TomKeddie/prj-pcb-experiments/mr-fixit/images/IMG_20191210_090137.jpg

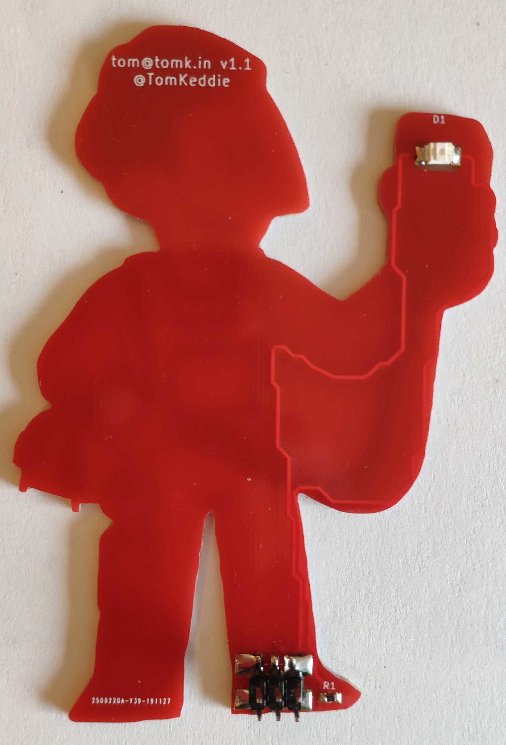
mr-fixit/images/IMG_20191210_090137.jpg
