TomKeddie/prj-pcb-experiments/mr-fixit/images/IMG_20191210_090121.jpg

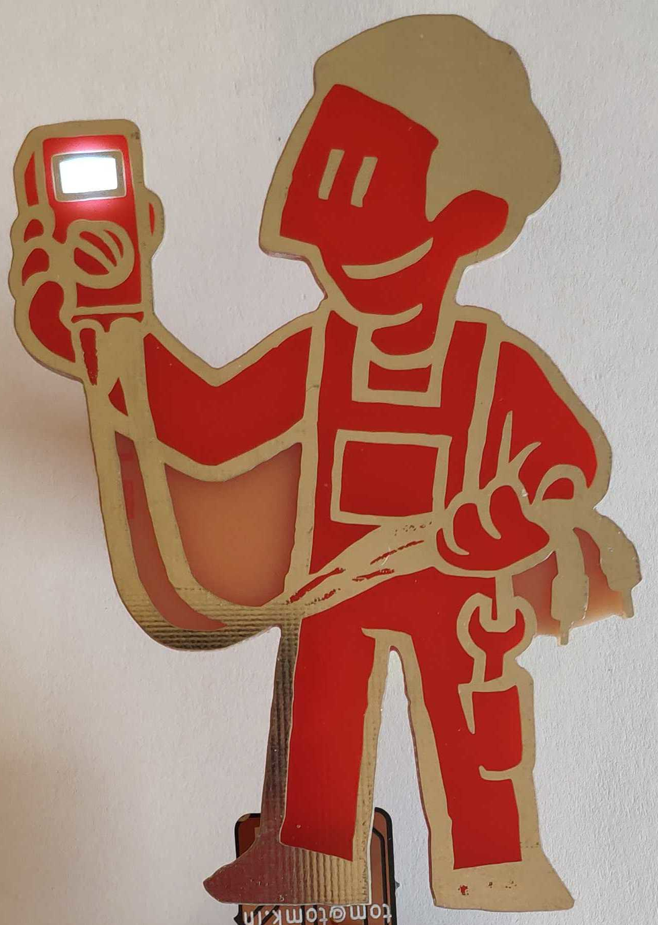
mr-fixit/images/IMG_20191210_090121.jpg
