TomKeddie/prj-pcb-experiments/2024-rfid-sao/README.md

## Plan
* Lollypop shaped SAO with RFID antenna in the head
* Red solder mask and white silk screen
* I2C to SAO (with optional pullups)

[Teardown BadgeTeqerdown 2019 Badge](https://upverter.com/design/gsteiert/teardown2019/)

[STM Data Sheet](https://wmsc.lcsc.com/wmsc/upload/file/pdf/v2/lcsc/2304140030_STMicroelectronics-M24LR64E-RMN6T-2_C2649483.pdf)

[JLCPCB RFID Parts](https://jlcpcb.com/parts/2nd/RF_And_Wireless/RFID_ICs_82545)

[Kicad Antenna Generator](https://neurotech-hub.github.io/KiCad-Antenna-Generator/)
