TomKeddie/prj-pcb-experiments/big-clive/README.md

Big Clive PCBs

* Original images are from http://www.bigclive.com/merch.htm
* Image was thresholded to clean up edges
* Solder mask layers were created using the kicad convert image tool
* Copper layer was created by duplicating the solder mask and hand editing to rename Mask to Cu
