TomKeddie/prj-pcb-experiments/2025-pmod-sma/2025-pmod-sma.kicad_sch.jlc.md

|Designator|LCSC|Footprint|Comment|
|--|--|--|--|
|J1|[](https://jlcpcb.com/partdetail/)|lib:PinHeader_2x06_P2.54mm_Horizontal_Top_Bottom|Conn_02x06_Top_Bottom|
|J2|[](https://jlcpcb.com/partdetail/)|lib:PinHeader_2x08_P2.54mm_Vertical_Top_Bottom|Conn_02x08_Top_Bottom|
|J3|[](https://jlcpcb.com/partdetail/)|lib:SMA_Amphenol_901-143_Horizontal|Conn_01x02|
