TomKeddie/prj-pcb-experiments/2025-mini-keychain/2025-mini-keychain.kicad_sch.jlc.md

|Designator|LCSC|Footprint|Comment|
|--|--|--|--|
