TomKeddie/prj-pcb-experiments/2024-rfid-sao/2024-rfid-sao.kicad_sch.jlc.md

|Designator|LCSC|Footprint|Comment|
|--|--|--|--|
|C1|[C19702](https://jlcpcb.com/partdetail/C19702)|library:C_0603_1608Metric|10uF/10V|
|C2|[C1525](https://jlcpcb.com/partdetail/C1525)|library:C_0402_1005Metric|0.1uF/16V|
|R1|[C25744](https://jlcpcb.com/partdetail/C25744)|library:R_0402_1005Metric|10k|
|R2|[C25744](https://jlcpcb.com/partdetail/C25744)|library:R_0402_1005Metric|10k|
|U1|[C157372](https://jlcpcb.com/partdetail/C157372)|library:SOIC-8_3.9x4.9mm_P1.27mm|M24LR64E|
