TomKeddie/prj-pcb-experiments/2024-clock-retrofit/kicad/2024-clock-retrofit.kicad_sch.jlc.md

|Designator|LCSC|Footprint|Comment|
|--|--|--|--|
|C1|[C19702](https://jlcpcb.com/partdetail/C19702)|library:C_0603_1608Metric|10uF/10V/X5R|
|C2|[C14663](https://jlcpcb.com/partdetail/C14663)|library:C_0603_1608Metric|100nF/50V/X7R|
|C3|[C12891](https://jlcpcb.com/partdetail/C12891)|library:C_1206_3216Metric|22uF/25V/X5R|
|C4|[C12891](https://jlcpcb.com/partdetail/C12891)|library:C_1206_3216Metric|22uF/25V/X5R|
|C5|[C14663](https://jlcpcb.com/partdetail/C14663)|library:C_0603_1608Metric|100nF/50V/X7R|
|C6|[C14663](https://jlcpcb.com/partdetail/C14663)|library:C_0603_1608Metric|100nF/50V/X7R|
|D2|[C2290](https://jlcpcb.com/partdetail/C2290)|library:LED_0603_1608Metric|PM|
|D3|[C2290](https://jlcpcb.com/partdetail/C2290)|library:LED_0603_1608Metric|AL|
|D4|[C2290](https://jlcpcb.com/partdetail/C2290)|library:LED_0603_1608Metric|TEMP|
|D5|[C2290](https://jlcpcb.com/partdetail/C2290)|library:LED_0603_1608Metric|TOP|
|D6|[C2290](https://jlcpcb.com/partdetail/C2290)|library:LED_0603_1608Metric|BOTT|
|D7|[C2290](https://jlcpcb.com/partdetail/C2290)|library:LED_0603_1608Metric|LED|
|D8|[C2290](https://jlcpcb.com/partdetail/C2290)|library:LED_0603_1608Metric|LED|
|D9|[C2290](https://jlcpcb.com/partdetail/C2290)|library:LED_0603_1608Metric|LED|
|D10|[C2290](https://jlcpcb.com/partdetail/C2290)|library:LED_0603_1608Metric|LED|
|D11|[C2290](https://jlcpcb.com/partdetail/C2290)|library:LED_0603_1608Metric|LED|
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
|R2|[C25741](https://jlcpcb.com/partdetail/C25741)|library:R_0402_1005Metric|100k|
|R3|[C25741](https://jlcpcb.com/partdetail/C25741)|library:R_0402_1005Metric|100k|
|R4|[C17673](https://jlcpcb.com/partdetail/C17673)|library:R_0805_2012Metric|4.7k|
|R5|[C25741](https://jlcpcb.com/partdetail/C25741)|library:R_0402_1005Metric|R_100k|
|R6|[C25076](https://jlcpcb.com/partdetail/C25076)|library:R_0402_1005Metric|100R|
|R7|[C25076](https://jlcpcb.com/partdetail/C25076)|library:R_0402_1005Metric|100R|
|R8|[C25076](https://jlcpcb.com/partdetail/C25076)|library:R_0402_1005Metric|100R|
|R9|[C25076](https://jlcpcb.com/partdetail/C25076)|library:R_0402_1005Metric|100R|
|R10|[C25076](https://jlcpcb.com/partdetail/C25076)|library:R_0402_1005Metric|100R|
|R11|[C17673](https://jlcpcb.com/partdetail/C17673)|library:R_0805_2012Metric|4.7k|
|R12|[C25076](https://jlcpcb.com/partdetail/C25076)|library:R_0402_1005Metric|100R|
|R13|[C25076](https://jlcpcb.com/partdetail/C25076)|library:R_0402_1005Metric|100R|
|R14|[C25076](https://jlcpcb.com/partdetail/C25076)|library:R_0402_1005Metric|100R|
|R15|[C25741](https://jlcpcb.com/partdetail/C25741)|library:R_0402_1005Metric|100k|
|U1|[](https://jlcpcb.com/partdetail/)|library:SSOP-24_3.9x8.7mm_P0.635mm|TLC59025|
|U3|[](https://jlcpcb.com/partdetail/)|library:SSOP-24_3.9x8.7mm_P0.635mm|TLC59025|
|U4|[C6186](https://jlcpcb.com/partdetail/C6186)|library:SOT-223-3_TabPin2|AZ1117-3.3|
