TomKeddie/prj-pcb-experiments/2025-flex-spiral/two/2025-flex-spiral-two.kicad_sch.jlc.md

|Designator|LCSC|Footprint|Comment|
|--|--|--|--|
|D1|[](https://jlcpcb.com/partdetail/)|lib:LED_0603_1608Metric|led_small|
|D2|[](https://jlcpcb.com/partdetail/)|lib:LED_0603_1608Metric|led_small|
|D3|[](https://jlcpcb.com/partdetail/)|lib:LED_0603_1608Metric|led_small|
|D4|[](https://jlcpcb.com/partdetail/)|lib:LED_0603_1608Metric|led_small|
|D5|[](https://jlcpcb.com/partdetail/)|lib:LED_0603_1608Metric|led_small|
|D6|[](https://jlcpcb.com/partdetail/)|lib:LED_0603_1608Metric|led_small|
|D7|[](https://jlcpcb.com/partdetail/)|lib:LED_0603_1608Metric|led_small|
|D8|[](https://jlcpcb.com/partdetail/)|lib:LED_0603_1608Metric|led_small|
|D9|[](https://jlcpcb.com/partdetail/)|lib:LED_0603_1608Metric|led_small|
|D10|[](https://jlcpcb.com/partdetail/)|lib:LED_0603_1608Metric|led_small|
|D11|[](https://jlcpcb.com/partdetail/)|lib:LED_0603_1608Metric|led_small|
|D12|[](https://jlcpcb.com/partdetail/)|lib:LED_0603_1608Metric|led_small|
|D13|[](https://jlcpcb.com/partdetail/)|lib:LED_0603_1608Metric|led_small|
|D14|[](https://jlcpcb.com/partdetail/)|lib:LED_0603_1608Metric|led_small|
|D15|[](https://jlcpcb.com/partdetail/)|lib:LED_0603_1608Metric|led_small|
|D16|[](https://jlcpcb.com/partdetail/)|lib:LED_0603_1608Metric|led_small|
|D17|[](https://jlcpcb.com/partdetail/)|lib:LED_0603_1608Metric|led_small|
|D18|[](https://jlcpcb.com/partdetail/)|lib:LED_0603_1608Metric|led_small|
|D19|[](https://jlcpcb.com/partdetail/)|lib:LED_0603_1608Metric|led_small|
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
|D74|[](https://jlcpcb.com/partdetail/)|lib:LED_0603_1608Metric|led_small|
|D75|[](https://jlcpcb.com/partdetail/)|lib:LED_0603_1608Metric|led_small|
|TP1|[](https://jlcpcb.com/partdetail/)|lib:TestPoint_Pad_D3.0mm|A|
|TP2|[](https://jlcpcb.com/partdetail/)|lib:TestPoint_Pad_D3.0mm|C|
