TomKeddie/prj-pcb-experiments/2024-led-ctrl-24v/kicad/led-ctrl-24v.kicad_sch.jlc.md

|Designator|LCSC|Footprint|Comment|
|--|--|--|--|
|C2|[C14663](https://jlcpcb.com/partdetail/C14663)|library:C_0603_1608Metric|100nF/50V/X7R|
|C3|[C15195](https://jlcpcb.com/partdetail/C15195)|library:C_0402_1005Metric|10nF/50V/X7R|
|C4|[C13585](https://jlcpcb.com/partdetail/C13585)|library:C_1206_3216Metric|10uF/50V/X5R|
|C5|[C696794](https://jlcpcb.com/partdetail/C696794)|library:CP_EIA-3528-12_Kemet-T|220uF/6.3V/TANT|
|C6|[C19702](https://jlcpcb.com/partdetail/C19702)|library:C_0603_1608Metric|10uF/10V/X5R|
|C7|[C19702](https://jlcpcb.com/partdetail/C19702)|library:C_0603_1608Metric|10uF/10V/X5R|
|D1|[C64982](https://jlcpcb.com/partdetail/C64982)|library:D_SMA|B340|
|L1|[C5189961](https://jlcpcb.com/partdetail/C5189961)|library:CYA630|33uH/1A|
|Q1|[C20917](https://jlcpcb.com/partdetail/C20917)|library:SOT-23|AO3400A|
|R1|[C25804](https://jlcpcb.com/partdetail/C25804)|library:R_0603_1608Metric|10k|
|R2|[C25804](https://jlcpcb.com/partdetail/C25804)|library:R_0603_1608Metric|10k|
|R3|[C25804](https://jlcpcb.com/partdetail/C25804)|library:R_0603_1608Metric|10k|
|R4|[C25804](https://jlcpcb.com/partdetail/C25804)|library:R_0603_1608Metric|10k|
|R5|[C25804](https://jlcpcb.com/partdetail/C25804)|library:R_0603_1608Metric|10k|
|R6|[C25804](https://jlcpcb.com/partdetail/C25804)|library:R_0603_1608Metric|10k|
|R7|[C21190](https://jlcpcb.com/partdetail/C21190)|library:R_0603_1608Metric|100k|
|R8|[C21189](https://jlcpcb.com/partdetail/C21189)|library:R_0603_1608Metric|0|
|R9|[C21189](https://jlcpcb.com/partdetail/C21189)|library:R_0603_1608Metric|0|
|R10|[C21189](https://jlcpcb.com/partdetail/C21189)|library:R_0603_1608Metric|0|
|R11|[C25744](https://jlcpcb.com/partdetail/C25744)|library:R_0402_1005Metric|10k|
|R12|[C25804](https://jlcpcb.com/partdetail/C25804)|library:R_0603_1608Metric|10k|
|R13|[C25900](https://jlcpcb.com/partdetail/C25900)|library:R_0402_1005Metric|4.7k|
|R14|[C25804](https://jlcpcb.com/partdetail/C25804)|library:R_0603_1608Metric|10k|
|R15|[C25744](https://jlcpcb.com/partdetail/C25744)|library:R_0402_1005Metric|10k|
|U1|[](https://jlcpcb.com/partdetail/)|library:TI_SO-PowerPAD-8_ThermalVias|TPS5430DDA|
|U2|[C82891](https://jlcpcb.com/partdetail/C82891)|library:ESP-12E_SMD|ESP-12|
|U3|[C5446](https://jlcpcb.com/partdetail/C5446)|library:SOT-23|XC6206P332MR-G|
|U4|[C23654](https://jlcpcb.com/partdetail/C23654)|library:SOT-23-5|74LVC1G125|
