TomKeddie/prj-pcb-experiments/2025-usb-pd-plank/kicad/usb-pd-plank.kicad_sch.jlc.md

|Comment|LCSC|Footprint|Designator|
|--|--|--|--|
|4.7uF/50V|[C29823](https://jlcpcb.com/partdetail/C29823)|lib:C_1206_3216Metric|C1|
|4.7uF/50V|[C29823](https://jlcpcb.com/partdetail/C29823)|lib:C_1206_3216Metric|C2|
|4.7uF/50V|[C29823](https://jlcpcb.com/partdetail/C29823)|lib:C_1206_3216Metric|C3|
|4.7uF/50V|[C29823](https://jlcpcb.com/partdetail/C29823)|lib:C_1206_3216Metric|C4|
|4.7uF/50V|[C29823](https://jlcpcb.com/partdetail/C29823)|lib:C_1206_3216Metric|C5|
|0.1uF/50V|[C24497](https://jlcpcb.com/partdetail/C24497)|lib:C_1206_3216Metric|C6|
|0.1uF/50V|[C24497](https://jlcpcb.com/partdetail/C24497)|lib:C_1206_3216Metric|C7|
|PESD5V0S1BA|[C19224](https://jlcpcb.com/partdetail/C19224)|lib:D_SOD-323|D1|
|PESD5V0S1BA|[C19224](https://jlcpcb.com/partdetail/C19224)|lib:D_SOD-323|D2|
|GREEN|[C2297](https://jlcpcb.com/partdetail/C2297)|lib:LED_0805_2012Metric|D3|
|GREEN|[C2297](https://jlcpcb.com/partdetail/C2297)|lib:LED_0805_2012Metric|D4|
|GREEN|[C2297](https://jlcpcb.com/partdetail/C2297)|lib:LED_0805_2012Metric|D5|
|USB_C_Receptacle_USB2.0_16P|[C165948](https://jlcpcb.com/partdetail/C165948)|lib:USB_C_Receptacle_LCSC_C165948|J1|
|USB_C_Receptacle_USB2.0_16P|[C165948](https://jlcpcb.com/partdetail/C165948)|lib:USB_C_Receptacle_LCSC_C165948|J2|
|AO3400A|[C20917](https://jlcpcb.com/partdetail/C20917)|lib:SOT-23-GSD|Q1|
|AO3400A|[C20917](https://jlcpcb.com/partdetail/C20917)|lib:SOT-23-GSD|Q2|
|AO3400A|[C20917](https://jlcpcb.com/partdetail/C20917)|lib:SOT-23-GSD|Q3|
|AO3400A|[C20917](https://jlcpcb.com/partdetail/C20917)|lib:SOT-23-GSD|Q4|
|AO4407A|[](https://jlcpcb.com/partdetail/)|lib:SO-8_3.9x4.9mm_P1.27mm|Q5|
|AO4407A|[](https://jlcpcb.com/partdetail/)|lib:SO-8_3.9x4.9mm_P1.27mm|Q6|
|AO4407A|[](https://jlcpcb.com/partdetail/)|lib:SO-8_3.9x4.9mm_P1.27mm|Q7|
|AO4407A|[](https://jlcpcb.com/partdetail/)|lib:SO-8_3.9x4.9mm_P1.27mm|Q8|
|10k|[C25744](https://jlcpcb.com/partdetail/C25744)|lib:R_0402_1005Metric|R1|
|10k|[C25744](https://jlcpcb.com/partdetail/C25744)|lib:R_0402_1005Metric|R2|
|10k|[C25744](https://jlcpcb.com/partdetail/C25744)|lib:R_0402_1005Metric|R3|
|10k|[C25744](https://jlcpcb.com/partdetail/C25744)|lib:R_0402_1005Metric|R4|
|1k|[C11702](https://jlcpcb.com/partdetail/C11702)|lib:R_0402_1005Metric|R6|
|100k|[C25741](https://jlcpcb.com/partdetail/C25741)|lib:R_0402_1005Metric|R8|
|100k|[C25741](https://jlcpcb.com/partdetail/C25741)|lib:R_0402_1005Metric|R9|
|1k|[C11702](https://jlcpcb.com/partdetail/C11702)|lib:R_0402_1005Metric|R10|
|1k|[C11702](https://jlcpcb.com/partdetail/C11702)|lib:R_0402_1005Metric|R11|
|100k|[C25741](https://jlcpcb.com/partdetail/C25741)|lib:R_0402_1005Metric|R12|
|10k|[C25744](https://jlcpcb.com/partdetail/C25744)|lib:R_0402_1005Metric|R13|
|10k|[C25744](https://jlcpcb.com/partdetail/C25744)|lib:R_0402_1005Metric|R14|
|100k|[C25741](https://jlcpcb.com/partdetail/C25741)|lib:R_0402_1005Metric|R15|
|PTN5110|[C2674062](https://jlcpcb.com/partdetail/C2674062)|lib:QFN-16_EP_2.6x2.6_Pitch0.4mm|U1|
