TomKeddie/prj-pcb-experiments/3rdparty-gerbers/Krusty_the_It/Screenshot_2020-10-03_10-51-42.png

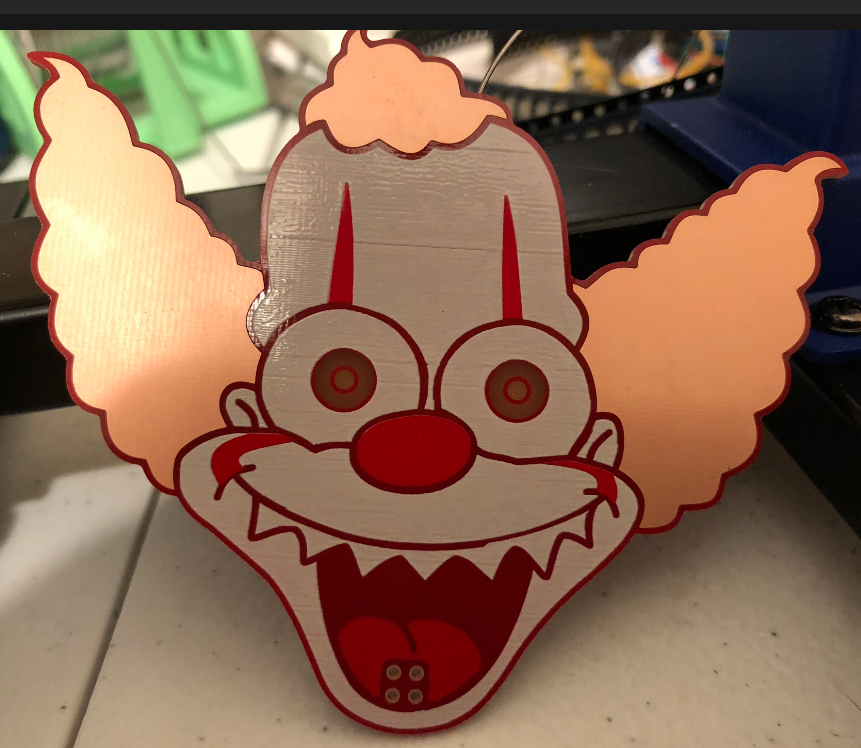
3rdparty-gerbers/Krusty_the_It/Screenshot_2020-10-03_10-51-42.png
