TomKeddie/prj-pcb-experiments/3rdparty-gerbers/Nibbler/Screenshot_2020-10-03_10-50-50.png

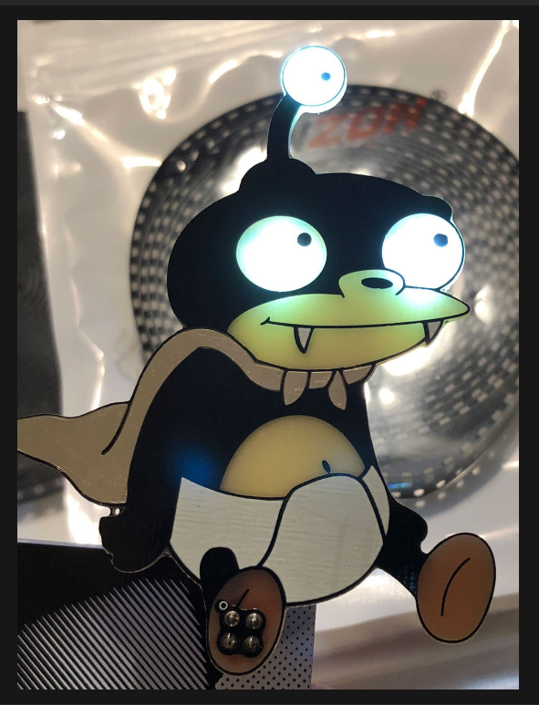
3rdparty-gerbers/Nibbler/Screenshot_2020-10-03_10-50-50.png
