TomKeddie/prj-pcb-experiments/3rdparty-gerbers/UFO/Screenshot_2020-10-03_10-46-58.png

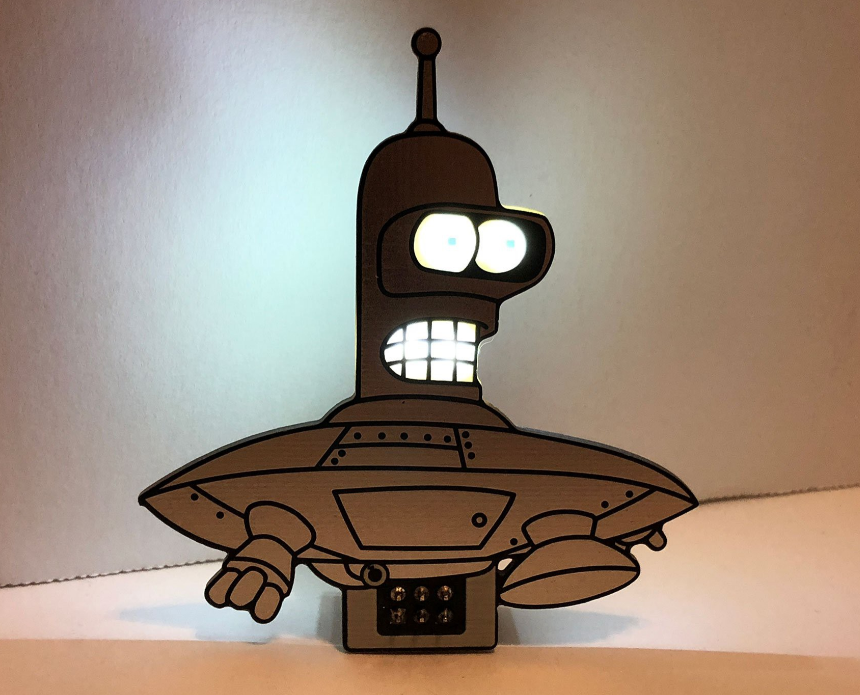
3rdparty-gerbers/UFO/Screenshot_2020-10-03_10-46-58.png
