TomKeddie/prj-pcb-experiments/2021-xmas-tree/image/pine-tree-with-snow-transparent-clip-art-gallery-yopriceville-snow-tree-clipart-5756_8000.png

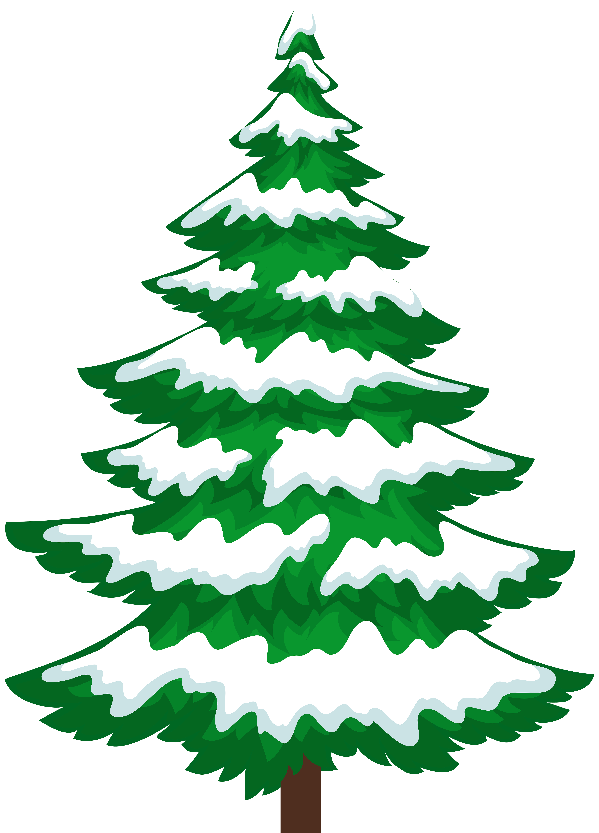
2021-xmas-tree/image/pine-tree-with-snow-transparent-clip-art-gallery-yopriceville-snow-tree-clipart-5756_8000.png
