TomKeddie/prj-pcb-experiments/2021-xmas-tree/outline.png

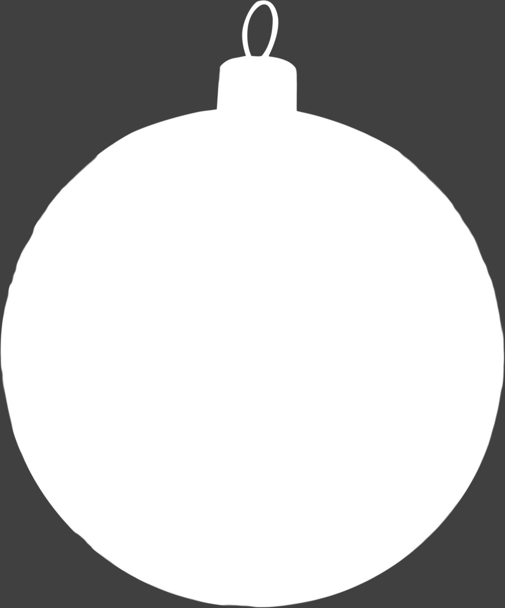
2021-xmas-tree/outline.png
