TomKeddie/prj-pcb-experiments/2022-xmas-ball/original.png

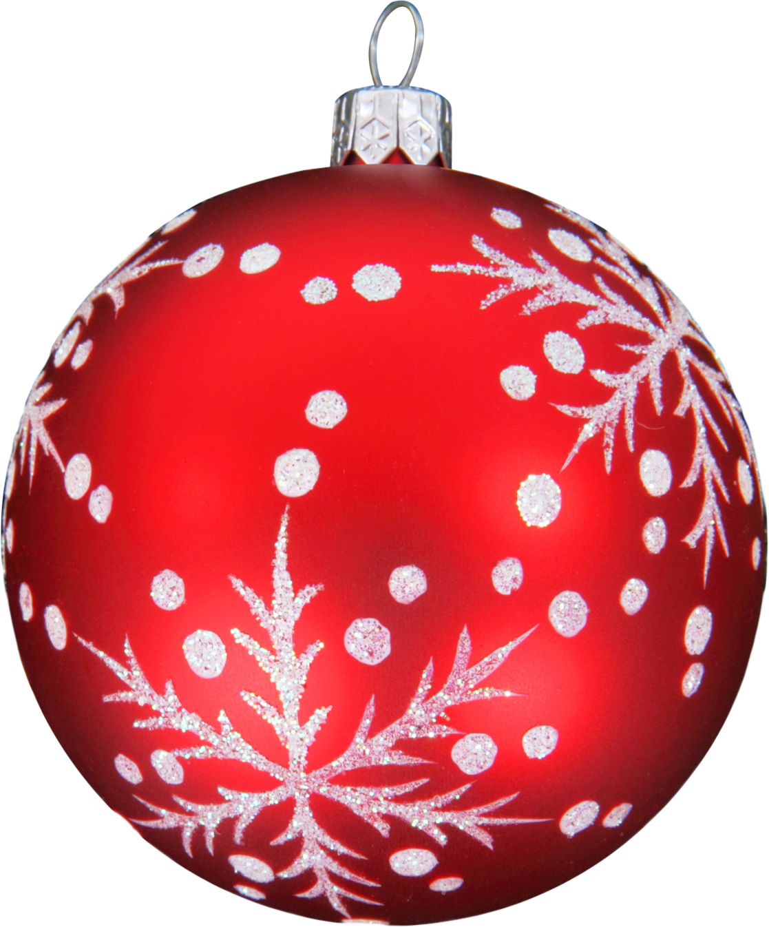
2022-xmas-ball/original.png
