TomKeddie/prj-pcb-experiments/2023-xmas-snowflake/image/silk.png

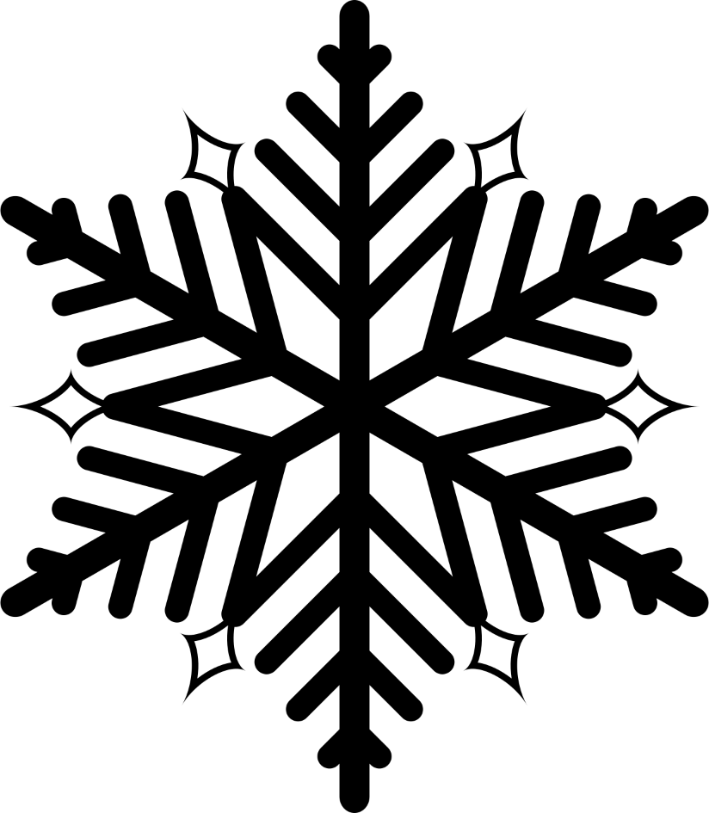
2023-xmas-snowflake/image/silk.png
