TomKeddie/prj-pcb-experiments/2024-clock-retrofit/kicad/2024-clock-retrofit.kicad_pcb.3d-isometric.png

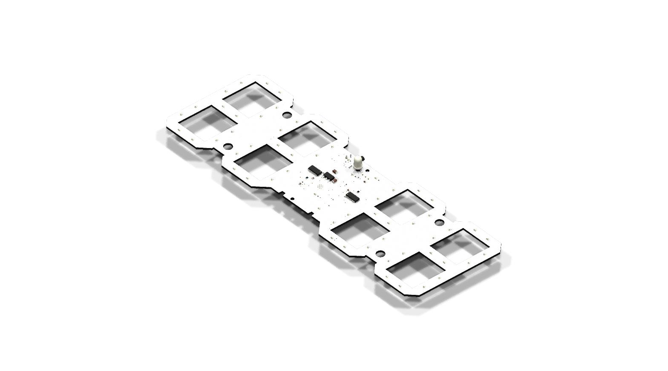
2024-clock-retrofit/kicad/2024-clock-retrofit.kicad_pcb.3d-isometric.png
