TomKeddie/prj-pcb-experiments/2024-clock-retrofit/kicad/2024-clock-retrofit.kicad_pcb.3d-top.png

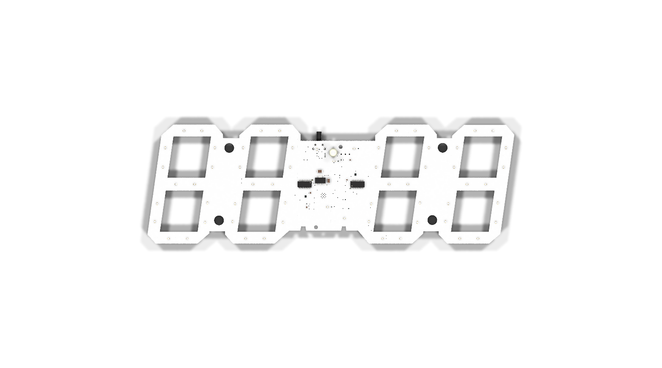
2024-clock-retrofit/kicad/2024-clock-retrofit.kicad_pcb.3d-top.png
