TomKeddie/prj-pcb-experiments/2024-clock-retrofit/tom_clock.jpg

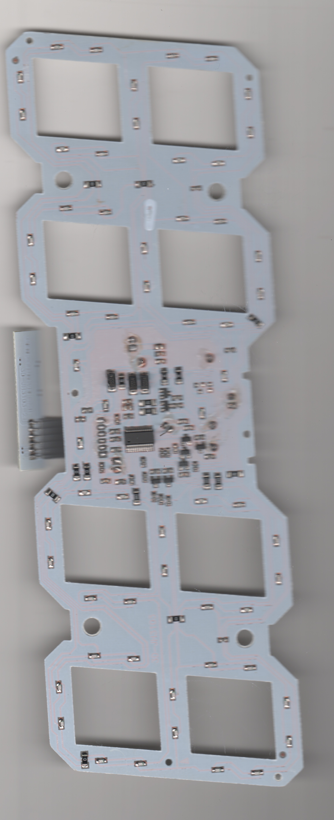
2024-clock-retrofit/tom_clock.jpg
