TomKeddie/prj-pcb-experiments/2024-clock-retrofit/tom_clock_rotated.jpg

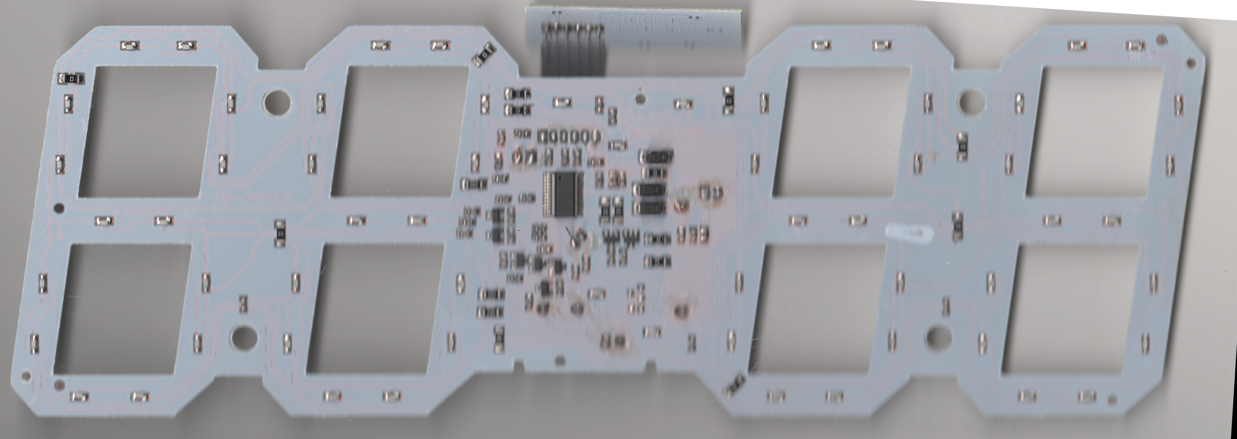
2024-clock-retrofit/tom_clock_rotated.jpg
