TomKeddie/prj-pcb-experiments/2024-led-ctrl-24v/BUTTONS.jpg

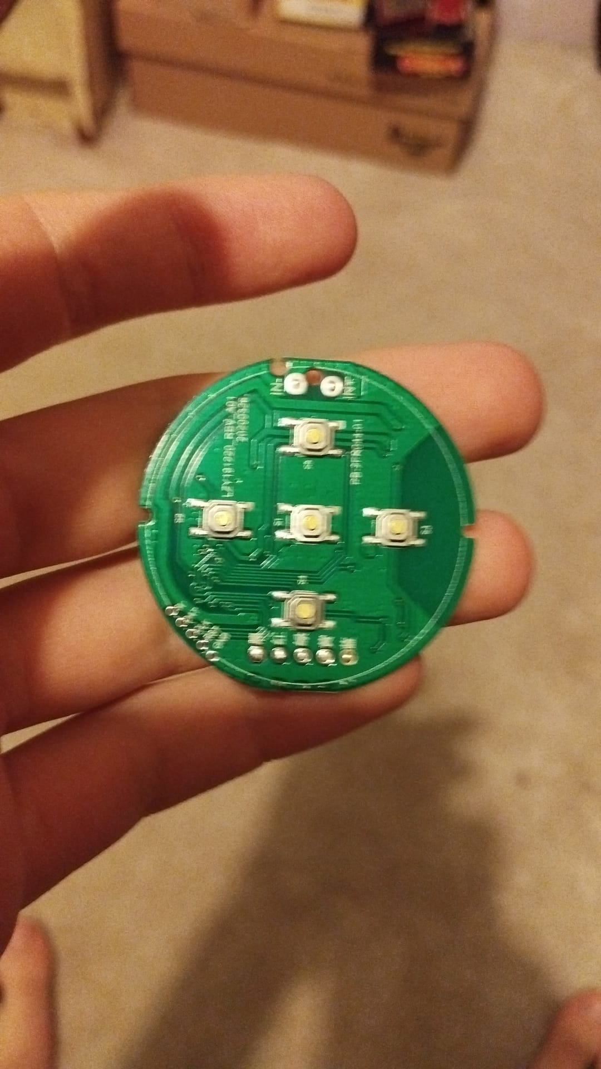
2024-led-ctrl-24v/BUTTONS.jpg
