TomKeddie/prj-pcb-experiments/2024-led-ctrl-24v/PXL_20241207_011051852.jpg

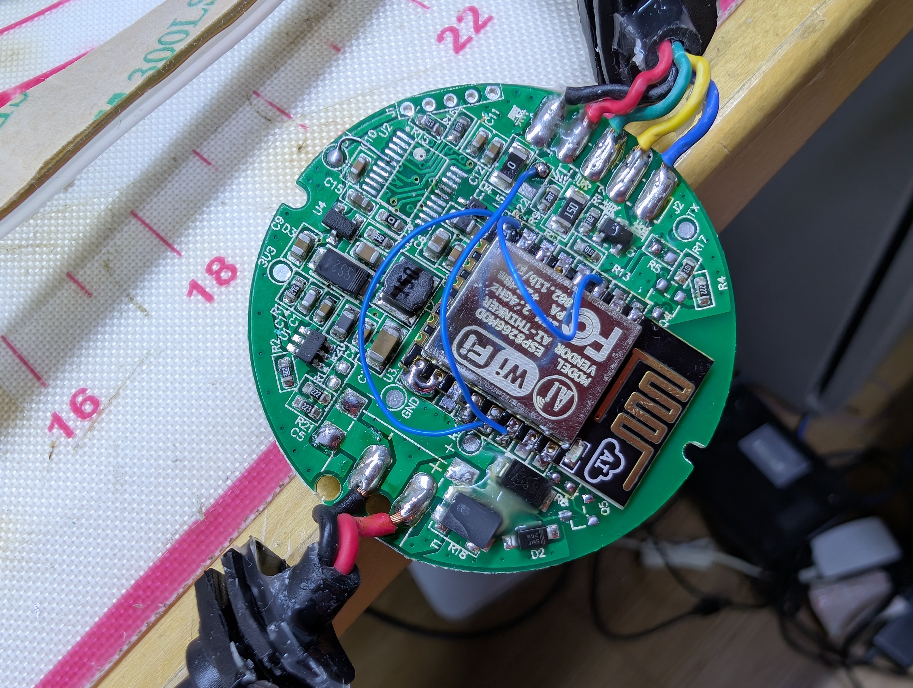
2024-led-ctrl-24v/PXL_20241207_011051852.jpg
