TomKeddie/prj-pcb-experiments/2024-rfid-sao/images/set-with-different-colorful-lollipops-vector-1965779.jpg

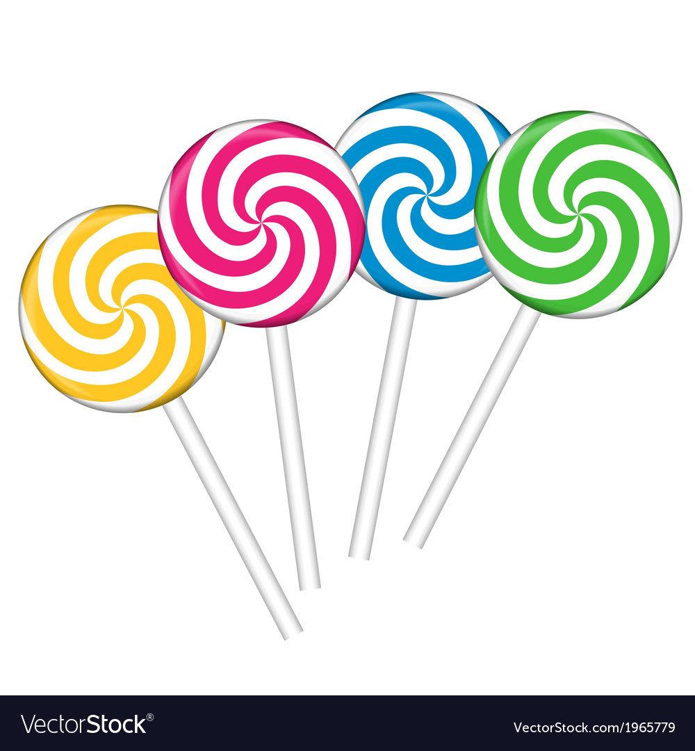
2024-rfid-sao/images/set-with-different-colorful-lollipops-vector-1965779.jpg
