TomKeddie/prj-pcb-experiments/2024-rfid-sao/images/set-with-different-colorful-lollipops-vector-1965779.png

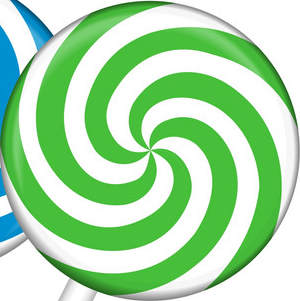
2024-rfid-sao/images/set-with-different-colorful-lollipops-vector-1965779.png
