TomKeddie/prj-pcb-experiments/2024-rfid-sao/images/silk.png

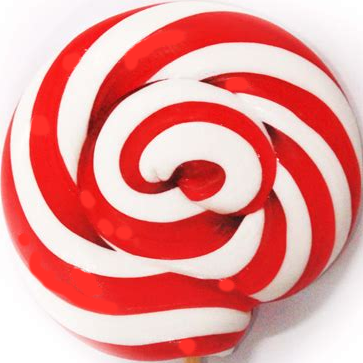
2024-rfid-sao/images/silk.png
