TomKeddie/prj-pcb-experiments/2024-rfid-sao/images/th-3510862958.jpg

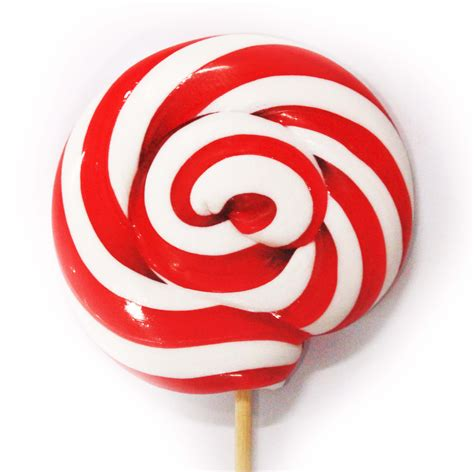
2024-rfid-sao/images/th-3510862958.jpg
