TomKeddie/prj-pcb-experiments/2025-flex-spiral/one/2025-flex-spiral.kicad_pcb.3d-isometric.png

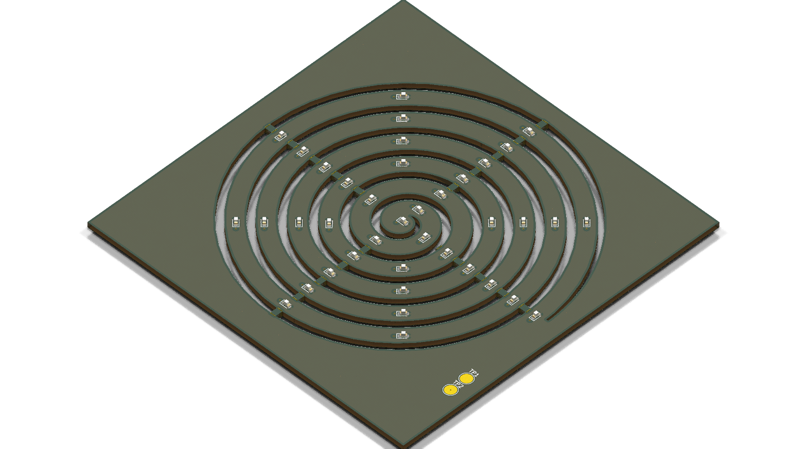
2025-flex-spiral/one/2025-flex-spiral.kicad_pcb.3d-isometric.png
