TomKeddie/prj-pcb-experiments/2025-flex-spiral/two/2025-flex-spiral-two.kicad_pcb.3d-isometric.png

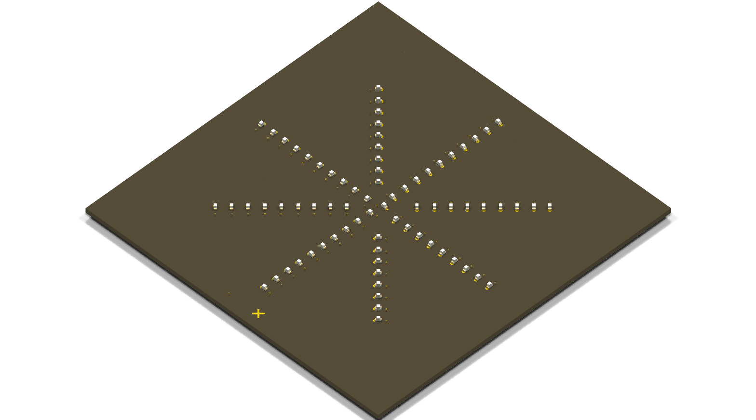
2025-flex-spiral/two/2025-flex-spiral-two.kicad_pcb.3d-isometric.png
