TomKeddie/prj-pcb-experiments/2025-mini-keychain/2025-mini-keychain.kicad_pcb.3d-isometric.png

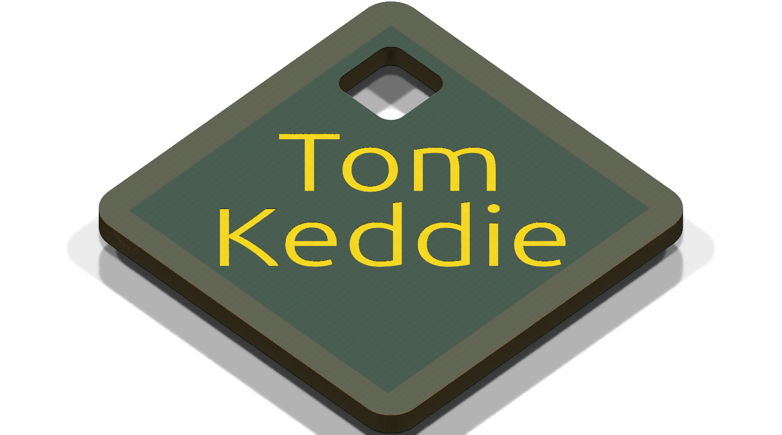
2025-mini-keychain/2025-mini-keychain.kicad_pcb.3d-isometric.png
