TomKeddie/prj-pcb-experiments/2025-mipi-rpi-conv-dsi/2025-mipi-rpi-conv-dsi.kicad_pcb.3d-top.png

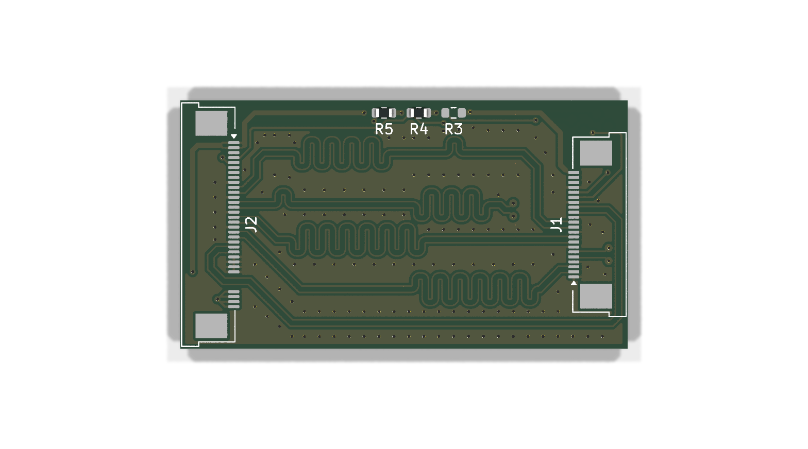
2025-mipi-rpi-conv-dsi/2025-mipi-rpi-conv-dsi.kicad_pcb.3d-top.png
