TomKeddie/prj-pcb-experiments/2025-pmod-sma/2025-pmod-sma.kicad_pcb.3d-top.png

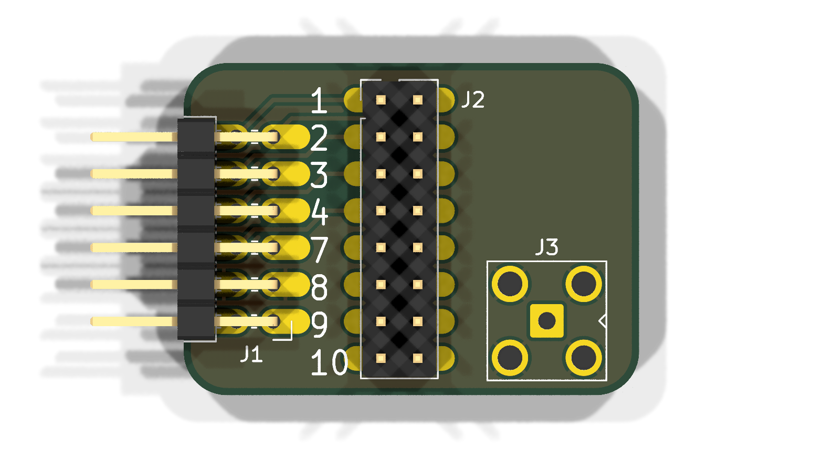
2025-pmod-sma/2025-pmod-sma.kicad_pcb.3d-top.png
