TomKeddie/prj-pcb-experiments/2025-usb-pd-plank/kicad/usb-pd-plank.kicad_pcb.3d-isometric.png

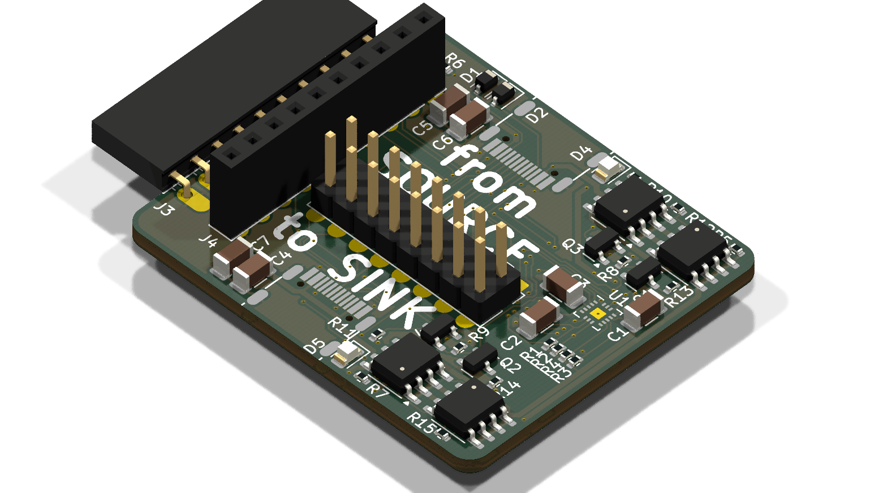
2025-usb-pd-plank/kicad/usb-pd-plank.kicad_pcb.3d-isometric.png
