TomKeddie/prj-pcb-experiments/2025-usb-pd-plank/kicad/usb-pd-plank.kicad_pcb.3d-top.png

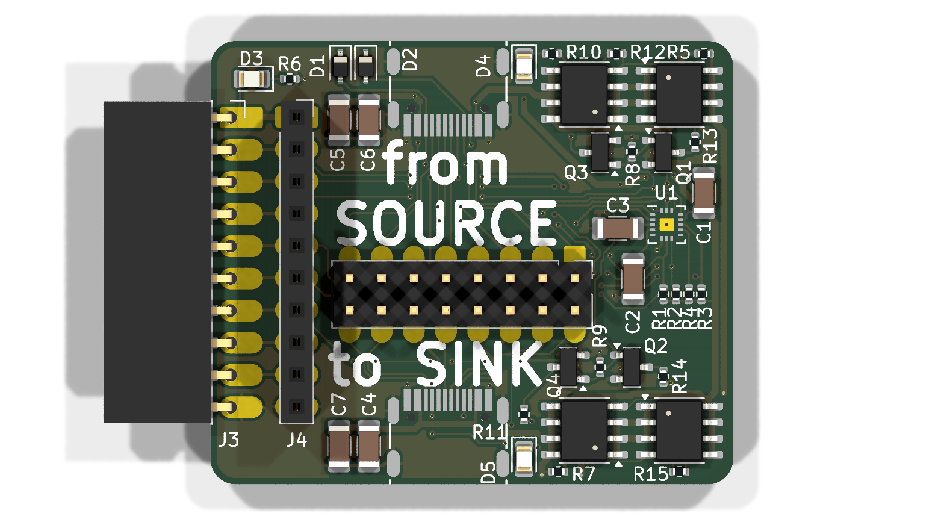
2025-usb-pd-plank/kicad/usb-pd-plank.kicad_pcb.3d-top.png
