TomKeddie/prj-pcb-experiments/atmelice-swd-breakout/Screenshot_2020-11-29_05-35-28.png

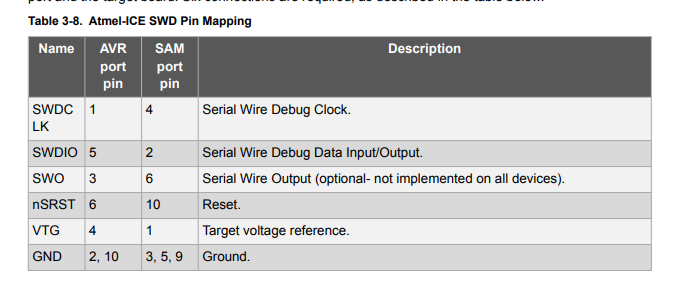
atmelice-swd-breakout/Screenshot_2020-11-29_05-35-28.png
