TomKeddie/prj-pcb-experiments/big-clive/bcdc-black.png

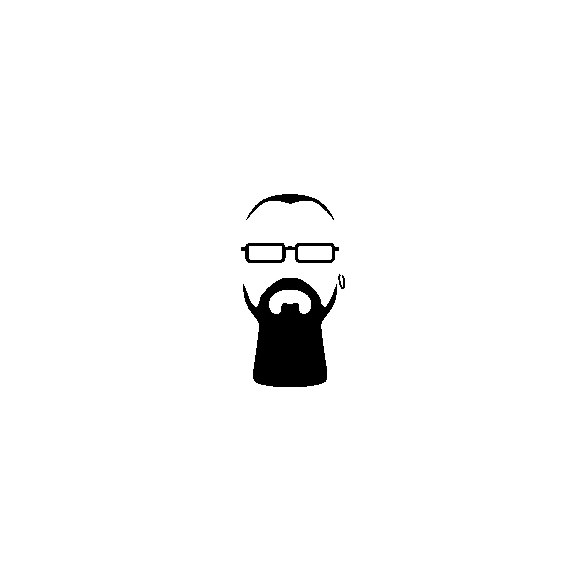
big-clive/bcdc-black.png
