TomKeddie/prj-pcb-experiments/big-clive/bcdc.png

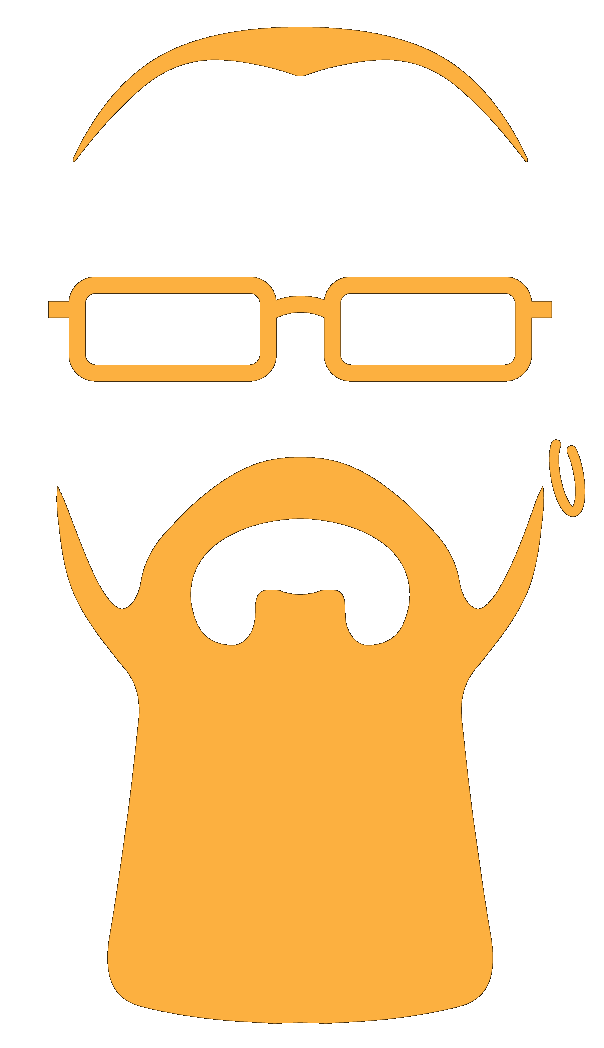
big-clive/bcdc.png
