TomKeddie/prj-pcb-experiments/covid-mask/86547808-10cm.jpeg

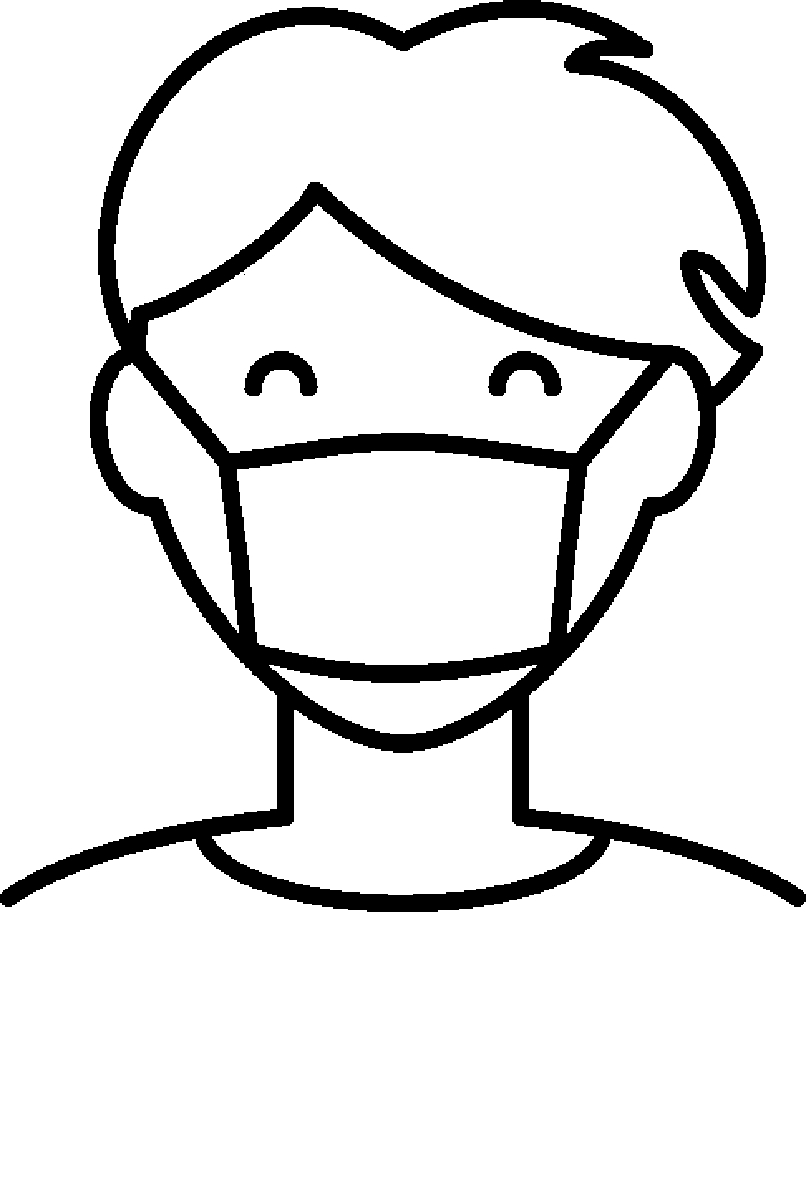
covid-mask/86547808-10cm.jpeg
