TomKeddie/prj-pcb-experiments/covid-mask/86547808.jpeg

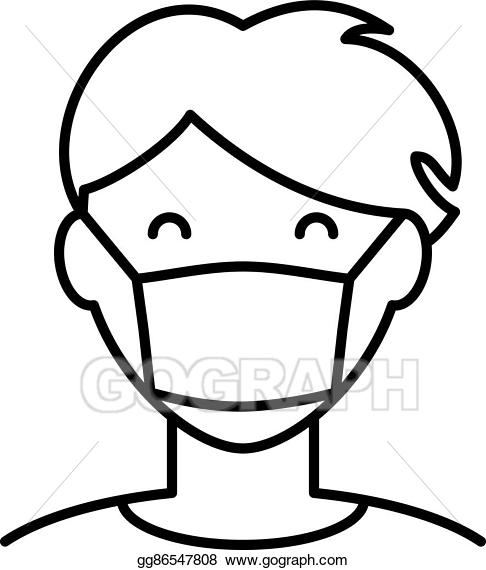
covid-mask/86547808.jpeg
