TomKeddie/prj-pcb-experiments/deutsche-bahn/IMG_20191210_094328.jpg

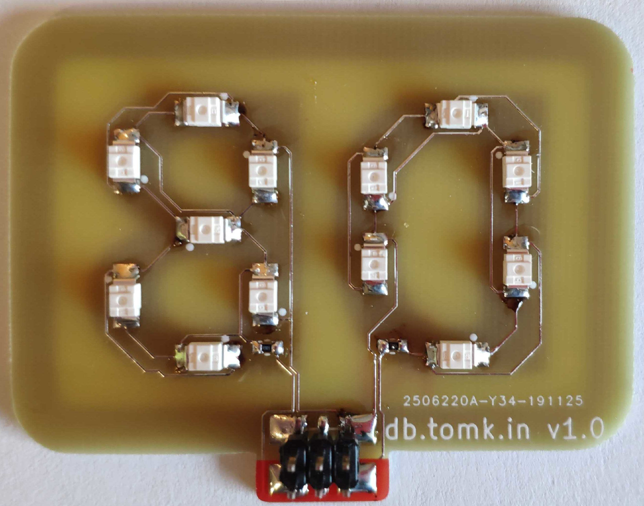
deutsche-bahn/IMG_20191210_094328.jpg
