TomKeddie/prj-pcb-experiments/east-van/arrow/image-arrow2-right.png

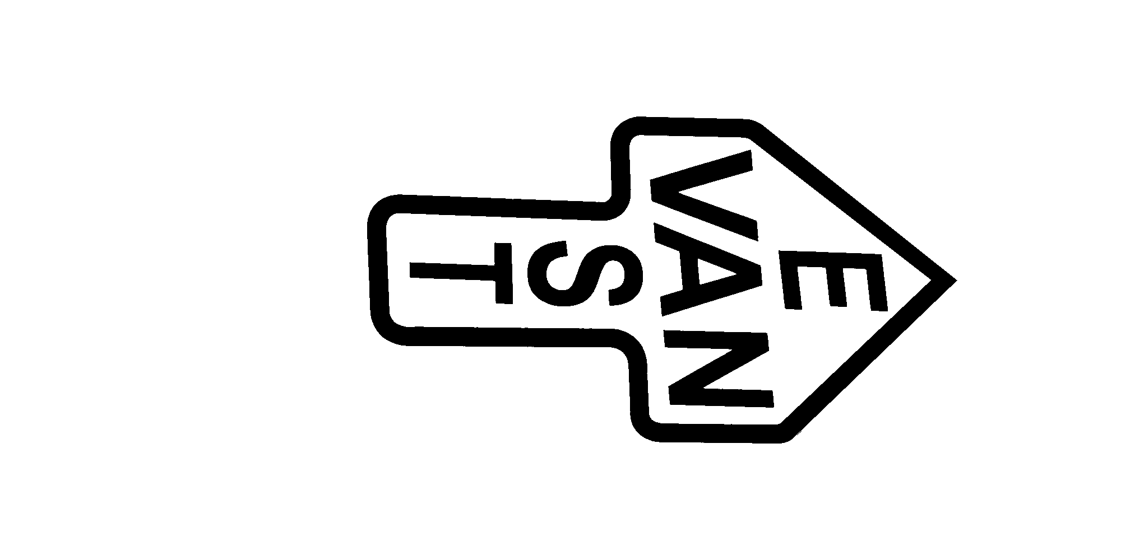
east-van/arrow/image-arrow2-right.png
