TomKeddie/prj-pcb-experiments/east-van/arrow/image-arrow2.png

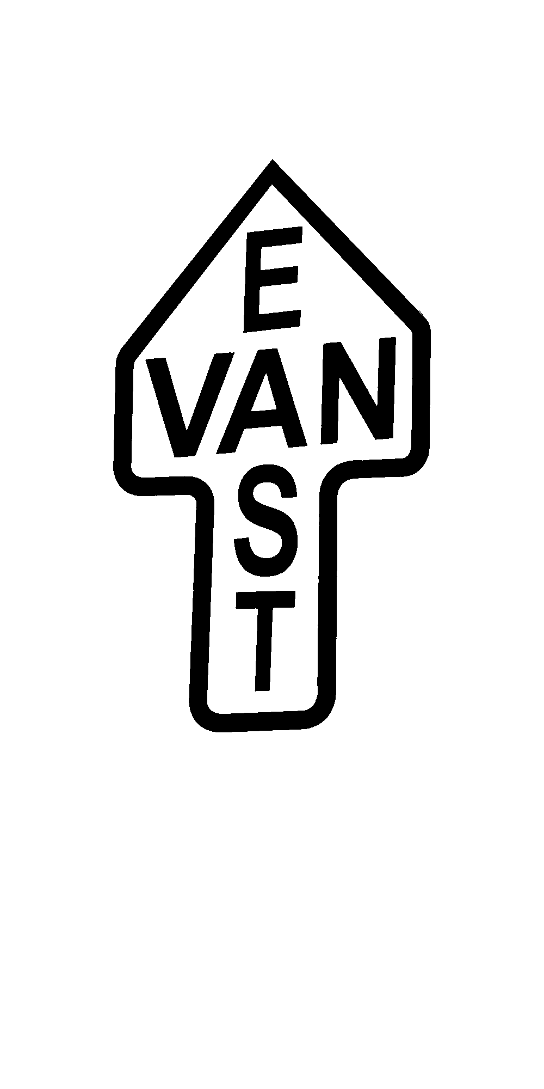
east-van/arrow/image-arrow2.png
