TomKeddie/prj-pcb-experiments/east-van/arrow/image-arrow-up-filled.png

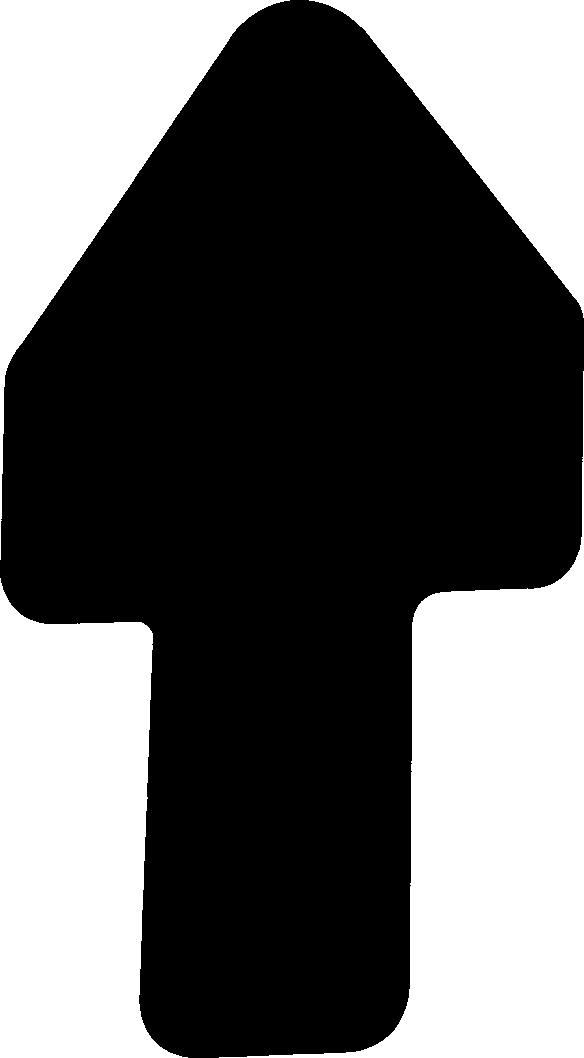
east-van/arrow/image-arrow-up-filled.png
