TomKeddie/prj-pcb-experiments/east-van/arrow/image-arrow-up.png

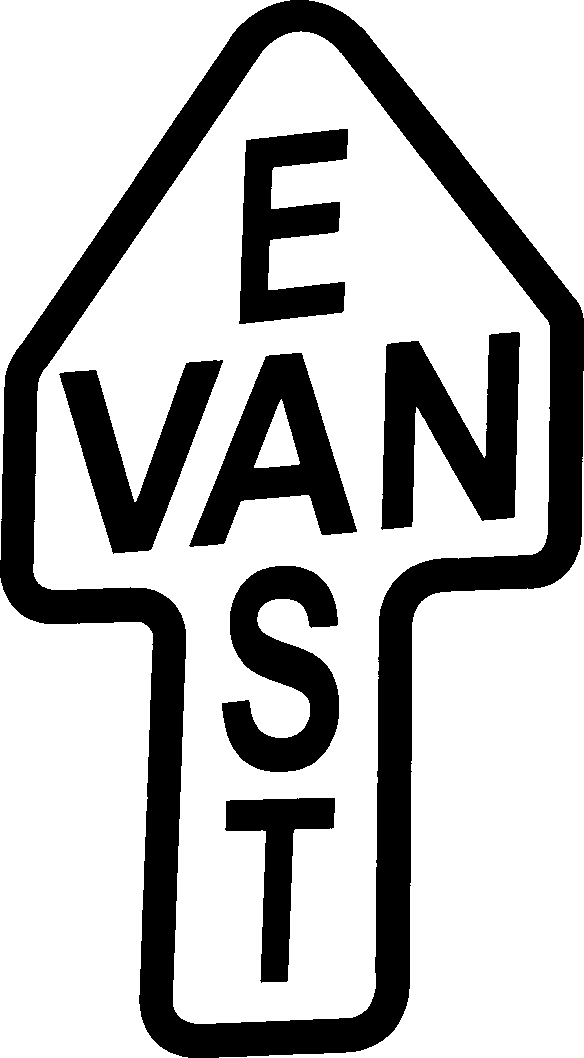
east-van/arrow/image-arrow-up.png
