TomKeddie/prj-pcb-experiments/east-van/arrow/IMG_20191210_091838.jpg

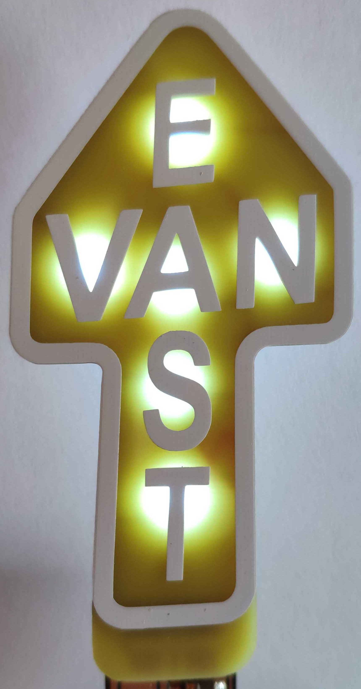
east-van/arrow/IMG_20191210_091838.jpg
