TomKeddie/prj-pcb-experiments/east-van/arrow/IMG_20191210_091856.jpg

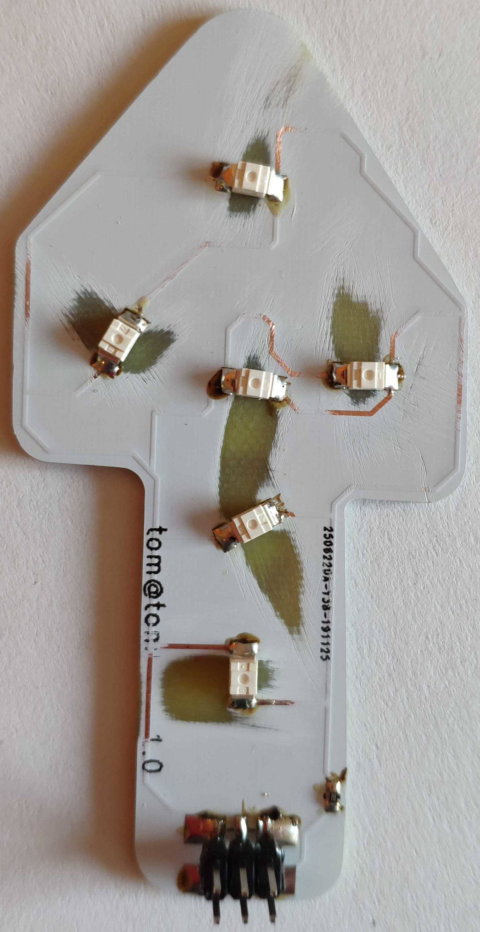
east-van/arrow/IMG_20191210_091856.jpg
