TomKeddie/prj-pcb-experiments/east-van/image-edge-extended-filled.png

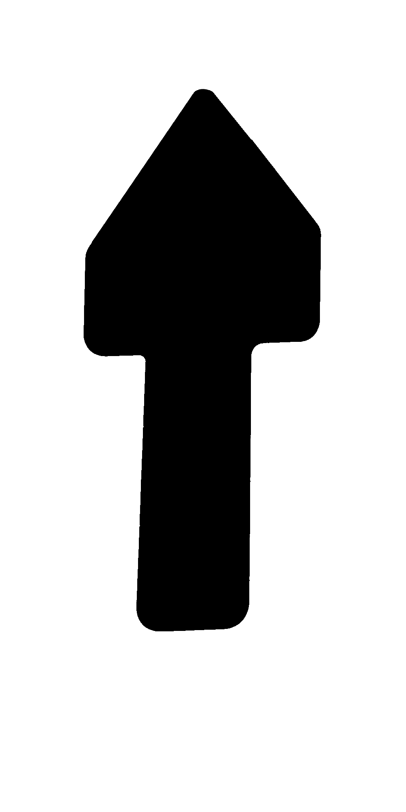
east-van/image-edge-extended-filled.png
