TomKeddie/prj-pcb-experiments/east-van/image-edge-filled.png

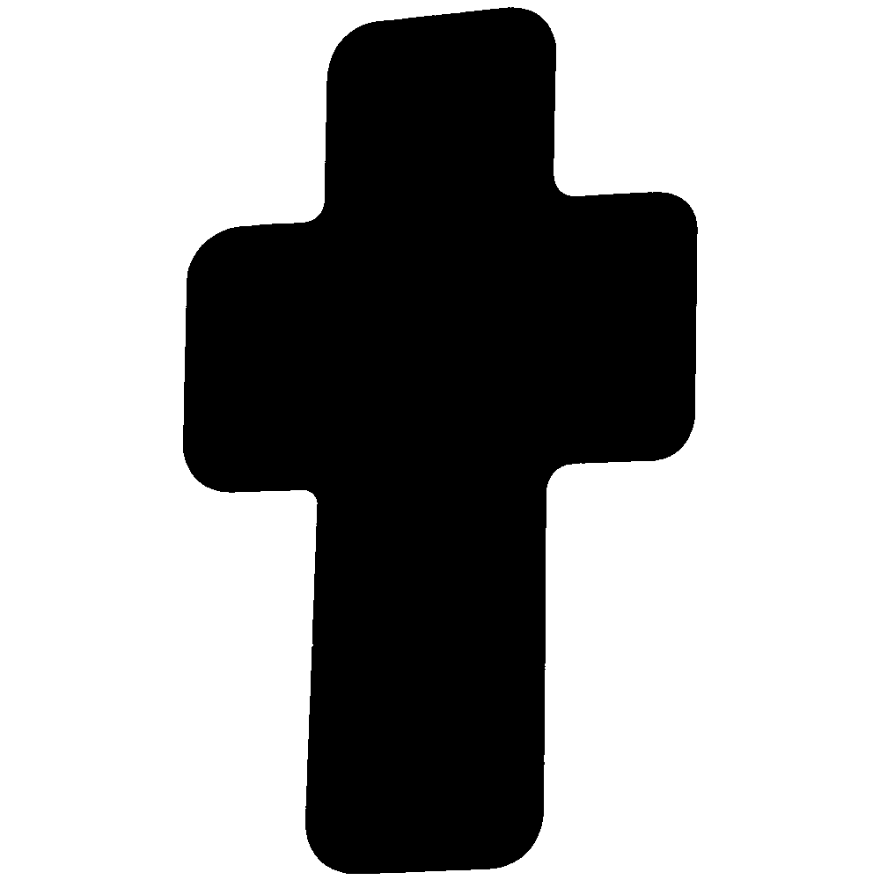
east-van/image-edge-filled.png
