TomKeddie/prj-pcb-experiments/east-van/image-edge.png

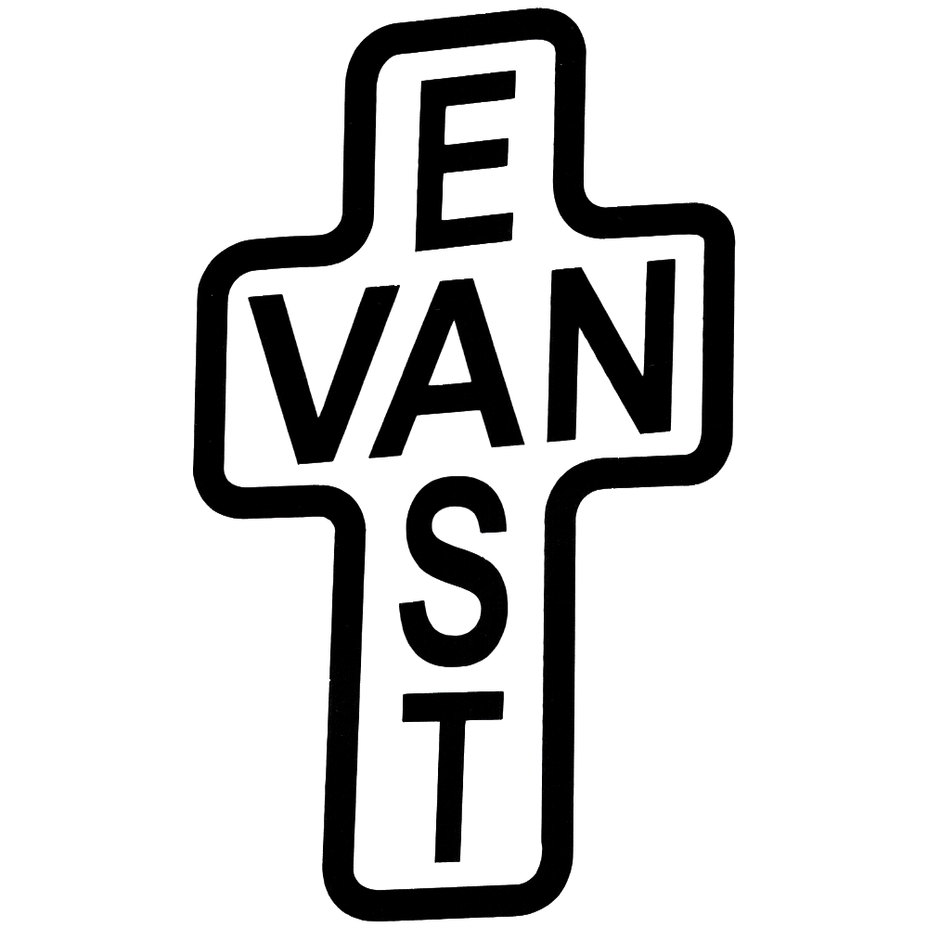
east-van/image-edge.png
