TomKeddie/prj-pcb-experiments/mr-fixit/images/mrfixit-corrected-filled3.png

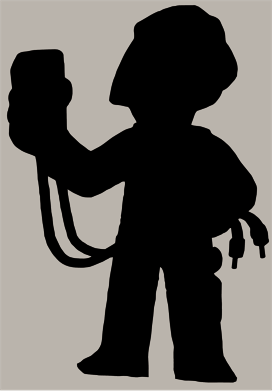
mr-fixit/images/mrfixit-corrected-filled3.png
