TomKeddie/prj-pcb-experiments/mr-fixit/images/mrfixit-corrected.png

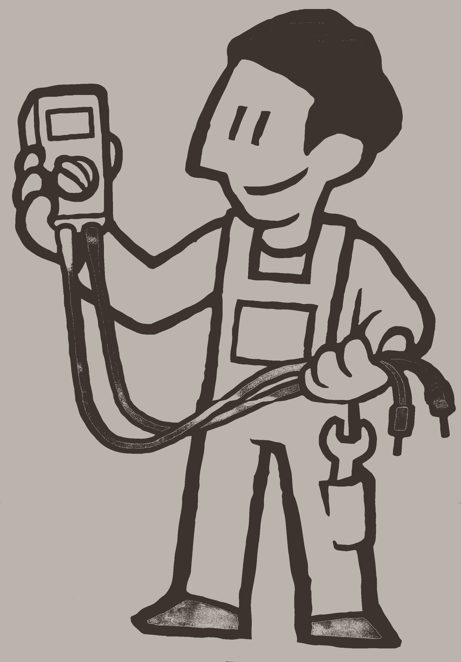
mr-fixit/images/mrfixit-corrected.png
