TomKeddie/prj-pcb-experiments/peace-sign-sao/image.png

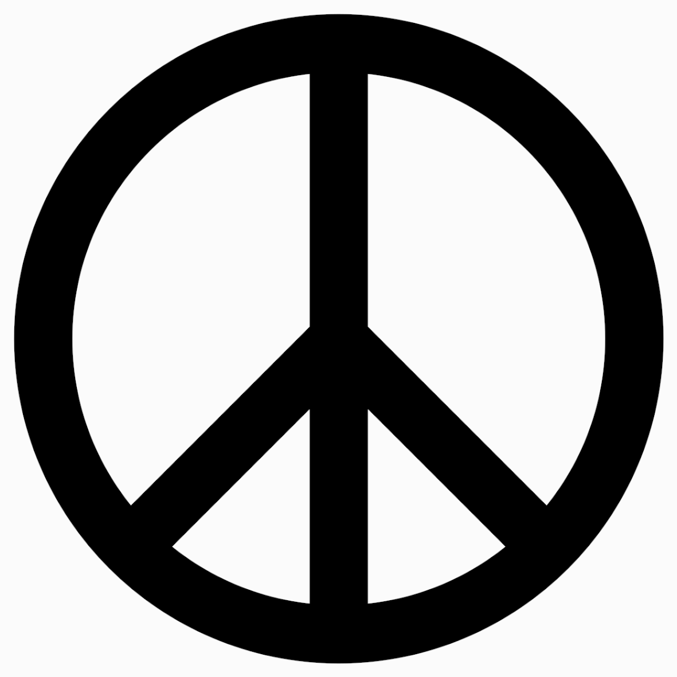
peace-sign-sao/image.png
