TomKeddie/prj-pcb-experiments/peace-sign-sao/image/original-image.png

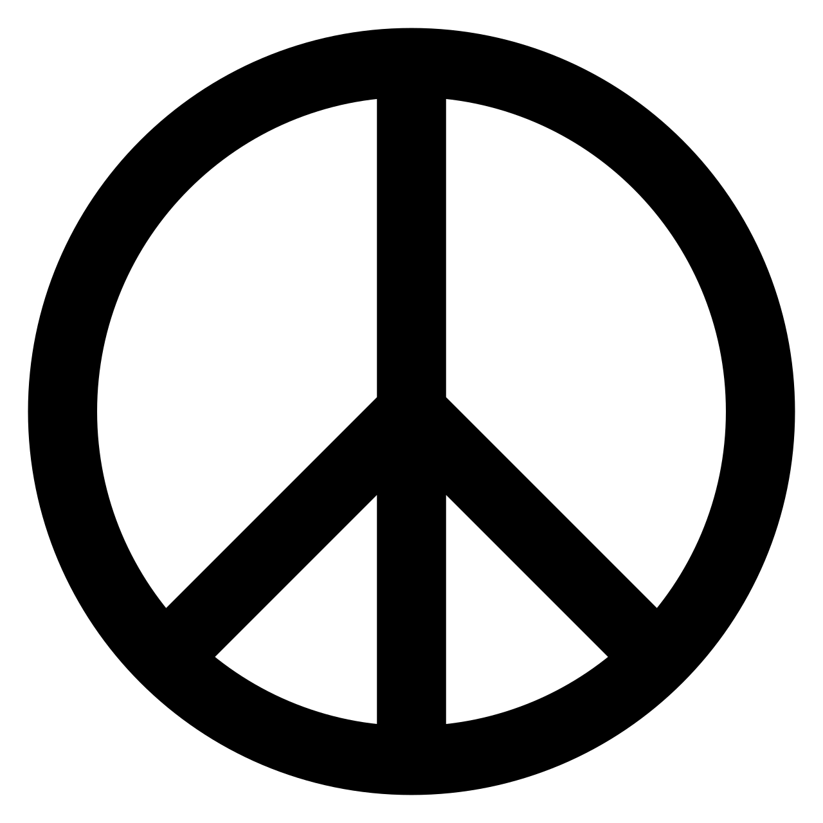
peace-sign-sao/image/original-image.png
