TomKeddie/prj-pcb-experiments/sao-traffic-light/images/red-24177_960_720_outline.png

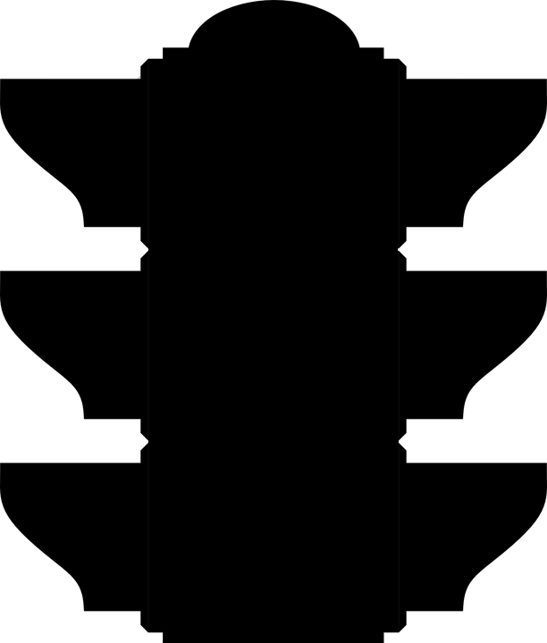
sao-traffic-light/images/red-24177_960_720_outline.png
