TomKeddie/prj-pcb-experiments/skull-roses/_03d44909-954a-43f8-8c18-2034c4294b49.jpeg

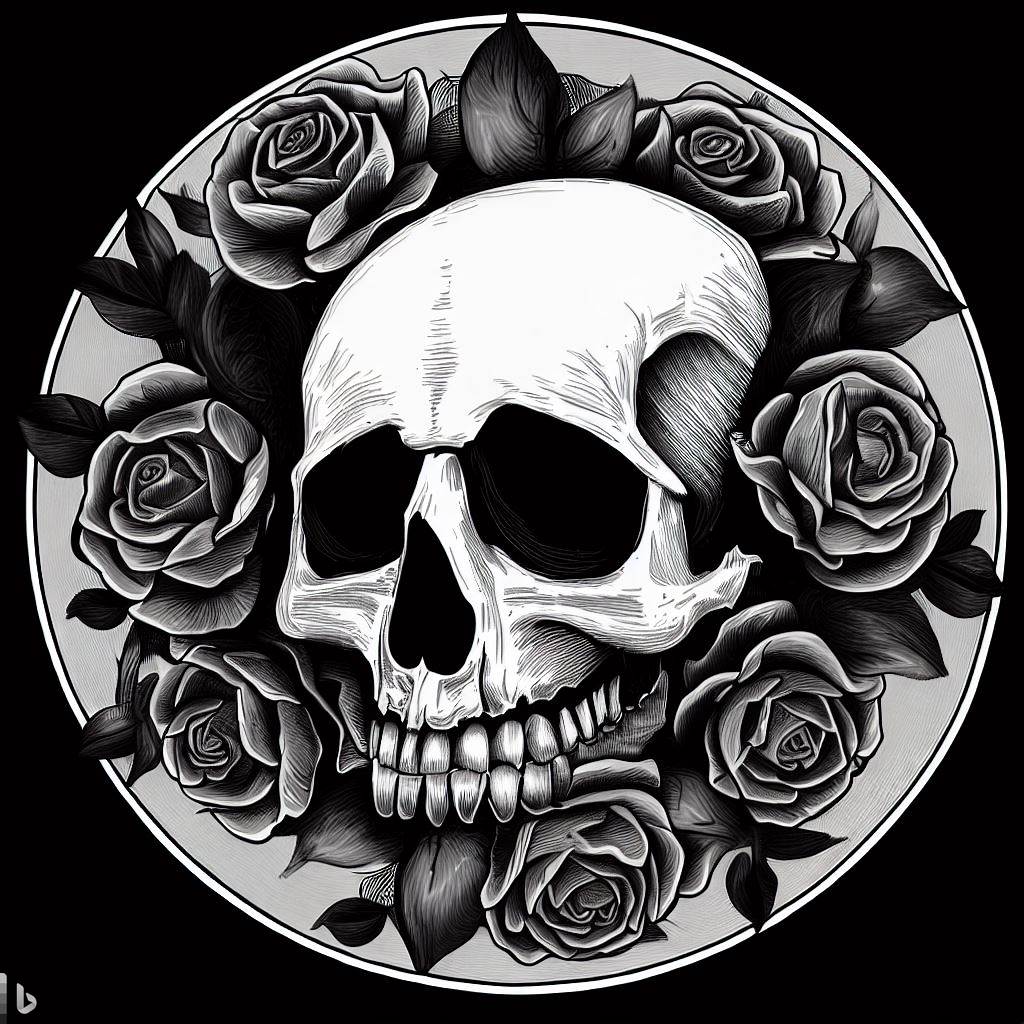
skull-roses/_03d44909-954a-43f8-8c18-2034c4294b49.jpeg
