TomKeddie/prj-pcb-experiments/skull-roses/_679a609d-0440-4eb6-a7e9-5fab45a64eaa.jpeg

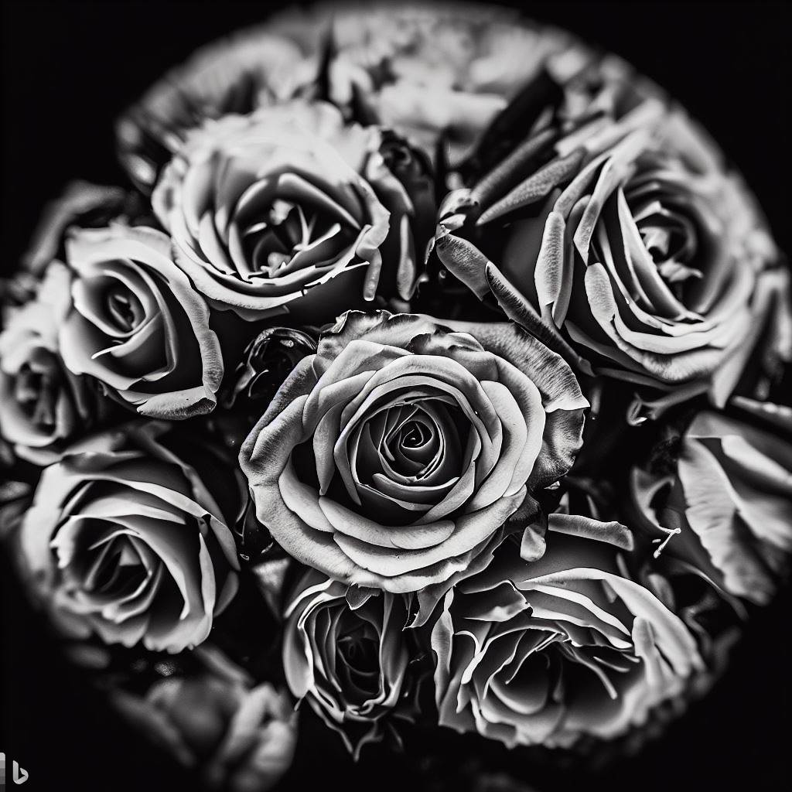
skull-roses/_679a609d-0440-4eb6-a7e9-5fab45a64eaa.jpeg
