TomKeddie/prj-pcb-experiments/skull-roses/skull-teeth.png

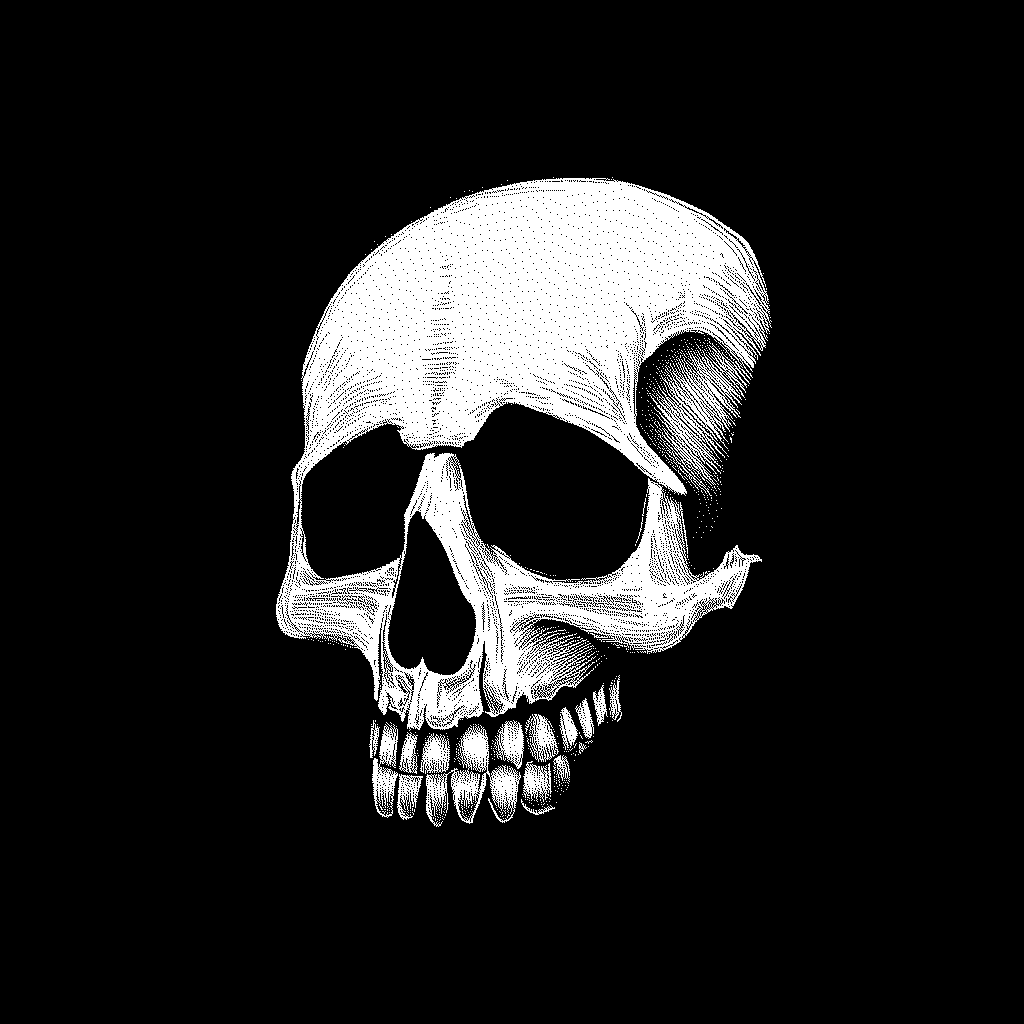
skull-roses/skull-teeth.png
