TomKeddie/prj-pcb-experiments/skull-roses/teeth.png

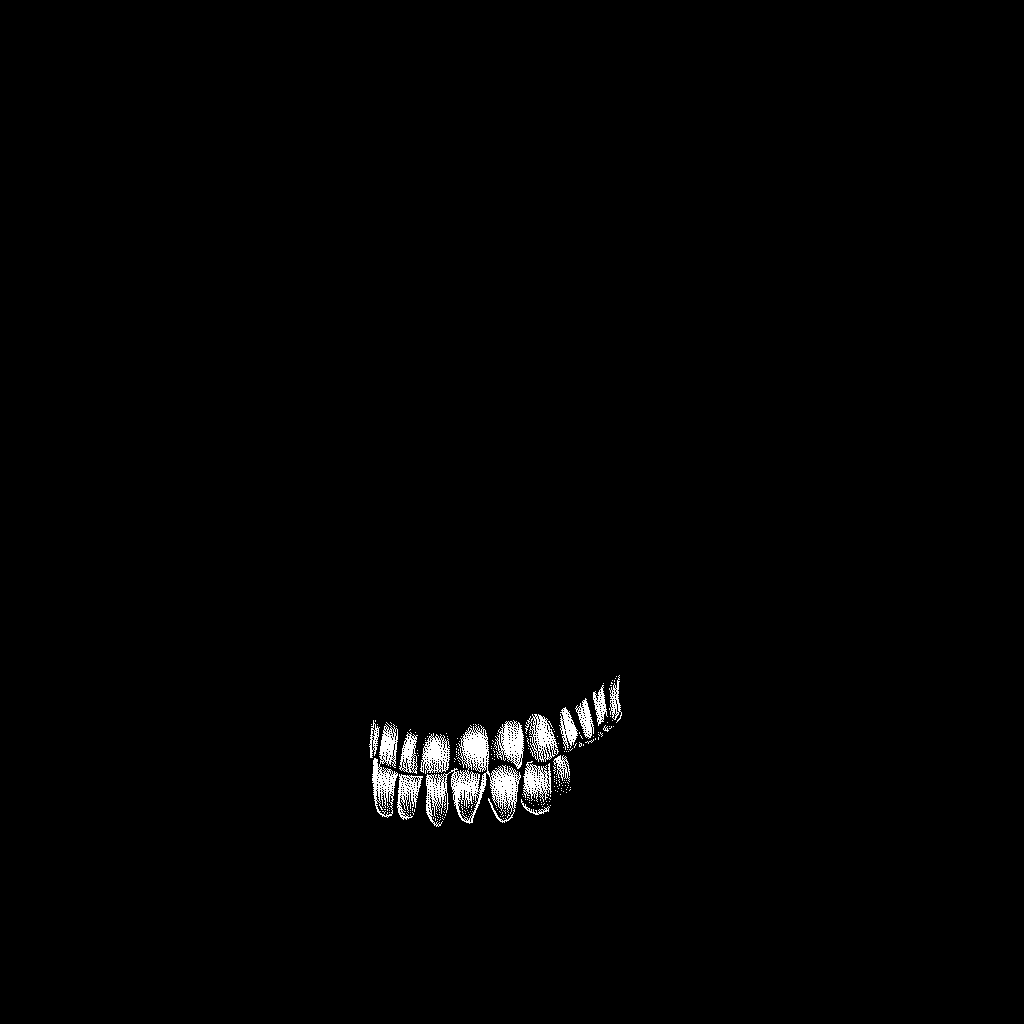
skull-roses/teeth.png
