TomKeddie/prj-pcb-experiments/snoopy-sao/snoopy-sao/snoopy-copper.png

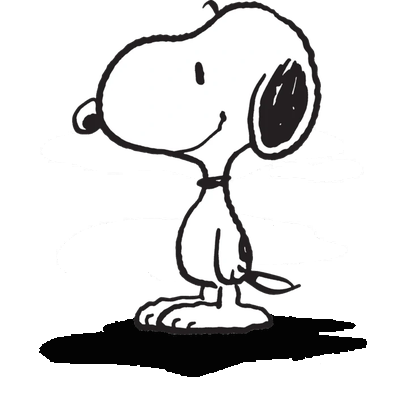
snoopy-sao/snoopy-sao/snoopy-copper.png
