TomKeddie/prj-pcb-experiments/snoopy-sao/snoopy-sao/snoopy-filled.png

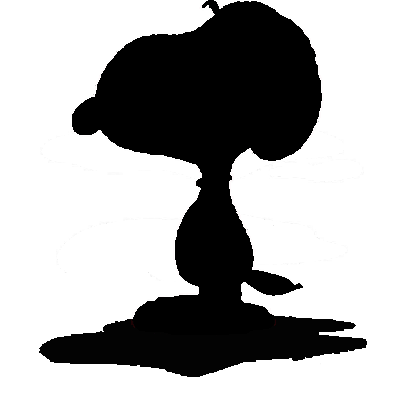
snoopy-sao/snoopy-sao/snoopy-filled.png
