TomKeddie/prj-pcb-experiments/snoopy-sao/snoopy-sao/snoopy-mask.png

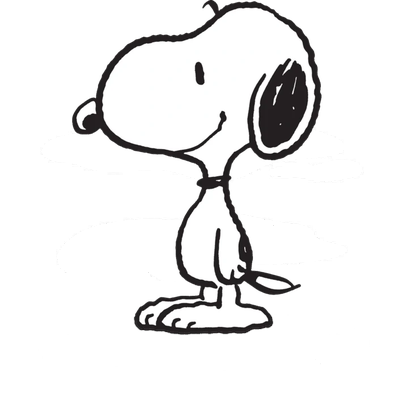
snoopy-sao/snoopy-sao/snoopy-mask.png
