TomKeddie/prj-pcb-experiments/snoopy-sao/snoopy-sao/Snoopy_Peanuts.png

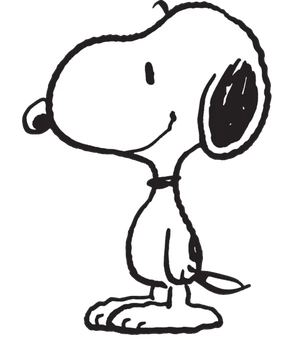
snoopy-sao/snoopy-sao/Snoopy_Peanuts.png
