TomKeddie/prj-pcb-experiments/snoopy-sao/woodstock/WoodstockTransparent.png

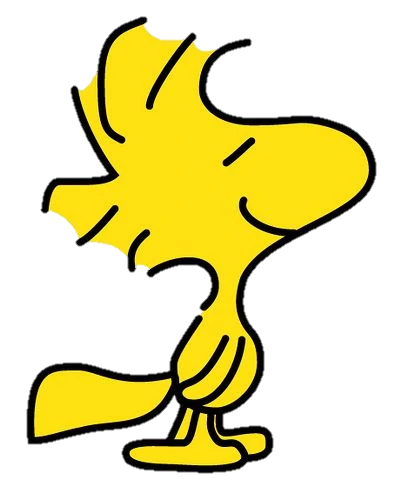
snoopy-sao/woodstock/WoodstockTransparent.png
