TomKeddie/prj-pcb-experiments/syzygy-serdes-breakout/Screenshot_2020-11-26_18-54-43.png

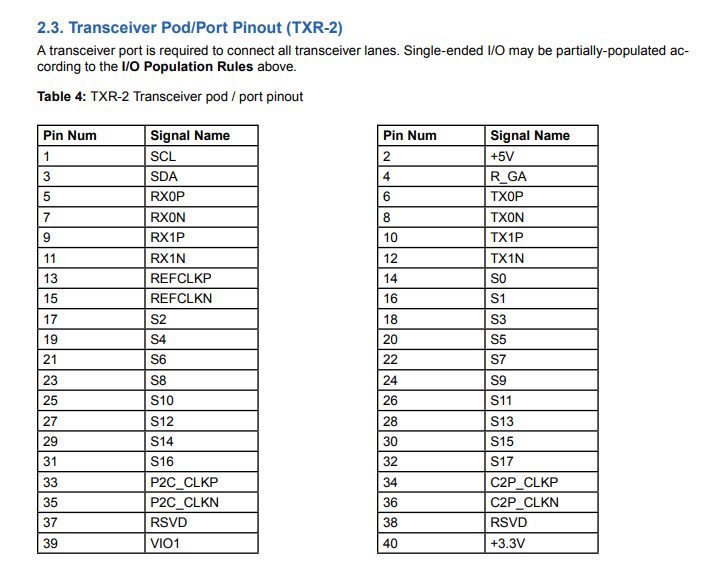
syzygy-serdes-breakout/Screenshot_2020-11-26_18-54-43.png
