TomKeddie/prj-pcb-experiments/tag-connect-breakout/data/GD_AVR_SPI.png

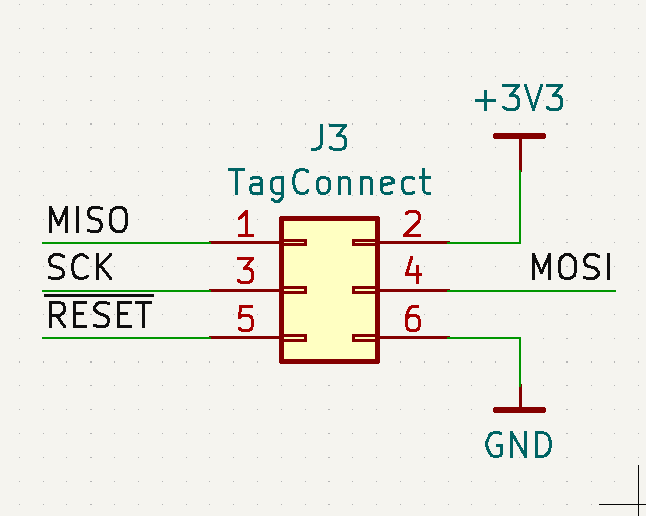
tag-connect-breakout/data/GD_AVR_SPI.png
