TomKeddie/prj-pcb-experiments/tag-connect-breakout/data/TC2030-Altera.png

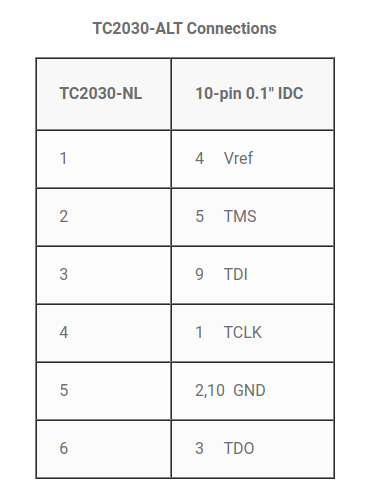
tag-connect-breakout/data/TC2030-Altera.png
