TomKeddie/prj-pcb-experiments/tag-connect-breakout/data/TC2030-ICE-SPI.png

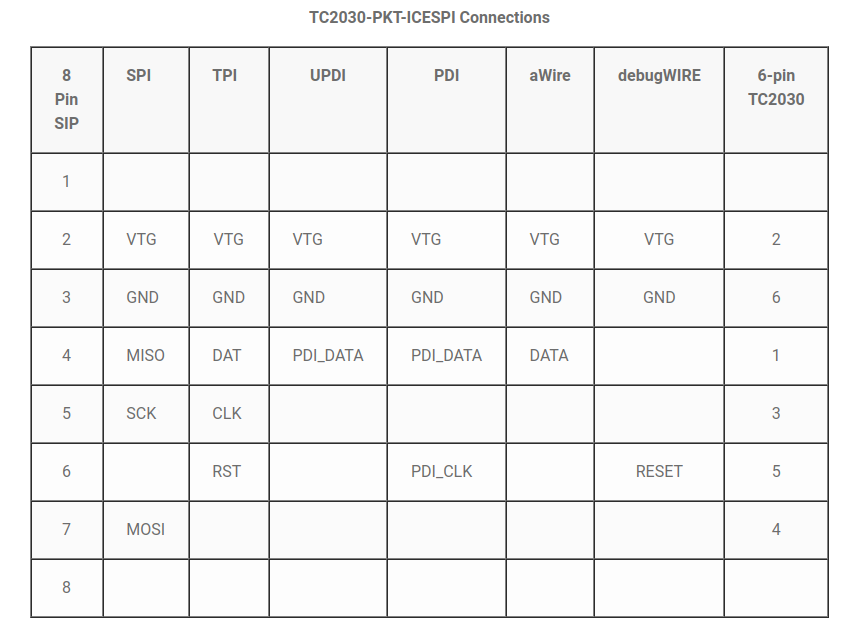
tag-connect-breakout/data/TC2030-ICE-SPI.png
