TomKeddie/prj-pcb-experiments/tag-connect-breakout/data/TC2030-IDC-NL.png

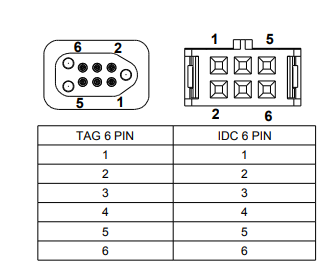
tag-connect-breakout/data/TC2030-IDC-NL.png
