TomKeddie/prj-pcb-experiments/tag-connect-breakout/data/TC2030-MCP-NL.png

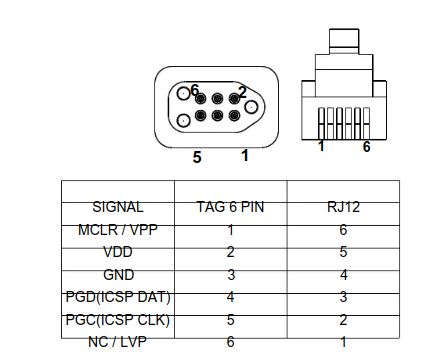
tag-connect-breakout/data/TC2030-MCP-NL.png
