TomKeddie/prj-pcb-experiments/tag-connect-breakout/data/TC2030-SERIAL-CTS.png

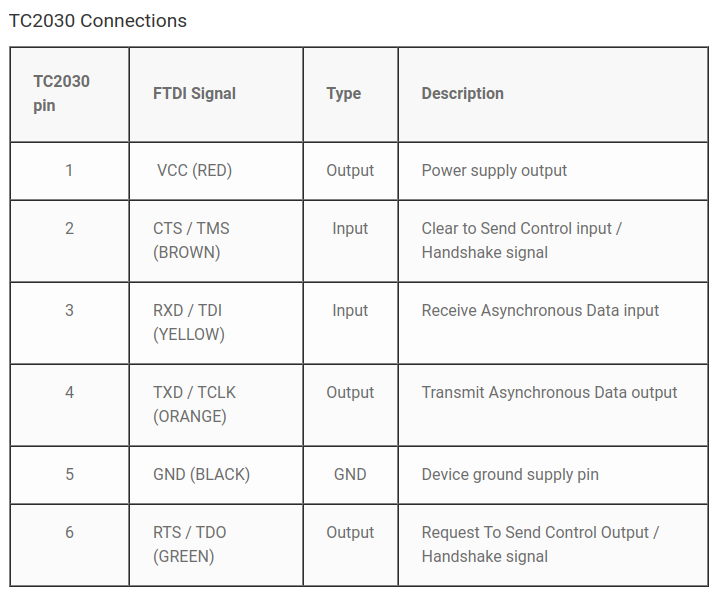
tag-connect-breakout/data/TC2030-SERIAL-CTS.png
