TomKeddie/prj-pcb-experiments/tag-connect-breakout/data/TC2030-SERIAL-DTR.png

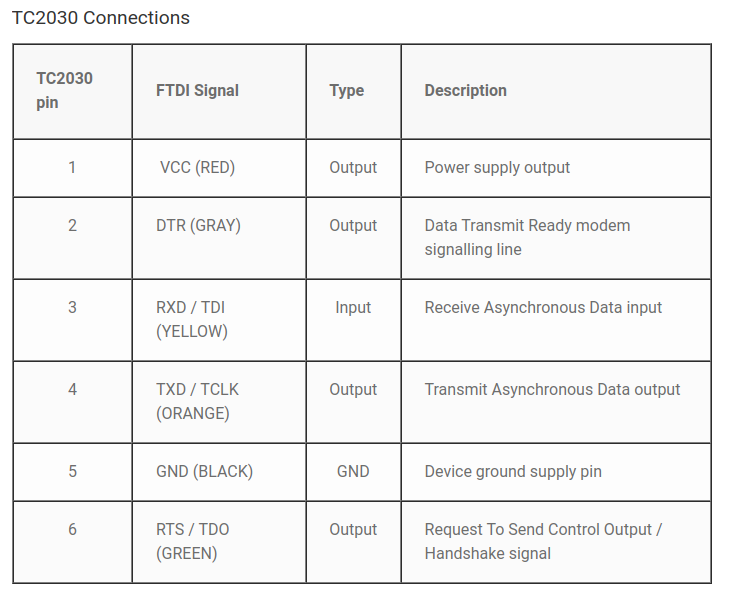
tag-connect-breakout/data/TC2030-SERIAL-DTR.png
