TomKeddie/prj-pcb-experiments/tag-connect-breakout/data/TC2030-SWD-20PIN.png

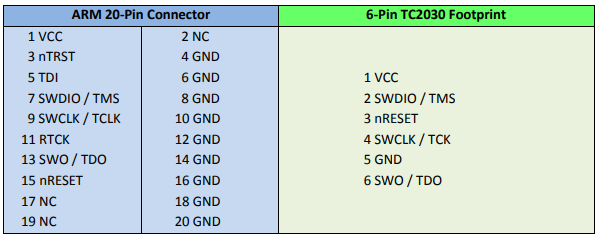
tag-connect-breakout/data/TC2030-SWD-20PIN.png
