TomKeddie/prj-pcb-experiments/tag-connect-breakout/data/TC2030-SWD.png

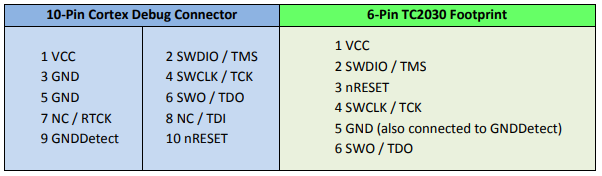
tag-connect-breakout/data/TC2030-SWD.png
