TomKeddie/prj-pcb-experiments/tag-connect-breakout/data/TC2030-USB.png

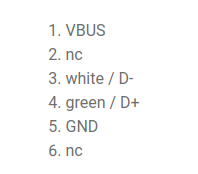
tag-connect-breakout/data/TC2030-USB.png
