TomKeddie/prj-pcb-experiments/tag-connect-breakout/data/TC2050-ARM2010.png

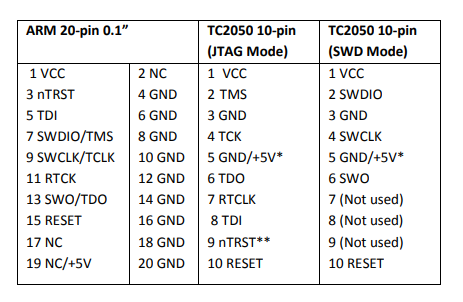
tag-connect-breakout/data/TC2050-ARM2010.png
