TomKeddie/prj-pcb-experiments/tag-connect-breakout/data/TC2050-ETM-TRACE.png

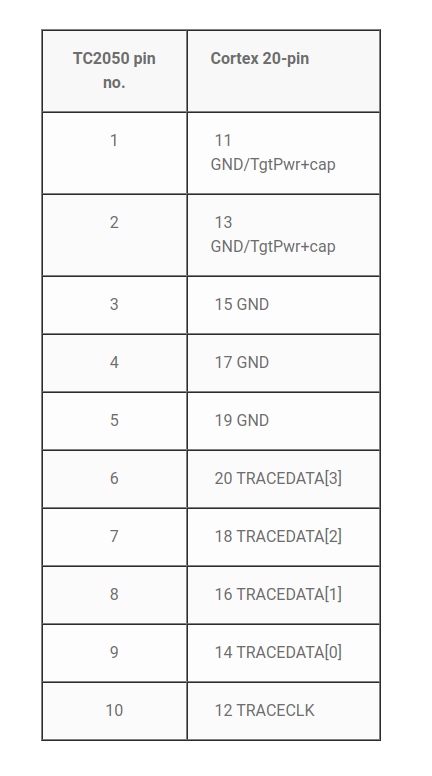
tag-connect-breakout/data/TC2050-ETM-TRACE.png
