TomKeddie/prj-pcb-experiments/tag-connect-breakout/data/TC2050-IDC-NL.png

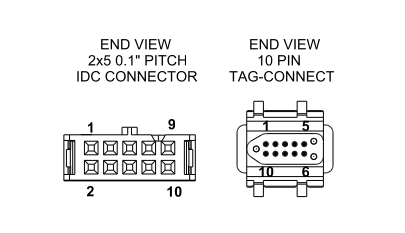
tag-connect-breakout/data/TC2050-IDC-NL.png
