TomKeddie/prj-pcb-experiments/tag-connect-breakout/data/TC2050-JTAG.png

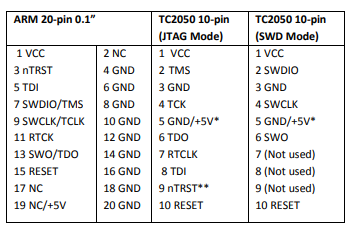
tag-connect-breakout/data/TC2050-JTAG.png
