TomKeddie/prj-pcb-experiments/tag-connect-breakout/data/TC2050-PG-MSP.png

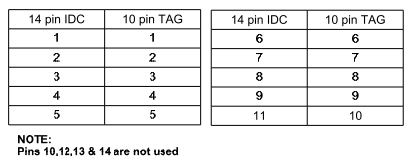
tag-connect-breakout/data/TC2050-PG-MSP.png
