TomKeddie/prj-pcb-experiments/tag-connect-breakout/data/TC2050-PG-USB.png

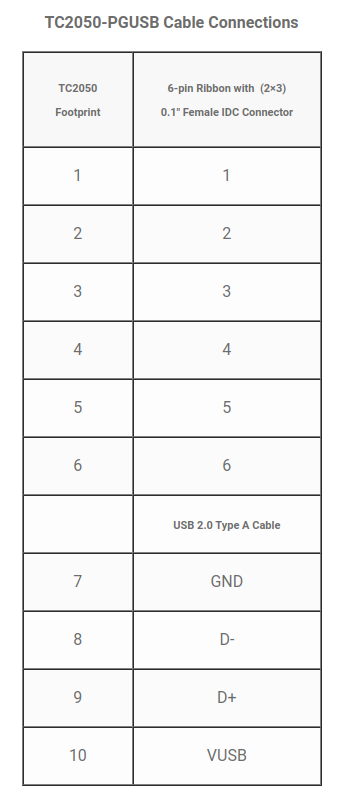
tag-connect-breakout/data/TC2050-PG-USB.png
