TomKeddie/prj-pcb-experiments/2025-pmod-sma/2025-pmod-sma.kicad_sch.bom.csv

Value | Designator | Footprint | LCSC
Conn_01x02,Conn_02x06_Top_Bottom,Conn_02x08_Top_Bottom | J1-J3 | lib:PinHeader_2x06_P2.54mm_Horizontal_Top_Bottom,lib:PinHeader_2x08_P2.54mm_Vertical_Top_Bottom,lib:SMA_Amphenol_901-143_Horizontal
