TomKeddie/prj-pcb-experiments/blue-pill-bmp/hardware/bom/blue-pill-bmp-jlc-.csv

Comment | Designator
0.1uF/10V | C4,C5,C6,C7
100uF/6.3V | C3
10uF/10V | C2
12.5pF/10V | C10,C11
1uF/10V | C1
20pF/10V | C8,C9
BLUE | D1
GREEN | D3
RED | D2
Conn_01x04 | J3
Conn_01x06 | J1
Conn_02x05_SWD | J4
USB_C_16PIN | J2
20R | R7,R8
1k | R1,R3,R4
1.5k | R9
5.1k | R10,R11
10k | R2
100k | R5,R6
SW_DPDT_x2 | SW2
SW_SPST | SW1
STM32F103C8T6 | U1
LM1117MPX-3.3 | VR1
32.768kHz | X2
8MHz | X1
