TomKeddie/prj-pcb-experiments/minim-wemos-2023/minim-wemos-2023.kicad_sch.jlc.csv

Comment | Designator | Footprint | LCSC
WS2812B | D1,D2,D3,D4,D5,D6,D7,D8,D9,D10,D11,D12,D13,D14,D15,D16 | LED_SMD:LED_WS2812B_PLCC4_5.0x5.0mm_P3.2mm | C2843785
