TomKeddie/prj-pcb-experiments/ft4232h-breakout/v3.x/ft4232h-breakout.csv

Source: | /home/tom/git/TomKeddie/prj-pcb-experiments/ft4232h-breakout/v3.x/ft4232h-breakout.kicad_sch
Date: | Thu 19 May 2022 01:47:25 PM
Tool: | Eeschema 6.0.5-a6ca702e91~116~ubuntu20.04.1
Generator: | /usr/share/kicad/plugins/bom_csv_grouped_by_value.py
Component Count: | 73
Individual Components:
Item | Qty | Reference(s) | Value | LibPart | Footprint | Datasheet | Colour | DIGIKEY | LCSC | MANUFACTURER | MAXIMUM_PACKAGE_HEIGHT | MFG | MFGPN | MPN | PARTREV | STANDARD
 |  | C1 | 10uF_10V_X5R | jlcpcb-basic-capacitor-0603:10uF_10V_X5R | tom-passives:C_0603_1608Metric | https://datasheet.lcsc.com/lcsc/1810191219_Samsung-Electro-Mechanics-CL10A106KP8NNNC_C19702.pdf |  |  | C19702 |  |  | Samsung Electro-Mechanics | CL10A106KP8NNNC
 |  | C2 | 10uF_10V_X5R | jlcpcb-basic-capacitor-0603:10uF_10V_X5R | tom-passives:C_0603_1608Metric | https://datasheet.lcsc.com/lcsc/1810191219_Samsung-Electro-Mechanics-CL10A106KP8NNNC_C19702.pdf |  |  | C19702 |  |  | Samsung Electro-Mechanics | CL10A106KP8NNNC
 |  | C3 | 100nF_50V_X7R | jlcpcb-basic-capacitor-0402:100nF_50V_X7R | tom-passives:C_0402_1005Metric | https://datasheet.lcsc.com/lcsc/1810191222_Samsung-Electro-Mechanics-CL05B104KB54PNC_C307331.pdf |  |  | C307331 |  |  | Samsung Electro-Mechanics | CL05B104KB54PNC
 |  | C4 | 20pF_50V_C0G | jlcpcb-basic-capacitor-0402:20pF_50V_C0G | tom-passives:C_0402_1005Metric | https://datasheet.lcsc.com/lcsc/1811141710_FH-Guangdong-Fenghua-Advanced-Tech-0402CG200J500NT_C1554.pdf |  |  | C1554 |  |  | FH(Guangdong Fenghua Advanced Tech) | 0402CG200J500NT
 |  | C5 | 4.7uF_10V_X5R | jlcpcb-basic-capacitor-0402:4.7uF_10V_X5R | tom-passives:C_0402_1005Metric | https://datasheet.lcsc.com/lcsc/1810191211_Samsung-Electro-Mechanics-CL05A475MP5NRNC_C23733.pdf |  |  | C23733 |  |  | Samsung Electro-Mechanics | CL05A475MP5NRNC
 |  | C6 | 20pF_50V_C0G | jlcpcb-basic-capacitor-0402:20pF_50V_C0G | tom-passives:C_0402_1005Metric | https://datasheet.lcsc.com/lcsc/1811141710_FH-Guangdong-Fenghua-Advanced-Tech-0402CG200J500NT_C1554.pdf |  |  | C1554 |  |  | FH(Guangdong Fenghua Advanced Tech) | 0402CG200J500NT
 |  | C7 | 100nF_50V_X7R | jlcpcb-basic-capacitor-0402:100nF_50V_X7R | tom-passives:C_0402_1005Metric | https://datasheet.lcsc.com/lcsc/1810191222_Samsung-Electro-Mechanics-CL05B104KB54PNC_C307331.pdf |  |  | C307331 |  |  | Samsung Electro-Mechanics | CL05B104KB54PNC
 |  | C8 | 100nF_50V_X7R | jlcpcb-basic-capacitor-0402:100nF_50V_X7R | tom-passives:C_0402_1005Metric | https://datasheet.lcsc.com/lcsc/1810191222_Samsung-Electro-Mechanics-CL05B104KB54PNC_C307331.pdf |  |  | C307331 |  |  | Samsung Electro-Mechanics | CL05B104KB54PNC
 |  | C9 | 100nF_50V_X7R | jlcpcb-basic-capacitor-0402:100nF_50V_X7R | tom-passives:C_0402_1005Metric | https://datasheet.lcsc.com/lcsc/1810191222_Samsung-Electro-Mechanics-CL05B104KB54PNC_C307331.pdf |  |  | C307331 |  |  | Samsung Electro-Mechanics | CL05B104KB54PNC
 |  | C10 | 100nF_50V_X7R | jlcpcb-basic-capacitor-0402:100nF_50V_X7R | tom-passives:C_0402_1005Metric | https://datasheet.lcsc.com/lcsc/1810191222_Samsung-Electro-Mechanics-CL05B104KB54PNC_C307331.pdf |  |  | C307331 |  |  | Samsung Electro-Mechanics | CL05B104KB54PNC
 |  | C11 | 100nF_50V_X7R | jlcpcb-basic-capacitor-0402:100nF_50V_X7R | tom-passives:C_0402_1005Metric | https://datasheet.lcsc.com/lcsc/1810191222_Samsung-Electro-Mechanics-CL05B104KB54PNC_C307331.pdf |  |  | C307331 |  |  | Samsung Electro-Mechanics | CL05B104KB54PNC
 |  | C12 | 10nF_50V_X7R | jlcpcb-basic-capacitor-0402:10nF_50V_X7R | tom-passives:C_0402_1005Metric | https://datasheet.lcsc.com/lcsc/1810191223_Samsung-Electro-Mechanics-CL05B103KB5NNNC_C15195.pdf |  |  | C15195 |  |  | Samsung Electro-Mechanics | CL05B103KB5NNNC
 |  | C13 | 100nF_50V_X7R | jlcpcb-basic-capacitor-0402:100nF_50V_X7R | tom-passives:C_0402_1005Metric | https://datasheet.lcsc.com/lcsc/1810191222_Samsung-Electro-Mechanics-CL05B104KB54PNC_C307331.pdf |  |  | C307331 |  |  | Samsung Electro-Mechanics | CL05B104KB54PNC
 |  | C14 | 100nF_50V_X7R | jlcpcb-basic-capacitor-0402:100nF_50V_X7R | tom-passives:C_0402_1005Metric | https://datasheet.lcsc.com/lcsc/1810191222_Samsung-Electro-Mechanics-CL05B104KB54PNC_C307331.pdf |  |  | C307331 |  |  | Samsung Electro-Mechanics | CL05B104KB54PNC
 |  | C15 | 4.7uF_10V_X5R | jlcpcb-basic-capacitor-0402:4.7uF_10V_X5R | tom-passives:C_0402_1005Metric | https://datasheet.lcsc.com/lcsc/1810191211_Samsung-Electro-Mechanics-CL05A475MP5NRNC_C23733.pdf |  |  | C23733 |  |  | Samsung Electro-Mechanics | CL05A475MP5NRNC
 |  | C16 | 100nF_50V_X7R | jlcpcb-basic-capacitor-0402:100nF_50V_X7R | tom-passives:C_0402_1005Metric | https://datasheet.lcsc.com/lcsc/1810191222_Samsung-Electro-Mechanics-CL05B104KB54PNC_C307331.pdf |  |  | C307331 |  |  | Samsung Electro-Mechanics | CL05B104KB54PNC
 |  | C17 | 4.7uF_10V_X5R | jlcpcb-basic-capacitor-0402:4.7uF_10V_X5R | tom-passives:C_0402_1005Metric | https://datasheet.lcsc.com/lcsc/1810191211_Samsung-Electro-Mechanics-CL05A475MP5NRNC_C23733.pdf |  |  | C23733 |  |  | Samsung Electro-Mechanics | CL05A475MP5NRNC
 |  | C18 | 100nF_50V_X7R | jlcpcb-basic-capacitor-0402:100nF_50V_X7R | tom-passives:C_0402_1005Metric | https://datasheet.lcsc.com/lcsc/1810191222_Samsung-Electro-Mechanics-CL05B104KB54PNC_C307331.pdf |  |  | C307331 |  |  | Samsung Electro-Mechanics | CL05B104KB54PNC
 |  | C19 | 100nF_50V_X7R | jlcpcb-basic-capacitor-0402:100nF_50V_X7R | tom-passives:C_0402_1005Metric | https://datasheet.lcsc.com/lcsc/1810191222_Samsung-Electro-Mechanics-CL05B104KB54PNC_C307331.pdf |  |  | C307331 |  |  | Samsung Electro-Mechanics | CL05B104KB54PNC
 |  | C20 | 100nF_50V_X7R | jlcpcb-basic-capacitor-0402:100nF_50V_X7R | tom-passives:C_0402_1005Metric | https://datasheet.lcsc.com/lcsc/1810191222_Samsung-Electro-Mechanics-CL05B104KB54PNC_C307331.pdf |  |  | C307331 |  |  | Samsung Electro-Mechanics | CL05B104KB54PNC
 |  | C21 | 100nF_50V_X7R | jlcpcb-basic-capacitor-0402:100nF_50V_X7R | tom-passives:C_0402_1005Metric | https://datasheet.lcsc.com/lcsc/1810191222_Samsung-Electro-Mechanics-CL05B104KB54PNC_C307331.pdf |  |  | C307331 |  |  | Samsung Electro-Mechanics | CL05B104KB54PNC
 |  | C22 | 100nF_50V_X7R | jlcpcb-basic-capacitor-0402:100nF_50V_X7R | tom-passives:C_0402_1005Metric | https://datasheet.lcsc.com/lcsc/1810191222_Samsung-Electro-Mechanics-CL05B104KB54PNC_C307331.pdf |  |  | C307331 |  |  | Samsung Electro-Mechanics | CL05B104KB54PNC
 |  | D1 | LED | tom-opto:LED | tom-opto:LED_0603_1608Metric | ~ |  |  | C2290
 |  | D2 | TXA | tom-opto:LED | tom-opto:LED_0603_1608Metric | ~ | WHT |  | C2290
 |  | D3 | RXA | tom-opto:LED | tom-opto:LED_0603_1608Metric | ~ | RED |  | C2290
 |  | D4 | TXB | tom-opto:LED | tom-opto:LED_0603_1608Metric | ~ | WHT |  | C2290
 |  | D5 | RXB | tom-opto:LED | tom-opto:LED_0603_1608Metric | ~ | RED |  | C2290
 |  | D6 | TXC | tom-opto:LED | tom-opto:LED_0603_1608Metric | ~ | WHT |  | C2290
 |  | D7 | RXC | tom-opto:LED | tom-opto:LED_0603_1608Metric | ~ | RED |  | C2290
 |  | D8 | TXD | tom-opto:LED | tom-opto:LED_0603_1608Metric | ~ | WHT |  | C2290
 |  | D9 | RXD | tom-opto:LED | tom-opto:LED_0603_1608Metric | ~ | RED |  | C2290
 |  | FB1 | 500mA/600R | tom-passives:FILTER | tom-passives:C_0805_2012Metric |  |  |  | C1017
 |  | FB2 | 500mA/600R | tom-passives:FILTER | tom-passives:C_0805_2012Metric |  |  |  | C1017
 |  | FB3 | 500mA/600R | tom-passives:FILTER | tom-passives:C_0805_2012Metric |  |  |  | C1017
 |  | J1 | Conn_01x03 | tom-connectors:Conn_01x03 | tom-connectors:PinHeader_1x03_P2.54mm_Horizontal | ~ |  |  | C492411
 |  | J2 | Conn_01x03 | tom-connectors:Conn_01x03 | tom-connectors:PinHeader_1x03_P2.54mm_Horizontal | ~ |  |  | C492411
 |  | J3 | Conn_01x03 | tom-connectors:Conn_01x03 | tom-connectors:PinHeader_1x03_P2.54mm_Horizontal | ~ |  |  | C492411
 |  | J4 | Conn_01x03 | tom-connectors:Conn_01x03 | tom-connectors:PinHeader_1x03_P2.54mm_Horizontal | ~ |  |  | C492411
 |  | J5 | JLCPCB_3.5MM_SOCKET_C18166 | tom-connectors:JLCPCB_3.5MM_SOCKET_C18166 | tom-connectors:JLCPCB_3.5MM_SOCKET_C18166 | https://atta.szlcsc.com/upload/public/pdf/source/20211011/0B1C3F8D3B14DEB4B55195420484A083.pdf |  |  | C18166 |  |  |  |  | PJ-3200
 |  | J6 | JLCPCB_3.5MM_SOCKET_C18166 | tom-connectors:JLCPCB_3.5MM_SOCKET_C18166 | tom-connectors:JLCPCB_3.5MM_SOCKET_C18166 | https://atta.szlcsc.com/upload/public/pdf/source/20211011/0B1C3F8D3B14DEB4B55195420484A083.pdf |  |  | C18166 |  |  |  |  | PJ-3200
 |  | J7 | JLCPCB_3.5MM_SOCKET_C18166 | tom-connectors:JLCPCB_3.5MM_SOCKET_C18166 | tom-connectors:JLCPCB_3.5MM_SOCKET_C18166 | https://atta.szlcsc.com/upload/public/pdf/source/20211011/0B1C3F8D3B14DEB4B55195420484A083.pdf |  |  | C18166 |  |  |  |  | PJ-3200
 |  | J8 | JLCPCB_3.5MM_SOCKET_C18166 | tom-connectors:JLCPCB_3.5MM_SOCKET_C18166 | tom-connectors:JLCPCB_3.5MM_SOCKET_C18166 | https://atta.szlcsc.com/upload/public/pdf/source/20211011/0B1C3F8D3B14DEB4B55195420484A083.pdf |  |  | C18166 |  |  |  |  | PJ-3200
 |  | J9 | USB_B_Micro | tom-connectors:USB_B_Micro | tom-connectors:USB_B_Micro_LCSC_C10418 | ~ |  |  | C10418
 |  | J10 | USB_C_Receptacle_USB2.0 | tom-connectors:USB_C_Receptacle_USB2.0 | tom-connectors:USB_C_Receptacle_LCSC_C165948 | https://www.usb.org/sites/default/files/documents/usb_type-c.zip |  |  | C165948
 |  | R1 | 10 | jlcpcb-basic-resistor-0402:10 | tom-passives:R_0402_1005Metric | https://datasheet.lcsc.com/lcsc/2110252230_UNI-ROYAL-Uniroyal-Elec-0402WGF100JTCE_C25077.pdf |  |  | C25077 |  |  | UNI-ROYAL(Uniroyal Elec) | 0402WGF100JTCE
 |  | R2 | 330 | jlcpcb-basic-resistor-0402:330 | tom-passives:R_0402_1005Metric | https://datasheet.lcsc.com/lcsc/2110252230_UNI-ROYAL-Uniroyal-Elec-0402WGF3300TCE_C25104.pdf |  |  | C25104 |  |  | UNI-ROYAL(Uniroyal Elec) | 0402WGF3300TCE
 |  | R3 | 330 | jlcpcb-basic-resistor-0402:330 | tom-passives:R_0402_1005Metric | https://datasheet.lcsc.com/lcsc/2110252230_UNI-ROYAL-Uniroyal-Elec-0402WGF3300TCE_C25104.pdf |  |  | C25104 |  |  | UNI-ROYAL(Uniroyal Elec) | 0402WGF3300TCE
 |  | R4 | 330 | jlcpcb-basic-resistor-0402:330 | tom-passives:R_0402_1005Metric | https://datasheet.lcsc.com/lcsc/2110252230_UNI-ROYAL-Uniroyal-Elec-0402WGF3300TCE_C25104.pdf |  |  | C25104 |  |  | UNI-ROYAL(Uniroyal Elec) | 0402WGF3300TCE
 |  | R5 | 330 | jlcpcb-basic-resistor-0402:330 | tom-passives:R_0402_1005Metric | https://datasheet.lcsc.com/lcsc/2110252230_UNI-ROYAL-Uniroyal-Elec-0402WGF3300TCE_C25104.pdf |  |  | C25104 |  |  | UNI-ROYAL(Uniroyal Elec) | 0402WGF3300TCE
 |  | R6 | 330 | jlcpcb-basic-resistor-0402:330 | tom-passives:R_0402_1005Metric | https://datasheet.lcsc.com/lcsc/2110252230_UNI-ROYAL-Uniroyal-Elec-0402WGF3300TCE_C25104.pdf |  |  | C25104 |  |  | UNI-ROYAL(Uniroyal Elec) | 0402WGF3300TCE
 |  | R7 | 330 | jlcpcb-basic-resistor-0402:330 | tom-passives:R_0402_1005Metric | https://datasheet.lcsc.com/lcsc/2110252230_UNI-ROYAL-Uniroyal-Elec-0402WGF3300TCE_C25104.pdf |  |  | C25104 |  |  | UNI-ROYAL(Uniroyal Elec) | 0402WGF3300TCE
 |  | R8 | 330 | jlcpcb-basic-resistor-0402:330 | tom-passives:R_0402_1005Metric | https://datasheet.lcsc.com/lcsc/2110252230_UNI-ROYAL-Uniroyal-Elec-0402WGF3300TCE_C25104.pdf |  |  | C25104 |  |  | UNI-ROYAL(Uniroyal Elec) | 0402WGF3300TCE
 |  | R9 | 330 | jlcpcb-basic-resistor-0402:330 | tom-passives:R_0402_1005Metric | https://datasheet.lcsc.com/lcsc/2110252230_UNI-ROYAL-Uniroyal-Elec-0402WGF3300TCE_C25104.pdf |  |  | C25104 |  |  | UNI-ROYAL(Uniroyal Elec) | 0402WGF3300TCE
 |  | R10 | 10k | jlcpcb-basic-resistor-0402:10k | tom-passives:R_0402_1005Metric | https://datasheet.lcsc.com/lcsc/2110260030_UNI-ROYAL-Uniroyal-Elec-0402WGF1002TCE_C25744.pdf |  |  | C25744 |  |  | UNI-ROYAL(Uniroyal Elec) | 0402WGF1002TCE
 |  | R11 | 10 | jlcpcb-basic-resistor-0402:10 | tom-passives:R_0402_1005Metric | https://datasheet.lcsc.com/lcsc/2110252230_UNI-ROYAL-Uniroyal-Elec-0402WGF100JTCE_C25077.pdf |  |  | C25077 |  |  | UNI-ROYAL(Uniroyal Elec) | 0402WGF100JTCE
 |  | R12 | 15k | jlcpcb-basic-resistor-0402:15k | tom-passives:R_0402_1005Metric | https://datasheet.lcsc.com/lcsc/2110260030_UNI-ROYAL-Uniroyal-Elec-0402WGF1502TCE_C25756.pdf |  |  | C25756 |  |  | UNI-ROYAL(Uniroyal Elec) | 0402WGF1502TCE
 |  | R13 | 10k | jlcpcb-basic-resistor-0402:10k | tom-passives:R_0402_1005Metric | https://datasheet.lcsc.com/lcsc/2110260030_UNI-ROYAL-Uniroyal-Elec-0402WGF1002TCE_C25744.pdf |  |  | C25744 |  |  | UNI-ROYAL(Uniroyal Elec) | 0402WGF1002TCE
 |  | R14 | 12k | jlcpcb-basic-resistor-0402:12k | tom-passives:R_0402_1005Metric | https://datasheet.lcsc.com/lcsc/2110260030_UNI-ROYAL-Uniroyal-Elec-0402WGF1202TCE_C25752.pdf |  |  | C25752 |  |  | UNI-ROYAL(Uniroyal Elec) | 0402WGF1202TCE
 |  | R15 | 10k | jlcpcb-basic-resistor-0402:10k | tom-passives:R_0402_1005Metric | https://datasheet.lcsc.com/lcsc/2110260030_UNI-ROYAL-Uniroyal-Elec-0402WGF1002TCE_C25744.pdf |  |  | C25744 |  |  | UNI-ROYAL(Uniroyal Elec) | 0402WGF1002TCE
 |  | R16 | 2.2k | jlcpcb-basic-resistor-0402:2.2k | tom-passives:R_0402_1005Metric | https://datasheet.lcsc.com/lcsc/2110260030_UNI-ROYAL-Uniroyal-Elec-0402WGF2201TCE_C25879.pdf |  |  | C25879 |  |  | UNI-ROYAL(Uniroyal Elec) | 0402WGF2201TCE
 |  | R17 | 10k | jlcpcb-basic-resistor-0402:10k | tom-passives:R_0402_1005Metric | https://datasheet.lcsc.com/lcsc/2110260030_UNI-ROYAL-Uniroyal-Elec-0402WGF1002TCE_C25744.pdf |  |  | C25744 |  |  | UNI-ROYAL(Uniroyal Elec) | 0402WGF1002TCE
 |  | R18 | 10k | jlcpcb-basic-resistor-0402:10k | tom-passives:R_0402_1005Metric | https://datasheet.lcsc.com/lcsc/2110260030_UNI-ROYAL-Uniroyal-Elec-0402WGF1002TCE_C25744.pdf |  |  | C25744 |  |  | UNI-ROYAL(Uniroyal Elec) | 0402WGF1002TCE
 |  | R19 | 0 | jlcpcb-basic-resistor-0402:0 | tom-passives:R_0402_1005Metric | https://datasheet.lcsc.com/lcsc/2110251730_UNI-ROYAL-Uniroyal-Elec-0402WGF0000TCE_C17168.pdf |  |  | C17168 |  |  | UNI-ROYAL(Uniroyal Elec) | 0402WGF0000TCE
 |  | R20 | 0 | jlcpcb-basic-resistor-0402:0 | tom-passives:R_0402_1005Metric | https://datasheet.lcsc.com/lcsc/2110251730_UNI-ROYAL-Uniroyal-Elec-0402WGF0000TCE_C17168.pdf |  |  | C17168 |  |  | UNI-ROYAL(Uniroyal Elec) | 0402WGF0000TCE
 |  | R21 | 0 | jlcpcb-basic-resistor-0402:0 | tom-passives:R_0402_1005Metric | https://datasheet.lcsc.com/lcsc/2110251730_UNI-ROYAL-Uniroyal-Elec-0402WGF0000TCE_C17168.pdf |  |  | C17168 |  |  | UNI-ROYAL(Uniroyal Elec) | 0402WGF0000TCE
 |  | R22 | 330 | jlcpcb-basic-resistor-0402:330 | tom-passives:R_0402_1005Metric | https://datasheet.lcsc.com/lcsc/2110252230_UNI-ROYAL-Uniroyal-Elec-0402WGF3300TCE_C25104.pdf |  |  | C25104 |  |  | UNI-ROYAL(Uniroyal Elec) | 0402WGF3300TCE
 |  | R23 | 5.1k | jlcpcb-basic-resistor-0402:5.1k | R_0402_1005Metric | https://datasheet.lcsc.com/lcsc/2110260030_UNI-ROYAL-Uniroyal-Elec-0402WGF5101TCE_C25905.pdf |  |  | C25905 |  |  | UNI-ROYAL(Uniroyal Elec) | 0402WGF5101TCE
 |  | R24 | 5.1k | jlcpcb-basic-resistor-0402:5.1k | R_0402_1005Metric | https://datasheet.lcsc.com/lcsc/2110260030_UNI-ROYAL-Uniroyal-Elec-0402WGF5101TCE_C25905.pdf |  |  | C25905 |  |  | UNI-ROYAL(Uniroyal Elec) | 0402WGF5101TCE
 |  | U1 | 74HC595 | tom-semiconductors:74HC595 | tom-semiconductors:SOIC-16_4.55x10.3mm_P1.27mm | http://www.ti.com/lit/ds/symlink/sn74hc595.pdf |  |  | C5947
 |  | U2 | FT4232H | tom-semiconductors:FT4232H | tom-semiconductors:TQFP-64_10x10mm_P0.5mm | https://www.ftdichip.com/Support/Documents/DataSheets/ICs/DS_FT4232H.pdf |  |  | DNP
 |  | U3 | AT93C46DN-SH-T | Memory_EEPROM:93CxxA | tom-semiconductors:SO-8_3.9x4.9mm_P1.27mm | http://ww1.microchip.com/downloads/en/DeviceDoc/20001749K.pdf |  |  | C6499
 |  | VR1 | LM1117MPX-3.3 | tom-semiconductors:LM1117MPX-3.3 | tom-semiconductors:VREG_LM1117MPX-3.3 |  |  | 296-41282-1-ND | C6186 | Texas Instruments | 1.80 mm |  |  |  | O | IPC-7351B
 |  | X1 | 12MHz | tom-passives:CRYSTAL_4PIN | tom-passives:Crystal_SMD_3225-4Pin_3.2x2.5mm |  |  |  | C9002
Collated Components:
Item | Qty | Reference(s) | Value | LibPart | Footprint | Datasheet | Colour | DIGIKEY | LCSC | MANUFACTURER | MAXIMUM_PACKAGE_HEIGHT | MFG | MFGPN | MPN | PARTREV | STANDARD
1 | 2 | C1, C2 | 10uF_10V_X5R | jlcpcb-basic-capacitor-0603:10uF_10V_X5R | tom-passives:C_0603_1608Metric | https://datasheet.lcsc.com/lcsc/1810191219_Samsung-Electro-Mechanics-CL10A106KP8NNNC_C19702.pdf |  |  | C19702 |  |  | Samsung Electro-Mechanics | CL10A106KP8NNNC
2 | 14 | C3, C7, C8, C9, C10, C11, C13, C14, C16, C18, C19, C20, C21, C22 | 100nF_50V_X7R | jlcpcb-basic-capacitor-0402:100nF_50V_X7R | tom-passives:C_0402_1005Metric | https://datasheet.lcsc.com/lcsc/1810191222_Samsung-Electro-Mechanics-CL05B104KB54PNC_C307331.pdf |  |  | C307331 |  |  | Samsung Electro-Mechanics | CL05B104KB54PNC
3 | 2 | C4, C6 | 20pF_50V_C0G | jlcpcb-basic-capacitor-0402:20pF_50V_C0G | tom-passives:C_0402_1005Metric | https://datasheet.lcsc.com/lcsc/1811141710_FH-Guangdong-Fenghua-Advanced-Tech-0402CG200J500NT_C1554.pdf |  |  | C1554 |  |  | FH(Guangdong Fenghua Advanced Tech) | 0402CG200J500NT
4 | 3 | C5, C15, C17 | 4.7uF_10V_X5R | jlcpcb-basic-capacitor-0402:4.7uF_10V_X5R | tom-passives:C_0402_1005Metric | https://datasheet.lcsc.com/lcsc/1810191211_Samsung-Electro-Mechanics-CL05A475MP5NRNC_C23733.pdf |  |  | C23733 |  |  | Samsung Electro-Mechanics | CL05A475MP5NRNC
5 | 1 | C12 | 10nF_50V_X7R | jlcpcb-basic-capacitor-0402:10nF_50V_X7R | tom-passives:C_0402_1005Metric | https://datasheet.lcsc.com/lcsc/1810191223_Samsung-Electro-Mechanics-CL05B103KB5NNNC_C15195.pdf |  |  | C15195 |  |  | Samsung Electro-Mechanics | CL05B103KB5NNNC
6 | 1 | D1 | LED | tom-opto:LED | tom-opto:LED_0603_1608Metric | ~ |  |  | C2290
7 | 1 | D2 | TXA | tom-opto:LED | tom-opto:LED_0603_1608Metric | ~ | WHT |  | C2290
8 | 1 | D3 | RXA | tom-opto:LED | tom-opto:LED_0603_1608Metric | ~ | RED |  | C2290
9 | 1 | D4 | TXB | tom-opto:LED | tom-opto:LED_0603_1608Metric | ~ | WHT |  | C2290
10 | 1 | D5 | RXB | tom-opto:LED | tom-opto:LED_0603_1608Metric | ~ | RED |  | C2290
11 | 1 | D6 | TXC | tom-opto:LED | tom-opto:LED_0603_1608Metric | ~ | WHT |  | C2290
12 | 1 | D7 | RXC | tom-opto:LED | tom-opto:LED_0603_1608Metric | ~ | RED |  | C2290
13 | 1 | D8 | TXD | tom-opto:LED | tom-opto:LED_0603_1608Metric | ~ | WHT |  | C2290
14 | 1 | D9 | RXD | tom-opto:LED | tom-opto:LED_0603_1608Metric | ~ | RED |  | C2290
15 | 3 | FB1, FB2, FB3 | 500mA/600R | tom-passives:FILTER | tom-passives:C_0805_2012Metric |  |  |  | C1017
16 | 4 | J1, J2, J3, J4 | Conn_01x03 | tom-connectors:Conn_01x03 | tom-connectors:PinHeader_1x03_P2.54mm_Horizontal | ~ |  |  | C492411
17 | 4 | J5, J6, J7, J8 | JLCPCB_3.5MM_SOCKET_C18166 | tom-connectors:JLCPCB_3.5MM_SOCKET_C18166 | tom-connectors:JLCPCB_3.5MM_SOCKET_C18166 | https://atta.szlcsc.com/upload/public/pdf/source/20211011/0B1C3F8D3B14DEB4B55195420484A083.pdf |  |  | C18166 |  |  |  |  | PJ-3200
18 | 1 | J9 | USB_B_Micro | tom-connectors:USB_B_Micro | tom-connectors:USB_B_Micro_LCSC_C10418 | ~ |  |  | C10418
19 | 1 | J10 | USB_C_Receptacle_USB2.0 | tom-connectors:USB_C_Receptacle_USB2.0 | tom-connectors:USB_C_Receptacle_LCSC_C165948 | https://www.usb.org/sites/default/files/documents/usb_type-c.zip |  |  | C165948
20 | 2 | R1, R11 | 10 | jlcpcb-basic-resistor-0402:10 | tom-passives:R_0402_1005Metric | https://datasheet.lcsc.com/lcsc/2110252230_UNI-ROYAL-Uniroyal-Elec-0402WGF100JTCE_C25077.pdf |  |  | C25077 |  |  | UNI-ROYAL(Uniroyal Elec) | 0402WGF100JTCE
21 | 9 | R2, R3, R4, R5, R6, R7, R8, R9, R22 | 330 | jlcpcb-basic-resistor-0402:330 | tom-passives:R_0402_1005Metric | https://datasheet.lcsc.com/lcsc/2110252230_UNI-ROYAL-Uniroyal-Elec-0402WGF3300TCE_C25104.pdf |  |  | C25104 |  |  | UNI-ROYAL(Uniroyal Elec) | 0402WGF3300TCE
22 | 5 | R10, R13, R15, R17, R18 | 10k | jlcpcb-basic-resistor-0402:10k | tom-passives:R_0402_1005Metric | https://datasheet.lcsc.com/lcsc/2110260030_UNI-ROYAL-Uniroyal-Elec-0402WGF1002TCE_C25744.pdf |  |  | C25744 |  |  | UNI-ROYAL(Uniroyal Elec) | 0402WGF1002TCE
23 | 1 | R12 | 15k | jlcpcb-basic-resistor-0402:15k | tom-passives:R_0402_1005Metric | https://datasheet.lcsc.com/lcsc/2110260030_UNI-ROYAL-Uniroyal-Elec-0402WGF1502TCE_C25756.pdf |  |  | C25756 |  |  | UNI-ROYAL(Uniroyal Elec) | 0402WGF1502TCE
24 | 1 | R14 | 12k | jlcpcb-basic-resistor-0402:12k | tom-passives:R_0402_1005Metric | https://datasheet.lcsc.com/lcsc/2110260030_UNI-ROYAL-Uniroyal-Elec-0402WGF1202TCE_C25752.pdf |  |  | C25752 |  |  | UNI-ROYAL(Uniroyal Elec) | 0402WGF1202TCE
25 | 1 | R16 | 2.2k | jlcpcb-basic-resistor-0402:2.2k | tom-passives:R_0402_1005Metric | https://datasheet.lcsc.com/lcsc/2110260030_UNI-ROYAL-Uniroyal-Elec-0402WGF2201TCE_C25879.pdf |  |  | C25879 |  |  | UNI-ROYAL(Uniroyal Elec) | 0402WGF2201TCE
26 | 3 | R19, R20, R21 | 0 | jlcpcb-basic-resistor-0402:0 | tom-passives:R_0402_1005Metric | https://datasheet.lcsc.com/lcsc/2110251730_UNI-ROYAL-Uniroyal-Elec-0402WGF0000TCE_C17168.pdf |  |  | C17168 |  |  | UNI-ROYAL(Uniroyal Elec) | 0402WGF0000TCE
27 | 2 | R23, R24 | 5.1k | jlcpcb-basic-resistor-0402:5.1k | R_0402_1005Metric | https://datasheet.lcsc.com/lcsc/2110260030_UNI-ROYAL-Uniroyal-Elec-0402WGF5101TCE_C25905.pdf |  |  | C25905 |  |  | UNI-ROYAL(Uniroyal Elec) | 0402WGF5101TCE
28 | 1 | U1 | 74HC595 | tom-semiconductors:74HC595 | tom-semiconductors:SOIC-16_4.55x10.3mm_P1.27mm | http://www.ti.com/lit/ds/symlink/sn74hc595.pdf |  |  | C5947
29 | 1 | U2 | FT4232H | tom-semiconductors:FT4232H | tom-semiconductors:TQFP-64_10x10mm_P0.5mm | https://www.ftdichip.com/Support/Documents/DataSheets/ICs/DS_FT4232H.pdf |  |  | DNP
30 | 1 | U3 | AT93C46DN-SH-T | Memory_EEPROM:93CxxA | tom-semiconductors:SO-8_3.9x4.9mm_P1.27mm | http://ww1.microchip.com/downloads/en/DeviceDoc/20001749K.pdf |  |  | C6499
31 | 1 | VR1 | LM1117MPX-3.3 | tom-semiconductors:LM1117MPX-3.3 | tom-semiconductors:VREG_LM1117MPX-3.3 |  |  | 296-41282-1-ND | C6186 | Texas Instruments | 1.80 mm |  |  |  | O | IPC-7351B
32 | 1 | X1 | 12MHz | tom-passives:CRYSTAL_4PIN | tom-passives:Crystal_SMD_3225-4Pin_3.2x2.5mm |  |  |  | C9002
