TomKeddie/prj-pcb-experiments/galep4-plcc-28/bom/galep4-plcc-28-jlc-.csv

Comment | Designator
27C040 | U2
DIP_32 | U3
GAL22V10PLCC | U1
