TomKeddie/prj-pcb-experiments/2021-xmas-tree/image/pine-tree-with-snow-transparent-clip-art-gallery-yopriceville-snow-tree-clipart-5756_8000-edge.dxf

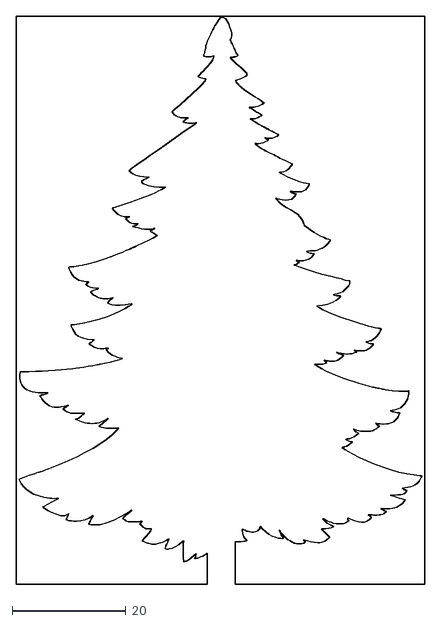
[picture p81: CAD file, 2020-12-11]
2021-xmas-tree/image/pine-tree-with-snow-transparent-clip-art-gallery-yopriceville-snow-tree-clipart-5756_8000-edge.dxf
72.0 x 100.0
