TomKeddie/prj-pcb-experiments/2023-xmas-snowflake/2023-xmas-snowflake.kicad_pcb.dxf

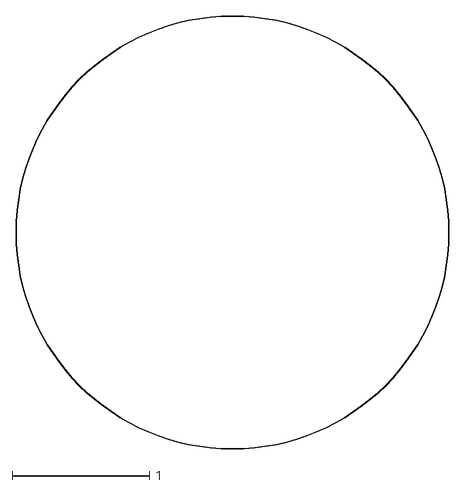
[picture p82: CAD file, 2023-12-21]
2023-xmas-snowflake/2023-xmas-snowflake.kicad_pcb.dxf
3.16 x 3.16
