TomKeddie/prj-pcb-experiments/2024-clock-retrofit/kicad/2024-clock-retrofit.kicad_pcb.dxf

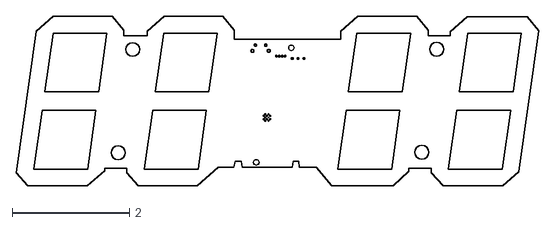
[picture p83: CAD file, 2026-09-26]
2024-clock-retrofit/kicad/2024-clock-retrofit.kicad_pcb.dxf
8.91 x 2.89
