TomKeddie/prj-pcb-experiments/2024-led-ctrl-24v/kicad/led-ctrl-24v.kicad_pcb.dxf

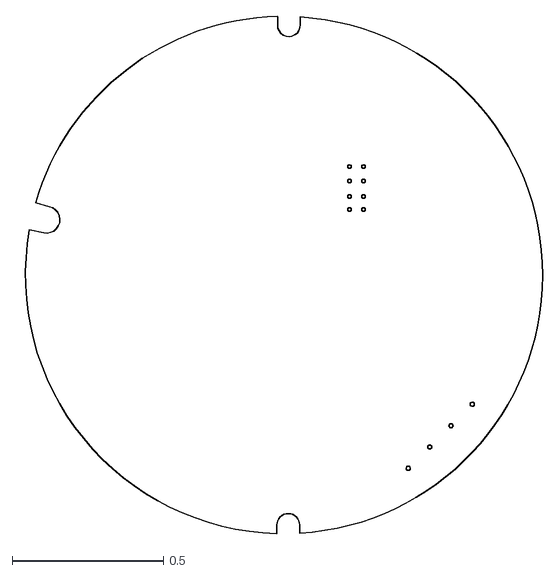
[picture p84: CAD file, 2025-05-09]
2024-led-ctrl-24v/kicad/led-ctrl-24v.kicad_pcb.dxf
1.74 x 1.71
