TomKeddie/prj-pcb-experiments/2024-rfid-sao/2024-rfid-sao.kicad_pcb.dxf

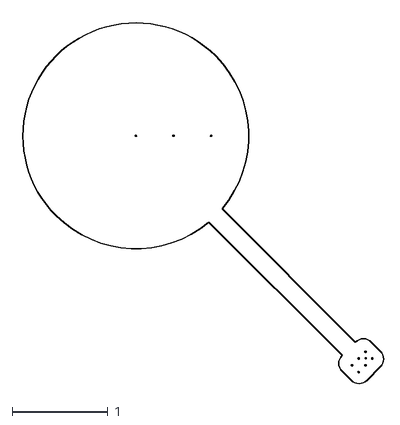
[picture p85: CAD file, 2024-10-03]
2024-rfid-sao/2024-rfid-sao.kicad_pcb.dxf
3.84 x 3.85
