TomKeddie/prj-pcb-experiments/2024-supercon-sign-sao/kicad/2024-supercon-sign-sao.kicad_pcb.dxf

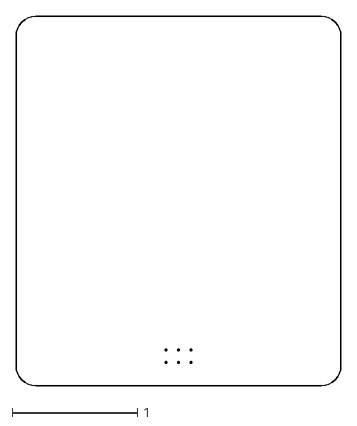
[picture p86: CAD file, 2024-11-12]
2024-supercon-sign-sao/kicad/2024-supercon-sign-sao.kicad_pcb.dxf
2.60 x 2.95
