TomKeddie/prj-pcb-experiments/2024-syzygy-dsi/hardware/3d/FH34SRJ-34S-0.5SH.stp

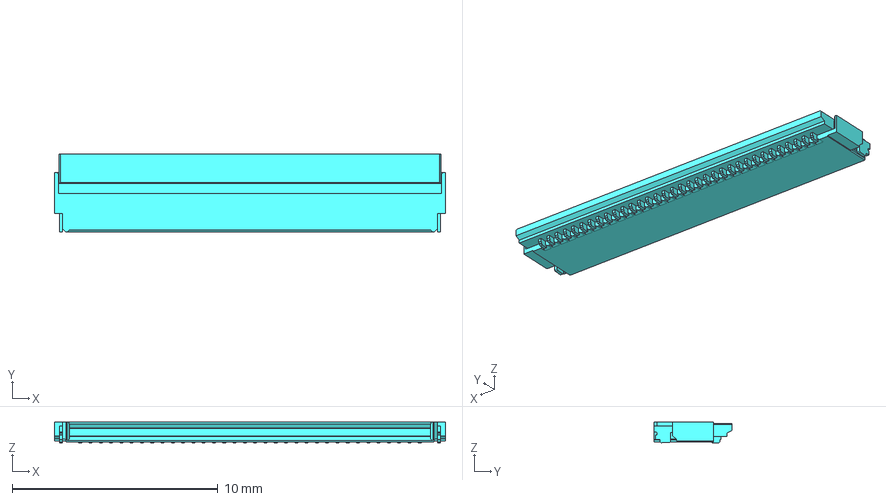
[picture p87: CAD file, 2024-09-25]
2024-syzygy-dsi/hardware/3d/FH34SRJ-34S-0.5SH.stp
19.0 x 3.80 x 1.00 mm
