TomKeddie/prj-pcb-experiments/2024-syzygy-dsi/hardware/syzygy-dsi.kicad_pcb.dxf

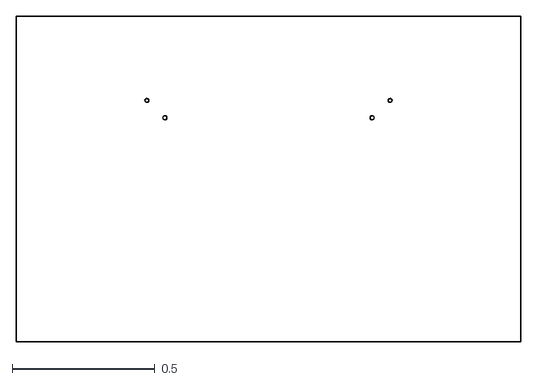
[picture p88: CAD file, 2024-09-25]
2024-syzygy-dsi/hardware/syzygy-dsi.kicad_pcb.dxf
1.77 x 1.14
