TomKeddie/prj-pcb-experiments/2025-flex-spiral/one/2025-flex-spiral.kicad_pcb.dxf/2025-flex-spiral-Edge_Cuts.dxf

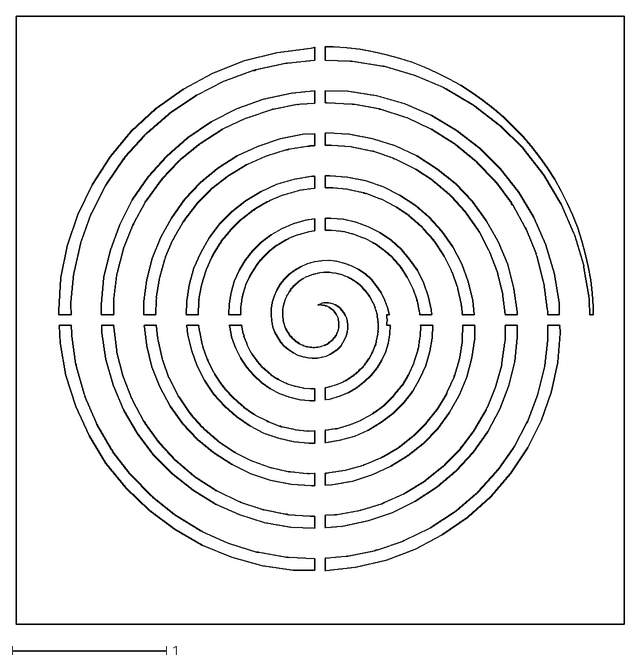
[picture p89: CAD file, 2025-06-22]
2025-flex-spiral/one/2025-flex-spiral.kicad_pcb.dxf/2025-flex-spiral-Edge_Cuts.dxf
3.94 x 3.94
