TomKeddie/prj-pcb-experiments/2025-flex-spiral/two/2025-flex-spiral-two.kicad_pcb.dxf

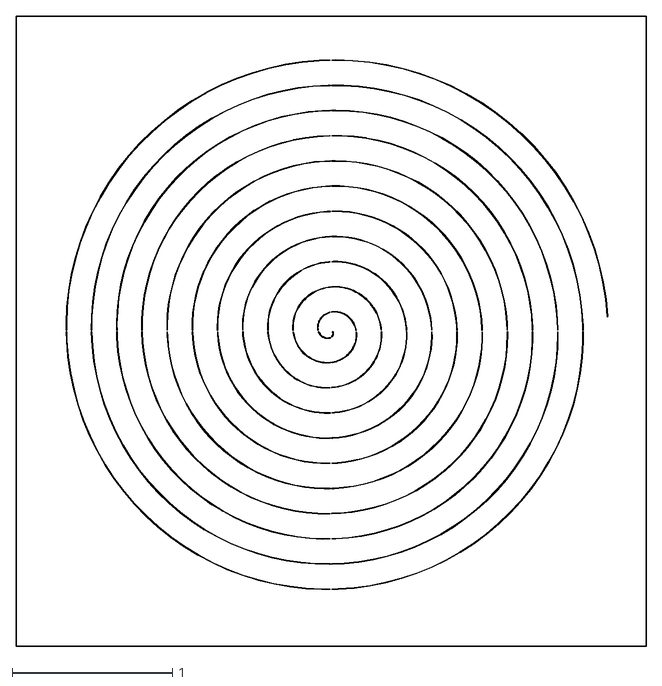
[picture p90: CAD file, 2025-06-27]
2025-flex-spiral/two/2025-flex-spiral-two.kicad_pcb.dxf
3.94 x 3.94
