TomKeddie/prj-pcb-experiments/2025-mini-keychain/2025-mini-keychain.kicad_pcb.dxf/2025-mini-keychain-Edge_Cuts.dxf

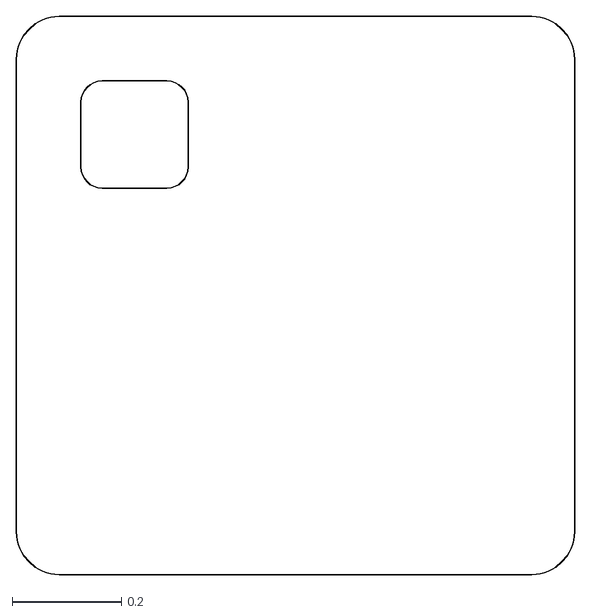
[picture p91: CAD file, 2025-07-25]
2025-mini-keychain/2025-mini-keychain.kicad_pcb.dxf/2025-mini-keychain-Edge_Cuts.dxf
1.02 x 1.02
