TomKeddie/prj-pcb-experiments/2025-mipi-rpi-conv-dsi/2025-mipi-rpi-conv-dsi.kicad_pcb.dxf

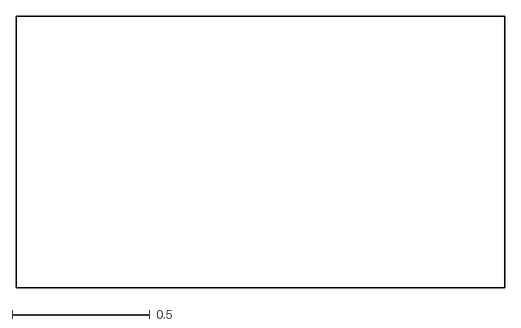
[picture p92: CAD file, 2025-08-31]
2025-mipi-rpi-conv-dsi/2025-mipi-rpi-conv-dsi.kicad_pcb.dxf
1.77 x 0.984
