TomKeddie/prj-pcb-experiments/2025-pmod-sma/2025-pmod-sma.kicad_pcb.dxf

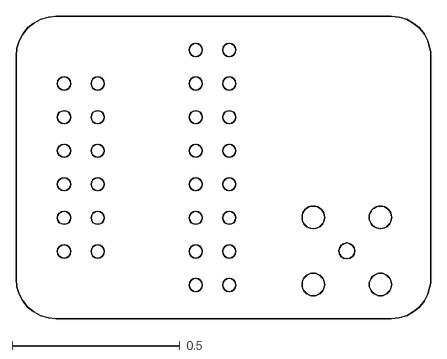
[picture p93: CAD file, 2025-08-31]
2025-pmod-sma/2025-pmod-sma.kicad_pcb.dxf
1.23 x 0.9
