TomKeddie/prj-pcb-experiments/2025-usb-pd-plank/kicad/usb-pd-plank.kicad_pcb.dxf/usb-pd-plank-Edge_Cuts.dxf

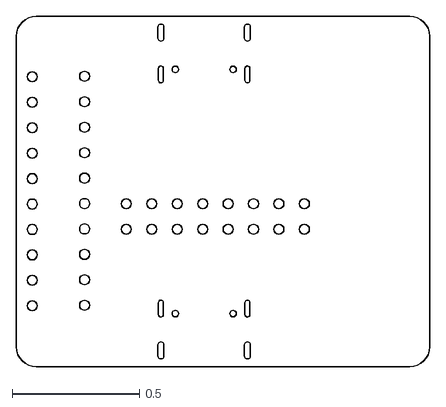
[picture p94: CAD file, 2025-04-19]
2025-usb-pd-plank/kicad/usb-pd-plank.kicad_pcb.dxf/usb-pd-plank-Edge_Cuts.dxf
1.62 x 1.38
