TomKeddie/prj-pcb-experiments/atmelice-swd-breakout-switch/3d/atmelice-swd-breakout-switch.kicad_pcb.step

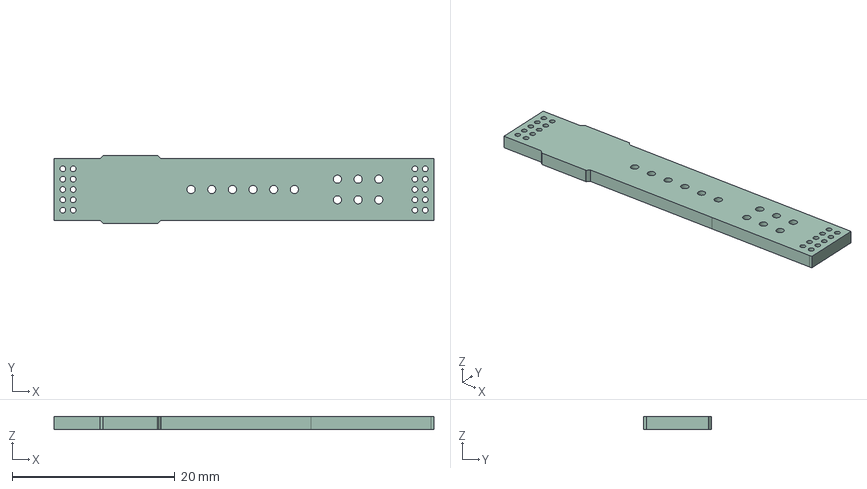
[picture p95: CAD file, 2023-05-04]
atmelice-swd-breakout-switch/3d/atmelice-swd-breakout-switch.kicad_pcb.step
46.7 x 8.38 x 1.58 mm
