TomKeddie/prj-pcb-experiments/baggage-label/baggage-label-felix/baggage-label-felix.kicad_pcb.dxf

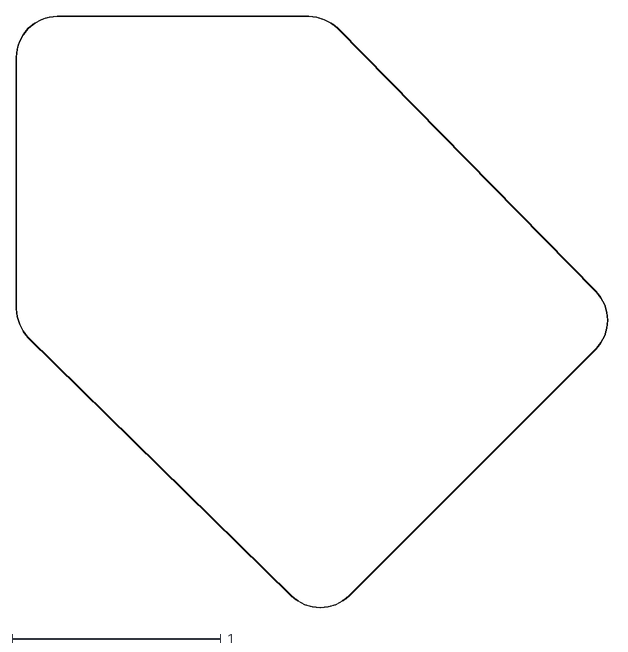
[picture p96: CAD file, 2025-04-05]
baggage-label/baggage-label-felix/baggage-label-felix.kicad_pcb.dxf
2.85 x 2.85
