TomKeddie/prj-pcb-experiments/blue-pill-bmp/hardware/3d/blue-pill-bmp-.step

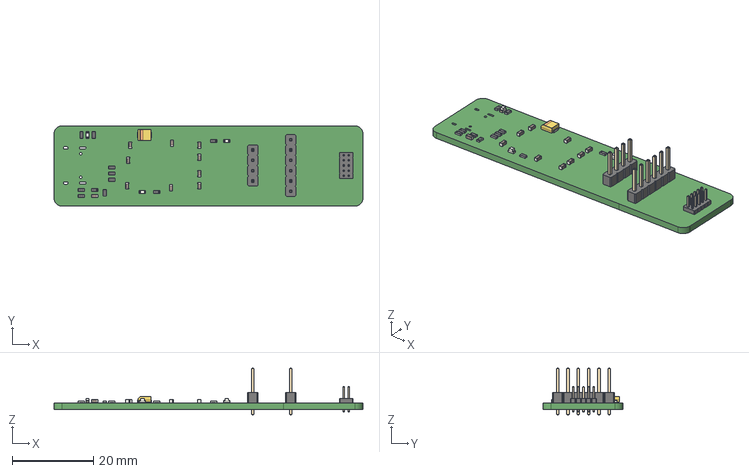
[picture p97: CAD file, 2026-09-26]
blue-pill-bmp/hardware/3d/blue-pill-bmp-.step
76.0 x 19.8 x 11.5 mm
