TomKeddie/prj-pcb-experiments/deutsche-bahn/1280px-Deutsche_Bahn_AG-Logo-scaled-edge.dxf

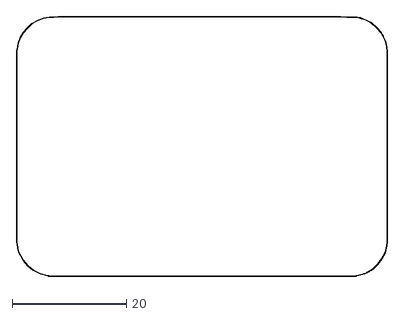
[picture p98: CAD file, 2021-02-26]
deutsche-bahn/1280px-Deutsche_Bahn_AG-Logo-scaled-edge.dxf
65.1 x 45.6
