TomKeddie/prj-pcb-experiments/east-van/arrow/image-arrow-up-filled.dxf

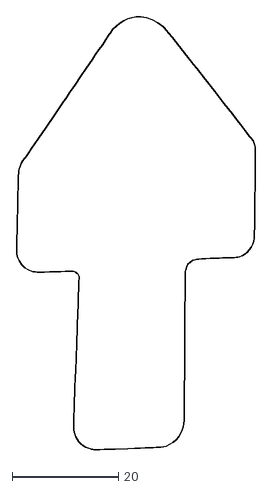
[picture p99: CAD file, 2021-02-26]
east-van/arrow/image-arrow-up-filled.dxf
45.0 x 81.5
