TomKeddie/prj-pcb-experiments/east-van/image-edge-extended-filled.dxf

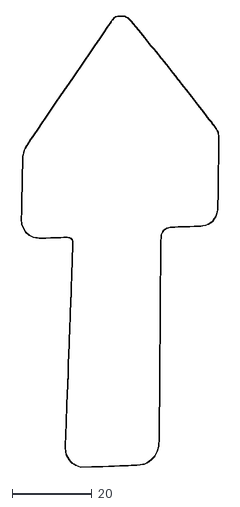
[picture p100: CAD file, 2021-02-26]
east-van/image-edge-extended-filled.dxf
49.5 x 113.1
