TomKeddie/prj-pcb-experiments/esp8266-plugpack/3d/esp8266-plugpack.kicad_pcb.step

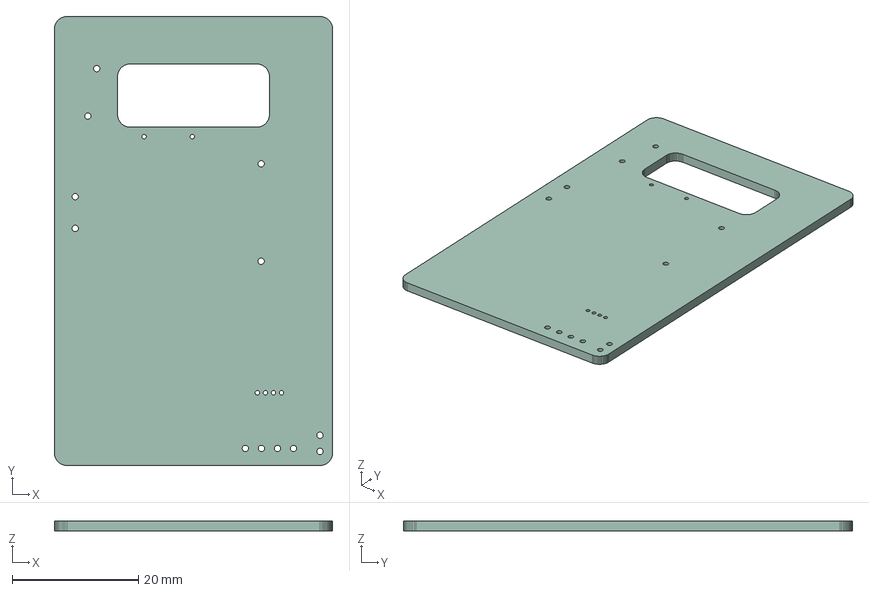
[picture p101: CAD file, 2023-04-24]
esp8266-plugpack/3d/esp8266-plugpack.kicad_pcb.step
44.0 x 71.0 x 1.58 mm
