TomKeddie/prj-pcb-experiments/esp8266-wiz550io/3d/esp8266-wiz550io-Feb2021.step

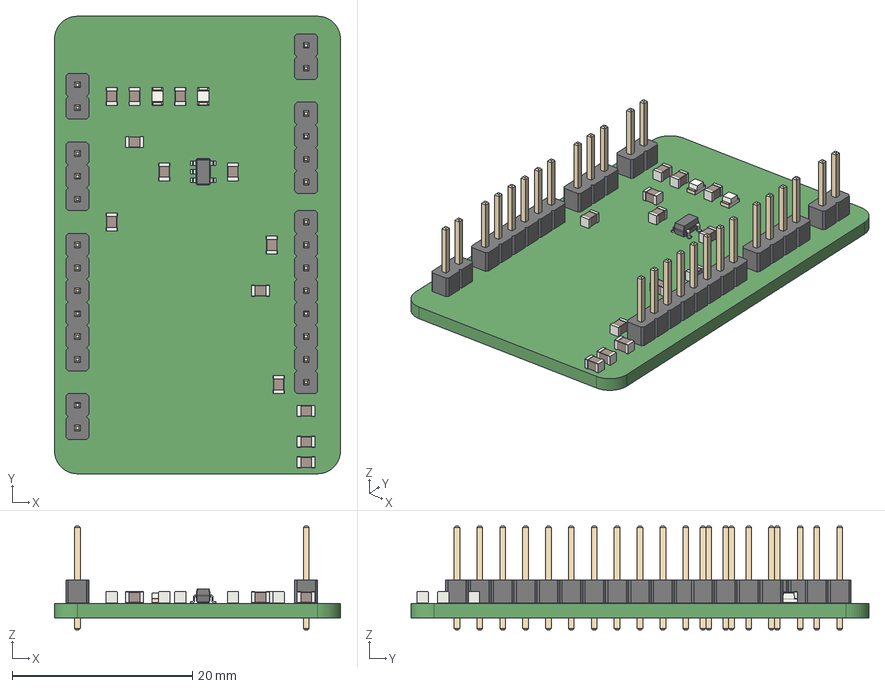
[picture p102: CAD file, 2021-04-26]
esp8266-wiz550io/3d/esp8266-wiz550io-Feb2021.step
31.8 x 50.8 x 11.5 mm
