TomKeddie/prj-pcb-experiments/galep4-plcc-28/3d/galep4-plcc-28-Mar2021.step

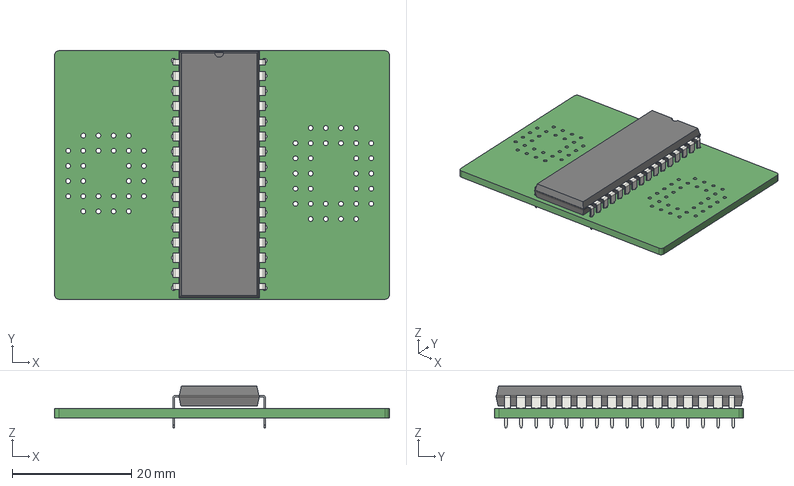
[picture p103: CAD file, 2021-03-27]
galep4-plcc-28/3d/galep4-plcc-28-Mar2021.step
56.1 x 41.7 x 6.98 mm
