TomKeddie/prj-pcb-experiments/kindcalmsafe/dxf/kindcalmsafe-Eco1_User.dxf

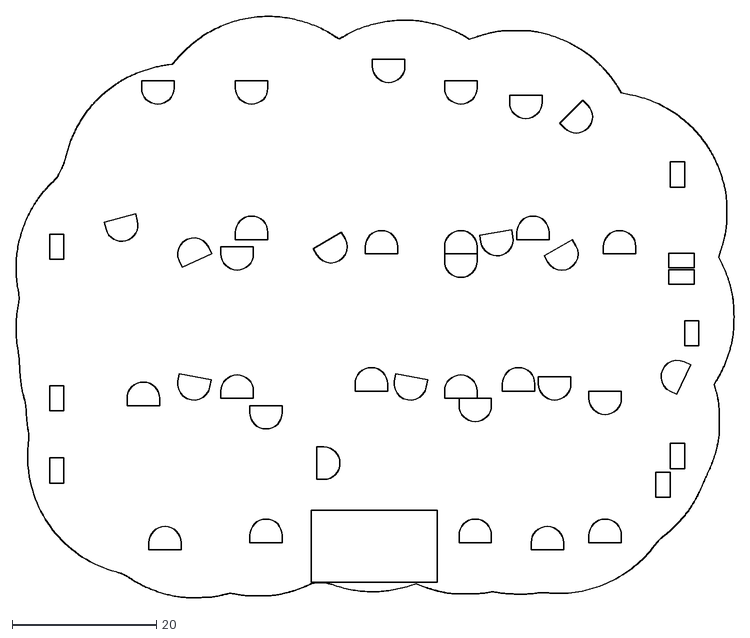
[picture p104: CAD file, 2021-02-26]
kindcalmsafe/dxf/kindcalmsafe-Eco1_User.dxf
99.5 x 80.6
