TomKeddie/prj-pcb-experiments/kindcalmsafe/kindcalmsafe-filled.dxf

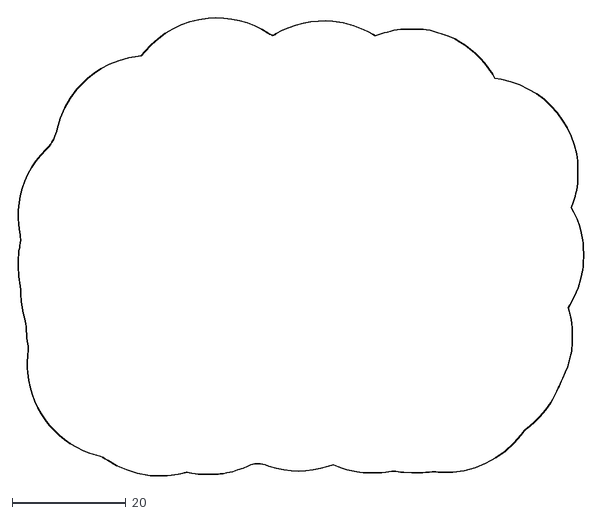
[picture p105: CAD file, 2021-01-13]
kindcalmsafe/kindcalmsafe-filled.dxf
99.9 x 80.9
