TomKeddie/prj-pcb-experiments/mikrobus-pmod-adapt/mikrobus-pmod-adapt.kicad_pcb.dxf

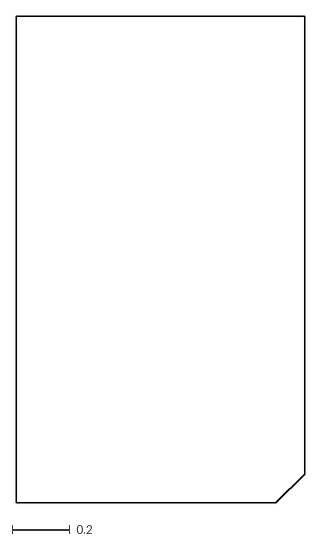
[picture p106: CAD file, 2024-03-02]
mikrobus-pmod-adapt/mikrobus-pmod-adapt.kicad_pcb.dxf
1.00 x 1.69
