TomKeddie/prj-pcb-experiments/mr-fixit/images/mrfixit-corrected-filled3.dxf

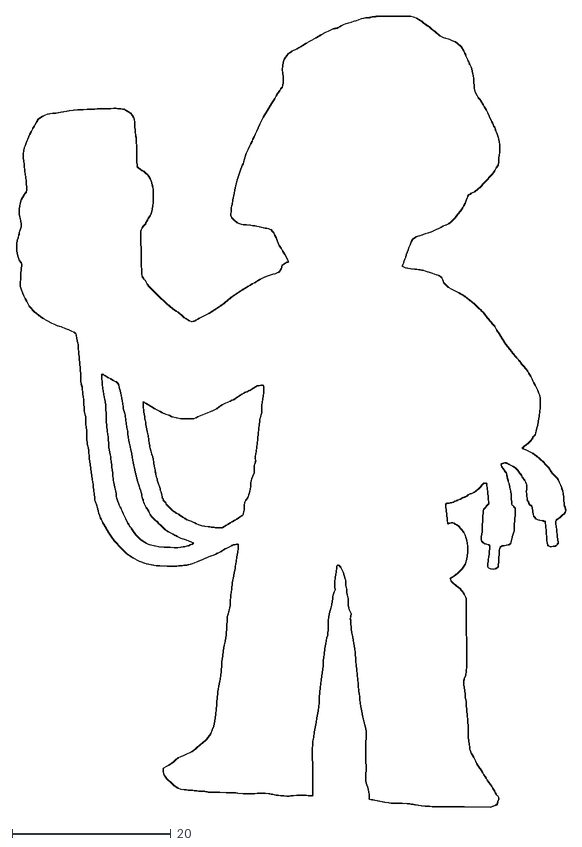
[picture p107: CAD file, 2021-02-26]
mr-fixit/images/mrfixit-corrected-filled3.dxf
69.3 x 99.8
