TomKeddie/prj-pcb-experiments/mr-fixit/mrfixit.kicad_pcb.dxf

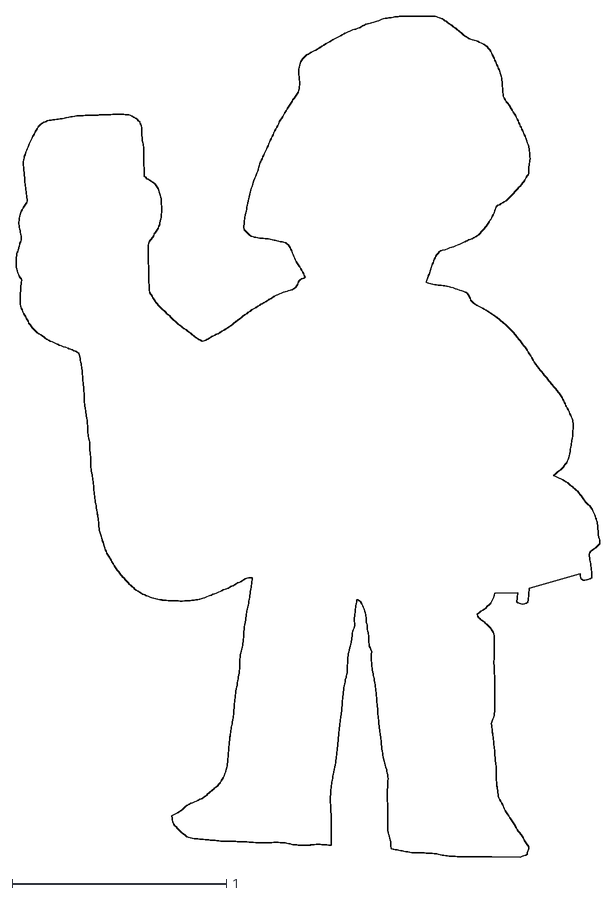
[picture p108: CAD file, 2024-09-16]
mr-fixit/mrfixit.kicad_pcb.dxf
2.73 x 3.93
