TomKeddie/prj-pcb-experiments/peace-sign-sao/dxf/peace-sign-Eco1_User.dxf

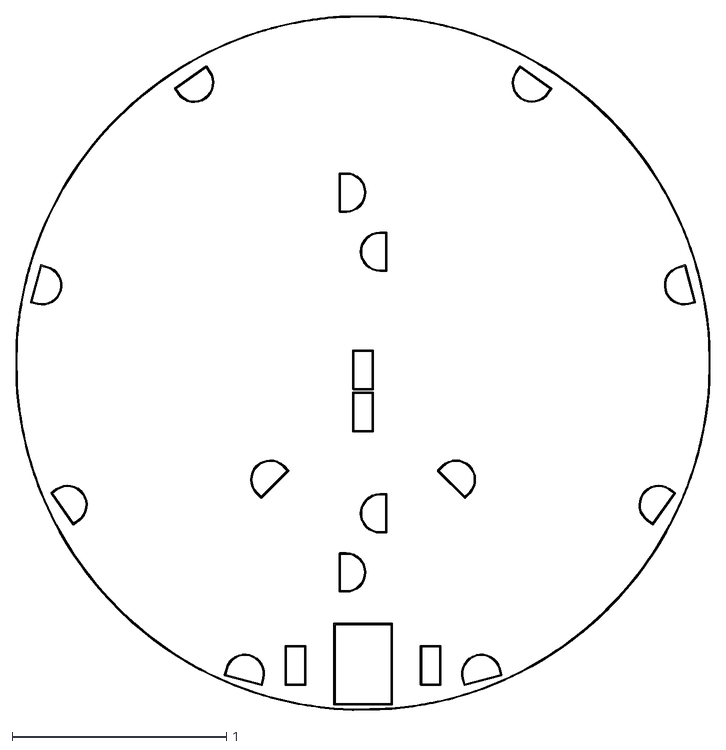
[picture p109: CAD file, 2020-12-16]
peace-sign-sao/dxf/peace-sign-Eco1_User.dxf
3.24 x 3.24
