TomKeddie/prj-pcb-experiments/peace-sign-sao/image/image.dxf

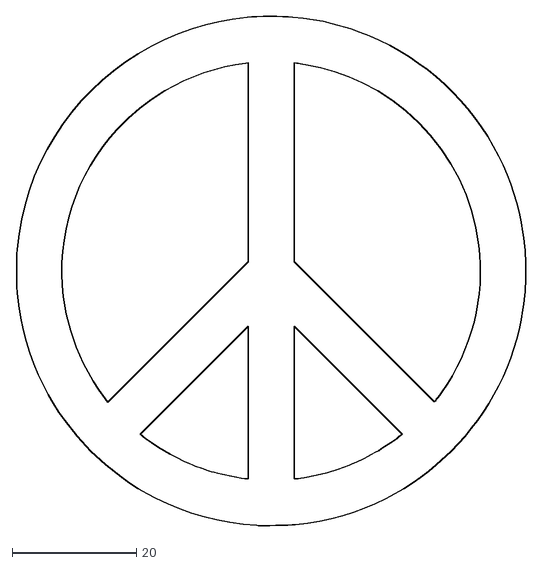
[picture p110: CAD file, 2020-12-13]
peace-sign-sao/image/image.dxf
82.1 x 82.2
