TomKeddie/prj-pcb-experiments/skull-roses/roses/3d/roses.kicad_pcb.step

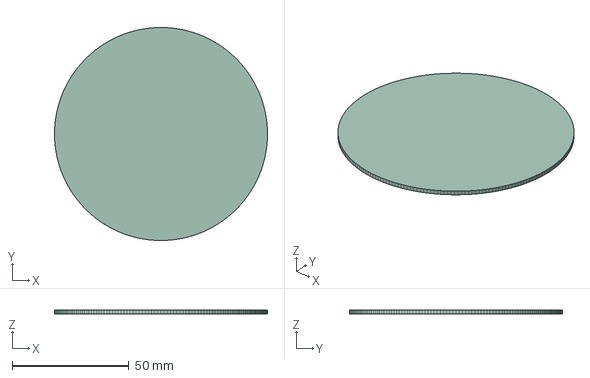
[picture p111: CAD file, 2023-03-31]
skull-roses/roses/3d/roses.kicad_pcb.step
91.1 x 91.1 x 1.60 mm
