TomKeddie/prj-pcb-experiments/snoopy-sao/snoopy-sao/snoopy-filled.dxf

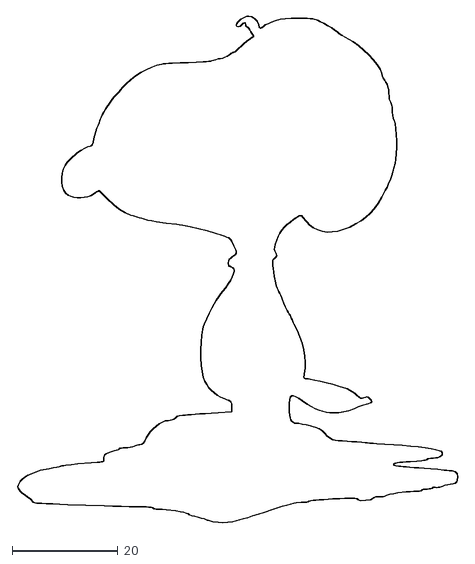
[picture p112: CAD file, 2021-01-15]
snoopy-sao/snoopy-sao/snoopy-filled.dxf
83.6 x 96.0
