TomKeddie/prj-pcb-experiments/strange-parts/strange-parts-sao/strange-parts-sao.kicad_pcb.dxf

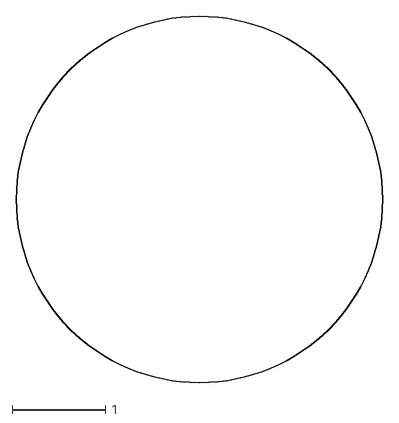
[picture p113: CAD file, 2023-11-18]
strange-parts/strange-parts-sao/strange-parts-sao.kicad_pcb.dxf
3.92 x 3.92
