TomKeddie/prj-pcb-experiments/syzygy-serdes-breakout/3d/14S1_ATM.step

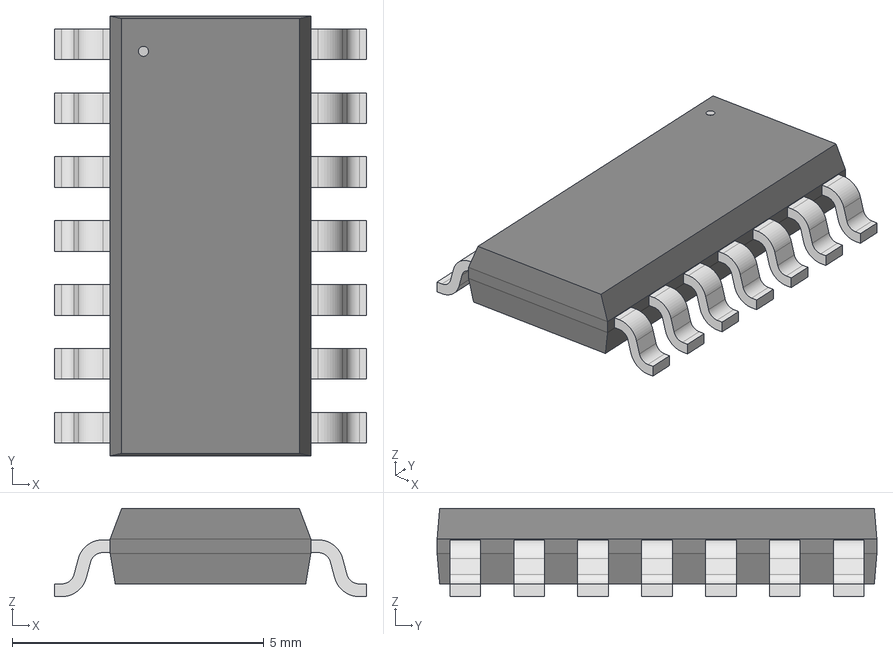
[picture p114: CAD file, 2020-12-12]
syzygy-serdes-breakout/3d/14S1_ATM.step
6.20 x 8.74 x 1.75 mm
