TomKeddie/prj-pcb-experiments/2024-syzygy-dsi/hardware/3d/TCA9517ADGKR.step

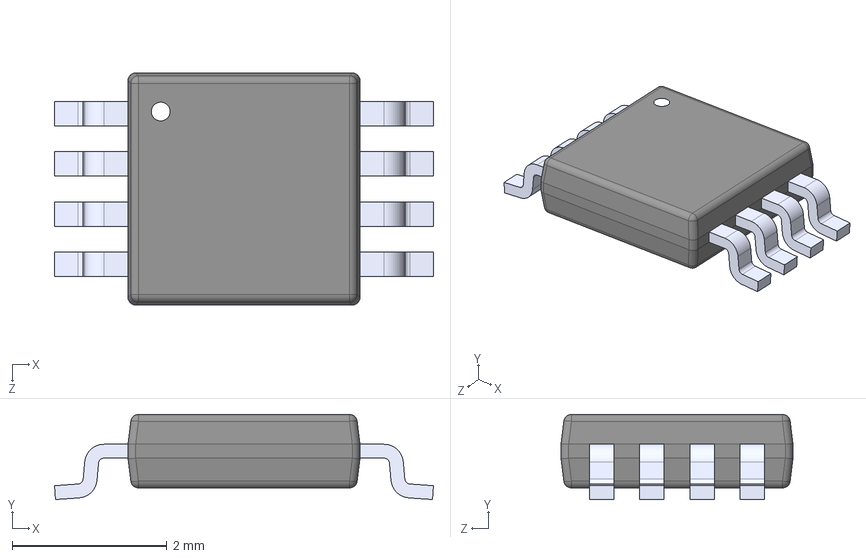
[picture p115: CAD file, 2024-09-25]
2024-syzygy-dsi/hardware/3d/TCA9517ADGKR.step
4.90 x 1.10 x 3.00 mm
