TomKeddie/prj-pcb-experiments/covid-mask/man-in-hygiene-face-mask-icon-vector-9492108-10cm-filled.dxf

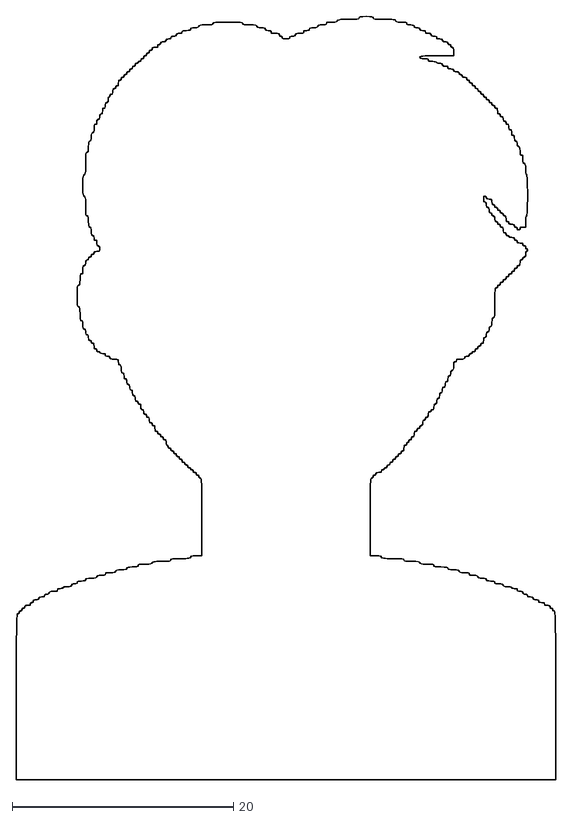
[picture p116: CAD file, 2021-02-26]
covid-mask/man-in-hygiene-face-mask-icon-vector-9492108-10cm-filled.dxf
48.8 x 69.0
