TomKeddie/prj-pcb-experiments/east-van/image-edge-filled.dxf

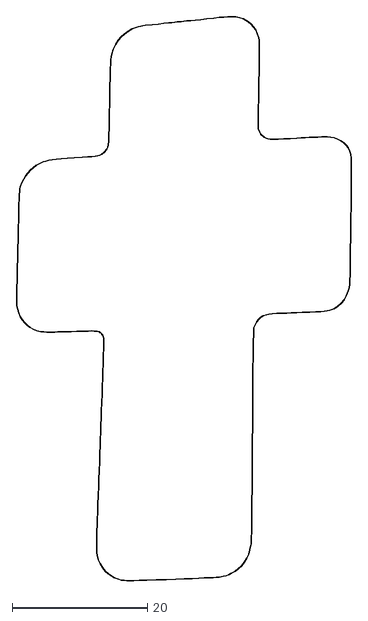
[picture p117: CAD file, 2021-02-26]
east-van/image-edge-filled.dxf
49.5 x 83.4
