TomKeddie/prj-pcb-experiments/mr-fixit/images/mrfixit-corrected-filled2.dxf

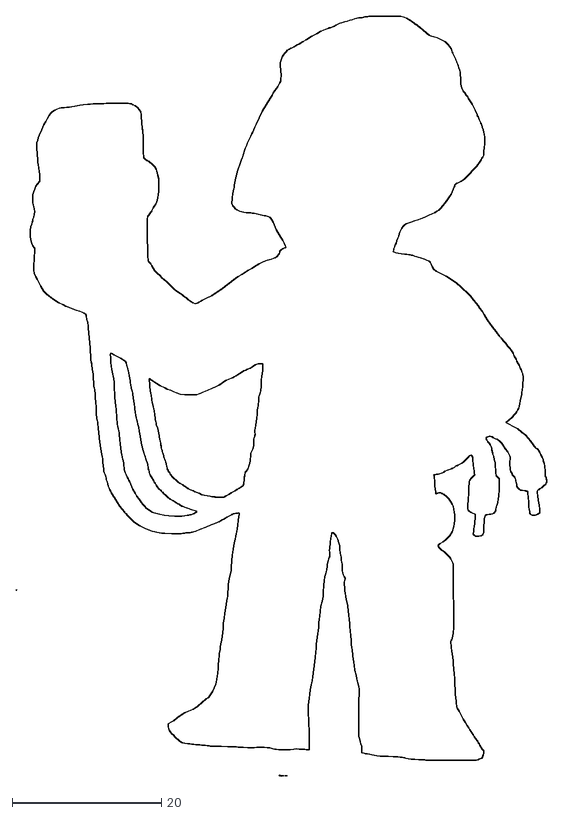
[picture p118: CAD file, 2021-02-26]
mr-fixit/images/mrfixit-corrected-filled2.dxf
71.2 x 101.9
