TomKeddie/prj-pcb-experiments/syzygy-serdes-breakout/3d/QTH-020-01-F-D-DP-A.stp

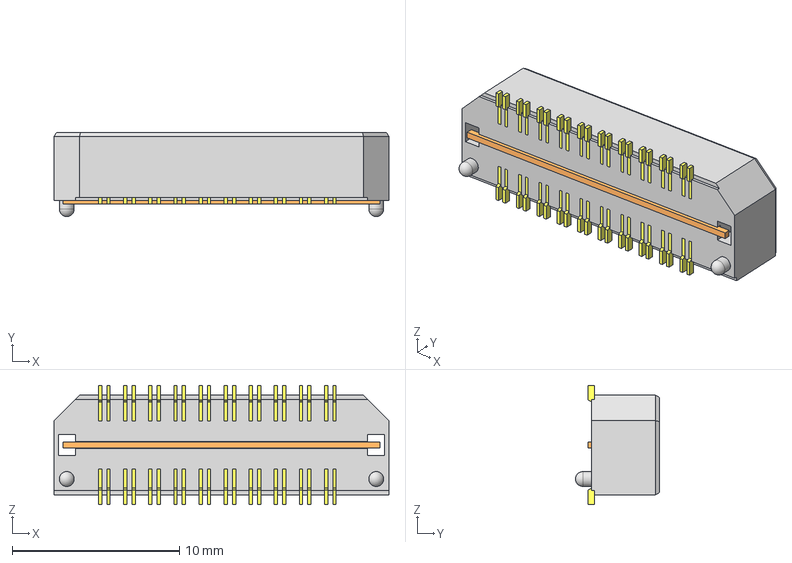
[picture p119: CAD file, 2020-11-27]
syzygy-serdes-breakout/3d/QTH-020-01-F-D-DP-A.stp
20.0 x 5.03 x 7.11 mm
_TQTH-020-01-F-D-DP-A_terminal
_T-1S39-01(-020-01-D-DP)_pin
_T-1G1-01_imp
