TomKeddie/prj-pcb-experiments/mr-fixit/images/mrfixit-corrected-filled.dxf

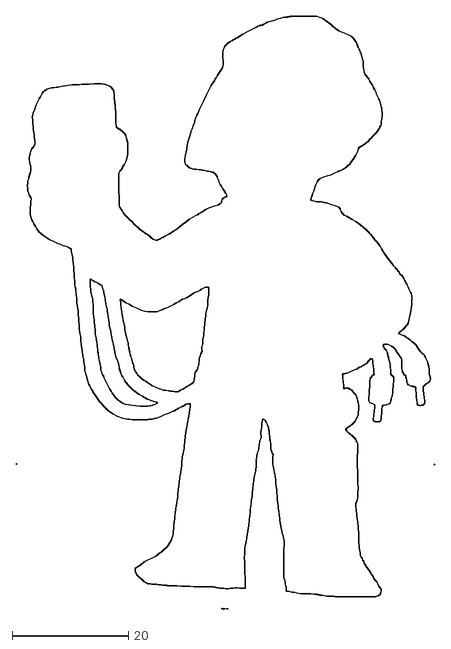
[picture p120: CAD file, 2021-02-26]
mr-fixit/images/mrfixit-corrected-filled.dxf
71.9 x 101.9
