TomKeddie/prj-pcb-experiments/(list of files, cad)

Other CAD files:
blue-pill-bmp/hardware/dxf/blue-pill-bmp-.dxf
covid-mask/86547808-10cm-filled.dxf
esp8266-wiz550io/dxf/esp8266-wiz550io-Feb2021.dxf
ft4232h-breakout/v1.x/3d/ft4232h-breakout-Apr2021.step
ft4232h-breakout/v1.x/3d/ft4232h-breakout-Jun2021.step
ft4232h-breakout/v1.x/3d/ft4232h-breakout-Jun2021a.step
ft4232h-breakout/v1.x/3d/ft4232h-breakout-Jun2021b.step
ft4232h-breakout/v1.x/3d/ft4232h-breakout-May2021.step
ft4232h-breakout/v1.x/dxf/ft4232h-breakout-Apr2021.dxf
ft4232h-breakout/v1.x/dxf/ft4232h-breakout-Jun2021.dxf
ft4232h-breakout/v1.x/dxf/ft4232h-breakout-Jun2021a.dxf
ft4232h-breakout/v1.x/dxf/ft4232h-breakout-Jun2021b.dxf
ft4232h-breakout/v1.x/dxf/ft4232h-breakout-May2021.dxf
ft4232h-breakout/v2.x/3d/ft4232h-breakout-Jun2021b.step
ft4232h-breakout/v2.x/dxf/ft4232h-breakout-Jun2021b.dxf
