TomKeddie/prj-pcb-experiments/2025-mini-keychain/2025-mini-keychain.kicad_pcb.mechanical.pdf

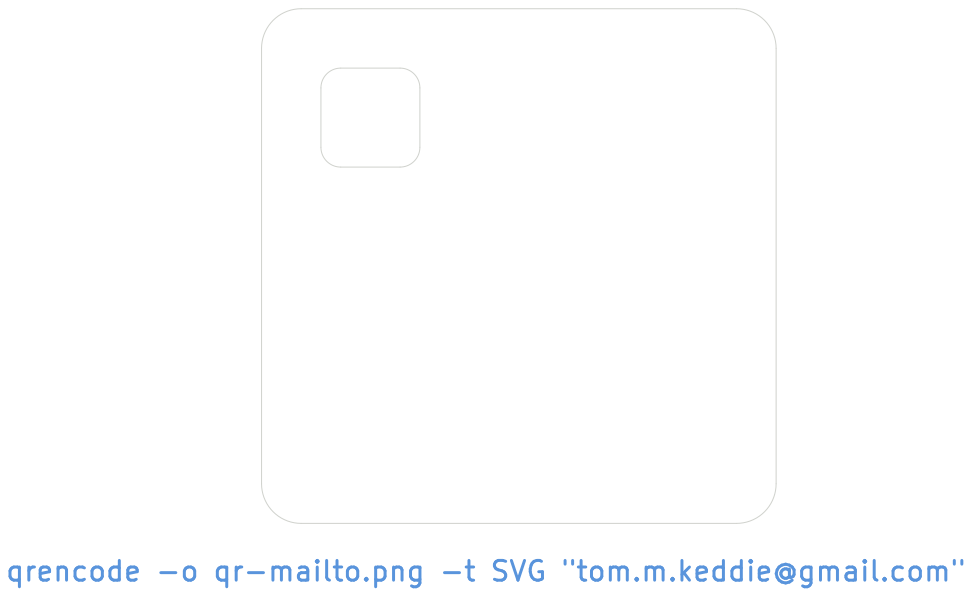
[picture p121: page 1]

Id: 1/1 Title: File: 2025-mini-keychain.kicad_pcb Sheet:
