TomKeddie/prj-pcb-experiments/2024-rfid-sao/2024-rfid-sao.kicad_pcb.mechanical.pdf

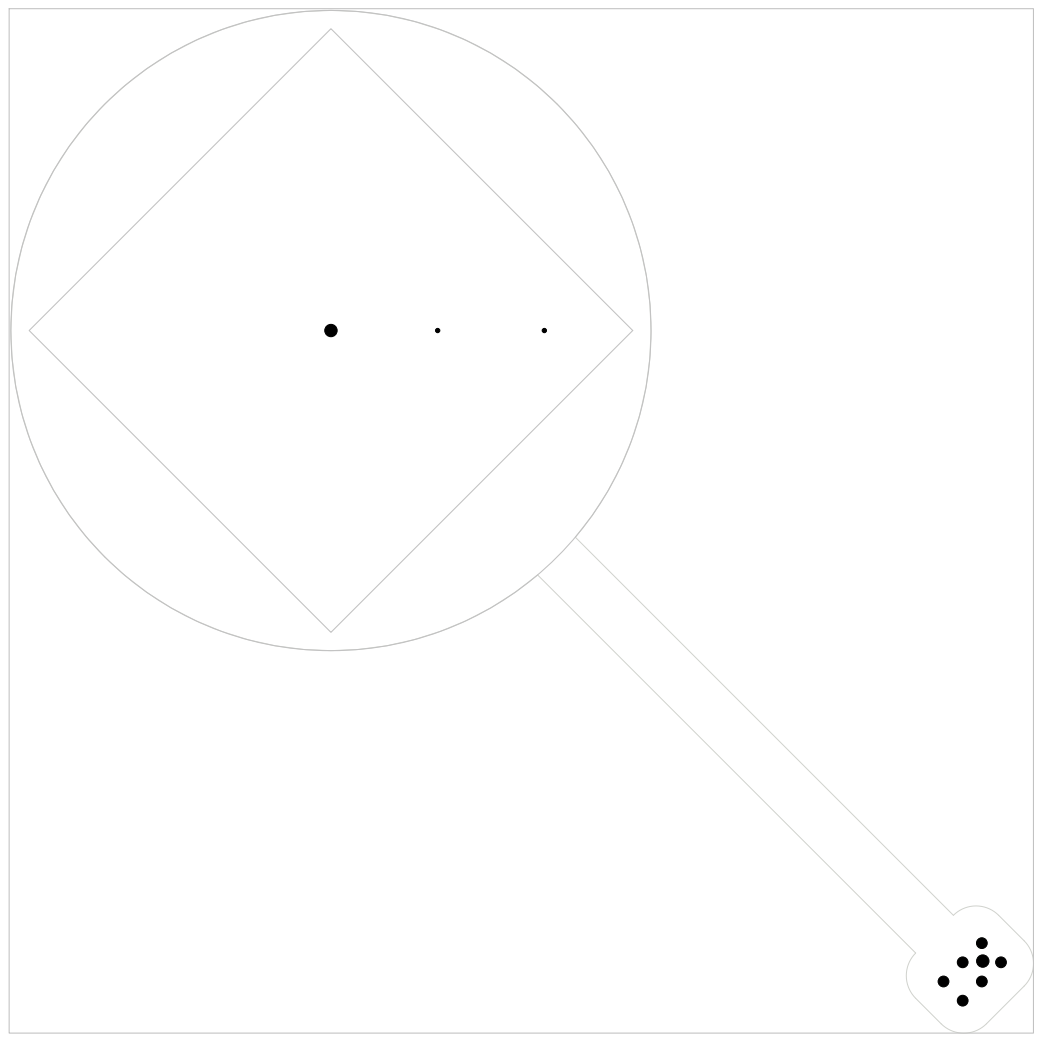
[picture p122: page 1]

Id: 1/1 Title: File: 2024-rfid-sao.kicad_pcb Sheet:
