TomKeddie/prj-pcb-experiments/mr-fixit/mrfixit.kicad_pcb.mechanical.pdf

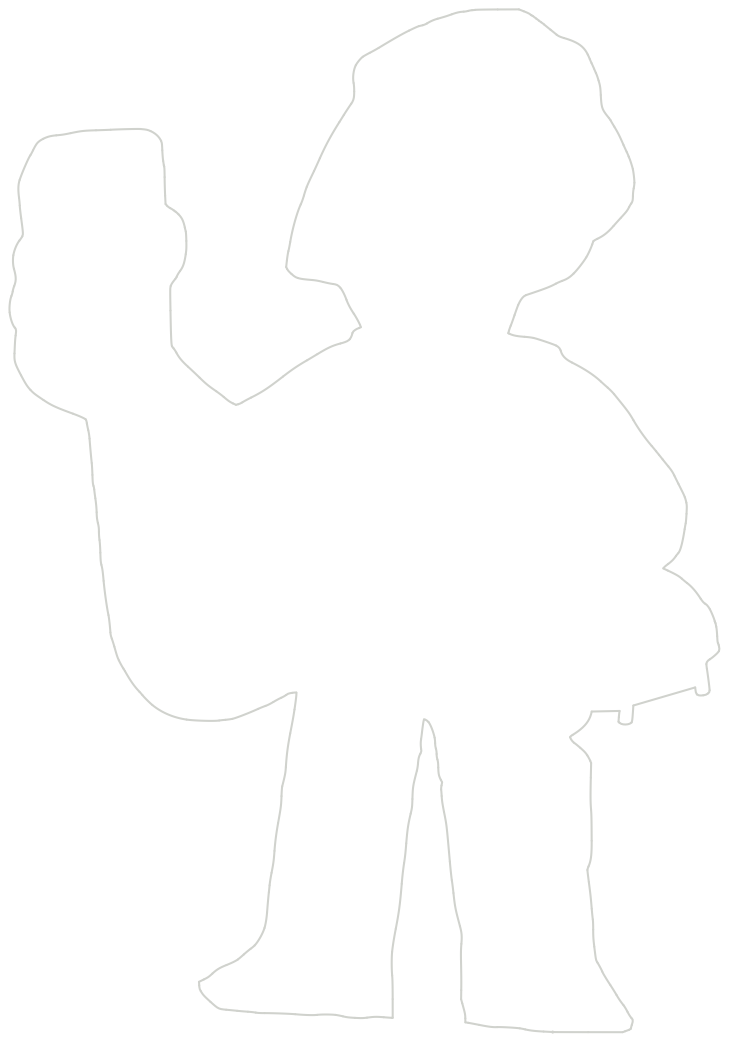
[picture p123: page 1]

Id: 1/1 Title: File: mrfixit.kicad_pcb Sheet:
