TomKeddie/prj-pcb-experiments/mikrobus-pmod-adapt/mikrobus-pmod-adapt.kicad_pcb.mechanical.pdf

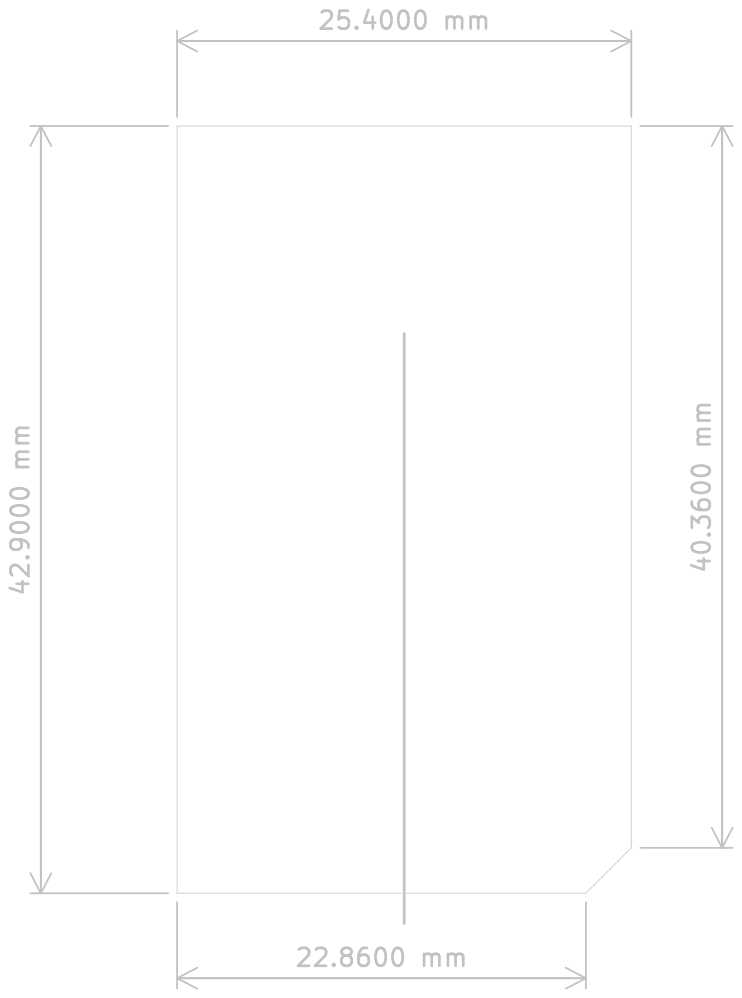
[picture p124: page 1]

Id: 1/1 Title: File: mikrobus-pmod-adapt.kicad_pcb Sheet:
