TomKeddie/prj-pcb-experiments/2023-xmas-snowflake/2023-xmas-snowflake.kicad_pcb.mechanical.pdf

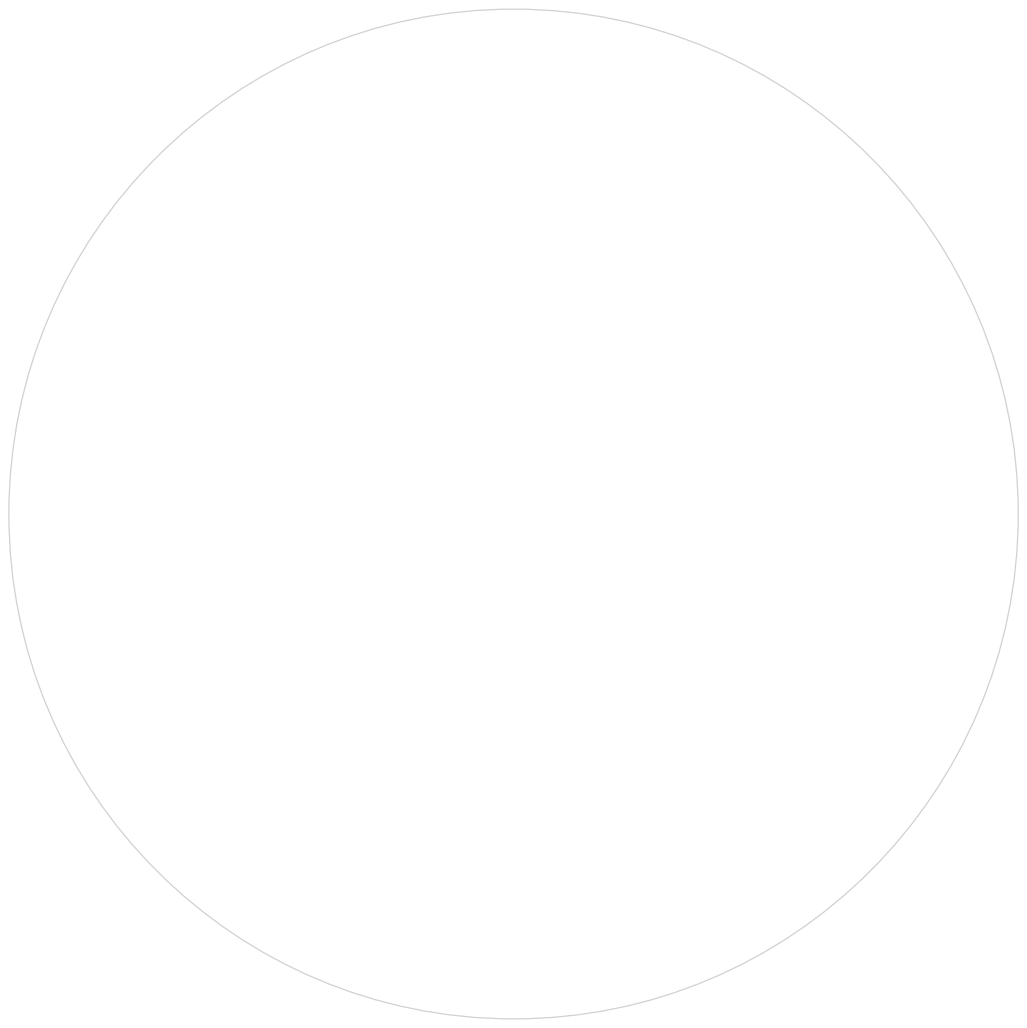
[picture p125: page 1]

Id: 1/1 Title: File: 2023-xmas-snowflake.kicad_pcb Sheet:
