TomKeddie/prj-pcb-experiments/2025-usb-pd-plank/kicad/usb-pd-plank.kicad_pcb.mechanical.pdf

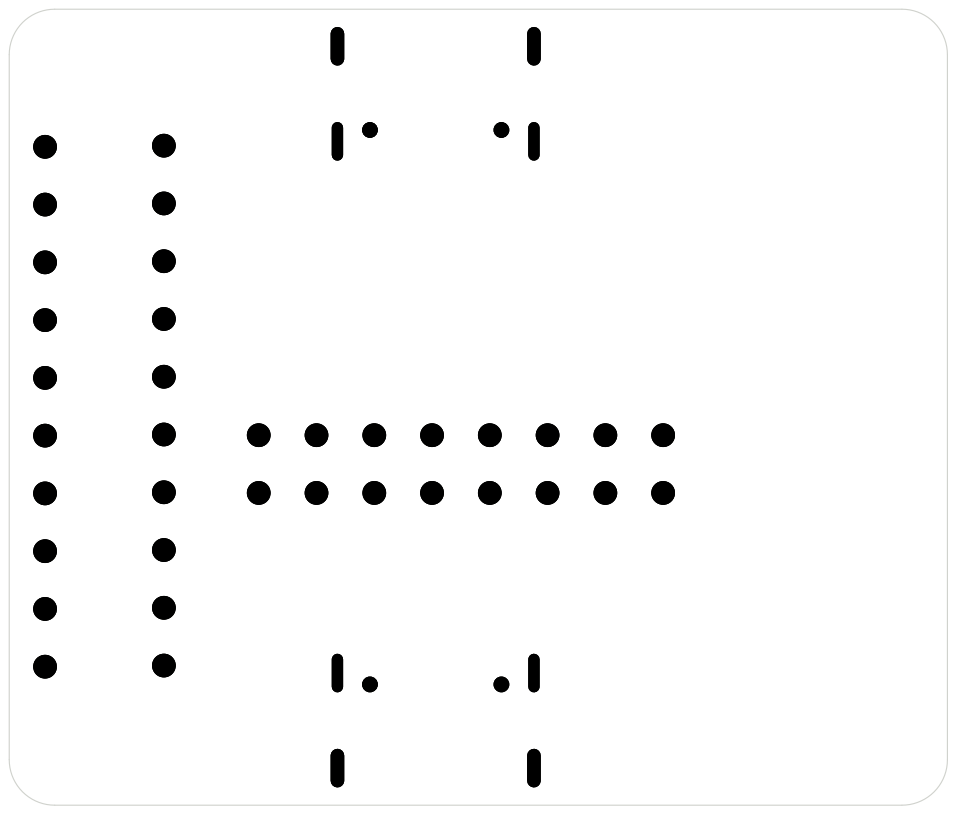
[picture p126: page 1]

Id: 1/1 Title: File: usb-pd-plank.kicad_pcb Sheet:
