TomKeddie/prj-pcb-experiments/2025-flex-spiral/two/2025-flex-spiral-two.kicad_pcb.mechanical.pdf

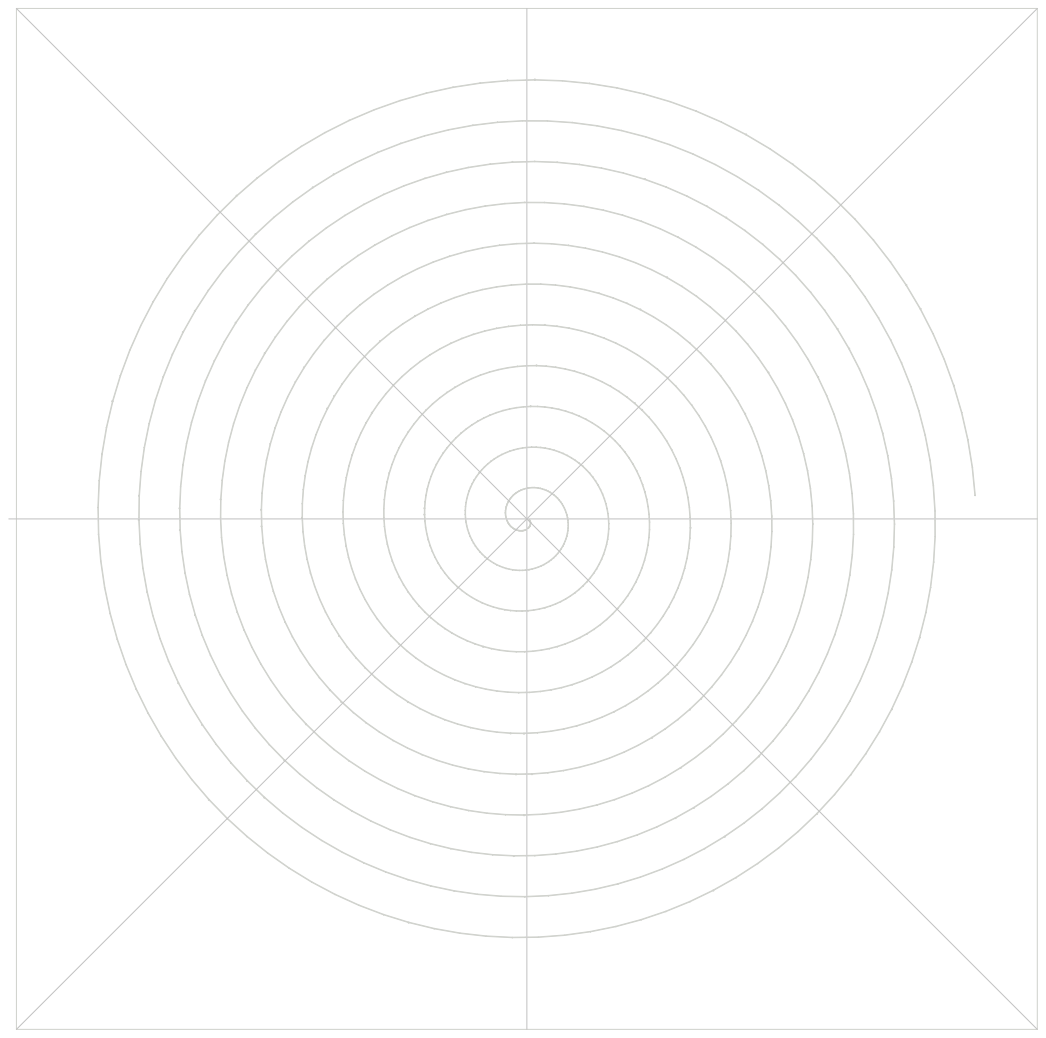
[picture p127: page 1]

File: 2025-flex-spiral-two.kicad_pcb Sheet:
Id: 1/1 Title: 2025-flex-spiral-two
