TomKeddie/prj-pcb-experiments/2025-flex-spiral/one/2025-flex-spiral.kicad_pcb.mechanical.pdf

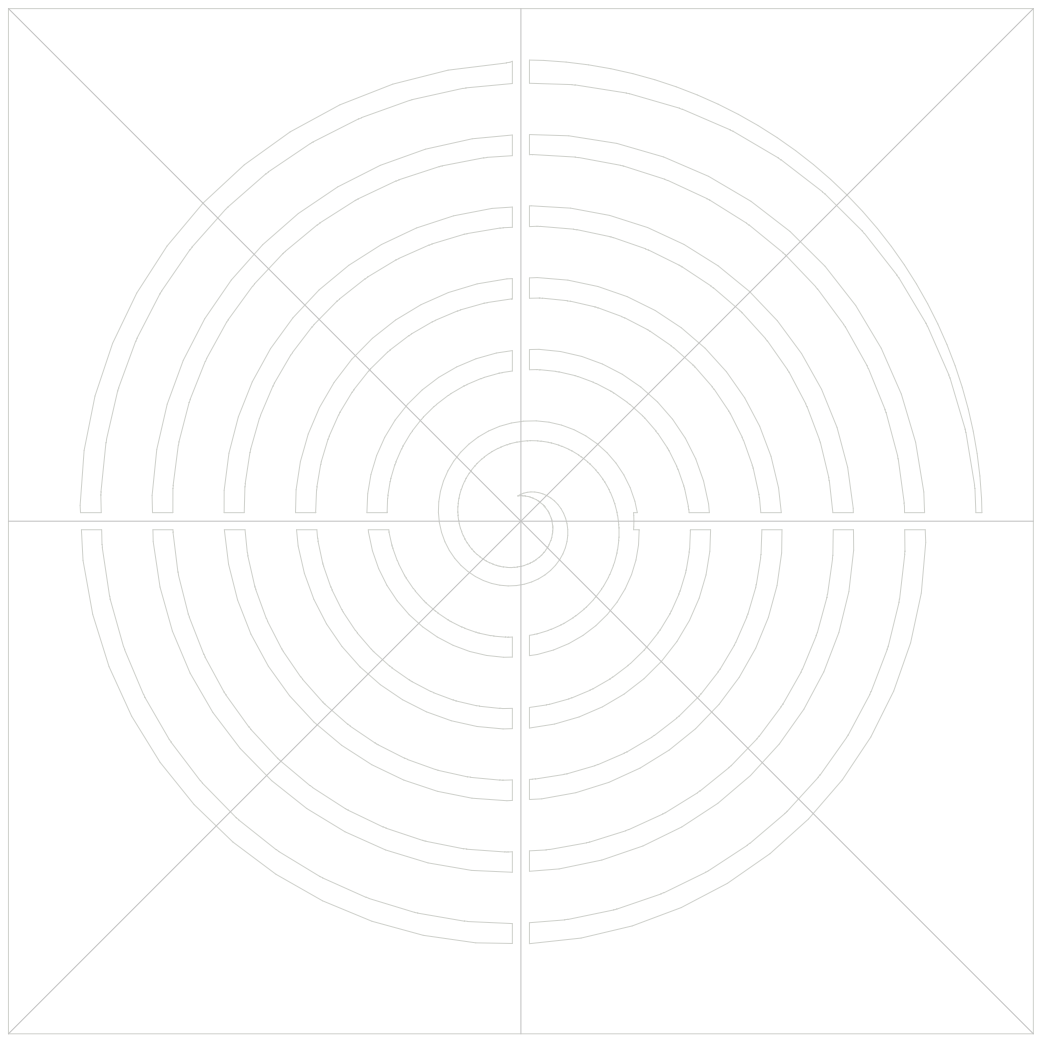
[picture p128: page 1]

Id: 1/1 Title: File: 2025-flex-spiral.kicad_pcb Sheet:
