TomKeddie/prj-pcb-experiments/2024-led-ctrl-24v/kicad/led-ctrl-24v.kicad_pcb.mechanical.pdf

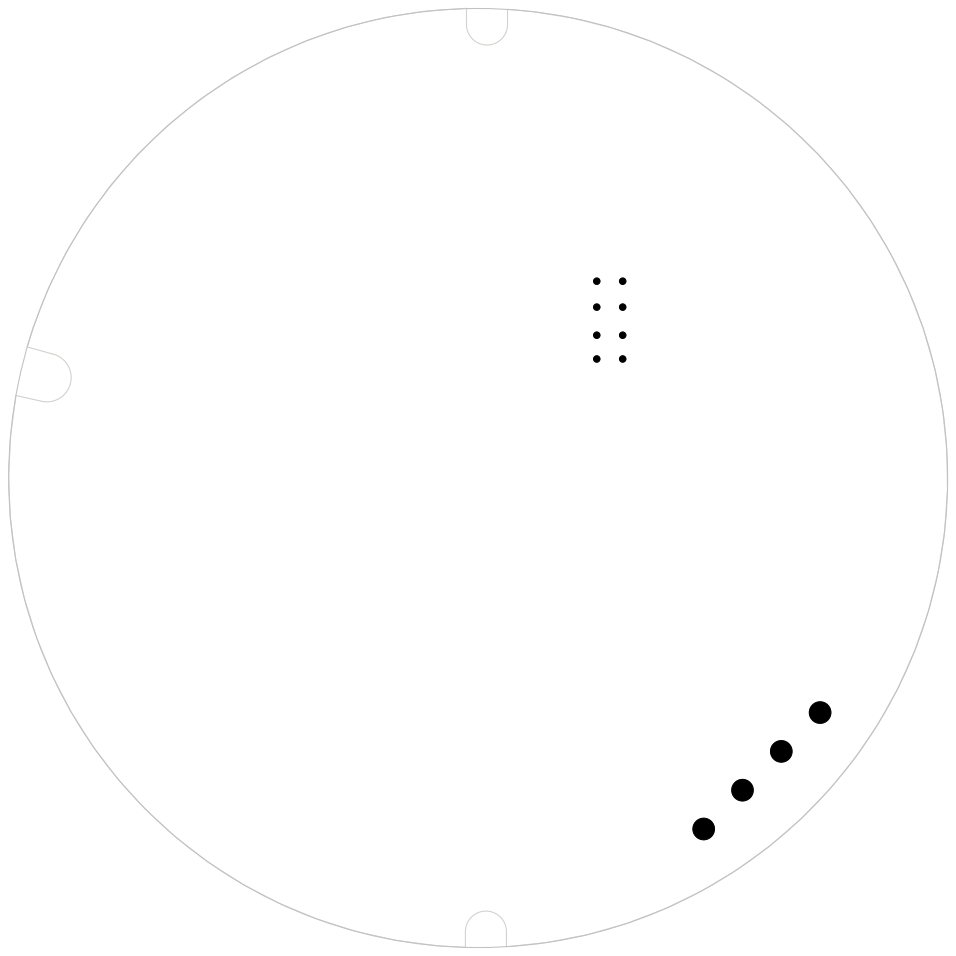
[picture p129: page 1]

Id: 1/1 Title: File: led-ctrl-24v.kicad_pcb Sheet:
