TomKeddie/prj-pcb-experiments/2024-clock-retrofit/kicad/2024-clock-retrofit.kicad_pcb.mechanical.pdf

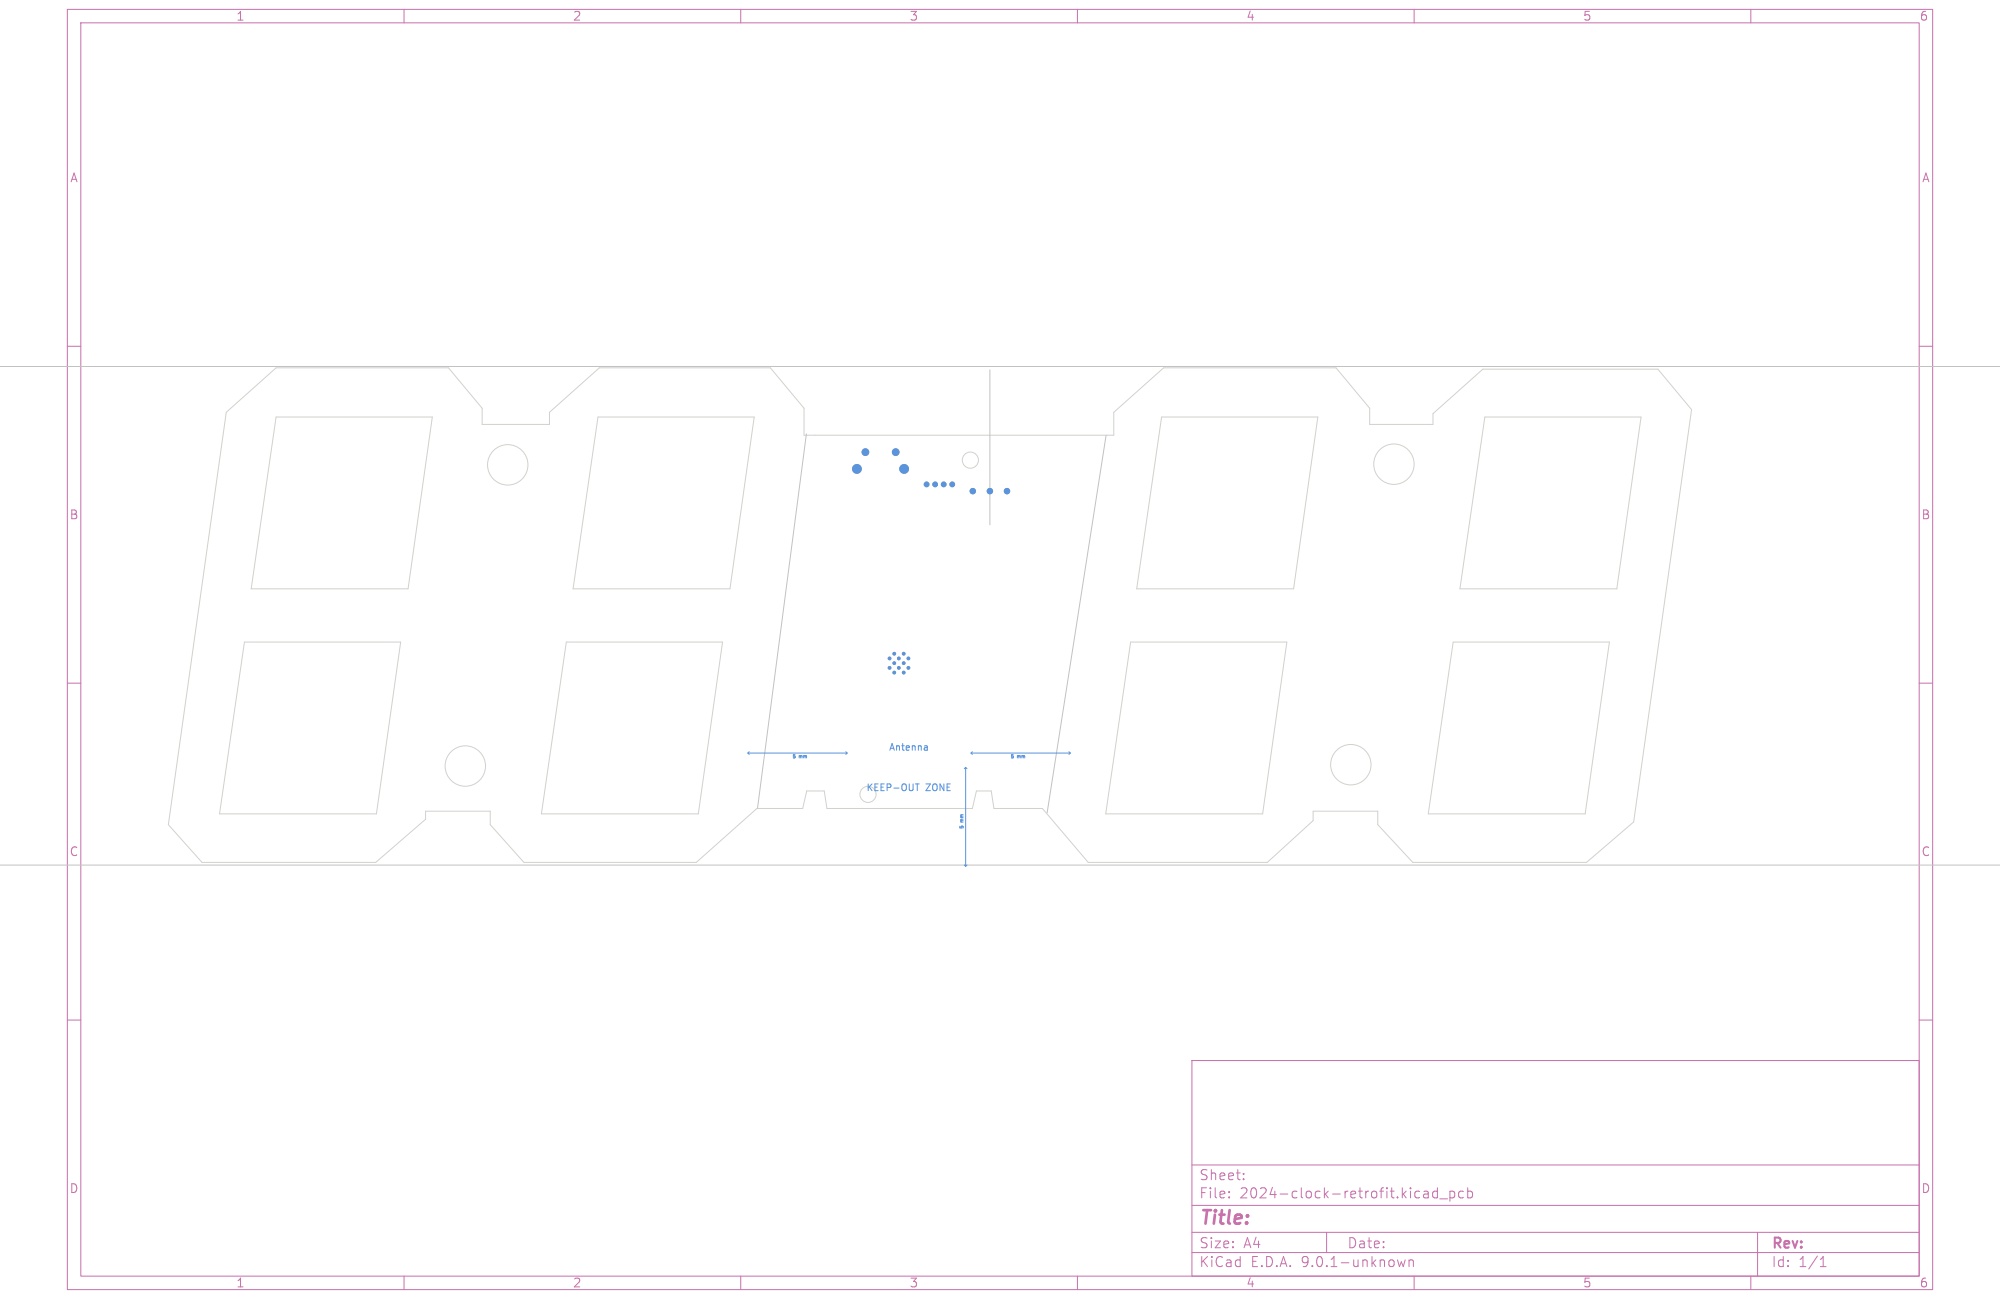
[picture p130: page 1]

Antenna
5 mm KEEP-OUT ZONE

Id: 1/1 Title: File: 2024-clock-retrofit.kicad_pcb Sheet:
