TomKeddie/prj-pcb-experiments/baggage-label/baggage-label-felix/baggage-label-felix.kicad_pcb.mechanical.pdf

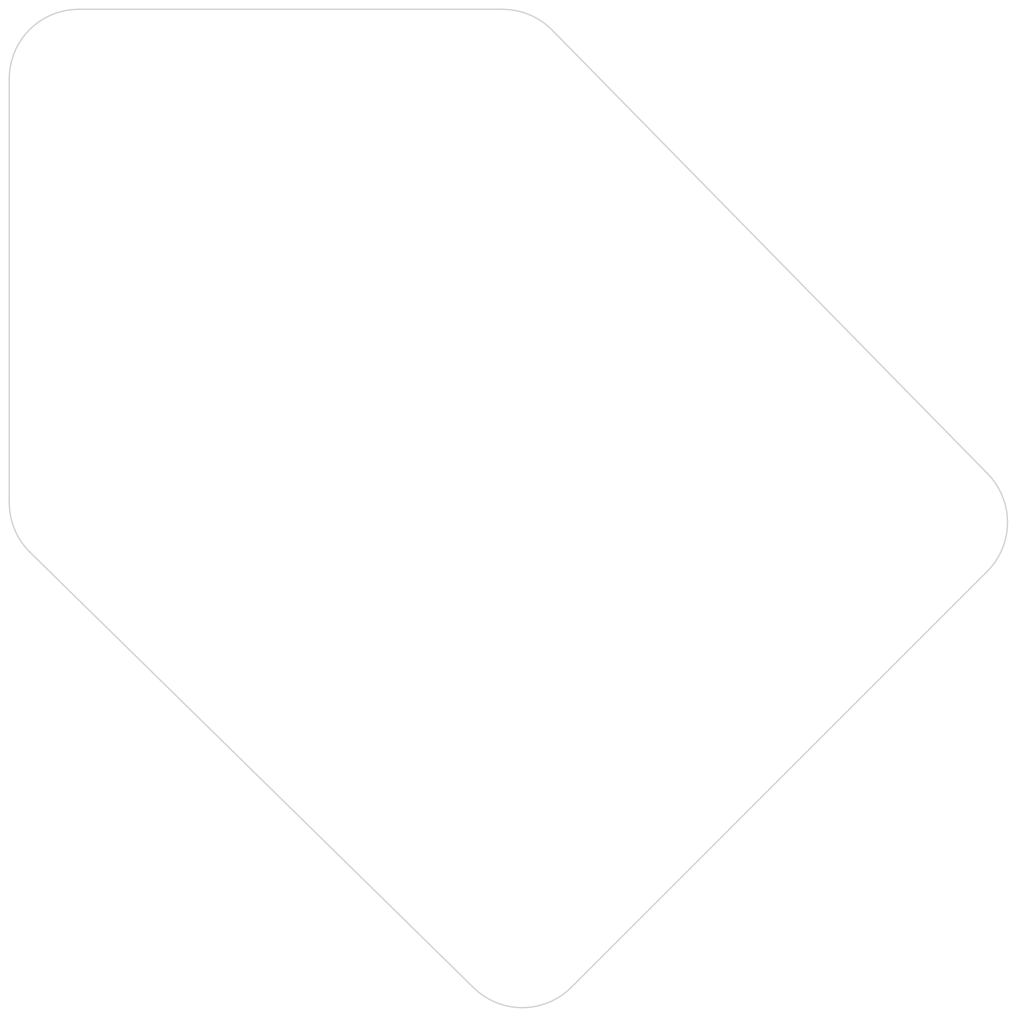
[picture p131: page 1]

Id: 1/1 Title: File: baggage-label-felix.kicad_pcb Sheet:
