TomKeddie/prj-pcb-experiments/baggage-label/baggage-label-blank/baggage-label-blank.kicad_pcb.mechanical.pdf

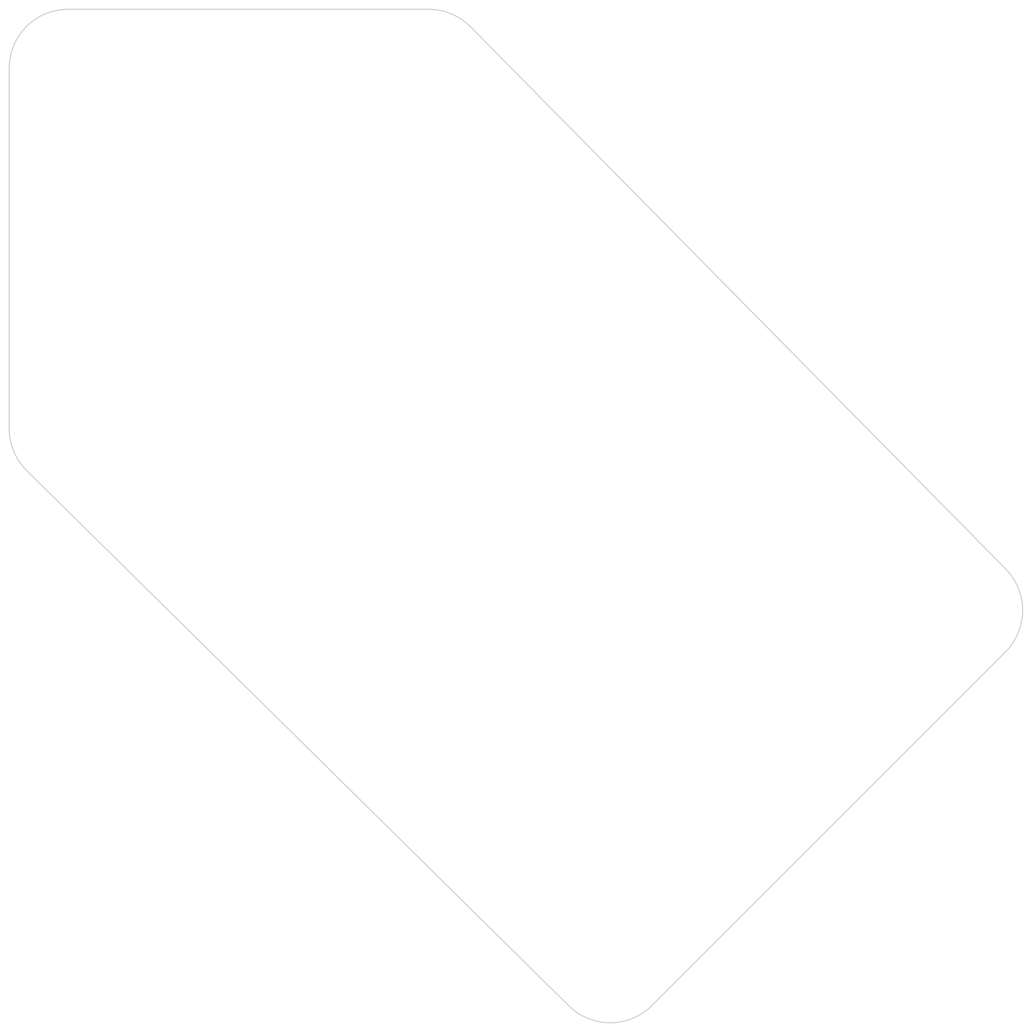
[picture p132: page 1]

Id: 1/1 Title: File: baggage-label-blank.kicad_pcb Sheet:
