TomKeddie/prj-pcb-experiments/2024-supercon-sign-sao/kicad/2024-supercon-sign-sao.kicad_pcb.mechanical.pdf

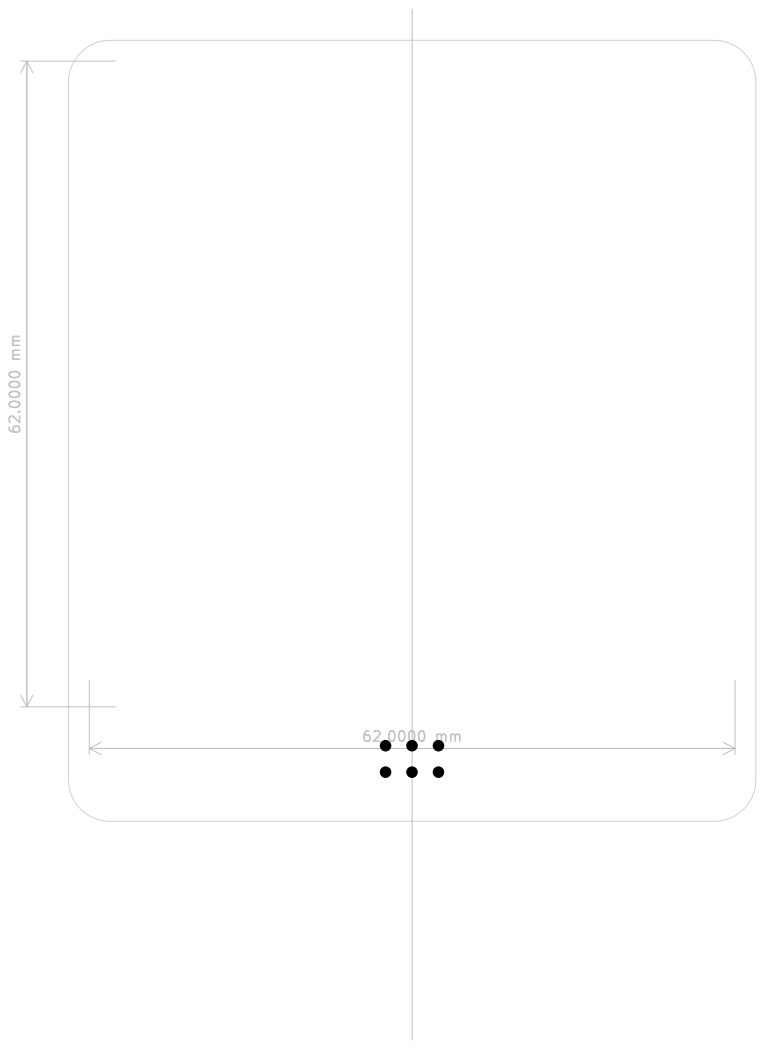
[picture p133: page 1]

Id: 1/1 Title: File: 2024-supercon-sign-sao.kicad_pcb Sheet: 62.0000 mm
