TomKeddie/prj-pcb-experiments/baggage-label/baggage-label-mid/baggage-label-mid.kicad_pcb.mechanical.pdf

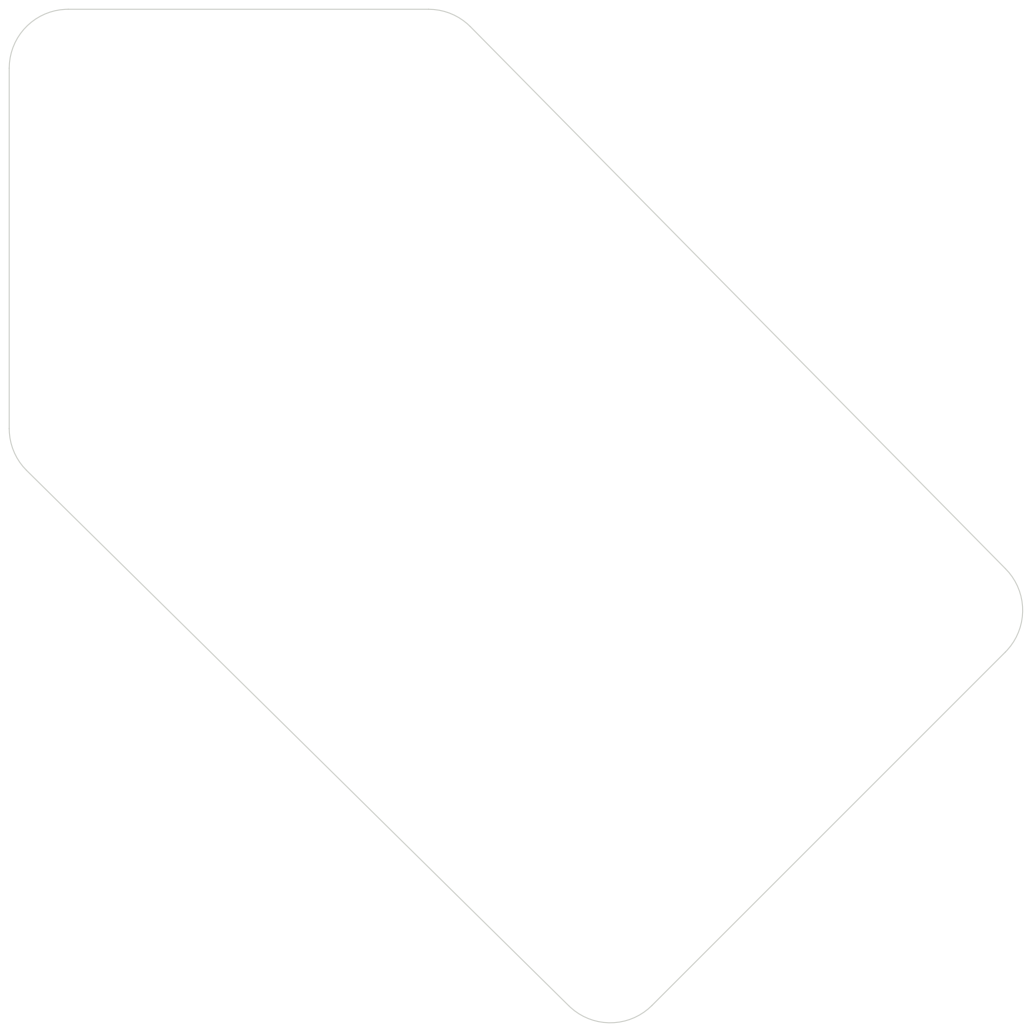
[picture p134: page 1]

Id: 1/1 Title: File: baggage-label-mid.kicad_pcb Sheet:
