TomKeddie/prj-pcb-experiments/baggage-label/baggage-label-small/baggage-label-small.kicad_pcb.mechanical.pdf

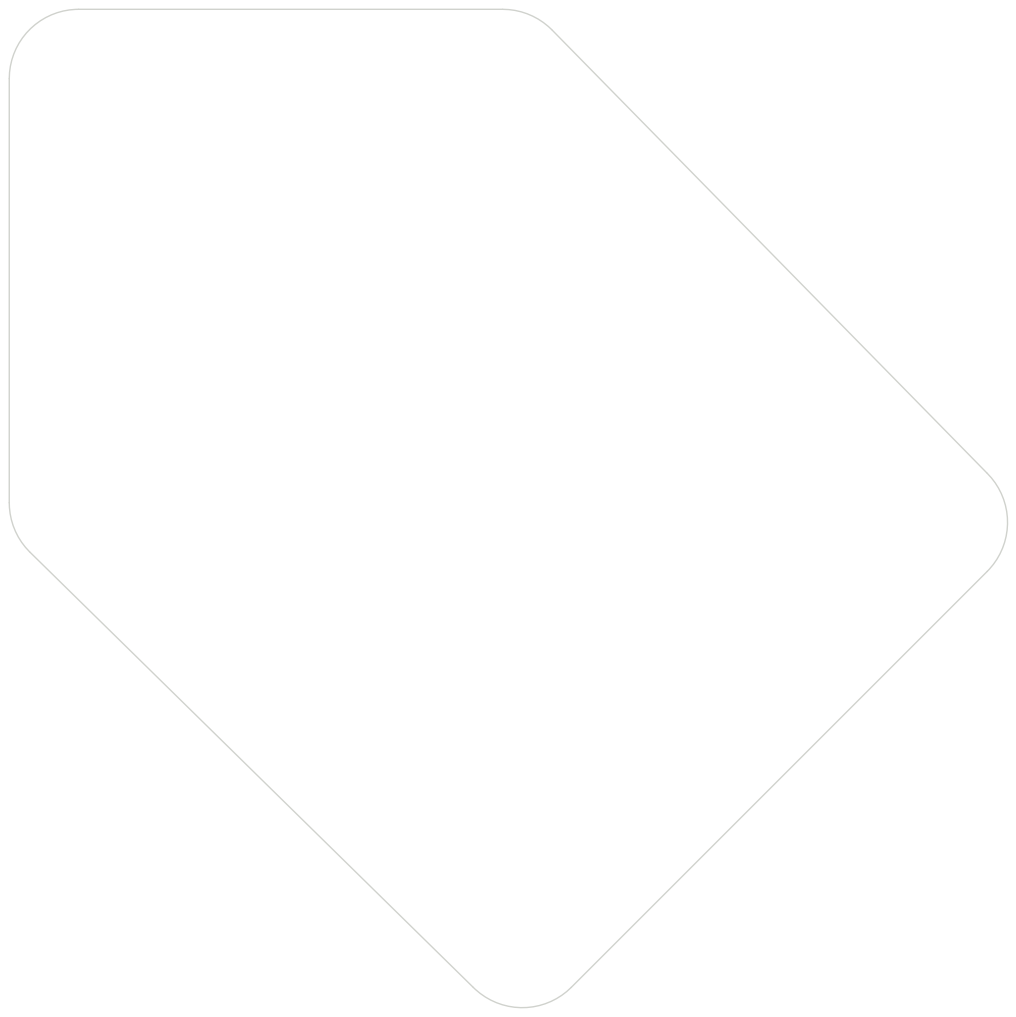
[picture p135: page 1]

Id: 1/1 Title: File: baggage-label-small.kicad_pcb Sheet:
