TomKeddie/prj-pcb-experiments/baggage-label/baggage-label/baggage-label.kicad_pcb.mechanical.pdf

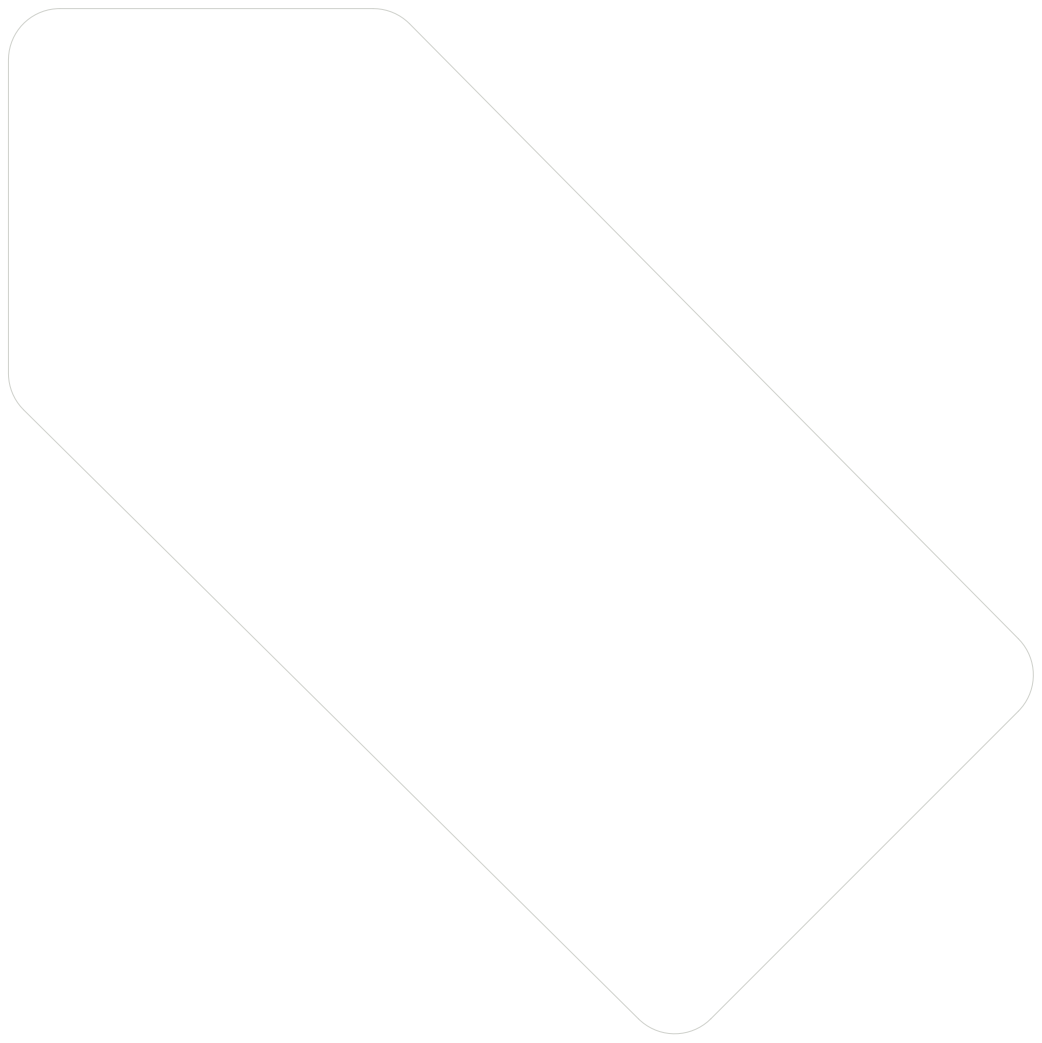
[picture p136: page 1]

Id: 1/1 Title: File: baggage-label.kicad_pcb Sheet:
