TomKeddie/prj-pcb-experiments/strange-parts/strange-parts-sao/strange-parts-sao.kicad_pcb.mechanical.pdf

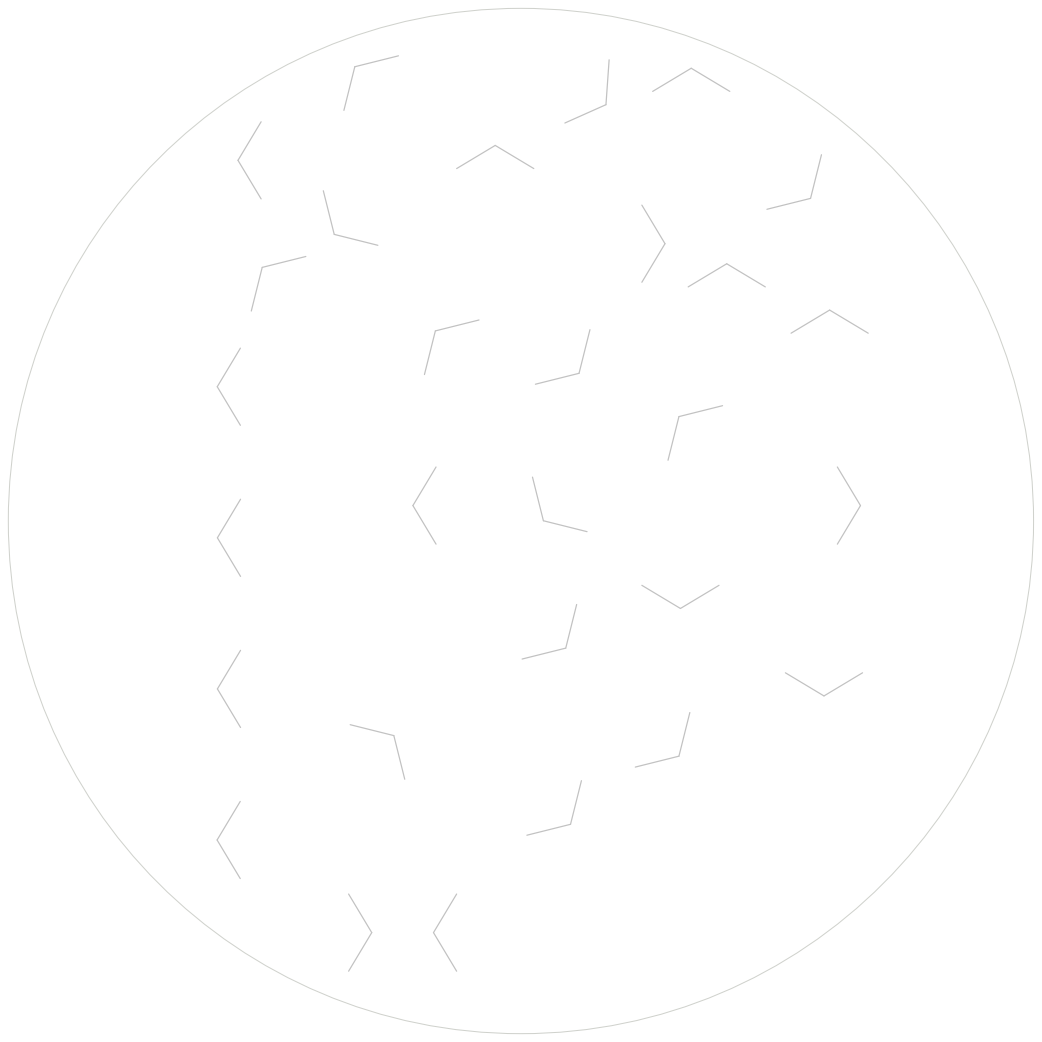
[picture p137: page 1]

Id: 1/1 Title: File: strange-parts-sao.kicad_pcb Sheet:
