TomKeddie/prj-pcb-experiments/strange-parts/strange-parts-sao/strange-parts-sao.kicad_sch.pdf

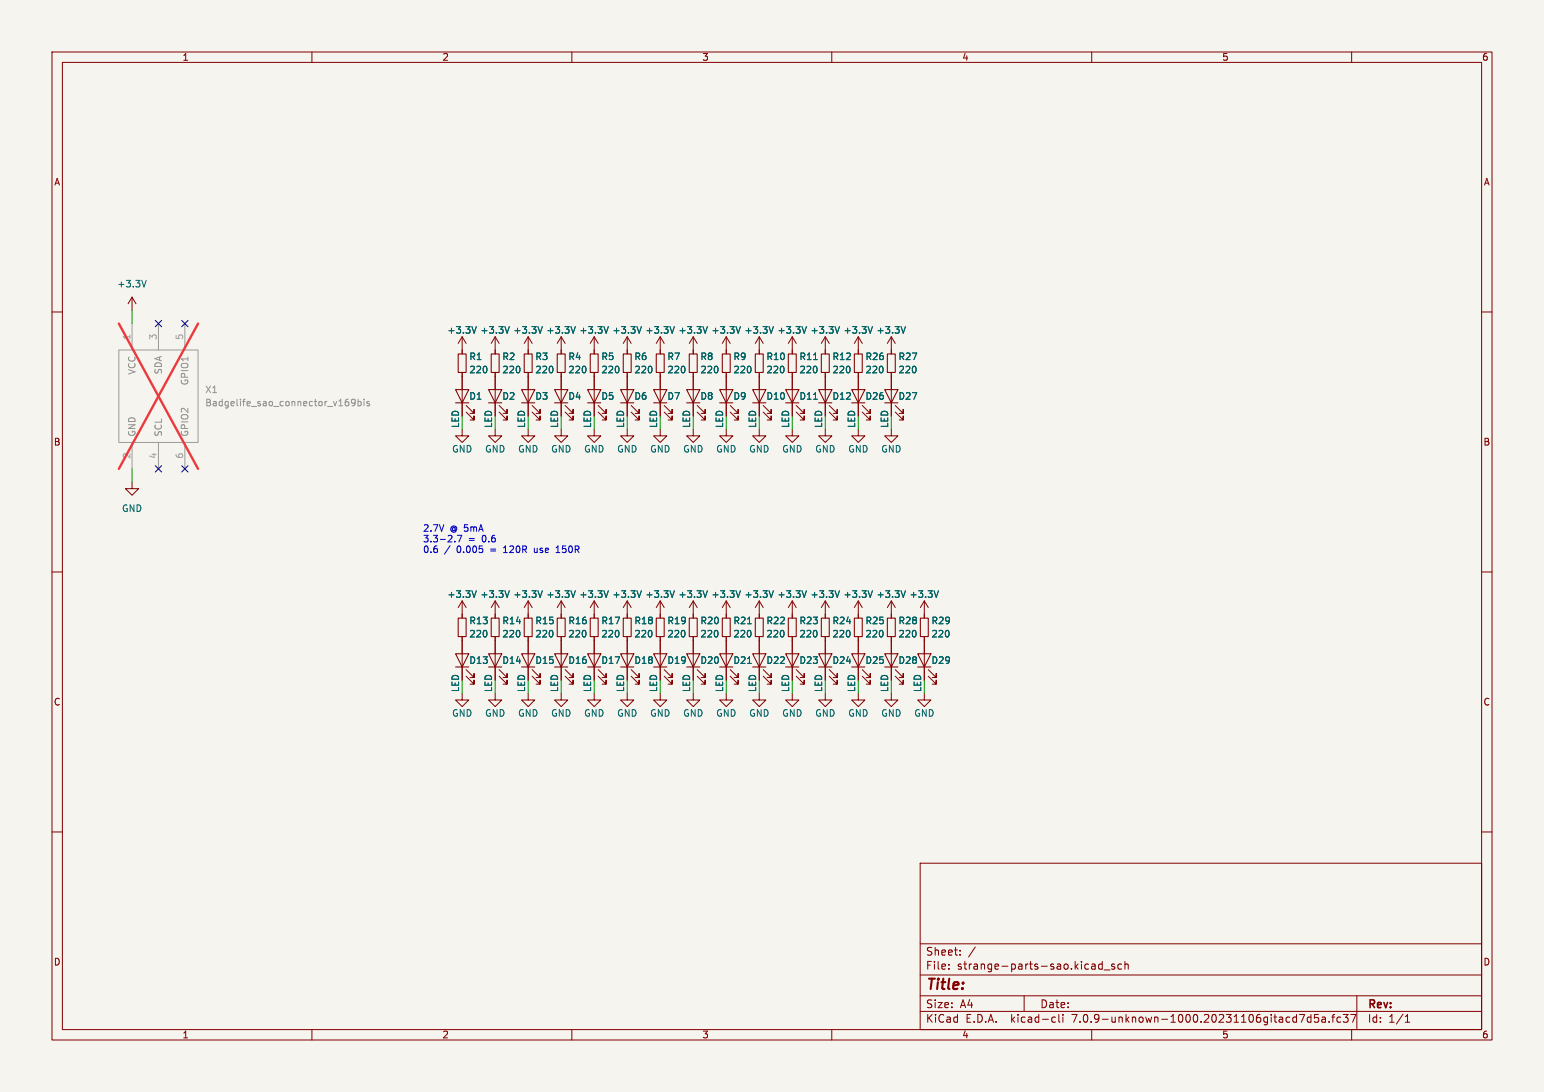
[picture p138: page 1]

1 GND
220 GND GND GND VCC

D17 LED GND GND GND

Id: 1/1 Title: File: strange-parts-sao.kicad_sch Sheet: / GND
