TomKeddie/prj-pcb-experiments/strange-parts/strange-parts-coaster/strange-parts-coaster.kicad_pcb.mechanical.pdf

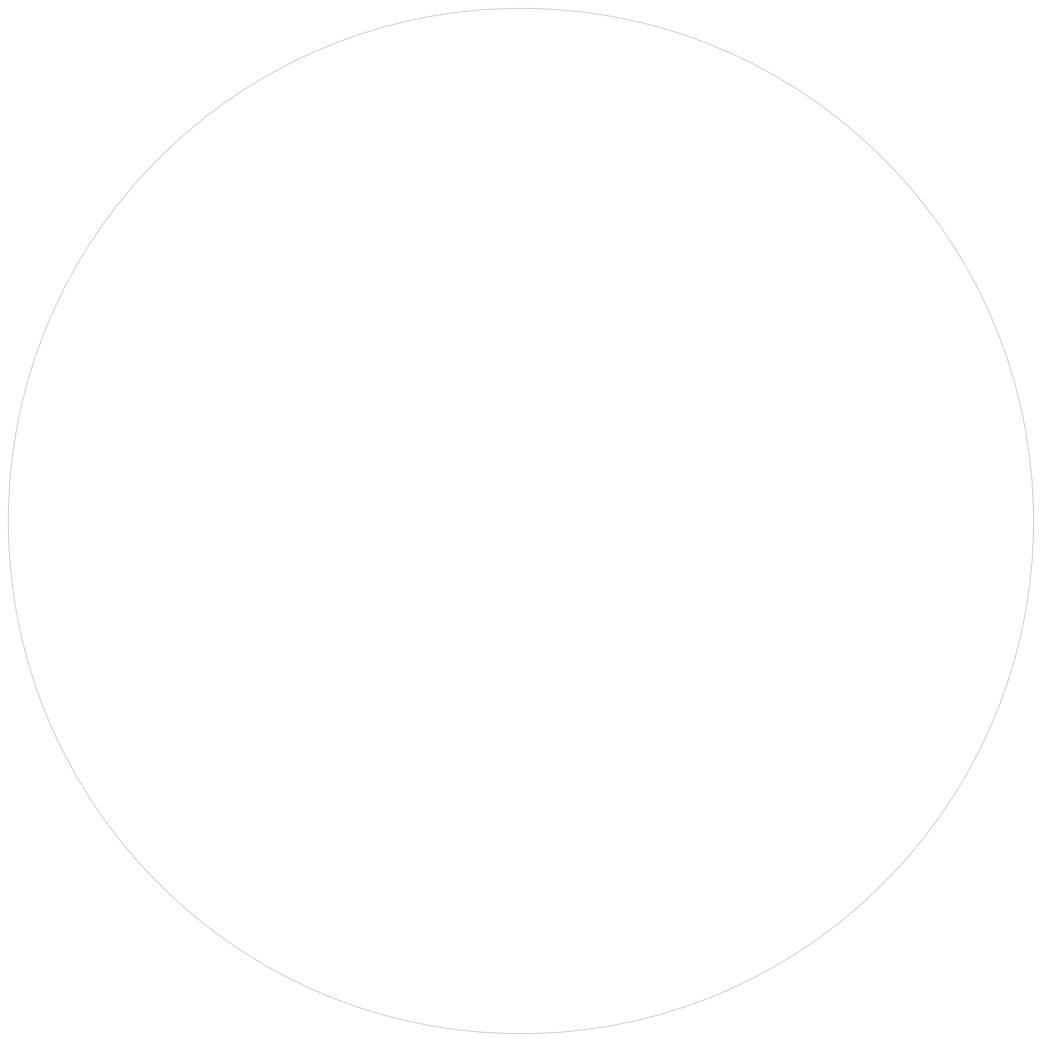
[picture p139: page 1]

Id: 1/1 Title: File: strange-parts-coaster.kicad_pcb Sheet:
