TomKeddie/prj-pcb-experiments/blue-pill-bmp/hardware/doc/blue-pill-bmp-sch-.pdf

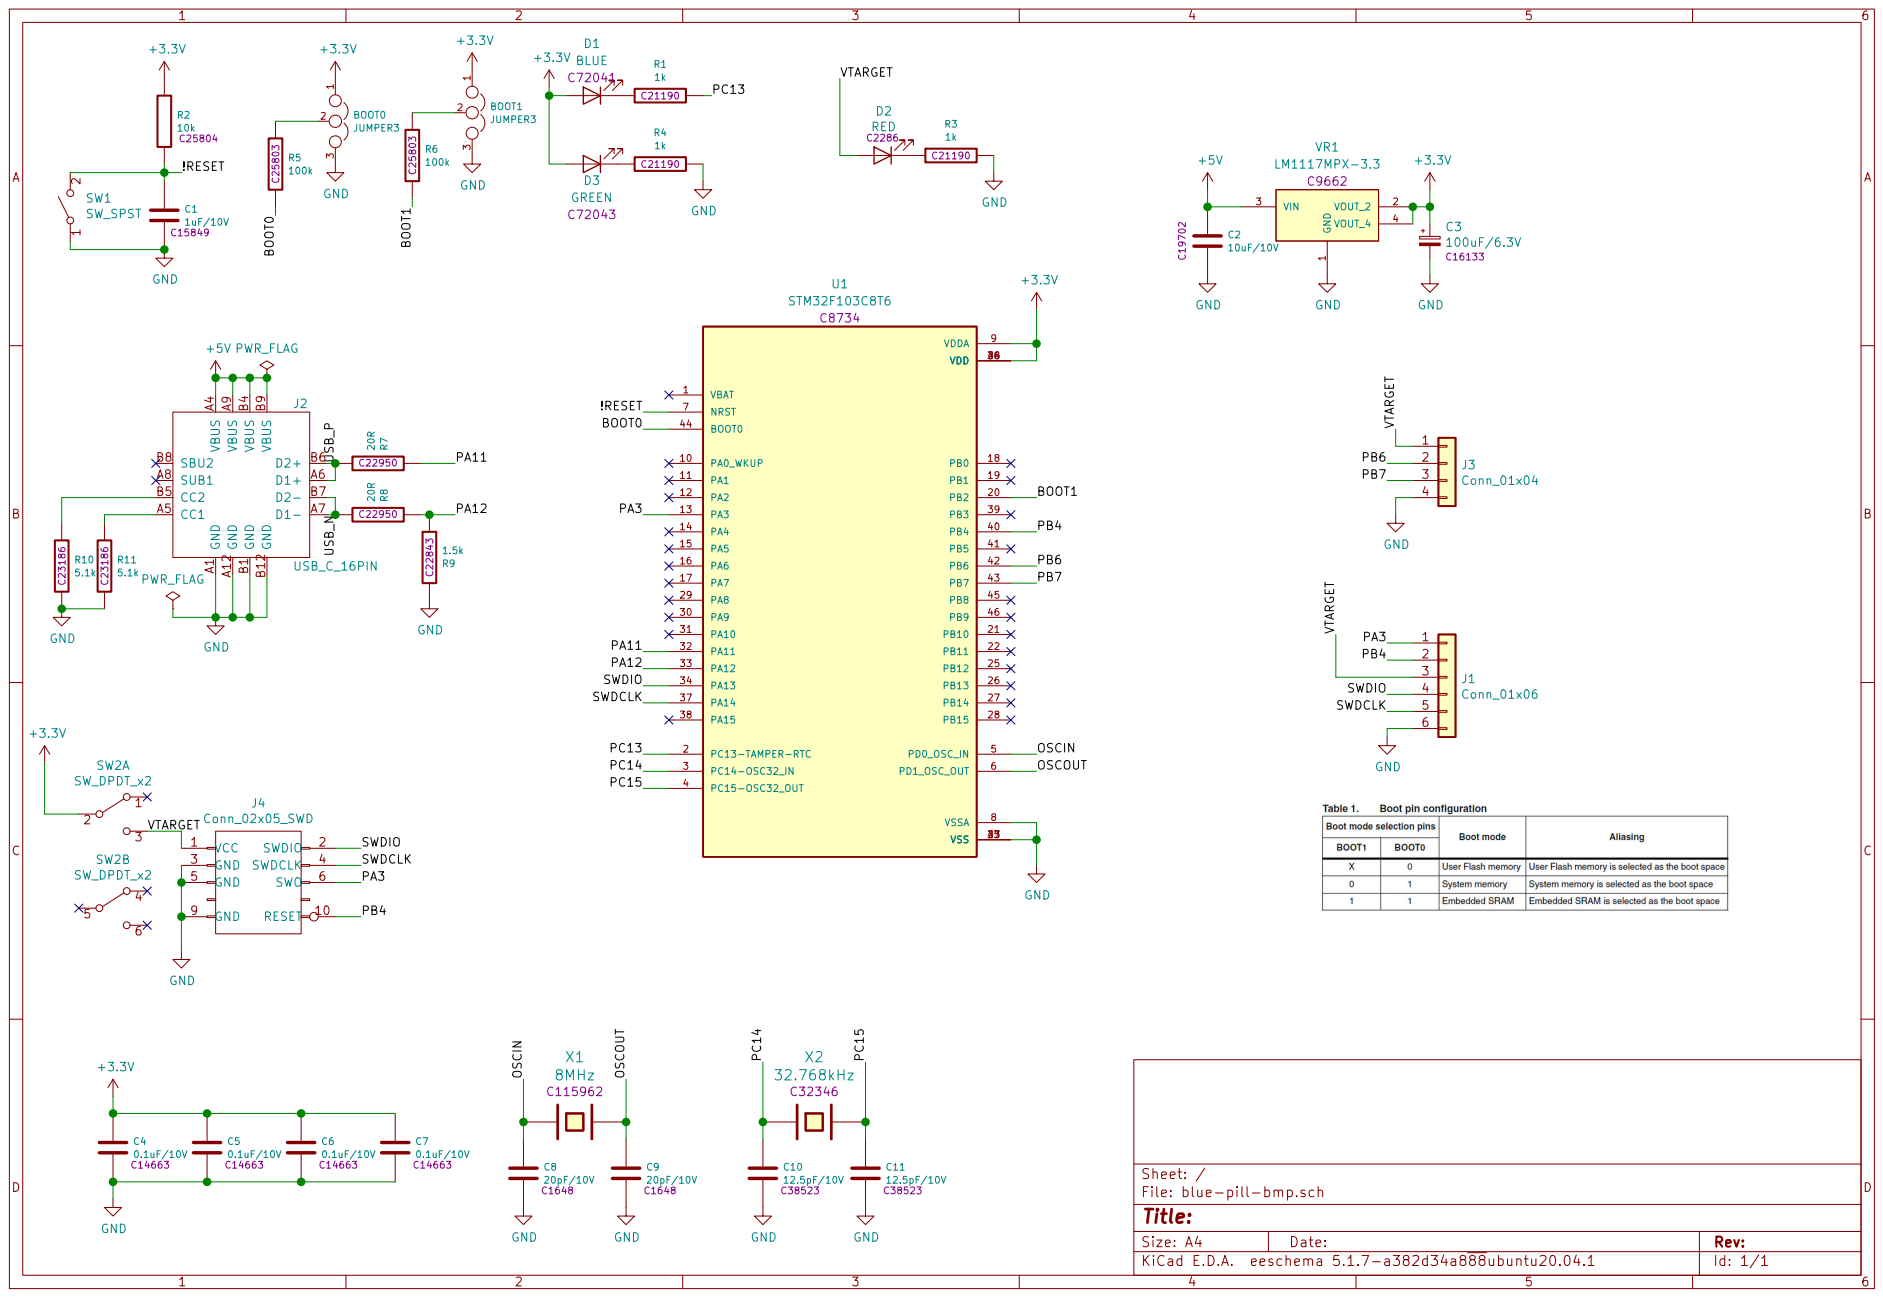
[picture p140: page 1]

File: blue-pill-bmp.sch Sheet: / GND
