TomKeddie/prj-pcb-experiments/minim-wemos-2023/minim-wemos-2023.kicad_sch.pdf

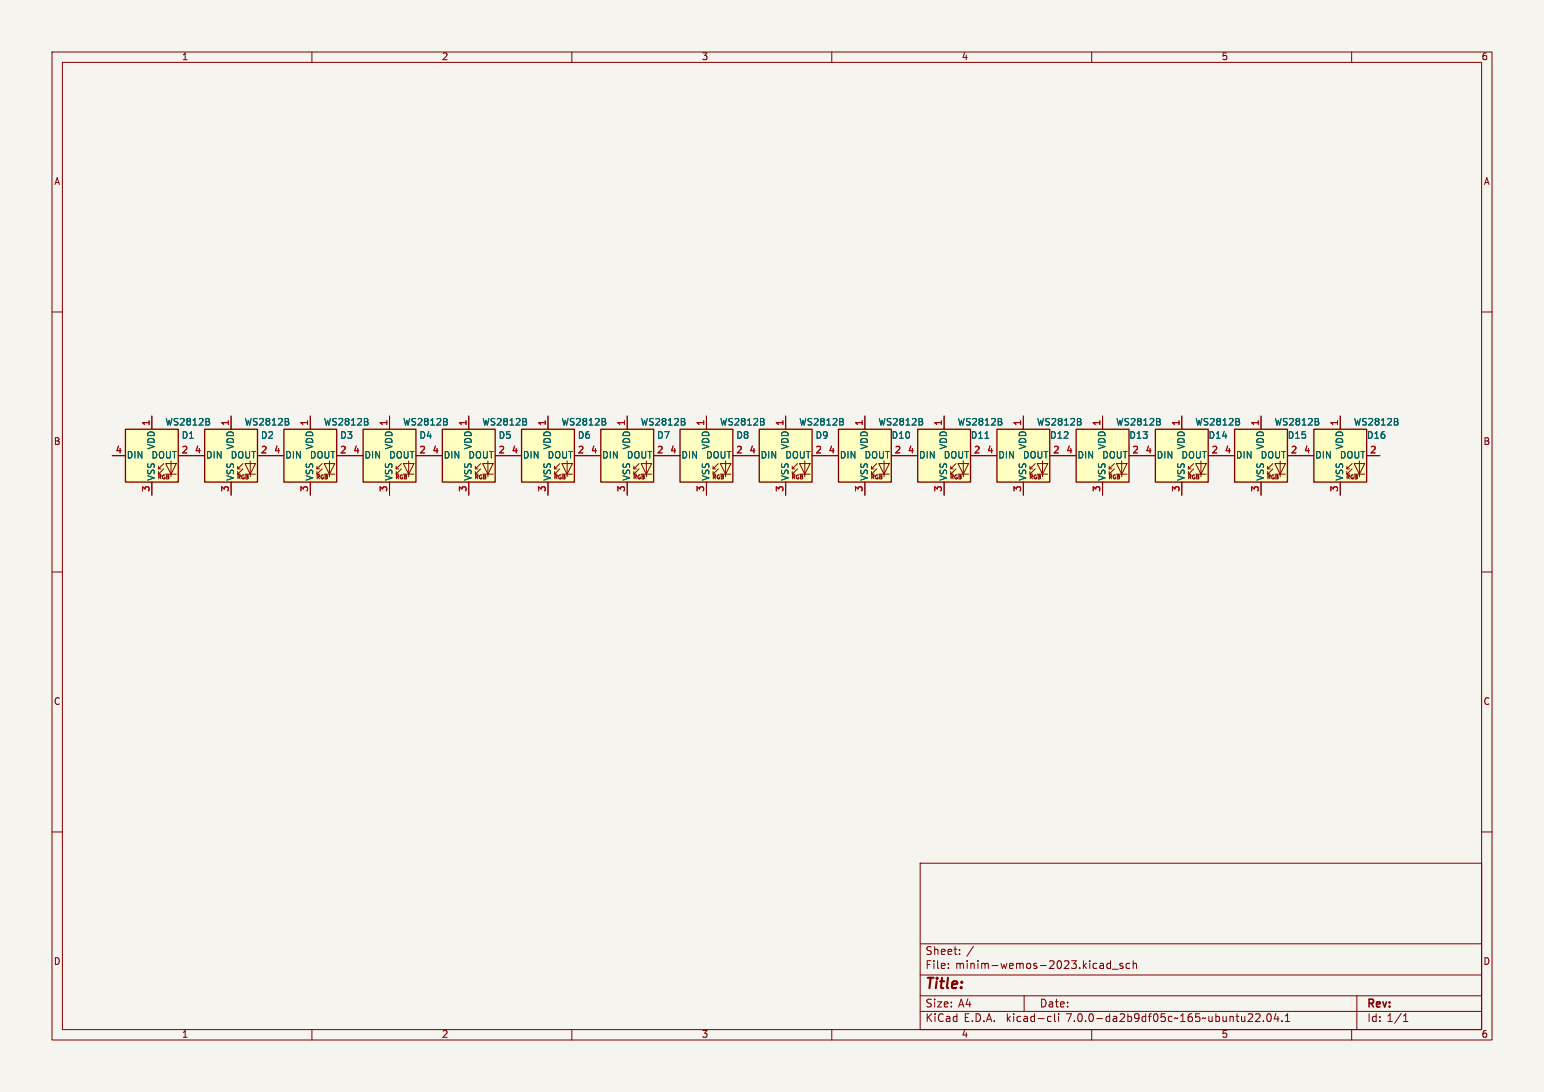
[picture p141: page 1]

Id: 1/1 Title: File: minim-wemos-2023.kicad_sch Sheet: /
