TomKeddie/prj-pcb-experiments/2024-rfid-sao/2024-rfid-sao.kicad_sch.pdf

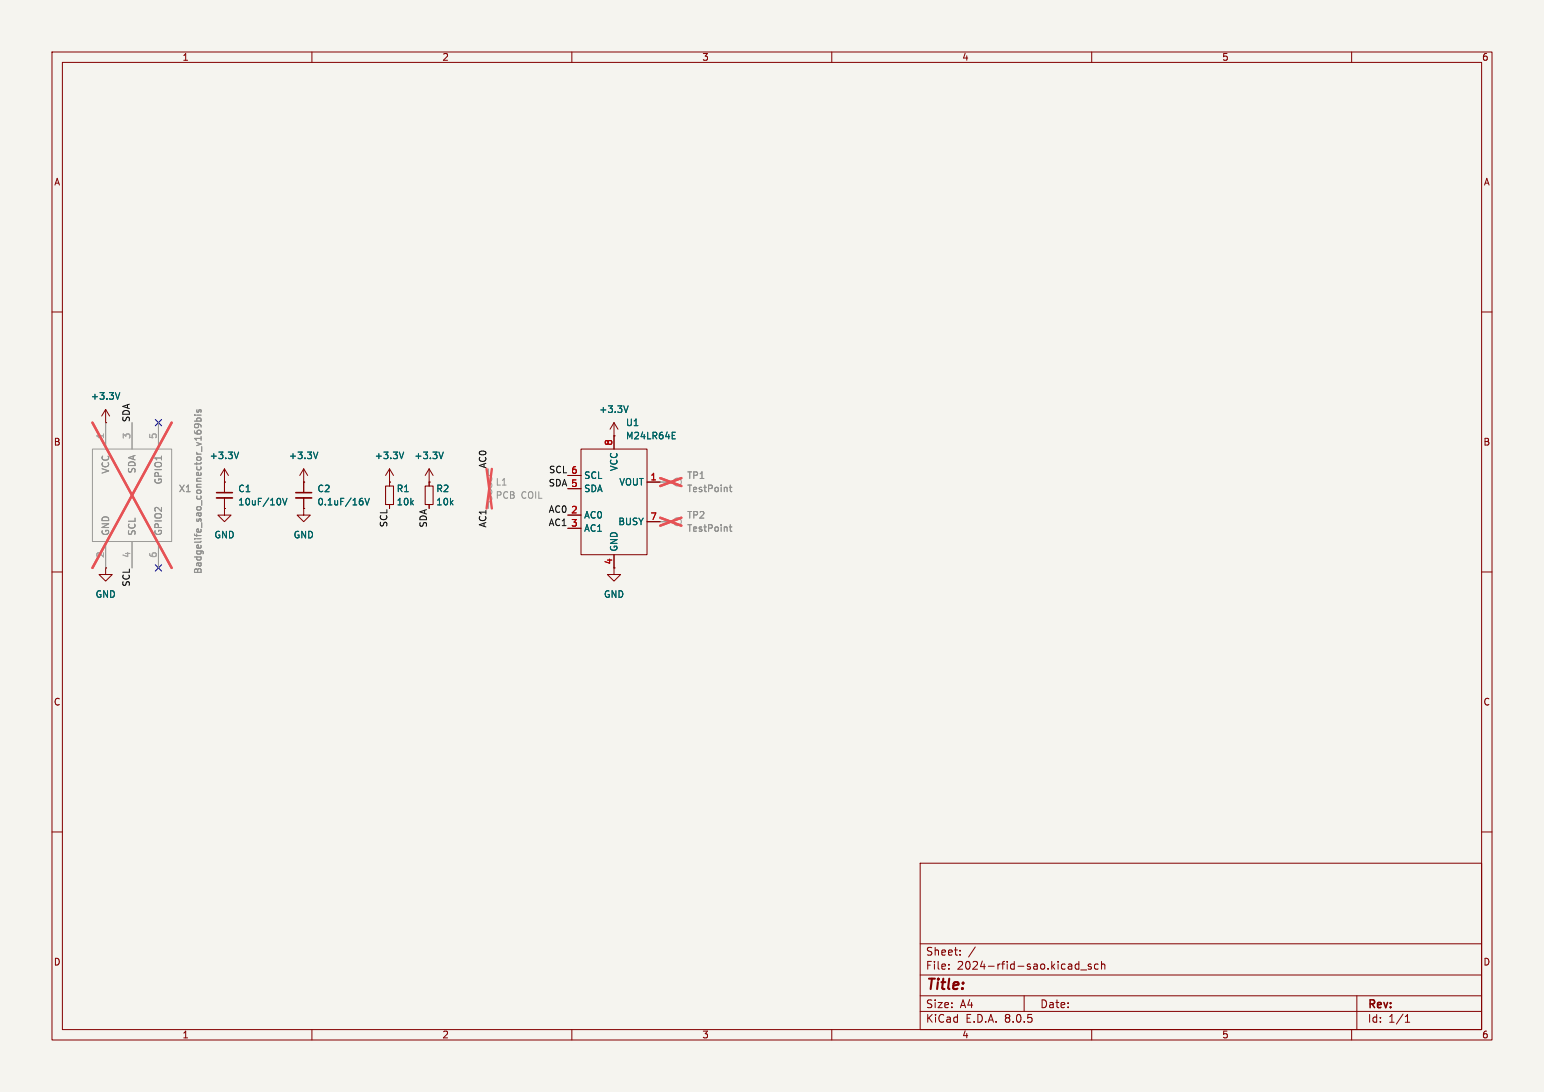
[picture p143: page 1]

4 SDA 5 SCL 6 BUSY 7 VCC

Id: 1/1 Title: File: 2024-rfid-sao.kicad_sch Sheet: / GND
