TomKeddie/prj-pcb-experiments/atmelice-swd-breakout-switch/atmelice-swd-breakout-switch.kicad_sch.pdf

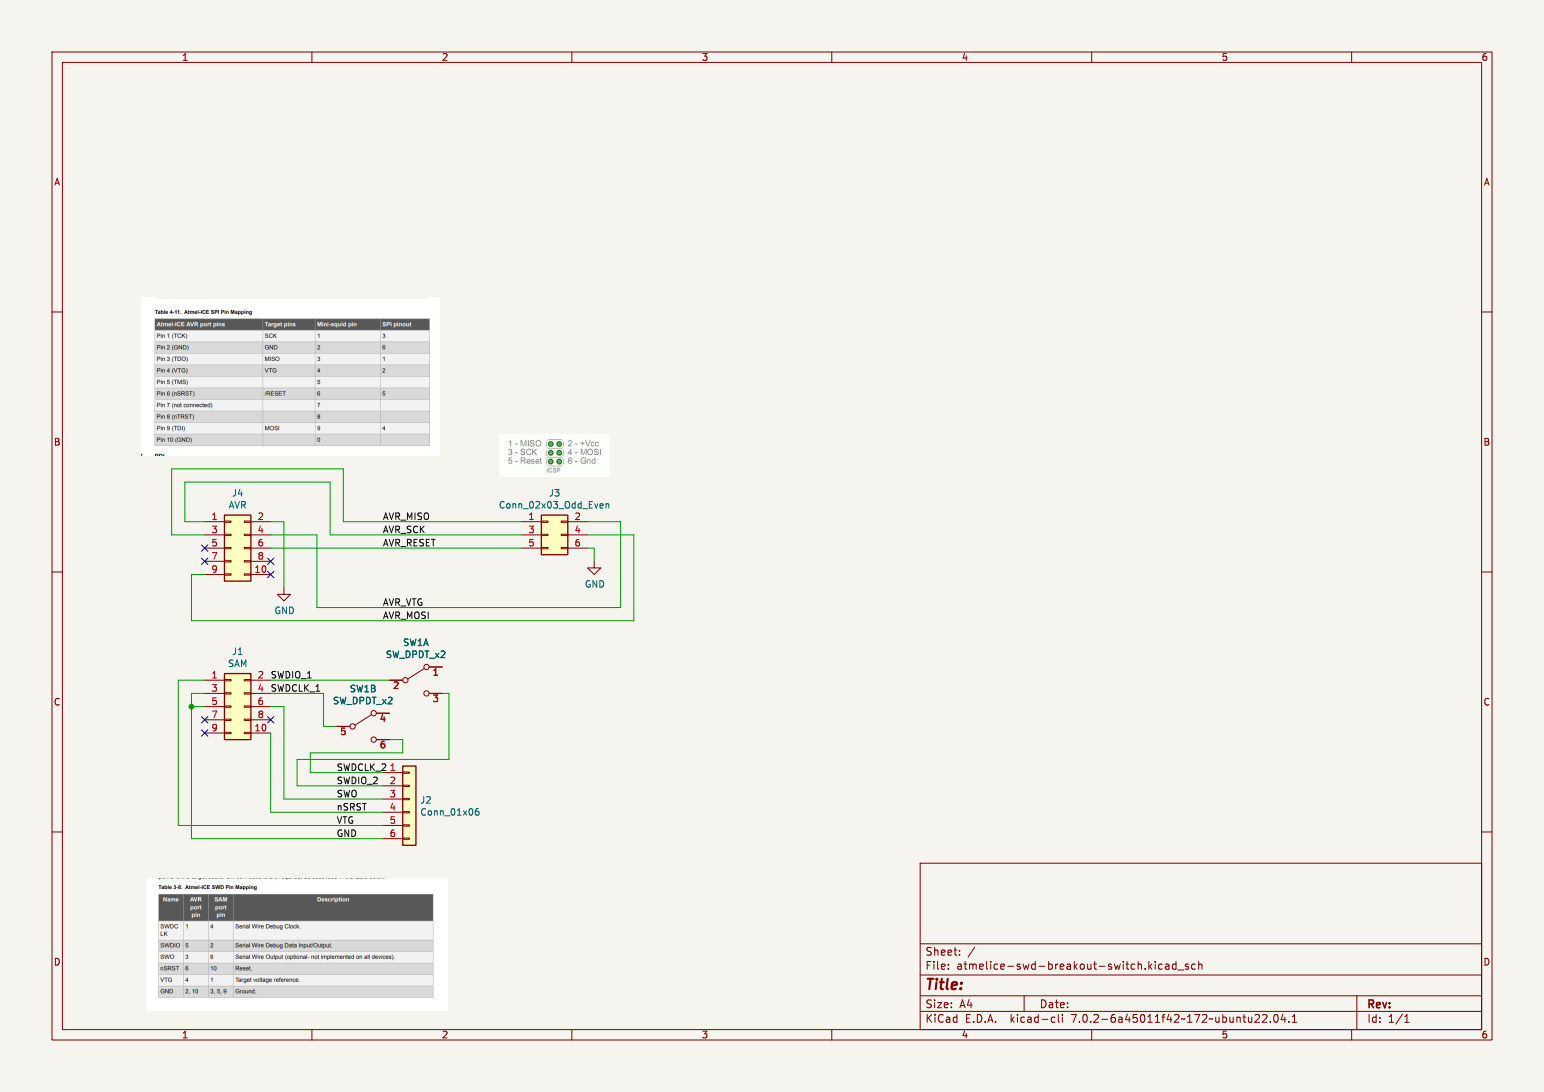
[picture p144: page 1]

Id: 1/1 Title: File: atmelice-swd-breakout-switch.kicad_sch Sheet: /
