TomKeddie/prj-pcb-experiments/esp8266-plugpack/esp8266-plugpack.kicad_sch.pdf

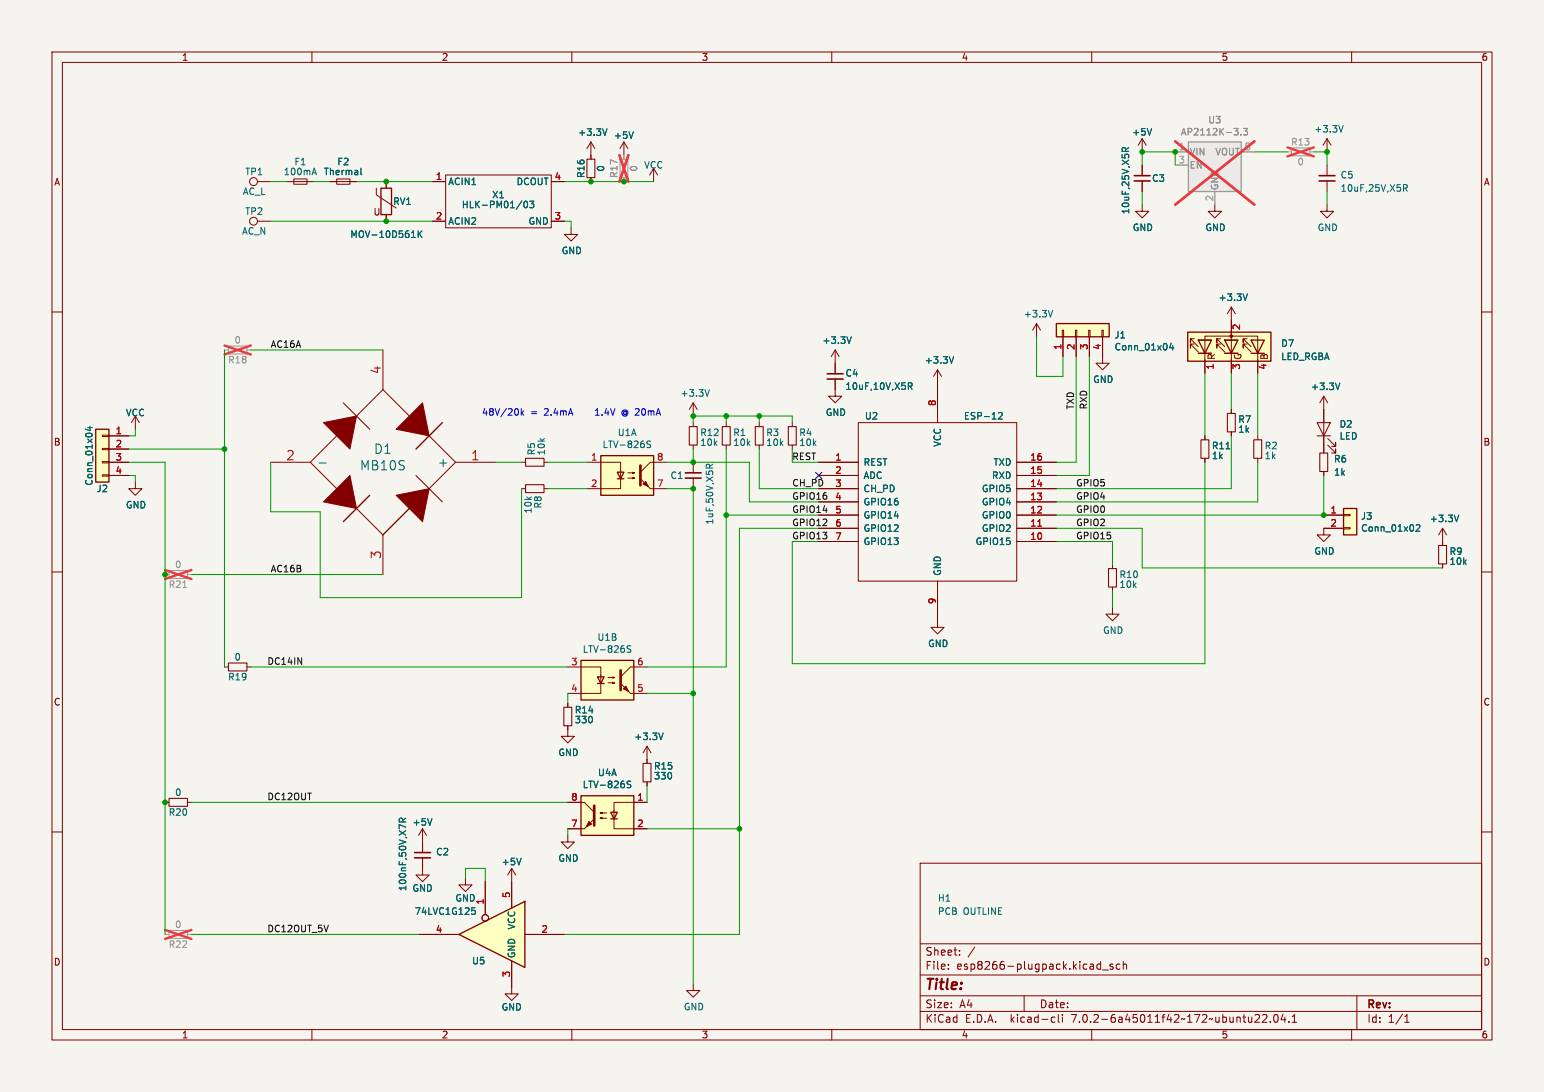
[picture p145: page 1]

Id: 1/1 Title: File: esp8266-plugpack.kicad_sch Sheet: /
