TomKeddie/prj-pcb-experiments/2024-clock-retrofit/kicad/2024-clock-retrofit.kicad_sch.pdf

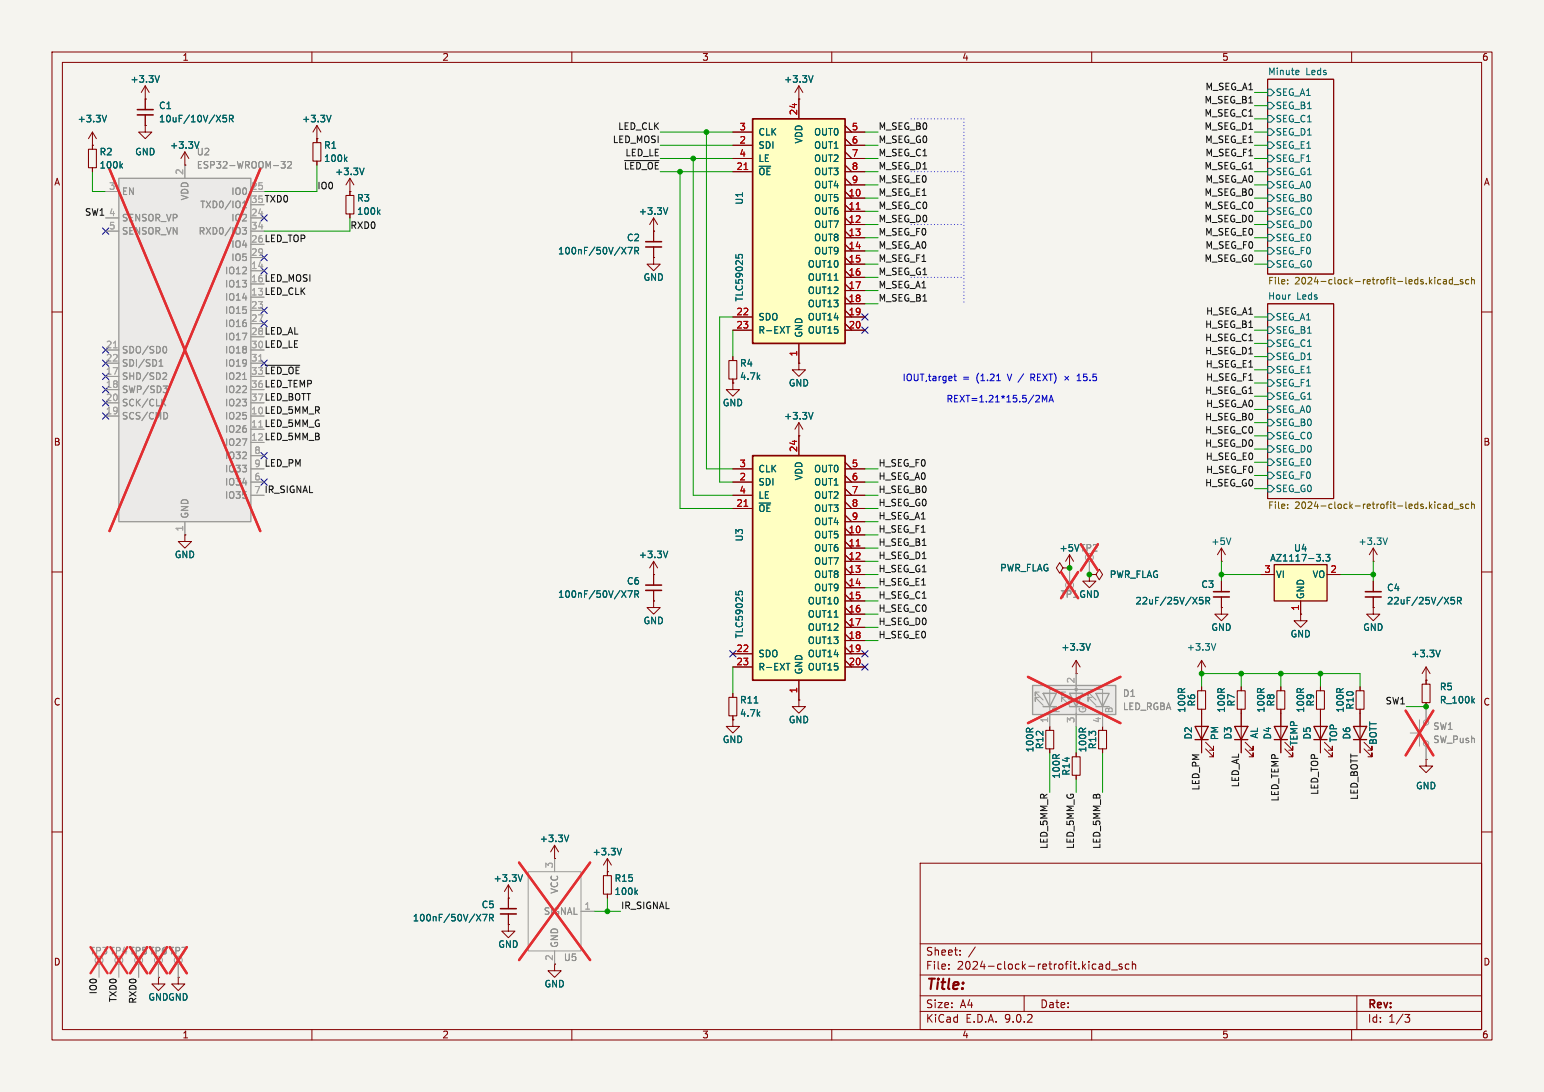
[picture p146: page 1]

SEG_B1 SEG_G1 SEG_A1 SEG_F1 SEG_G0 SEG_F0 SEG_A0 SEG_D1 SEG_E1 SEG_C1 SEG_B0 SEG_E0 SEG_D0 SEG_C0 Minute Leds File: 2024-clock-retrofit-leds.kicad_sch SEG_B1 SEG_G1 SEG_A1 SEG_F1 SEG_G0 SEG_F0 SEG_A0 SEG_D1 SEG_E1 SEG_C1 SEG_B0 SEG_E0 SEG_D0 SEG_C0 Hour Leds File: 2024-clock-retrofit-leds.kicad_sch R13 100R

Id: 1/3 Title: File: 2024-clock-retrofit.kicad_sch Sheet: /

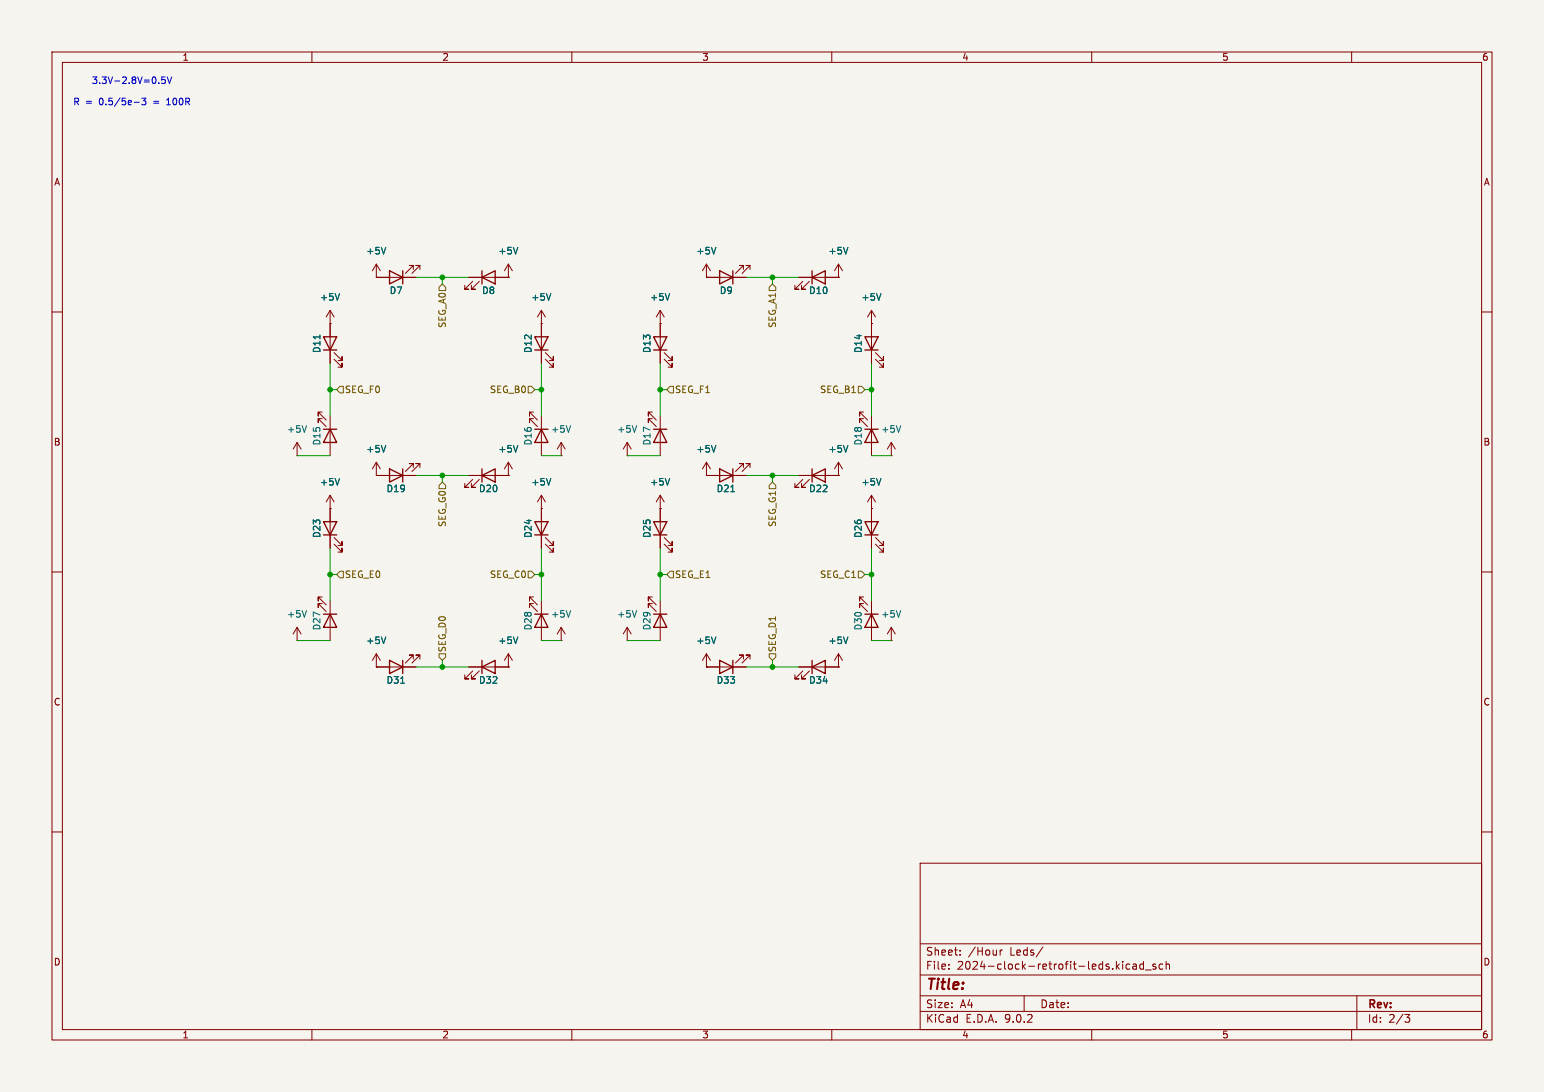
[picture p147: page 2]

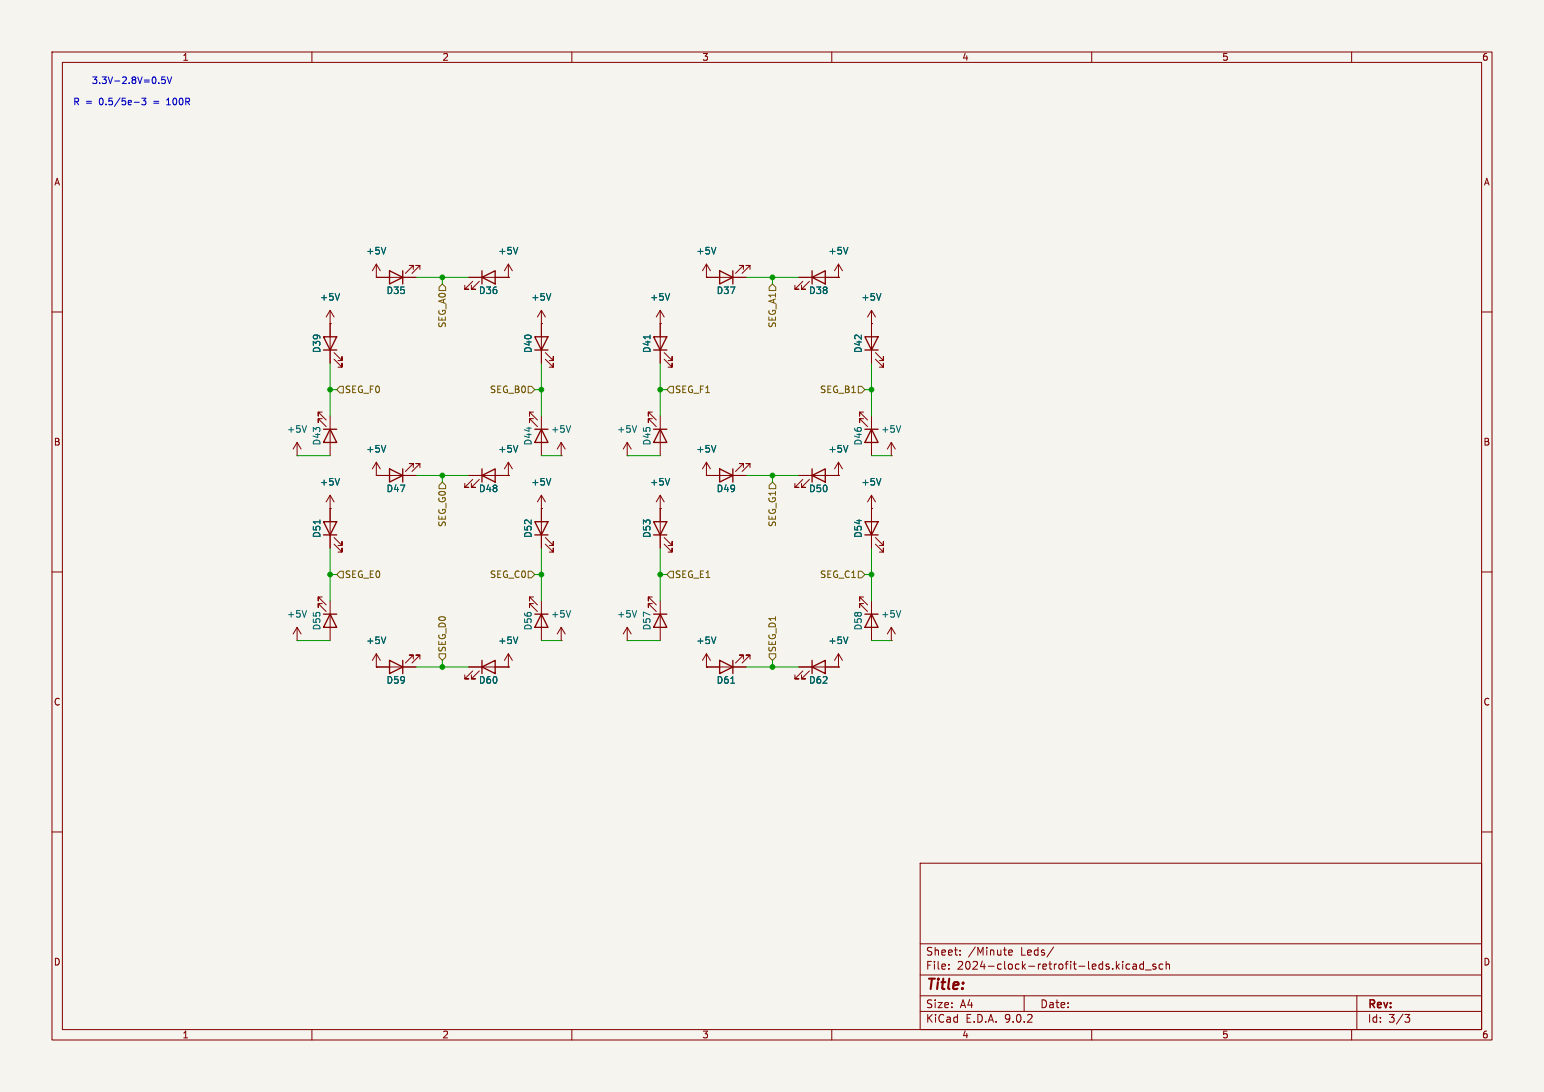
[picture p148: page 3]
