TomKeddie/prj-pcb-experiments/2025-flex-spiral/two/2025-flex-spiral-two.kicad_sch.pdf

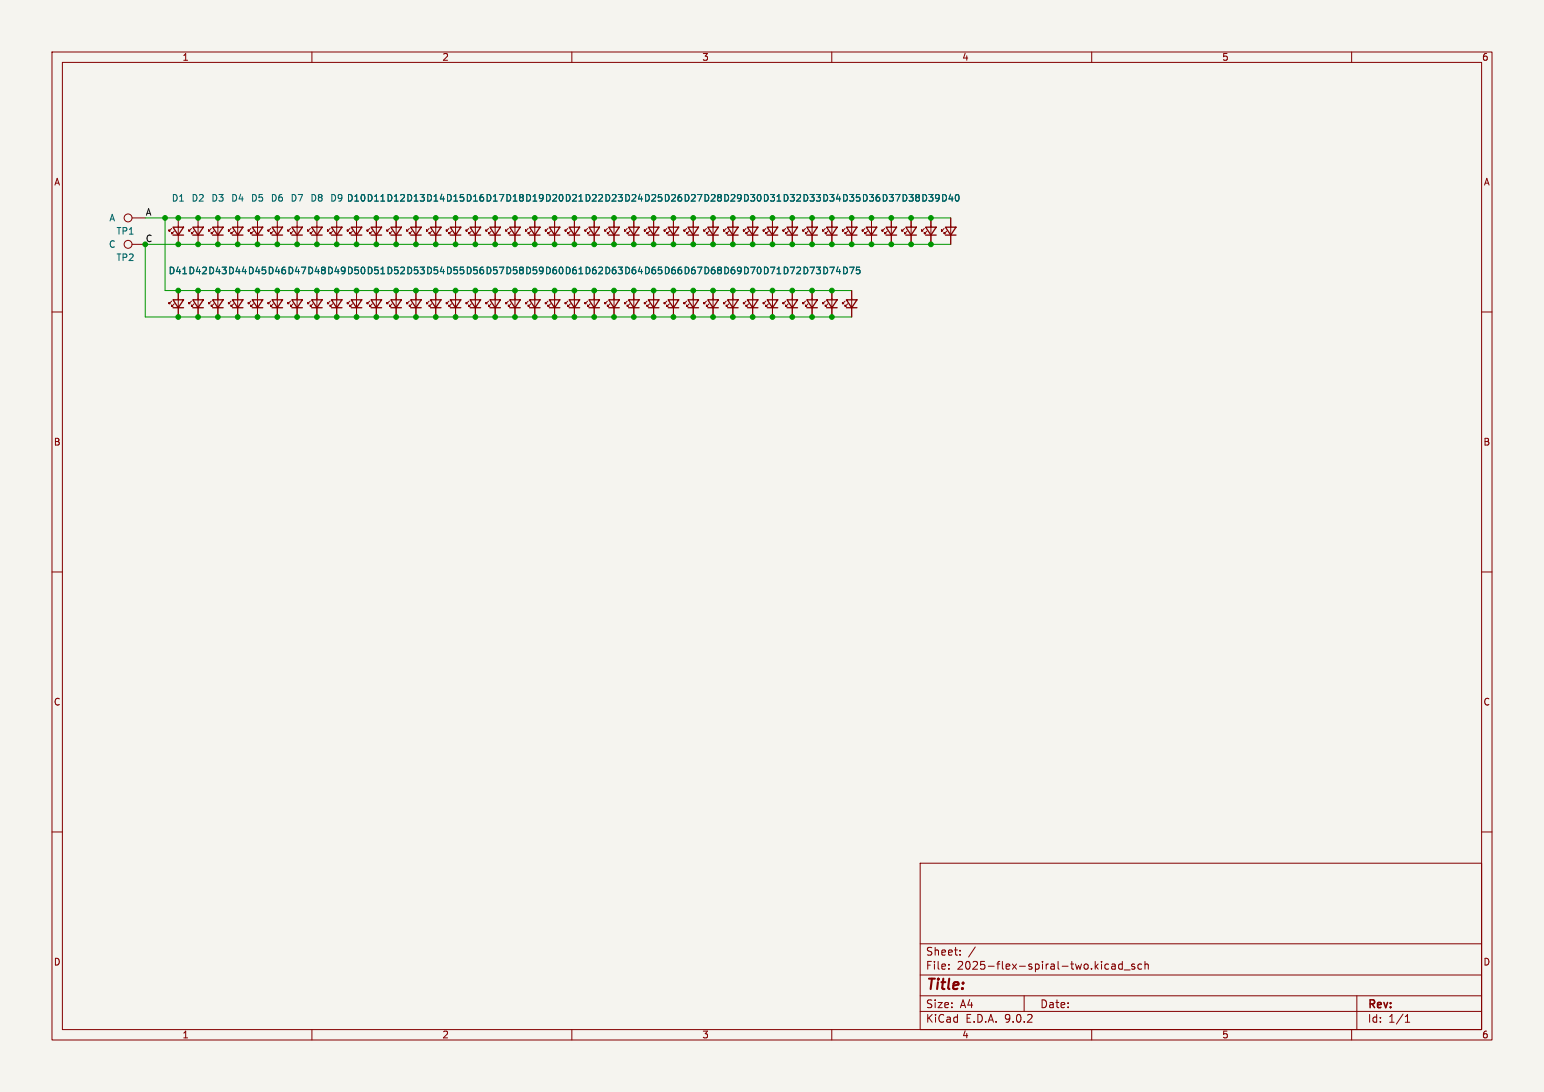
[picture p149: page 1]

Id: 1/1 Title: File: 2025-flex-spiral-two.kicad_sch Sheet: /
