TomKeddie/prj-pcb-experiments/2025-flex-spiral/one/2025-flex-spiral.kicad_sch.pdf

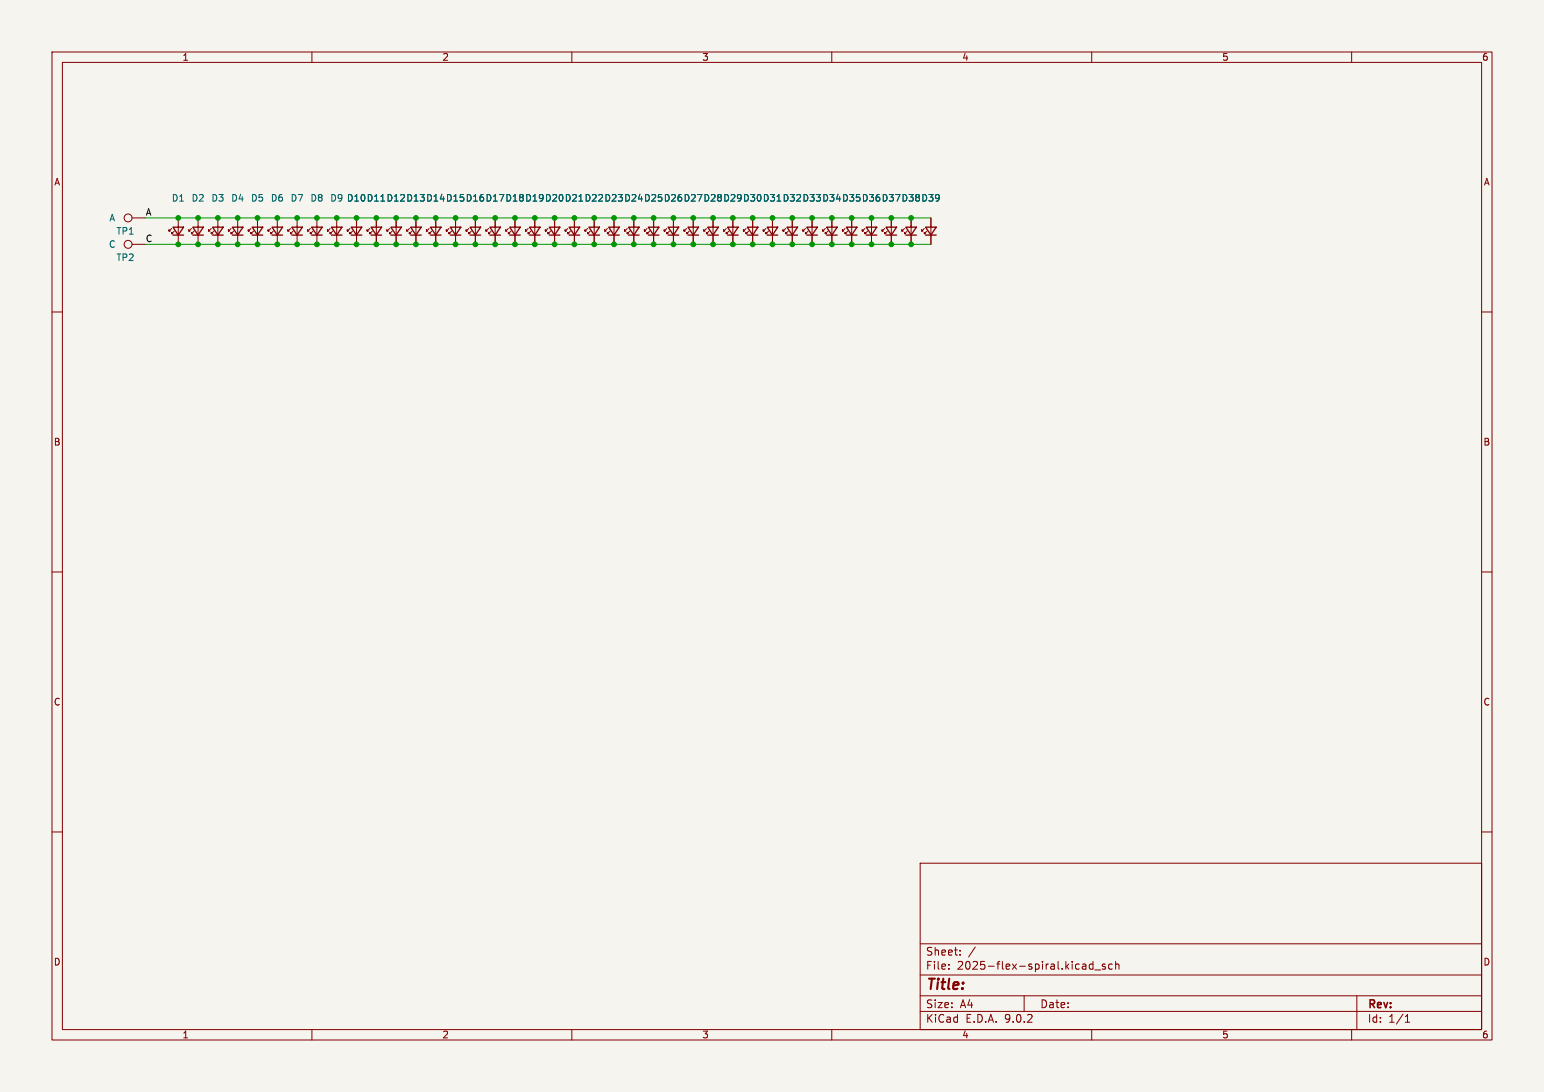
[picture p150: page 1]

Id: 1/1 Title: File: 2025-flex-spiral.kicad_sch Sheet: /
