TomKeddie/prj-pcb-experiments/2024-led-ctrl-24v/kicad/led-ctrl-24v.kicad_sch.pdf

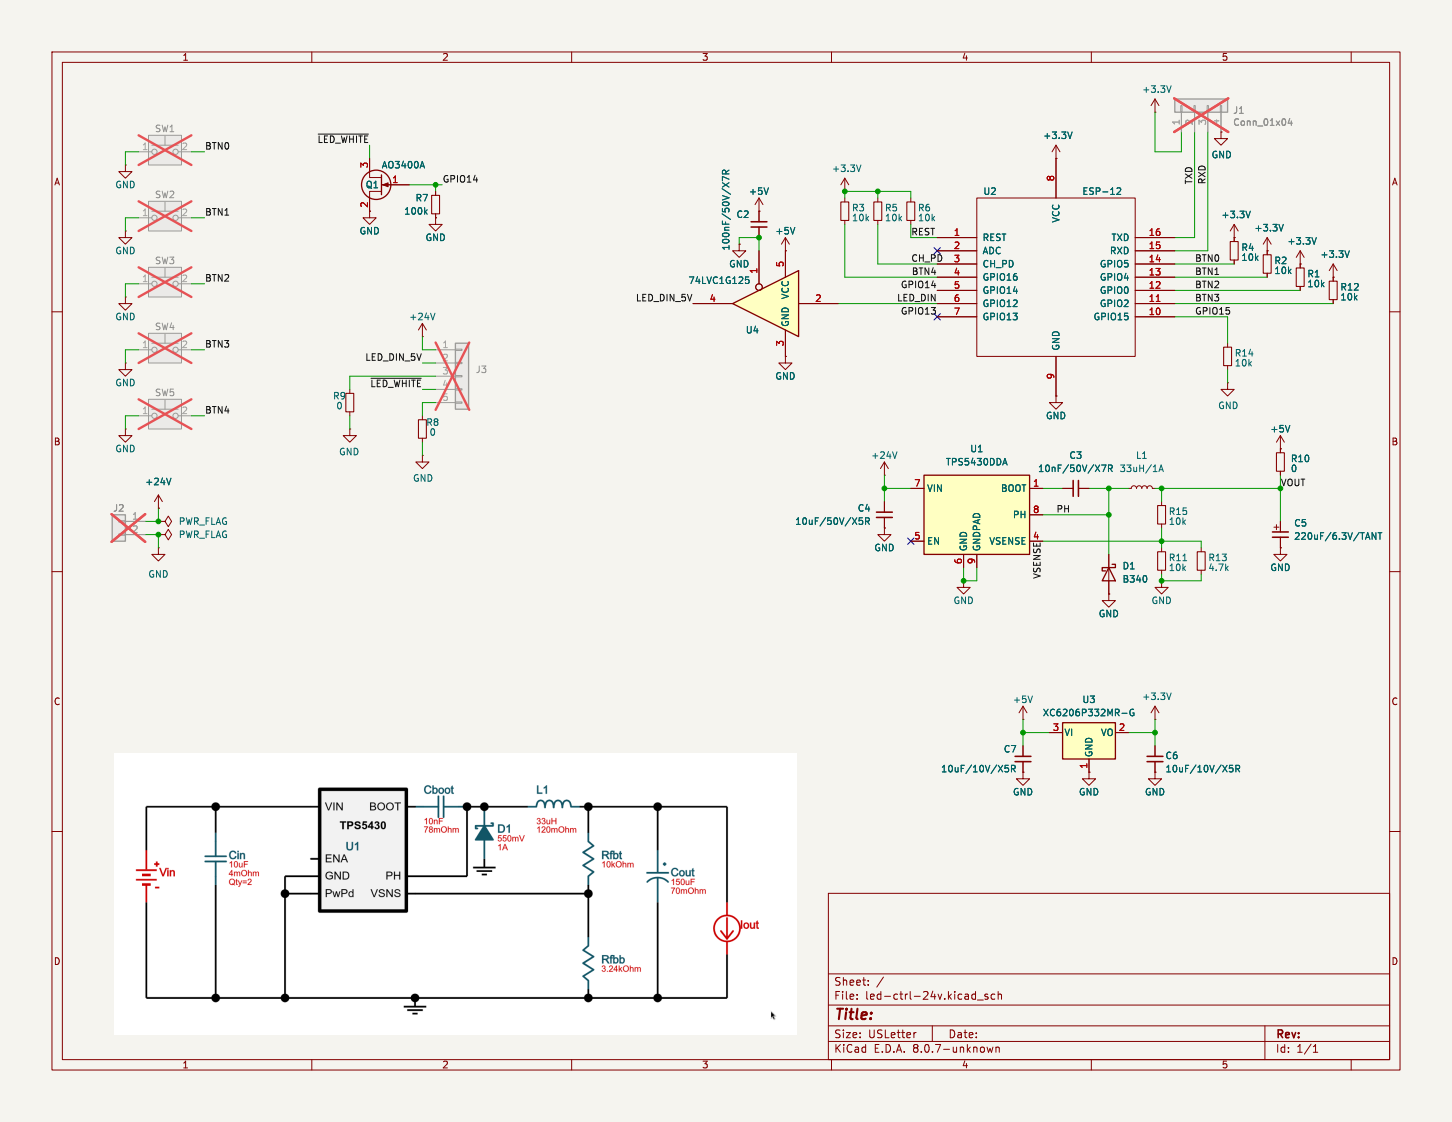
[picture p151: page 1]

1 VO 2 VI 3 GND GND

Id: 1/1 Title: File: led-ctrl-24v.kicad_sch Sheet: /
