TomKeddie/prj-pcb-experiments/2025-usb-pd-plank/kicad/usb-pd-plank.kicad_sch.pdf

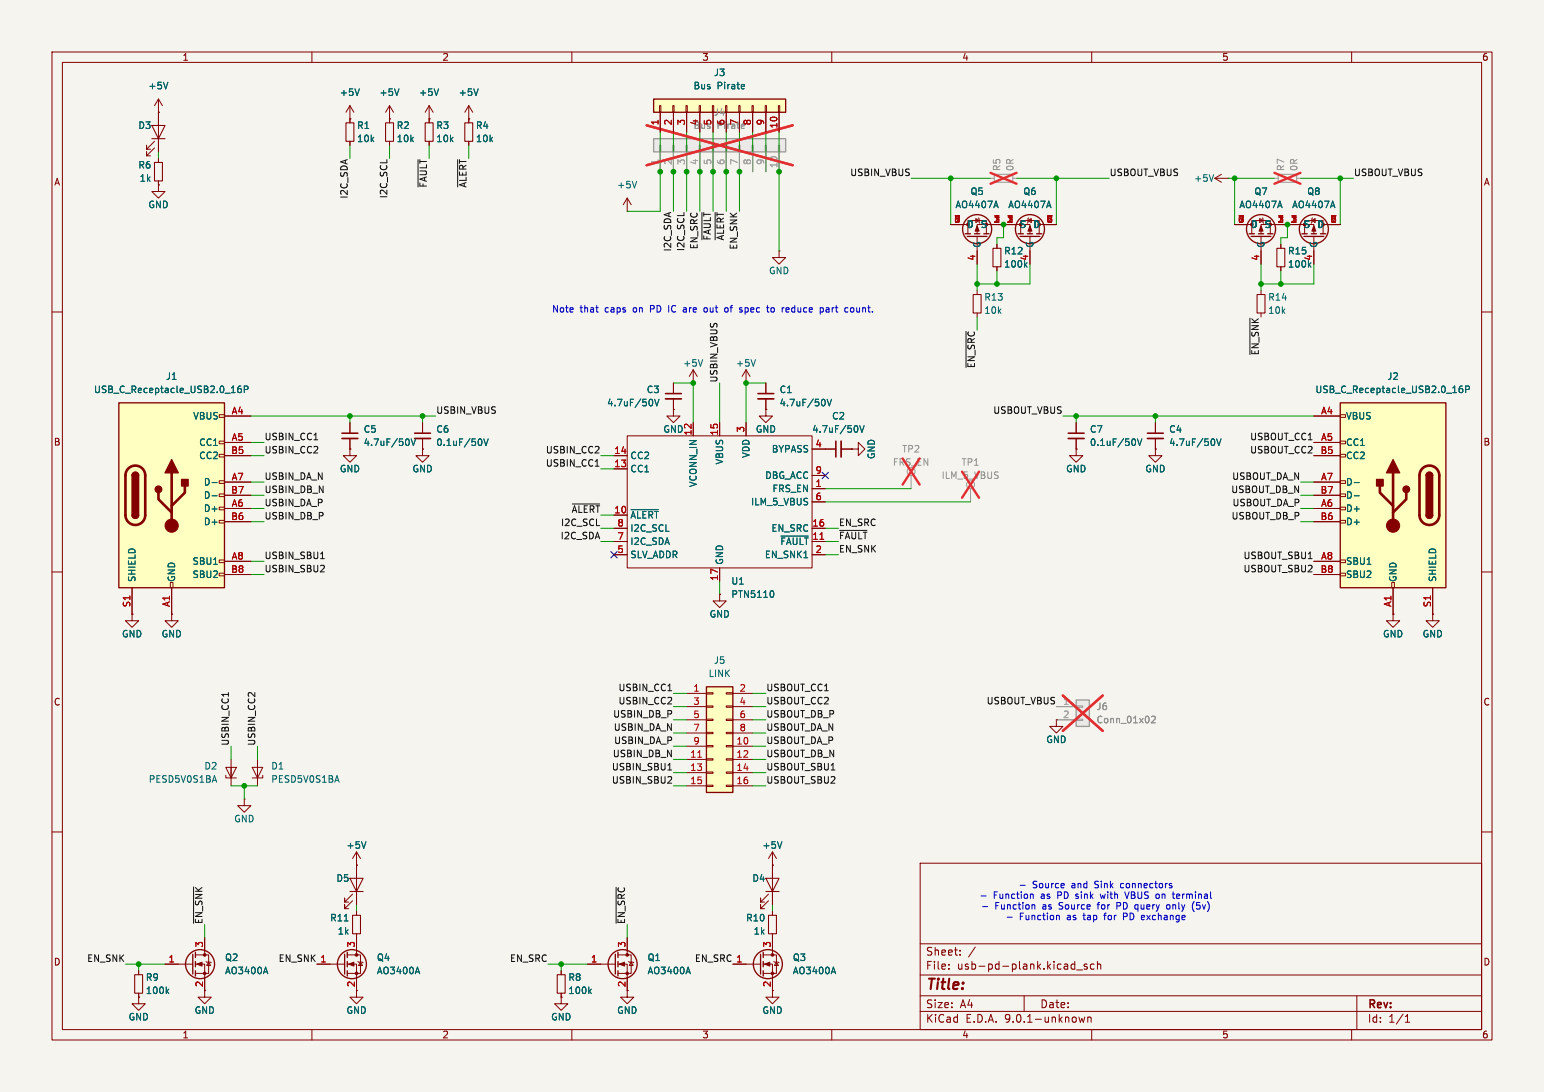
[picture p152: page 1]

- Source and Sink connectors

Id: 1/1 Title: File: usb-pd-plank.kicad_sch Sheet: /
