TomKeddie/prj-pcb-experiments/2024-supercon-sign-sao/kicad/2024-supercon-sign-sao.kicad_sch.pdf

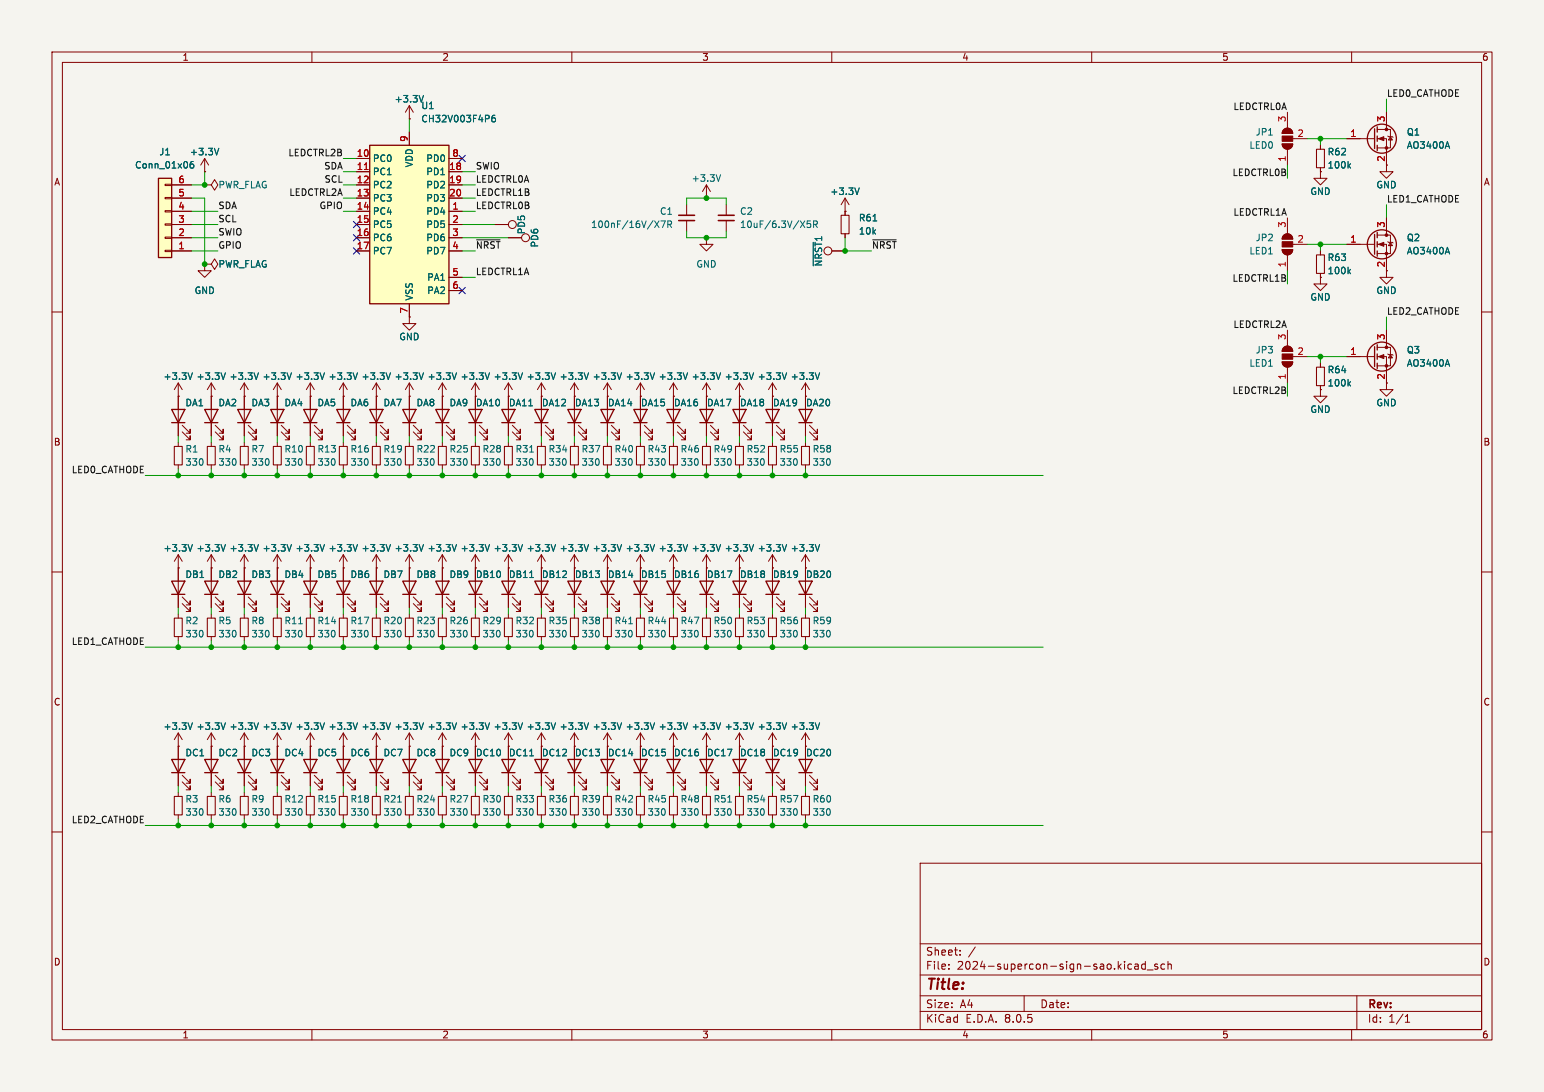
[picture p153: page 1]

Id: 1/1 Title: File: 2024-supercon-sign-sao.kicad_sch Sheet: / R35
