TomKeddie/prj-pcb-experiments/skull-roses/roses/roses.kicad_sch.pdf

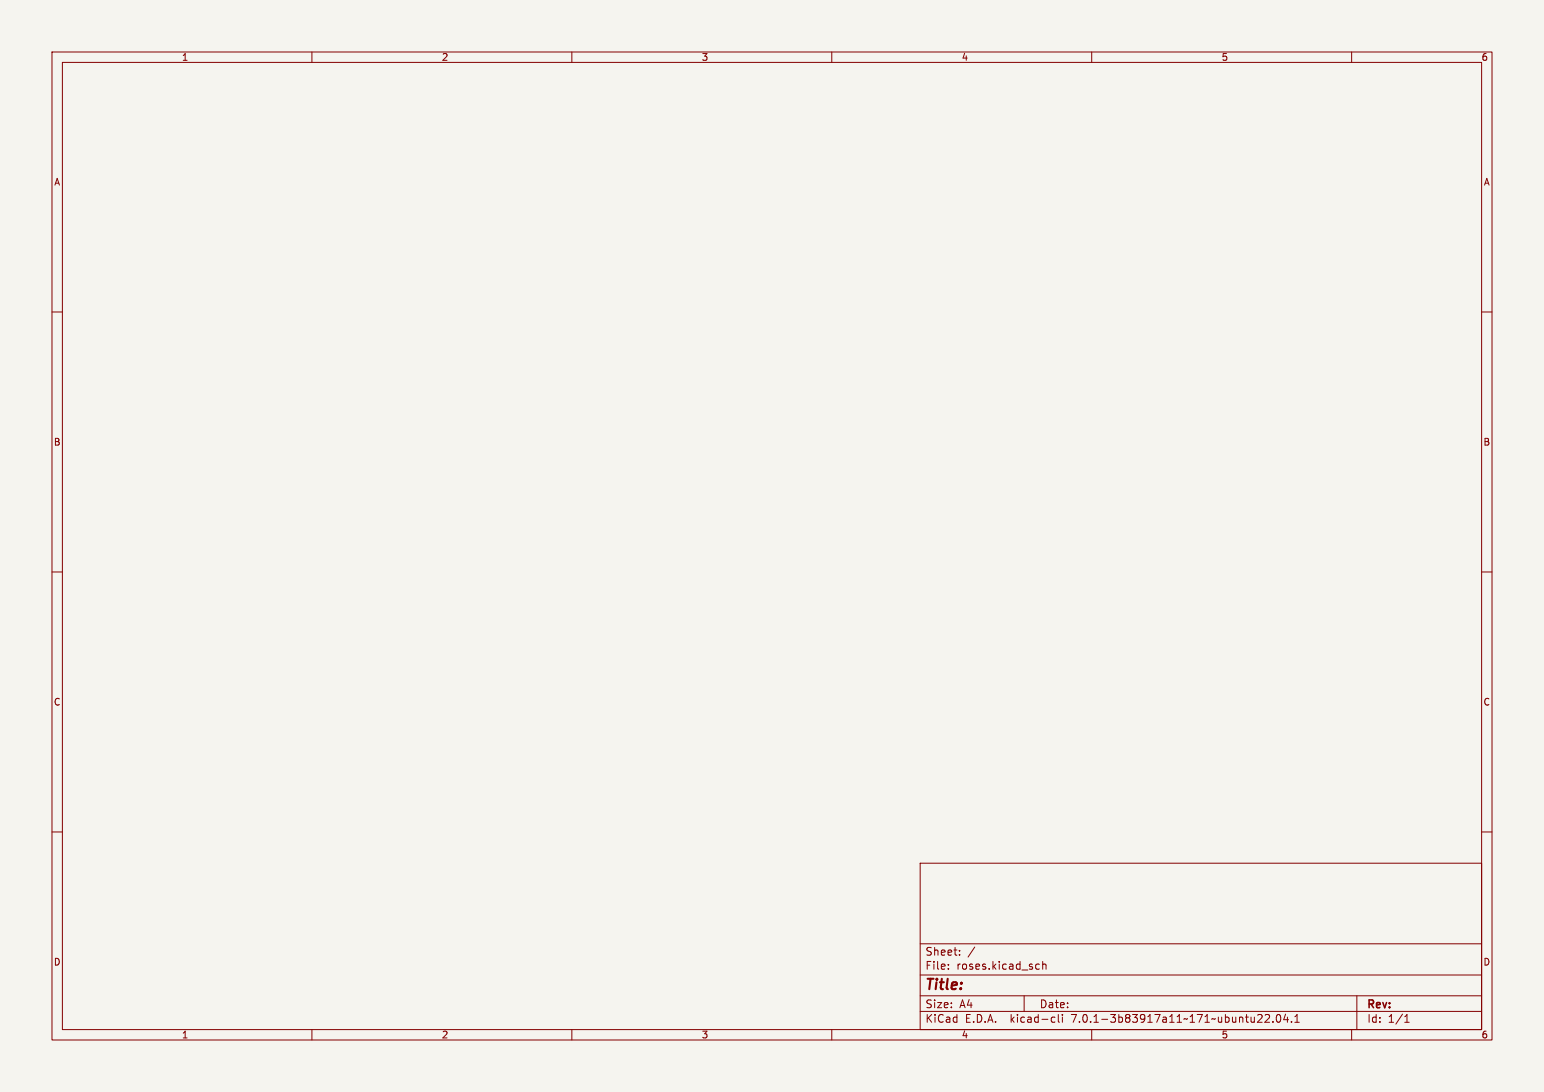
[picture p154: page 1]

Id: 1/1 Title: File: roses.kicad_sch Sheet: /
