TomKeddie/prj-pcb-experiments/skull-roses/skull/skull.kicad_sch.pdf

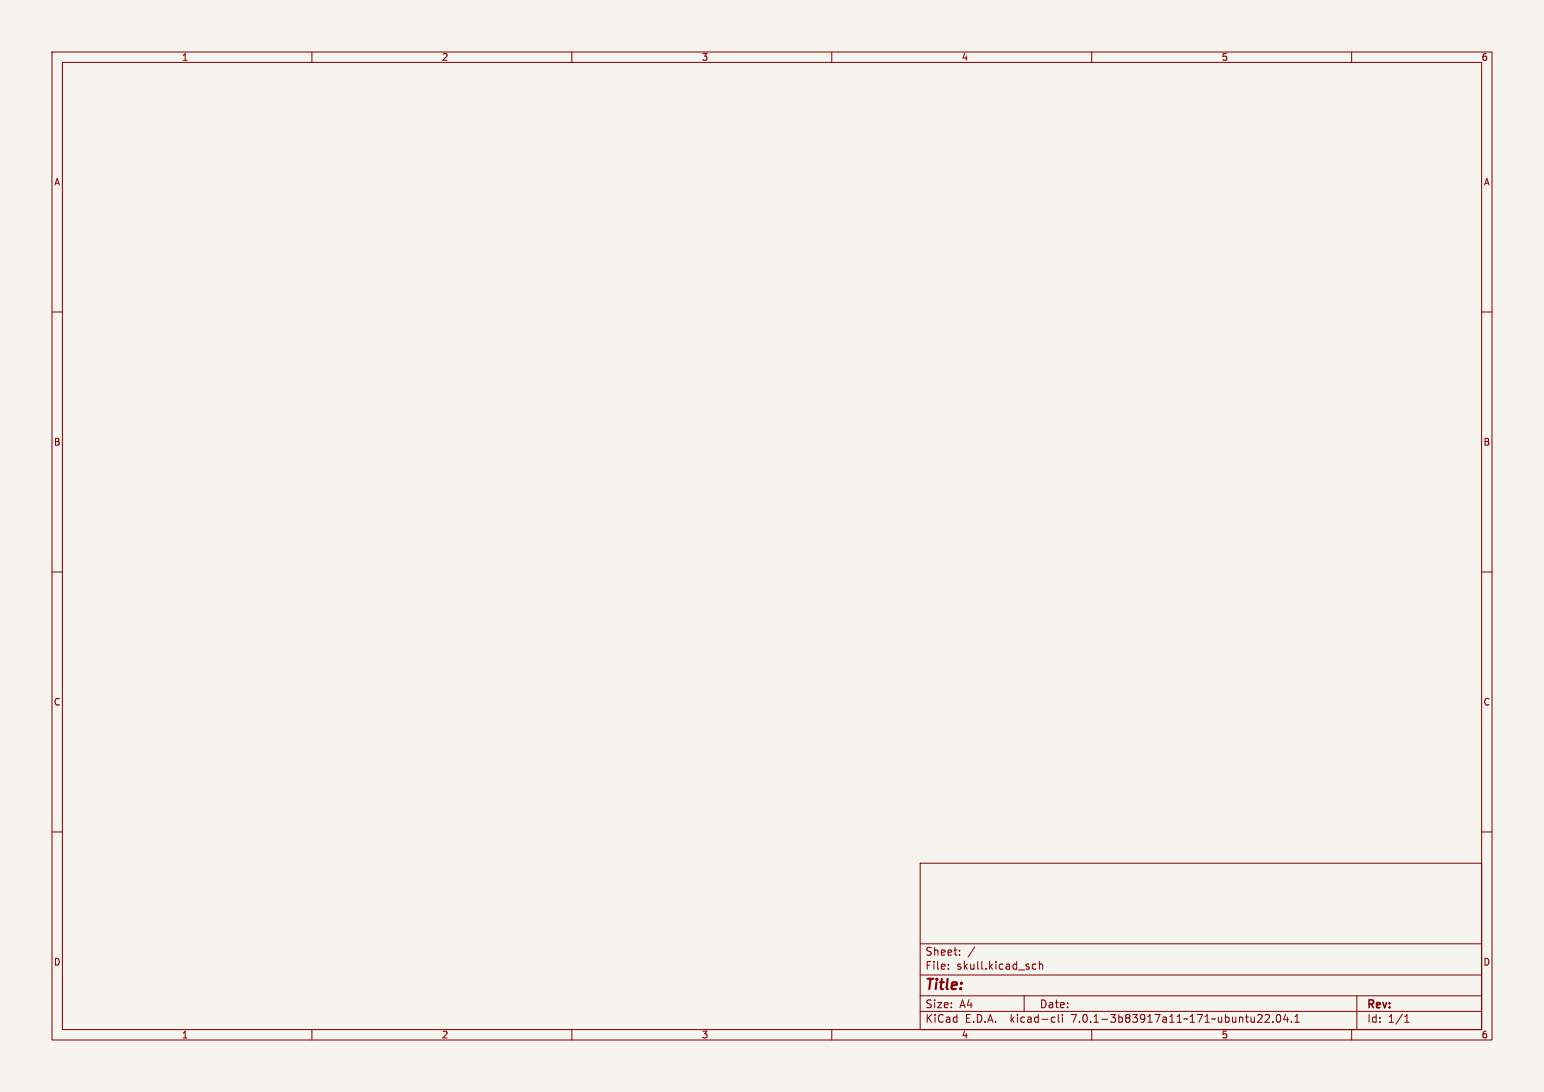
[picture p155: page 1]

Id: 1/1 Title: File: skull.kicad_sch Sheet: /
