TomKeddie/prj-pcb-experiments/esp8266-wiz550io/doc/esp8266-wiz550io-sch-Feb2021.pdf

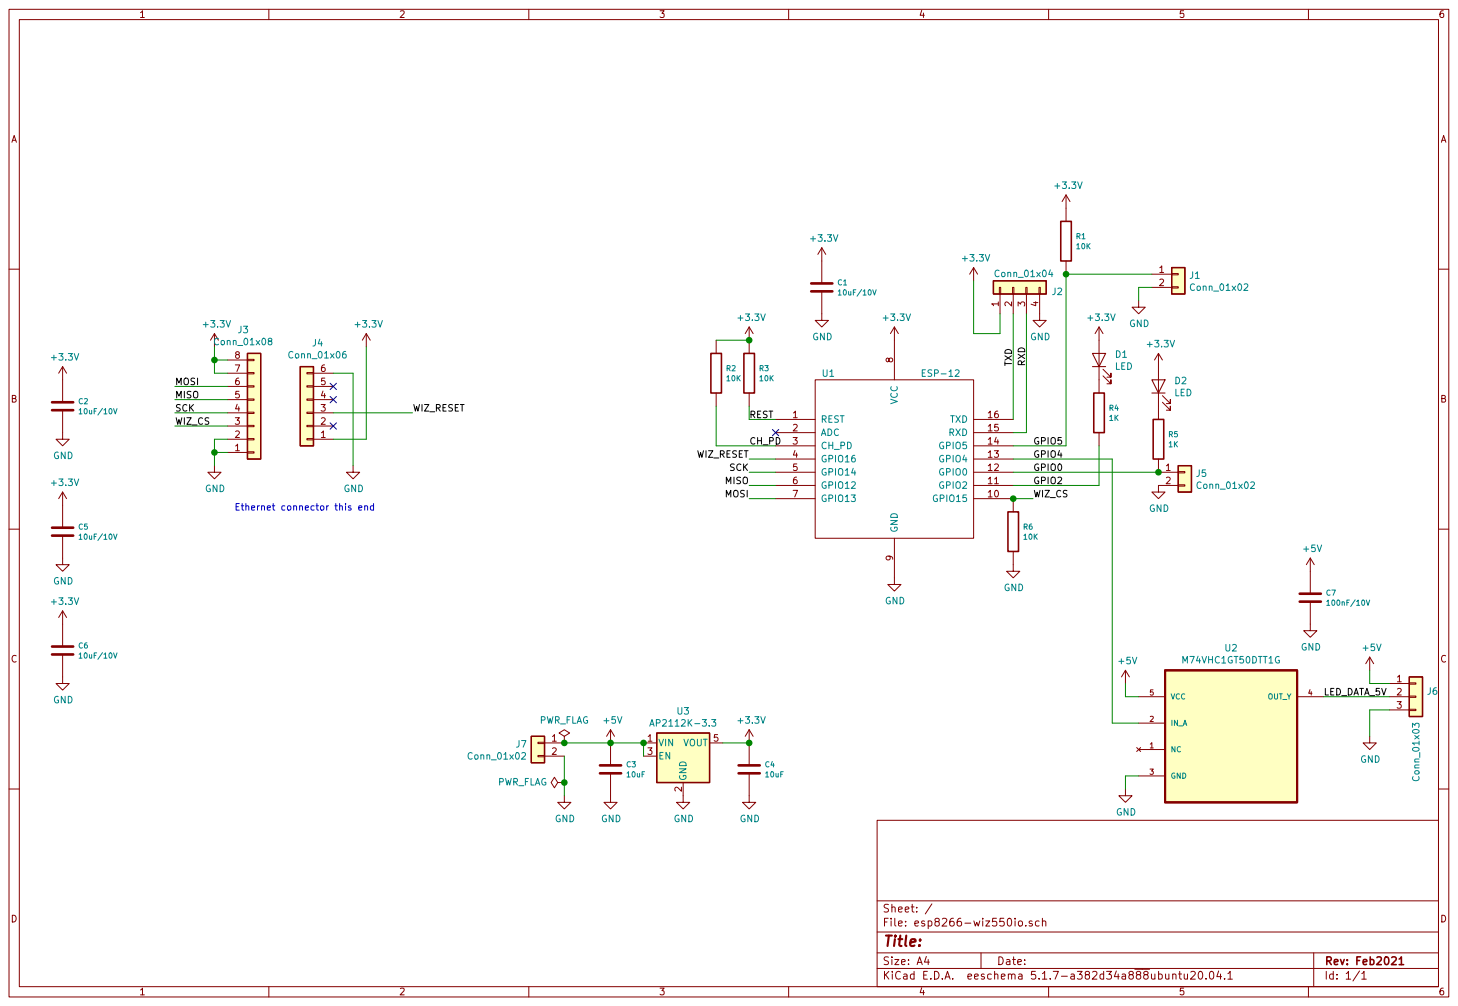
[picture p156: page 1]

Ethernet connector this end
