TomKeddie/prj-pcb-experiments/2025-pmod-sma/2025-pmod-sma.kicad_pcb.mechanical.pdf

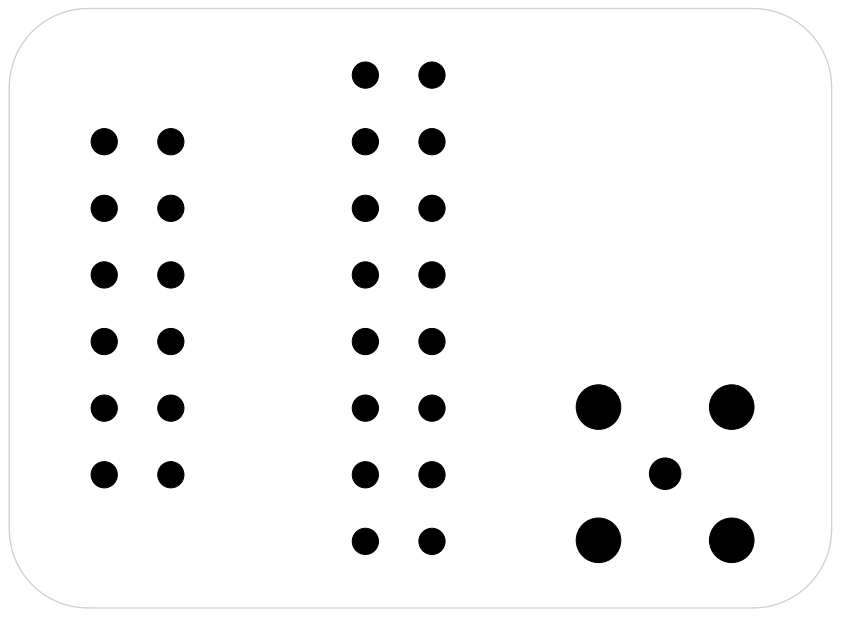
[picture p158: page 1]
