TomKeddie/prj-pcb-experiments/2024-syzygy-dsi/hardware/syzygy-dsi.kicad_pcb.mechanical.pdf

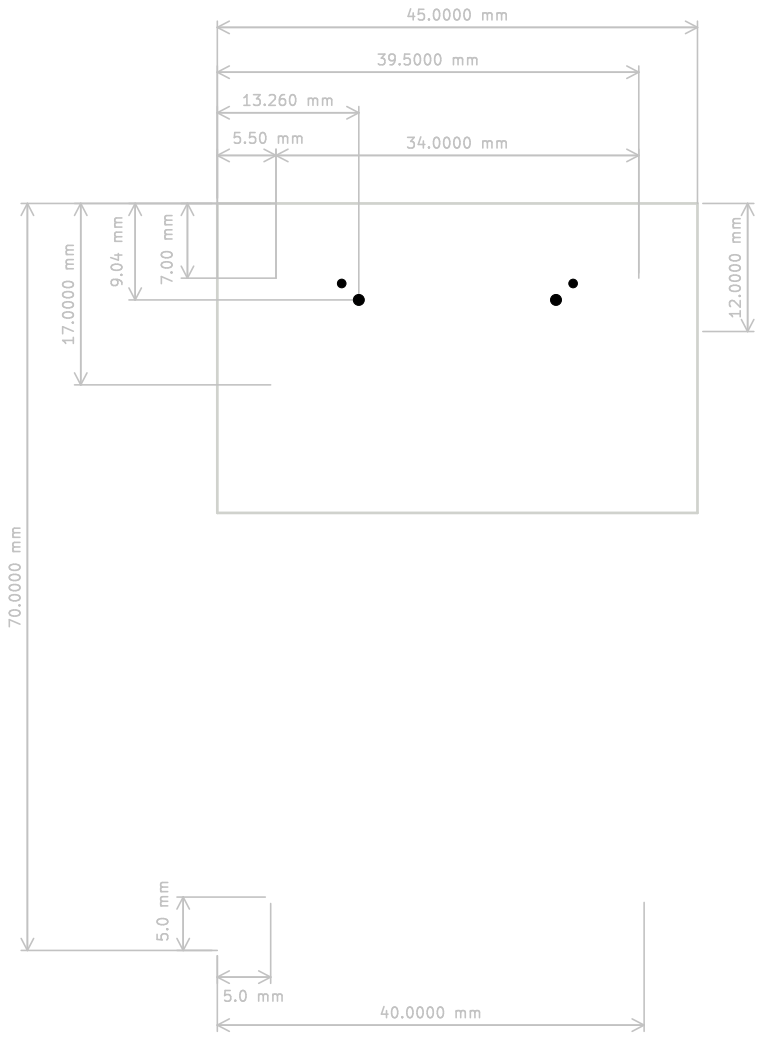
[picture p159: page 1]

Id: 1/1 Title: SZG-TEMPLATE-STD
