TomKeddie/prj-pcb-experiments/blue-pill-bmp/hardware/doc/blue-pill-bmp-back-.pdf

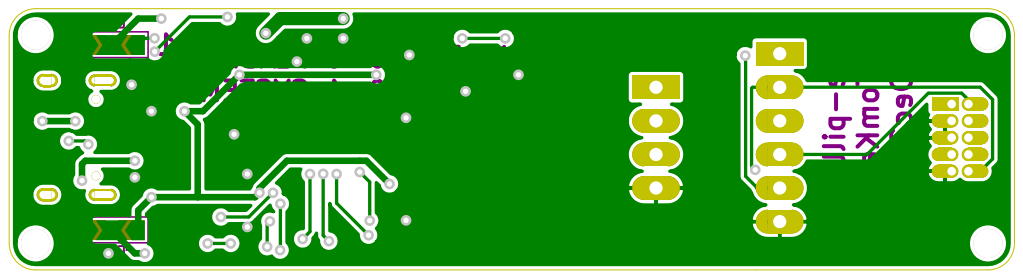
[picture p160: page 1]
