TomKeddie/prj-pcb-experiments/blue-pill-bmp/hardware/doc/blue-pill-bmp-front-.pdf

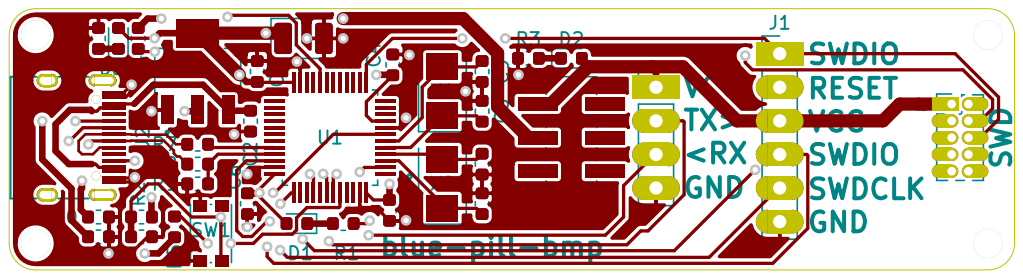
[picture p161: page 1]
