TomKeddie/prj-pcb-experiments/2025-pmod-sma/2025-pmod-sma.kicad_sch.pdf

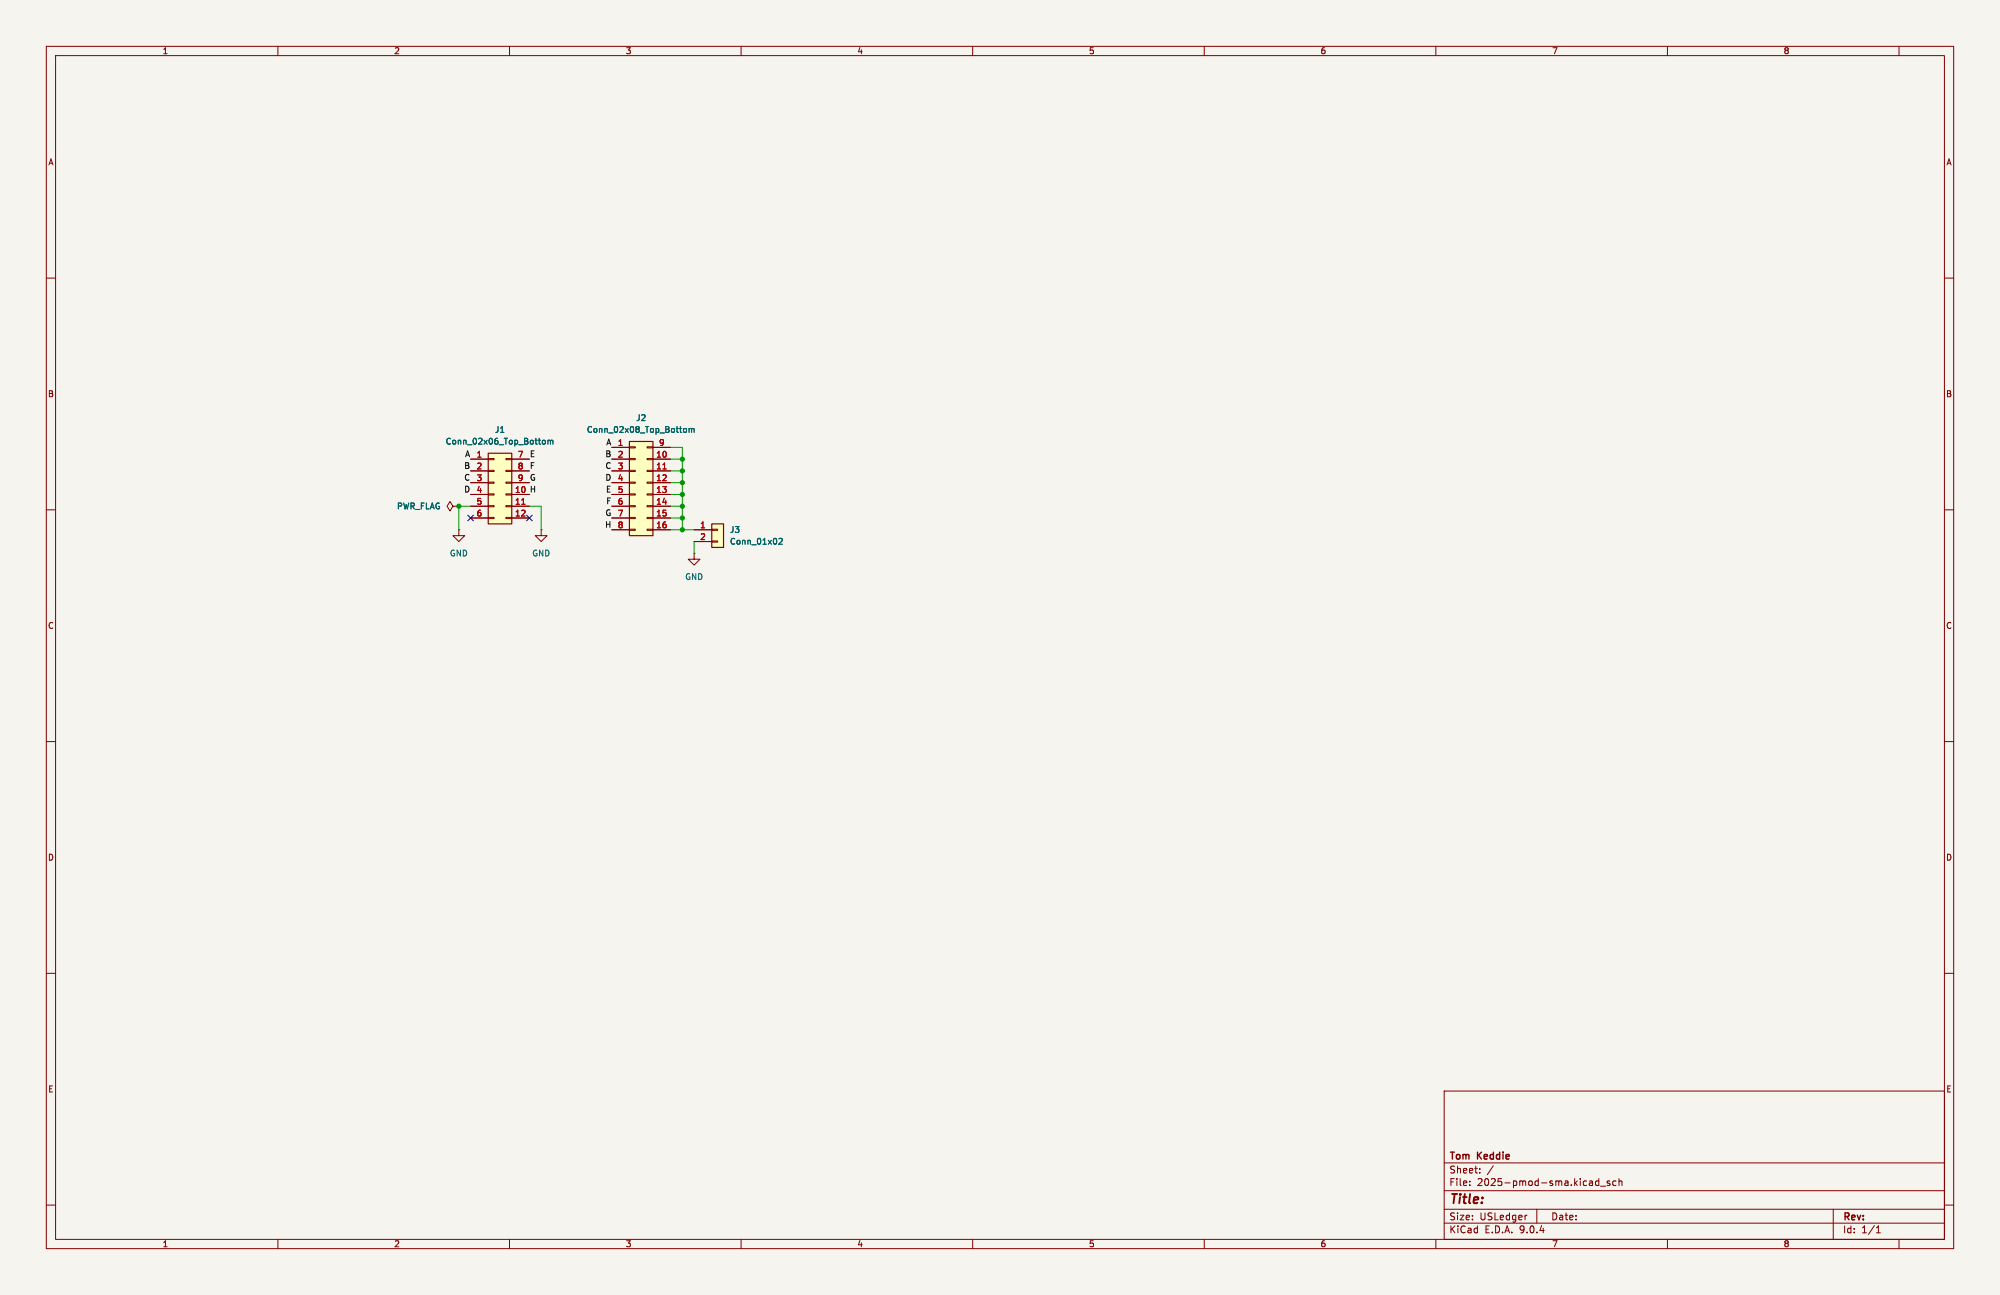
[picture p163: page 1]
