TomKeddie/prj-pcb-experiments/esp8266-wiz550io/doc/esp8266-wiz550io-back-Feb2021.pdf

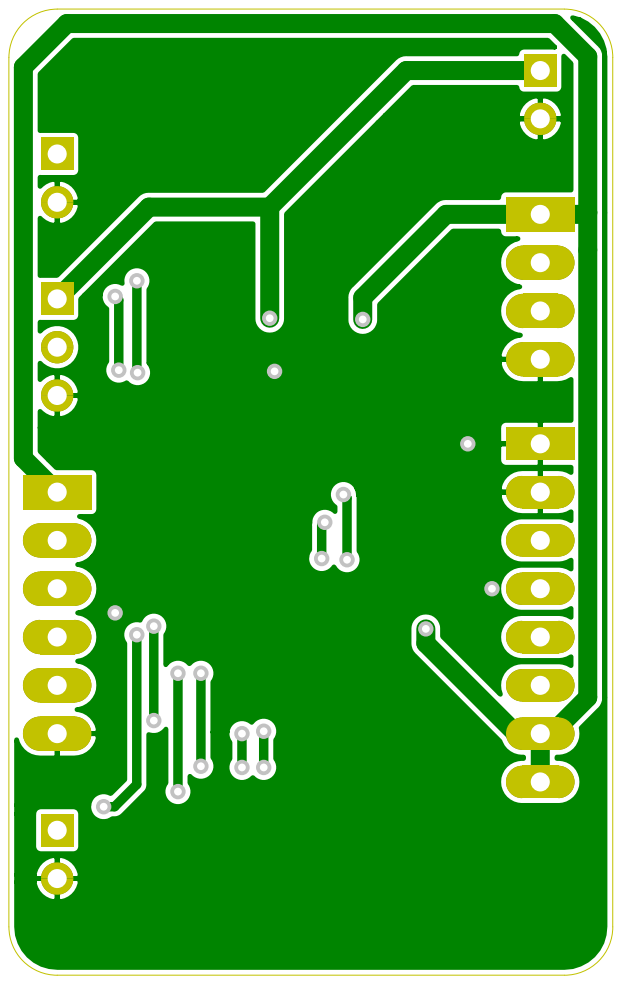
[picture p164: page 1]
