TomKeddie/prj-pcb-experiments/esp8266-wiz550io/doc/esp8266-wiz550io-front-Feb2021.pdf

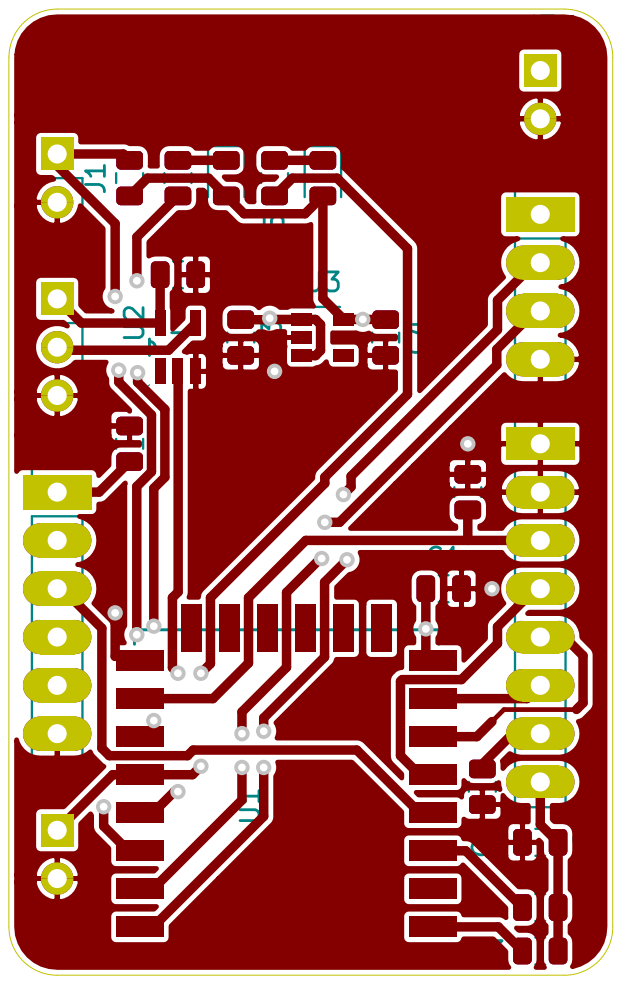
[picture p165: page 1]
