TomKeddie/prj-pcb-experiments/galep4-plcc-28/doc/galep4-plcc-28-back-.pdf

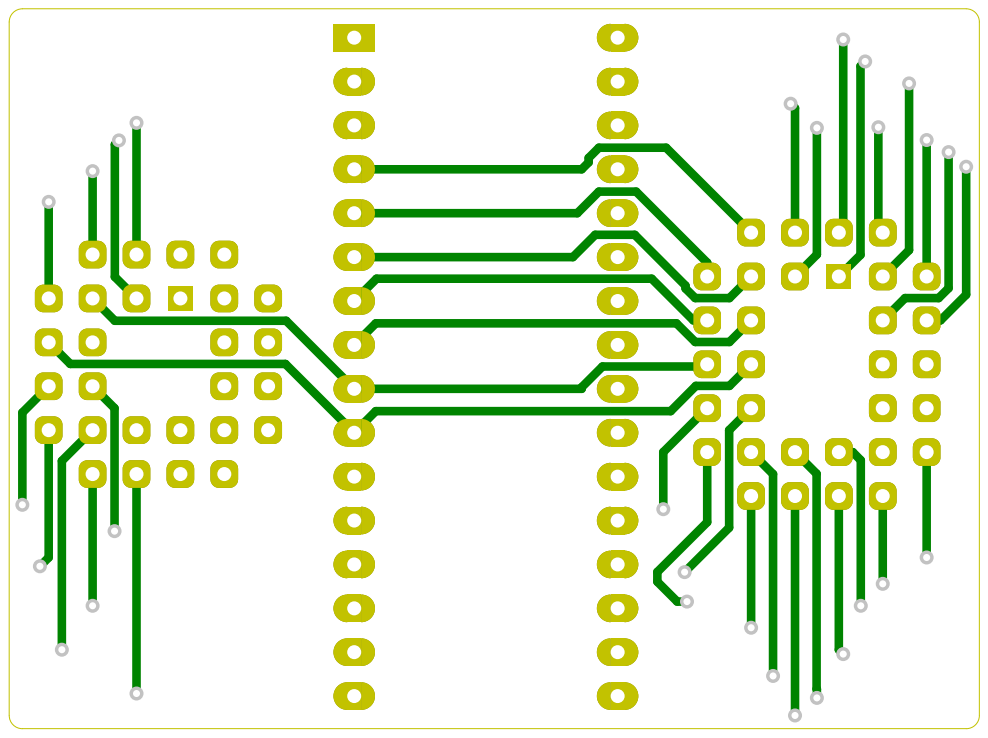
[picture p166: page 1]
