TomKeddie/prj-pcb-experiments/galep4-plcc-28/doc/galep4-plcc-28-front-.pdf

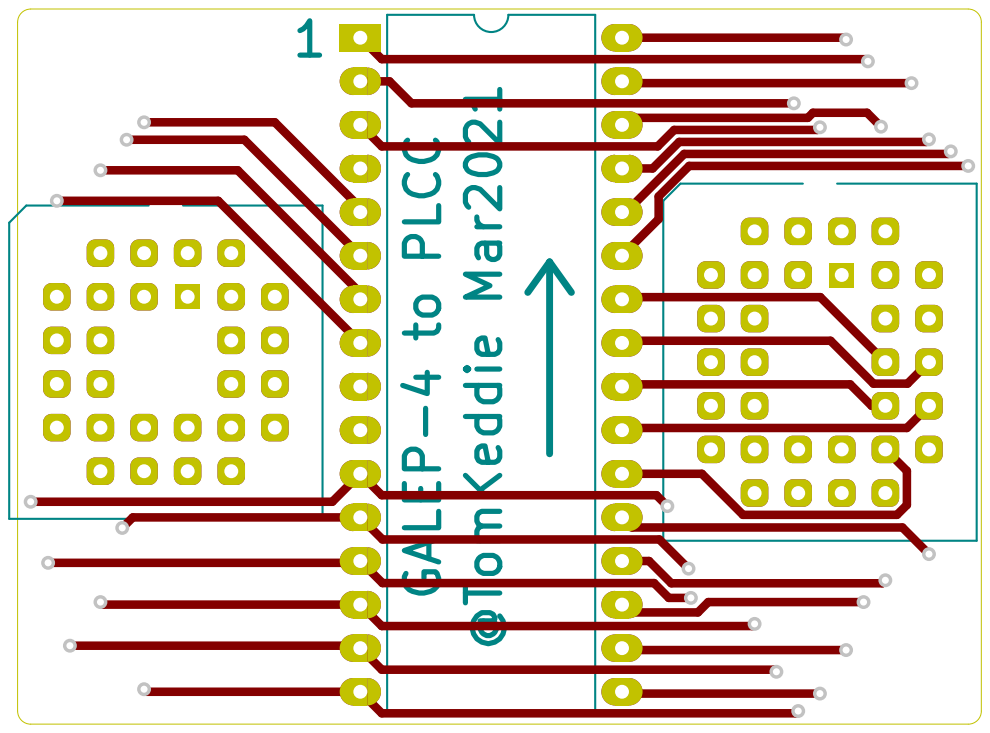
[picture p167: page 1]
