TomKeddie/prj-pcb-experiments/galep4-plcc-28/doc/galep4-plcc-28-front-Mar2021.pdf

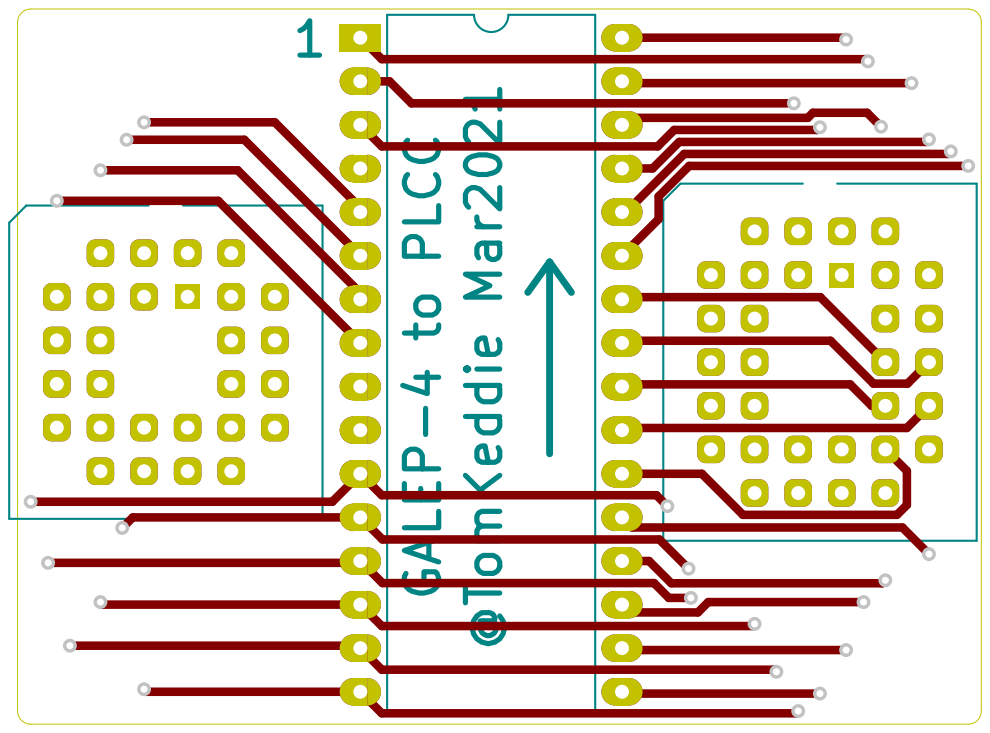
[picture p168: page 1]
