TomKeddie/prj-pcb-experiments/galep4-plcc-28/doc/galep4-plcc-28-sch-.pdf

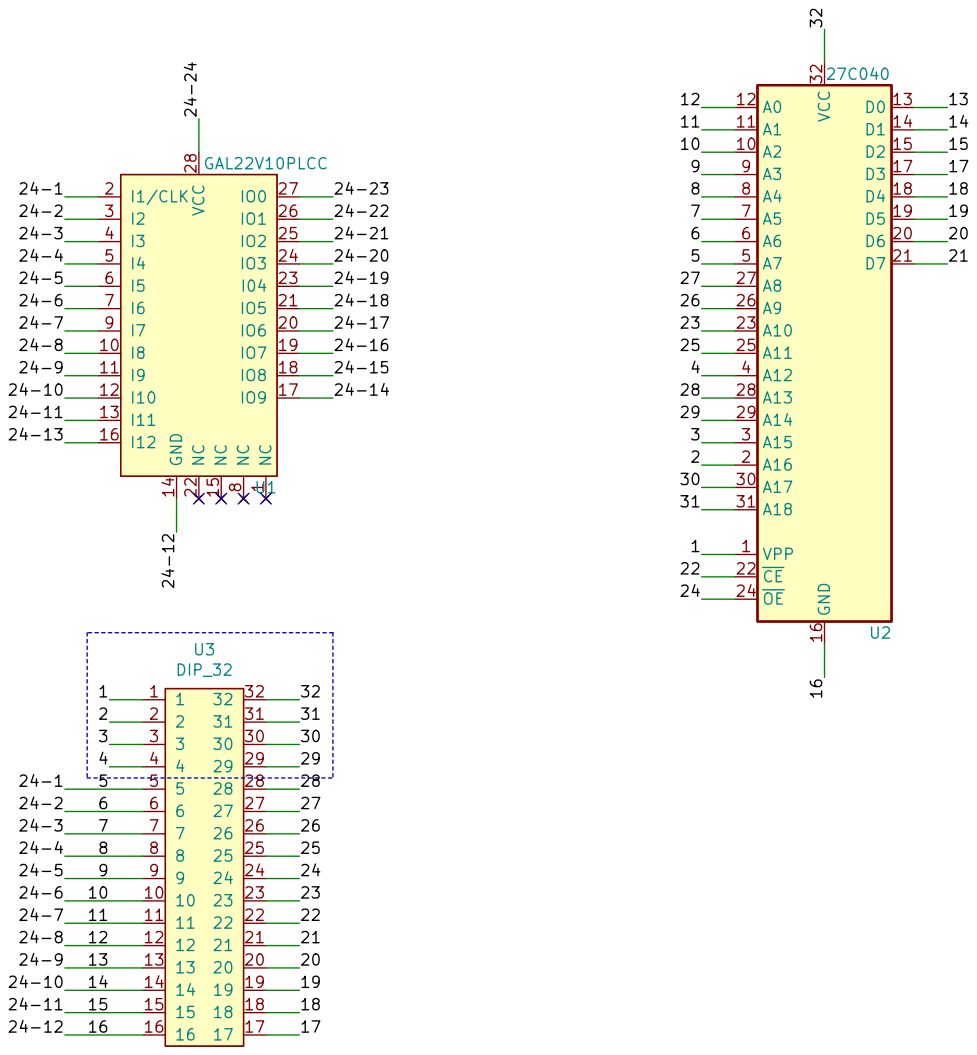
[picture p169: page 1]
