TomKeddie/prj-pcb-experiments/ft4232h-breakout/v2.x/doc/ft4232h-breakout-sch-Jun2021b.pdf

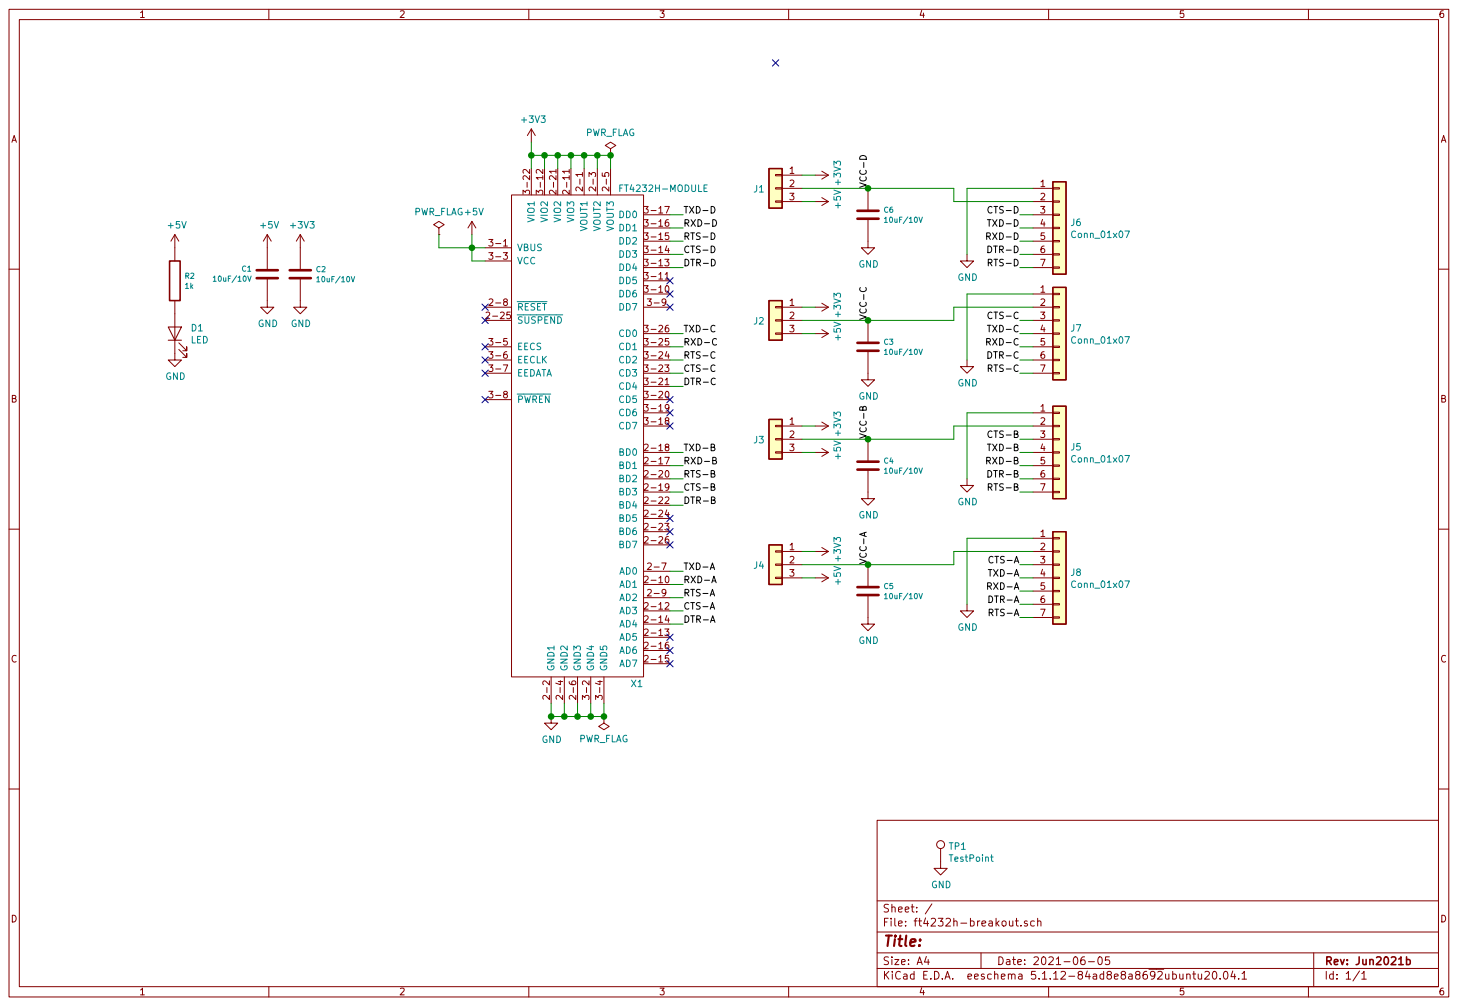
[picture p170: page 1]

Id: 1/1 Title: File: ft4232h-breakout.sch Sheet: / GND +5V +3V3 123
J6Conn_01x07 1234567

TXD-A CTS-B RTS-B RXD-B
