TomKeddie/prj-pcb-experiments/ft4232h-breakout/v2.x/doc/ft4232h-breakout-back-Jun2021b.pdf

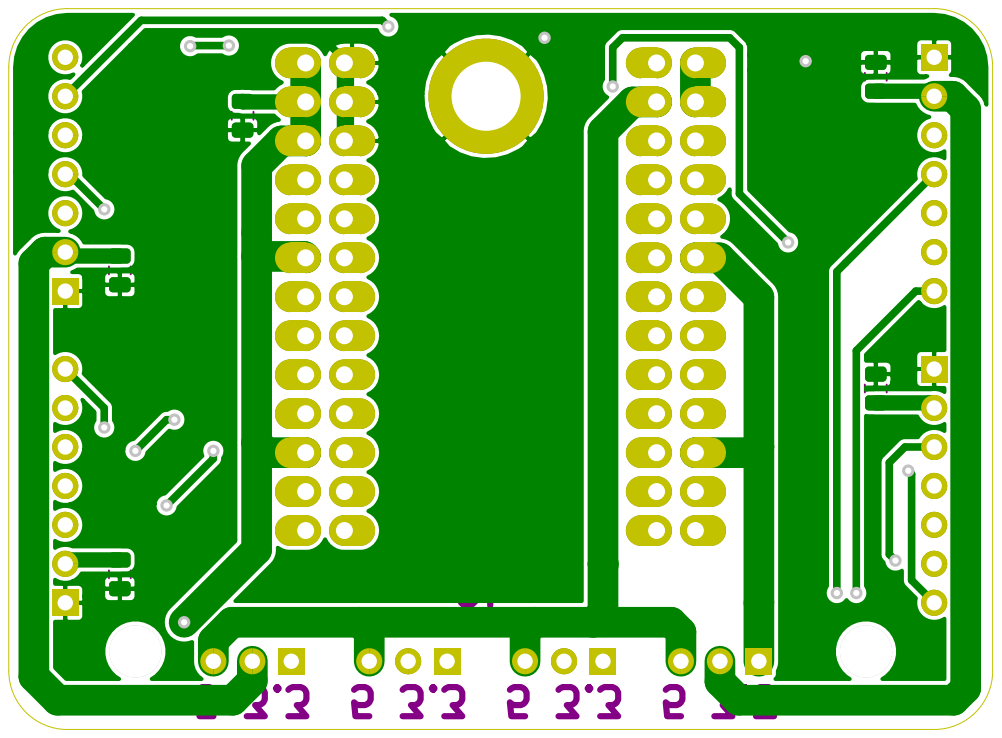
[picture p171: page 1]
