TomKeddie/prj-pcb-experiments/ft4232h-breakout/v2.x/doc/ft4232h-breakout-front-Jun2021b.pdf

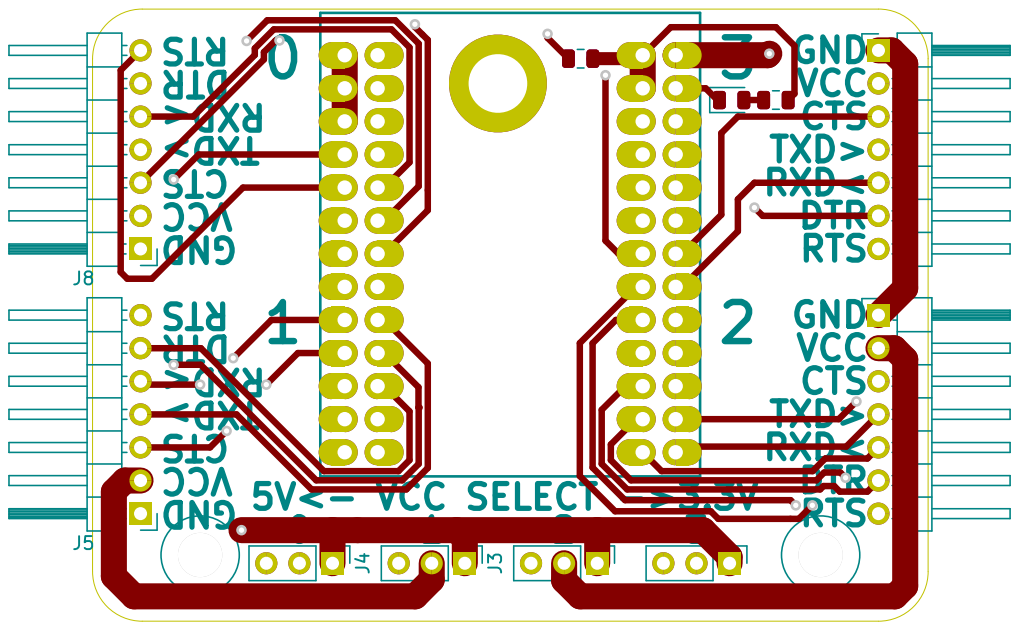
[picture p172: page 1]
