TomKeddie/prj-pcb-experiments/ft4232h-breakout/v1.x/doc/ft4232h-breakout-back-Jun2021b.pdf

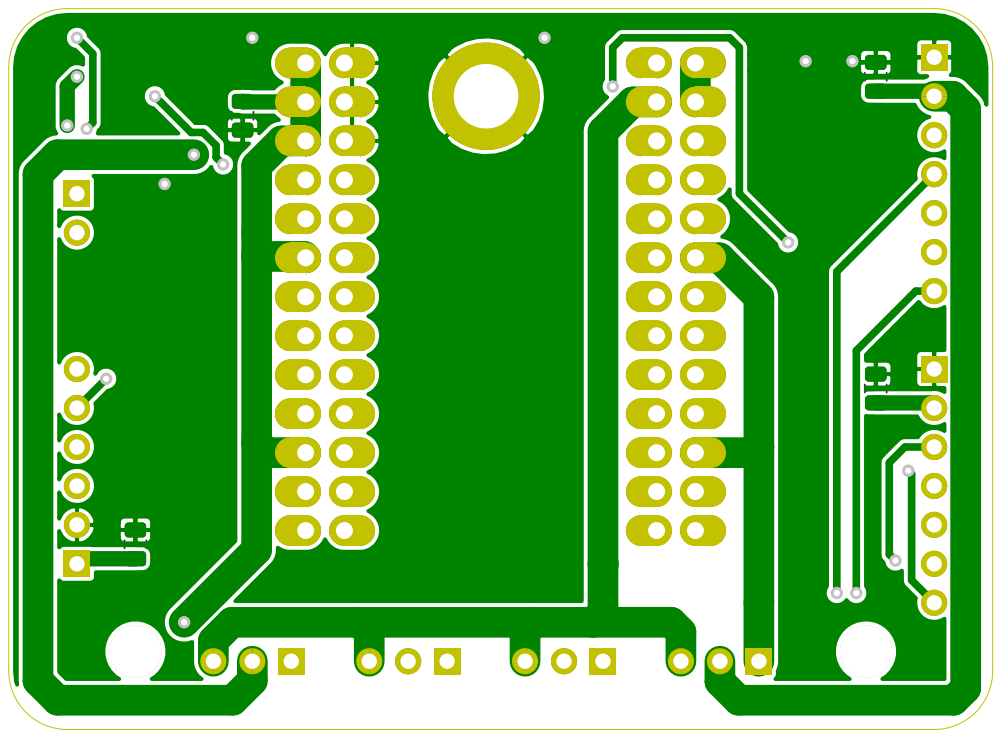
[picture p173: page 1]
