TomKeddie/prj-pcb-experiments/ft4232h-breakout/v1.x/doc/ft4232h-breakout-front-Jun2021b.pdf

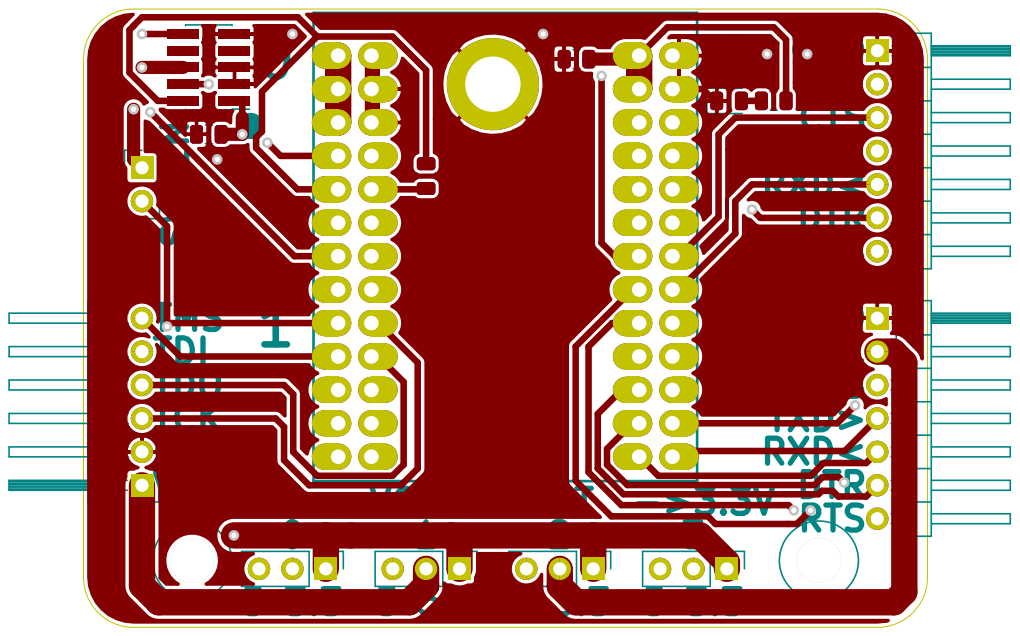
[picture p174: page 1]
