TomKeddie/prj-pcb-experiments/ft4232h-breakout/v1.x/doc/ft4232h-breakout-sch-Jun2021b.pdf

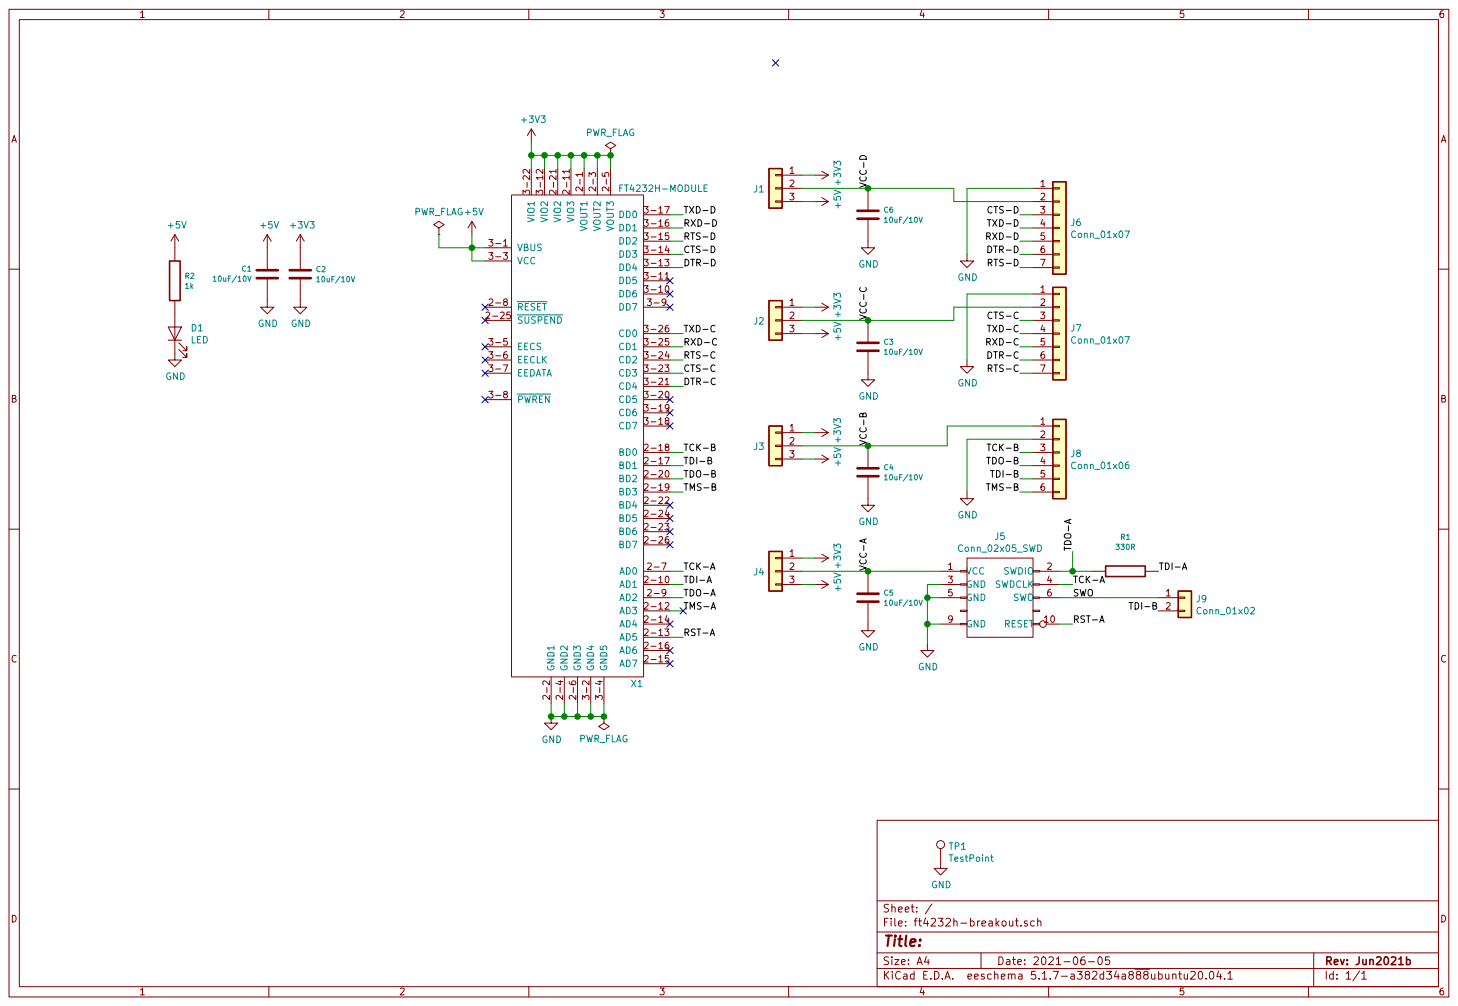
[picture p175: page 1]
