TomKeddie/prj-pcb-experiments/ft4232h-breakout/v1.x/doc/ft4232h-breakout-front-Jun2021a.pdf

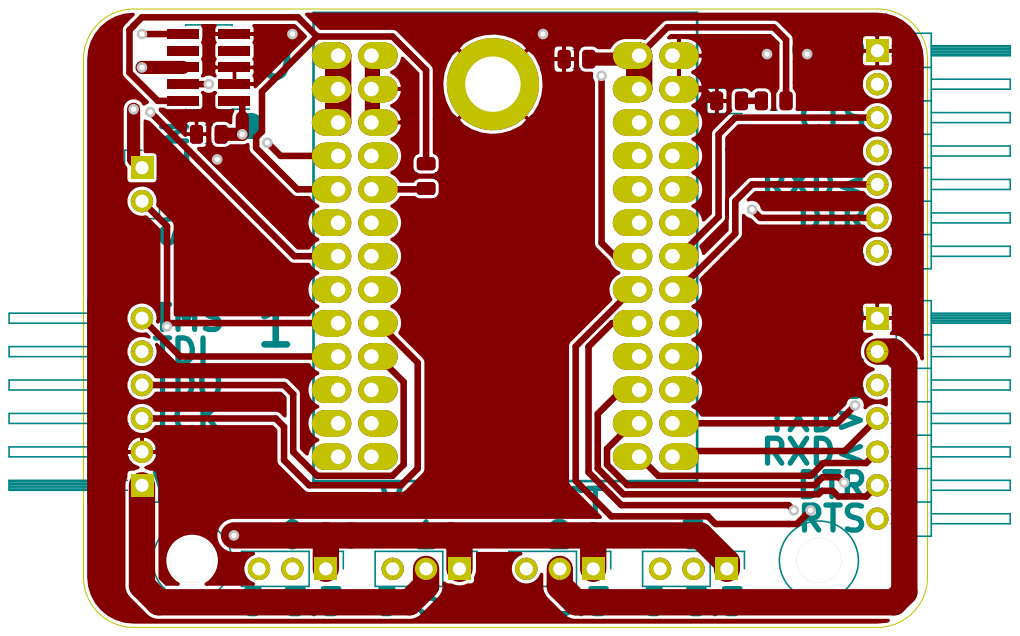
[picture p176: page 1]
