TomKeddie/prj-pcb-experiments/ft4232h-breakout/v1.x/doc/ft4232h-breakout-sch-Jun2021a.pdf

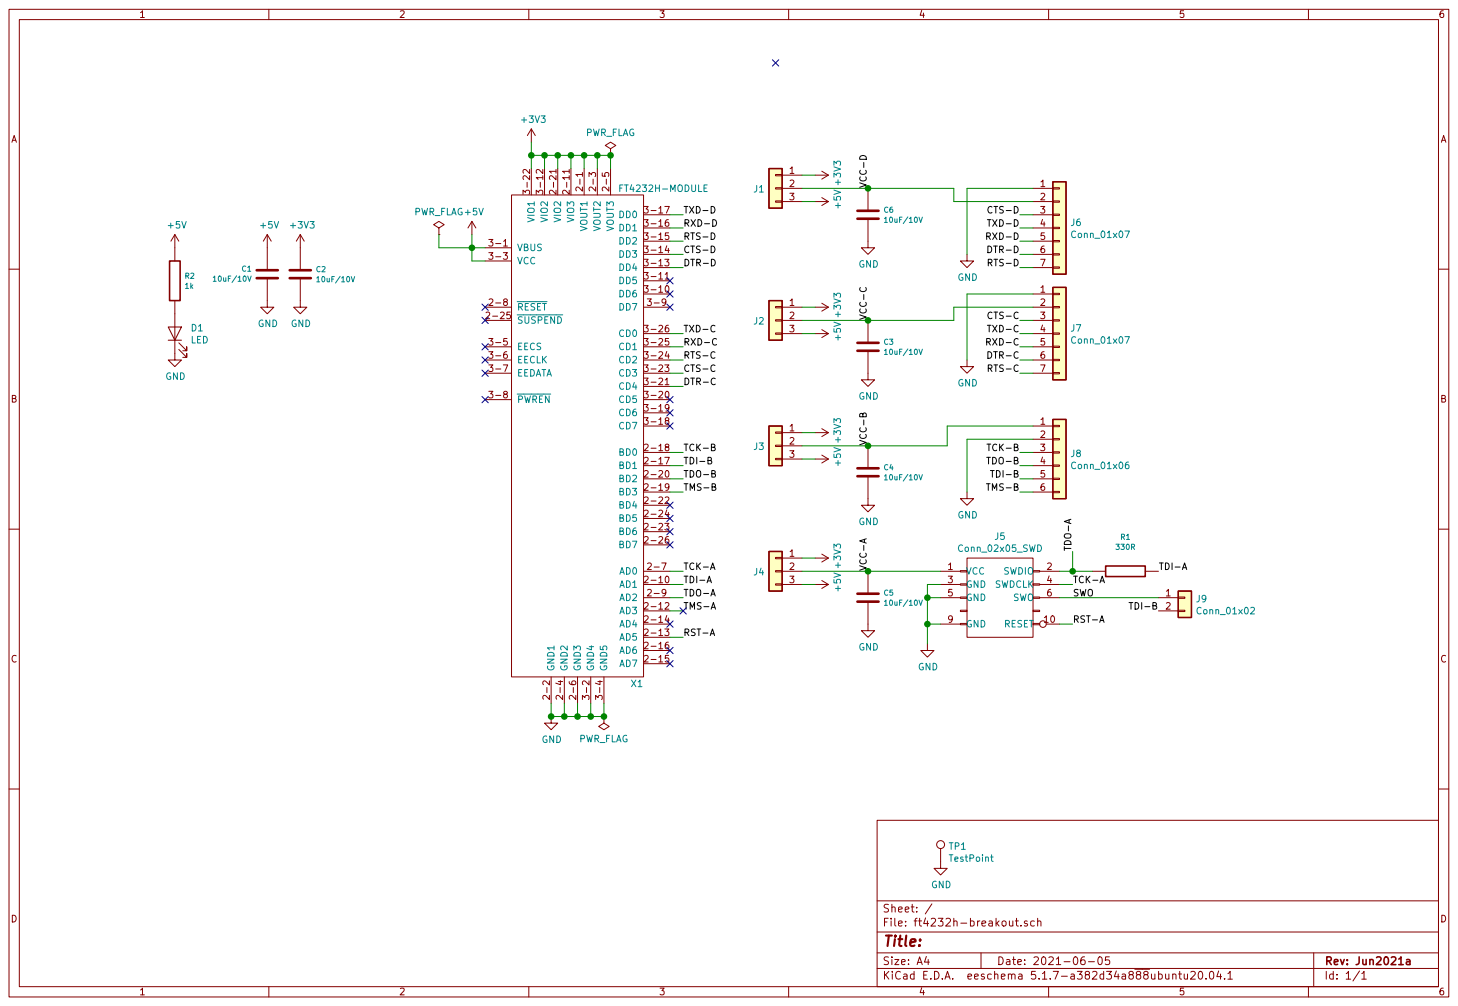
[picture p177: page 1]
