TomKeddie/prj-pcb-experiments/ft4232h-breakout/v1.x/doc/ft4232h-breakout-back-Jun2021.pdf

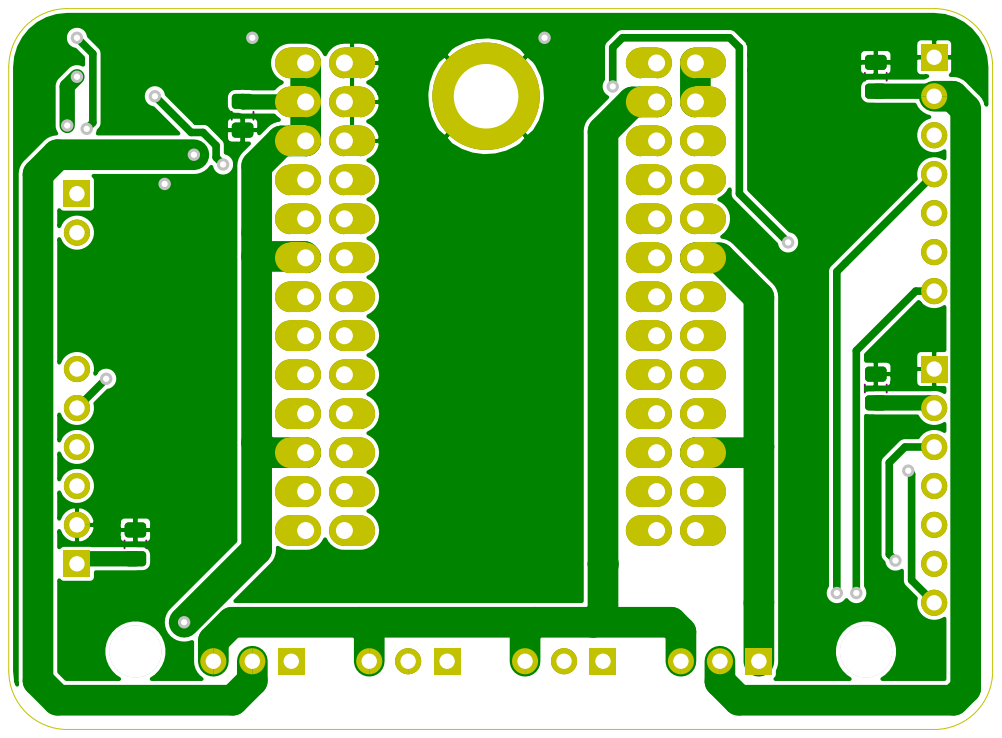
[picture p178: page 1]
