TomKeddie/prj-pcb-experiments/ft4232h-breakout/v1.x/doc/ft4232h-breakout-front-Jun2021.pdf

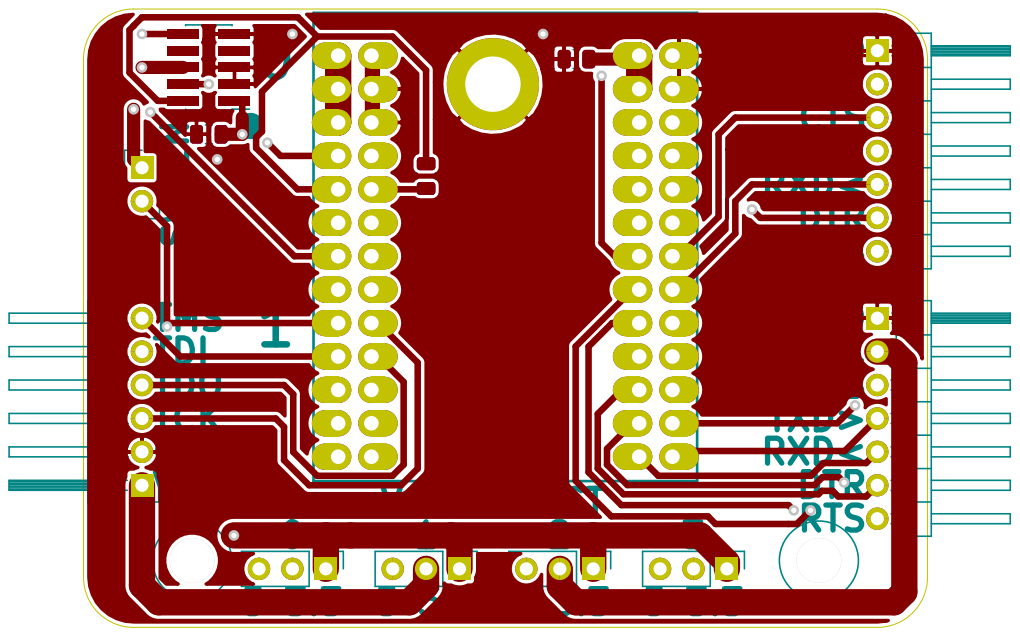
[picture p179: page 1]
