TomKeddie/prj-pcb-experiments/ft4232h-breakout/v1.x/doc/ft4232h-breakout-sch-Jun2021.pdf

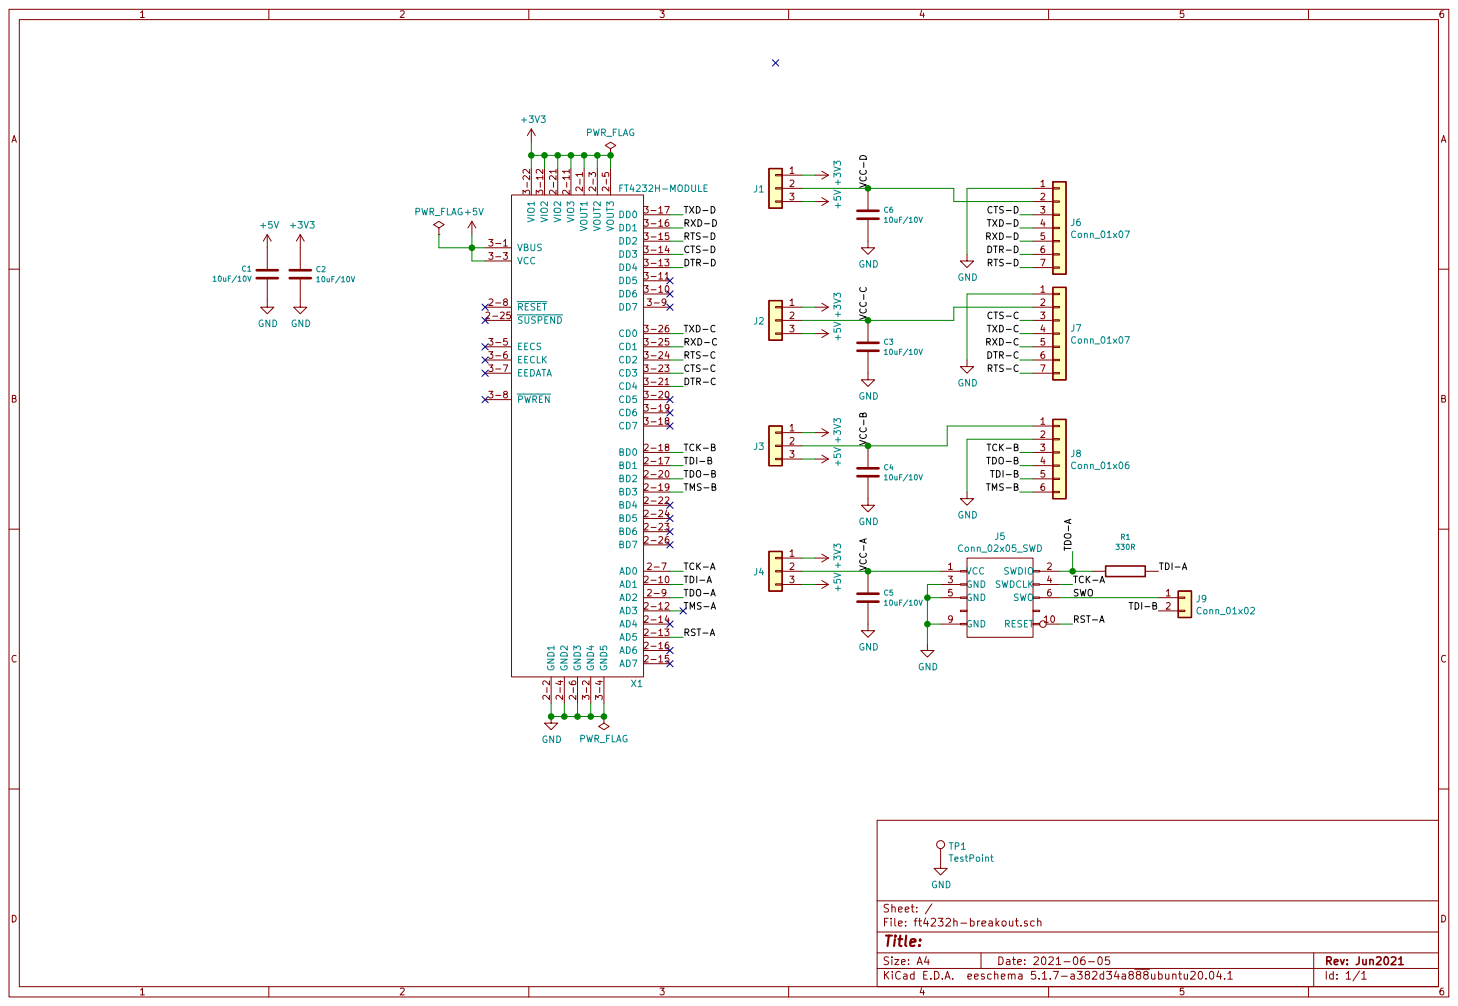
[picture p180: page 1]

Id: 1/1 Title: File: ft4232h-breakout.sch Sheet: / C5
