TomKeddie/prj-pcb-experiments/ft4232h-breakout/v1.x/doc/ft4232h-breakout-back-May2021.pdf

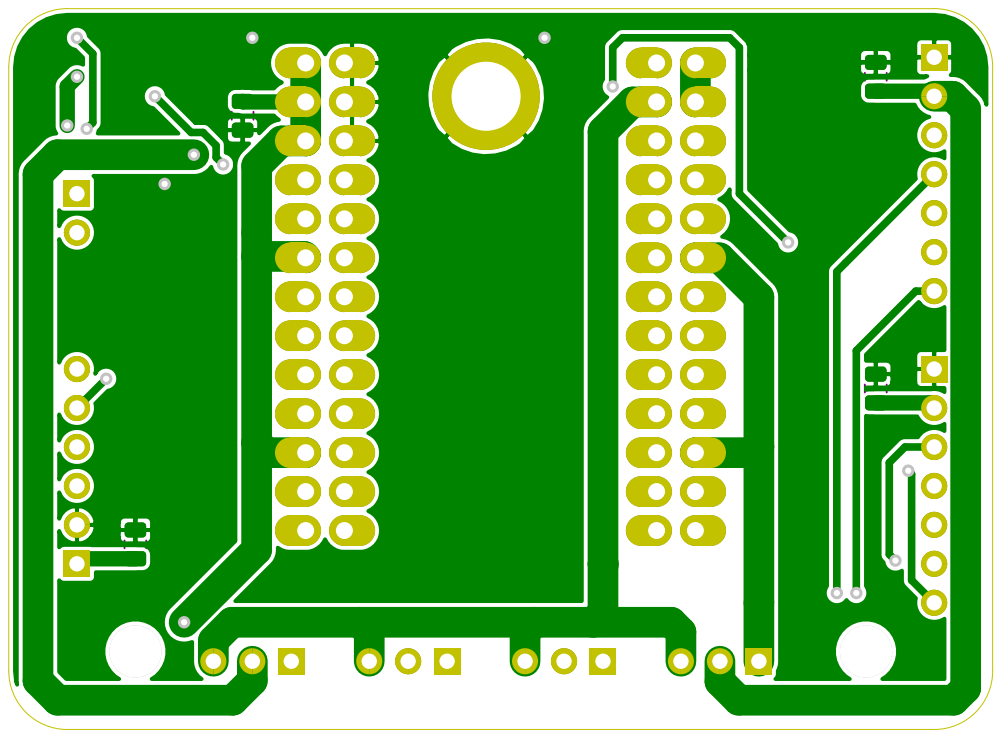
[picture p181: page 1]
