TomKeddie/prj-pcb-experiments/ft4232h-breakout/v1.x/doc/ft4232h-breakout-front-May2021.pdf

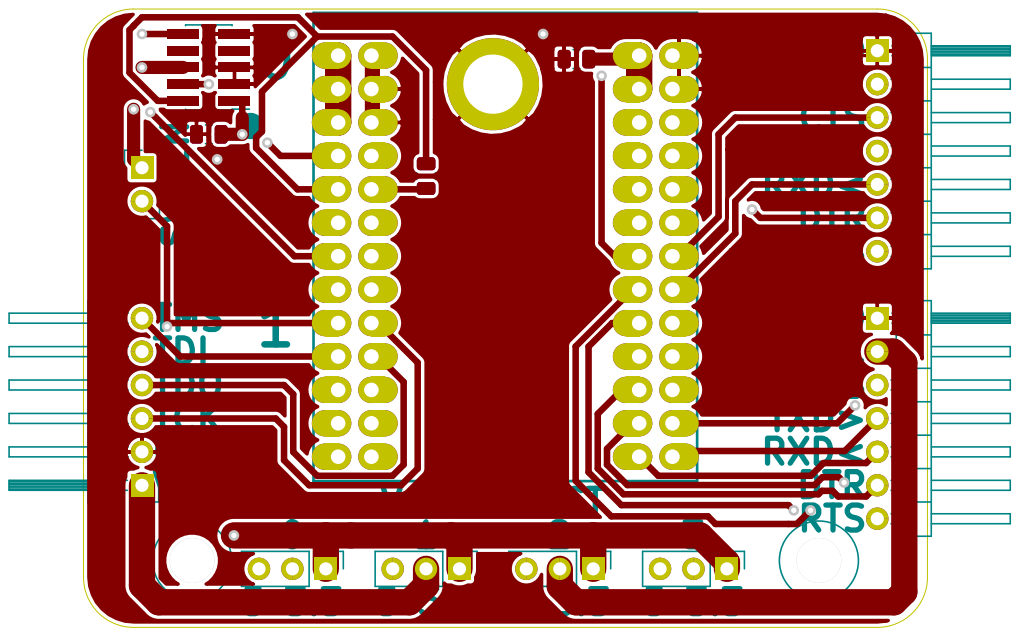
[picture p182: page 1]
