TomKeddie/prj-pcb-experiments/ft4232h-breakout/v1.x/doc/ft4232h-breakout-sch-May2021.pdf

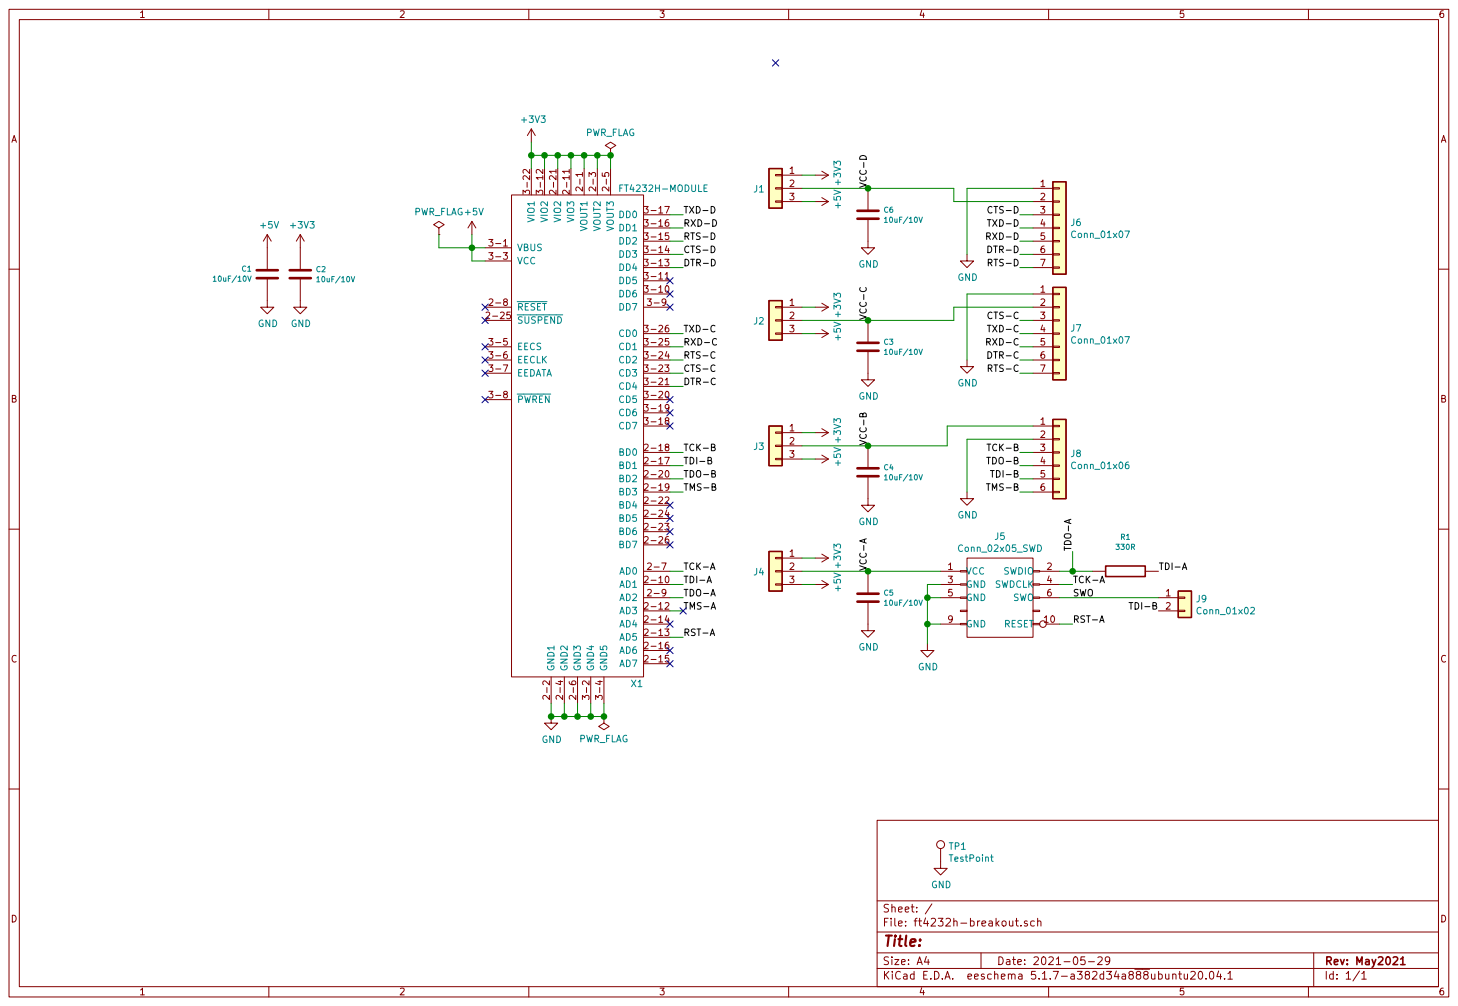
[picture p183: page 1]

Id: 1/1 Title: File: ft4232h-breakout.sch Sheet: / C5
