TomKeddie/prj-pcb-experiments/ft4232h-breakout/v1.x/doc/ft4232h-breakout-back-Apr2021.pdf

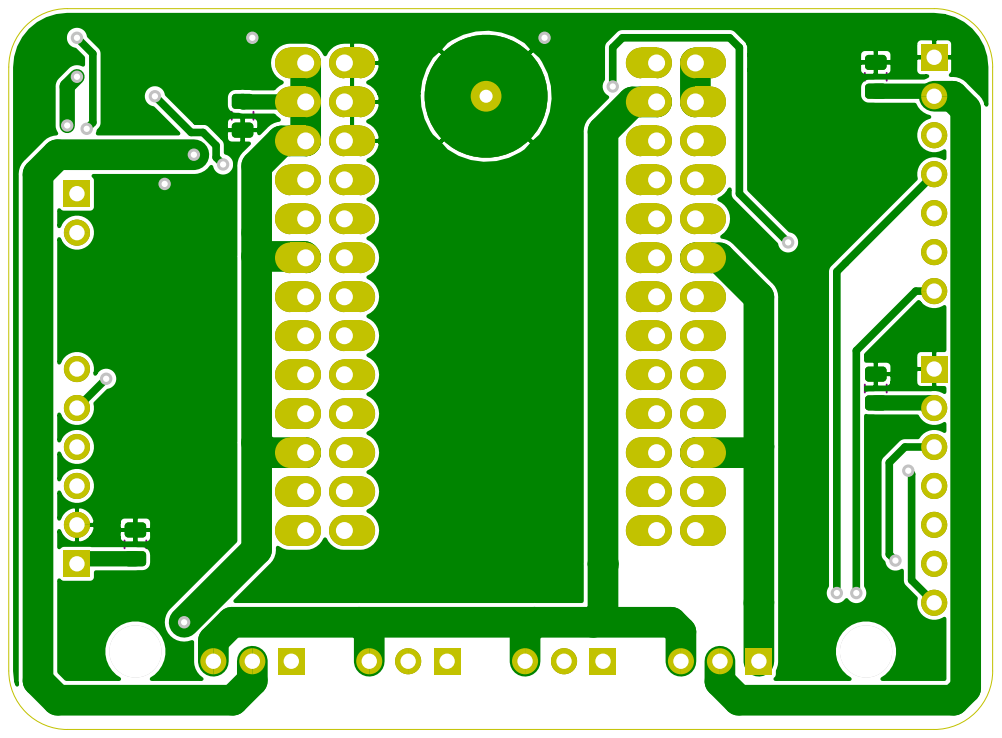
[picture p184: page 1]
