TomKeddie/prj-pcb-experiments/ft4232h-breakout/v1.x/doc/ft4232h-breakout-front-Apr2021.pdf

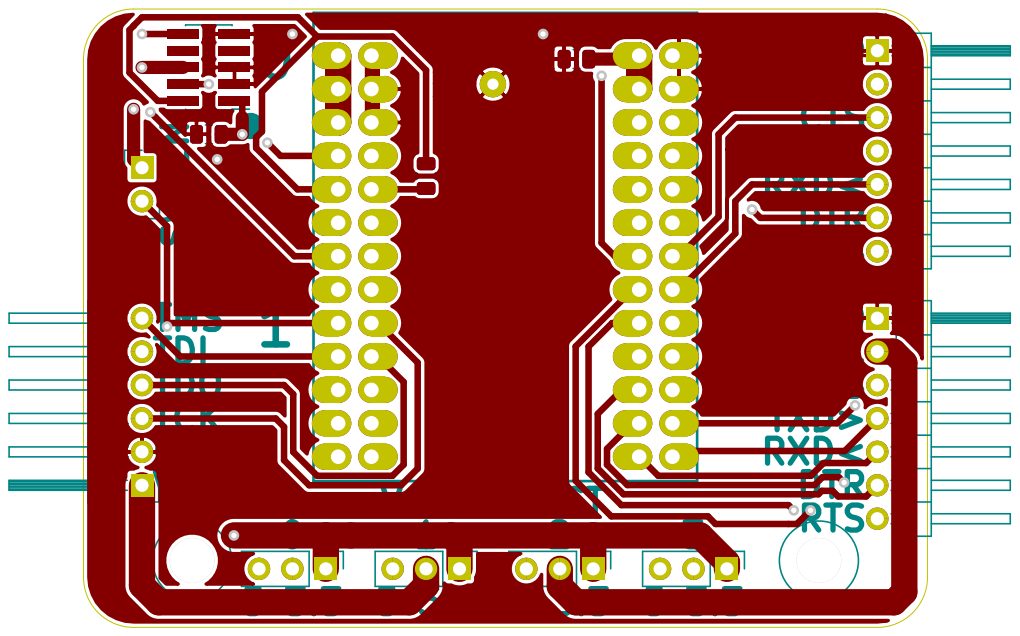
[picture p185: page 1]
