TomKeddie/prj-pcb-experiments/micromod-pmod-function/tmp.1/MicroMod_Environmental.kicad_pcb

## KiCad design micromod-pmod-function/tmp.1/MicroMod_Environmental.kicad_pcb (2026-09-26)

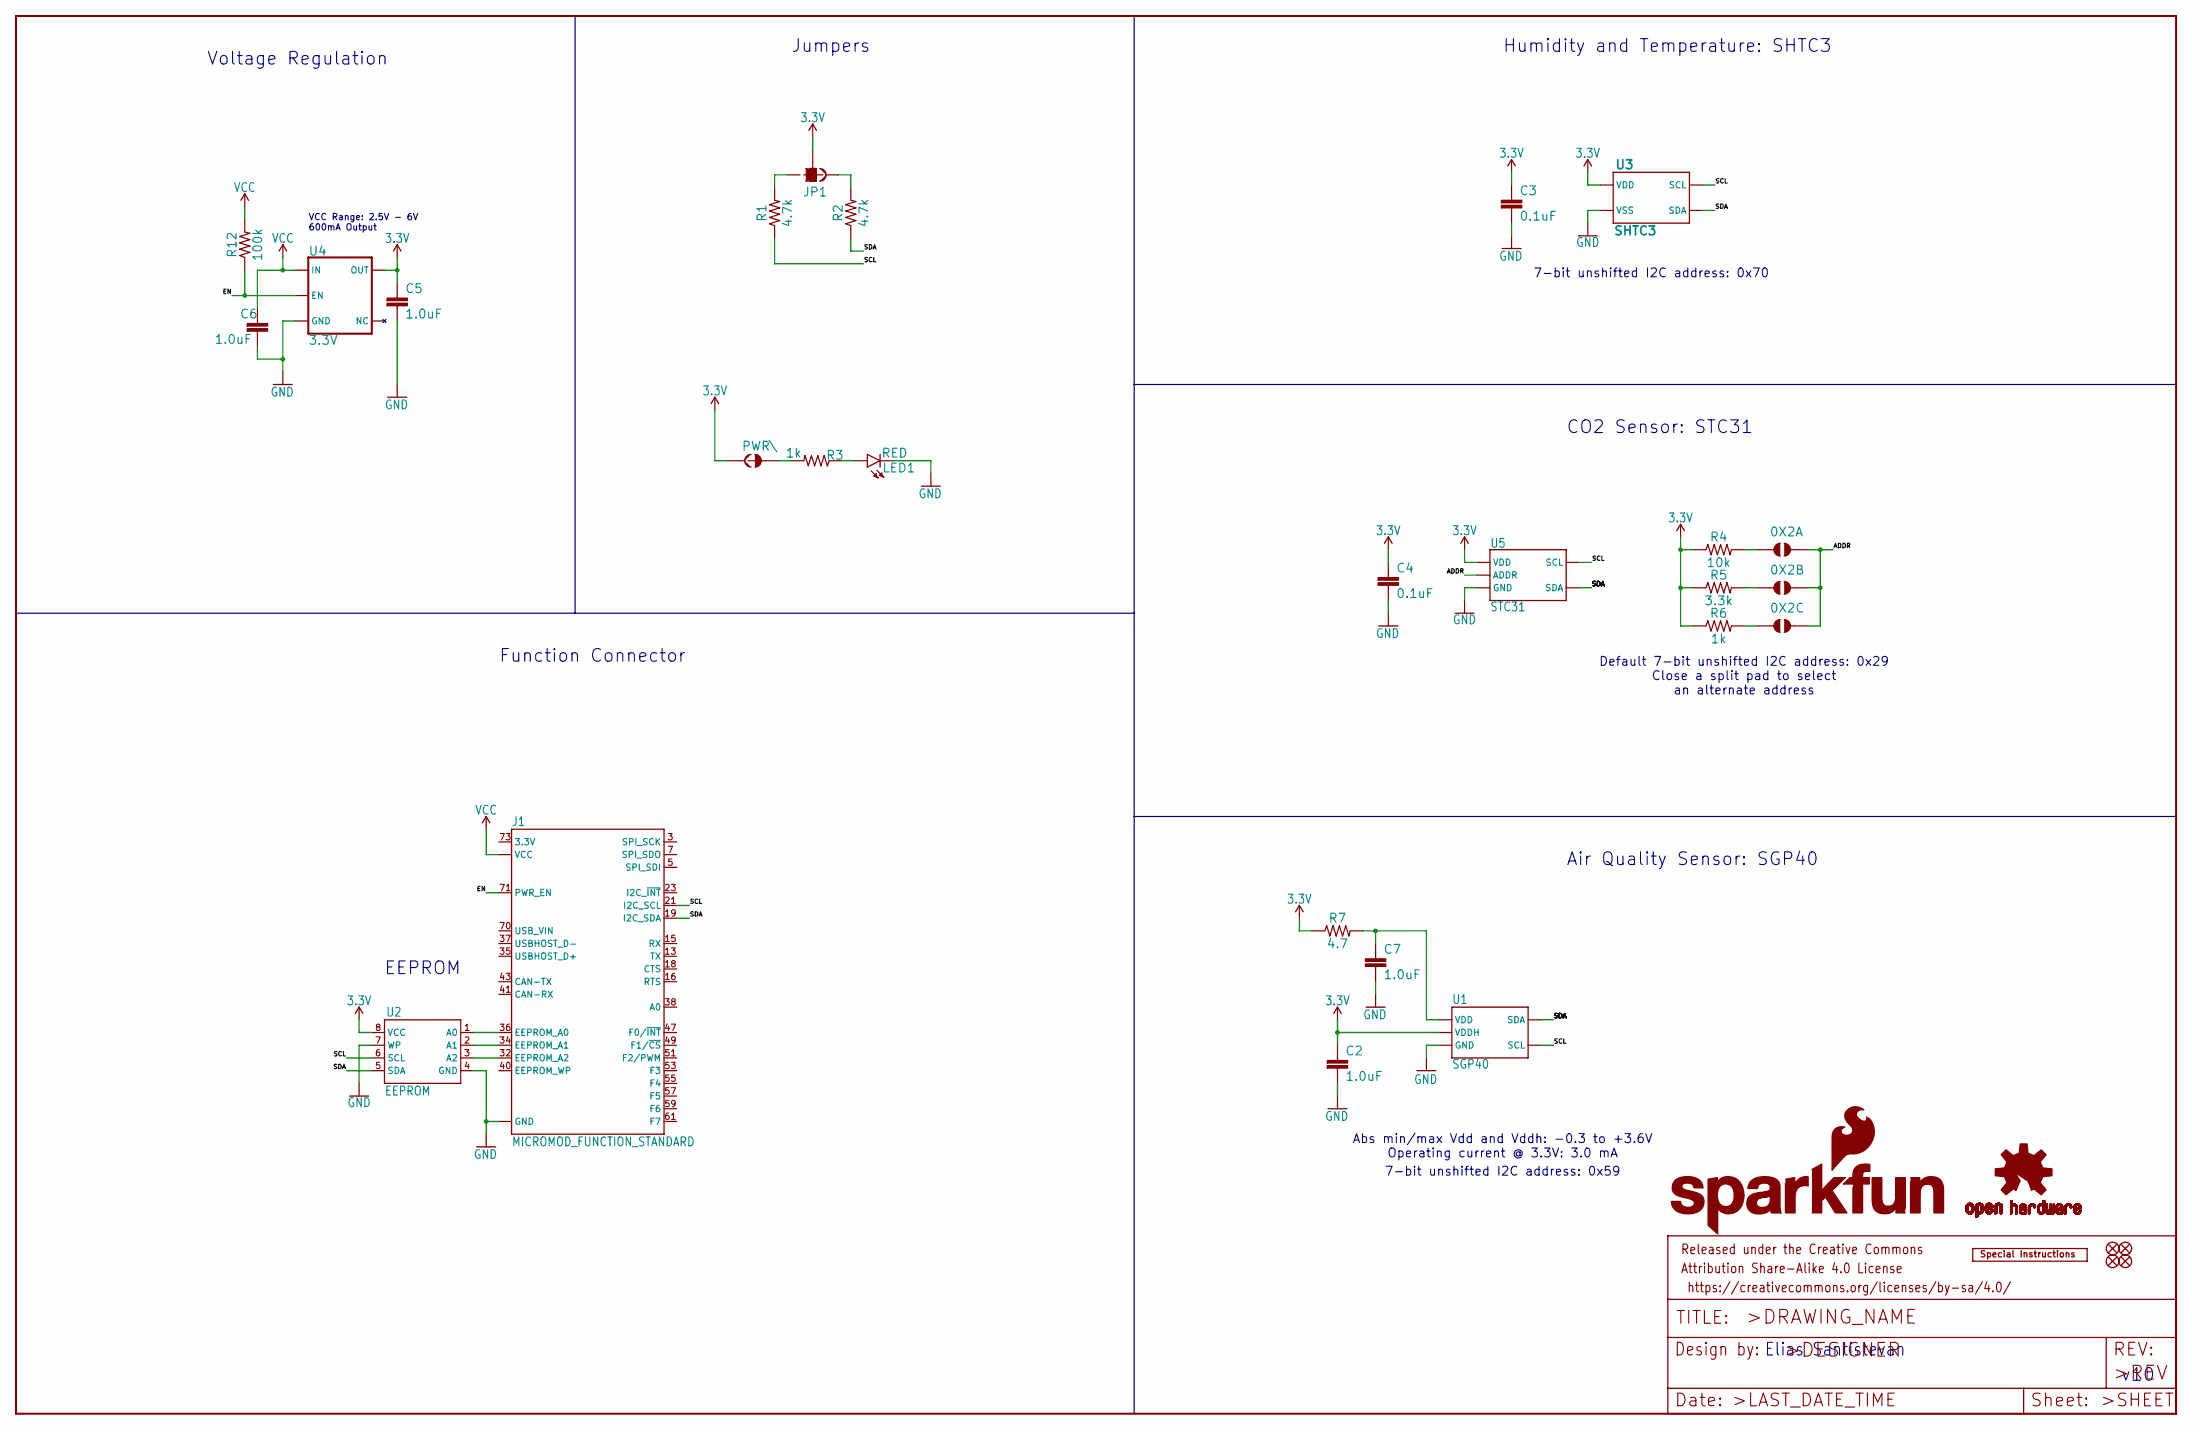
[picture p187: schematic MicroMod_Environmental.kicad_sch]

Parts:
0X2A, 0X2B, 0X2C: JUMPER-SMT_2_NO_SILK; SMT-JUMPER_2_NO_SILK
C2, C5, C6, C7: 1.0uF; 0603
C3, C4: 0.1uF; 0603
FD1, FD2, FD3, FD4: FIDUCIAL1X2; FIDUCIAL-1X2
FRAME1: FRAME-LEDGER; CREATIVE_COMMONS
J1: MICROMOD_FUNCTION_STANDARD; M.2-CARD-E-22_FUNCTION_STANDARD
JP1: JUMPER-SMT_3_2-NC_TRACE_SILK; SMT-JUMPER_3_2-NC_TRACE_SILK
LED1: RED; LED-0603
LOGO1: SFE_LOGO_NAME_FLAME.2_INCH; SFE_LOGO_NAME_FLAME_.2
LOGO2: OSHW-LOGOS; OSHW-LOGO-S
LOGO3: SPECIAL_INSTRUCTIONS-ORDERING; ORDERING_INSTRUCTIONS
PWR\: JUMPER-SMT_2_NC_TRACE_SILK; SMT-JUMPER_2_NC_TRACE_SILK
R1, R2: 4.7k; 0603
R3, R6: 1k; 0603
R4: 10k; 0603
R5: 3.3k; 0603
R7: 4.7; 0603
R12: 100k; 0603
U1: SGP40
U2: EEPROM; SO08
U3: SHTC3
U4: 3.3V; SOT23-5
U5: STC31

Connections:
3.3V: C2.1, C3.1, C4.1, C5.1, JP1.2, PWR\.2, R4.1, R5.1, R6.1, R7.1, U1.5 (VDDH), U2.8 (VCC), U3.1 (VDD), U4.5 (OUT), U5.6 (VDD)
A0: J1.36 (EEPROM_A0), U2.1 (A0)
A1: J1.34 (EEPROM_A1), U2.2 (A1)
A2: J1.32 (EEPROM_A2), U2.3 (A2)
ADDR: 0X2A.2, 0X2B.2, 0X2C.2, U5.3 (ADDR)
EN: J1.71 (PWR_EN), R12.1, U4.3 (EN)
GND: C2.2, C3.2, C4.2, C5.2, C6.2, C7.2, J1.1 (GND), J1.33 (GND), J1.39 (GND), J1.45 (GND), J1.75 (GND), J1.GND1 (GND), J1.GND2 (GND), J1.GND3 (GND), J1.GND4 (GND), J1.GND5 (GND), J1.GND6 (GND), LED1.C, U1.2 (GND), U1.4 (GND), U1.DIEPAD (GND), U2.4 (GND), U2.7 (WP), U3.4 (VSS), U3.5 (VSS), U4.2 (GND), U5.1 (GND), U5.5 (GND), U5.9 (GND), U5.11 (GND), U5.DIEPAD (GND)
unnamed: PWR\.1, R3.2
unnamed: C7.1, R7.2, U1.1 (VDD)
unnamed: JP1.3, R1.2
unnamed: JP1.1, R2.2
unnamed: 0X2A.1, R4.2
unnamed: 0X2B.1, R5.2
unnamed: 0X2C.1, R6.2
unnamed: LED1.A, R3.1
SCL: J1.21 (I2C_SCL), R1.1, U1.6 (SCL), U2.6 (SCL), U3.2 (SCL), U5.4 (SCL)
SDA: J1.19 (I2C_SDA), R2.1, U1.3 (SDA), U2.5 (SDA), U3.3 (SDA), U5.7 (SDA)
VCC: C6.1, J1.72 (VCC), J1.74 (VCC), R12.2, U4.1 (IN)

Notes on the sheet:
Humidity and Temperature: SHTC3
Abs min/max Vdd and Vddh: -0.3 to +3.6V Operating current @ 3.3V: 3.0 mA
EEPROM
Function Connector
Jumpers
v10
Default 7-bit unshifted I2C address: 0x29 Close a split pad to select an alternate address
Elias Santistevan
CO2 Sensor: STC31
Air Quality Sensor: SGP40
7-bit unshifted I2C address: 0x70
Voltage Regulation
VCC Range: 2.5V - 6V 600mA Output
7-bit unshifted I2C address: 0x59

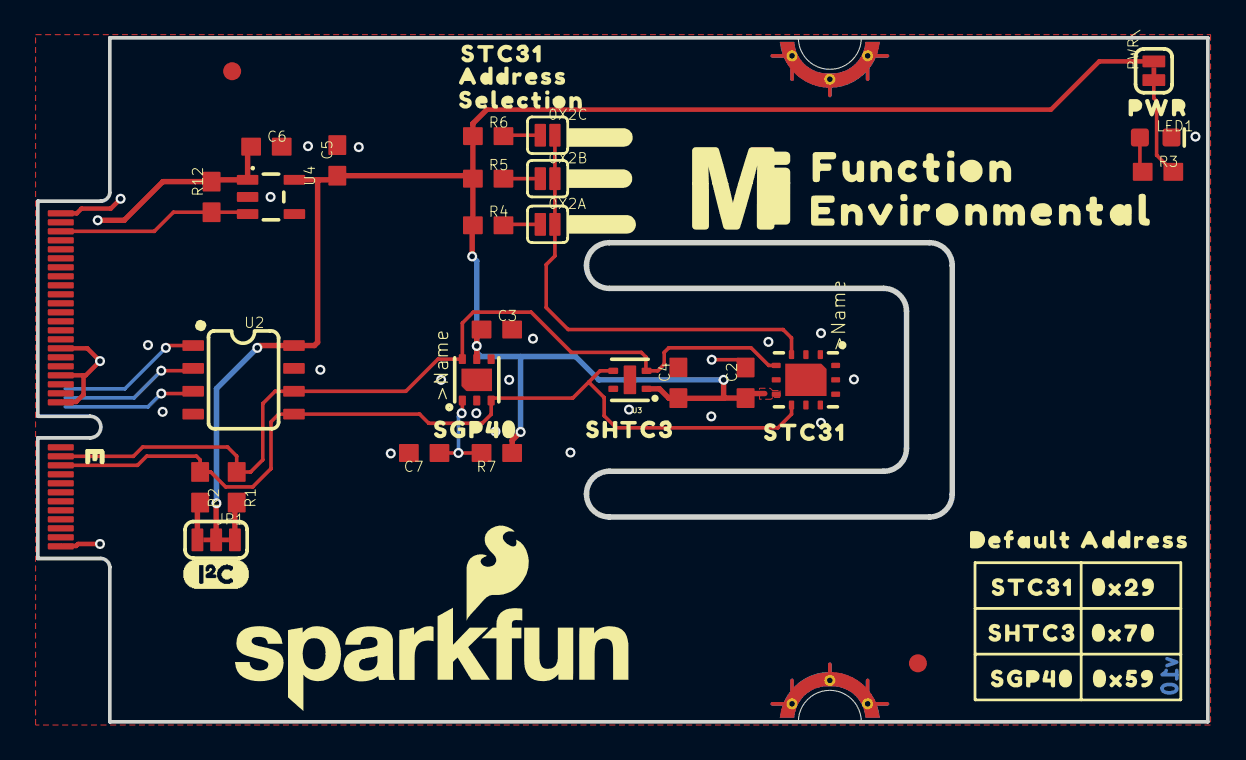
[picture p188: board MicroMod_Environmental.kicad_pcb from above]

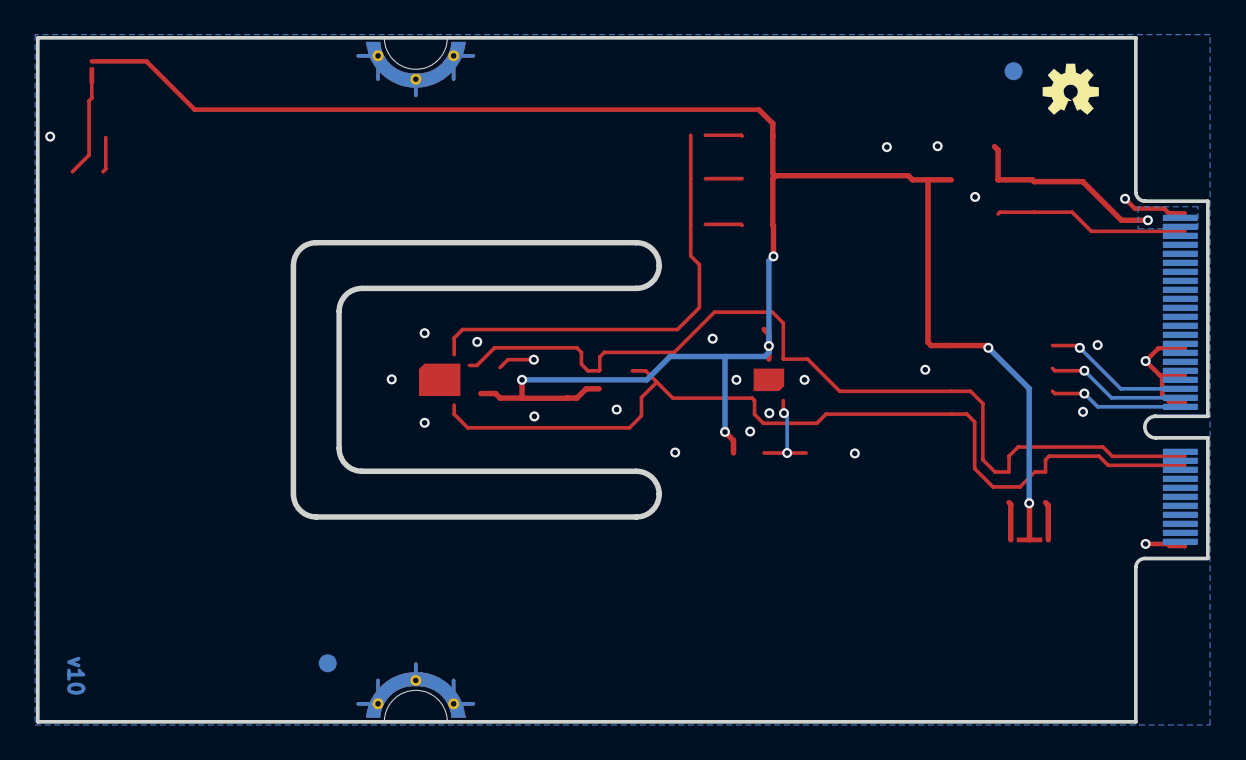
[picture p189: board MicroMod_Environmental.kicad_pcb from below]

Board: 2 copper layers, 65.0 x 38.0 mm, 56 parts (3 on the bottom side), 18 nets.

Other parts of the board:
U$1: #0X2A#21
U$2: #0X2B#21
U$3: #0X2C#21
U$4: PWR321541
U$5: FUNCTION524
U$6: ENVIRONMENTAL526
U$7: MICROMOD_MI_LOGO_1
U$8: I2C
U$9, U$15: ADDRESS40313505
U$10: 0X2940313520
U$11, U$18: SGP40313503
U$12, U$17: SHTC3501
U$13, U$16, U$22: STC313502
U$14: DEFAULT40313504
U$19: 0X5940313520
U$20: 0X7040313520
U$21: SELECTION40313506
