TomKeddie/prj-pcb-experiments/ft4232h-breakout/v3.x/ft4232h-breakout.kicad_pcb

## KiCad design ft4232h-breakout/v3.x/ft4232h-breakout.kicad_pcb (2026-09-26)

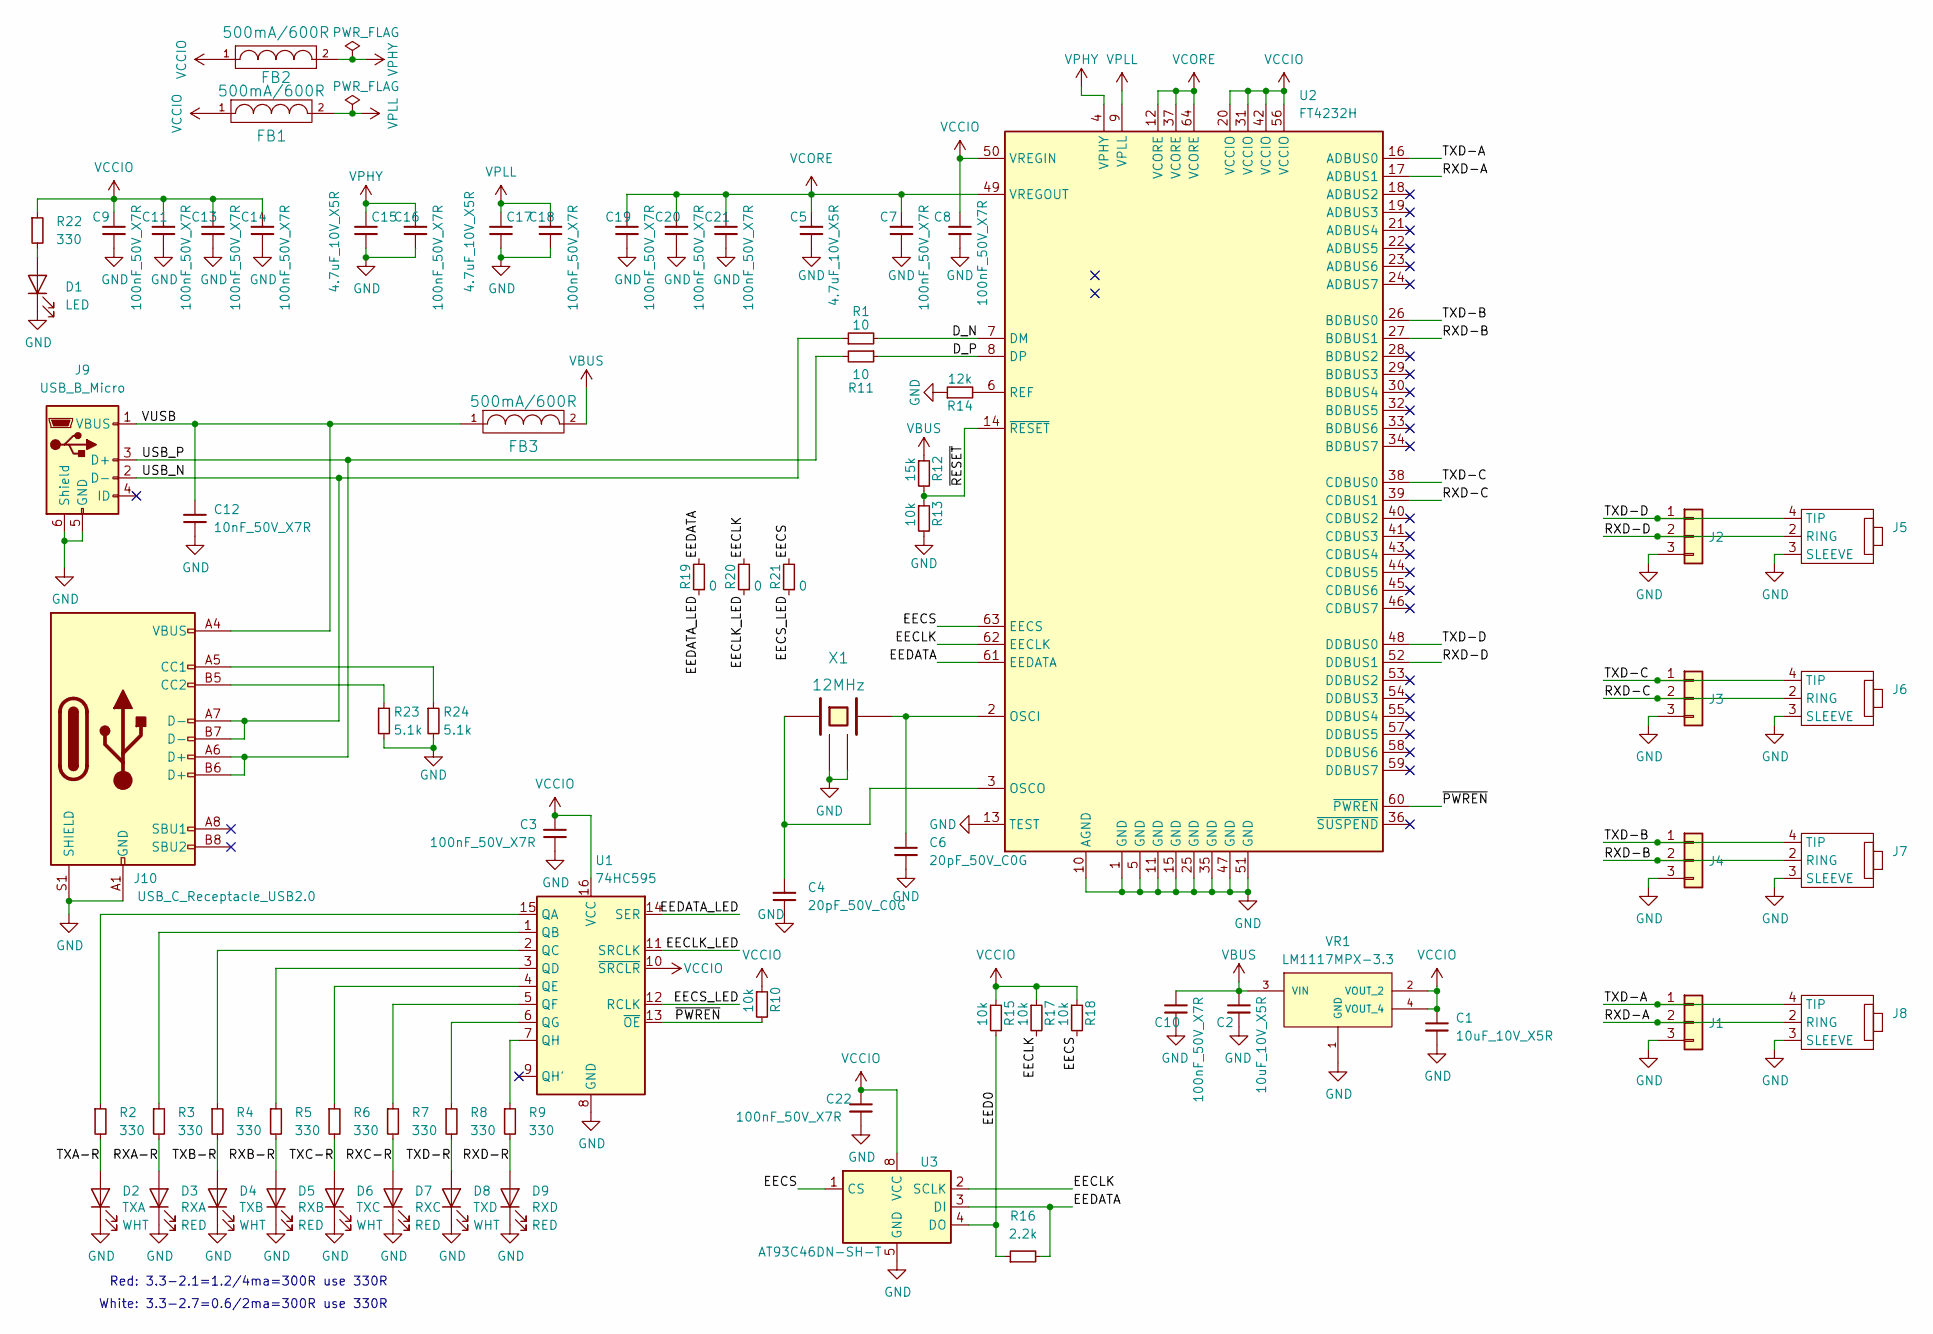
[picture p191: schematic ft4232h-breakout.kicad_sch]

Parts:
C1, C2: 10uF_10V_X5R; C_0603_1608Metric; MFGPN CL10A106KP8NNNC; LCSC C19702
C3, C7, C8, C9, C10, C11, C13, C14, C16, C18, C19, C20, C21, C22: 100nF_50V_X7R; C_0402_1005Metric; MFGPN CL05B104KB54PNC; LCSC C307331
C4, C6: 20pF_50V_C0G; C_0402_1005Metric; MFGPN 0402CG200J500NT; LCSC C1554
C5, C15, C17: 4.7uF_10V_X5R; C_0402_1005Metric; MFGPN CL05A475MP5NRNC; LCSC C23733
C12: 10nF_50V_X7R; C_0402_1005Metric; MFGPN CL05B103KB5NNNC; LCSC C15195
D1: LED; LED_0603_1608Metric; LCSC C2290
D2: TXA; LED_0603_1608Metric; LCSC C2290
D3: RXA; LED_0603_1608Metric; LCSC C2290
D4: TXB; LED_0603_1608Metric; LCSC C2290
D5: RXB; LED_0603_1608Metric; LCSC C2290
D6: TXC; LED_0603_1608Metric; LCSC C2290
D7: RXC; LED_0603_1608Metric; LCSC C2290
D8: TXD; LED_0603_1608Metric; LCSC C2290
D9: RXD; LED_0603_1608Metric; LCSC C2290
FB1, FB2, FB3: 500mA/600R; C_0805_2012Metric; LCSC C1017
J1, J2, J3, J4: Conn_01x03; PinHeader_1x03_P2.54mm_Horizontal; LCSC C492411
J5, J6, J7, J8: JLCPCB_3.5MM_SOCKET_C18166; MPN PJ-3200; LCSC C18166
J9: USB_B_Micro; USB_B_Micro_LCSC_C10418; LCSC C10418
J10: USB_C_Receptacle_USB2.0; USB_C_Receptacle_LCSC_C165948; LCSC C165948
R1, R11: 10; R_0402_1005Metric; MFGPN 0402WGF100JTCE; LCSC C25077
R2, R3, R4, R5, R6, R7, R8, R9, R22: 330; R_0402_1005Metric; MFGPN 0402WGF3300TCE; LCSC C25104
R10, R13, R15, R17, R18: 10k; R_0402_1005Metric; MFGPN 0402WGF1002TCE; LCSC C25744
R12: 15k; R_0402_1005Metric; MFGPN 0402WGF1502TCE; LCSC C25756
R14: 12k; R_0402_1005Metric; MFGPN 0402WGF1202TCE; LCSC C25752
R16: 2.2k; R_0402_1005Metric; MFGPN 0402WGF2201TCE; LCSC C25879
R19, R20, R21: 0; R_0402_1005Metric; MFGPN 0402WGF0000TCE; LCSC C17168
R23, R24: 5.1k; R_0402_1005Metric; MFGPN 0402WGF5101TCE; LCSC C25905
U1: 74HC595; SOIC-16_4.55x10.3mm_P1.27mm; LCSC C5947
U2: FT4232H; TQFP-64_10x10mm_P0.5mm; LCSC DNP
U3: AT93C46DN-SH-T; SO-8_3.9x4.9mm_P1.27mm; LCSC C6499
VR1: LM1117MPX-3.3; VREG_LM1117MPX-3.3; PARTREV O; LCSC C6186
X1: 12MHz; Crystal_SMD_3225-4Pin_3.2x2.5mm; LCSC C9002

Connections:
/D_N: R1.2, U2.7 (DM)
/D_P: R11.1, U2.8 (DP)
/EECLK: R17.2, R20.2, U2.62 (EECLK), U3.2 (SCLK)
/EECLK_LED: R20.1, U1.11 (SRCLK)
/EECS: R18.2, R21.2, U2.63 (EECS), U3.1 (CS)
/EECS_LED: R21.1, U1.12 (RCLK)
/EED0: R15.2, R16.1, U3.4 (DO)
/EEDATA: R16.2, R19.2, U2.61 (EEDATA), U3.3 (DI)
/EEDATA_LED: R19.1, U1.14 (SER)
/RXA-R: D3.2 (A), R3.2
/RXB-R: D5.2 (A), R5.2
/RXC-R: D7.2 (A), R7.2
/RXD-A: J1.2, J8.2 (RING), U2.17 (ADBUS1)
/RXD-B: J4.2, J7.2 (RING), U2.27 (BDBUS1)
/RXD-C: J3.2, J6.2 (RING), U2.39 (CDBUS1)
/RXD-D: J2.2, J5.2 (RING), U2.52 (DDBUS1)
/RXD-R: D9.2 (A), R9.2
/TXA-R: D2.2 (A), R2.2
/TXB-R: D4.2 (A), R4.2
/TXC-R: D6.2 (A), R6.2
/TXD-A: J1.1, J8.4 (TIP), U2.16 (ADBUS0)
/TXD-B: J4.1, J7.4 (TIP), U2.26 (BDBUS0)
/TXD-C: J3.1, J6.4 (TIP), U2.38 (CDBUS0)
/TXD-D: J2.1, J5.4 (TIP), U2.48 (DDBUS0)
/TXD-R: D8.2 (A), R8.2
/USB_N: J9.2 (D-), J10.A7 (D-), J10.B7 (D-), R1.1
/USB_P: J9.3 (D+), J10.A6 (D+), J10.B6 (D+), R11.2
/VUSB: C12.1, FB3.1, J9.1 (VBUS), J10.A4 (VBUS), J10.A9 (VBUS), J10.B4 (VBUS), J10.B9 (VBUS)
/~PWREN: R10.2, U1.13 (~OE), U2.60 (~PWREN)
/~RESET: R12.2, R13.1, U2.14 (~RESET)
GND: C1.2, C2.2, C3.1, C4.2, C5.2, C6.2, C7.1, C8.1, C9.1, C10.1, C11.1, C12.2, C13.1, C14.1, C15.2, C16.1, C17.2, C18.1, C19.1, C20.1, C21.1, C22.1, D1.1 (K), D2.1 (K), D3.1 (K), D4.1 (K), D5.1 (K), D6.1 (K), D7.1 (K), D8.1 (K), D9.1 (K), J1.3, J2.3, J3.3, J4.3, J5.3 (SLEEVE), J6.3 (SLEEVE), J7.3 (SLEEVE), J8.3 (SLEEVE), J9.5 (GND), J9.6 (Shield), J10.A1 (GND), J10.A12 (GND), J10.B1 (GND), J10.B12 (GND), J10.S1 (SHIELD), R13.2, R14.1, R23.2, R24.2, U1.8 (GND), U2.1 (GND), U2.5 (GND), U2.10 (AGND), U2.11 (GND), U2.13 (TEST), U2.15 (GND), U2.25 (GND), U2.35 (GND), U2.47 (GND), U2.51 (GND), U3.5 (GND), VR1.1 (GND), X1.2 (GND), X1.4 (GND)
unnamed: C4.1, U2.3 (OSCO), X1.1
unnamed: C6.1, U2.2 (OSCI), X1.3
unnamed: D1.2 (A), R22.2
unnamed: J10.A5 (CC1), R24.1
unnamed: J10.B5 (CC2), R23.1
unnamed: R2.1, U1.15 (QA)
unnamed: R3.1, U1.1 (QB)
unnamed: R4.1, U1.2 (QC)
unnamed: R5.1, U1.3 (QD)
unnamed: R6.1, U1.4 (QE)
unnamed: R7.1, U1.5 (QF)
unnamed: R8.1, U1.6 (QG)
unnamed: R9.1, U1.7 (QH)
unnamed: R14.2, U2.6 (REF)
VBUS: C2.1, C10.2, FB3.2, R12.1, VR1.3 (VIN)
VCCIO: C1.1, C3.2, C8.2, C9.2, C11.2, C13.2, C14.2, C22.2, FB1.1, FB2.1, R10.1, R15.1, R17.1, R18.1, R22.1, U1.10 (~SRCLR), U1.16 (VCC), U2.20 (VCCIO), U2.31 (VCCIO), U2.42 (VCCIO), U2.50 (VREGIN), U2.56 (VCCIO), U3.8 (VCC), VR1.2 (VOUT_2), VR1.4 (VOUT_4)
VCORE: C5.1, C7.2, C19.2, C20.2, C21.2, U2.12 (VCORE), U2.37 (VCORE), U2.49 (VREGOUT), U2.64 (VCORE)
VPHY: C15.1, C16.2, FB2.2, U2.4 (VPHY)
VPLL: C17.1, C18.2, FB1.2, U2.9 (VPLL)

Notes on the sheet:
Red: 3.3-2.1=1.2/4ma=300R use 330R
White: 3.3-2.7=0.6/2ma=300R use 330R

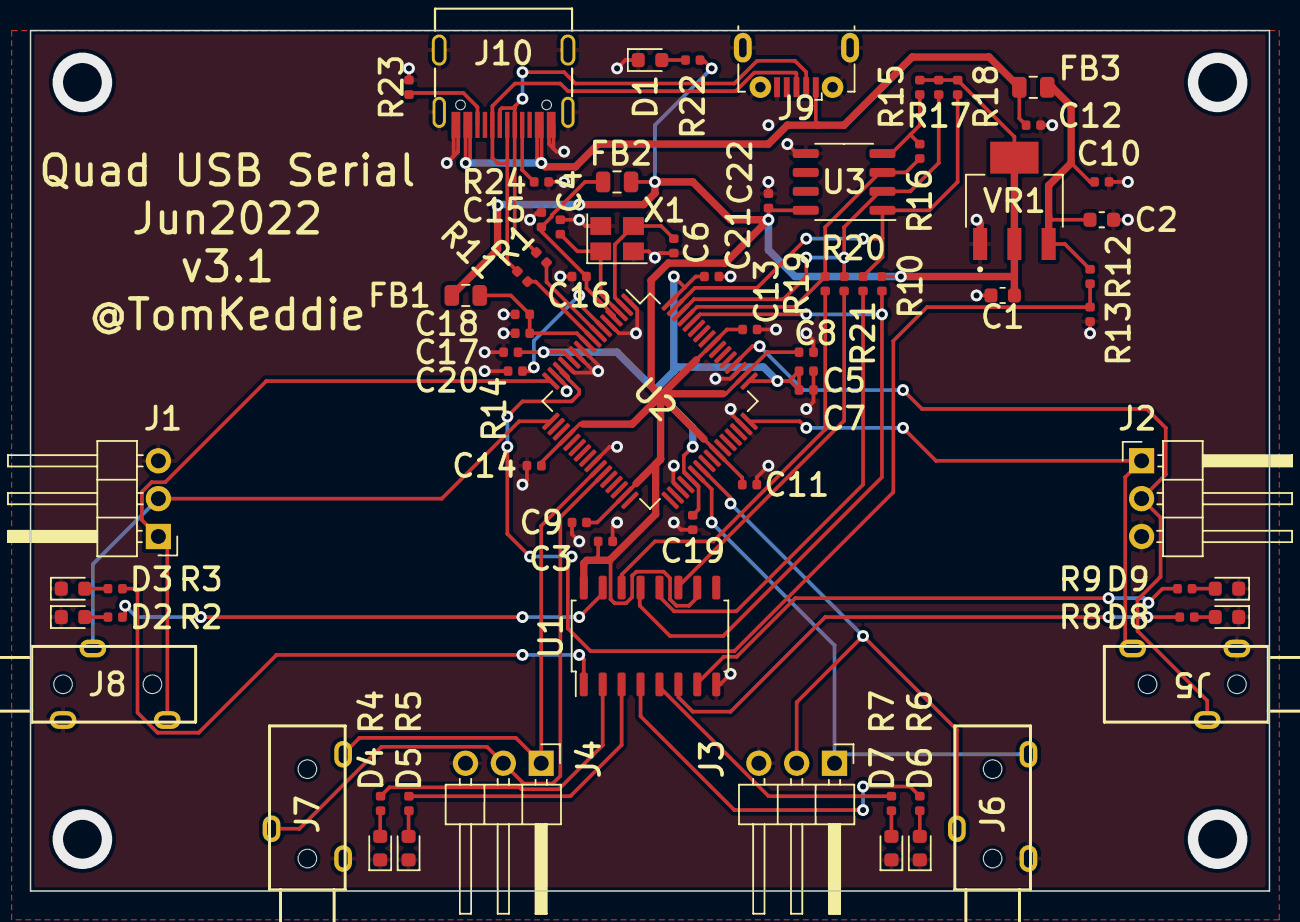
[picture p192: board ft4232h-breakout/v3.x/ft4232h-breakout.kicad_pcb from above]

Board: 2 copper layers, 83.2 x 57.8 mm, 73 parts (0 on the bottom side), 50 nets.
