TomKeddie/prj-pcb-experiments/2025-mipi-rpi-conv-dsi/2025-mipi-rpi-conv-dsi.kicad_pcb

## KiCad design 2025-mipi-rpi-conv-dsi/2025-mipi-rpi-conv-dsi.kicad_pcb (2025-08-31)

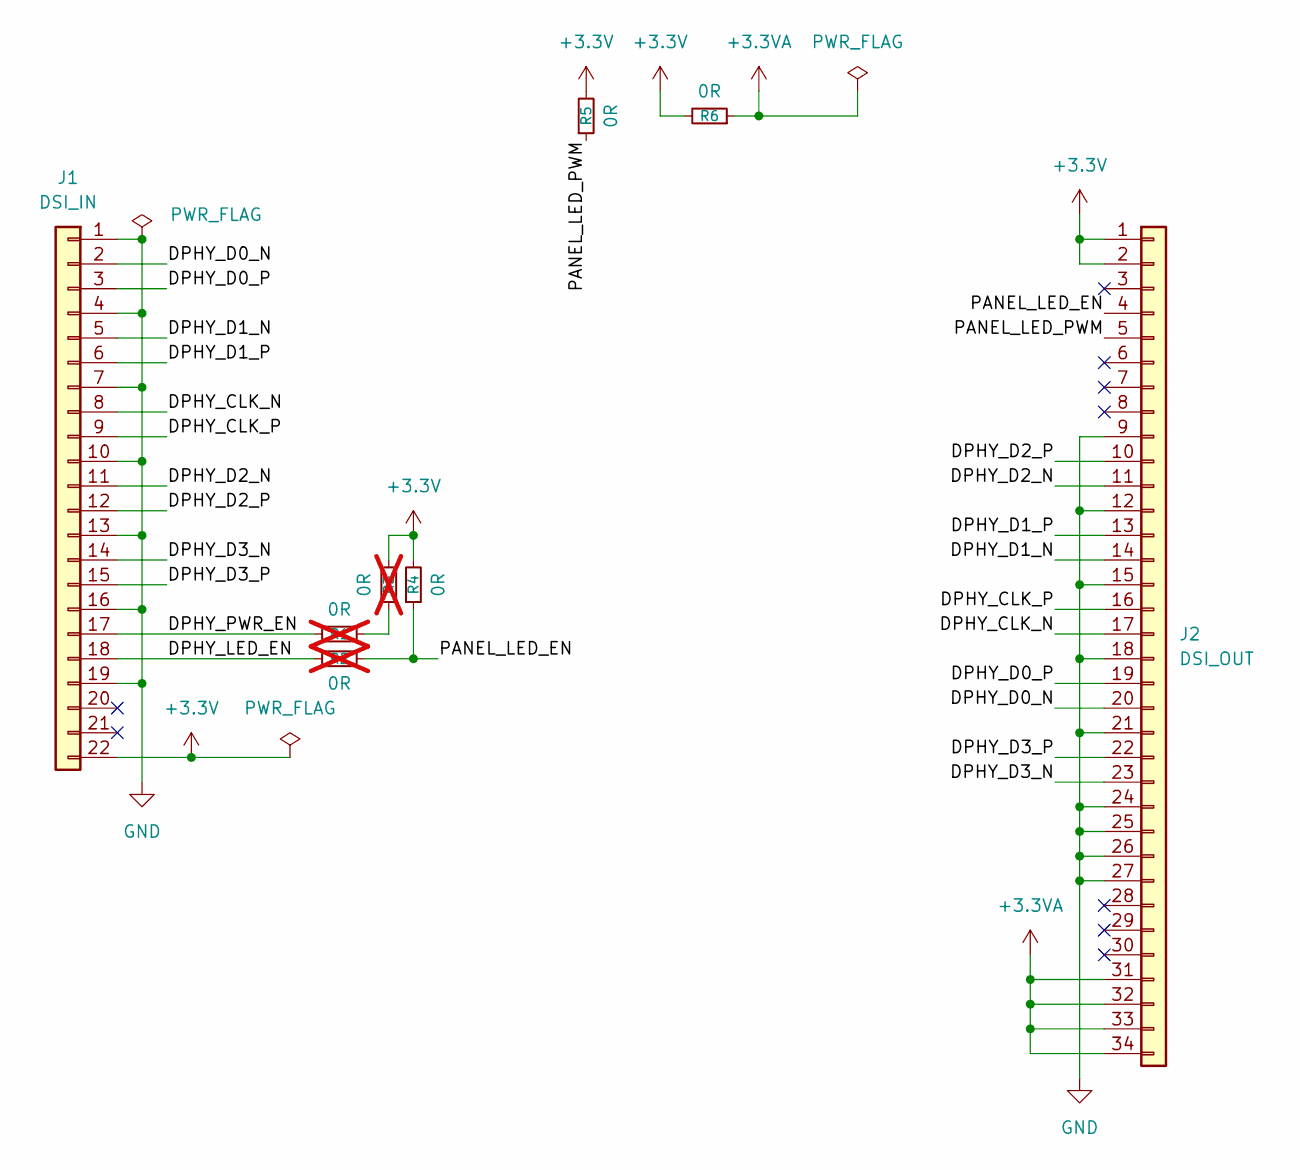
[picture p193: schematic 2025-mipi-rpi-conv-dsi.kicad_sch]

Parts:
J1: DSI_IN; AliExpress_1x22_P0.5mm_Horizontal_Drawer
J2: DSI_OUT; AliExpress_1x34_P0.5mm_Horizontal_Drawer
R1, R2, R3: 0R; R_0603_1608Metric; not fitted
R4, R5, R6: 0R; R_0603_1608Metric

Connections:
+3.3V: J1.22, J2.1, J2.2, R3.2, R4.2, R5.2, R6.2
+3.3VA: J2.31, J2.32, J2.33, J2.34, R6.1
/DPHY_CLK_N: J1.8, J2.17
/DPHY_CLK_P: J1.9, J2.16
/DPHY_D0_N: J1.2, J2.20
/DPHY_D0_P: J1.3, J2.19
/DPHY_D1_N: J1.5, J2.14
/DPHY_D1_P: J1.6, J2.13
/DPHY_D2_N: J1.11, J2.11
/DPHY_D2_P: J1.12, J2.10
/DPHY_D3_N: J1.14, J2.23
/DPHY_D3_P: J1.15, J2.22
/DPHY_LED_EN: J1.18, R2.1
/DPHY_PWR_EN: J1.17, R1.1
/PANEL_LED_EN: J2.4, R2.2, R4.1
/PANEL_LED_PWM: J2.5, R5.1
GND: J1.1, J1.4, J1.7, J1.10, J1.13, J1.16, J1.19, J2.9, J2.12, J2.15, J2.18, J2.21, J2.24, J2.25, J2.26, J2.27
unnamed: R1.2, R3.1

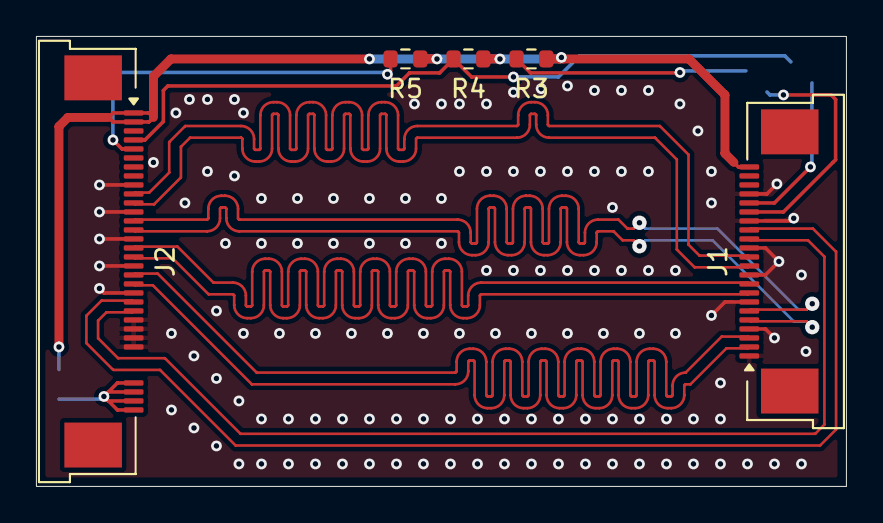
[picture p194: board 2025-mipi-rpi-conv-dsi.kicad_pcb from above]

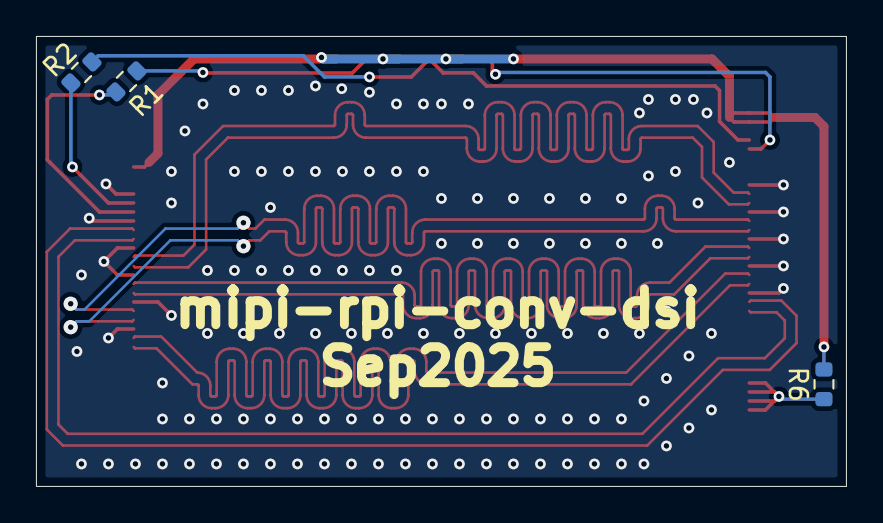
[picture p195: board 2025-mipi-rpi-conv-dsi.kicad_pcb from below]

Board: 2 copper layers, 45.0 x 25.0 mm, 8 parts (3 on the bottom side), 18 nets.
