TomKeddie/prj-pcb-experiments/2025-pmod-sma/2025-pmod-sma.kicad_pcb

## KiCad design 2025-pmod-sma/2025-pmod-sma.kicad_pcb (2025-08-31)

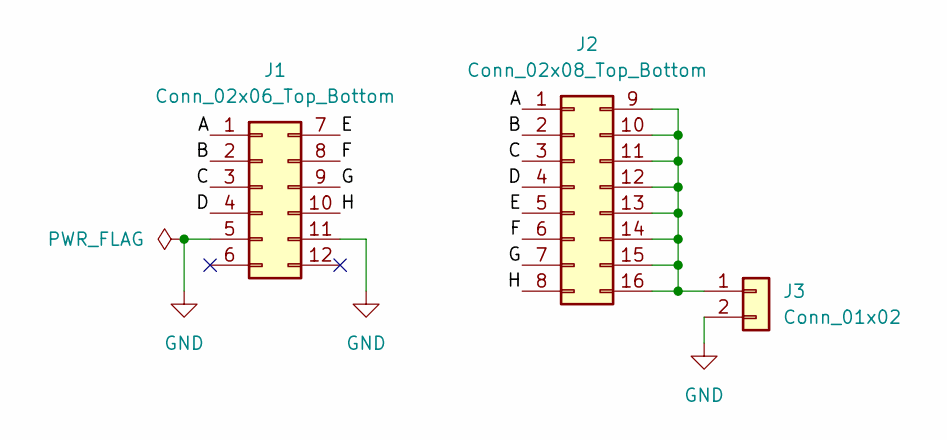
[picture p196: schematic 2025-pmod-sma.kicad_sch]

Parts:
J1: Conn_02x06_Top_Bottom; PinHeader_2x06_P2.54mm_Horizontal_Top_Bottom
J2: Conn_02x08_Top_Bottom; PinHeader_2x08_P2.54mm_Vertical_Top_Bottom
J3: Conn_01x02; SMA_Amphenol_901-143_Horizontal

Connections:
/A: J1.1, J2.1
/B: J1.2, J2.2
/C: J1.3, J2.3
/D: J1.4, J2.4
/E: J1.7, J2.5
/F: J1.8, J2.6
/G: J1.9, J2.7
/H: J1.10, J2.8
GND: J1.5, J1.11, J3.2
unnamed: J2.9, J2.10, J2.11, J2.12, J2.13, J2.14, J2.15, J2.16, J3.1

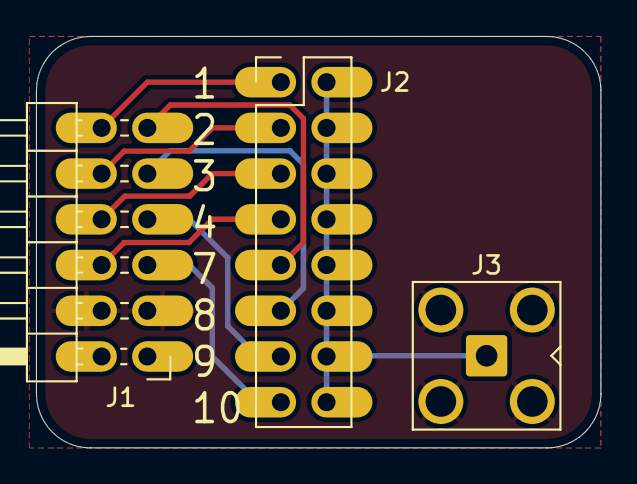
[picture p197: board 2025-pmod-sma.kicad_pcb from above]

Board: 2 copper layers, 31.4 x 22.9 mm, 3 parts (0 on the bottom side), 10 nets.
