TomKeddie/prj-pcb-experiments/2025-flex-spiral/one/2025-flex-spiral.kicad_pcb

## KiCad design 2025-flex-spiral/one/2025-flex-spiral.kicad_pcb (continued)

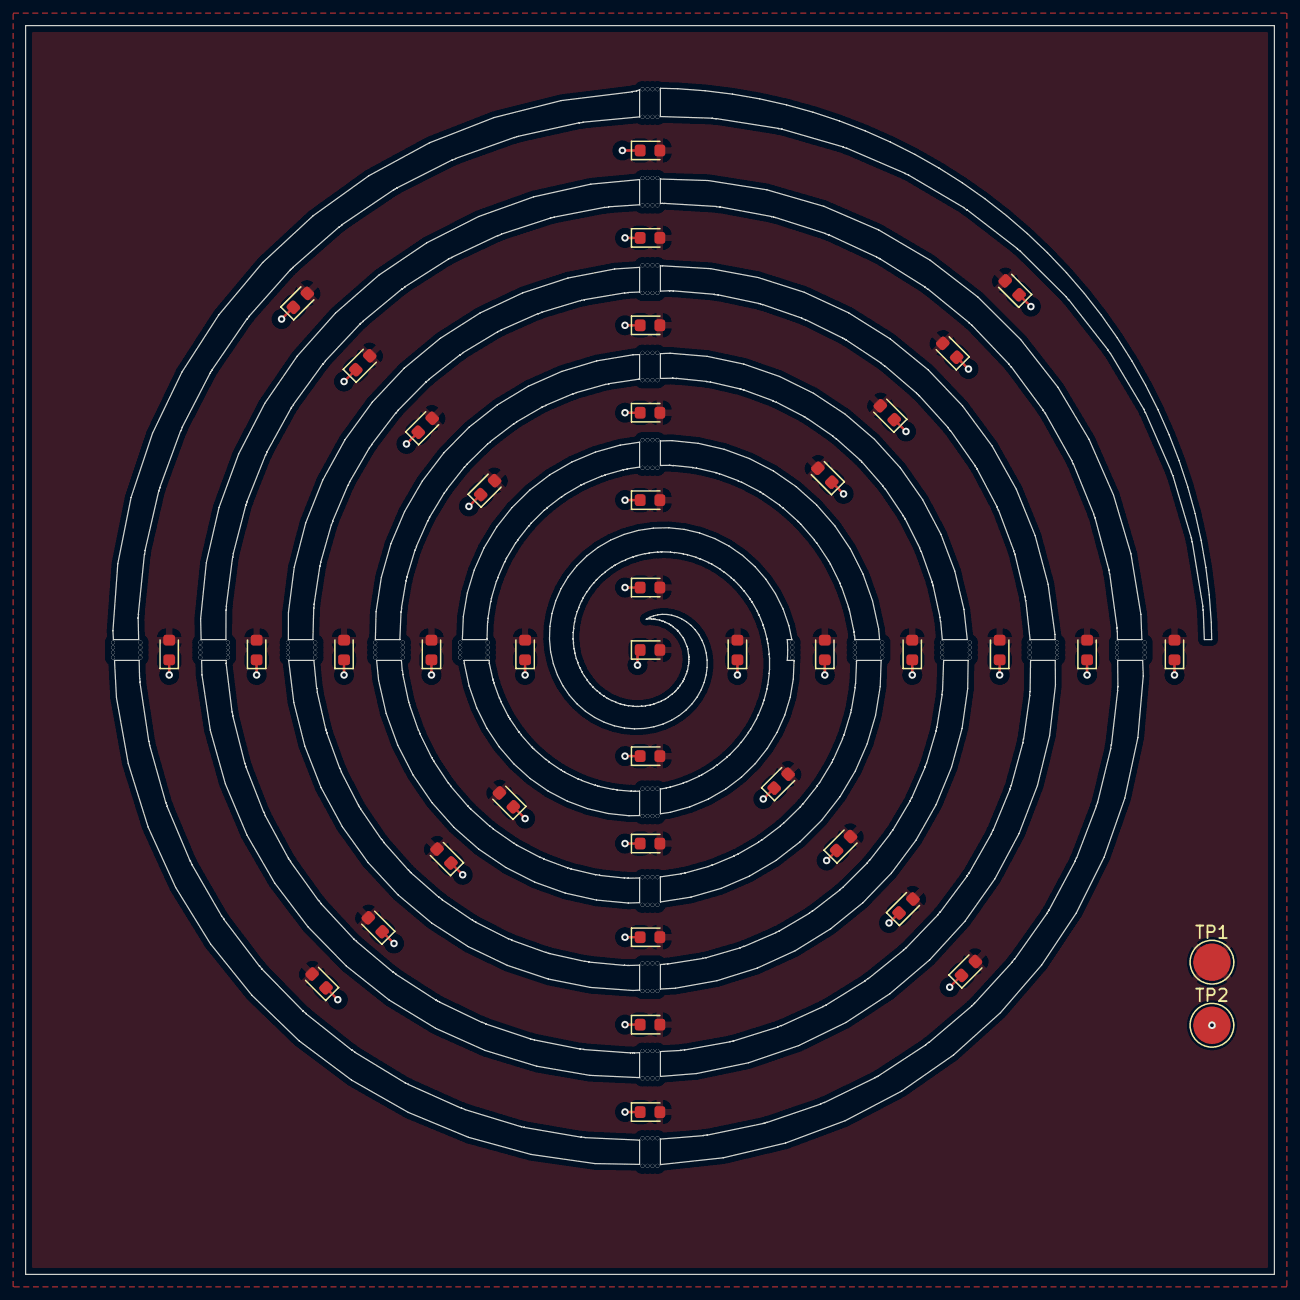
[picture p201: board 2025-flex-spiral.kicad_pcb from above]

Board: 2 copper layers, 100.0 x 100.0 mm, 41 parts (0 on the bottom side), 2 nets.
