TomKeddie/prj-pcb-experiments/2025-usb-pd-plank/kicad/usb-pd-plank.kicad_pcb

## KiCad design 2025-usb-pd-plank/kicad/usb-pd-plank.kicad_pcb (2025-05-09)

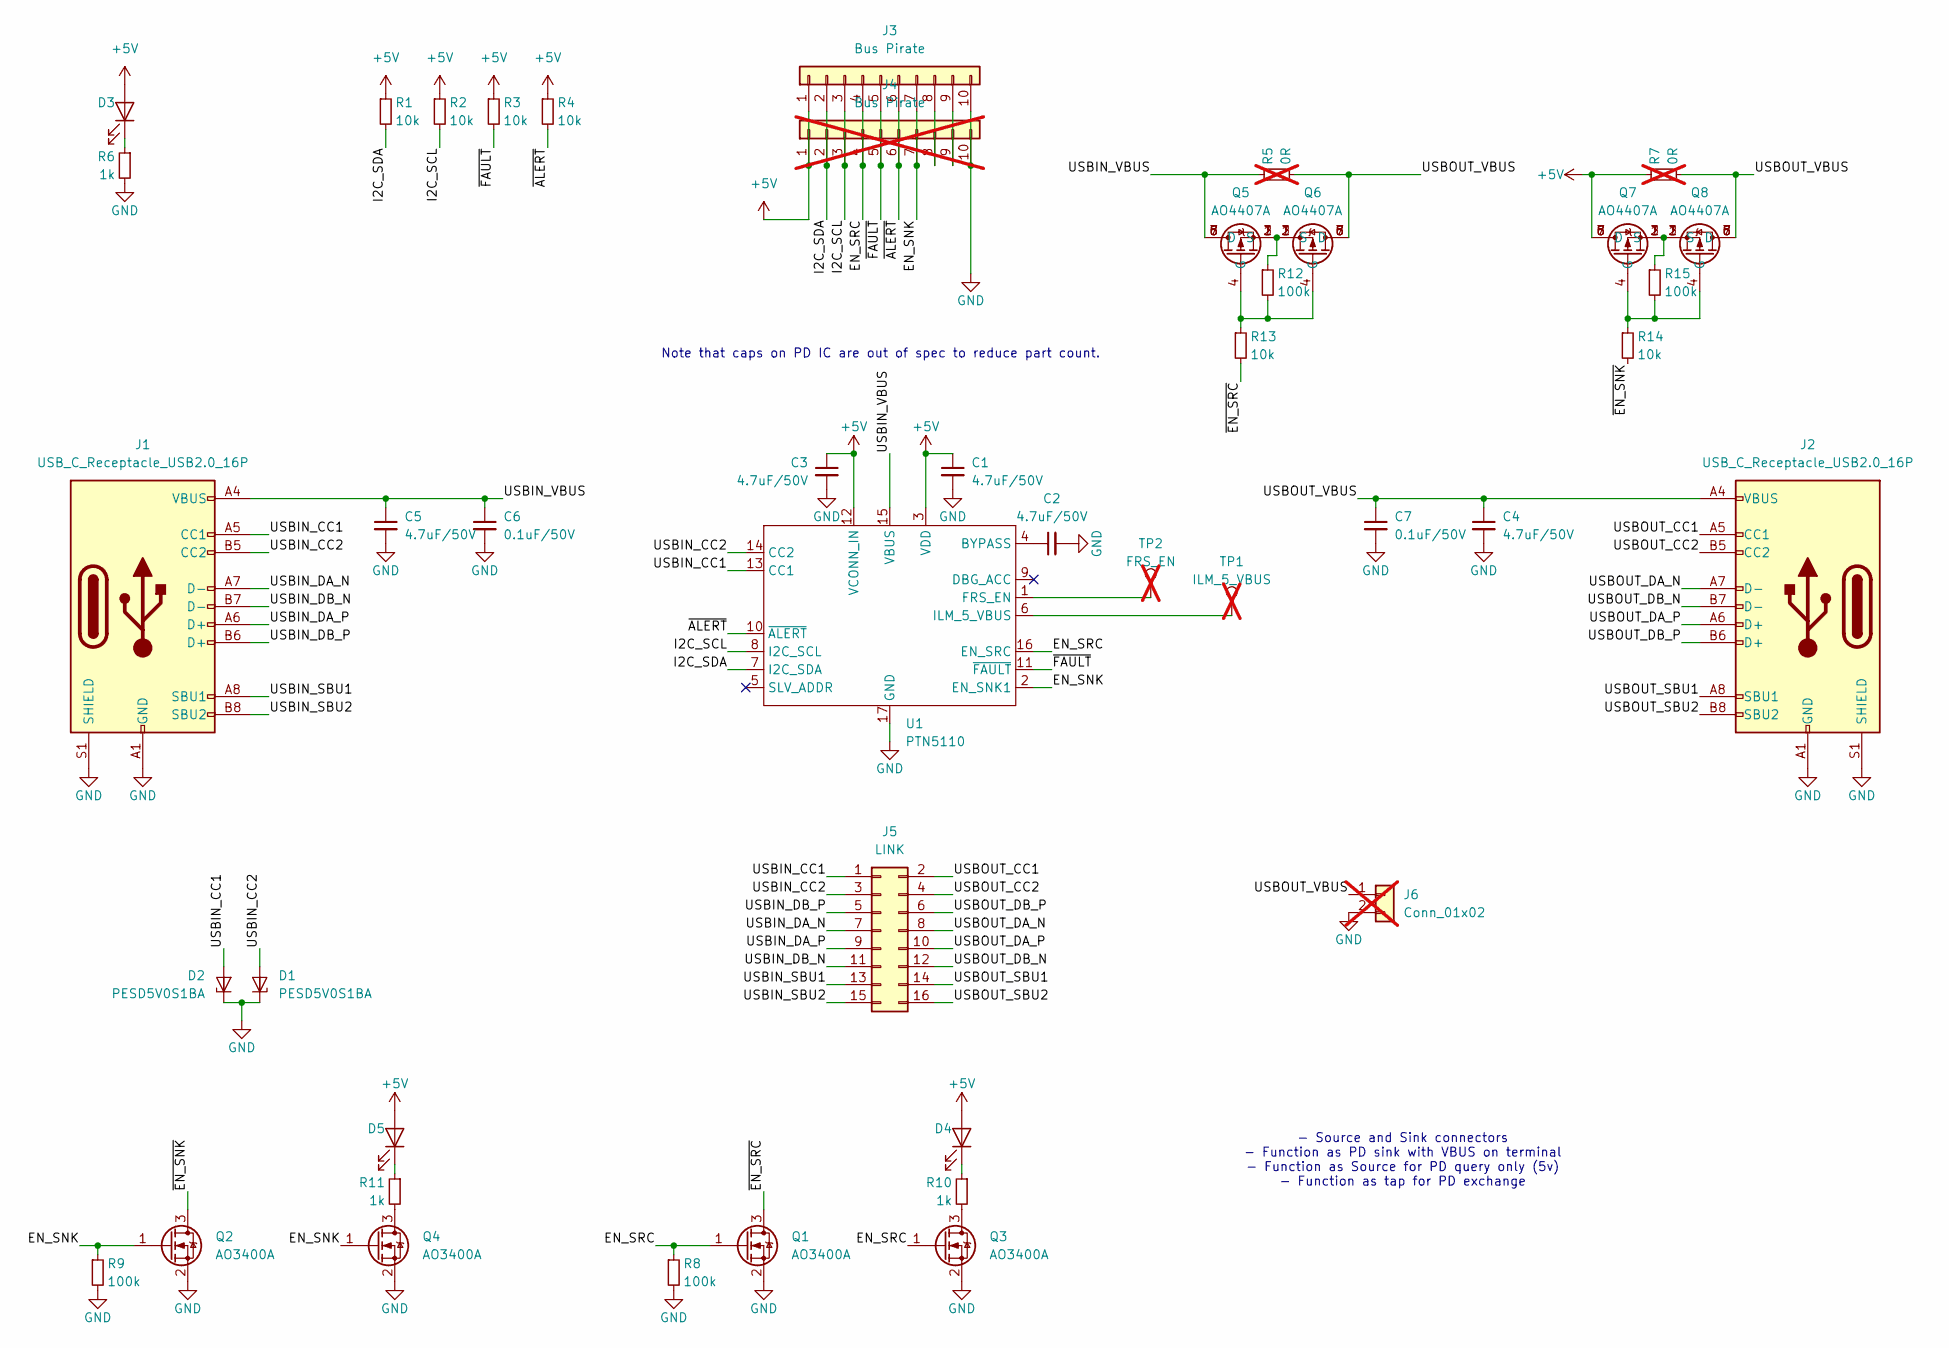
[picture p202: schematic usb-pd-plank.kicad_sch]

Parts:
C1, C2, C3, C4, C5: 4.7uF/50V; C_1206_3216Metric; LCSC C29823
C6, C7: 0.1uF/50V; C_1206_3216Metric; LCSC C24497
D1, D2: PESD5V0S1BA; D_SOD-323; LCSC C19224
D3, D4, D5: GREEN; LED_0805_2012Metric; LCSC C2297
J1, J2: USB_C_Receptacle_USB2.0_16P; USB_C_Receptacle_LCSC_C165948; LCSC C165948
J3: Bus Pirate; PinSocket_1x10_P2.54mm_Horizontal
J4: Bus Pirate; PinSocket_1x10_P2.54mm_Vertical; not fitted
J5: LINK; PinHeader_2x08_P2.54mm_Vertical
J6: Conn_01x02; JST_PH_S2B-PH-SM4-TB_1x02-1MP_P2.00mm_Horizontal; not fitted
Q1, Q2, Q3, Q4: AO3400A; SOT-23-GSD; LCSC C20917
Q5, Q6, Q7, Q8: AO4407A; SO-8_3.9x4.9mm_P1.27mm
R1, R2, R3, R4, R13, R14: 10k; R_0402_1005Metric; LCSC C25744
R5, R7: 0R; R_0402_1005Metric; LCSC C17168; not fitted
R6, R10, R11: 1k; R_0402_1005Metric; MFGPN 0402WGF1001TCE; LCSC C11702
R8, R9, R12, R15: 100k; R_0402_1005Metric; MFGPN 0402WGF1003TCE; LCSC C25741
TP1: ILM_5_VBUS; TestPoint_Pad_D1.5mm; not fitted
TP2: FRS_EN; TestPoint_Pad_D1.5mm; not fitted
U1: PTN5110; QFN-16_EP_2.6x2.6_Pitch0.4mm; LCSC C2674062

Connections:
+5V: C1.1, C3.1, D3.2 (A), D4.2 (A), D5.2 (A), J3.1, J4.1, Q7.5 (D), Q7.6 (D), Q7.7 (D), Q7.8 (D), R1.1, R2.1, R3.1, R4.1, R7.1, U1.3 (VDD), U1.12 (VCONN_IN)
/EN_SNK: J3.7, J4.7, Q2.1 (G), Q4.1 (G), R9.1, U1.2 (EN_SNK1)
/EN_SRC: J3.4, J4.4, Q1.1 (G), Q3.1 (G), R8.1, U1.16 (EN_SRC)
/I2C_SCL: J3.3, J4.3, R2.2, U1.8 (I2C_SCL)
/I2C_SDA: J3.2, J4.2, R1.2, U1.7 (I2C_SDA)
/USBIN_CC1: D2.2 (A), J1.A5 (CC1), J5.1, U1.13 (CC1)
/USBIN_CC2: D1.2 (A), J1.B5 (CC2), J5.3, U1.14 (CC2)
/USBIN_DA_N: J1.A7 (D-), J5.7
/USBIN_DA_P: J1.A6 (D+), J5.9
/USBIN_DB_N: J1.B7 (D-), J5.11
/USBIN_DB_P: J1.B6 (D+), J5.5
/USBIN_SBU1: J1.A8 (SBU1), J5.13
/USBIN_SBU2: J1.B8 (SBU2), J5.15
/USBIN_VBUS: C5.1, C6.1, J1.A4 (VBUS), J1.A9 (VBUS), J1.B4 (VBUS), J1.B9 (VBUS), Q5.5 (D), Q5.6 (D), Q5.7 (D), Q5.8 (D), R5.1, U1.15 (VBUS)
/USBOUT_CC1: J2.A5 (CC1), J5.2
/USBOUT_CC2: J2.B5 (CC2), J5.4
/USBOUT_DA_N: J2.A7 (D-), J5.8
/USBOUT_DA_P: J2.A6 (D+), J5.10
/USBOUT_DB_N: J2.B7 (D-), J5.12
/USBOUT_DB_P: J2.B6 (D+), J5.6
/USBOUT_SBU1: J2.A8 (SBU1), J5.14
/USBOUT_SBU2: J2.B8 (SBU2), J5.16
/USBOUT_VBUS: C4.1, C7.1, J2.A4 (VBUS), J2.A9 (VBUS), J2.B4 (VBUS), J2.B9 (VBUS), J6.1, Q6.5 (D), Q6.6 (D), Q6.7 (D), Q6.8 (D), Q8.5 (D), Q8.6 (D), Q8.7 (D), Q8.8 (D), R5.2, R7.2
/~ALERT: J3.6, J4.6, R4.2, U1.10 (~ALERT)
/~EN_SNK: Q2.3 (D), R14.2
/~EN_SRC: Q1.3 (D), R13.2
/~FAULT: J3.5, J4.5, R3.2, U1.11 (~FAULT)
GND: C1.2, C2.2, C3.2, C4.2, C5.2, C6.2, C7.2, D1.1 (K1), D2.1 (K1), J1.A1 (GND), J1.A12 (GND), J1.B1 (GND), J1.B12 (GND), J1.S1 (SHIELD), J2.A1 (GND), J2.A12 (GND), J2.B1 (GND), J2.B12 (GND), J2.S1 (SHIELD), J3.10, J4.10, J6.2, Q1.2 (S), Q2.2 (S), Q3.2 (S), Q4.2 (S), R6.2, R8.2, R9.2, U1.17 (GND)
unnamed: D3.1 (K), R6.1
unnamed: D4.1 (K), R10.1
unnamed: D5.1 (K), R11.1
unnamed: J3.8, J4.8
unnamed: J3.9, J4.9
unnamed: Q3.3 (D), R10.2
unnamed: Q4.3 (D), R11.2
unnamed: Q5.4 (G), Q6.4 (G), R12.2, R13.1
unnamed: Q5.1 (S), Q5.2 (S), Q5.3 (S), Q6.1 (S), Q6.2 (S), Q6.3 (S), R12.1
unnamed: Q7.4 (G), Q8.4 (G), R14.1, R15.2
unnamed: Q7.1 (S), Q7.2 (S), Q7.3 (S), Q8.1 (S), Q8.2 (S), Q8.3 (S), R15.1
unnamed: C2.1, U1.4 (BYPASS)
unnamed: TP2.1, U1.1 (FRS_EN)
unnamed: TP1.1, U1.6 (ILM_5_VBUS)

Notes on the sheet:
Note that caps on PD IC are out of spec to reduce part count.
- Source and Sink connectors - Function as PD sink with VBUS on terminal - Function as Source for PD query only (5v) - Function as tap for PD exchange

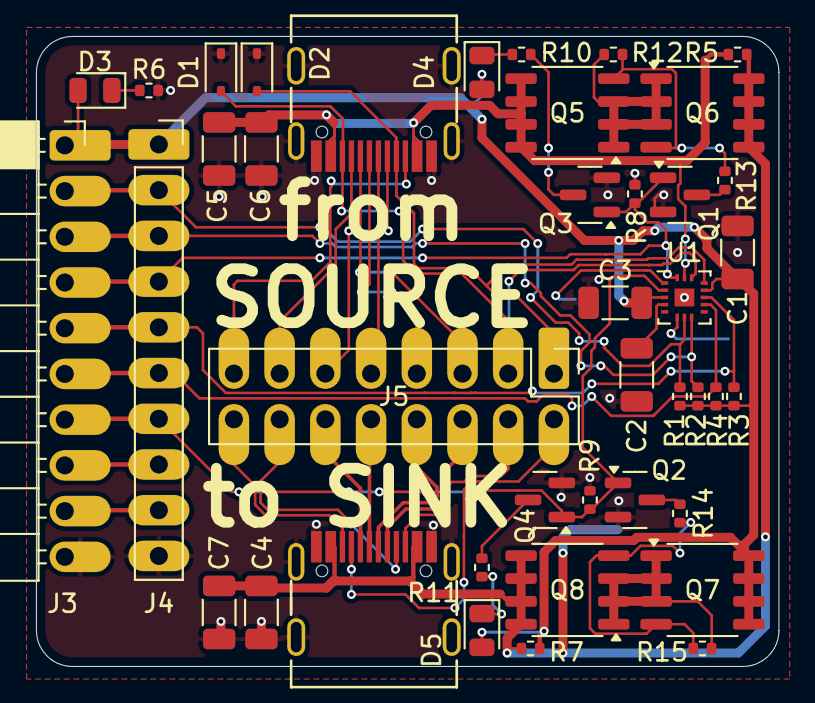
[picture p203: board usb-pd-plank.kicad_pcb from above]

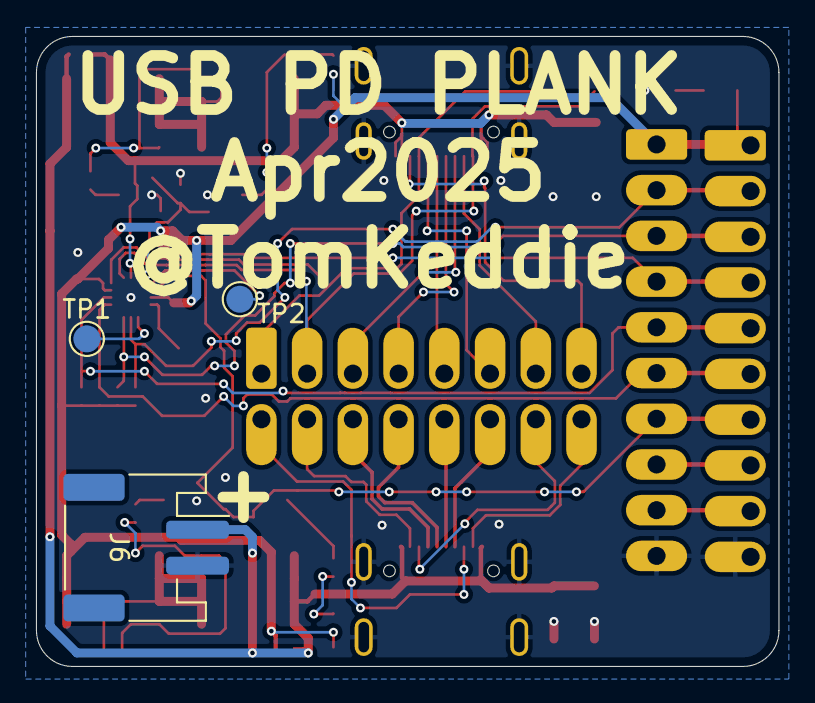
[picture p204: board usb-pd-plank.kicad_pcb from below]

Board: 2 copper layers, 41.2 x 35.0 mm, 44 parts (3 on the bottom side), 42 nets.
