TomKeddie/prj-pcb-experiments/2024-rfid-sao/2024-rfid-sao.kicad_pcb

## KiCad design 2024-rfid-sao/2024-rfid-sao.kicad_pcb (2024-11-21)

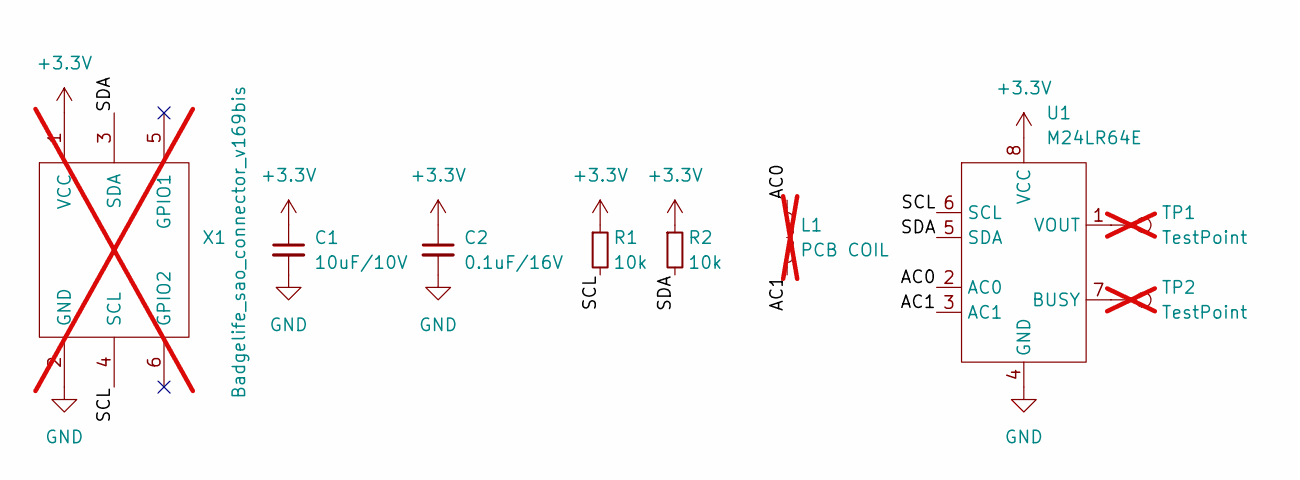
[picture p205: schematic 2024-rfid-sao.kicad_sch]

Parts:
C1: 10uF/10V; C_0603_1608Metric; LCSC C19702
C2: 0.1uF/16V; C_0402_1005Metric; LCSC C1525
L1: PCB COIL; nrf_r20; not fitted
R1, R2: 10k; R_0402_1005Metric; LCSC C25744
TP1, TP2: TestPoint; TestPoint_Pad_D2.0mm; not fitted
U1: M24LR64E; SOIC-8_3.9x4.9mm_P1.27mm; LCSC C157372
X1: Badgelife_sao_connector_v169bis; PinHeader_2x03_P2.54mm_Vertical; not fitted

Connections:
+3.3V: C1.1, C2.1, R1.1, R2.1, U1.8 (VCC), X1.1 (VCC)
/AC0: L1.1, U1.2 (AC0)
/AC1: L1.2, U1.3 (AC1)
/SCL: R1.2, U1.6 (SCL), X1.4 (SCL)
/SDA: R2.2, U1.5 (SDA), X1.3 (SDA)
GND: C1.2, C2.2, U1.4 (GND), X1.2 (GND)
unnamed: TP2.1, U1.7 (BUSY)
unnamed: TP1.1, U1.1 (VOUT)

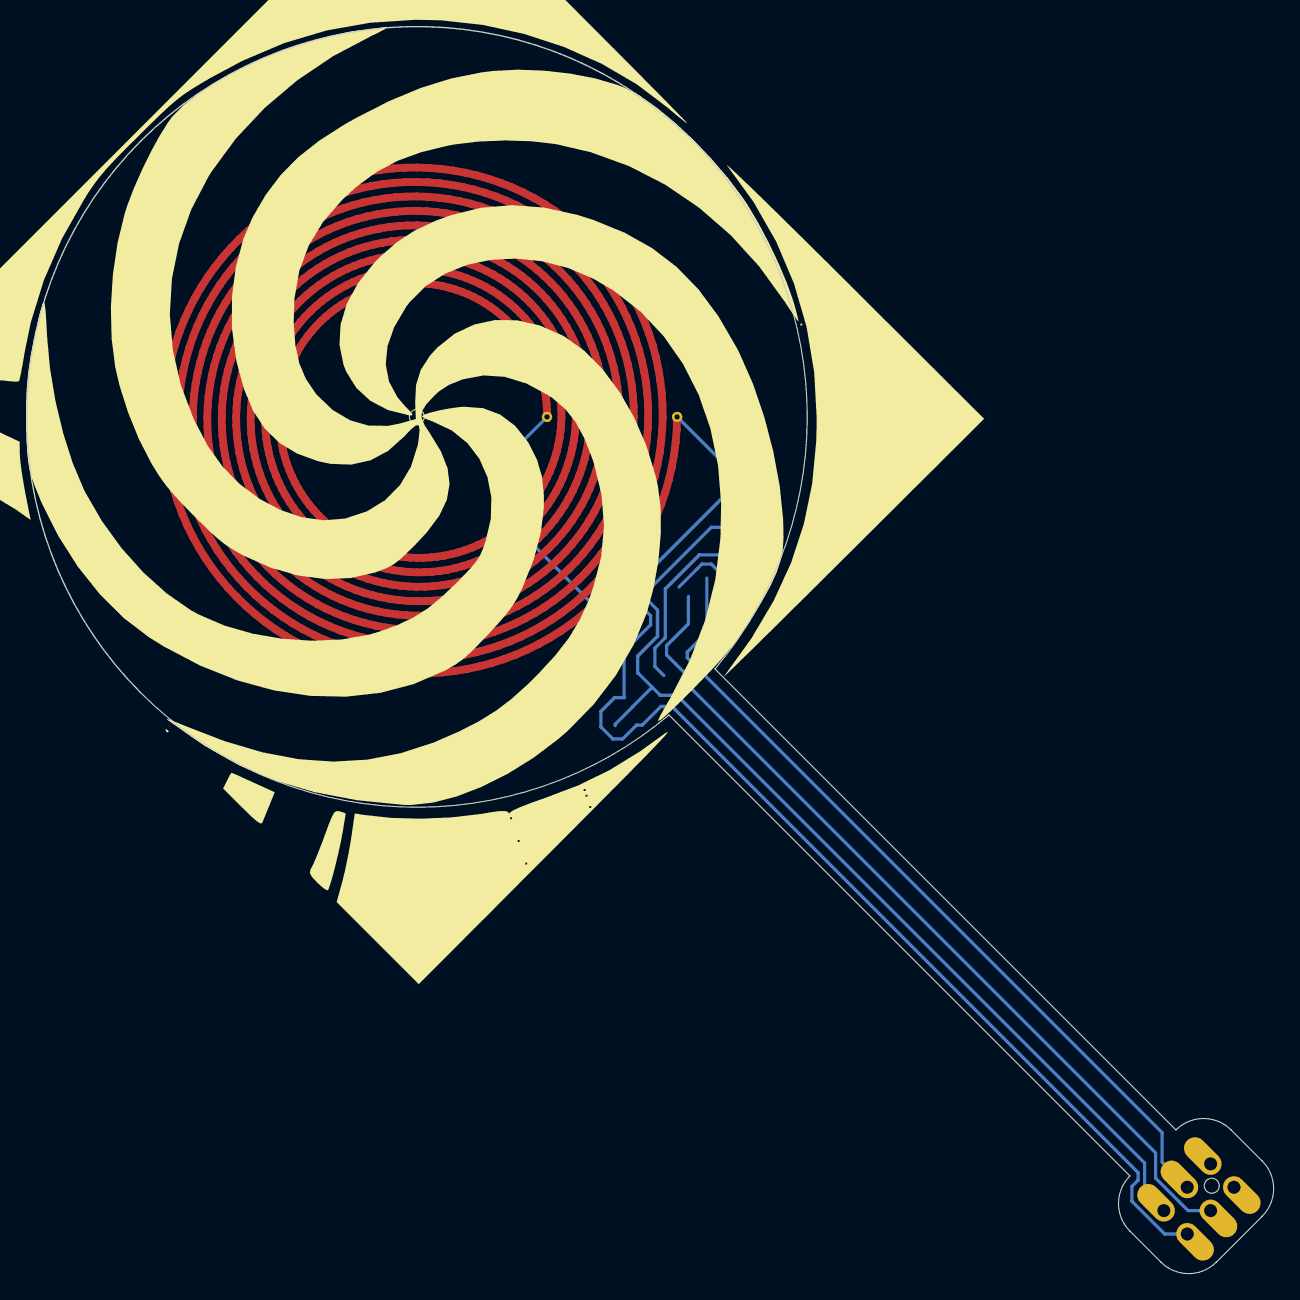
[picture p206: board 2024-rfid-sao.kicad_pcb from above]

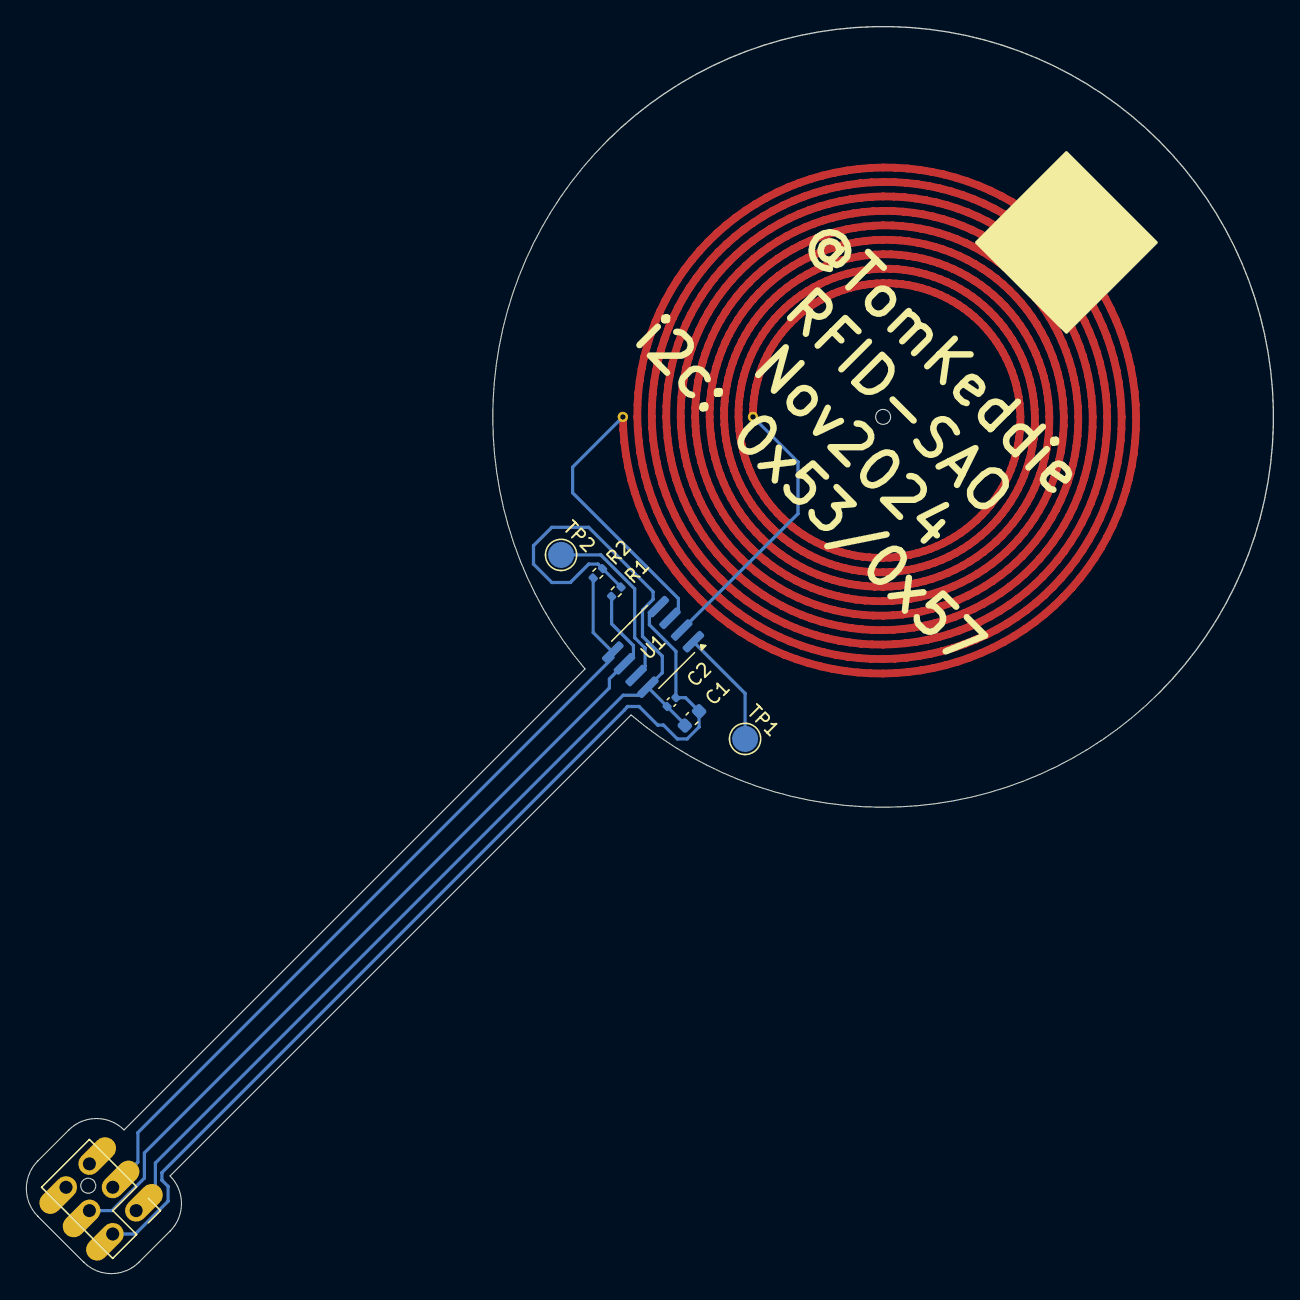
[picture p207: board 2024-rfid-sao.kicad_pcb from below]

Board: 2 copper layers, 95.8 x 95.8 mm, 9 parts (8 on the bottom side), 8 nets.
