TomKeddie/prj-pcb-experiments/2024-supercon-sign-sao/kicad/2024-supercon-sign-sao.kicad_pcb

## KiCad design 2024-supercon-sign-sao/kicad/2024-supercon-sign-sao.kicad_pcb (2024-11-13)

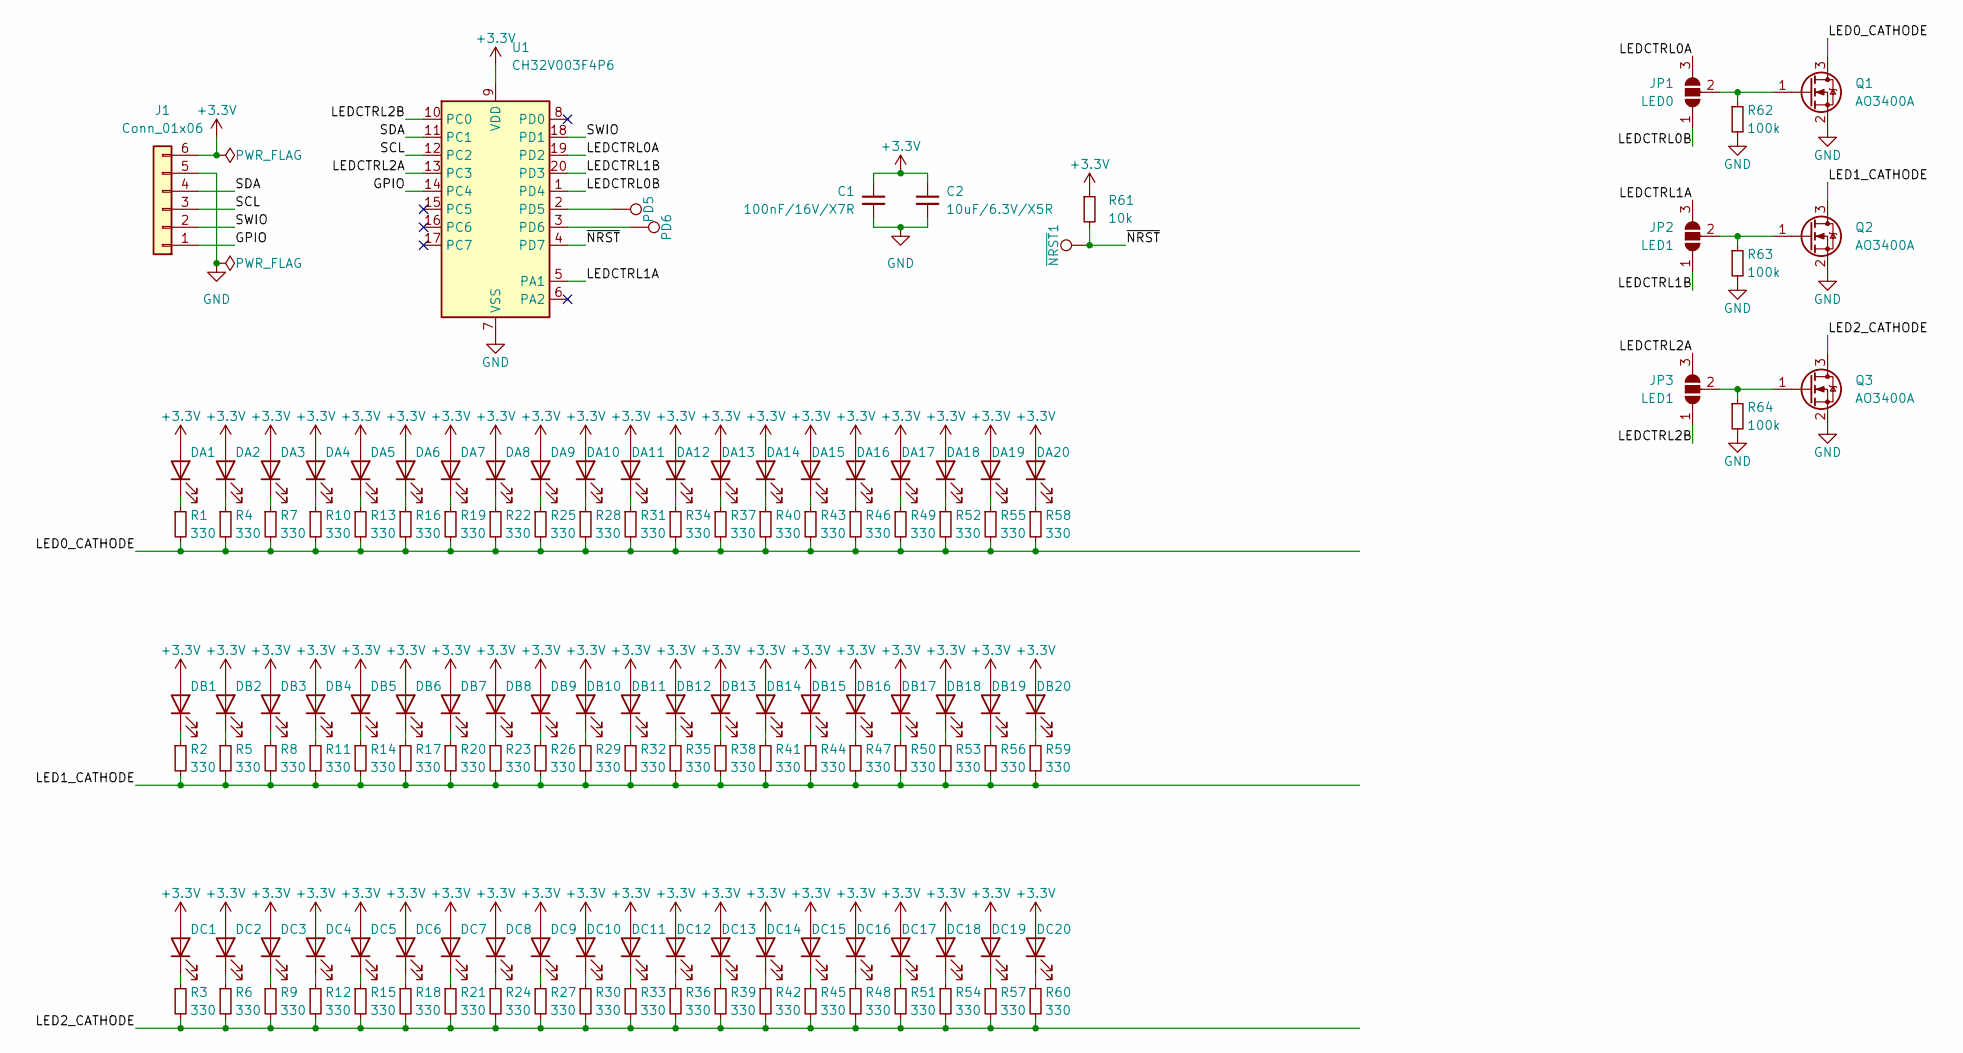
[picture p208: schematic 2024-supercon-sign-sao.kicad_sch]

Parts:
C1: 100nF/16V/X7R; C_0402_1005Metric; MFGPN CL05B104KO5NNNC; LCSC C1525
C2: 10uF/6.3V/X5R; C_0402_1005Metric; MFGPN CL05A106MQ5NUNC; LCSC C15525
DA1, DA2, DA3, DA4, DA5, DA6, DA7, DA8, DA9, DA10, DA11, DA12, DA13, DA14, DA15, DA16, DA17, DA18, DA19, DA20: LED_AMBER; LED_0603_1608Metric; LCSC C2286
DB1, DB2, DB3, DB4, DB5, DB6, DB7, DB8, DB9, DB10, DB11, DB12, DB13, DB14, DB15, DB16, DB17, DB18, DB19, DB20: LED_AMBER; LED_0603_1608Metric; LCSC C2286
DC1, DC2, DC3, DC4, DC5, DC6, DC7, DC8, DC9, DC10, DC11, DC12, DC13, DC14, DC15, DC16, DC17, DC18, DC19, DC20: LED_AMBER; LED_0603_1608Metric; LCSC C2286
J1: Conn_01x06; PinHeader_2x03_P2.54mm_Vertical
JP1: LED0; SolderJumper-3_P1.3mm_Open_RoundedPad1.0x1.5mm
JP2, JP3: LED1; SolderJumper-3_P1.3mm_Open_RoundedPad1.0x1.5mm
PD5, PD6: TestPoint; TestPoint_Pad_D2.0mm
Q1, Q2, Q3: AO3400A; SOT-23-GSD; LCSC C20917
R1, R2, R3, R4, R5, R6, R7, R8, R9, R10, R11, R12, R13, R14, R15, R16, R17, R18, R19, R20, R21, R22, R23, R24, R25, R26, R27, R28, R29, R30, R31, R32, R33, R34, R35, R36, R37, R38, R39, R40, R41, R42, R43, R44, R45, R46, R47, R48, R49, R50, R51, R52, R53, R54, R55, R56, R57, R58, R59, R60: 330; R_0402_1005Metric; MFGPN 0402WGF3300TCE; LCSC C25104
R61: 10k; R_0402_1005Metric; MFGPN 0402WGF1002TCE; LCSC C25744
R62, R63, R64: 100k; R_0402_1005Metric; MFGPN 0402WGF1003TCE; LCSC C25741
U1: CH32V003F4P6; TSSOP-20_4.4x6.5mm_P0.65mm; LCSC C5187096
~{NRST}1: ~{NRST}; TestPoint_Pad_D2.0mm

Connections:
+3.3V: C1.1, C2.1, DA1.2 (A), DA2.2 (A), DA3.2 (A), DA4.2 (A), DA5.2 (A), DA6.2 (A), DA7.2 (A), DA8.2 (A), DA9.2 (A), DA10.2 (A), DA11.2 (A), DA12.2 (A), DA13.2 (A), DA14.2 (A), DA15.2 (A), DA16.2 (A), DA17.2 (A), DA18.2 (A), DA19.2 (A), DA20.2 (A), DB1.2 (A), DB2.2 (A), DB3.2 (A), DB4.2 (A), DB5.2 (A), DB6.2 (A), DB7.2 (A), DB8.2 (A), DB9.2 (A), DB10.2 (A), DB11.2 (A), DB12.2 (A), DB13.2 (A), DB14.2 (A), DB15.2 (A), DB16.2 (A), DB17.2 (A), DB18.2 (A), DB19.2 (A), DB20.2 (A), DC1.2 (A), DC2.2 (A), DC3.2 (A), DC4.2 (A), DC5.2 (A), DC6.2 (A), DC7.2 (A), DC8.2 (A), DC9.2 (A), DC10.2 (A), DC11.2 (A), DC12.2 (A), DC13.2 (A), DC14.2 (A), DC15.2 (A), DC16.2 (A), DC17.2 (A), DC18.2 (A), DC19.2 (A), DC20.2 (A), J1.6, R61.1, U1.9 (VDD)
/GPIO: J1.1, U1.14 (PC4)
/LED0_CATHODE: Q1.3 (D), R1.2, R4.2, R7.2, R10.2, R13.2, R16.2, R19.2, R22.2, R25.2, R28.2, R31.2, R34.2, R37.2, R40.2, R43.2, R46.2, R49.2, R52.2, R55.2, R58.2
/LED1_CATHODE: Q2.3 (D), R2.2, R5.2, R8.2, R11.2, R14.2, R17.2, R20.2, R23.2, R26.2, R29.2, R32.2, R35.2, R38.2, R41.2, R44.2, R47.2, R50.2, R53.2, R56.2, R59.2
/LED2_CATHODE: Q3.3 (D), R3.2, R6.2, R9.2, R12.2, R15.2, R18.2, R21.2, R24.2, R27.2, R30.2, R33.2, R36.2, R39.2, R42.2, R45.2, R48.2, R51.2, R54.2, R57.2, R60.2
/LEDCTRL0A: JP1.3 (B), U1.19 (PD2)
/LEDCTRL0B: JP1.1 (A), U1.1 (PD4)
/LEDCTRL1A: JP2.3 (B), U1.5 (PA1)
/LEDCTRL1B: JP2.1 (A), U1.20 (PD3)
/LEDCTRL2A: JP3.3 (B), U1.13 (PC3)
/LEDCTRL2B: JP3.1 (A), U1.10 (PC0)
/SCL: J1.3, U1.12 (PC2)
/SDA: J1.4, U1.11 (PC1)
/SWIO: J1.2, U1.18 (PD1)
/~NRST: R61.2, U1.4 (PD7), ~{NRST}1.1
GND: C1.2, C2.2, J1.5, Q1.2 (S), Q2.2 (S), Q3.2 (S), R62.2, R63.2, R64.2, U1.7 (VSS)
unnamed: DA1.1 (K), R1.1
unnamed: DA2.1 (K), R4.1
unnamed: DA3.1 (K), R7.1
unnamed: DA4.1 (K), R10.1
unnamed: DA5.1 (K), R13.1
unnamed: DA6.1 (K), R16.1
unnamed: DA7.1 (K), R19.1
unnamed: DA8.1 (K), R22.1
unnamed: DA9.1 (K), R25.1
unnamed: DA10.1 (K), R28.1
unnamed: DA11.1 (K), R31.1
unnamed: DA12.1 (K), R34.1
unnamed: DA13.1 (K), R37.1
unnamed: DA14.1 (K), R40.1
unnamed: DA15.1 (K), R43.1
unnamed: DA16.1 (K), R46.1
unnamed: DA17.1 (K), R49.1
unnamed: DA18.1 (K), R52.1
unnamed: DA19.1 (K), R55.1
unnamed: DA20.1 (K), R58.1
unnamed: DB1.1 (K), R2.1
unnamed: DB2.1 (K), R5.1
unnamed: DB3.1 (K), R8.1
unnamed: DB4.1 (K), R11.1
unnamed: DB5.1 (K), R14.1
unnamed: DB6.1 (K), R17.1
unnamed: DB7.1 (K), R20.1
unnamed: DB8.1 (K), R23.1
unnamed: DB9.1 (K), R26.1
unnamed: DB10.1 (K), R29.1
unnamed: DB11.1 (K), R32.1
unnamed: DB12.1 (K), R35.1
unnamed: DB13.1 (K), R38.1
unnamed: DB14.1 (K), R41.1
unnamed: DB15.1 (K), R44.1
unnamed: DB16.1 (K), R47.1
unnamed: DB17.1 (K), R50.1
unnamed: DB18.1 (K), R53.1
unnamed: DB19.1 (K), R56.1
unnamed: DB20.1 (K), R59.1
unnamed: DC1.1 (K), R3.1
unnamed: DC2.1 (K), R6.1
unnamed: DC3.1 (K), R9.1
unnamed: DC4.1 (K), R12.1
unnamed: DC5.1 (K), R15.1
unnamed: DC6.1 (K), R18.1
unnamed: DC7.1 (K), R21.1
unnamed: DC8.1 (K), R24.1
unnamed: DC9.1 (K), R27.1
unnamed: DC10.1 (K), R30.1
unnamed: DC11.1 (K), R33.1
unnamed: DC12.1 (K), R36.1
unnamed: DC13.1 (K), R39.1
unnamed: DC14.1 (K), R42.1
unnamed: DC15.1 (K), R45.1
unnamed: DC16.1 (K), R48.1
unnamed: DC17.1 (K), R51.1
unnamed: DC18.1 (K), R54.1
unnamed: DC19.1 (K), R57.1
unnamed: DC20.1 (K), R60.1
unnamed: JP1.2 (C), Q1.1 (G), R62.1
unnamed: JP2.2 (C), Q2.1 (G), R63.1
unnamed: JP3.2 (C), Q3.1 (G), R64.1
unnamed: PD5.1, U1.2 (PD5)
unnamed: PD6.1, U1.3 (PD6)

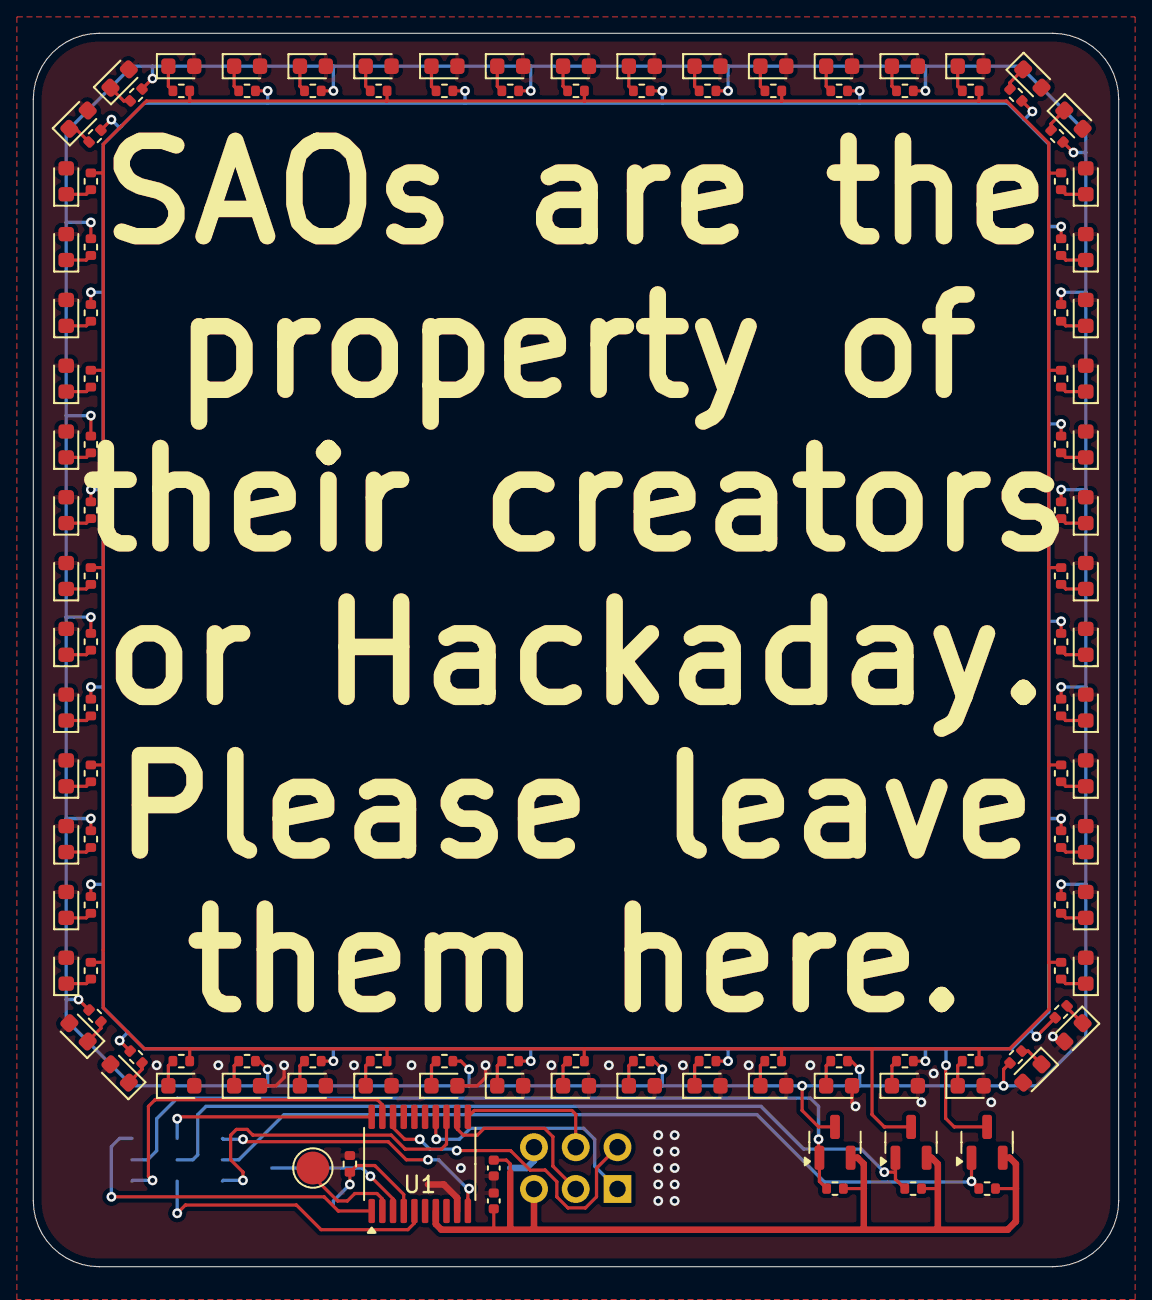
[picture p209: board 2024-supercon-sign-sao.kicad_pcb from above]

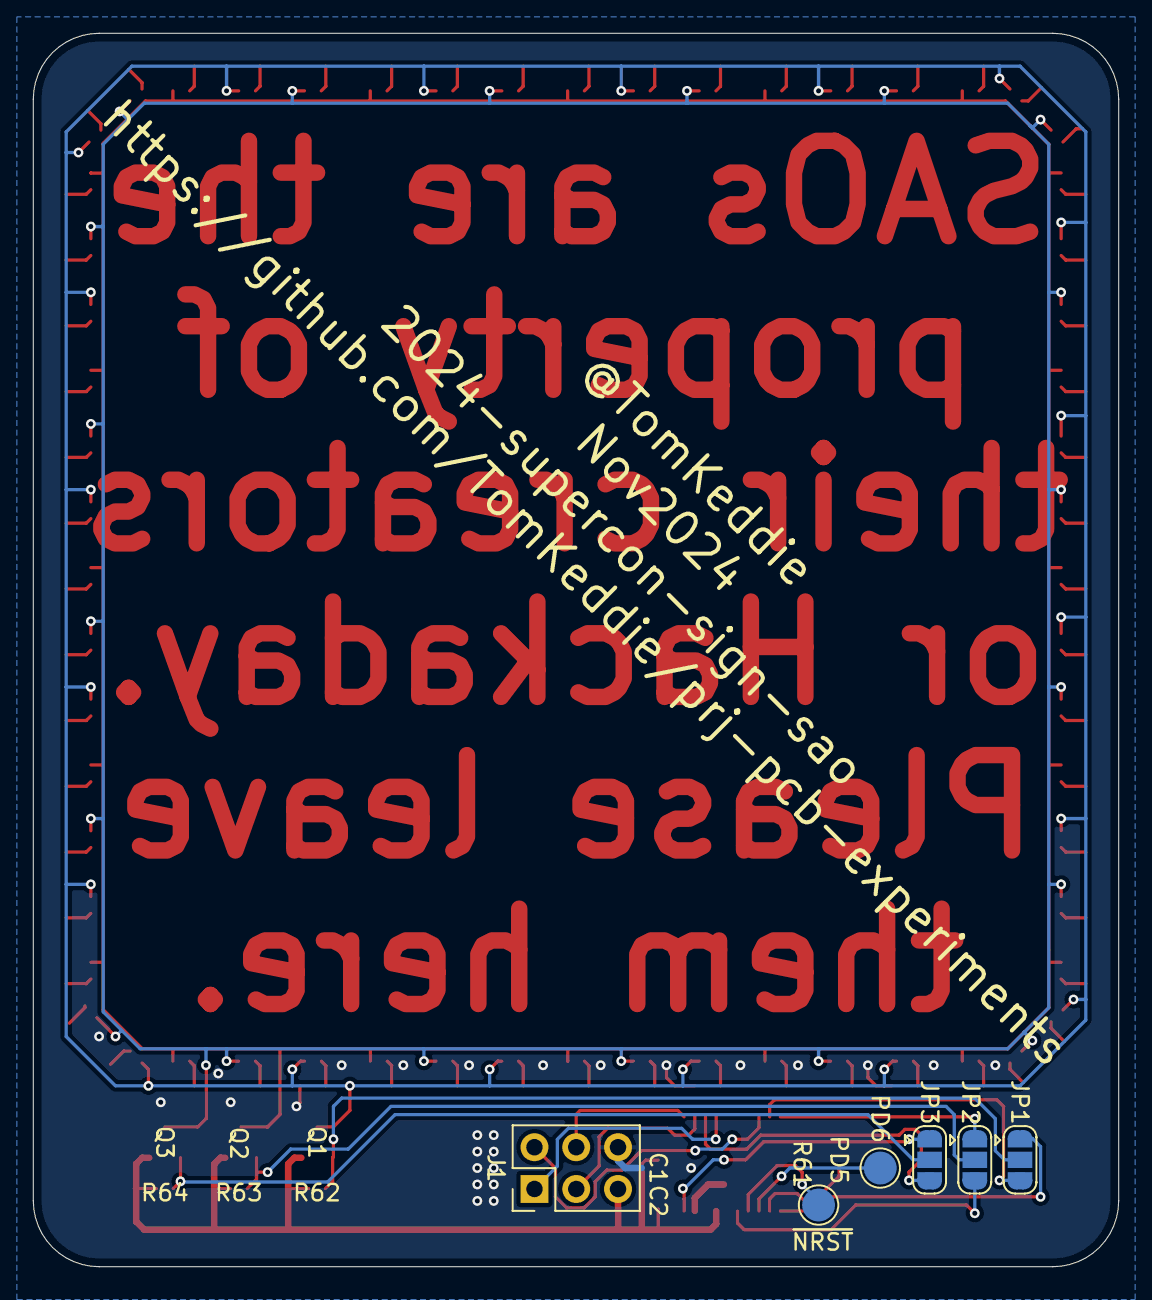
[picture p210: board 2024-supercon-sign-sao.kicad_pcb from below]

Board: 2 copper layers, 66.0 x 75.0 mm, 136 parts (5 on the bottom side), 81 nets.
