TomKeddie/prj-pcb-experiments/2024-syzygy-dsi/hardware/syzygy-dsi.kicad_pcb

## KiCad design 2024-syzygy-dsi/hardware/syzygy-dsi.kicad_pcb (2024-09-25)

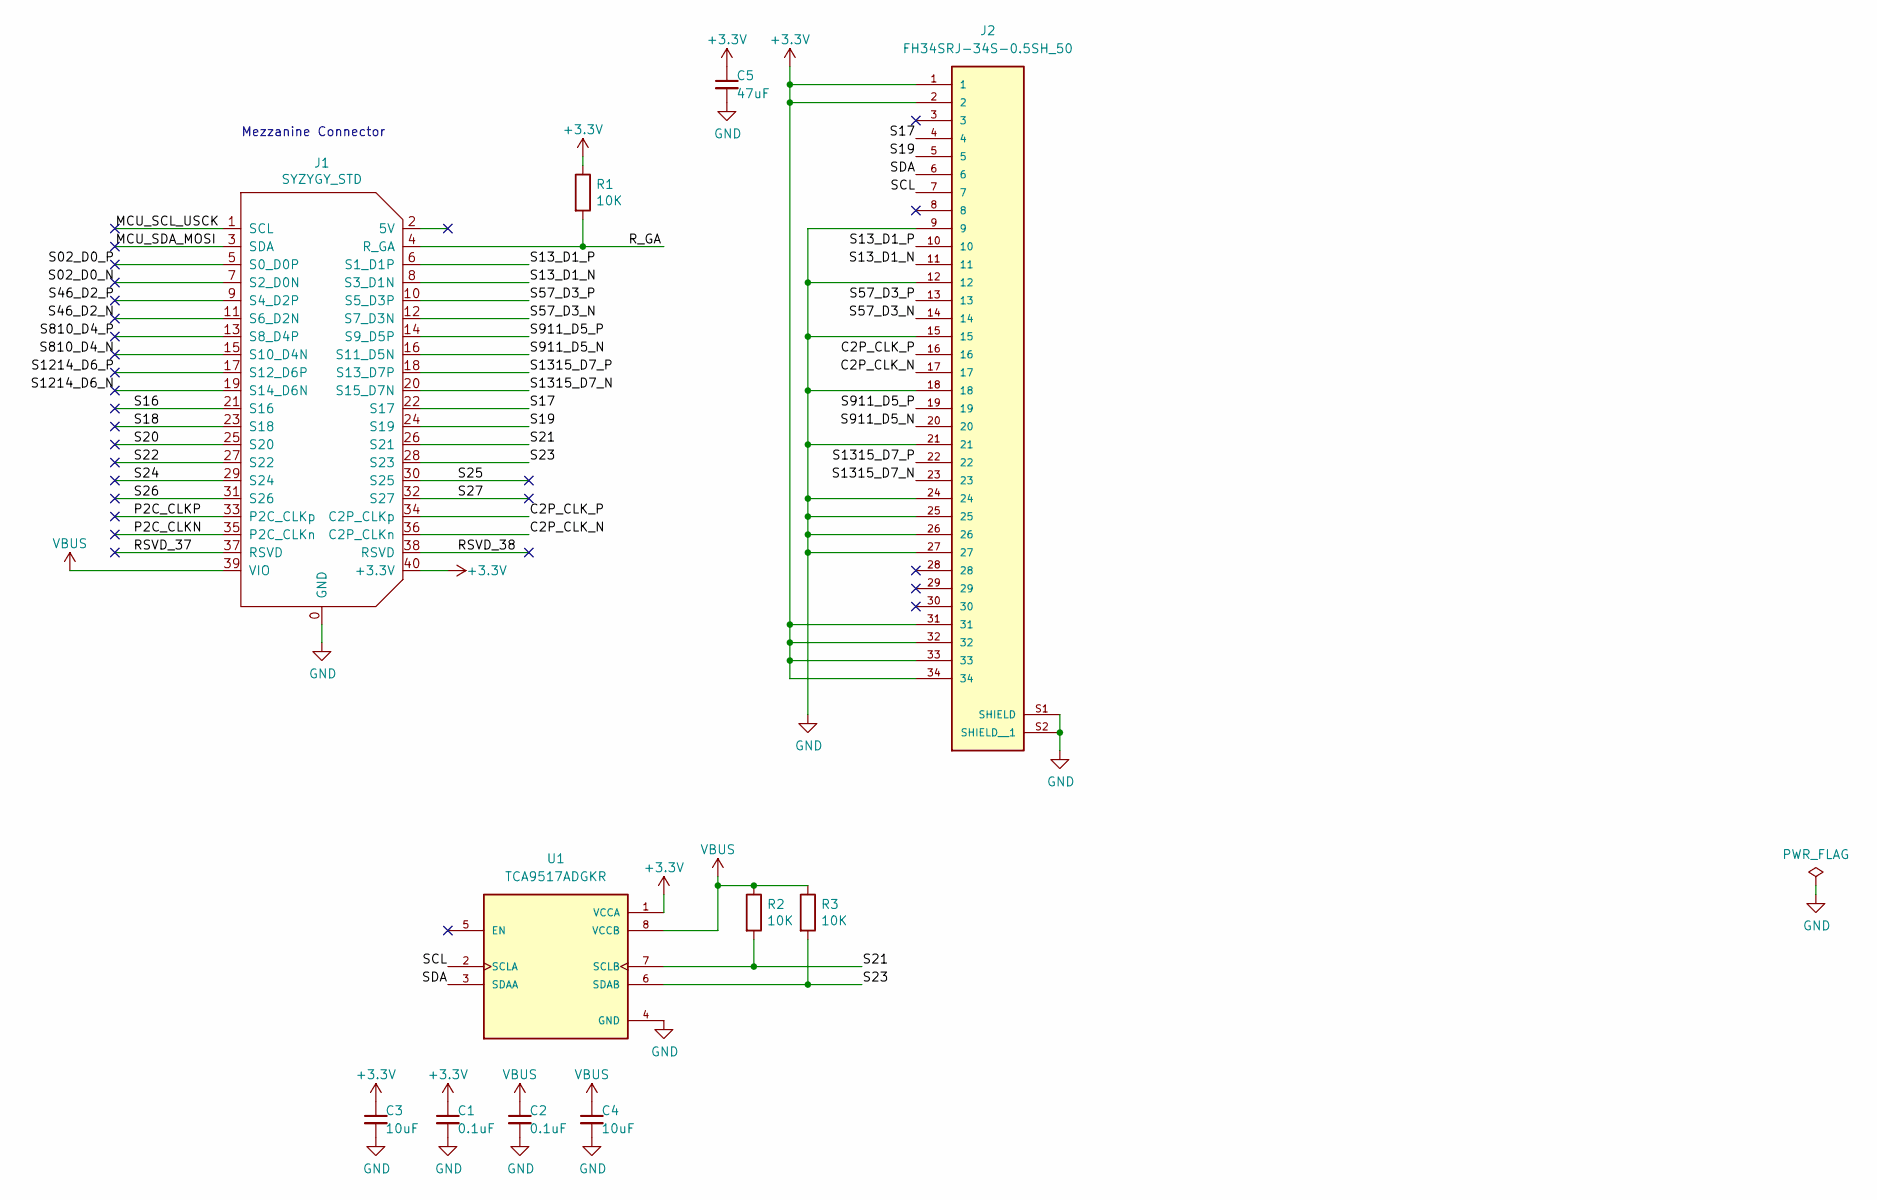
[picture p211: schematic syzygy-dsi.kicad_sch, SZG-TEMPLATE-STD]

Parts:
C1, C2: 0.1uF; C_0603_1608Metric
C3, C4: 10uF; C_0603_1608Metric
C5: 47uF; C_0805_2012Metric
J1: SYZYGY_STD; QTE-020-01-F-D-A; Manufacturer_PN QTE-020-01-F-D-A
J2: FH34SRJ-34S-0.5SH_50; HRS_FH34SRJ-34S-0.5SH_50_
R1, R2, R3: 10K; R_0603_1608Metric
U1: TCA9517ADGKR; IC_TCA9517ADGKR; PARTREV C

Connections:
+3.3V: C1.1, C3.1, C5.1, J1.40 (+3.3V), J2.1, J2.2, J2.31, J2.32, J2.33, J2.34, R1.1, U1.1 (VCCA)
/C2P_CLK_N: J1.36 (C2P_CLKn), J2.17
/C2P_CLK_P: J1.34 (C2P_CLKp), J2.16
/MCU_SCL_USCK: J1.1 (SCL)
/MCU_SDA_MOSI: J1.3 (SDA)
/P2C_CLKN: J1.35 (P2C_CLKn)
/P2C_CLKP: J1.33 (P2C_CLKp)
/RSVD_37: J1.37 (RSVD)
/RSVD_38: J1.38 (RSVD)
/R_GA: J1.4 (R_GA), R1.2
/S02_D0_N: J1.7 (S2_D0N)
/S02_D0_P: J1.5 (S0_D0P)
/S13_D1_N: J1.8 (S3_D1N), J2.11
/S13_D1_P: J1.6 (S1_D1P), J2.10
/S16: J1.21 (S16)
/S17: J1.22 (S17), J2.4
/S18: J1.23 (S18)
/S19: J1.24 (S19), J2.5
/S20: J1.25 (S20)
/S21: J1.26 (S21), R2.2, U1.7 (SCLB)
/S22: J1.27 (S22)
/S23: J1.28 (S23), R3.2, U1.6 (SDAB)
/S24: J1.29 (S24)
/S25: J1.30 (S25)
/S26: J1.31 (S26)
/S27: J1.32 (S27)
/S46_D2_N: J1.11 (S6_D2N)
/S46_D2_P: J1.9 (S4_D2P)
/S57_D3_N: J1.12 (S7_D3N), J2.14
/S57_D3_P: J1.10 (S5_D3P), J2.13
/S810_D4_N: J1.15 (S10_D4N)
/S810_D4_P: J1.13 (S8_D4P)
/S911_D5_N: J1.16 (S11_D5N), J2.20
/S911_D5_P: J1.14 (S9_D5P), J2.19
/S1214_D6_N: J1.19 (S14_D6N)
/S1214_D6_P: J1.17 (S12_D6P)
/S1315_D7_N: J1.20 (S15_D7N), J2.23
/S1315_D7_P: J1.18 (S13_D7P), J2.22
/SCL: J2.7, U1.2 (SCLA)
/SDA: J2.6, U1.3 (SDAA)
GND: C1.2, C2.2, C3.2, C4.2, C5.2, J1.0 (GND), J2.9, J2.12, J2.15, J2.18, J2.21, J2.24, J2.25, J2.26, J2.27, J2.S1 (SHIELD), J2.S2 (SHIELD__1), U1.4 (GND)
VBUS: C2.1, C4.1, J1.39 (VIO), R2.1, R3.1, U1.8 (VCCB)

Notes on the sheet:
Mezzanine Connector

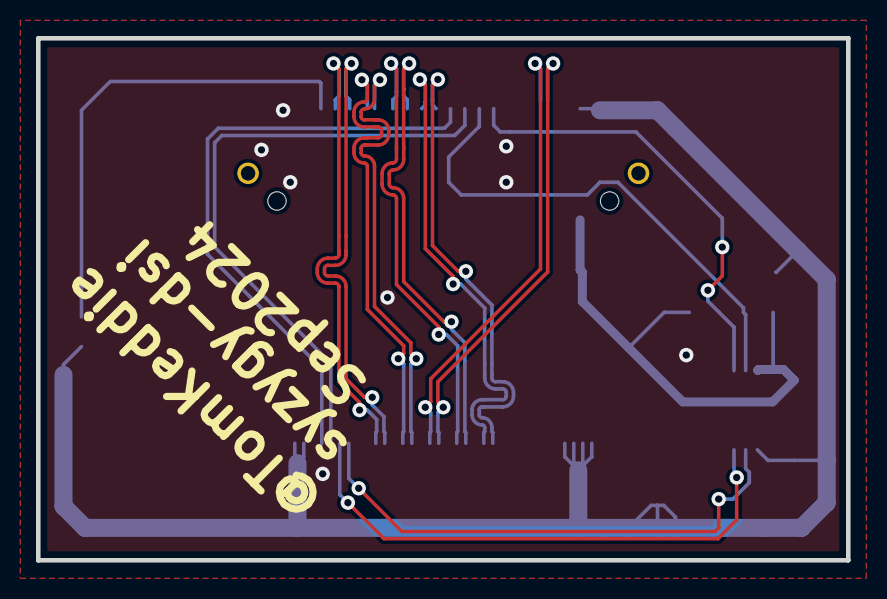
[picture p212: board syzygy-dsi.kicad_pcb from above]

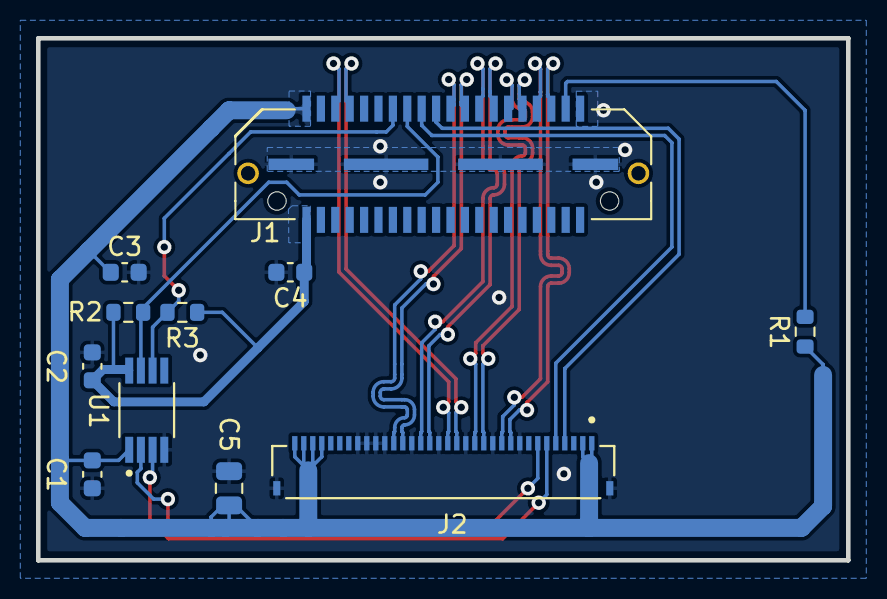
[picture p213: board syzygy-dsi.kicad_pcb from below]

Board: 4 copper layers, 45.0 x 29.0 mm, 11 parts (11 on the bottom side), 20 nets.
