TomKeddie/prj-pcb-experiments/mr-fixit/mrfixit.kicad_pcb

## KiCad design mr-fixit/mrfixit.kicad_pcb (2024-09-16)

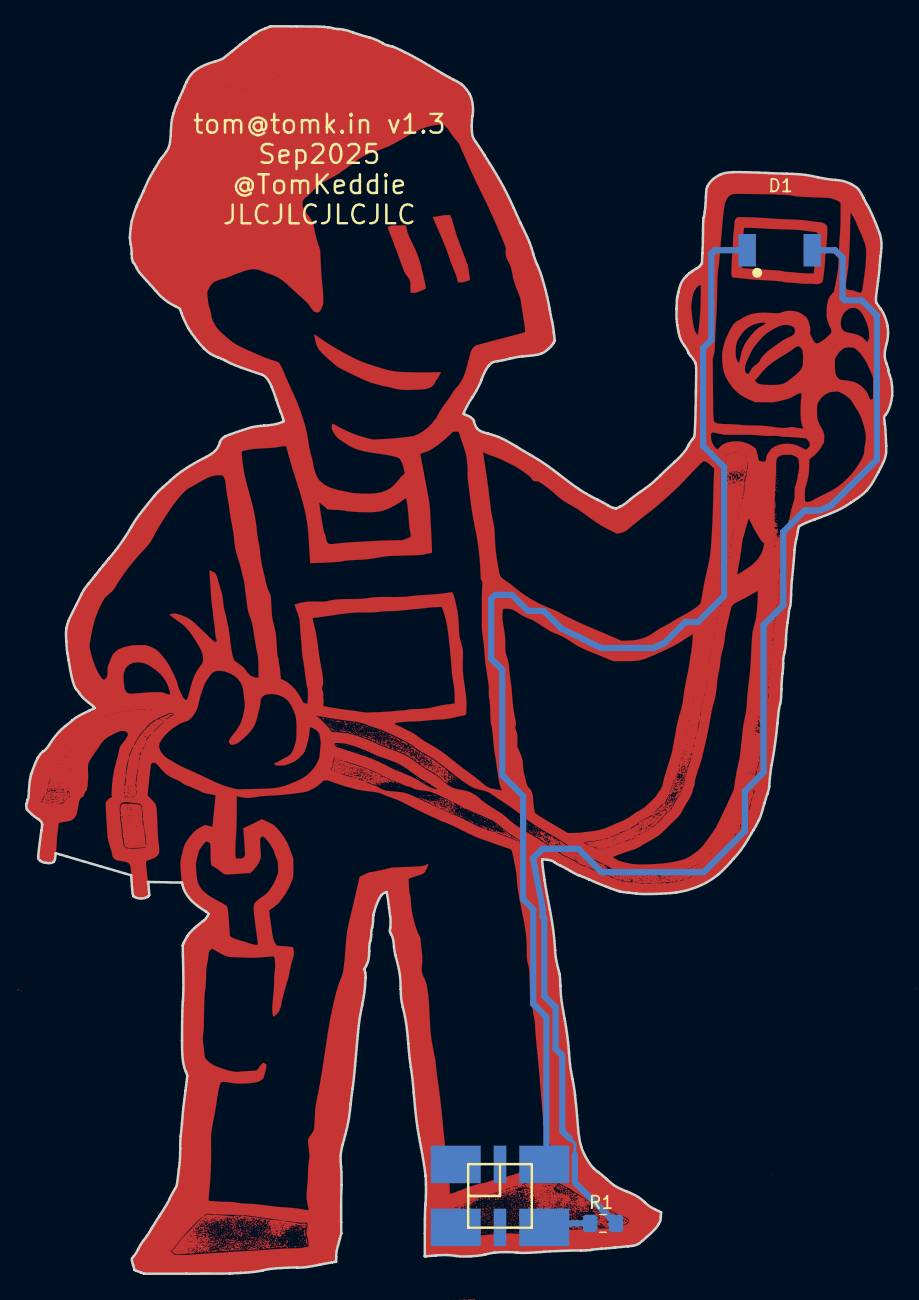
[picture p214: board mrfixit.kicad_pcb from below]

Board: 2 copper layers, 69.3 x 99.8 mm, 5 parts (3 on the bottom side), 3 nets.

Parts:
D1: LED; XZM2CYK45WT-9-NOMASK
H1: Solder Mask; mrfixit-mask
H2: Copper; mrfixit-copper
J1: Conn_02x03_Odd_Even; PinSocket_2x03_P2.54mm_Vertical_SMD_SAO
R1: 220R; C_0805_2012Metric_Pad1.15x1.40mm_HandSolder

Connections:
+3V3: D1.2, J1.5
GND: J1.6, R1.2
unnamed: D1.1, R1.1
