TomKeddie/prj-pcb-experiments/mikrobus-pmod-adapt/mikrobus-pmod-adapt.kicad_pcb

## KiCad design mikrobus-pmod-adapt/mikrobus-pmod-adapt.kicad_pcb (2024-03-02)

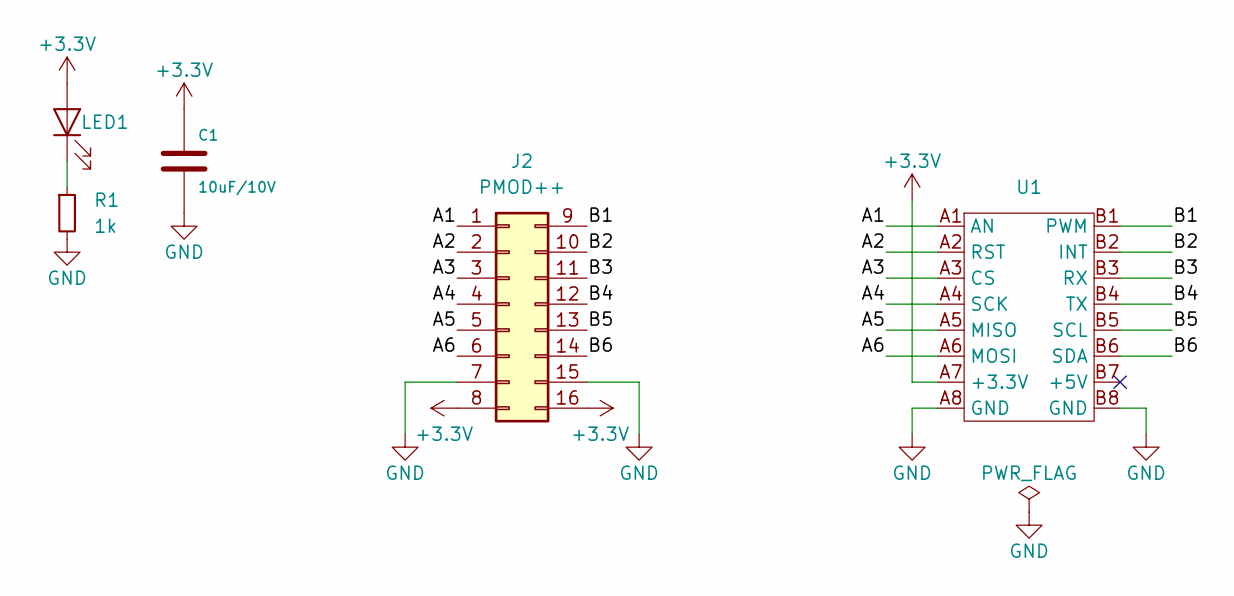
[picture p215: schematic mikrobus-pmod-adapt.kicad_sch]

Parts:
C1: 10uF/10V; C_1206_3216Metric_Pad1.42x1.75mm_HandSolder; LCSC DNP
J2: PMOD++; PMOD_2x8_PTH_RA_SOCKET
LED1: LED; LED_1206_3216Metric
R1: 1k; R_1206_3216Metric; MFGPN 0402WGF1001TCE; LCSC C11702
U1: MIKROBUS_ADD_ON_SMALL

Connections:
+3.3V: C1.1, J2.8, J2.16, LED1.2 (A), U1.A7 (+3.3V)
/A1: J2.1, U1.A1 (AN)
/A2: J2.2, U1.A2 (RST)
/A3: J2.3, U1.A3 (CS)
/A4: J2.4, U1.A4 (SCK)
/A5: J2.5, U1.A5 (MISO)
/A6: J2.6, U1.A6 (MOSI)
/B1: J2.9, U1.B1 (PWM)
/B2: J2.10, U1.B2 (INT)
/B3: J2.11, U1.B3 (RX)
/B4: J2.12, U1.B4 (TX)
/B5: J2.13, U1.B5 (SCL)
/B6: J2.14, U1.B6 (SDA)
GND: C1.2, J2.7, J2.15, R1.2, U1.A8 (GND), U1.B8 (GND)
unnamed: LED1.1 (K), R1.1

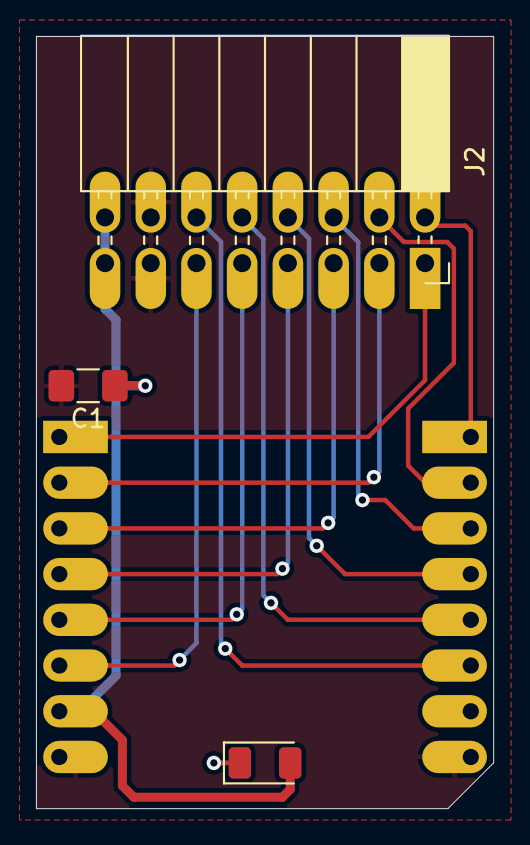
[picture p216: board mikrobus-pmod-adapt.kicad_pcb from above]

Board: 2 copper layers, 25.4 x 42.9 mm, 5 parts (1 on the bottom side), 15 nets.
