TomKeddie/prj-pcb-experiments/strange-parts/strange-parts-sao/strange-parts-sao.kicad_pcb

## KiCad design strange-parts/strange-parts-sao/strange-parts-sao.kicad_pcb (2023-11-19)

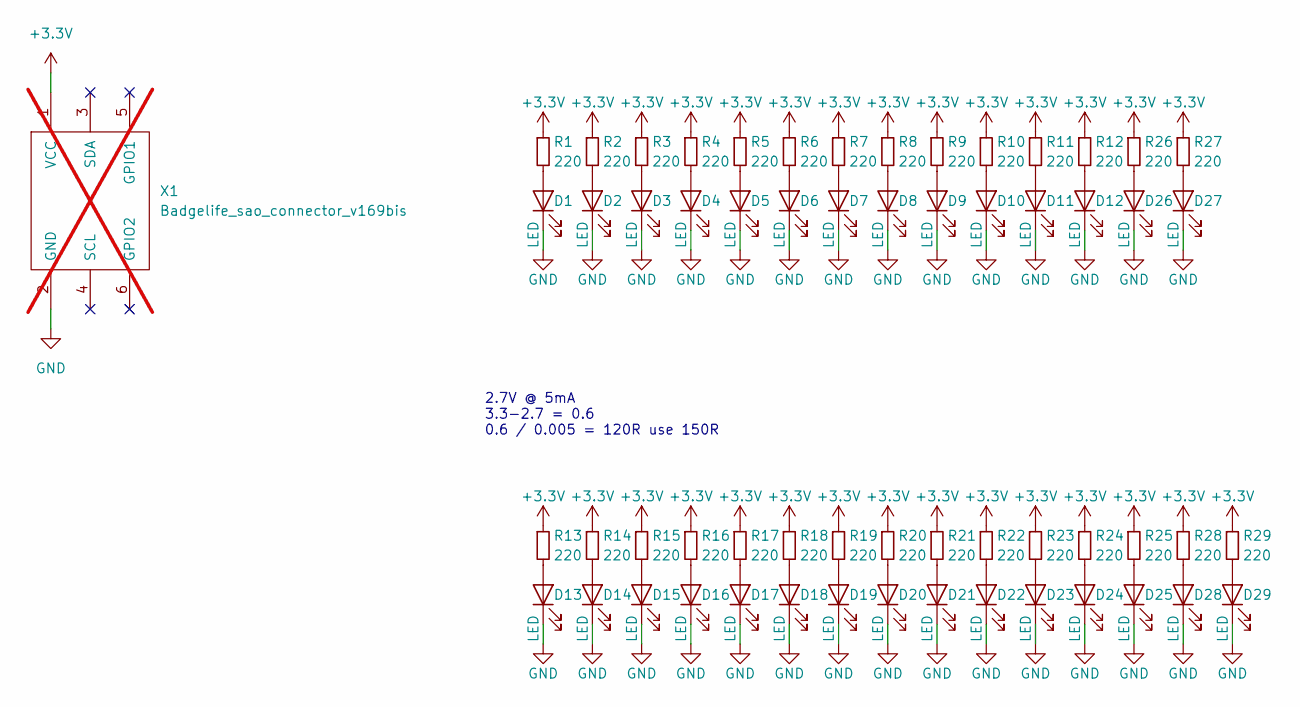
[picture p217: schematic strange-parts-sao.kicad_sch]

Parts:
D1, D2, D3, D4, D5, D6, D7, D8, D9, D10, D11, D12, D13, D14, D15, D16, D17, D18, D19, D20, D21, D22, D23, D24, D25, D26, D27, D28, D29: LED; JLCPCB_SIDE_C409529; LCSC C409529
R1, R2, R3, R4, R5, R6, R7, R8, R9, R10, R11, R12, R13, R14, R15, R16, R17, R18, R19, R20, R21, R22, R23, R24, R25, R26, R27, R28, R29: 220; R_0402_1005Metric; MFGPN 0402WGF2200TCE; LCSC C25091
X1: Badgelife_sao_connector_v169bis; Badgelife-SAOv169-SAO-2x3-SMD-BIGPADS; not fitted

Connections:
+3.3V: R1.1, R2.1, R3.1, R4.1, R5.1, R6.1, R7.1, R8.1, R9.1, R10.1, R11.1, R12.1, R13.1, R14.1, R15.1, R16.1, R17.1, R18.1, R19.1, R20.1, R21.1, R22.1, R23.1, R24.1, R25.1, R26.1, R27.1, R28.1, R29.1, X1.1 (VCC)
GND: D1.1 (K), D2.1 (K), D3.1 (K), D4.1 (K), D5.1 (K), D6.1 (K), D7.1 (K), D8.1 (K), D9.1 (K), D10.1 (K), D11.1 (K), D12.1 (K), D13.1 (K), D14.1 (K), D15.1 (K), D16.1 (K), D17.1 (K), D18.1 (K), D19.1 (K), D20.1 (K), D21.1 (K), D22.1 (K), D23.1 (K), D24.1 (K), D25.1 (K), D26.1 (K), D27.1 (K), D28.1 (K), D29.1 (K), X1.2 (GND)
unnamed: D1.2 (A), R1.2
unnamed: D2.2 (A), R2.2
unnamed: D3.2 (A), R3.2
unnamed: D4.2 (A), R4.2
unnamed: D5.2 (A), R5.2
unnamed: D6.2 (A), R6.2
unnamed: D7.2 (A), R7.2
unnamed: D8.2 (A), R8.2
unnamed: D9.2 (A), R9.2
unnamed: D10.2 (A), R10.2
unnamed: D11.2 (A), R11.2
unnamed: D12.2 (A), R12.2
unnamed: D13.2 (A), R13.2
unnamed: D14.2 (A), R14.2
unnamed: D15.2 (A), R15.2
unnamed: D16.2 (A), R16.2
unnamed: D17.2 (A), R17.2
unnamed: D18.2 (A), R18.2
unnamed: D19.2 (A), R19.2
unnamed: D20.2 (A), R20.2
unnamed: D21.2 (A), R21.2
unnamed: D22.2 (A), R22.2
unnamed: D23.2 (A), R23.2
unnamed: D24.2 (A), R24.2
unnamed: D25.2 (A), R25.2
unnamed: D26.2 (A), R26.2
unnamed: D27.2 (A), R27.2
unnamed: D28.2 (A), R28.2
unnamed: D29.2 (A), R29.2

Notes on the sheet:
2.7V @ 5mA 3.3-2.7 = 0.6 0.6 / 0.005 = 120R use 150R

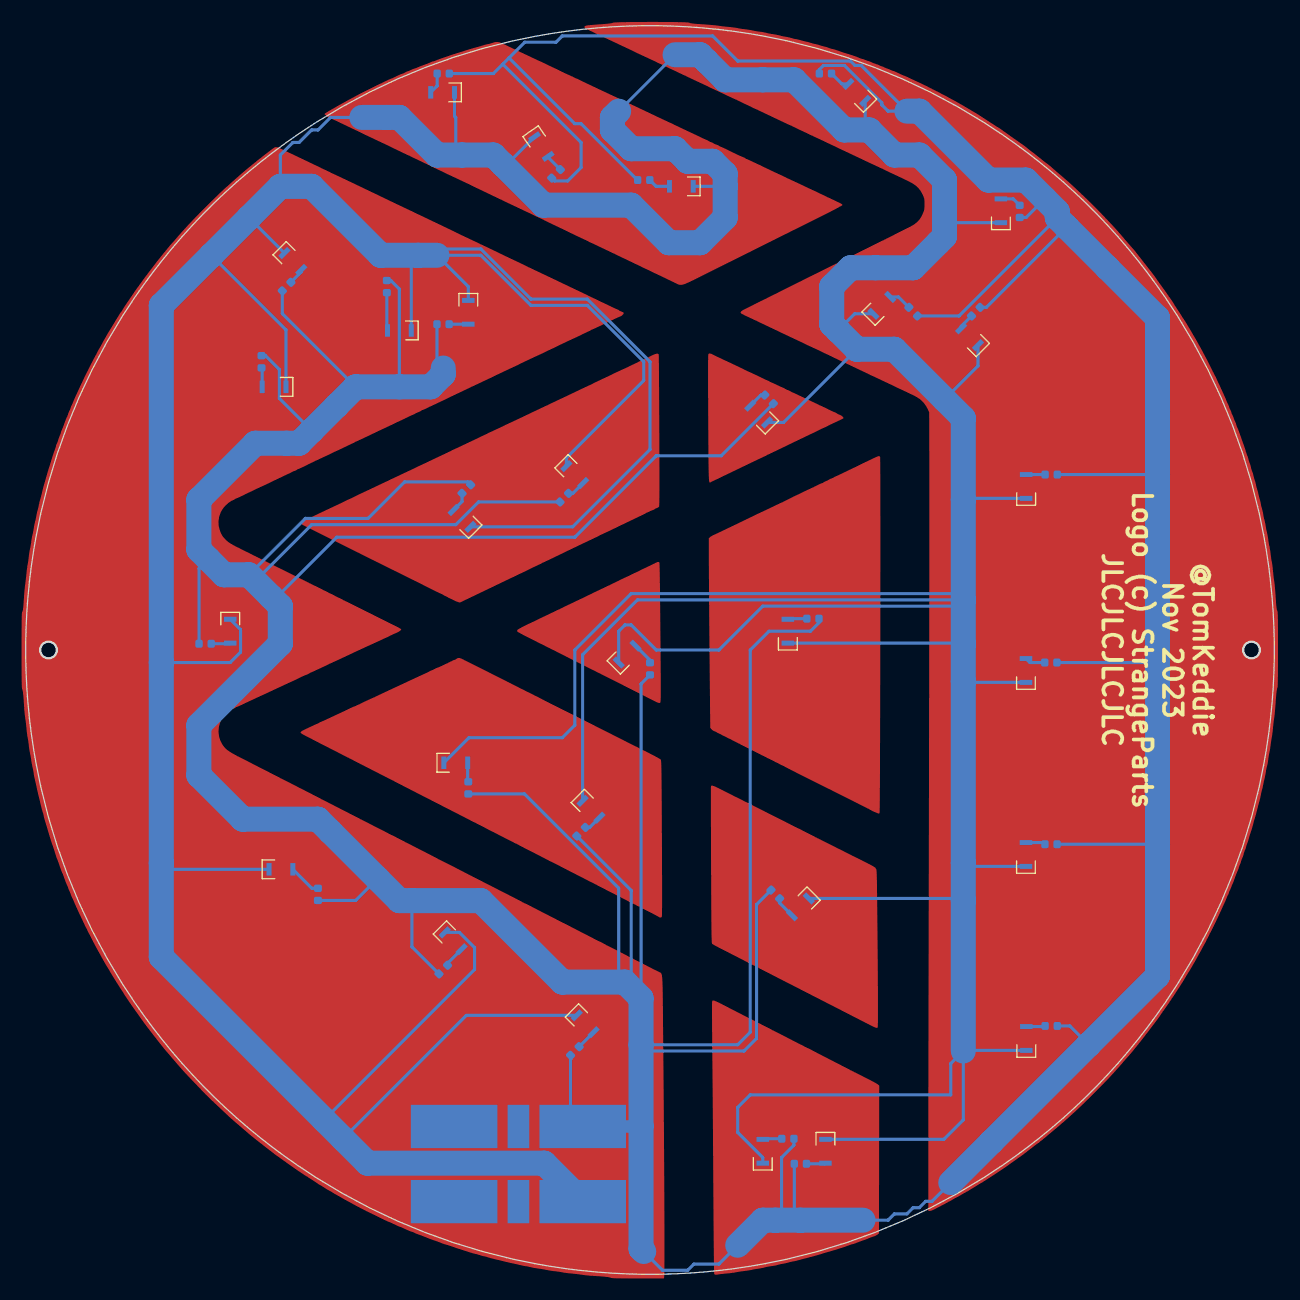
[picture p218: board strange-parts-sao.kicad_pcb from below]

Board: 2 copper layers, 99.6 x 99.6 mm, 59 parts (59 on the bottom side), 31 nets.
