TomKeddie/prj-pcb-experiments/atmelice-swd-breakout-switch/atmelice-swd-breakout-switch.kicad_pcb

## KiCad design atmelice-swd-breakout-switch/atmelice-swd-breakout-switch.kicad_pcb (2023-05-04)

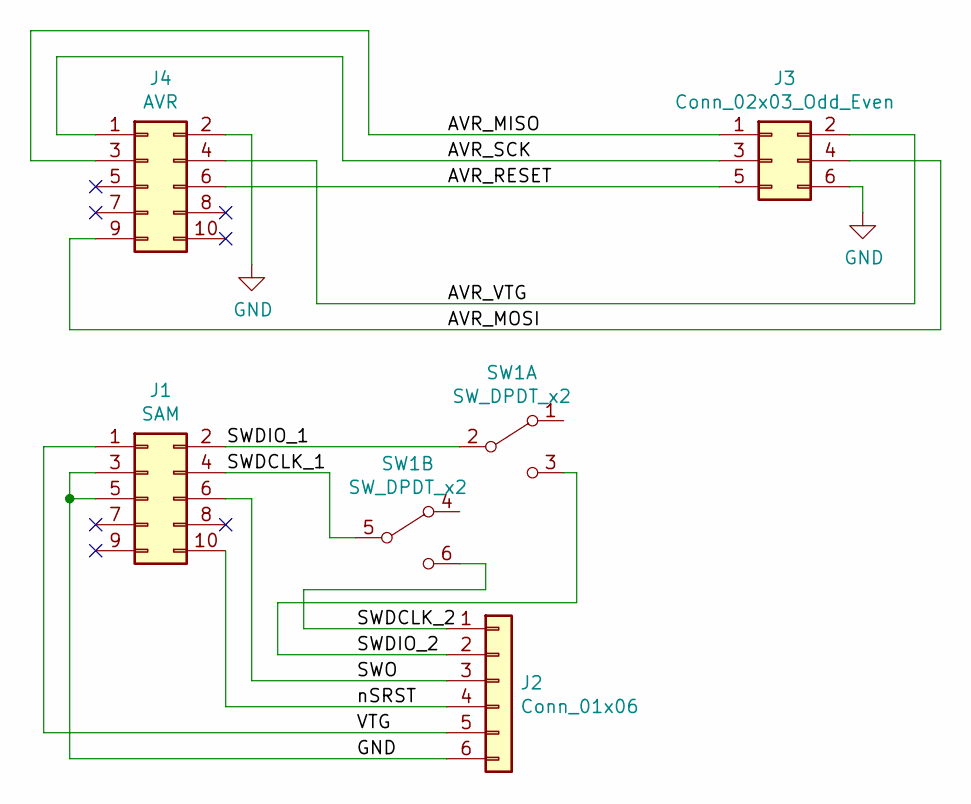
[picture p219: schematic atmelice-swd-breakout-switch.kicad_sch]

Parts:
J1: SAM; PinSocket_2x05_P1.27mm_Vertical
J2: Conn_01x06; PinHeader_1x06_P2.54mm_Vertical
J3: Conn_02x03_Odd_Even; PinHeader_2x03_P2.54mm_Vertical
J4: AVR; PinSocket_2x05_P1.27mm_Vertical
SW1: SW_DPDT_x2; SW_DPDT_SMD

Connections:
/AVR_MISO: J3.1, J4.3
/AVR_MOSI: J3.4, J4.9
/AVR_RESET: J3.5, J4.6
/AVR_SCK: J3.3, J4.1
/AVR_VTG: J3.2, J4.4
/SWDCLK_1: J1.4, SW1.5 (B)
/SWDCLK_2: J2.1, SW1.6 (C)
/SWDIO_1: J1.2, SW1.2 (B)
/SWDIO_2: J2.2, SW1.3 (C)
/SWO: J1.6, J2.3
/VTG: J1.1, J2.5
/nSRST: J1.10, J2.4
GND: J1.3, J1.5, J2.6, J3.6, J4.2

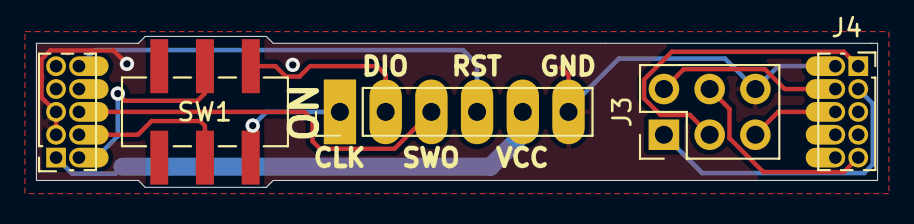
[picture p220: board atmelice-swd-breakout-switch.kicad_pcb from above]

Board: 2 copper layers, 46.7 x 8.4 mm, 5 parts (0 on the bottom side), 13 nets.
