TomKeddie/prj-pcb-experiments/esp8266-plugpack/esp8266-plugpack.kicad_pcb

## KiCad design esp8266-plugpack/esp8266-plugpack.kicad_pcb (2023-04-24)

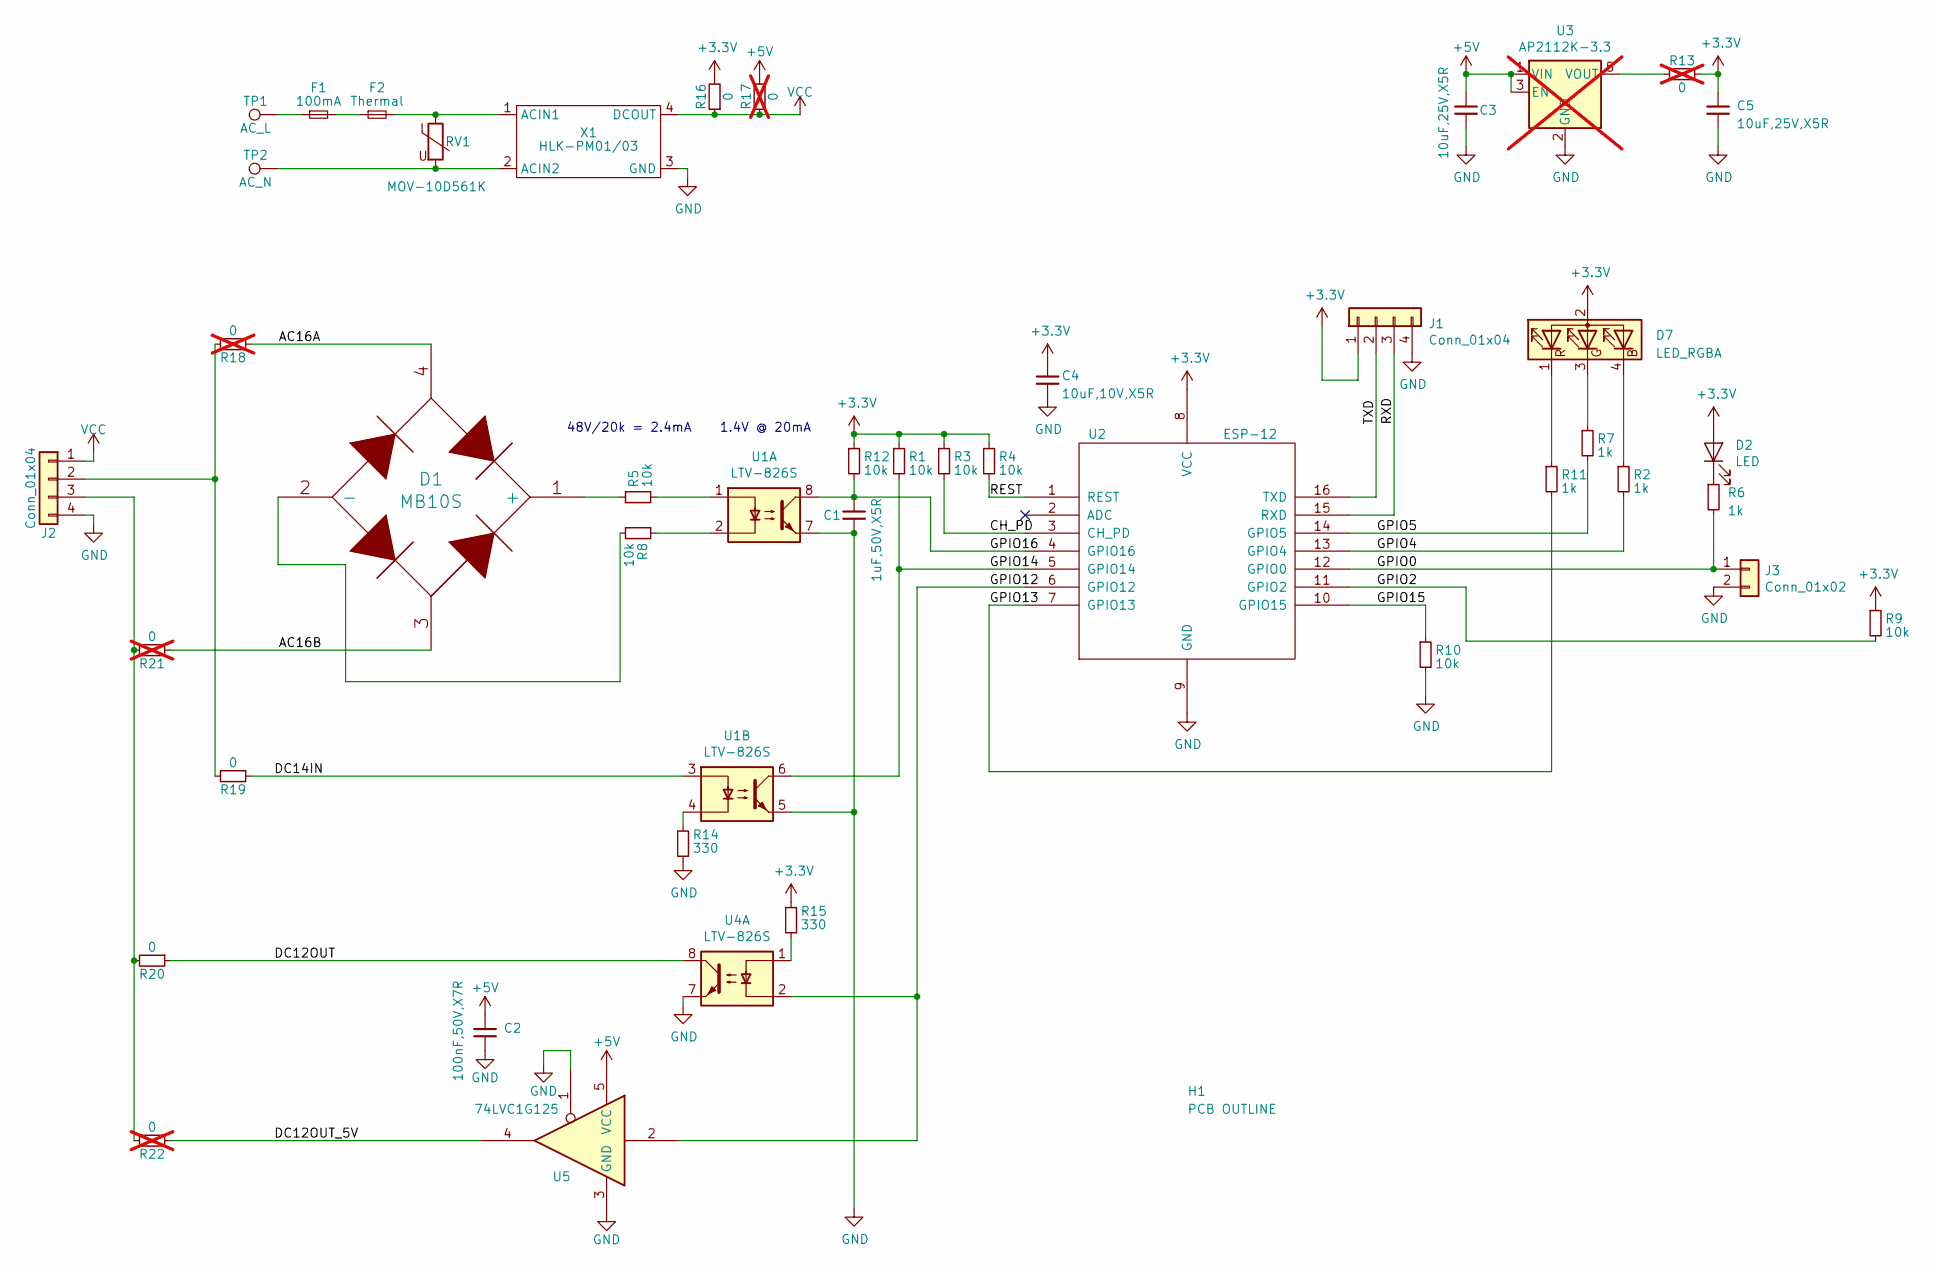
[picture p221: schematic esp8266-plugpack.kicad_sch]

Parts:
C1: 1uF,50V,X5R; C_0603_1608Metric; MFGPN CL10A105KB8NNNC; LCSC C15849
C2: 100nF,50V,X7R; C_0603_1608Metric; MFGPN CC0603KRX7R9BB104; LCSC C14663
C3, C5: 10uF,25V,X5R; C_0603_1608Metric; MFGPN CL10A106MA8NRNC; LCSC C96446
C4: 10uF,10V,X5R; C_0603_1608Metric; MFGPN CL10A106KP8NNNC; LCSC C19702
D1: MB10S; Diode_Bridge_MBnnS; LCSC C2488
D2: LED; LED_0805_2012Metric; LCSC C34499
D7: LED_RGBA; LED_D5.0mm-4_RGB
F1: 100mA; Fuse_2410
F2: Thermal; R_Axial_DIN0204_L3.6mm_D1.6mm_P7.62mm_Horizontal
H1: PCB OUTLINE; PCB_ALIEXPRESS_PLUGPACK_1
J1: Conn_01x04; PinHeader_1x04_P2.54mm_Vertical
J2: Conn_01x04; JST_PH_B4B-PH-SM4-TB_1x04-1MP_P2.00mm_Vertical
J3: Conn_01x02; PinHeader_1x02_P2.54mm_Vertical
R1, R3, R4, R5, R8, R9, R10, R12: 10k; R_0603_1608Metric; MFGPN 0603WAF1002T5E; LCSC C25804
R2, R6, R7, R11: 1k; R_0603_1608Metric; MFGPN 0603WAF1001T5E; LCSC C21190
R13, R17, R18, R21, R22: 0; R_0603_1608Metric; MFGPN 0603WAF0000T5E; LCSC C21189; not fitted
R14, R15: 330; R_0603_1608Metric; MFGPN 0603WAF3300T5E; LCSC C23138
R16, R19, R20: 0; R_0603_1608Metric; MFGPN 0603WAF0000T5E; LCSC C21189
RV1: MOV-10D561K; RV_Disc_D12mm_W3.9mm_P7.5mm
TP1: AC_L; TestPoint_Pad_D3.0mm
TP2: AC_N; TestPoint_Pad_D3.0mm
U1, U4: LTV-826S; DIP-8_W8.89mm_SMDSocket_LongPads
U2: ESP-12; ESP-12E_SMD; LCSC C82891
U3: AP2112K-3.3; SOT-23-5; not fitted
U5: 74LVC1G125; SOT-23-5; LCSC C23654
X1: HLK-PM01/03; HLK-PMxx

Connections:
+3.3V: C4.1, C5.1, D2.2 (A), D7.2 (A), J1.1, R1.1, R3.1, R4.1, R9.1, R12.1, R13.2, R15.2, R16.2, U2.8 (VCC)
+5V: C2.1, C3.1, R17.2, U3.1 (VIN), U3.3 (EN), U5.5 (VCC)
/AC16A: D1.4, R18.1
/AC16B: D1.3, R21.1
/CH_PD: R3.2, U2.3 (CH_PD)
/DC12OUT: R20.1, U4.8
/DC12OUT_5V: R22.1, U5.4
/DC14IN: R19.1, U1.3
/GPIO0: J3.1, R6.2, U2.12 (GPIO0)
/GPIO2: R9.2, U2.11 (GPIO2)
/GPIO4: R2.2, U2.13 (GPIO4)
/GPIO5: R7.2, U2.14 (GPIO5)
/GPIO12: U2.6 (GPIO12), U4.2, U5.2
/GPIO13: R11.2, U2.7 (GPIO13)
/GPIO14: R1.2, U1.6, U2.5 (GPIO14)
/GPIO15: R10.1, U2.10 (GPIO15)
/GPIO16: C1.1, R12.2, U1.8, U2.4 (GPIO16)
/REST: R4.2, U2.1 (REST)
/RXD: J1.3, U2.15 (RXD)
/TXD: J1.2, U2.16 (TXD)
GND: C1.2, C2.2, C3.2, C4.2, C5.2, J1.4, J2.4, J3.2, R10.2, R14.1, U1.5, U1.7, U2.9 (GND), U3.2 (GND), U4.7, U5.1, U5.3 (GND), X1.3 (GND)
unnamed: D1.1 (+), R5.1
unnamed: D1.2 (-), R8.2
unnamed: D2.1 (K), R6.1
unnamed: D7.4 (BK), R2.1
unnamed: D7.3 (GK), R7.1
unnamed: D7.1 (RK), R11.1
unnamed: F1.1, TP1.1
unnamed: F1.2, F2.1
unnamed: J2.2, R18.2, R19.2
unnamed: J2.3, R20.2, R21.2, R22.2
unnamed: R5.2, U1.1
unnamed: R8.1, U1.2
unnamed: R14.2, U1.4
unnamed: R15.1, U4.1
unnamed: R13.1, U3.5 (VOUT)
unnamed: F2.2, RV1.1, X1.1 (ACIN1)
unnamed: RV1.2, TP2.1, X1.2 (ACIN2)
VCC: J2.1, R16.1, R17.1, X1.4 (DCOUT)

Notes on the sheet:
48V/20k = 2.4mA
1.4V @ 20mA

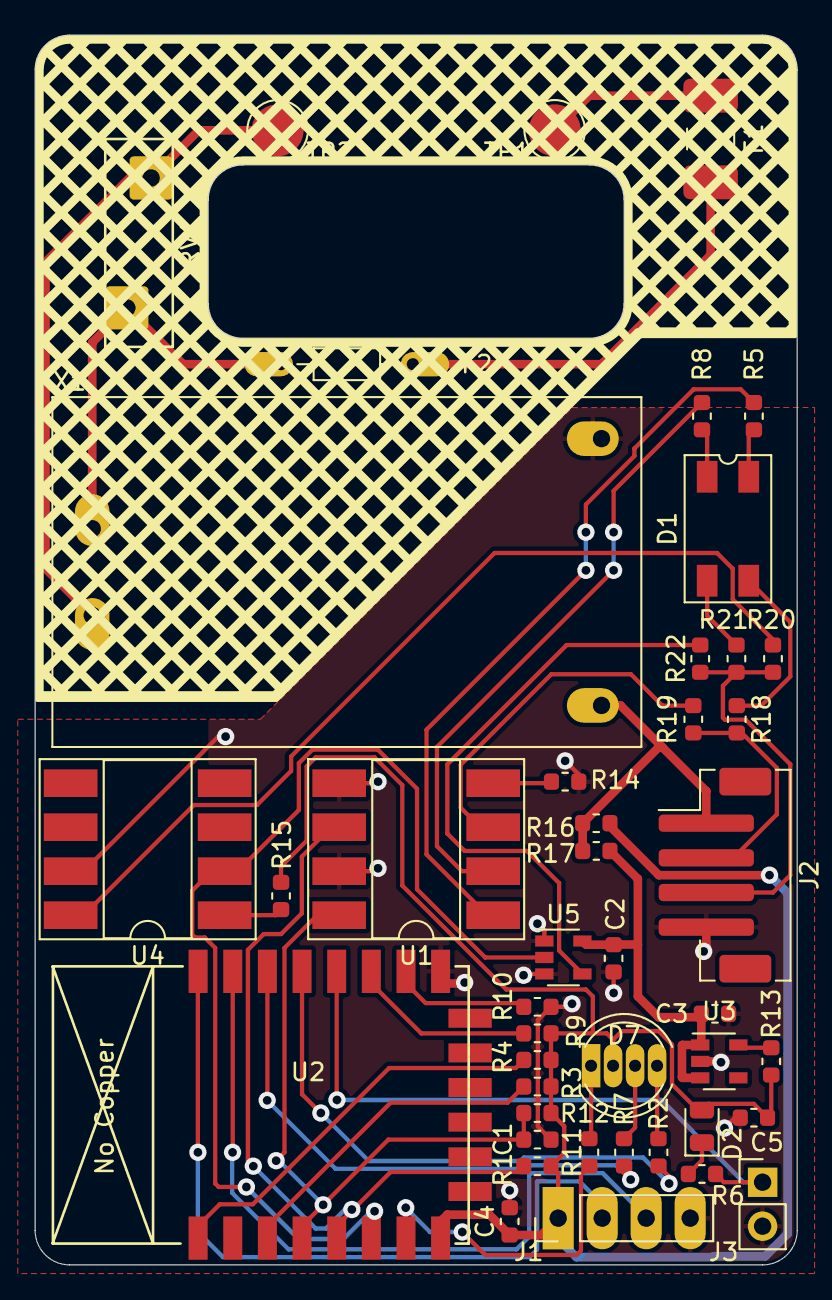
[picture p222: board esp8266-plugpack.kicad_pcb from above]

Board: 2 copper layers, 44.0 x 71.0 mm, 45 parts (0 on the bottom side), 39 nets.
