TomKeddie/prj-pcb-experiments/ch348_octo_serial_minim/ch348_octo_serial_minim.kicad_pcb

## KiCad design ch348_octo_serial_minim/ch348_octo_serial_minim.kicad_pcb (2023-01-23)

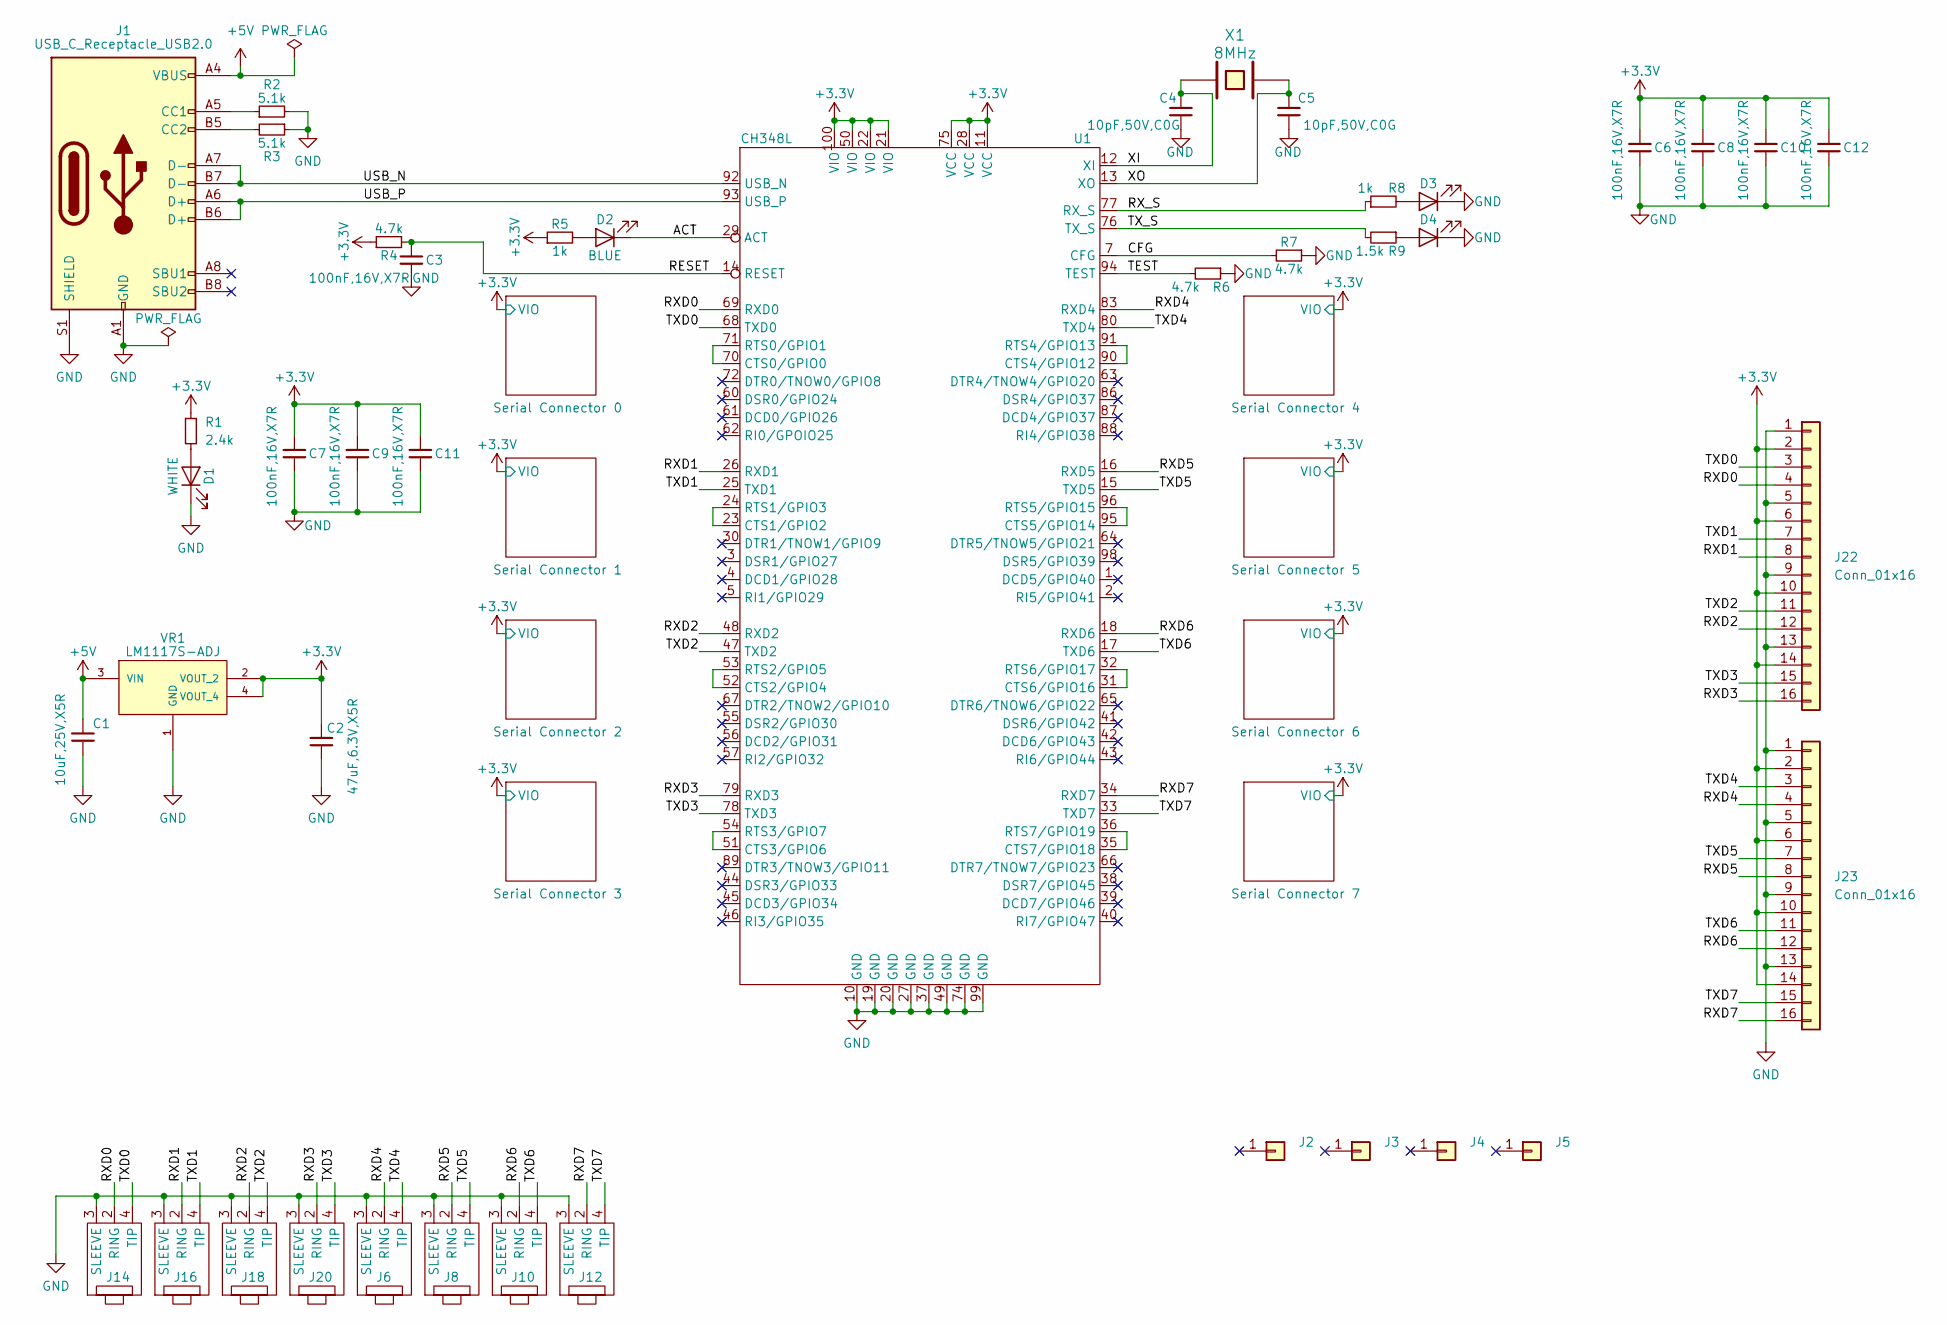
[picture p223: schematic ch348_octo_serial_minim.kicad_sch]

Parts:
C1: 10uF,25V,X5R; C_0603_1608Metric; MFGPN CL10A106MA8NRNC; LCSC C96446
C2: 47uF,6.3V,X5R; C_0805_2012Metric; MFGPN CL21A476MQYNNNE; LCSC C16780
C3, C6, C7, C8, C9, C10, C11, C12: 100nF,16V,X7R; C_0402_1005Metric; MFGPN CL05B104KO5NNNC; LCSC C1525
C4, C5: 10pF,50V,C0G; C_0402_1005Metric; MFGPN CL05C100JB5NNNC; LCSC C32949
D1: WHITE; LED_0603_1608Metric; LCSC C2290
D2: BLUE; LED_0603_1608Metric; LCSC C72041
D3: YELLOW; LED_0603_1608Metric; LCSC C72038
D4: GREEN; LED_0603_1608Metric; LCSC C72043
J1: USB_C_Receptacle_USB2.0; USB_C_Receptacle_LCSC_C165948; LCSC C709357
J2, J3, J4, J5: Conn_01x01; MountingHole_3.2mm_M3_DIN965_Pad
J6, J8, J10, J12, J14, J16, J18, J20: JLCPCB_3.5MM_SOCKET_C18166; MPN PJ-3200; LCSC C18166
J22, J23: Conn_01x16; PinHeader_1x16_P2.54mm_Horizontal; LCSC C725908
R1: 2.4k; R_0402_1005Metric; MFGPN 0402WGF2401TCE; LCSC C25882
R2, R3: 5.1k; R_0402_1005Metric; MFGPN 0402WGF5101TCE; LCSC C25905
R4, R6, R7: 4.7k; R_0402_1005Metric; MFGPN 0402WGF4701TCE; LCSC C25900
R5, R8: 1k; R_0402_1005Metric; MFGPN 0402WGF1001TCE; LCSC C11702
R9: 1.5k; R_0402_1005Metric; MFGPN 0402WGF1501TCE; LCSC C25867
U1: CH348L; LQFP-100_14x14mm_P0.5mm; LCSC C2979160
VR1: LM1117S-ADJ; VREG_LM1117MPX-3.3; PARTREV O; LCSC C9662
X1: 8MHz; Crystal_SMD_HC49-SD; LCSC C12674

Connections:
+3.3V: C2.1, C6.1, C7.1, C8.1, C9.1, C10.1, C11.1, C12.1, J22.2, J22.6, J22.10, J22.14, J23.2, J23.6, J23.10, J23.14, R1.1, R4.1, R5.1, U1.11 (VCC), U1.21 (VIO), U1.22 (VIO), U1.28 (VCC), U1.50 (VIO), U1.75 (VCC), U1.100 (VIO), VR1.2 (VOUT_2), VR1.4 (VOUT_4); also elsewhere on the board
+5V: C1.1, J1.A4 (VBUS), J1.A9 (VBUS), J1.B4 (VBUS), J1.B9 (VBUS), VR1.3 (VIN)
/ACT: D2.1 (K), U1.29 (ACT)
/CFG: R7.2, U1.7 (CFG)
/RESET: C3.1, R4.2, U1.14 (RESET)
/RXD0: J14.2 (RING), J22.4, U1.69 (RXD0)
/RXD1: J16.2 (RING), J22.8, U1.26 (RXD1)
/RXD2: J18.2 (RING), J22.12, U1.48 (RXD2)
/RXD3: J20.2 (RING), J22.16, U1.79 (RXD3)
/RXD4: J6.2 (RING), J23.4, U1.83 (RXD4)
/RXD5: J8.2 (RING), J23.8, U1.16 (RXD5)
/RXD6: J10.2 (RING), J23.12, U1.18 (RXD6)
/RXD7: J12.2 (RING), J23.16, U1.34 (RXD7)
/RX_S: R8.1, U1.77 (RX_S)
/TEST: R6.2, U1.94 (TEST)
/TXD0: J14.4 (TIP), J22.3, U1.68 (TXD0)
/TXD1: J16.4 (TIP), J22.7, U1.25 (TXD1)
/TXD2: J18.4 (TIP), J22.11, U1.47 (TXD2)
/TXD3: J20.4 (TIP), J22.15, U1.78 (TXD3)
/TXD4: J6.4 (TIP), J23.3, U1.80 (TXD4)
/TXD5: J8.4 (TIP), J23.7, U1.15 (TXD5)
/TXD6: J10.4 (TIP), J23.11, U1.17 (TXD6)
/TXD7: J12.4 (TIP), J23.15, U1.33 (TXD7)
/TX_S: R9.2, U1.76 (TX_S)
/USB_N: J1.A7 (D-), J1.B7 (D-), U1.92 (USB_N)
/USB_P: J1.A6 (D+), J1.B6 (D+), U1.93 (USB_P)
/XI: C4.1, U1.12 (XI), X1.1
/XO: C5.1, U1.13 (XO), X1.2
GND: C1.2, C2.2, C3.2, C4.2, C5.2, C6.2, C7.2, C8.2, C9.2, C10.2, C11.2, C12.2, D1.1 (K), D3.1 (K), D4.1 (K), J1.A1 (GND), J1.A12 (GND), J1.B1 (GND), J1.B12 (GND), J1.S1 (SHIELD), J6.3 (SLEEVE), J8.3 (SLEEVE), J10.3 (SLEEVE), J12.3 (SLEEVE), J14.3 (SLEEVE), J16.3 (SLEEVE), J18.3 (SLEEVE), J20.3 (SLEEVE), J22.1, J22.5, J22.9, J22.13, J23.1, J23.5, J23.9, J23.13, R2.2, R3.1, R6.1, R7.1, U1.10 (GND), U1.19 (GND), U1.20 (GND), U1.27 (GND), U1.37 (GND), U1.49 (GND), U1.74 (GND), U1.99 (GND), VR1.1 (GND); also elsewhere on the board
unnamed: D1.2 (A), R1.2
unnamed: D2.2 (A), R5.2
unnamed: D3.2 (A), R8.2
unnamed: D4.2 (A), R9.1
unnamed: J1.A5 (CC1), R2.1
unnamed: J1.B5 (CC2), R3.2
unnamed: U1.23 (CTS1/GPIO2), U1.24 (RTS1/GPIO3)
unnamed: U1.31 (CTS6/GPIO16), U1.32 (RTS6/GPIO17)
unnamed: U1.35 (CTS7/GPIO18), U1.36 (RTS7/GPIO19)
unnamed: U1.51 (CTS3/GPIO6), U1.54 (RTS3/GPIO7)
unnamed: U1.52 (CTS2/GPIO4), U1.53 (RTS2/GPIO5)
unnamed: U1.70 (CTS0/GPIO0), U1.71 (RTS0/GPIO1)
unnamed: U1.90 (CTS4/GPIO12), U1.91 (RTS4/GPIO13)
unnamed: U1.95 (CTS5/GPIO14), U1.96 (RTS5/GPIO15)
