TomKeddie/prj-pcb-experiments/ch348_octo_serial_minim/ch348_octo_serial_minim.kicad_pcb

## KiCad design ch348_octo_serial_minim/ch348_octo_serial_minim.kicad_pcb (continued)

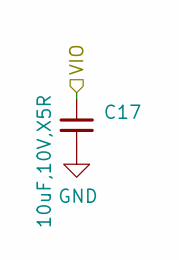
[picture p224: schematic serial-connectors.kicad_sch]

Parts:
C17: 10uF,10V,X5R; C_0603_1608Metric; MFGPN CL10A106KP8NNNC; LCSC C19702

Connections:
+3.3V: C17.1; also elsewhere on the board
GND: C17.2; also elsewhere on the board

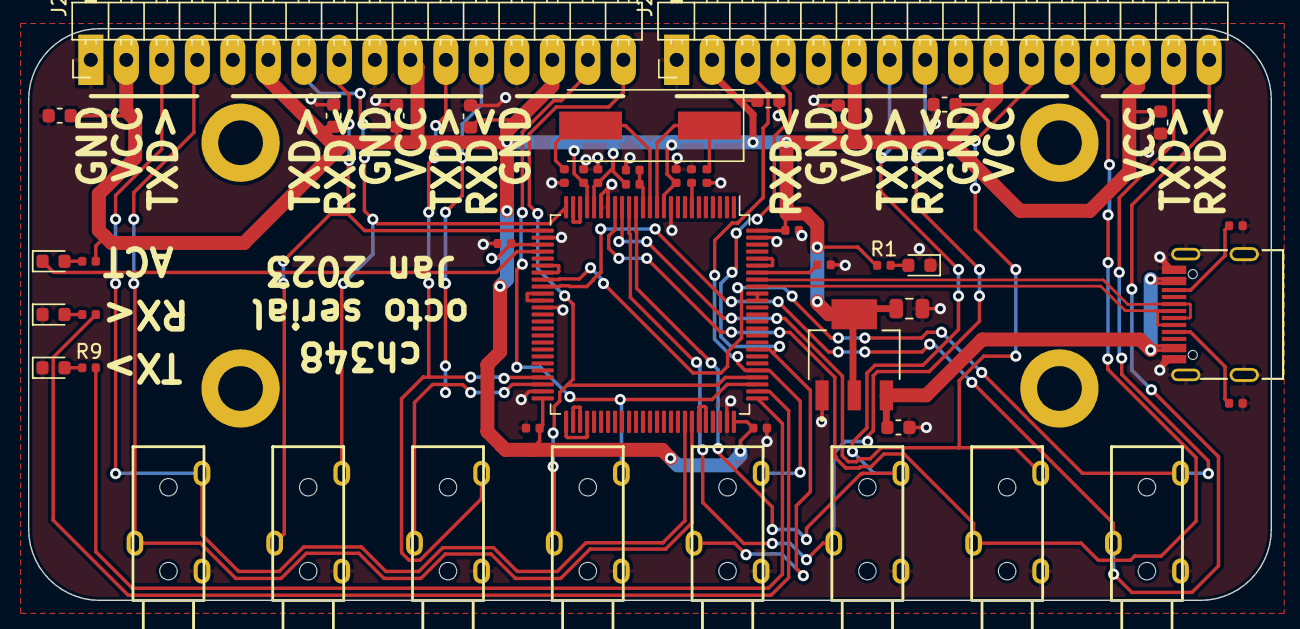
[picture p225: board ch348_octo_serial_minim.kicad_pcb from above]

Board: 2 copper layers, 88.9 x 40.9 mm, 51 parts (0 on the bottom side), 43 nets.

Other parts of the board:
C13, C14, C15, C16, C18, C19, C20: 10uF,10V,X5R; C_0603_1608Metric

Their connections:
+3.3V: C13.1, C14.1, C15.1, C16.1, C18.1, C19.1, C20.1; also elsewhere on the board
GND: C13.2, C14.2, C15.2, C16.2, C18.2, C19.2, C20.2; also elsewhere on the board
