TomKeddie/prj-pcb-experiments/ch348_octo_serial/ch348_octo_serial.kicad_pcb

## KiCad design ch348_octo_serial/ch348_octo_serial.kicad_pcb (2022-12-15)

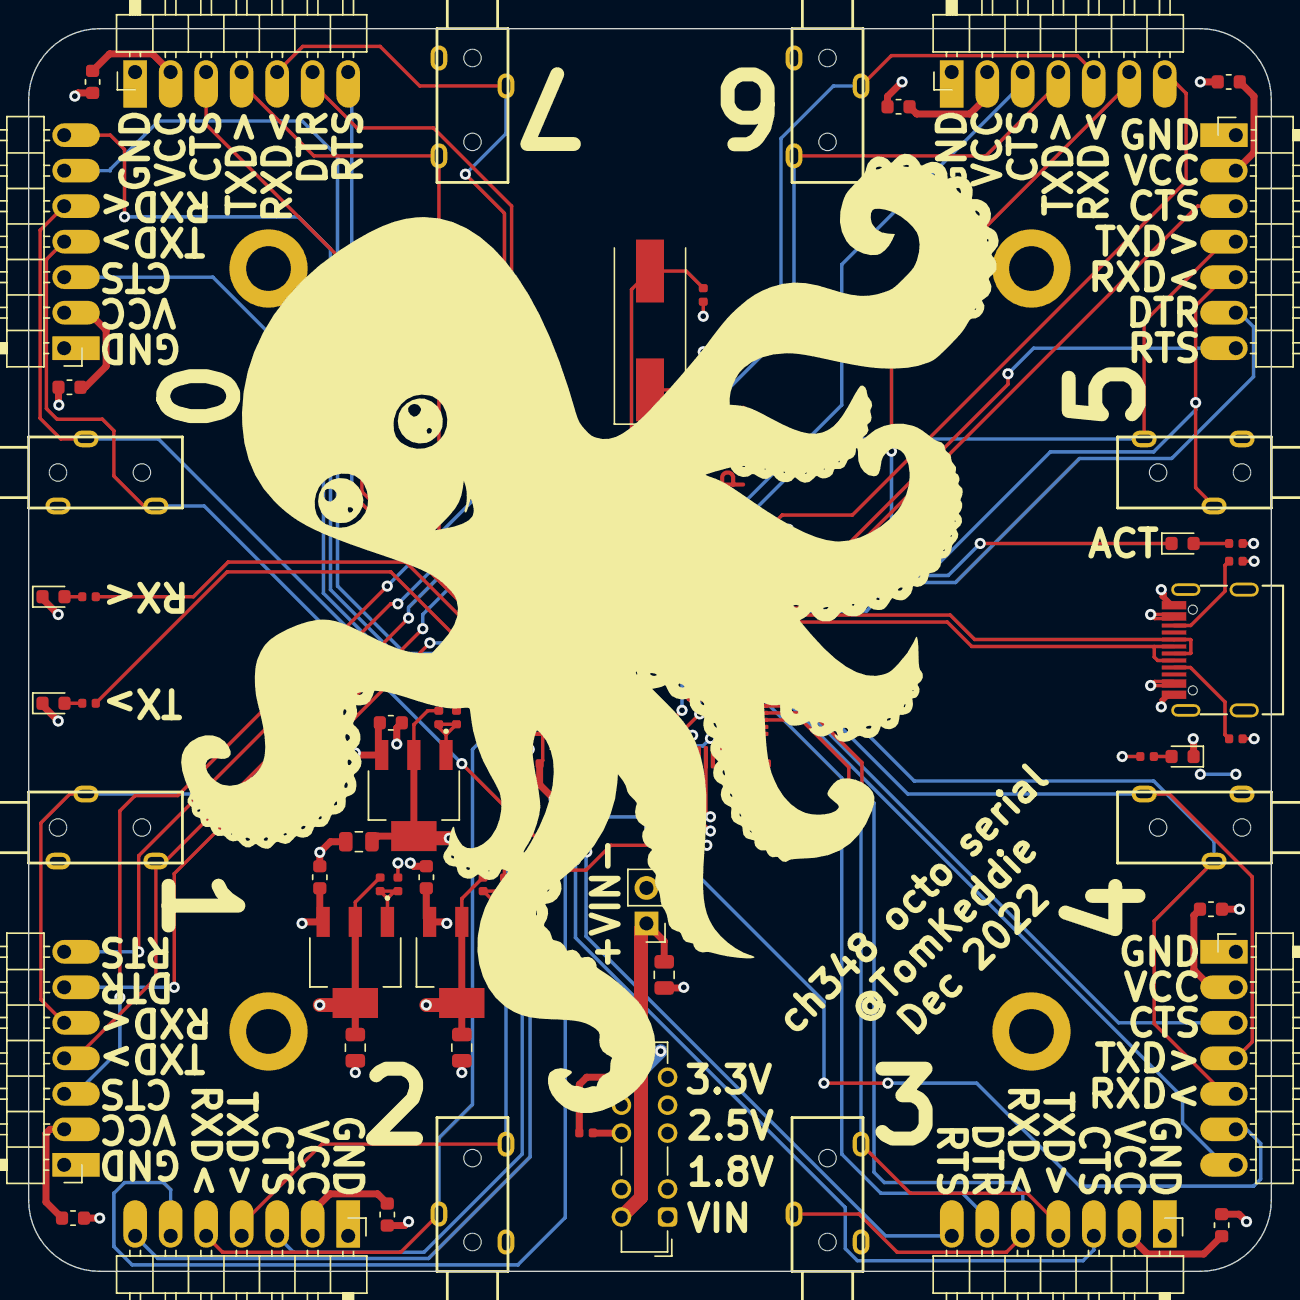
[picture p226: board ch348_octo_serial.kicad_pcb from above]

Board: 4 copper layers, 88.9 x 88.9 mm, 75 parts (1 on the bottom side), 66 nets.

Parts:
C1, C2, C3: 10uF,25V,X5R; C_0603_1608Metric
C4, C5, C6, C16: 47uF,6.3V,X5R; C_0805_2012Metric
C7, C10, C11, C12, C13, C14, C15, C17: 100nF,16V,X7R; C_0402_1005Metric
C8, C9: 10pF,50V,C0G; C_0402_1005Metric
C18, C19, C20, C21, C22, C23, C24, C25: 10uF,10V,X5R; C_0603_1608Metric
D1: WHITE; LED_0603_1608Metric
D2: BLUE; LED_0603_1608Metric
D3: YELLOW; LED_0603_1608Metric
D4: GREEN; LED_0603_1608Metric
H1: Front Octopus; octopus
H2: Back Octopus; octopus_120
J1: USB_C_Receptacle_USB2.0; USB_C_Receptacle_LCSC_C165948
J2, J3, J4, J5: Conn_01x01; MountingHole_3.2mm_M3_DIN965_Pad
J6: VEXT; PinHeader_1x02_P2.54mm_Vertical
J7, J9, J11, J13, J15, J17, J19, J21: JLCPCB_3.5MM_SOCKET_C18166
J8, J10, J12, J14, J16, J18, J20, J22: Conn_01x07; PinHeader_1x07_P2.54mm_Horizontal_Teardrop
R1, R11, R14, R15: 1k; R_0402_1005Metric
R2: 24k; R_0402_1005Metric
R3: 39k; R_0402_1005Metric
R4, R5: 10k; R_0402_1005Metric
R6: 18k; R_0402_1005Metric
R7: 8.2k; R_0402_1005Metric
R8, R9: 5.1k; R_0402_1005Metric
R10, R12, R13: 4.7k; R_0402_1005Metric
R16: 0; R_0402_1005Metric
SW1: SW_DP4T; SW_ALPS_SSSS224100_DP4T
U1: CH348L; LQFP-100_14x14mm_P0.5mm
VR1, VR2, VR3: LM1117S-ADJ; VREG_LM1117MPX-3.3
X1: 8MHz; Crystal_SMD_HC49-SD

Connections:
+1V8: C6.1, R6.1, SW1.7, VR3.2 (VOUT_2), VR3.4 (VOUT_4)
+2V5: C5.1, R4.1, SW1.9, VR2.2 (VOUT_2), VR2.4 (VOUT_4)
+3.3V: C4.1, C11.1, C13.1, C15.1, R1.1, R2.1, R10.1, R11.1, R16.2, SW1.10, U1.11 (VCC), U1.28 (VCC), U1.75 (VCC), VR1.2 (VOUT_2), VR1.4 (VOUT_4)
+5V: C1.1, C2.1, C3.1, J1.A4 (VBUS), J1.A9 (VBUS), J1.B4 (VBUS), J1.B9 (VBUS), VR1.3 (VIN), VR2.3 (VIN), VR3.3 (VIN)
/ACT: D2.1 (K), U1.29 (ACT)
/CFG: R13.2, U1.7 (CFG)
/RESET: C7.1, R10.2, U1.14 (RESET)
/RX_S: R14.1, U1.77 (RX_S)
/Serial Connector 0/CTS: J16.3, U1.70 (CTS0/GPIO0)
/Serial Connector 0/DTR: J16.6, U1.72 (DTR0/TNOW0/GPIO8)
/Serial Connector 0/RTS: J16.7, U1.71 (RTS0/GPIO1)
/Serial Connector 0/RXD: J15.2 (RING), J16.5, U1.69 (RXD0)
/Serial Connector 0/TXD: J15.4 (TIP), J16.4, U1.68 (TXD0)
/Serial Connector 1/CTS: J18.3, U1.23 (CTS1/GPIO2)
/Serial Connector 1/DTR: J18.6, U1.30 (DTR1/TNOW1/GPIO9)
/Serial Connector 1/RTS: J18.7, U1.24 (RTS1/GPIO3)
/Serial Connector 1/RXD: J17.2 (RING), J18.5, U1.26 (RXD1)
/Serial Connector 1/TXD: J17.4 (TIP), J18.4, U1.25 (TXD1)
/Serial Connector 2/CTS: J20.3, U1.52 (CTS2/GPIO4)
/Serial Connector 2/DTR: J20.6, U1.67 (DTR2/TNOW2/GPIO10)
/Serial Connector 2/RTS: J20.7, U1.53 (RTS2/GPIO5)
/Serial Connector 2/RXD: J19.2 (RING), J20.5, U1.48 (RXD2)
/Serial Connector 2/TXD: J19.4 (TIP), J20.4, U1.47 (TXD2)
/Serial Connector 3/CTS: J22.3, U1.51 (CTS3/GPIO6)
/Serial Connector 3/DTR: J22.6, U1.89 (DTR3/TNOW3/GPIO11)
/Serial Connector 3/RTS: J22.7, U1.54 (RTS3/GPIO7)
/Serial Connector 3/RXD: J21.2 (RING), J22.5, U1.79 (RXD3)
/Serial Connector 3/TXD: J21.4 (TIP), J22.4, U1.78 (TXD3)
/Serial Connector 4/CTS: J8.3, U1.90 (CTS4/GPIO12)
/Serial Connector 4/DTR: J8.6, U1.63 (DTR4/TNOW4/GPIO20)
/Serial Connector 4/RTS: J8.7, U1.91 (RTS4/GPIO13)
/Serial Connector 4/RXD: J7.2 (RING), J8.5, U1.83 (RXD4)
/Serial Connector 4/TXD: J7.4 (TIP), J8.4, U1.80 (TXD4)
/Serial Connector 5/CTS: J10.3, U1.95 (CTS5/GPIO14)
/Serial Connector 5/DTR: J10.6, U1.64 (DTR5/TNOW5/GPIO21)
/Serial Connector 5/RTS: J10.7, U1.96 (RTS5/GPIO15)
/Serial Connector 5/RXD: J9.2 (RING), J10.5, U1.16 (RXD5)
/Serial Connector 5/TXD: J9.4 (TIP), J10.4, U1.15 (TXD5)
/Serial Connector 6/CTS: J12.3, U1.31 (CTS6/GPIO16)
/Serial Connector 6/DTR: J12.6, U1.65 (DTR6/TNOW6/GPIO22)
/Serial Connector 6/RTS: J12.7, U1.32 (RTS6/GPIO17)
/Serial Connector 6/RXD: J11.2 (RING), J12.5, U1.18 (RXD6)
/Serial Connector 6/TXD: J11.4 (TIP), J12.4, U1.17 (TXD6)
/Serial Connector 7/CTS: J14.3, U1.35 (CTS7/GPIO18)
/Serial Connector 7/DTR: J14.6, U1.66 (DTR7/TNOW7/GPIO23)
/Serial Connector 7/RTS: J14.7, U1.36 (RTS7/GPIO19)
/Serial Connector 7/RXD: J13.2 (RING), J14.5, U1.34 (RXD7)
/Serial Connector 7/TXD: J13.4 (TIP), J14.4, U1.33 (TXD7)
/TEST: R12.2, U1.94 (TEST)
/TX_S: R15.1, U1.76 (TX_S)
/USB_N: J1.A7 (D-), J1.B7 (D-), U1.92 (USB_N)
/USB_P: J1.A6 (D+), J1.B6 (D+), U1.93 (USB_P)
/XI: C8.1, U1.12 (XI), X1.1
/XO: C9.1, U1.13 (XO), X1.2
GND: C1.2, C2.2, C3.2, C4.2, C5.2, C6.2, C7.2, C8.2, C9.2, C10.2, C11.2, C12.2, C13.2, C14.2, C15.2, C16.2, C17.2, C18.2, C19.2, C20.2, C21.2, C22.2, C23.2, C24.2, C25.2, D1.1 (K), D3.1 (K), D4.1 (K), J1.A1 (GND), J1.A12 (GND), J1.B1 (GND), J1.B12 (GND), J1.S1 (SHIELD), J6.2, J7.3 (SLEEVE), J8.1, J9.3 (SLEEVE), J10.1, J11.3 (SLEEVE), J12.1, J13.3 (SLEEVE), J14.1, J15.3 (SLEEVE), J16.1, J17.3 (SLEEVE), J18.1, J19.3 (SLEEVE), J20.1, J21.3 (SLEEVE), J22.1, R3.2, R5.2, R7.2, R8.2, R9.1, R12.1, R13.1, U1.10 (GND), U1.19 (GND), U1.20 (GND), U1.27 (GND), U1.37 (GND), U1.49 (GND), U1.74 (GND), U1.99 (GND)
unnamed: C16.1, J6.1, SW1.6
unnamed: D1.2 (A), R1.2
unnamed: D2.2 (A), R11.2
unnamed: D3.2 (A), R14.2
unnamed: D4.2 (A), R15.2
unnamed: J1.A5 (CC1), R8.1
unnamed: J1.B5 (CC2), R9.2
unnamed: R2.2, R3.1, VR1.1 (GND)
unnamed: R4.2, R5.1, VR2.1 (GND)
unnamed: R6.2, R7.1, VR3.1 (GND)
Vdrive: C10.1, C12.1, C14.1, C17.1, C18.1, C19.1, C20.1, C21.1, C22.1, C23.1, C24.1, C25.1, J8.2, J10.2, J12.2, J14.2, J16.2, J18.2, J20.2, J22.2, R16.1, SW1.8, U1.21 (VIO), U1.22 (VIO), U1.50 (VIO), U1.100 (VIO)
