TomKeddie/prj-pcb-experiments/tag-connect-breakout/tag-connect-breakout.kicad_pcb

## KiCad design tag-connect-breakout/tag-connect-breakout.kicad_pcb (2022-05-18)

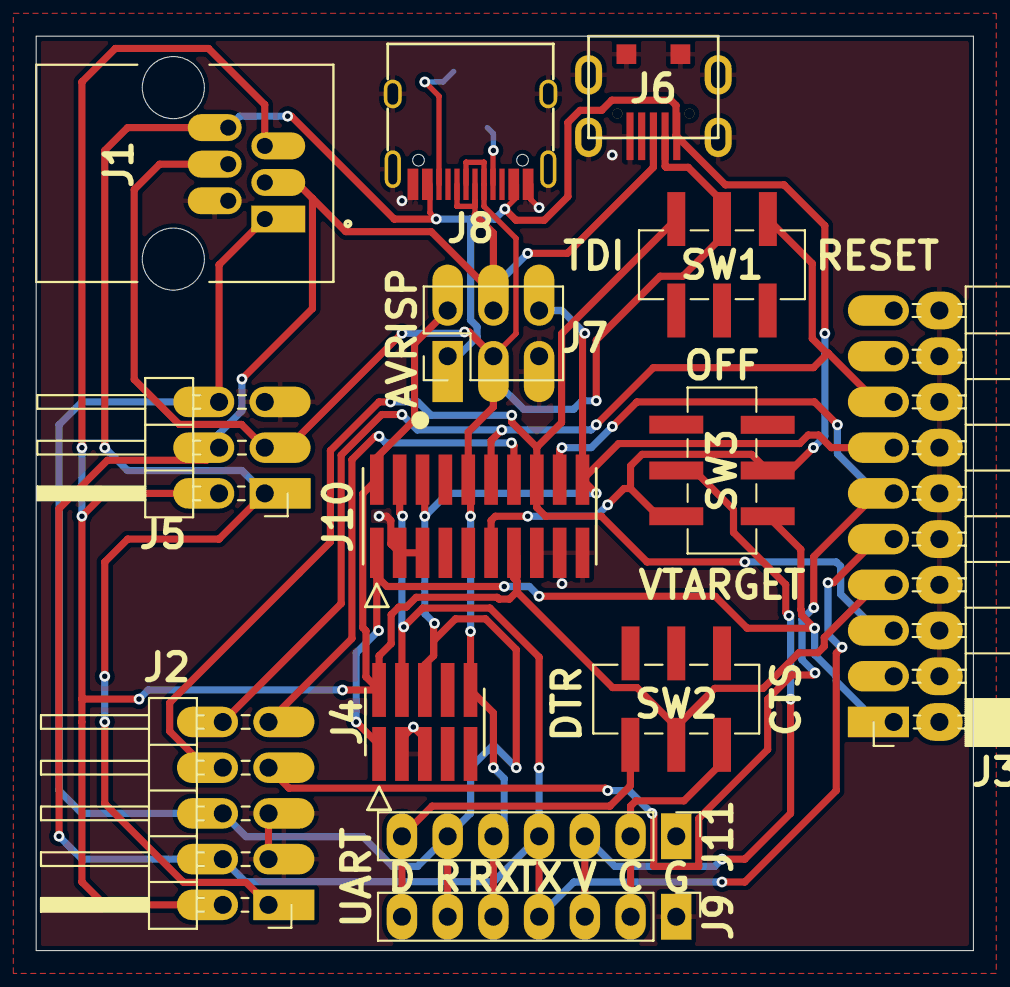
[picture p227: board tag-connect-breakout.kicad_pcb from above]

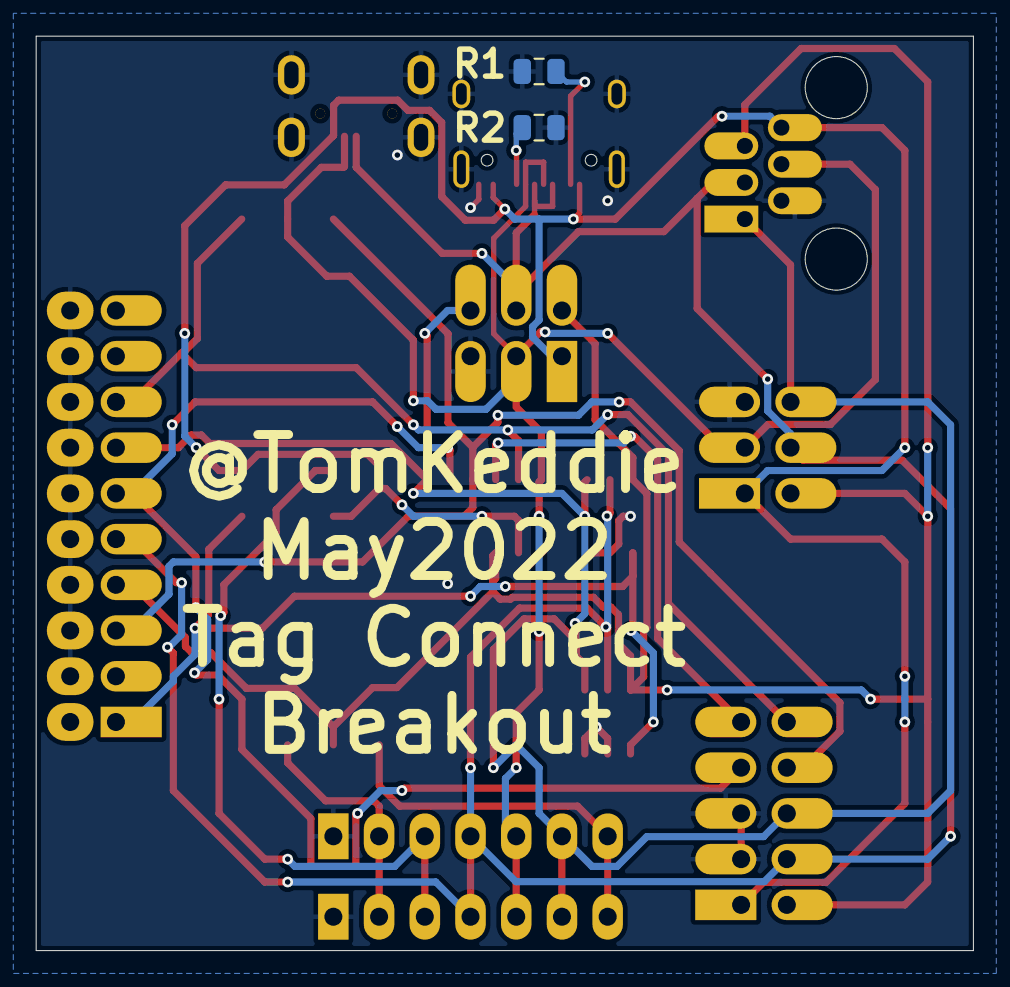
[picture p228: board tag-connect-breakout.kicad_pcb from below]

Board: 2 copper layers, 52.1 x 50.8 mm, 16 parts (2 on the bottom side), 16 nets.

Parts:
J1: 6_RJ12; RJ12-6P-6C-SMD-RJE0166001
J2: Conn_02x05_Odd_Even; PinHeader_2x05_P2.54mm_Horizontal
J3: 6_JTAG20; PinSocket_2x10_P2.54mm_Horizontal
J4: CORTEX10; FTSH-105-01-F-DV-K
J5: 6_IDC; PinHeader_2x03_P2.54mm_Horizontal
J6: 6_USB; USB_MICRO_TAOBAO_SMD_PTH
J7: 6_AVR_ISP; PinHeader_2x03_P2.54mm_Vertical
J8: USB_C_Receptacle_USB2.0; USB_C_Receptacle_GT-USB-7010
J9: UART1; PinHeader_1x07_P2.54mm_Vertical
J10: CORTEX20; FTSH-110-01-F-DV-K
J11: UART2; PinHeader_1x07_P2.54mm_Vertical
R1, R2: 5.1k; R_0805_2012Metric
SW1, SW2, SW3: SW_DPDT_x2; SW_DPDT_SMD

Connections:
6-3: J1.4, J4.10, J5.3, J6.2 (D-), J7.3, J8.A7 (D-), J8.B7 (D-), J9.5, J10.10, J11.5, SW1.2 (B)
10-1: J1.6, J2.1, J5.1, J6.1 (VBUS), J7.1, J8.A4 (VBUS), J8.A9 (VBUS), J8.B4 (VBUS), J8.B9 (VBUS), J10.11, SW3.1 (A), SW3.5 (B)
10-2: J1.5, J2.2, J3.7, J4.2, J5.2, J7.2, J10.2, J10.13, SW2.2 (B)
10-3: J1.2, J2.3, J2.5, J3.4, J3.6, J3.8, J3.10, J3.12, J3.14, J3.16, J3.18, J3.20, J4.3, J4.5, J5.5, J6.5 (GND), J6.6 (Shield), J7.5, J8.A1 (GND), J8.A12 (GND), J8.B1 (GND), J8.B12 (GND), J8.S1 (SHIELD), J9.1, J10.3, J10.5, J10.15, J10.17, J10.19, J11.1, R1.1, R2.2
10-4: J1.3, J2.4, J3.9, J4.4, J5.4, J6.3 (D+), J7.4, J8.A6 (D+), J8.B6 (D+), J9.4, J10.4, J11.4
10-6: J1.1, J2.6, J3.13, J4.6, J5.6, J7.6, J9.6, J10.6, J10.20, J11.6
10-7: J2.7, J3.11, J10.18
10-8: J2.8, J3.5, J10.16, SW1.1 (A)
10-9: J2.9, J10.14
10-10: J2.10, J3.15, J10.12, SW1.3 (C)
/UART_VCC_SW: J9.3, J11.3, SW3.2 (B)
/USB_CC1: J8.A5 (CC1), R2.1
/USB_CC2: J8.B5 (CC2), R1.2
JTAG_VCC: J3.1, J4.1, J10.1, SW3.4 (A)
UART_CTS: J9.2, J11.2, SW2.1 (A)
UART_DTR: J9.7, J11.7, SW2.3 (C)
