TomKeddie/prj-pcb-experiments/ft4232h-breakout/v2.x/ft4232h-breakout.kicad_pcb

## KiCad design ft4232h-breakout/v2.x/ft4232h-breakout.kicad_pcb (2022-05-12, an earlier design)

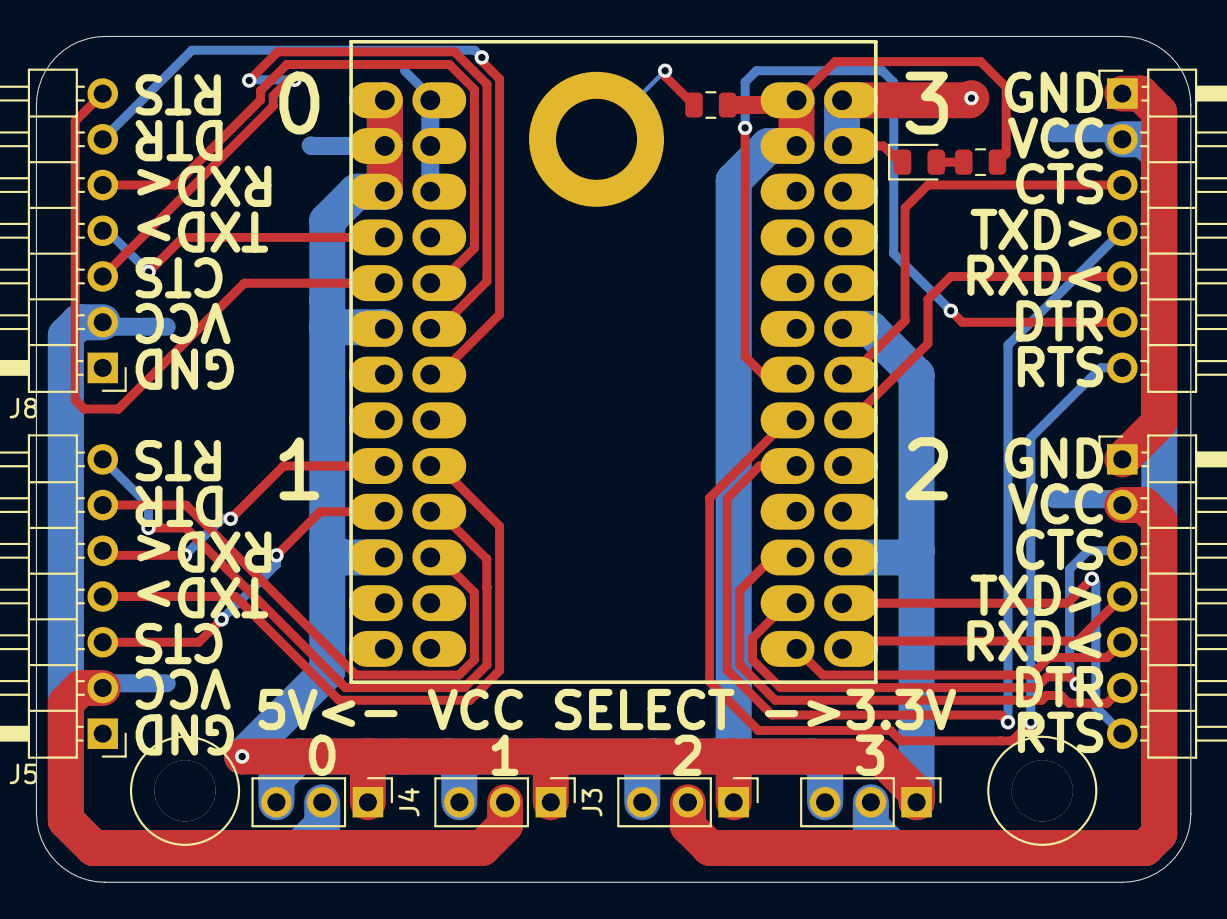
[picture p229: board ft4232h-breakout/v2.x/ft4232h-breakout.kicad_pcb from above]

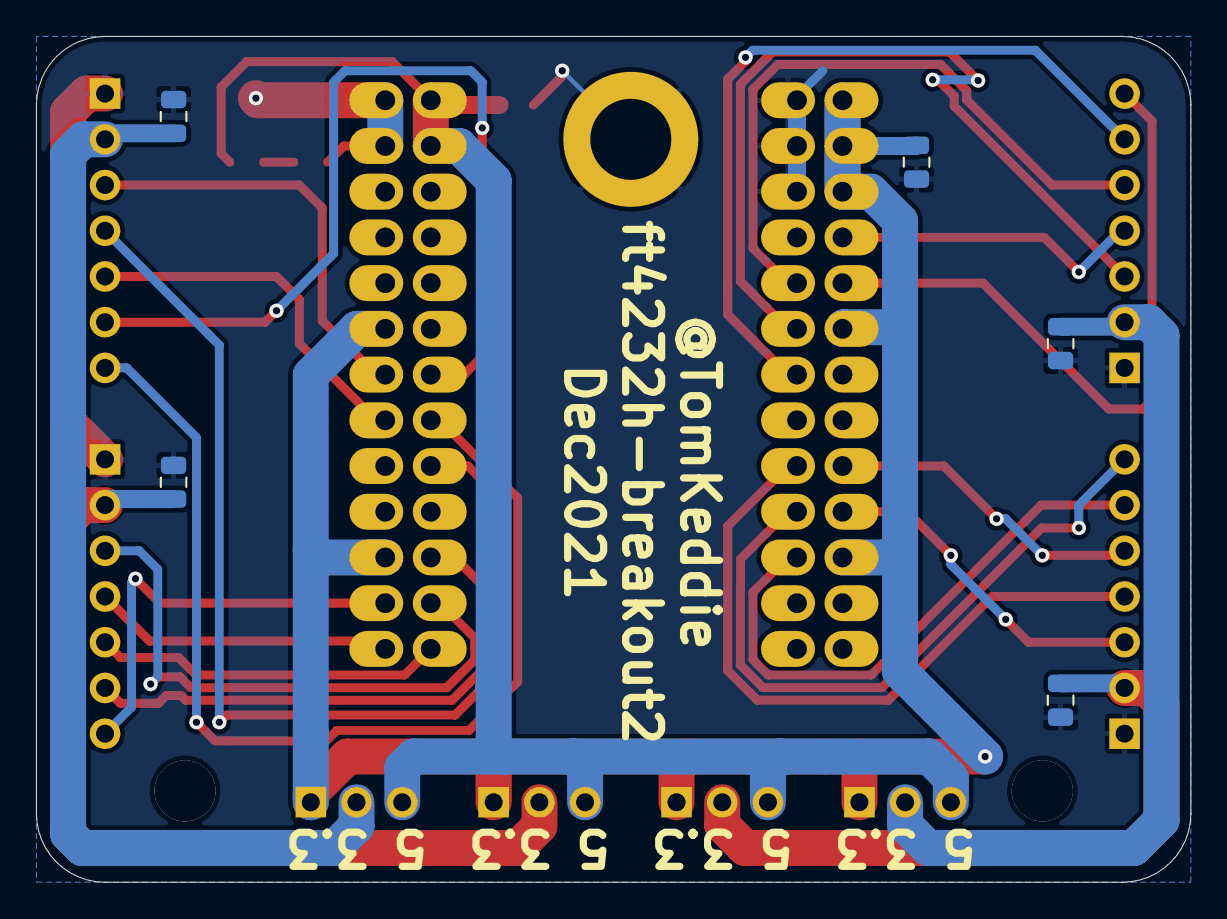
[picture p230: board ft4232h-breakout/v2.x/ft4232h-breakout.kicad_pcb from below]

Board: 2 copper layers, 64.1 x 47.0 mm, 18 parts (6 on the bottom side), 28 nets.

Parts:
C1, C2, C3, C4, C5, C6: 10uF/10V; C_0805_2012Metric
D1: LED; LED_0805_2012Metric
J1, J2, J3, J4: Conn_01x03; PinHeader_1x03_P2.54mm_Vertical
J5, J6, J7, J8: Conn_01x07; PinHeader_1x07_P2.54mm_Horizontal
R2: 1k; R_0805_2012Metric
TP1: TestPoint; STUD_SOLDER_SMTSO_M3
X1: FT4232H-MODULE

Connections:
+3V3: C2.1, J1.1, J2.1, J3.1, J4.1, X1.2-1, X1.2-3, X1.2-5, X1.2-11, X1.2-21, X1.3-12, X1.3-22
+5V: C1.2, J1.3, J2.3, J3.3, J4.3, R2.1, X1.3-1, X1.3-3
/CTS-A: J8.3, X1.2-12
/CTS-B: J5.3, X1.2-19
/CTS-C: J7.3, X1.3-23
/CTS-D: J6.3, X1.3-14
/DTR-A: J8.6, X1.2-14
/DTR-B: J5.6, X1.2-22
/DTR-C: J7.6, X1.3-21
/DTR-D: J6.6, X1.3-13
/RTS-A: J8.7, X1.2-9
/RTS-B: J5.7, X1.2-20
/RTS-C: J7.7, X1.3-24
/RTS-D: J6.7, X1.3-15
/RXD-A: J8.5, X1.2-10
/RXD-B: J5.5, X1.2-17
/RXD-C: J7.5, X1.3-25
/RXD-D: J6.5, X1.3-16
/TXD-A: J8.4, X1.2-7
/TXD-B: J5.4, X1.2-18
/TXD-C: J7.4, X1.3-26
/TXD-D: J6.4, X1.3-17
/VCC-A: C5.1, J4.2, J8.2
/VCC-B: C4.1, J3.2, J5.2
/VCC-C: C3.1, J2.2, J7.2
/VCC-D: C6.1, J1.2, J6.2
GND: C1.1, C2.2, C3.2, C4.2, C5.2, C6.2, D1.1, J5.1, J6.1, J7.1, J8.1, TP1.1, X1.2-2, X1.2-4, X1.2-6, X1.3-2, X1.3-4
unnamed: D1.2, R2.2
