TomKeddie/prj-pcb-experiments/rc2014-compat-backplane/rc2014-compat-backplane.kicad_pcb

## KiCad design rc2014-compat-backplane/rc2014-compat-backplane.kicad_pcb (2022-02-06)

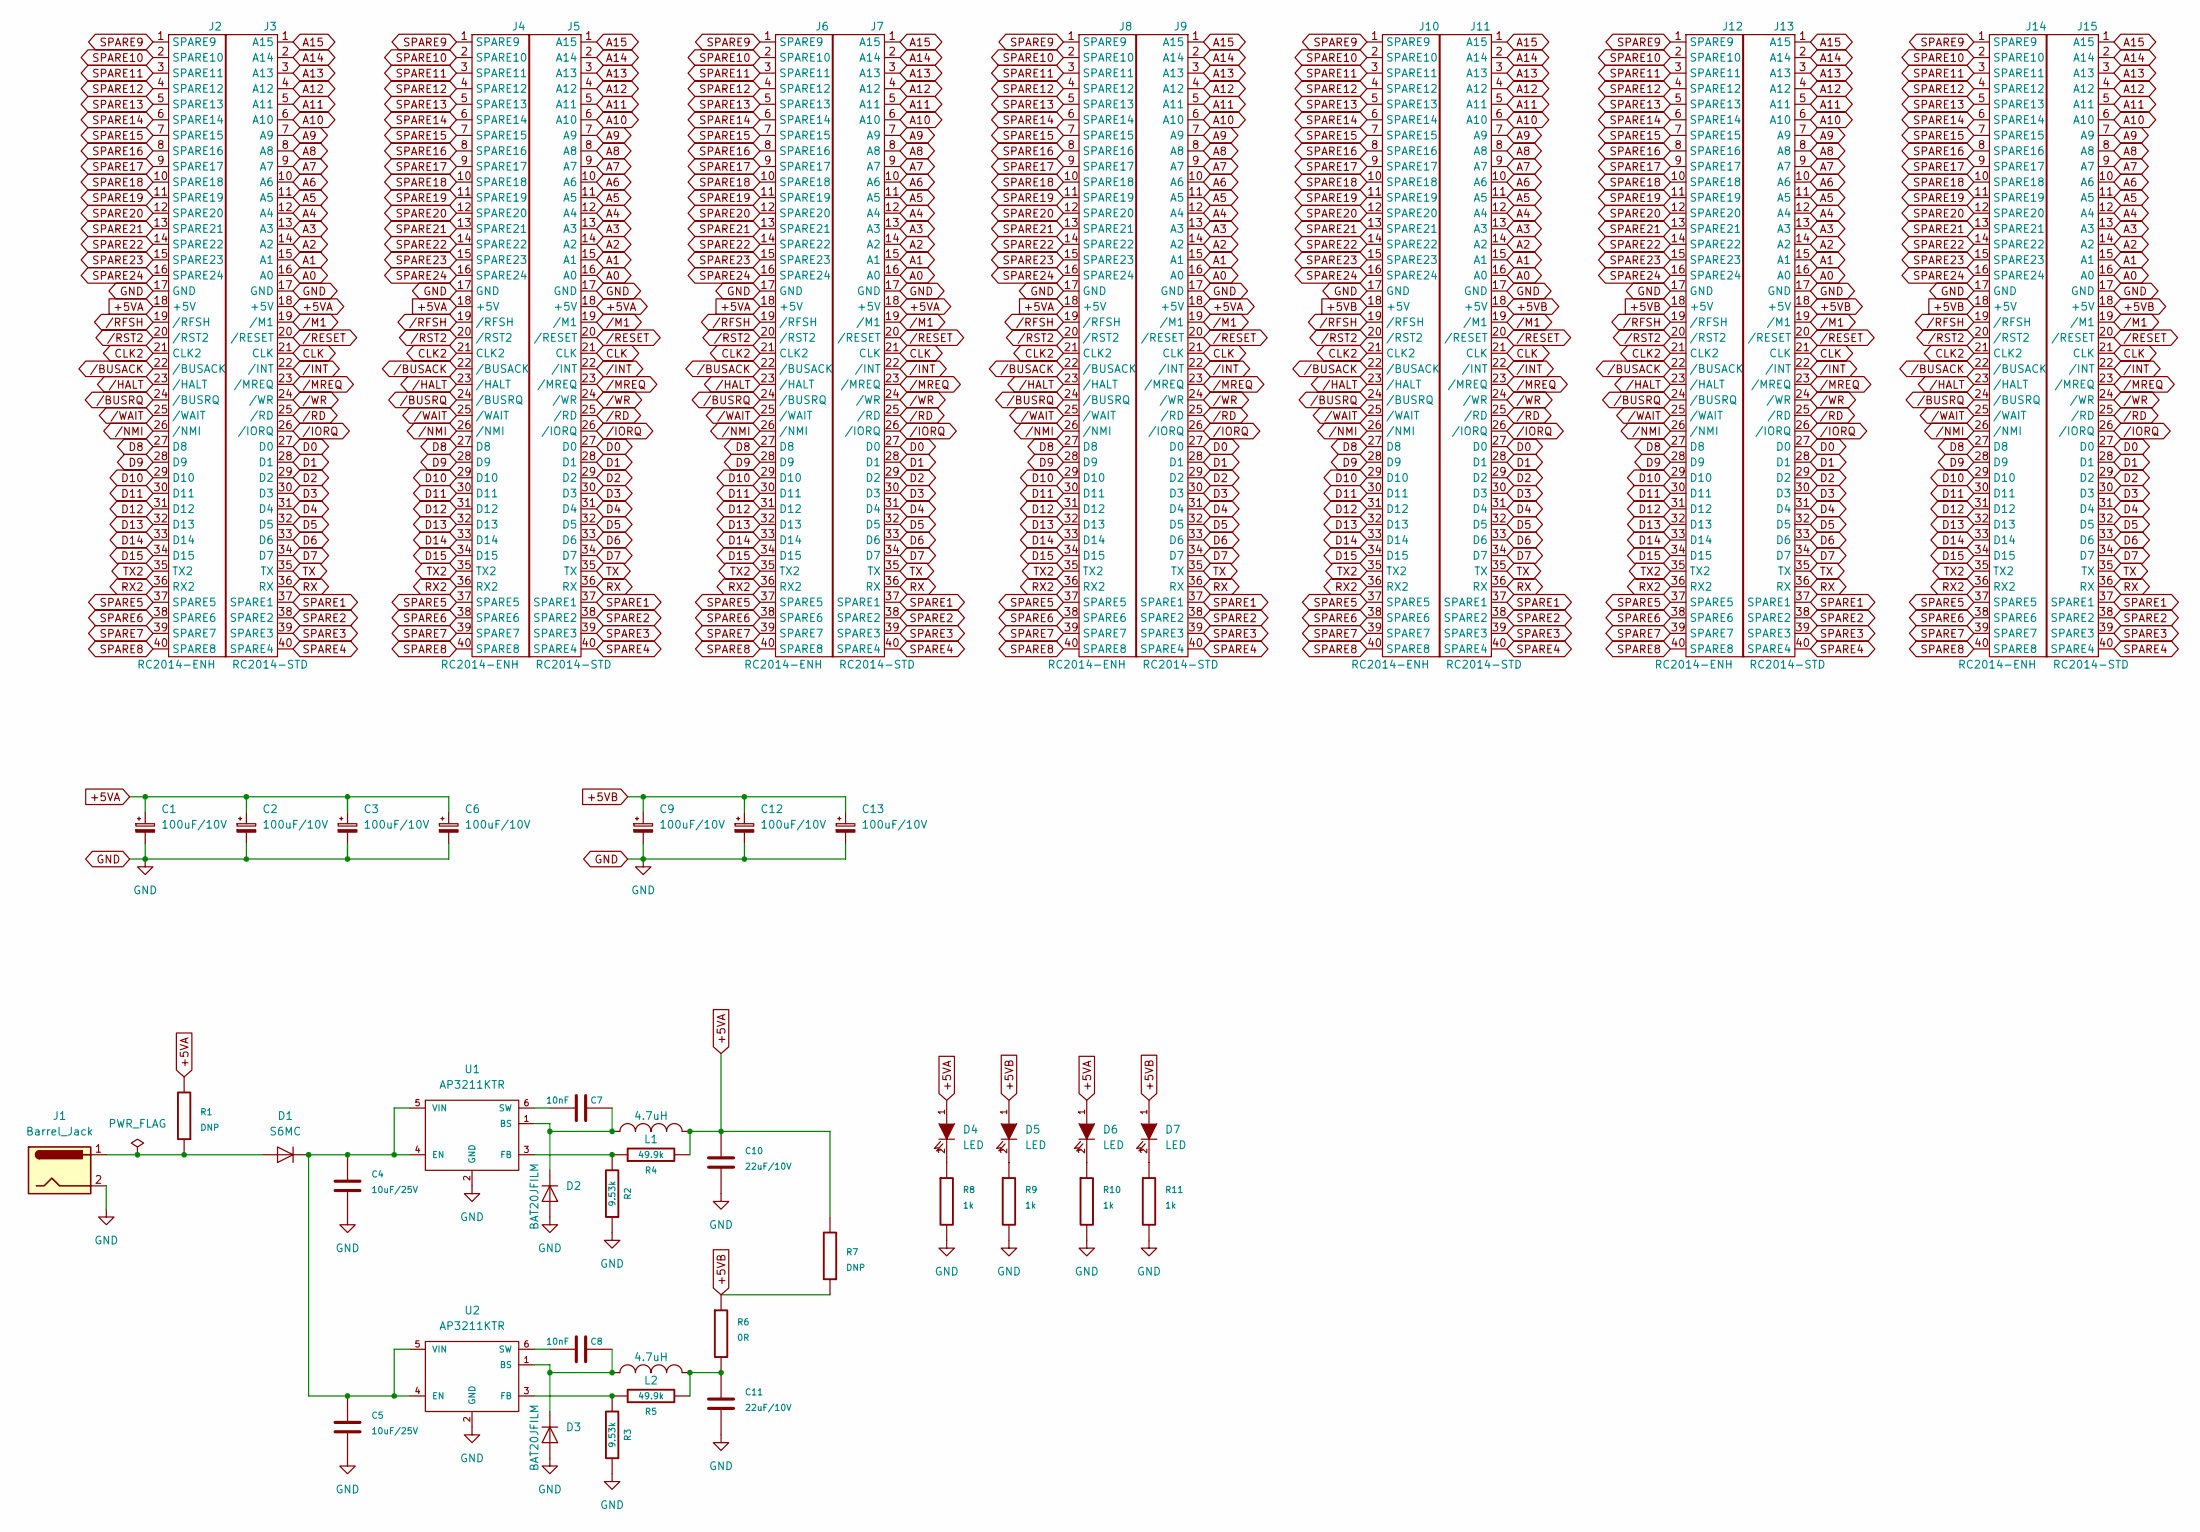
[picture p231: schematic rc2014-compat-backplane.kicad_sch]

Parts:
C1, C2, C3, C6, C9, C12: 100uF/10V; CP_MIXED_SMT_PTH_7343_5mm; LCSC DNP
C4, C5: 10uF/25V; C_0805_2012Metric_Pad1.15x1.40mm_HandSolder; LCSC DNP
C7, C8: 10nF; C_0805_2012Metric; LCSC DNP
C10, C11: 22uF/10V; C_0805_2012Metric_Pad1.15x1.40mm_HandSolder; LCSC DNP
C13: 100uF/10V; CP_EIA-7343-31_Kemet-D_Pad2.25x2.55mm_HandSolder; LCSC DNP
D1: S6MC; D_SMC; LCSC C382843
D2, D3: BAT20JFILM; D_SOD-323_HandSoldering
D4, D5: LED; LED_1206_3216Metric
D6, D7: LED; LED_D5.0mm
J1: Barrel_Jack; BarrelJack_CLIFF_FC681465S_SMT_Horizontal
J2, J4, J6, J8, J10, J12, J14: RC2014-ENH
J3, J5, J7, J9, J11, J13, J15: RC2014-STD
L1, L2: 4.7uH; L_Taiyo-Yuden_NR-50xx
R1, R7: DNP; R_Axial_DIN0204_L3.6mm_D1.6mm_P5.08mm_Horizontal; LCSC DNP
R2, R3: 9.53k; R_0805_2012Metric; LCSC DNP
R4, R5: 49.9k; R_0805_2012Metric; LCSC DNP
R6: 0R; R_0805_2012Metric; LCSC DNP
R8, R9: 1k; R_0805_2012Metric; LCSC DNP
R10, R11: 1k; R_Axial_DIN0204_L3.6mm_D1.6mm_P5.08mm_Horizontal; LCSC DNP
U1, U2: AP3211KTR; SOT-23-6

Connections:
+5VA: C1.1, C2.1, C3.1, C6.1, C10.1, D4.1 (A), D6.1 (A), J2.18 (+5V), J3.18 (+5V), J4.18 (+5V), J5.18 (+5V), J6.18 (+5V), J7.18 (+5V), J8.18 (+5V), J9.18 (+5V), L1.2, R1.2, R4.2, R7.2
+5VB: C9.1, C12.1, C13.1, D5.1 (A), D7.1 (A), J10.18 (+5V), J11.18 (+5V), J12.18 (+5V), J13.18 (+5V), J14.18 (+5V), J15.18 (+5V), R6.1, R7.1
A0: J3.16 (A0), J5.16 (A0), J7.16 (A0), J9.16 (A0), J11.16 (A0), J13.16 (A0), J15.16 (A0)
A1: J3.15 (A1), J5.15 (A1), J7.15 (A1), J9.15 (A1), J11.15 (A1), J13.15 (A1), J15.15 (A1)
A2: J3.14 (A2), J5.14 (A2), J7.14 (A2), J9.14 (A2), J11.14 (A2), J13.14 (A2), J15.14 (A2)
A3: J3.13 (A3), J5.13 (A3), J7.13 (A3), J9.13 (A3), J11.13 (A3), J13.13 (A3), J15.13 (A3)
A4: J3.12 (A4), J5.12 (A4), J7.12 (A4), J9.12 (A4), J11.12 (A4), J13.12 (A4), J15.12 (A4)
A5: J3.11 (A5), J5.11 (A5), J7.11 (A5), J9.11 (A5), J11.11 (A5), J13.11 (A5), J15.11 (A5)
A6: J3.10 (A6), J5.10 (A6), J7.10 (A6), J9.10 (A6), J11.10 (A6), J13.10 (A6), J15.10 (A6)
A7: J3.9 (A7), J5.9 (A7), J7.9 (A7), J9.9 (A7), J11.9 (A7), J13.9 (A7), J15.9 (A7)
A8: J3.8 (A8), J5.8 (A8), J7.8 (A8), J9.8 (A8), J11.8 (A8), J13.8 (A8), J15.8 (A8)
A9: J3.7 (A9), J5.7 (A9), J7.7 (A9), J9.7 (A9), J11.7 (A9), J13.7 (A9), J15.7 (A9)
A10: J3.6 (A10), J5.6 (A10), J7.6 (A10), J9.6 (A10), J11.6 (A10), J13.6 (A10), J15.6 (A10)
A11: J3.5 (A11), J5.5 (A11), J7.5 (A11), J9.5 (A11), J11.5 (A11), J13.5 (A11), J15.5 (A11)
A12: J3.4 (A12), J5.4 (A12), J7.4 (A12), J9.4 (A12), J11.4 (A12), J13.4 (A12), J15.4 (A12)
A13: J3.3 (A13), J5.3 (A13), J7.3 (A13), J9.3 (A13), J11.3 (A13), J13.3 (A13), J15.3 (A13)
A14: J3.2 (A14), J5.2 (A14), J7.2 (A14), J9.2 (A14), J11.2 (A14), J13.2 (A14), J15.2 (A14)
A15: J3.1 (A15), J5.1 (A15), J7.1 (A15), J9.1 (A15), J11.1 (A15), J13.1 (A15), J15.1 (A15)
CLK: J3.21 (CLK), J5.21 (CLK), J7.21 (CLK), J9.21 (CLK), J11.21 (CLK), J13.21 (CLK), J15.21 (CLK)
CLK2: J2.21 (CLK2), J4.21 (CLK2), J6.21 (CLK2), J8.21 (CLK2), J10.21 (CLK2), J12.21 (CLK2), J14.21 (CLK2)
D0: J3.27 (D0), J5.27 (D0), J7.27 (D0), J9.27 (D0), J11.27 (D0), J13.27 (D0), J15.27 (D0)
D1: J3.28 (D1), J5.28 (D1), J7.28 (D1), J9.28 (D1), J11.28 (D1), J13.28 (D1), J15.28 (D1)
D2: J3.29 (D2), J5.29 (D2), J7.29 (D2), J9.29 (D2), J11.29 (D2), J13.29 (D2), J15.29 (D2)
D3: J3.30 (D3), J5.30 (D3), J7.30 (D3), J9.30 (D3), J11.30 (D3), J13.30 (D3), J15.30 (D3)
D4: J3.31 (D4), J5.31 (D4), J7.31 (D4), J9.31 (D4), J11.31 (D4), J13.31 (D4), J15.31 (D4)
D5: J3.32 (D5), J5.32 (D5), J7.32 (D5), J9.32 (D5), J11.32 (D5), J13.32 (D5), J15.32 (D5)
D6: J3.33 (D6), J5.33 (D6), J7.33 (D6), J9.33 (D6), J11.33 (D6), J13.33 (D6), J15.33 (D6)
D7: J3.34 (D7), J5.34 (D7), J7.34 (D7), J9.34 (D7), J11.34 (D7), J13.34 (D7), J15.34 (D7)
D8: J2.27 (D8), J4.27 (D8), J6.27 (D8), J8.27 (D8), J10.27 (D8), J12.27 (D8), J14.27 (D8)
D9: J2.28 (D9), J4.28 (D9), J6.28 (D9), J8.28 (D9), J10.28 (D9), J12.28 (D9), J14.28 (D9)
D10: J2.29 (D10), J4.29 (D10), J6.29 (D10), J8.29 (D10), J10.29 (D10), J12.29 (D10), J14.29 (D10)
D11: J2.30 (D11), J4.30 (D11), J6.30 (D11), J8.30 (D11), J10.30 (D11), J12.30 (D11), J14.30 (D11)
D12: J2.31 (D12), J4.31 (D12), J6.31 (D12), J8.31 (D12), J10.31 (D12), J12.31 (D12), J14.31 (D12)
D13: J2.32 (D13), J4.32 (D13), J6.32 (D13), J8.32 (D13), J10.32 (D13), J12.32 (D13), J14.32 (D13)
D14: J2.33 (D14), J4.33 (D14), J6.33 (D14), J8.33 (D14), J10.33 (D14), J12.33 (D14), J14.33 (D14)
D15: J2.34 (D15), J4.34 (D15), J6.34 (D15), J8.34 (D15), J10.34 (D15), J12.34 (D15), J14.34 (D15)
GND: C1.2, C2.2, C3.2, C4.2, C5.2, C6.2, C9.2, C10.2, C11.2, C12.2, C13.2, D2.2 (A), D3.2 (A), J1.2, J2.17 (GND), J3.17 (GND), J4.17 (GND), J5.17 (GND), J6.17 (GND), J7.17 (GND), J8.17 (GND), J9.17 (GND), J10.17 (GND), J11.17 (GND), J12.17 (GND), J13.17 (GND), J14.17 (GND), J15.17 (GND), R2.1, R3.1, R8.2, R9.2, R10.2, R11.2, U1.2 (GND), U2.2 (GND)
unnamed: C4.1, C5.1, D1.1 (K), U1.4 (EN), U1.5 (VIN), U2.4 (EN), U2.5 (VIN)
unnamed: C7.1, U1.6 (SW)
unnamed: C7.2, D2.1 (K), L1.1, U1.1 (BS)
unnamed: C8.1, U2.6 (SW)
unnamed: C8.2, D3.1 (K), L2.1, U2.1 (BS)
unnamed: C11.1, L2.2, R5.2, R6.2
unnamed: D1.2 (A), J1.1, R1.1
unnamed: D4.2 (K), R8.1
unnamed: D5.2 (K), R9.1
unnamed: D6.2 (K), R10.1
unnamed: D7.2 (K), R11.1
unnamed: R2.2, R4.1, U1.3 (FB)
unnamed: R3.2, R5.1, U2.3 (FB)
RX: J3.36 (RX), J5.36 (RX), J7.36 (RX), J9.36 (RX), J11.36 (RX), J13.36 (RX), J15.36 (RX)
RX2: J2.36 (RX2), J4.36 (RX2), J6.36 (RX2), J8.36 (RX2), J10.36 (RX2), J12.36 (RX2), J14.36 (RX2)
SPARE1: J3.37 (SPARE1), J5.37 (SPARE1), J7.37 (SPARE1), J9.37 (SPARE1), J11.37 (SPARE1), J13.37 (SPARE1), J15.37 (SPARE1)
SPARE2: J3.38 (SPARE2), J5.38 (SPARE2), J7.38 (SPARE2), J9.38 (SPARE2), J11.38 (SPARE2), J13.38 (SPARE2), J15.38 (SPARE2)
SPARE3: J3.39 (SPARE3), J5.39 (SPARE3), J7.39 (SPARE3), J9.39 (SPARE3), J11.39 (SPARE3), J13.39 (SPARE3), J15.39 (SPARE3)
SPARE4: J3.40 (SPARE4), J5.40 (SPARE4), J7.40 (SPARE4), J9.40 (SPARE4), J11.40 (SPARE4), J13.40 (SPARE4), J15.40 (SPARE4)
SPARE5: J2.37 (SPARE5), J4.37 (SPARE5), J6.37 (SPARE5), J8.37 (SPARE5), J10.37 (SPARE5), J12.37 (SPARE5), J14.37 (SPARE5)
SPARE6: J2.38 (SPARE6), J4.38 (SPARE6), J6.38 (SPARE6), J8.38 (SPARE6), J10.38 (SPARE6), J12.38 (SPARE6), J14.38 (SPARE6)
SPARE7: J2.39 (SPARE7), J4.39 (SPARE7), J6.39 (SPARE7), J8.39 (SPARE7), J10.39 (SPARE7), J12.39 (SPARE7), J14.39 (SPARE7)
SPARE8: J2.40 (SPARE8), J4.40 (SPARE8), J6.40 (SPARE8), J8.40 (SPARE8), J10.40 (SPARE8), J12.40 (SPARE8), J14.40 (SPARE8)
SPARE9: J2.1 (SPARE9), J4.1 (SPARE9), J6.1 (SPARE9), J8.1 (SPARE9), J10.1 (SPARE9), J12.1 (SPARE9), J14.1 (SPARE9)
SPARE10: J2.2 (SPARE10), J4.2 (SPARE10), J6.2 (SPARE10), J8.2 (SPARE10), J10.2 (SPARE10), J12.2 (SPARE10), J14.2 (SPARE10)
SPARE11: J2.3 (SPARE11), J4.3 (SPARE11), J6.3 (SPARE11), J8.3 (SPARE11), J10.3 (SPARE11), J12.3 (SPARE11), J14.3 (SPARE11)
SPARE12: J2.4 (SPARE12), J4.4 (SPARE12), J6.4 (SPARE12), J8.4 (SPARE12), J10.4 (SPARE12), J12.4 (SPARE12), J14.4 (SPARE12)
SPARE13: J2.5 (SPARE13), J4.5 (SPARE13), J6.5 (SPARE13), J8.5 (SPARE13), J10.5 (SPARE13), J12.5 (SPARE13), J14.5 (SPARE13)
SPARE14: J2.6 (SPARE14), J4.6 (SPARE14), J6.6 (SPARE14), J8.6 (SPARE14), J10.6 (SPARE14), J12.6 (SPARE14), J14.6 (SPARE14)
SPARE15: J2.7 (SPARE15), J4.7 (SPARE15), J6.7 (SPARE15), J8.7 (SPARE15), J10.7 (SPARE15), J12.7 (SPARE15), J14.7 (SPARE15)
SPARE16: J2.8 (SPARE16), J4.8 (SPARE16), J6.8 (SPARE16), J8.8 (SPARE16), J10.8 (SPARE16), J12.8 (SPARE16), J14.8 (SPARE16)
SPARE17: J2.9 (SPARE17), J4.9 (SPARE17), J6.9 (SPARE17), J8.9 (SPARE17), J10.9 (SPARE17), J12.9 (SPARE17), J14.9 (SPARE17)
SPARE18: J2.10 (SPARE18), J4.10 (SPARE18), J6.10 (SPARE18), J8.10 (SPARE18), J10.10 (SPARE18), J12.10 (SPARE18), J14.10 (SPARE18)
SPARE19: J2.11 (SPARE19), J4.11 (SPARE19), J6.11 (SPARE19), J8.11 (SPARE19), J10.11 (SPARE19), J12.11 (SPARE19), J14.11 (SPARE19)
SPARE20: J2.12 (SPARE20), J4.12 (SPARE20), J6.12 (SPARE20), J8.12 (SPARE20), J10.12 (SPARE20), J12.12 (SPARE20), J14.12 (SPARE20)
SPARE21: J2.13 (SPARE21), J4.13 (SPARE21), J6.13 (SPARE21), J8.13 (SPARE21), J10.13 (SPARE21), J12.13 (SPARE21), J14.13 (SPARE21)
SPARE22: J2.14 (SPARE22), J4.14 (SPARE22), J6.14 (SPARE22), J8.14 (SPARE22), J10.14 (SPARE22), J12.14 (SPARE22), J14.14 (SPARE22)
SPARE23: J2.15 (SPARE23), J4.15 (SPARE23), J6.15 (SPARE23), J8.15 (SPARE23), J10.15 (SPARE23), J12.15 (SPARE23), J14.15 (SPARE23)
SPARE24: J2.16 (SPARE24), J4.16 (SPARE24), J6.16 (SPARE24), J8.16 (SPARE24), J10.16 (SPARE24), J12.16 (SPARE24), J14.16 (SPARE24)
TX: J3.35 (TX), J5.35 (TX), J7.35 (TX), J9.35 (TX), J11.35 (TX), J13.35 (TX), J15.35 (TX)
TX2: J2.35 (TX2), J4.35 (TX2), J6.35 (TX2), J8.35 (TX2), J10.35 (TX2), J12.35 (TX2), J14.35 (TX2)
/BUSACK: J2.22 (/BUSACK), J4.22 (/BUSACK), J6.22 (/BUSACK), J8.22 (/BUSACK), J10.22 (/BUSACK), J12.22 (/BUSACK), J14.22 (/BUSACK)
/BUSRQ: J2.24 (/BUSRQ), J4.24 (/BUSRQ), J6.24 (/BUSRQ), J8.24 (/BUSRQ), J10.24 (/BUSRQ), J12.24 (/BUSRQ), J14.24 (/BUSRQ)
/HALT: J2.23 (/HALT), J4.23 (/HALT), J6.23 (/HALT), J8.23 (/HALT), J10.23 (/HALT), J12.23 (/HALT), J14.23 (/HALT)
/INT: J3.22 (/INT), J5.22 (/INT), J7.22 (/INT), J9.22 (/INT), J11.22 (/INT), J13.22 (/INT), J15.22 (/INT)
/IORQ: J3.26 (/IORQ), J5.26 (/IORQ), J7.26 (/IORQ), J9.26 (/IORQ), J11.26 (/IORQ), J13.26 (/IORQ), J15.26 (/IORQ)
/M1: J3.19 (/M1), J5.19 (/M1), J7.19 (/M1), J9.19 (/M1), J11.19 (/M1), J13.19 (/M1), J15.19 (/M1)
/MREQ: J3.23 (/MREQ), J5.23 (/MREQ), J7.23 (/MREQ), J9.23 (/MREQ), J11.23 (/MREQ), J13.23 (/MREQ), J15.23 (/MREQ)
/NMI: J2.26 (/NMI), J4.26 (/NMI), J6.26 (/NMI), J8.26 (/NMI), J10.26 (/NMI), J12.26 (/NMI), J14.26 (/NMI)
/RD: J3.25 (/RD), J5.25 (/RD), J7.25 (/RD), J9.25 (/RD), J11.25 (/RD), J13.25 (/RD), J15.25 (/RD)
/RESET: J3.20 (/RESET), J5.20 (/RESET), J7.20 (/RESET), J9.20 (/RESET), J11.20 (/RESET), J13.20 (/RESET), J15.20 (/RESET)
/RFSH: J2.19 (/RFSH), J4.19 (/RFSH), J6.19 (/RFSH), J8.19 (/RFSH), J10.19 (/RFSH), J12.19 (/RFSH), J14.19 (/RFSH)
/RST2: J2.20 (/RST2), J4.20 (/RST2), J6.20 (/RST2), J8.20 (/RST2), J10.20 (/RST2), J12.20 (/RST2), J14.20 (/RST2)
/WAIT: J2.25 (/WAIT), J4.25 (/WAIT), J6.25 (/WAIT), J8.25 (/WAIT), J10.25 (/WAIT), J12.25 (/WAIT), J14.25 (/WAIT)
/WR: J3.24 (/WR), J5.24 (/WR), J7.24 (/WR), J9.24 (/WR), J11.24 (/WR), J13.24 (/WR), J15.24 (/WR)
