TomKeddie/prj-pcb-experiments/rc2014-compat-backplane/rc2014-compat-backplane.kicad_pcb

## KiCad design rc2014-compat-backplane/rc2014-compat-backplane.kicad_pcb (continued)

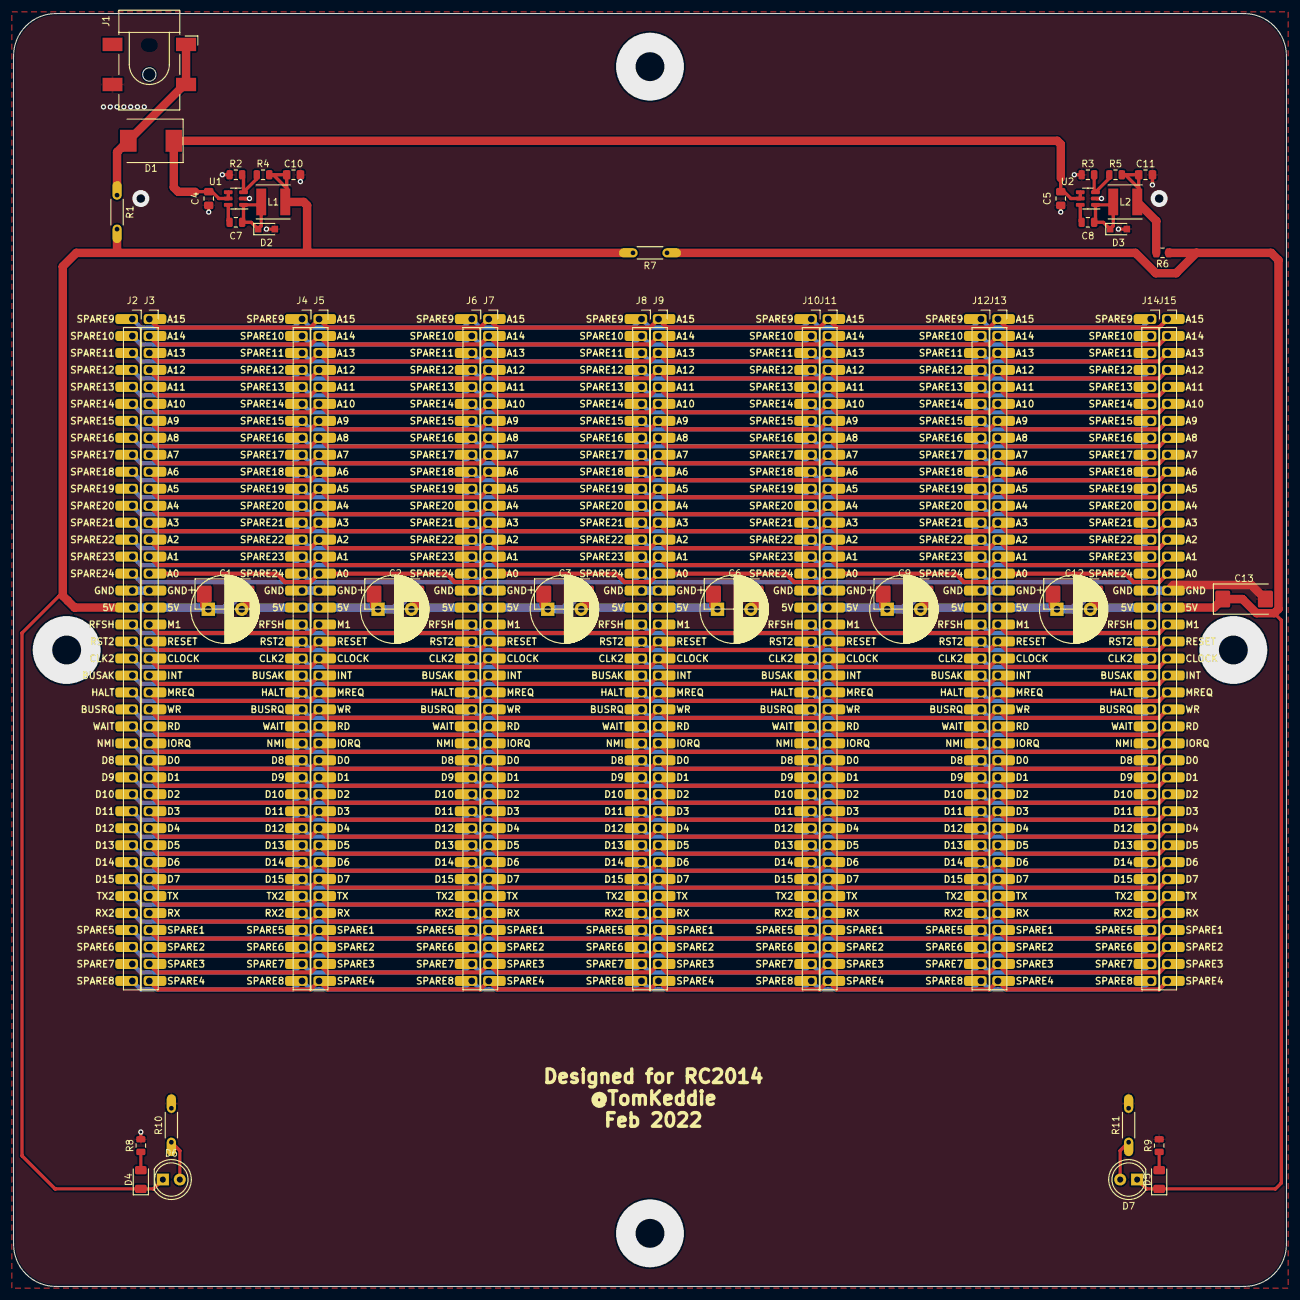
[picture p232: board rc2014-compat-backplane.kicad_pcb from above]

Board: 2 copper layers, 190.5 x 190.5 mm, 50 parts (0 on the bottom side), 92 nets.
