TomKeddie/prj-pcb-experiments/usb-c-power-toggle/usb-c-power-toggle.kicad_pcb

## KiCad design usb-c-power-toggle/usb-c-power-toggle.kicad_pcb (2022-01-22)

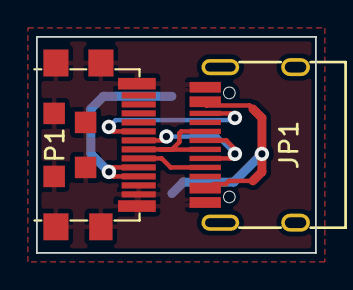
[picture p233: board usb-c-power-toggle.kicad_pcb from above]

Board: 2 copper layers, 15.5 x 12.0 mm, 3 parts (1 on the bottom side), 7 nets.

Parts:
JP1: USB_C_16PIN; USB_C_Receptacle_GT-USB-7010
P1: USB_C_Plug_USB2.0; USB_C_Plug_UTC009-C12
SW1: Switch_SW_Push_NC; SW_SPST_EVQPE1

Connections:
/CC1: JP1.B5 (CC2), P1.B5 (VCONN)
/CC2: JP1.A5 (CC1), P1.A5 (CC)
/D_N: JP1.A7 (D1-), JP1.B7 (D2-), P1.A7 (D-)
/D_P: JP1.A6 (D1+), JP1.B6 (D2+), P1.A6 (D+)
/VBUS1: P1.A4 (VBUS), P1.B9 (VBUS), SW1.1
/VBUS2: JP1.A4 (VBUS), JP1.A9 (VBUS), JP1.B4 (VBUS), JP1.B9 (VBUS), SW1.2
GND: JP1.A1 (GND), JP1.A12 (GND), JP1.B1 (GND), JP1.B12 (GND), P1.A1 (GND), P1.B12 (GND), P1.S1 (SHIELD)
