TomKeddie/prj-pcb-experiments/micromod-pmod-function/micromod-pmod-function.kicad_pcb

## KiCad design micromod-pmod-function/micromod-pmod-function.kicad_pcb (2021-12-26)

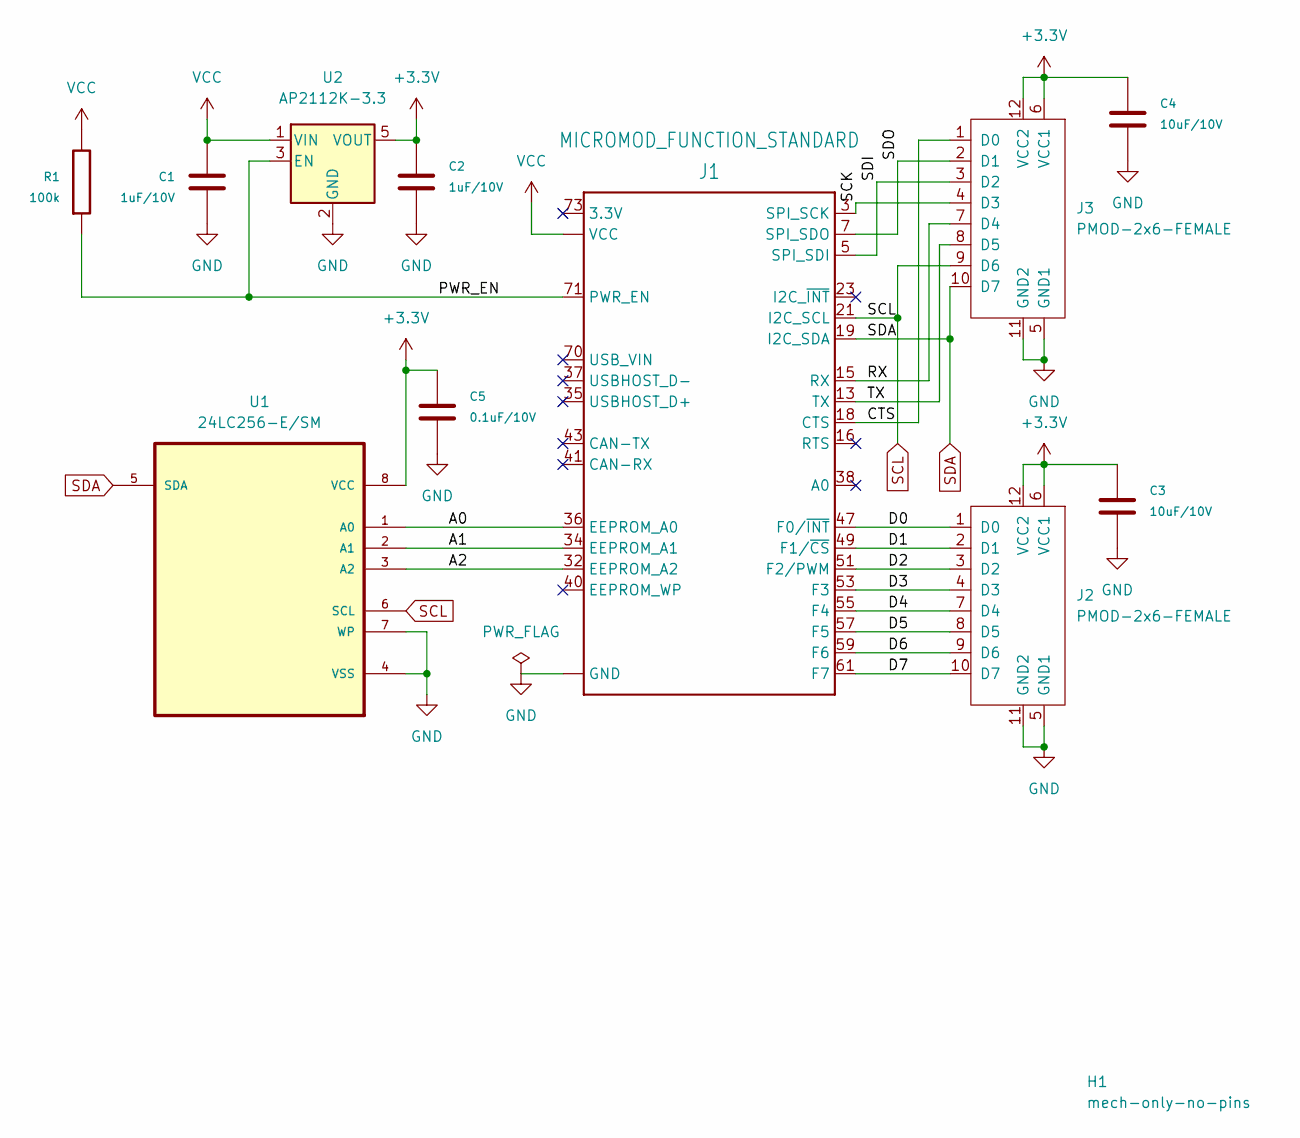
[picture p234: schematic micromod-pmod-function.kicad_sch]

Parts:
C1, C2: 1uF/10V; C_0805_2012Metric_Pad1.15x1.40mm_HandSolder; LCSC DNP
C3, C4: 10uF/10V; C_0805_2012Metric_Pad1.15x1.40mm_HandSolder; LCSC DNP
C5: 0.1uF/10V; C_0805_2012Metric_Pad1.15x1.40mm_HandSolder; LCSC DNP
H1: mech-only-no-pins; mask
J1: MICROMOD_FUNCTION_STANDARD
J2, J3: PMOD-2x6-FEMALE; PMOD_2X6_PTH_RA_SOCKET
R1: 100k; R_0805_2012Metric; LCSC DNP
U1: 24LC256-E/SM; SOIC127P600X175-8N; MPN 24LC256-E/SM
U2: AP2112K-3.3; SOT-23-5

Connections:
+3V3: C2.1, C3.1, C4.1, C5.1, J2.6 (VCC1), J2.12 (VCC2), J3.6 (VCC1), J3.12 (VCC2), U1.8 (VCC), U2.5 (VOUT)
/A0: J1.36 (EEPROM_A0), U1.1 (A0)
/A1: J1.34 (EEPROM_A1), U1.2 (A1)
/A2: J1.32 (EEPROM_A2), U1.3 (A2)
/CTS: J1.18 (CTS), J3.1 (D0)
/D0: J1.47 (F0/~INT), J2.1 (D0)
/D1: J1.49 (F1/~CS), J2.2 (D1)
/D2: J1.51 (F2/PWM), J2.3 (D2)
/D3: J1.53 (F3), J2.4 (D3)
/D4: J1.55 (F4), J2.7 (D4)
/D5: J1.57 (F5), J2.8 (D5)
/D6: J1.59 (F6), J2.9 (D6)
/D7: J1.61 (F7), J2.10 (D7)
/PWR_EN: J1.71 (PWR_EN), R1.1, U2.3 (EN)
/RX: J1.15 (RX), J3.7 (D4)
/SCK: J1.3 (SPI_SCK), J3.4 (D3)
/SDI: J1.5 (SPI_SDI), J3.3 (D2)
/SDO: J1.7 (SPI_SDO), J3.2 (D1)
/TX: J1.13 (TX), J3.8 (D5)
GND: C1.1, C2.2, C3.2, C4.2, C5.2, J1.1 (GND), J1.33 (GND), J1.39 (GND), J1.45 (GND), J1.75 (GND), J2.5 (GND1), J2.11 (GND2), J3.5 (GND1), J3.11 (GND2), U1.4 (VSS), U1.7 (WP), U2.2 (GND)
SCL: J1.21 (I2C_SCL), J3.9 (D6), U1.6 (SCL)
SDA: J1.19 (I2C_SDA), J3.10 (D7), U1.5 (SDA)
VCC: C1.2, J1.72 (VCC), J1.74 (VCC), R1.2, U2.1 (VIN)

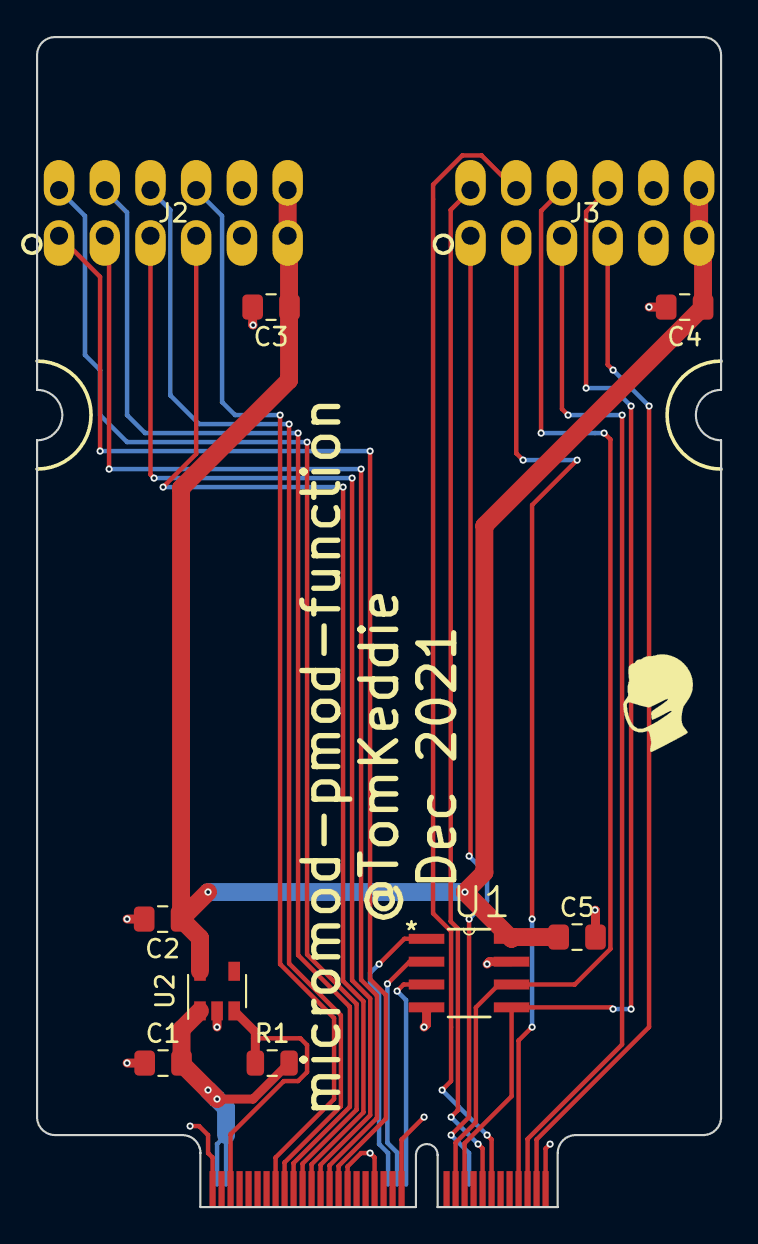
[picture p235: board micromod-pmod-function.kicad_pcb from above]

Board: 2 copper layers, 38.0 x 65.0 mm, 12 parts (0 on the bottom side), 23 nets.
