TomKeddie/prj-pcb-experiments/galep4-plcc-28/galep4-plcc-28.kicad_pcb

## KiCad design galep4-plcc-28/galep4-plcc-28.kicad_pcb (2021-03-27)

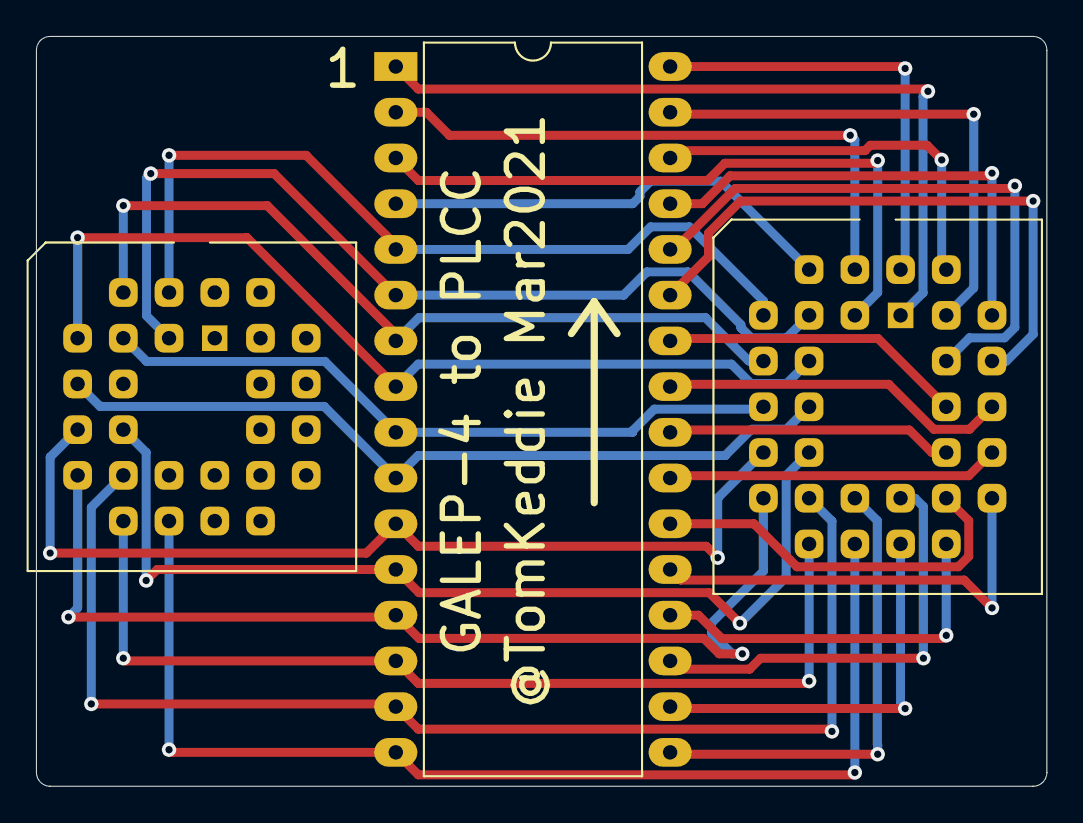
[picture p236: board galep4-plcc-28.kicad_pcb from above]

Board: 2 copper layers, 56.1 x 41.7 mm, 3 parts (0 on the bottom side), 32 nets.

Parts:
U1: GAL22V10PLCC; PLCC-28_THT-Socket
U2: 27C040; PLCC-32_THT-Socket
U3: DIP_32; DIP-32_W15.24mm_LongPads

Connections:
/1: U2.1, U3.1
/2: U2.2, U3.2
/3: U2.3, U3.3
/4: U2.4, U3.4
/10: U1.7, U2.10, U3.10
/11: U1.9, U2.11, U3.11
/12: U1.10, U2.12, U3.12
/13: U1.11, U2.13, U3.13
/14: U1.12, U2.14, U3.14
/15: U1.13, U2.15, U3.15
/16: U1.14, U2.16, U3.16
/17: U2.17, U3.17
/18: U2.18, U3.18
/19: U2.19, U3.19
/20: U2.20, U3.20
/21: U2.21, U3.21
/22: U2.22, U3.22
/23: U2.23, U3.23
/24: U2.24, U3.24
/24-1: U1.2, U2.5, U3.5
/24-2: U1.3, U2.6, U3.6
/24-3: U1.4, U2.7, U3.7
/24-4: U1.5, U2.8, U3.8
/24-5: U1.6, U2.9, U3.9
/25: U2.25, U3.25
/26: U2.26, U3.26
/27: U2.27, U3.27
/28: U2.28, U3.28
/29: U2.29, U3.29
/30: U2.30, U3.30
/31: U2.31, U3.31
/32: U2.32, U3.32
