TomKeddie/prj-pcb-experiments/glasgow-swd-trace-addon/glasgow-swd-trace-addon.kicad_pcb

## KiCad design glasgow-swd-trace-addon/glasgow-swd-trace-addon.kicad_pcb (2021-02-26)

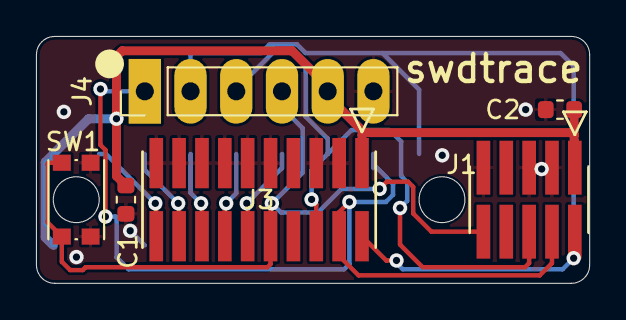
[picture p237: board glasgow-swd-trace-addon.kicad_pcb from above]

Board: 2 copper layers, 30.7 x 13.7 mm, 7 parts (1 on the bottom side), 11 nets.

Parts:
C1, C2: 10uF/16V; R_0603_1608Metric
J1: 10pin; FTSH-105-01-F-DV-K
J2: Glasgow; 91618-310ALF
J3: 20pin; FTSH-110-01-F-DV-K
J4: Conn_01x06; PinHeader_1x06_P2.54mm_Vertical
SW1: SW_SPST; SW_Push_1P1T_NO_CK_KMR2

Connections:
/SWDCLK: J1.4, J2.15, J3.4, J4.1
/SWDIO: J1.2, J2.17, J3.2, J4.2
/SWO: J1.6, J2.13, J3.6, J4.3
/TRACECLK: J2.11, J3.12
/TRACEDATA[0]: J2.9, J3.14
/TRACEDATA[1]: J2.7, J3.16
/TRACEDATA[2]: J2.5, J3.18
/TRACEDATA[3]: J2.3, J3.20
/~RESET: J1.10, J3.10, J4.4, SW1.1
GND: C1.1, C2.1, J1.3, J1.5, J1.9, J2.4, J2.6, J2.8, J2.10, J2.12, J2.14, J2.16, J2.18, J3.3, J3.5, J3.9, J3.11, J3.13, J3.15, J3.17, J3.19, J4.6, SW1.2
VCC: C1.2, C2.2, J1.1, J2.1, J2.2, J3.1, J4.5
