TomKeddie/prj-pcb-experiments/led-through-fibreglass/led-through-fibreglass.kicad_pcb

## KiCad design led-through-fibreglass/led-through-fibreglass.kicad_pcb (2021-02-26)

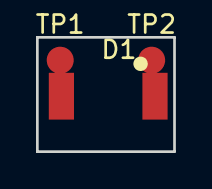
[picture p238: board led-through-fibreglass.kicad_pcb from above]

Board: 2 copper layers, 7.6 x 6.4 mm, 3 parts (0 on the bottom side), 2 nets.

Parts:
D1: LED; XZM2CYK45WT-9
TP1, TP2: TestPoint; Measurement_Point_Round-SMD-Pad_Small

Connections:
unnamed: D1.1, TP1.1
unnamed: D1.2, TP2.1
