TomKeddie/prj-pcb-experiments/edison-led-3x4-pmod/edison-led-3x4-pmod.kicad_pcb

## KiCad design edison-led-3x4-pmod/edison-led-3x4-pmod.kicad_pcb (2021-02-26)

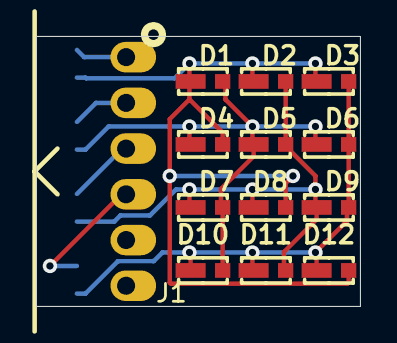
[picture p239: board edison-led-3x4-pmod.kicad_pcb from above]

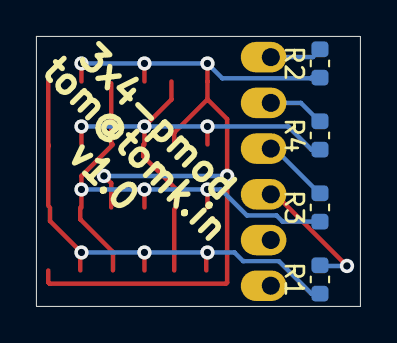
[picture p240: board edison-led-3x4-pmod.kicad_pcb from below]

Board: 2 copper layers, 18.0 x 15.0 mm, 17 parts (4 on the bottom side), 8 nets.

Parts:
D1, D2, D3, D4, D5, D6, D7, D8, D9, D10, D11, D12: LED; EDISON-3014
J1: PMOD-1x6-MALE; PMOD_1X6_PTH_RA_PLUG
R1, R2, R3, R4: 47R; R_0603_1608Metric

Connections:
D0: D1.2, D2.2, D3.2, D4.1, D8.1, D12.1, R2.1
D1: D1.1, D4.2, D5.2, D6.2, D7.1, D10.1, R4.1
D2: D2.1, D5.1, D7.2, D8.2, D9.2, D11.1, R3.1
D3: D3.1, D6.1, D9.1, D10.2, D11.2, D12.2, R1.1
unnamed: J1.1, R2.2
unnamed: J1.2, R4.2
unnamed: J1.3, R3.2
unnamed: J1.4, R1.2
