TomKeddie/prj-pcb-experiments/hc245t-bypass/hc245t-bypass.kicad_pcb

## KiCad design hc245t-bypass/hc245t-bypass.kicad_pcb (2021-02-26)

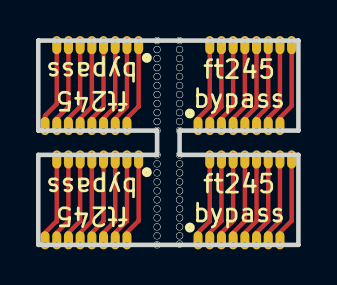
[picture p241: board hc245t-bypass.kicad_pcb from above]

Board: 2 copper layers, 14.4 x 11.3 mm, 64 parts (0 on the bottom side), 32 nets.

Parts:
TP1, TP2, TP3, TP4, TP5, TP6, TP7, TP8, TP9, TP10, TP11, TP12, TP13, TP14, TP15, TP16, TP17, TP18, TP19, TP20, TP21, TP22, TP23, TP24, TP25, TP26, TP27, TP28, TP29, TP30, TP31, TP32, TP33, TP34, TP35, TP36, TP37, TP38, TP39, TP40, TP41, TP42, TP43, TP44, TP45, TP46, TP47, TP48, TP49, TP50, TP51, TP52, TP53, TP54, TP55, TP56, TP57, TP58, TP59, TP60, TP61, TP62, TP63, TP64: TestPoint; Castellation_5.08_2.54

Connections:
/A0B0_1: TP1.1, TP9.1
/A1B1_1: TP2.1, TP10.1
/A1B1_2: TP17.1, TP25.1
/A1B1_3: TP33.1, TP41.1
/A1B1_4: TP49.1, TP57.1
/A2B2_1: TP3.1, TP11.1
/A2B2_2: TP18.1, TP26.1
/A2B2_3: TP34.1, TP42.1
/A2B2_4: TP50.1, TP58.1
/A3B3_1: TP4.1, TP12.1
/A3B3_2: TP19.1, TP27.1
/A3B3_3: TP35.1, TP43.1
/A3B3_4: TP51.1, TP59.1
/A4B4_1: TP5.1, TP13.1
/A4B4_2: TP20.1, TP28.1
/A4B4_3: TP36.1, TP44.1
/A4B4_4: TP52.1, TP60.1
/A5B5_1: TP6.1, TP14.1
/A5B5_2: TP21.1, TP29.1
/A5B5_3: TP37.1, TP45.1
/A5B5_4: TP53.1, TP61.1
/A6B6_1: TP7.1, TP15.1
/A6B6_2: TP22.1, TP30.1
/A6B6_3: TP38.1, TP46.1
/A6B6_4: TP54.1, TP62.1
/A7B7_1: TP8.1, TP16.1
/A7B7_2: TP23.1, TP31.1
/A7B7_3: TP39.1, TP47.1
/A7B7_4: TP55.1, TP63.1
/A8B8_2: TP24.1, TP32.1
/A8B8_3: TP40.1, TP48.1
/A8B8_4: TP56.1, TP64.1
