TomKeddie/prj-pcb-experiments/east-van/arrow/east-van-arrow.kicad_pcb

## KiCad design east-van/arrow/east-van-arrow.kicad_pcb (2021-02-26)

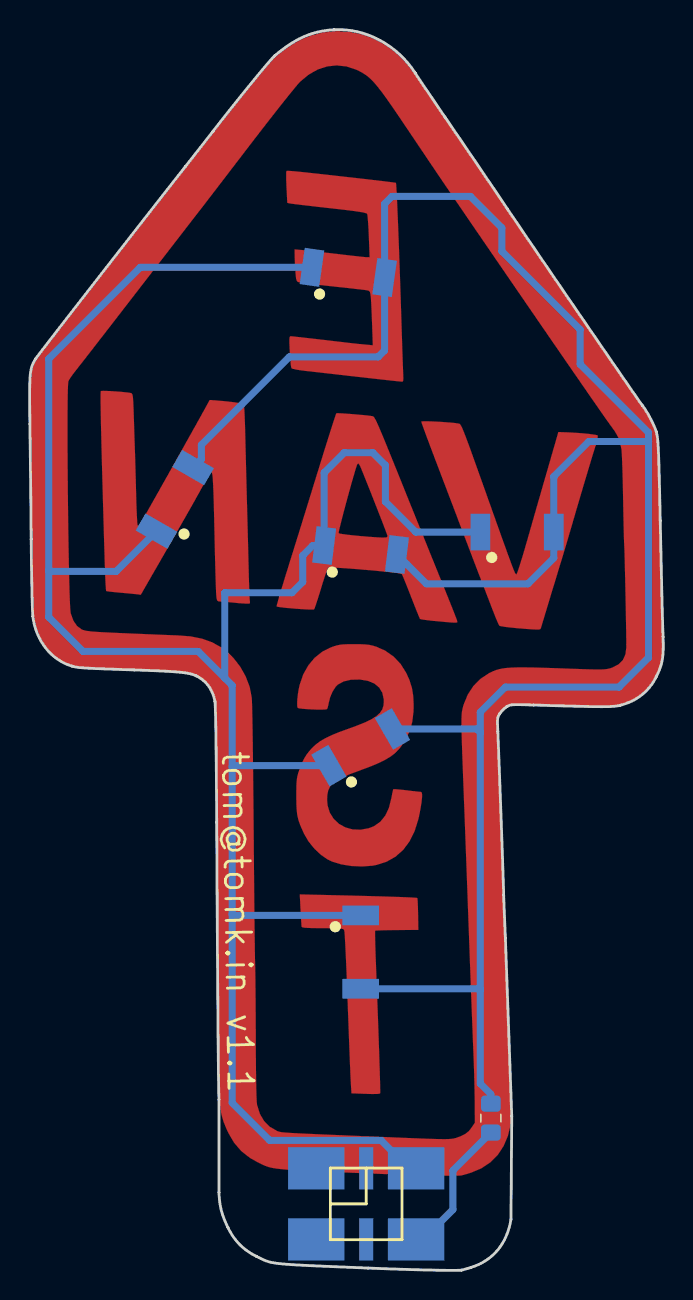
[picture p242: board east-van-arrow.kicad_pcb from below]

Board: 2 copper layers, 44.9 x 88.0 mm, 10 parts (8 on the bottom side), 3 nets.

Parts:
D1, D2, D3, D4, D5, D6: LED; XZM2CYK45WT-9-NOMASK
H1: Copper; east-van-arrow-copper
H2: Mask; east-van-arrow-mask-invert
J1: Conn_02x03_Odd_Even; PinSocket_2x03_P2.54mm_Vertical_SMD_SAO
R1: 220R; C_0805_2012Metric_Pad1.15x1.40mm_HandSolder

Connections:
+3V3: D1.2, D2.2, D3.2, D4.2, D5.2, D6.2, J1.5
/CATHODE: D1.1, D2.1, D3.1, D4.1, D5.1, D6.1, R1.1
GND: J1.6, R1.2
