TomKeddie/prj-pcb-experiments/east-van/pendant/east-van.kicad_pcb

## KiCad design east-van/pendant/east-van.kicad_pcb (2021-02-26)

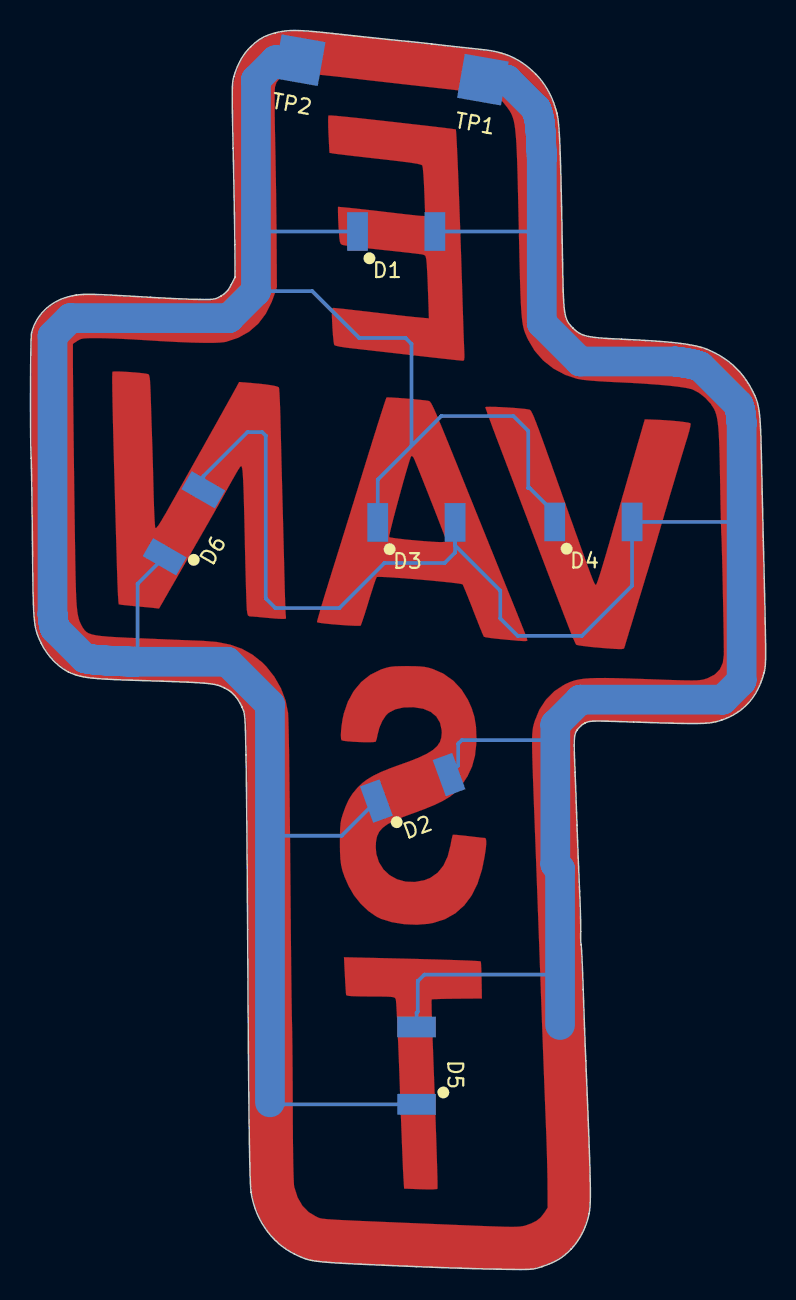
[picture p243: board east-van.kicad_pcb from below]

Board: 2 copper layers, 49.4 x 83.3 mm, 11 parts (8 on the bottom side), 2 nets.

Parts:
D1, D2, D3, D4, D5, D6: Device_LED; XZM2CYK45WT-9-NOMASK
H1: mask; east-van-inv-mask
H2: silk; east-van-silk
H3: copper; east-van-copper
TP1, TP2: TestPoint; Measurement_Point_Square-SMD-Pad_Big

Connections:
/A: D1.2, D2.2, D3.2, D4.2, D5.2, D6.2, TP2.1
/C: D1.1, D2.1, D3.1, D4.1, D5.1, D6.1, TP1.1
