TomKeddie/prj-pcb-experiments/hub-75-pmod/hub-75-pmod.kicad_pcb

## KiCad design hub-75-pmod/hub-75-pmod.kicad_pcb (2021-02-26)

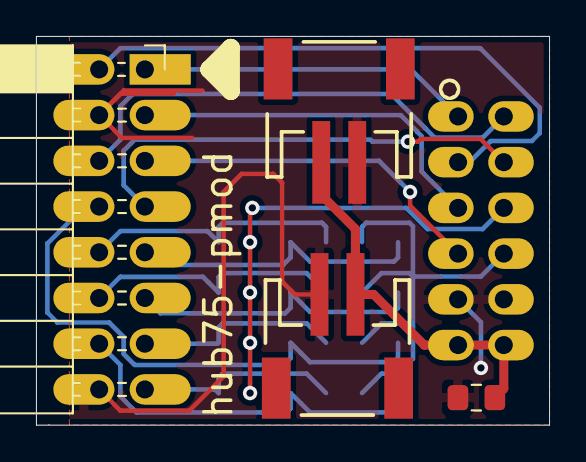
[picture p244: board hub-75-pmod.kicad_pcb from above]

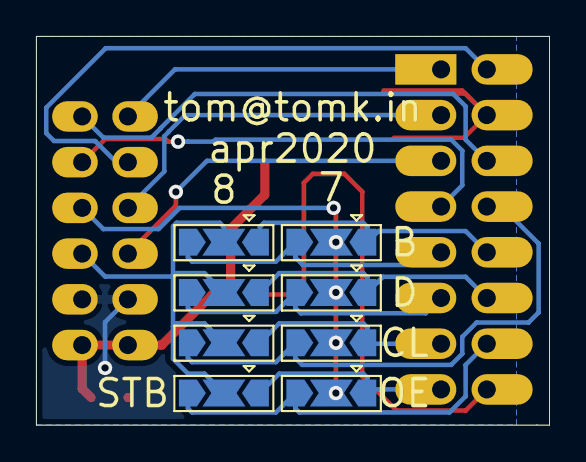
[picture p245: board hub-75-pmod.kicad_pcb from below]

Board: 2 copper layers, 28.5 x 21.6 mm, 13 parts (8 on the bottom side), 18 nets.

Parts:
C1: 10uF; C_0805_2012Metric_Pad1.15x1.40mm_HandSolder
J1, J4: Conn_01x02; JST-2-SMD
J2: Conn_02x08_Odd_Even; PinSocket_2x08_P2.54mm_Horizontal
J3: PMOD-2x6-FEMALE; PMOD_2X6_PTH_RA_SOCKET
JP1, JP2, JP3, JP4, JP5, JP6, JP7, JP8: JUMPER3; SolderJumper-3_P2.0mm_Open_TrianglePad1.0x1.5mm

Connections:
+3V3: C1.1, J1.1, J3.6, J3.12, J4.1
/PMOD7: J3.9, JP1.2, JP2.2, JP3.2, JP4.2
/PMOD8: J3.10, JP5.2, JP6.2, JP7.2, JP8.2
A: J2.9, JP1.3, JP5.3
B: J2.10, JP1.1, JP5.1
B0: J2.3, J3.3
B1: J2.7, J3.8
C: J2.11, JP2.3, JP6.3
CLK: J2.13, JP3.1, JP7.1
D: J2.12, JP2.1, JP6.1
E: J2.8, JP3.3, JP7.3
G0: J2.2, J3.2
G1: J2.6, J3.7
GND: C1.2, J1.2, J2.4, J2.16, J3.5, J3.11, J4.2
OE: J2.15, JP4.1, JP8.1
R0: J2.1, J3.1
R1: J2.5, J3.4
STB: J2.14, JP4.3, JP8.3
