TomKeddie/prj-pcb-experiments/2024-clock-retrofit/kicad/2024-clock-retrofit-leds.kicad_sch

## KiCad design 2024-clock-retrofit/kicad/2024-clock-retrofit-leds.kicad_sch (2025-05-09)

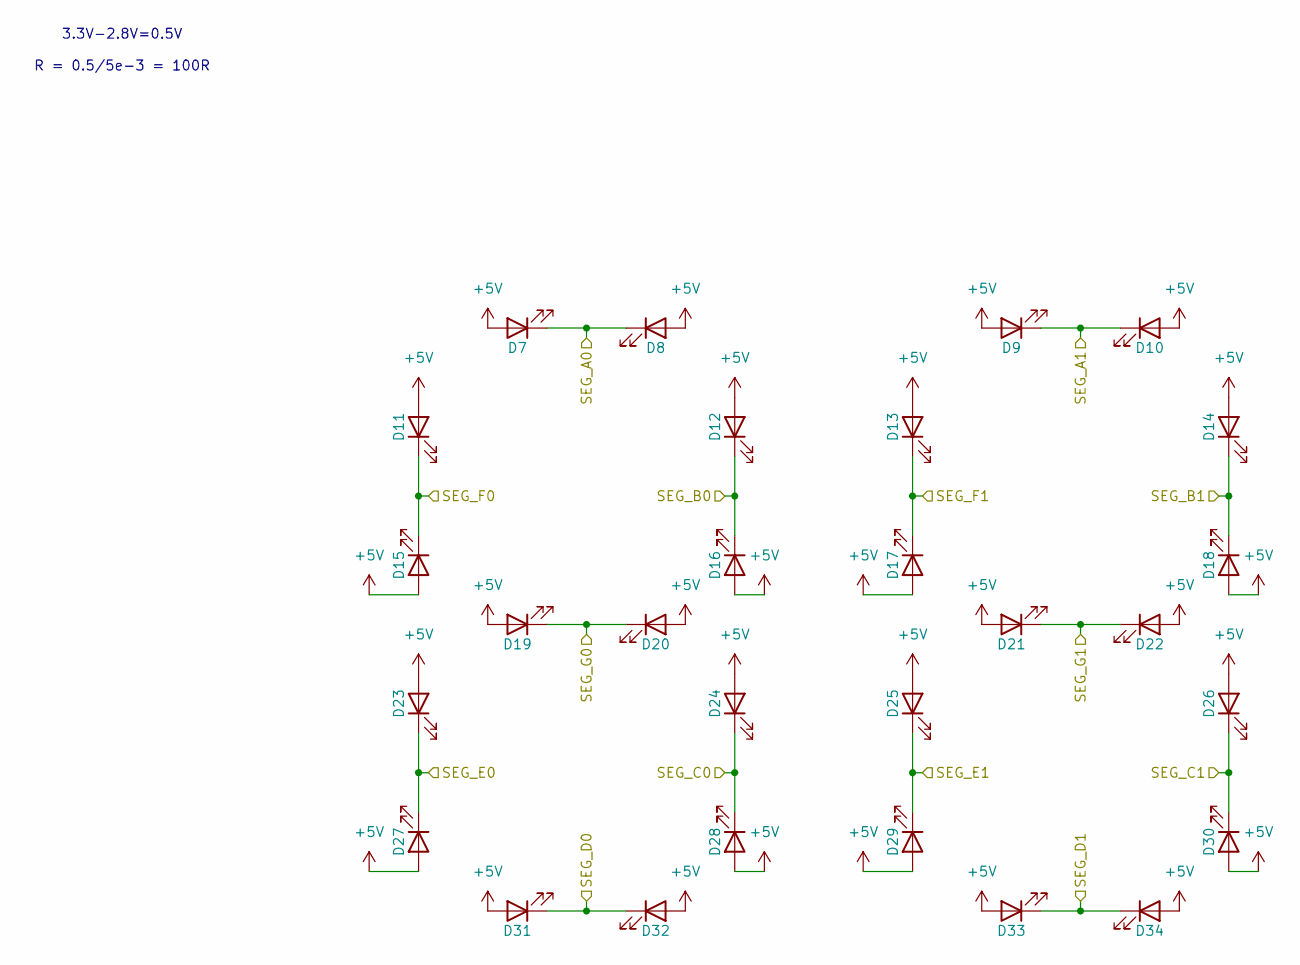
[picture p246: schematic 2024-clock-retrofit-leds.kicad_sch]

Parts:
D7, D8, D9, D10, D11, D12, D13, D14, D15, D16, D17, D18, D19, D20, D21, D22, D23, D24, D25, D26, D27, D28, D29, D30, D31, D32, D33, D34: LED; LED_0603_1608Metric; LCSC C2290

Connections:
+5V: D7.2 (A), D8.2 (A), D9.2 (A), D10.2 (A), D11.2 (A), D12.2 (A), D13.2 (A), D14.2 (A), D15.2 (A), D16.2 (A), D17.2 (A), D18.2 (A), D19.2 (A), D20.2 (A), D21.2 (A), D22.2 (A), D23.2 (A), D24.2 (A), D25.2 (A), D26.2 (A), D27.2 (A), D28.2 (A), D29.2 (A), D30.2 (A), D31.2 (A), D32.2 (A), D33.2 (A), D34.2 (A)
SEG_A0: D7.1 (K), D8.1 (K)
SEG_A1: D9.1 (K), D10.1 (K)
SEG_B0: D12.1 (K), D16.1 (K)
SEG_B1: D14.1 (K), D18.1 (K)
SEG_C0: D24.1 (K), D28.1 (K)
SEG_C1: D26.1 (K), D30.1 (K)
SEG_D0: D31.1 (K), D32.1 (K)
SEG_D1: D33.1 (K), D34.1 (K)
SEG_E0: D23.1 (K), D27.1 (K)
SEG_E1: D25.1 (K), D29.1 (K)
SEG_F0: D11.1 (K), D15.1 (K)
SEG_F1: D13.1 (K), D17.1 (K)
SEG_G0: D19.1 (K), D20.1 (K)
SEG_G1: D21.1 (K), D22.1 (K)

Notes on the sheet:
3.3V-2.8V=0.5V R = 0.5/5e-3 = 100R
