TomKeddie/prj-pcb-experiments/2024-clock-retrofit/kicad/2024-clock-retrofit.kicad_sch

## KiCad design 2024-clock-retrofit/kicad/2024-clock-retrofit.kicad_sch (2026-09-26)

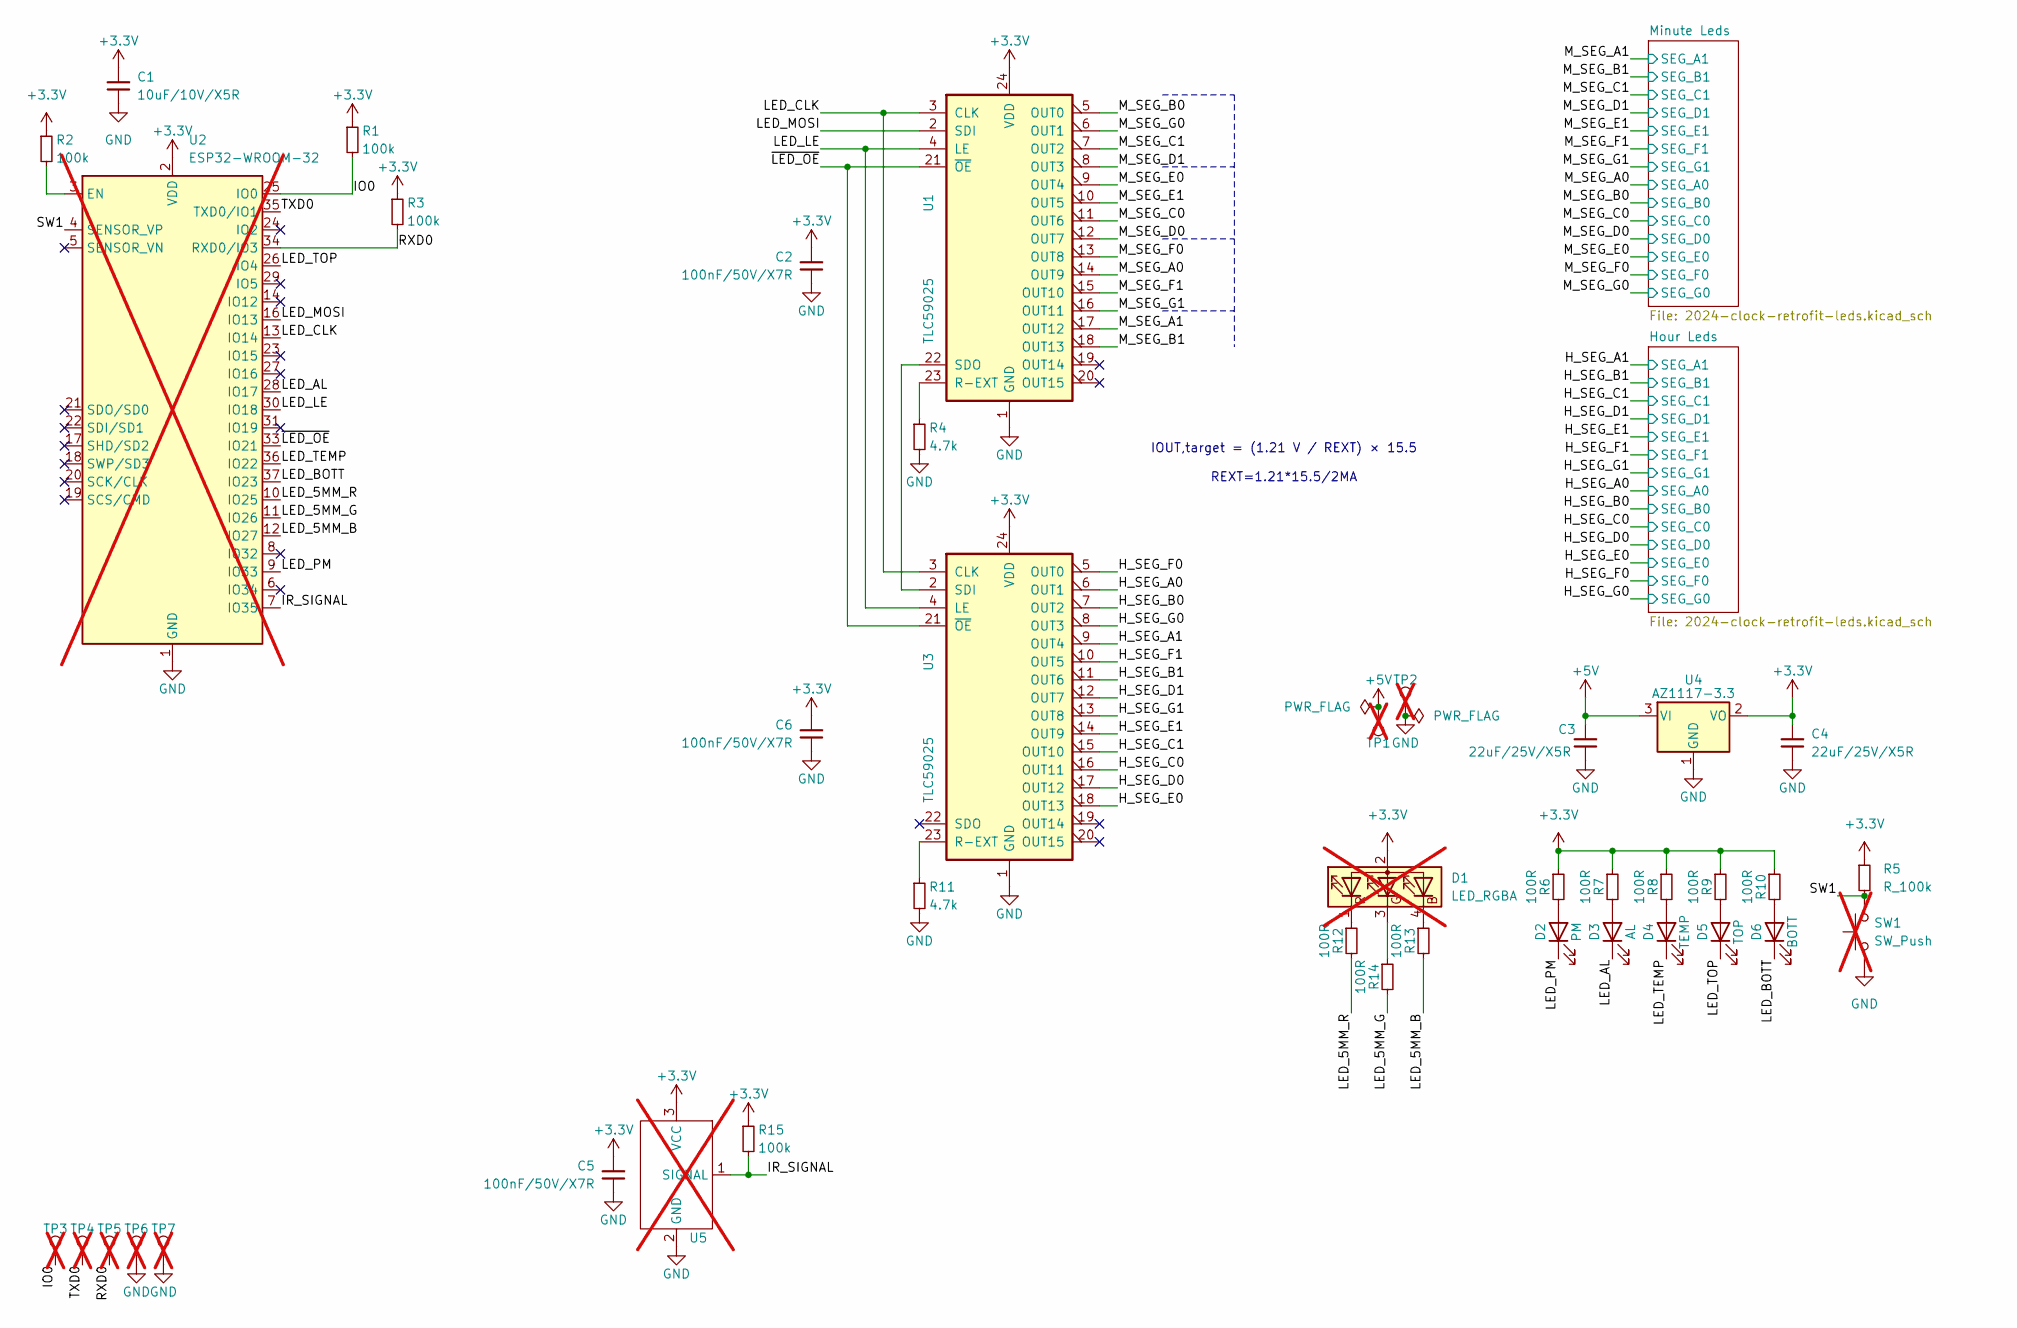
[picture p247: schematic 2024-clock-retrofit.kicad_sch]

Parts:
C1: 10uF/10V/X5R; C_0603_1608Metric; MFGPN CL10A106KP8NNNC; LCSC C19702
C2, C5, C6: 100nF/50V/X7R; C_0603_1608Metric; MFGPN CC0603KRX7R9BB104; LCSC C14663
C3, C4: 22uF/25V/X5R; C_1206_3216Metric; MFGPN CL10A106MA8NRNC; LCSC C12891
D1: LED_RGBA; LED_D5.0mm-4_RGB; not fitted
D2: PM; LED_0603_1608Metric; LCSC C2290
D3: AL; LED_0603_1608Metric; LCSC C2290
D4: TEMP; LED_0603_1608Metric; LCSC C2290
D5: TOP; LED_0603_1608Metric; LCSC C2290
D6: BOTT; LED_0603_1608Metric; LCSC C2290
R1, R2, R3, R15: 100k; R_0402_1005Metric; LCSC C25741
R4, R11: 4.7k; R_0805_2012Metric; LCSC C17673
R5: R_100k; R_0402_1005Metric; LCSC C25741
R6, R7, R8, R9, R10, R12, R13, R14: 100R; R_0402_1005Metric; LCSC C25076
SW1: SW_Push; SW_Tactile_SPST_Angled_PTS645Vx83-2LFS; not fitted
TP1, TP2, TP3, TP4, TP5, TP6, TP7: TestPoint; TestPoint_Pad_D2.0mm; not fitted
U1, U3: TLC59025; SSOP-24_3.9x8.7mm_P0.635mm
U2: ESP32-WROOM-32; ESP32-WROOM-32D; LCSC C473012; not fitted
U4: AZ1117-3.3; SOT-223-3_TabPin2; LCSC C6186
U5: IR_RECEIVER; not fitted

Connections:
+3.3V: C1.1, C2.1, C4.1, C5.1, C6.1, D1.2 (A), R1.1, R2.1, R3.1, R5.1, R6.1, R7.1, R8.1, R9.1, R10.1, R15.1, U1.24 (VDD), U2.2 (VDD), U3.24 (VDD), U4.2 (VO), U5.3 (VCC)
+5V: C3.1, TP1.1, U4.3 (VI)
GND: C1.2, C2.2, C3.2, C4.2, C5.2, C6.2, R4.2, R11.2, SW1.1, TP2.1, TP6.1, TP7.1, U1.1 (GND), U2.1 (GND), U2.15 (GND), U2.38 (GND), U2.39 (GND), U3.1 (GND), U4.1 (GND), U5.2 (GND)
H_SEG_A0: U3.6 (OUT1)
H_SEG_A1: U3.9 (OUT4)
H_SEG_B0: U3.7 (OUT2)
H_SEG_B1: U3.11 (OUT6)
H_SEG_C0: U3.16 (OUT11)
H_SEG_C1: U3.15 (OUT10)
H_SEG_D0: U3.17 (OUT12)
H_SEG_D1: U3.12 (OUT7)
H_SEG_E0: U3.18 (OUT13)
H_SEG_E1: U3.14 (OUT9)
H_SEG_F0: U3.5 (OUT0)
H_SEG_F1: U3.10 (OUT5)
H_SEG_G0: U3.8 (OUT3)
H_SEG_G1: U3.13 (OUT8)
IO0: R1.2, TP3.1, U2.25 (IO0)
IR_SIGNAL: R15.2, U2.7 (IO35), U5.1 (SIGNAL)
LED_5MM_B: R13.2, U2.12 (IO27)
LED_5MM_G: R14.2, U2.11 (IO26)
LED_5MM_R: R12.2, U2.10 (IO25)
LED_AL: D3.1 (K), U2.28 (IO17)
LED_BOTT: D6.1 (K), U2.37 (IO23)
LED_CLK: U1.3 (CLK), U2.13 (IO14), U3.3 (CLK)
LED_LE: U1.4 (LE), U2.30 (IO18), U3.4 (LE)
LED_MOSI: U1.2 (SDI), U2.16 (IO13)
LED_PM: D2.1 (K), U2.9 (IO33)
LED_TEMP: D4.1 (K), U2.36 (IO22)
LED_TOP: D5.1 (K), U2.26 (IO4)
M_SEG_A0: U1.14 (OUT9)
M_SEG_A1: U1.17 (OUT12)
M_SEG_B0: U1.5 (OUT0)
M_SEG_B1: U1.18 (OUT13)
M_SEG_C0: U1.11 (OUT6)
M_SEG_C1: U1.7 (OUT2)
M_SEG_D0: U1.12 (OUT7)
M_SEG_D1: U1.8 (OUT3)
M_SEG_E0: U1.9 (OUT4)
M_SEG_E1: U1.10 (OUT5)
M_SEG_F0: U1.13 (OUT8)
M_SEG_F1: U1.15 (OUT10)
M_SEG_G0: U1.6 (OUT1)
M_SEG_G1: U1.16 (OUT11)
unnamed: D1.1 (RK), R12.1
unnamed: D1.3 (GK), R14.1
unnamed: D1.4 (BK), R13.1
unnamed: D2.2 (A), R6.2
unnamed: D3.2 (A), R7.2
unnamed: D4.2 (A), R8.2
unnamed: D5.2 (A), R9.2
unnamed: D6.2 (A), R10.2
unnamed: R2.2, U2.3 (EN)
unnamed: R4.1, U1.23 (R-EXT)
unnamed: R11.1, U3.23 (R-EXT)
unnamed: U1.22 (SDO), U3.2 (SDI)
RXD0: R3.2, TP5.1, U2.34 (RXD0/IO3)
SW1: R5.2, SW1.2, U2.4 (SENSOR_VP)
TXD0: TP4.1, U2.35 (TXD0/IO1)
~LED_OE: U1.21 (~OE), U2.33 (IO21), U3.21 (~OE)

Notes on the sheet:
IOUT,target = (1.21 V / REXT) × 15.5 REXT=1.21*15.5/2MA
