TomKeddie/prj-pcb-experiments/2024-led-ctrl-24v/kicad/led-ctrl-24v.kicad_sch

## KiCad design 2024-led-ctrl-24v/kicad/led-ctrl-24v.kicad_sch (2025-05-09)

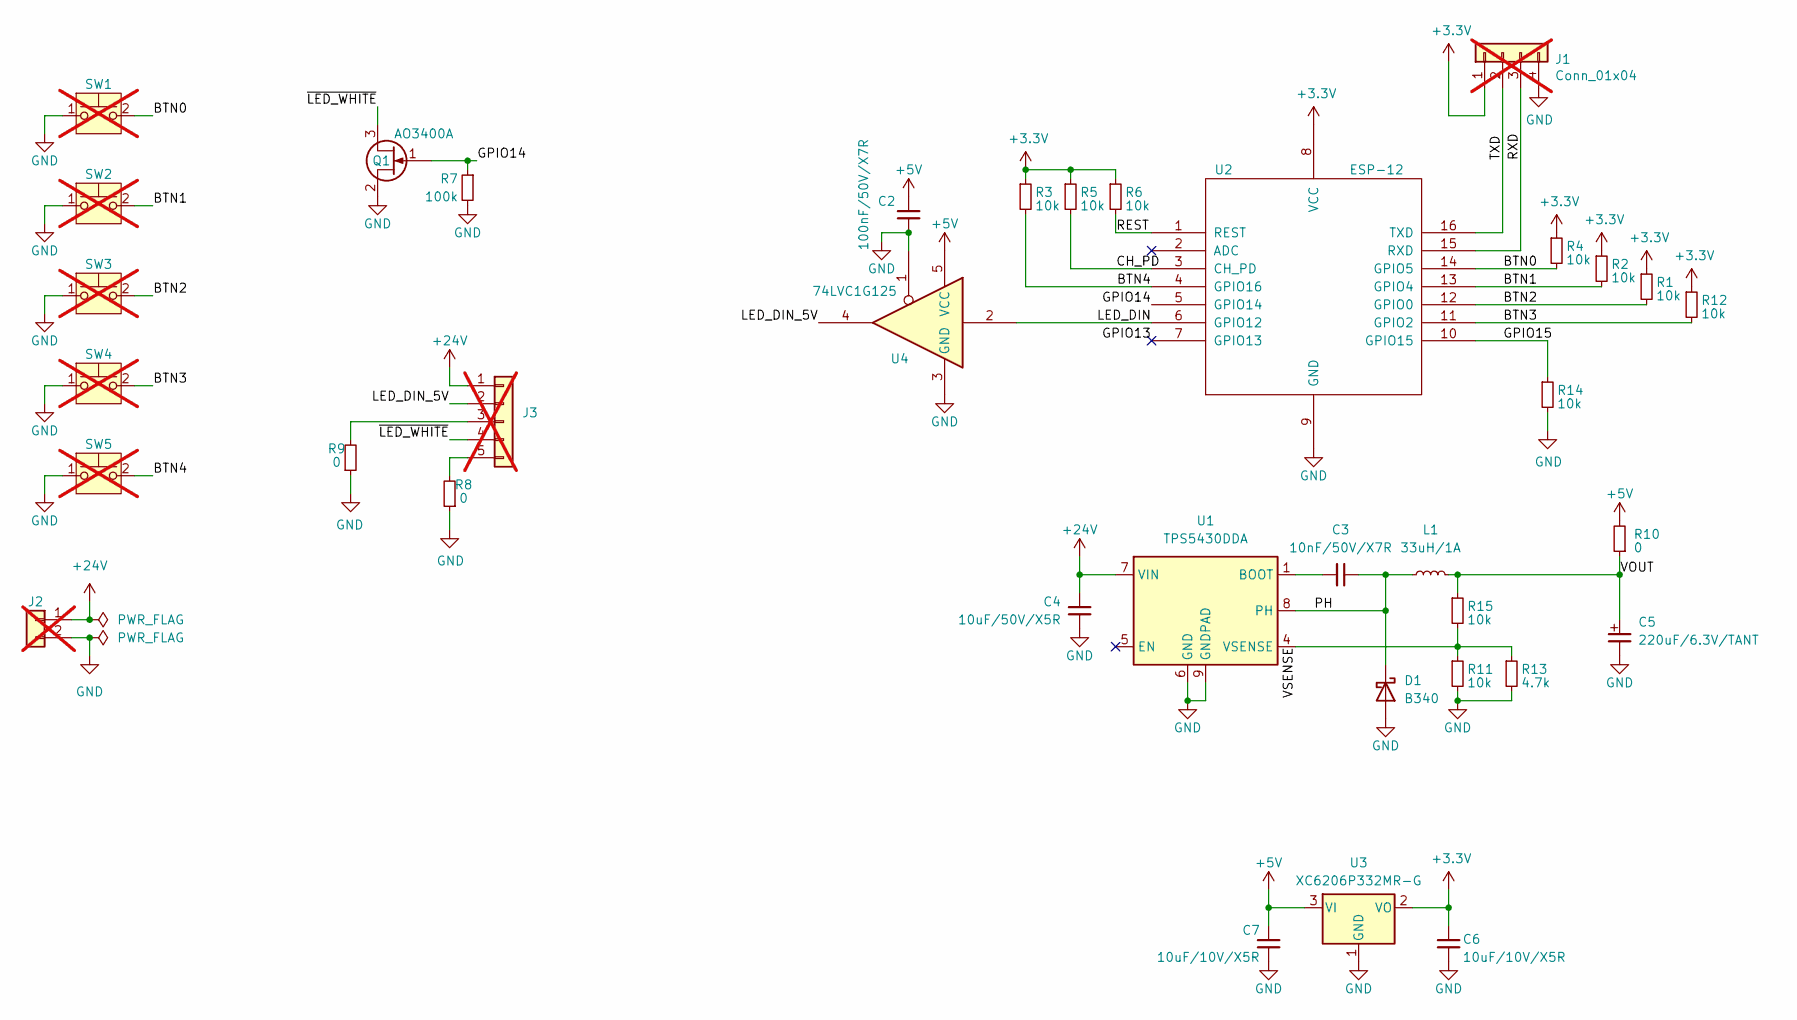
[picture p248: schematic led-ctrl-24v.kicad_sch]

Parts:
C2: 100nF/50V/X7R; C_0603_1608Metric; MFGPN CC0603KRX7R9BB104; LCSC C14663
C3: 10nF/50V/X7R; C_0402_1005Metric; LCSC C15195
C4: 10uF/50V/X5R; C_1206_3216Metric; LCSC C13585
C5: 220uF/6.3V/TANT; CP_EIA-3528-12_Kemet-T; LCSC C696794
C6, C7: 10uF/10V/X5R; C_0603_1608Metric; MFGPN CL10A106KP8NNNC; LCSC C19702
D1: B340; D_SMA; LCSC C64982
J1: Conn_01x04; PinHeader_1x04_P2.54mm_Vertical; not fitted
J2: Conn_01x02; connector_1x02_pads; not fitted
J3: Conn_01x05; connector_1x05_pads; not fitted
L1: 33uH/1A; CYA630; LCSC C5189961
Q1: AO3400A; SOT-23; LCSC C20917
R1, R2, R3, R4, R5, R6, R12, R14: 10k; R_0603_1608Metric; MFGPN 0603WAF1002T5E; LCSC C25804
R7: 100k; R_0603_1608Metric; LCSC C21190
R8, R9, R10: 0; R_0603_1608Metric; MFGPN 0603WAF0000T5E; LCSC C21189
R11, R15: 10k; R_0402_1005Metric; LCSC C25744
R13: 4.7k; R_0402_1005Metric; LCSC C25900
SW1, SW2, SW3, SW4, SW5: SW_Push_Dual; SW_Push_1P1T_NO_CK_KSC6xxJ; not fitted
U1: TPS5430DDA; TI_SO-PowerPAD-8_ThermalVias
U2: ESP-12; ESP-12E_SMD; LCSC C82891
U3: XC6206P332MR-G; SOT-23; LCSC C5446
U4: 74LVC1G125; SOT-23-5; LCSC C23654

Connections:
+3.3V: C6.1, J1.1, R1.1, R2.1, R3.1, R4.1, R5.1, R6.1, R12.1, U2.8 (VCC), U3.2 (VO)
+5V: C2.1, C7.1, R10.2, U3.3 (VI), U4.5 (VCC)
+24V: C4.1, J2.1, J3.1, U1.7 (VIN)
BTN0: R4.2, SW1.2, U2.14 (GPIO5)
BTN1: R2.2, SW2.2, U2.13 (GPIO4)
BTN2: R1.2, SW3.2, U2.12 (GPIO0)
BTN3: R12.2, SW4.2, U2.11 (GPIO2)
BTN4: R3.2, SW5.2, U2.4 (GPIO16)
CH_PD: R5.2, U2.3 (CH_PD)
GND: C2.2, C4.2, C5.2, C6.2, C7.2, D1.2 (A), J1.4, J2.2, Q1.2 (S), R7.2, R8.1, R9.1, R11.2, R13.2, R14.2, SW1.1, SW2.1, SW3.1, SW4.1, SW5.1, U1.6 (GND), U1.9 (GNDPAD), U2.9 (GND), U3.1 (GND), U4.1, U4.3 (GND)
GPIO13: U2.7 (GPIO13)
GPIO14: Q1.1 (G), R7.1, U2.5 (GPIO14)
GPIO15: R14.1, U2.10 (GPIO15)
LED_DIN: U2.6 (GPIO12), U4.2
LED_DIN_5V: J3.2, U4.4
unnamed: C3.1, U1.1 (BOOT)
unnamed: J3.3, R9.2
unnamed: J3.5, R8.2
PH: C3.2, D1.1 (K), L1.1, U1.8 (PH)
REST: R6.2, U2.1 (REST)
RXD: J1.3, U2.15 (RXD)
TXD: J1.2, U2.16 (TXD)
VOUT: C5.1, L1.2, R10.1, R15.1
VSENSE: R11.1, R13.1, R15.2, U1.4 (VSENSE)
~LED_WHITE: J3.4, Q1.3 (D)
