TomKeddie/prj-pcb-experiments/blue-pill-bmp/hardware/blue-pill-bmp.sch

## KiCad design blue-pill-bmp/hardware/blue-pill-bmp.sch (2021-02-26)

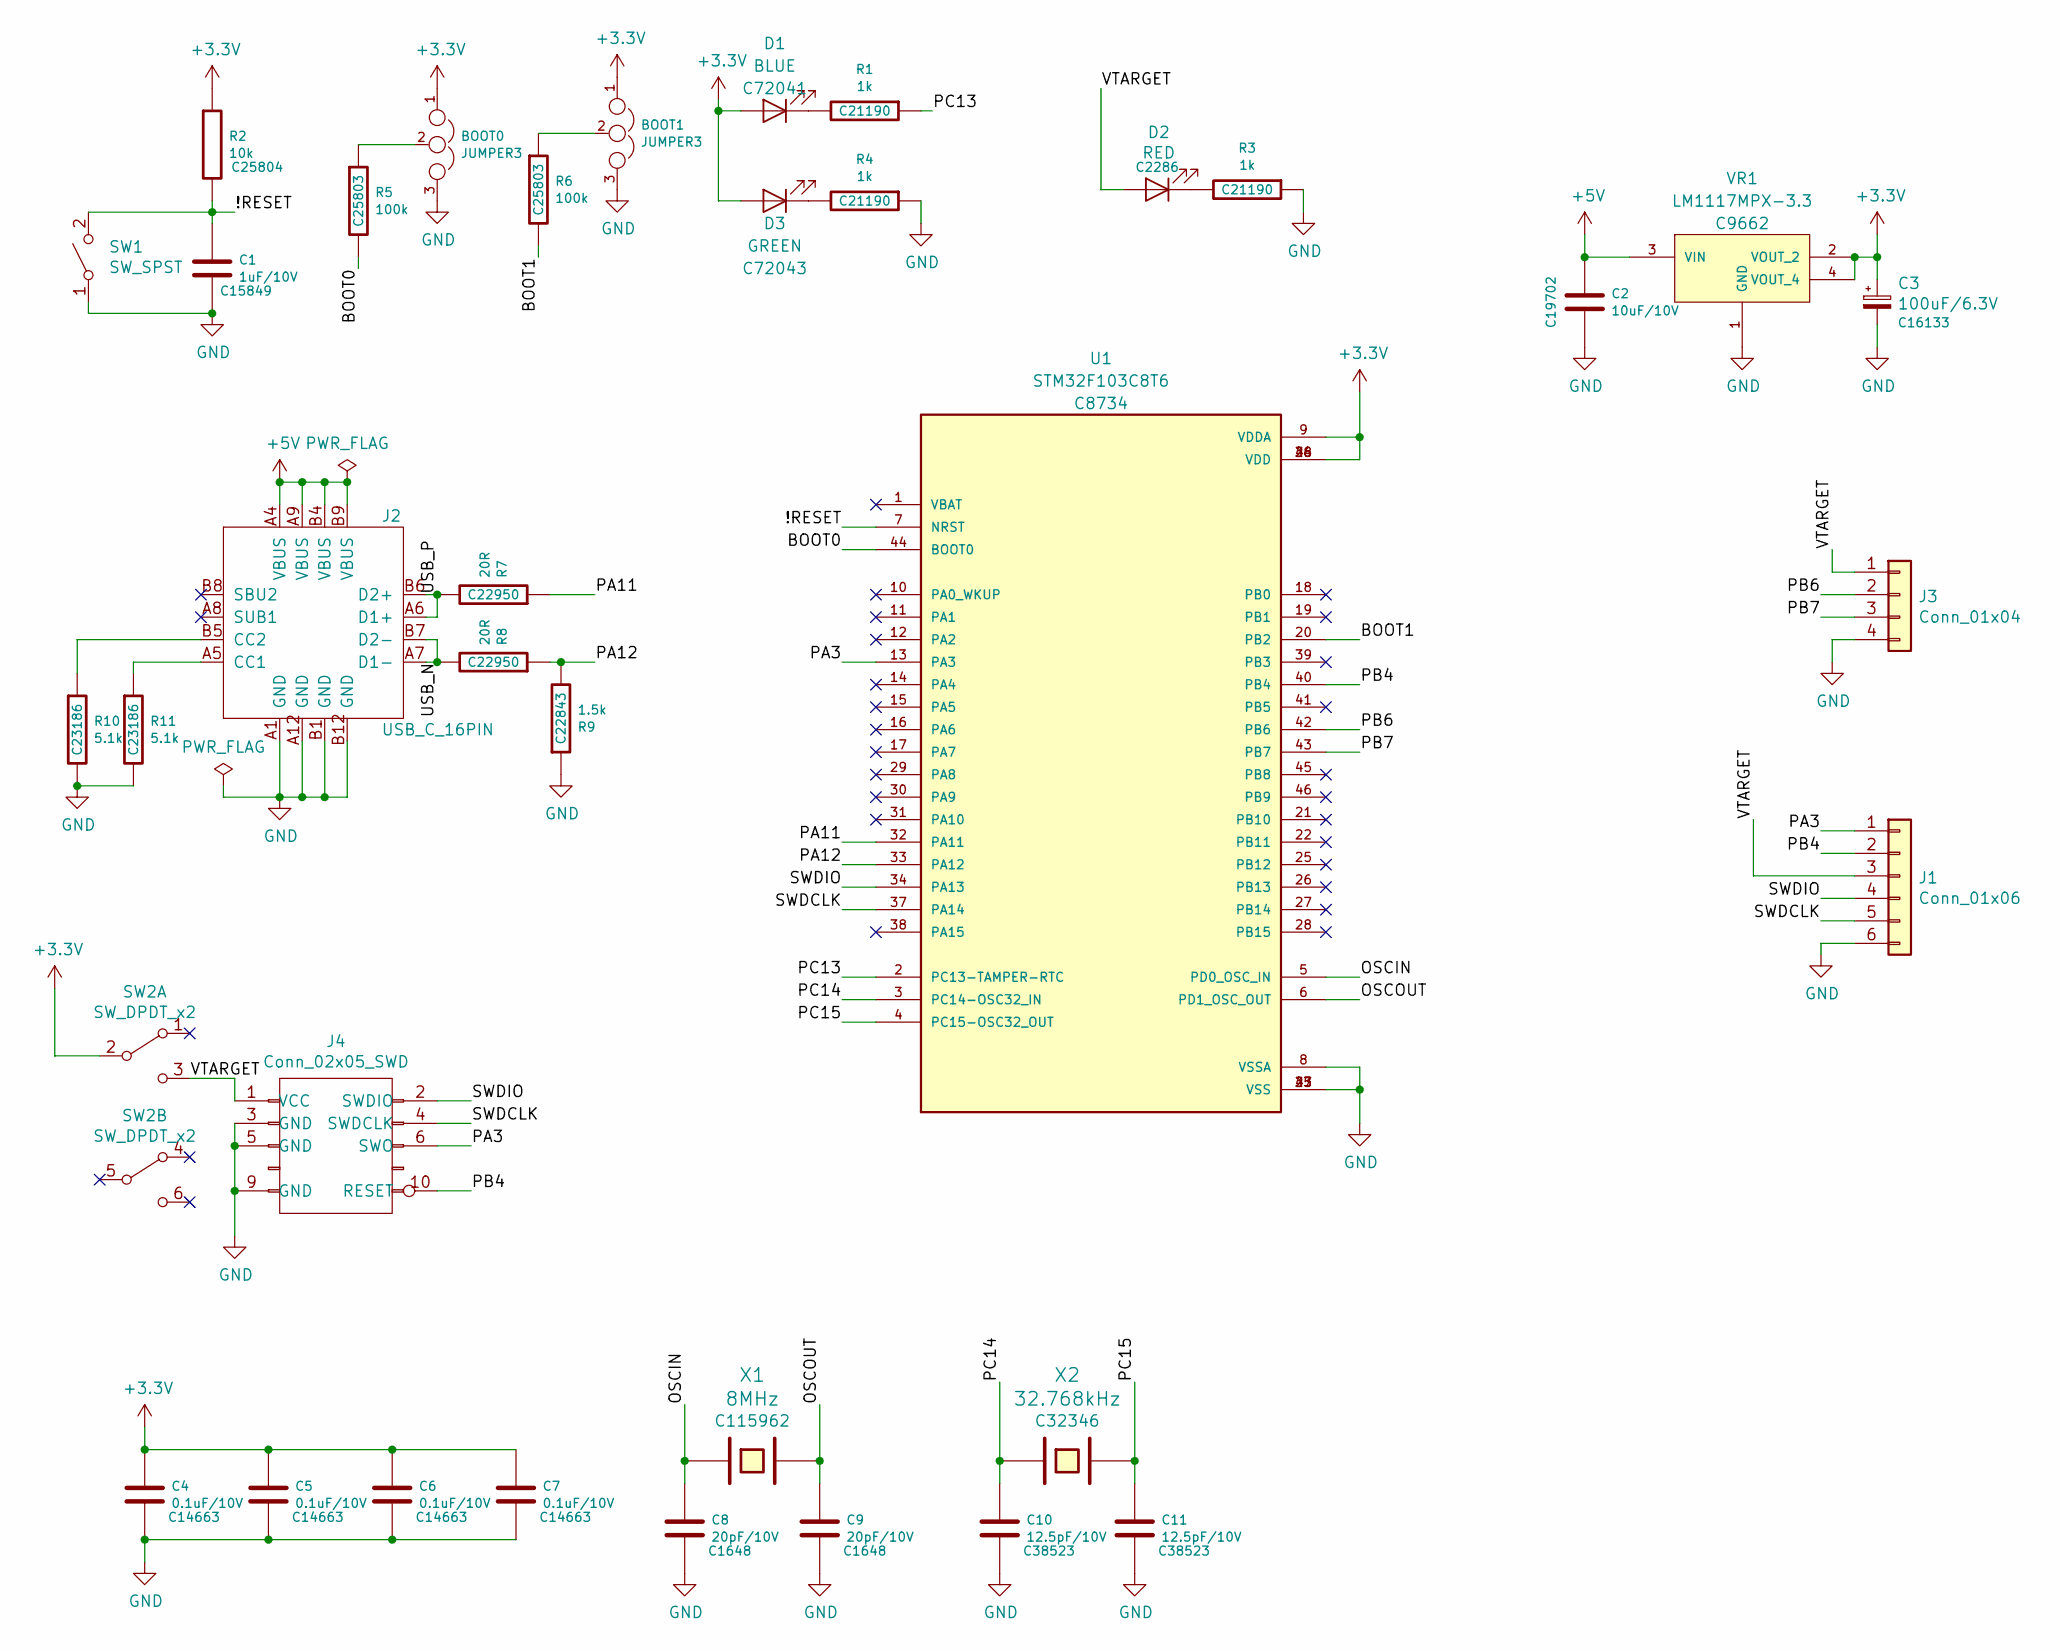
[picture p249: schematic blue-pill-bmp.sch]

Parts:
BOOT0, BOOT1: JUMPER3; SolderJumper-3_P2.0mm_Open_TrianglePad1.0x1.5mm; LCSC DNP
C1: 1uF/10V; C_0603_1608Metric; LCSC C15849
C2: 10uF/10V; C_0603_1608Metric; LCSC C19702
C3: 100uF/6.3V; CP_EIA-3528-15_AVX-H; LCSC C16133
C4, C5, C6, C7: 0.1uF/10V; C_0603_1608Metric; LCSC C14663
C8, C9: 20pF/10V; C_0603_1608Metric; LCSC C1648
C10, C11: 12.5pF/10V; C_0603_1608Metric; LCSC C38523
D1: BLUE; LED_0603_1608Metric; LCSC C72041
D2: RED; LED_0603_1608Metric; LCSC C2286
D3: GREEN; LED_0603_1608Metric; LCSC C72043
J1: Conn_01x06; PinHeader_1x06_P2.54mm_Vertical
J2: USB_C_16PIN; USB_C_Receptacle_GT-USB-7010; LCSC DNP
J3: Conn_01x04; PinHeader_1x04_P2.54mm_Vertical; LCSC DNP
J4: Conn_02x05_SWD; PinHeader_2x05_P1.27mm_Vertical; LCSC DNP
R1, R3, R4: 1k; R_0603_1608Metric; LCSC C21190
R2: 10k; R_0603_1608Metric; LCSC C25804
R5, R6: 100k; R_0603_1608Metric; LCSC C25803
R7, R8: 20R; R_0603_1608Metric; LCSC C22950
R9: 1.5k; R_0603_1608Metric; LCSC C22843
R10, R11: 5.1k; R_0603_1608Metric; LCSC C23186
SW1: SW_SPST; SW_Push_1P1T_NO_CK_KMR2; LCSC DNP
SW2: SW_DPDT_x2; SW_DPDT_SMD; LCSC DNP
U1: STM32F103C8T6; QFP50P900X900X160-48N; PARTREV 10; LCSC C8734
VR1: LM1117MPX-3.3; VREG_LM1117MPX-3.3; PARTREV O; LCSC C9662
X1: 8MHz; Crystal_SMD_5032-2Pin_5.0x3.2mm; LCSC C115962
X2: 32.768kHz; Crystal_SMD_5032-2Pin_5.0x3.2mm; LCSC C32346

Connections:
!RESET: C1.1, R2.2, SW1.2 (B), U1.7 (NRST)
+3.3V: BOOT0.1, BOOT1.1, C3.1, C4.1, C5.1, C6.1, C7.1, D1.2 (A), D3.2 (A), R2.1, SW2.2 (B), U1.9 (VDDA), U1.24 (VDD), U1.36 (VDD), U1.48 (VDD), VR1.2 (VOUT_2), VR1.4 (VOUT_4)
+5V: C2.1, J2.A4 (VBUS), J2.A9 (VBUS), J2.B4 (VBUS), J2.B9 (VBUS), VR1.3 (VIN)
BOOT0: R5.2, U1.44 (BOOT0)
BOOT1: R6.2, U1.20 (PB2)
GND: BOOT0.3, BOOT1.3, C1.2, C2.2, C3.2, C4.2, C5.2, C6.2, C7.2, C8.2, C9.2, C10.2, C11.2, J1.6, J2.A1 (GND), J2.A12 (GND), J2.B1 (GND), J2.B12 (GND), J3.4, J4.3 (GND), J4.5 (GND), J4.9 (GND), R3.1, R4.1, R9.1, R10.2, R11.2, SW1.1 (A), U1.8 (VSSA), U1.23 (VSS), U1.35 (VSS), U1.47 (VSS), VR1.1 (GND)
unnamed: BOOT0.2, R5.1
unnamed: BOOT1.2, R6.1
unnamed: D1.1 (K), R1.2
unnamed: D2.1 (K), R3.2
unnamed: D3.1 (K), R4.2
unnamed: J2.A5 (CC1), R11.1
unnamed: J2.B5 (CC2), R10.1
OSCIN: C8.1, U1.5 (PD0_OSC_IN), X1.1
OSCOUT: C9.1, U1.6 (PD1_OSC_OUT), X1.2
PA3: J1.1, J4.6 (SWO), U1.13 (PA3)
PA11: R7.1, U1.32 (PA11)
PA12: R8.1, R9.2, U1.33 (PA12)
PB4: J1.2, J4.10 (RESET), U1.40 (PB4)
PB6: J3.2, U1.42 (PB6)
PB7: J3.3, U1.43 (PB7)
PC13: R1.1, U1.2 (PC13-TAMPER-RTC)
PC14: C10.1, U1.3 (PC14-OSC32_IN), X2.1
PC15: C11.1, U1.4 (PC15-OSC32_OUT), X2.2
SWDCLK: J1.5, J4.4 (SWDCLK), U1.37 (PA14)
SWDIO: J1.4, J4.2 (SWDIO), U1.34 (PA13)
USB_N: J2.A7 (D1-), J2.B7 (D2-), R8.2
USB_P: J2.A6 (D1+), J2.B6 (D2+), R7.2
VTARGET: D2.2 (A), J1.3, J3.1, J4.1 (VCC), SW2.3 (C)
