TomKeddie/prj-pcb-experiments/kicad-spice/p-bjt-spice/p-bjt-spice.sch

## KiCad design kicad-spice/p-bjt-spice/p-bjt-spice.sch (2020-10-20)

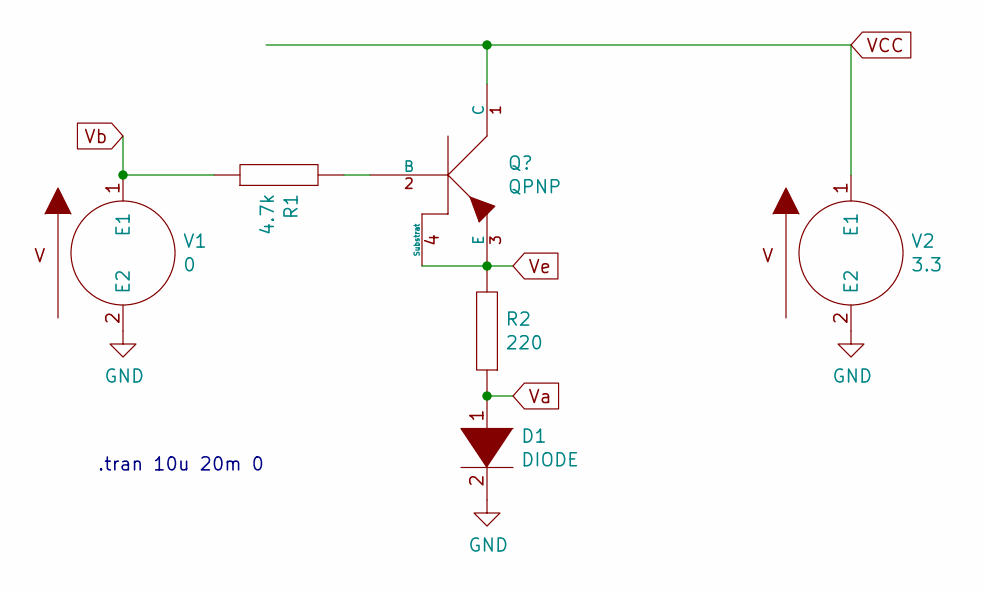
[picture p250: schematic p-bjt-spice.sch]

Parts:
D1: DIODE
R1: 4.7k
R2: 220
V1: 0
V2: 3.3

Connections:
GND: D1.2 (A), V1.2 (E2), V2.2 (E2)
VCC: V2.1 (E1)
Va: D1.1 (K), R2.1
Vb: R1.1, V1.1 (E1)
Ve: R2.2

Notes on the sheet:
.tran 10u 20m 0
