TomKeddie/prj-pcb-experiments/kicad-spice/p-fet-spice/p-fet-spice.sch

## KiCad design kicad-spice/p-fet-spice/p-fet-spice.sch (2020-10-20)

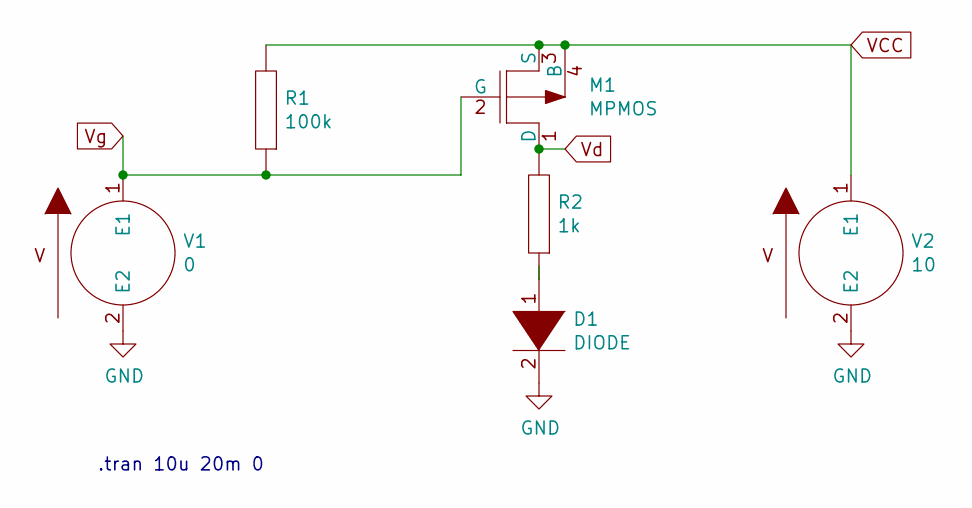
[picture p251: schematic p-fet-spice.sch]

Parts:
D1: DIODE
M1: MPMOS
R1: 100k
R2: 1k
V1: 0
V2: 10

Connections:
GND: D1.2 (A), V1.2 (E2), V2.2 (E2)
unnamed: D1.1 (K), R2.1
VCC: M1.3 (S), M1.4 (B), R1.2, V2.1 (E1)
Vd: M1.1 (D), R2.2
Vg: M1.2 (G), R1.1, V1.1 (E1)

Notes on the sheet:
.tran 10u 20m 0
