TomKeddie/prj-pcb-experiments/snoopy-sao/snoopy-sao/snoopy-sao.sch

## KiCad design snoopy-sao/snoopy-sao/snoopy-sao.sch (2021-01-15)

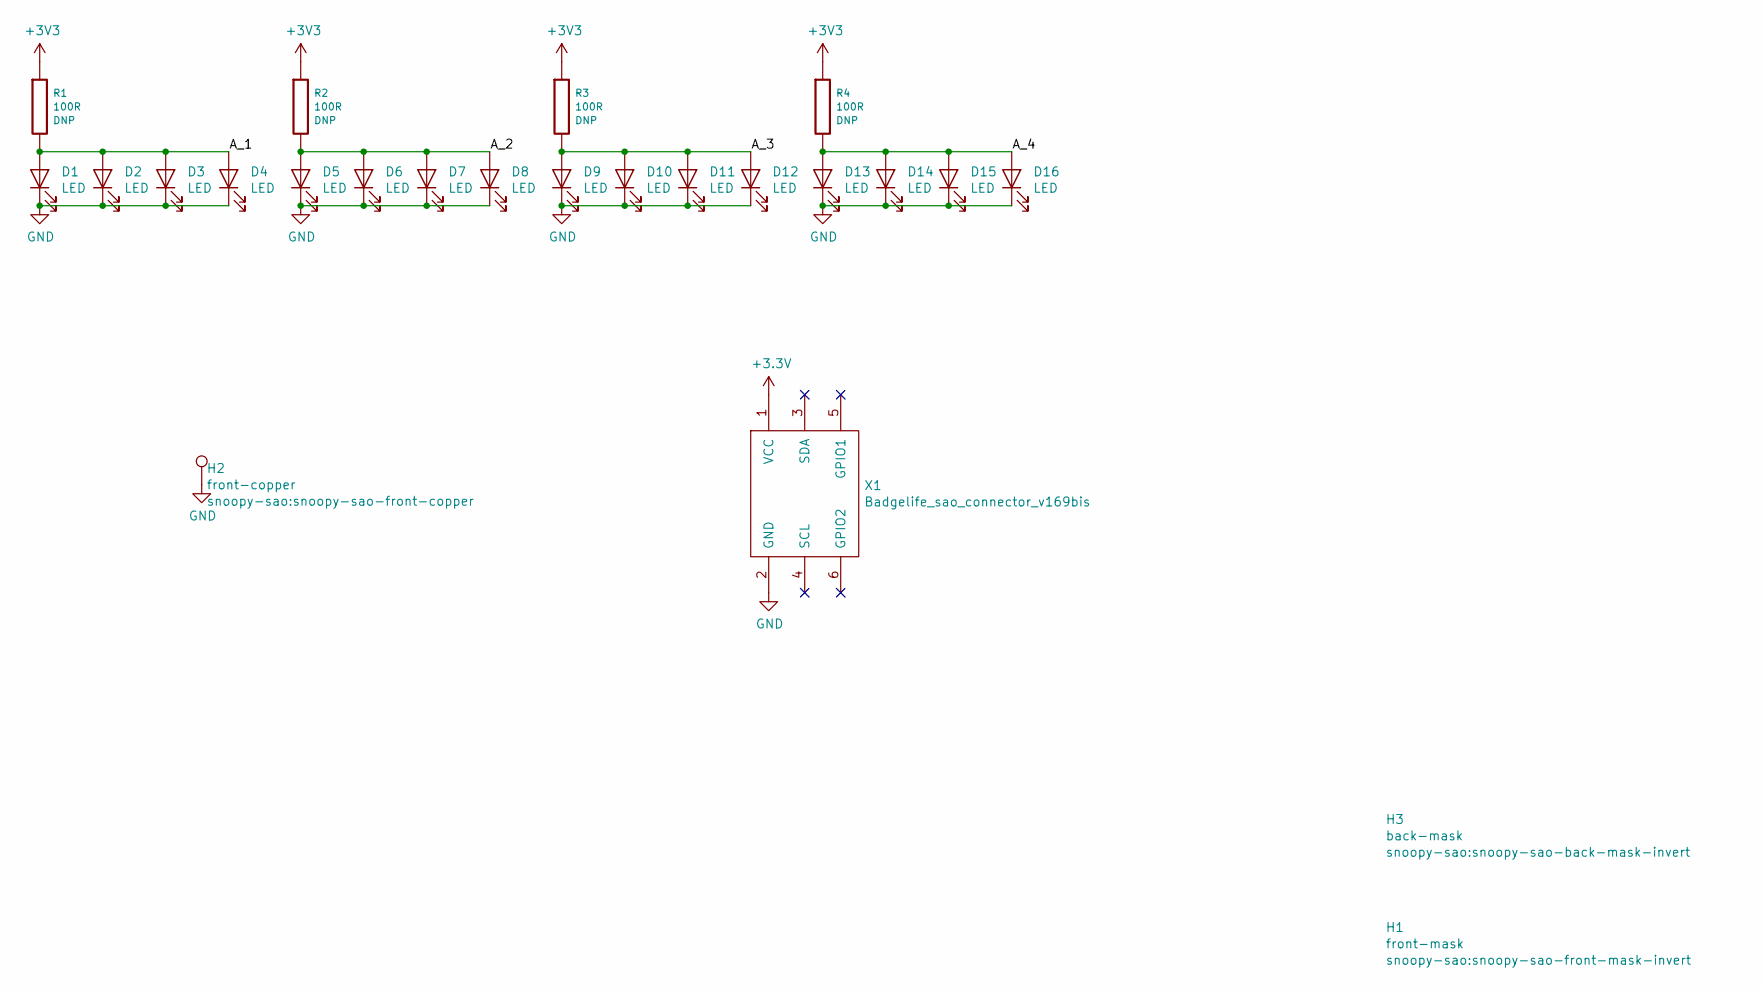
[picture p252: schematic snoopy-sao.sch]

Parts:
D1, D2, D3, D4, D5, D6, D7, D8, D9, D10, D11, D12, D13, D14, D15, D16: LED; ALIEXPRESS_LED_SIDE_0602
H1: front-mask; snoopy-sao-front-mask-invert
H2: front-copper; snoopy-sao-front-copper
H3: back-mask; snoopy-sao-back-mask-invert
R1, R2, R3, R4: 100R; R_0402_1005Metric; LCSC DNP
X1: Badgelife_sao_connector_v169bis; Badgelife-SAOv169-SAO-2x3-SMD-BIGPADS

Connections:
+3.3V: X1.1 (VCC)
+3V3: R1.1, R2.1, R3.1, R4.1
A_1: D1.2 (A), D2.2 (A), D3.2 (A), D4.2 (A), R1.2
A_2: D5.2 (A), D6.2 (A), D7.2 (A), D8.2 (A), R2.2
A_3: D9.2 (A), D10.2 (A), D11.2 (A), D12.2 (A), R3.2
A_4: D13.2 (A), D14.2 (A), D15.2 (A), D16.2 (A), R4.2
GND: D1.1 (K), D2.1 (K), D3.1 (K), D4.1 (K), D5.1 (K), D6.1 (K), D7.1 (K), D8.1 (K), D9.1 (K), D10.1 (K), D11.1 (K), D12.1 (K), D13.1 (K), D14.1 (K), D15.1 (K), D16.1 (K), H2.1, X1.2 (GND)
