TomKeddie/prj-pcb-experiments/snoopy-sao/woodstock/woodstock.sch

## KiCad design snoopy-sao/woodstock/woodstock.sch (2021-02-26)

Schematic: woodstock.sch

Parts:
D1, D2: LED; LED_0805_2012Metric_Pad1.15x1.40mm_HandSolder
J1: Conn_02x02_Counter_Clockwise; PinHeader_2x02_P2.54mm_Vertical
R1, R2: 1k; R_0805_2012Metric_Pad1.15x1.40mm_HandSolder
