TomKeddie/prj-pcb-experiments/(commit log)

2019-01-28 Add led-through-fibreglass test board as submitted to oshpark
    [led-through-fibreglass.kicad_pcb, led-through-fibreglass.sch]
2019-08-24 Adding first pass at east van pcb
    [east-van.kicad_pcb, east-van.sch]
2019-08-24 Updated east-vanm pcb - add leds - route tracks
    [east-van.kicad_pcb, east-van.sch]
2019-08-24 Add remaining east van image files
    [image-edge-filled.dxf]
2019-08-24 East Van pcb as submitted
    [east-van.kicad_pcb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]
2019-08-28 Move east van cross to subdirectory
    [east-van.kicad_pcb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]
2019-08-28 Add east van sao outline prototypes
    [image-edge-extended-filled.dxf]
2019-11-01 east-van/pendant-rear: new pcb, swap copper layers
    [east-van.kicad_pcb, east-van.sch]
2019-11-01 east-van/pendant-rear: flip silk and mask to create rear (with mirrored writing)
    [east-van.kicad_pcb]
2019-11-01 Update tom-kicad libraries
2019-11-01 east-van/pendant: add gerbers
2019-11-21 deutsche-bahn-sao: add scaled and edge images, dxf and footprints (scaled to 70%)
    [1280px-Deutsche_Bahn_AG-Logo-scaled-edge.dxf]
2019-11-21 deutsche-bahn-sao: artwork complete, needs LEDs and sao connector
    [deutsche-bahn-sao.kicad_pcb, deutsche-bahn-sao.sch]
2019-11-21 Update tom-kicad submodule
2019-11-22 deutsche-bahn: v1.0 as submitted
    [deutsche-bahn-sao-B_Cu.gbr, deutsche-bahn-sao-B_Mask.gbr, deutsche-bahn-sao-B_Paste.gbr, deutsche-bahn-sao-B_SilkS.gbr, deutsche-bahn-sao-Edge_Cuts.gbr, deutsche-bahn-sao-F_Cu.gbr, deutsche-bahn-sao-F_Mask.gbr, deutsche-bahn-sao-F_Paste.gbr]
2019-11-22 mrfixit: add inkspace and dxf
    [mrfixit-corrected-filled.dxf]
2019-11-22 mrfixit: first pass at pcb
    [mrfixit.kicad_pcb, mrfixit.sch]
2019-11-22 mrfixit: v1.0 as submitted, hasl copper outline with red mask internal + multimeter led
    [mrfixit-B_Cu.gbr, mrfixit-B_Mask.gbr, mrfixit-B_Paste.gbr, mrfixit-B_SilkS.gbr, mrfixit-Edge_Cuts.gbr, mrfixit-F_Cu.gbr, mrfixit-F_Mask.gbr, mrfixit-F_Paste.gbr]
2019-11-23 east-van-arrow: v1.0 as submitted
    [east-van-arrow.kicad_pcb, east-van-arrow.sch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]
2019-11-23 east-van-arrow: v1.0 revised larger
    [east-van-arrow.kicad_pcb, image-arrow-up-filled.dxf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]
2019-11-26 mr-fixit: v1.1 edge cuts changes as v1.0 failed audit
    [mrfixit-B_Cu.gbr, mrfixit-B_Mask.gbr, mrfixit-B_Paste.gbr, mrfixit-B_SilkS.gbr, mrfixit-Edge_Cuts.gbr, mrfixit-F_Cu.gbr, mrfixit-F_Mask.gbr, mrfixit-F_Paste.gbr]
2019-11-26 mr-foxot: add v1.1 gerber zip
2019-11-27 glasgow-pmod: add v1.0
    [glasgow-pmod-B_Cu.gbr, glasgow-pmod-B_Mask.gbr, glasgow-pmod-B_Paste.gbr, glasgow-pmod-B_SilkS.gbr, glasgow-pmod-Edge_Cuts.gbr, glasgow-pmod-F_Cu.gbr, glasgow-pmod-F_Mask.gbr, glasgow-pmod-F_Paste.gbr]
2019-11-29 edison-led-3x4-pmod: added symbol for edison 3014 leds
    [edison-led-3x4-pmod.kicad_pcb, edison-led-3x4-pmod.sch]
2019-11-29 edison-led-3x4-pmod: rev v1.0
    [edison-led-3x4-pmod-B_Cu.gbr, edison-led-3x4-pmod-B_Mask.gbr, edison-led-3x4-pmod-B_Paste.gbr, edison-led-3x4-pmod-B_SilkS.gbr, edison-led-3x4-pmod-Edge_Cuts.gbr, edison-led-3x4-pmod-F_Cu.gbr, edison-led-3x4-pmod-F_Mask.gbr, edison-led-3x4-pmod-F_Paste.gbr]
2019-11-29 tom-kicad: added footprints for glasgow pmod adapter
2019-12-07 eat-van-arrow: v1.1 fix issues with back solder mask
    [east-van-arrow.kicad_pcb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]
2019-12-13 Added various pcb images
2020-01-29 hc245t-bypass: first pass
    [hc245t-bypass.kicad_pcb, hc245t-bypass.sch]
2020-02-02 hub75-pmod: feb 2020 added
    [hub-75-pmod.kicad_pcb, hub-75-pmod.sch]
2020-02-02 hc245t-bypass: create panel of two to account for oshpark min size
    [hc245t-bypass.kicad_pcb, hc245t-bypass.sch]
2020-02-29 hc245t-bypass: Feb 2020 version, increase spacing between boards
    [hc245t-bypass.kicad_pcb]
2020-02-29 hc245t-bypass: revert to Jan2018 version for flex pcb
    [hc245t-bypass.kicad_pcb]
2020-02-29 hc245t-bypass : flex version as submitted to oshpark for Feb 2020
    [hc245t-bypass.kicad_pcb]
2020-03-01 hc245t-bypass: Mar2020 rev with 4 instances
    [hc245t-bypass.kicad_pcb, hc245t-bypass.sch]
2020-03-01 hc245t-bypass.kicad_pcb: fix solder mask settings
    [hc245t-bypass.kicad_pcb]
2020-03-02 pi4-pcie-patch: no castellations
    [pi4-pcie-patch.kicad_pcb]
2020-03-02 pi4-pcie-patch: add castellations
    [pi4-pcie-patch.kicad_pcb]
2020-03-02 pi4-pcie-patch: mask pads on bottom layer
    [pi4-pcie-patch.kicad_pcb]
2020-04-09 hub75-pmod: fix issues with oval pads for hub75 connector
    [hub-75-pmod-B_Cu.gbr, hub-75-pmod-B_Mask.gbr, hub-75-pmod-B_Paste.gbr, hub-75-pmod-B_SilkS.gbr, hub-75-pmod-Edge_Cuts.gbr, hub-75-pmod-F_Cu.gbr, hub-75-pmod-F_Mask.gbr, hub-75-pmod-F_Paste.gbr]
2020-04-10 Update gitignore and tom-kicad anchor
2020-04-10 covid-mask: final dxf and jpeg
    [86547808-10cm-filled.dxf, man-in-hygiene-face-mask-icon-vector-9492108-10cm-filled.dxf, mask1.kicad_pcb, mask1.sch, mask2.kicad_pcb, mask2.sch]
2020-04-11 covid-mask: add mask2 gerbers
    [mask2-B_Cu.gbr, mask2-B_Mask.gbr, mask2-B_Paste.gbr, mask2-B_SilkS.gbr, mask2-Edge_Cuts.gbr, mask2-F_Cu.gbr, mask2-F_Mask.gbr, mask2-F_Paste.gbr]
2020-05-18 Glasgow LVDS-PMOD: May 2020 update, fixed mechanical issues
    [glasgow-pmod-B_Cu.gbr, glasgow-pmod-B_Mask.gbr, glasgow-pmod-B_Paste.gbr, glasgow-pmod-B_SilkS.gbr, glasgow-pmod-Edge_Cuts.gbr, glasgow-pmod-F_Cu.gbr, glasgow-pmod-F_Mask.gbr, glasgow-pmod-F_Paste.gbr]
2020-05-24 glasgow-pmod : use relative paths for footprints
2020-05-24 glasgow pmod : fix library references
    [glasgow-pmod.sch]
2020-05-26 glasgow-pmod: tuned J3 and J4 J3_J4_DP1.0/1.0 -> MEETS INTER-PAIR TOLERANCE 1.0000 mm (current delta 0.8724) /Z0 meets intra-pair tolerance 1.0000 mm (current delta 0.0000) /Z1 meets intra-pair toler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
    [glasgow-pmod.sch]
2020-05-31 glasgow pmod: June 2020 release, fix length matching of pairs
    [glasgow-pmod-B_Cu.gbr, glasgow-pmod-B_Mask.gbr, glasgow-pmod-B_Paste.gbr, glasgow-pmod-B_SilkS.gbr, glasgow-pmod-Edge_Cuts.gbr, glasgow-pmod-F_Cu.gbr, glasgow-pmod-F_Mask.gbr, glasgow-pmod-F_Paste.gbr]
2020-06-28 Glasgow lvds pmod - June 2020
    [glasgow-pmod-B_Cu.gbr, glasgow-pmod-B_Mask.gbr, glasgow-pmod-B_Paste.gbr, glasgow-pmod-B_SilkS.gbr, glasgow-pmod-Edge_Cuts.gbr, glasgow-pmod-F_Cu.gbr, glasgow-pmod-F_Mask.gbr, glasgow-pmod-F_Paste.gbr]
2020-07-25 big-clive: add coaster and keytag pcbs
    [bcdc-coaster.kicad_pcb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]
2020-08-06 usb3-loopback: new project
    [usb3-loopback.kicad_pcb, usb3-loopback.sch]
2020-08-06 usb-loopback: as submitted
    [usb3-loopback.kicad_pcb, usb3-loopback.sch]
2020-08-09 usb-crossover: new pcb to cross HS tx & rx pairs for usb3<->pcie
    [usb3-crossover.kicad_pcb, usb3-crossover.sch]
2020-09-18 add multi-way-usb sep2020a as resent to jlcpcb
    [multi-way-usb-B_Cu.gbr, multi-way-usb-B_Mask.gbr, multi-way-usb-B_Paste.gbr, multi-way-usb-B_SilkS.gbr, multi-way-usb-Edge_Cuts.gbr, multi-way-usb-F_Cu.gbr, multi-way-usb-F_Mask.gbr, multi-way-usb-F_Paste.gbr]
2020-09-19 multi-way-usb: fix drc errors related to keepout regions
    [multi-way-usb-B_Cu.gbr, multi-way-usb-B_Mask.gbr, multi-way-usb-B_Paste.gbr, multi-way-usb-B_SilkS.gbr, multi-way-usb-Edge_Cuts.gbr, multi-way-usb-F_Cu.gbr, multi-way-usb-F_Mask.gbr, multi-way-usb-F_Paste.gbr]
2020-09-19 update tom-kicad anchor
2020-09-19 multi-way-usb: as submitted
    [multi-way-usb-B_Cu.gbr, multi-way-usb-B_Mask.gbr, multi-way-usb-B_Paste.gbr, multi-way-usb-B_SilkS.gbr, multi-way-usb-Edge_Cuts.gbr, multi-way-usb-F_Cu.gbr, multi-way-usb-F_Mask.gbr, multi-way-usb-F_Paste.gbr]
2020-09-20 esp8266-iot: as submitted to jlcpcb
    [esp8266-iot-B_Cu.gbr, esp8266-iot-B_Mask.gbr, esp8266-iot-B_Paste.gbr, esp8266-iot-B_SilkS.gbr, esp8266-iot-Edge_Cuts.gbr, esp8266-iot-F_Cu.gbr, esp8266-iot-F_Mask.gbr, esp8266-iot-F_Paste.gbr]
2020-09-29 sao-wall : as sent to jlcpcb Sep 2020
    [sao-wall-B_Cu.gbr, sao-wall-B_Mask.gbr, sao-wall-B_Paste.gbr, sao-wall-B_SilkS.gbr, sao-wall-Edge_Cuts.gbr, sao-wall-F_Cu.gbr, sao-wall-F_Mask.gbr, sao-wall-F_Paste.gbr]
2020-10-10 Add 3rdparty-gerbers
2020-10-10 Moved sao-wall to git@github.com:TomKeddie/prj-sao-wall.git
    [sao-wall-B_Cu.gbr, sao-wall-B_Mask.gbr, sao-wall-B_Paste.gbr, sao-wall-B_SilkS.gbr, sao-wall-Edge_Cuts.gbr, sao-wall-F_Cu.gbr, sao-wall-F_Mask.gbr, sao-wall-F_Paste.gbr]
2020-10-14 multi-way-usb: Changed footprint for inverted connectors
    [multi-way-usb-B_Cu.gbr, multi-way-usb-B_Mask.gbr, multi-way-usb-B_Paste.gbr, multi-way-usb-B_SilkS.gbr, multi-way-usb-Edge_Cuts.gbr, multi-way-usb-F_Cu.gbr, multi-way-usb-F_Mask.gbr, multi-way-usb-F_Paste.gbr]
2020-10-20 Add p-bjt-spice: pnp spice simulation
    [p-bjt-spice.kicad_pcb, p-bjt-spice.sch]
2020-10-20 Add p-fet-spice: P channel fet simulation
    [p-fet-spice.kicad_pcb, p-fet-spice.sch]
2020-11-27 multi-way-usb: fix mechanical issues
    [multi-way-usb-B_Cu.gbr, multi-way-usb-B_Mask.gbr, multi-way-usb-B_Paste.gbr, multi-way-usb-B_SilkS.gbr, multi-way-usb-Edge_Cuts.gbr, multi-way-usb-F_Cu.gbr, multi-way-usb-F_Mask.gbr, multi-way-usb-F_Paste.gbr]
2020-11-27 Add syzygy-serdes-breakout
    [QTH-020-01-F-D-DP-A.stp, syzygy-serdes-breakout.kicad_pcb, syzygy-serdes-breakout.sch]
2020-11-29 Add atmelice-swd-breakout
    [atmelice-swd-breakout-B_Cu.gbr, atmelice-swd-breakout-B_Mask.gbr, atmelice-swd-breakout-B_Paste.gbr, atmelice-swd-breakout-B_SilkS.gbr, atmelice-swd-breakout-Edge_Cuts.gbr, atmelice-swd-breakout-F_Cu.gbr, atmelice-swd-breakout-F_Mask.gbr, atmelice-swd-breakout-F_Paste.gbr]
2020-11-29 multi-way-usb: move J8 to X2 to balance supplies, v1.2 ready for production
    [multi-way-usb-B_Cu.gbr, multi-way-usb-B_Mask.gbr, multi-way-usb-B_Paste.gbr, multi-way-usb-B_SilkS.gbr, multi-way-usb-Edge_Cuts.gbr, multi-way-usb-F_Cu.gbr, multi-way-usb-F_Mask.gbr, multi-way-usb-F_Paste.gbr]
2020-12-10 Add 2021-xmas-tree pcb ornament
    [2021-xmas-tree.kicad_pcb, 2021-xmas-tree.sch, pine-tree-with-snow-transparent-clip-art-gallery-yopriceville-snow-tree-clipart-5756_8000-edge.dxf]
2020-12-11 2021-xmas-tree: Dec2020 release
    [2021-xmas-tree-B_Cu.gbr, 2021-xmas-tree-B_Mask.gbr, 2021-xmas-tree-B_Paste.gbr, 2021-xmas-tree-B_SilkS.gbr, 2021-xmas-tree-Edge_Cuts.gbr, 2021-xmas-tree-F_Cu.gbr, 2021-xmas-tree-F_Mask.gbr, 2021-xmas-tree-F_Paste.gbr]
2020-12-11 Add rgb-xmas-tree (need to solve current consumption)
    [column.sch, pine-tree-with-snow-transparent-clip-art-gallery-yopriceville-snow-tree-clipart-5756_8000-edge.dxf, rgb-xmas-tree.kicad_pcb, rgb-xmas-tree.sch, row.sch]
2020-12-11 2021-xmas-tree-2020Dec: reduced to 100mm size to save $$
    [2021-xmas-tree-B_Cu.gbr, 2021-xmas-tree-B_Mask.gbr, 2021-xmas-tree-B_Paste.gbr, 2021-xmas-tree-B_SilkS.gbr, 2021-xmas-tree-Edge_Cuts.gbr, 2021-xmas-tree-F_Cu.gbr, 2021-xmas-tree-F_Mask.gbr, 2021-xmas-tree-F_Paste.gbr]
2020-12-11 atmelice-swd-breakout: Nov2020 release
    [atmelice-swd-breakout-B_Cu.gbr, atmelice-swd-breakout-B_Mask.gbr, atmelice-swd-breakout-B_Paste.gbr, atmelice-swd-breakout-B_SilkS.gbr, atmelice-swd-breakout-Edge_Cuts.gbr, atmelice-swd-breakout-F_Cu.gbr, atmelice-swd-breakout-F_Mask.gbr, atmelice-swd-breakout-F_Paste.gbr]
2020-12-11 Add syzygy-stencil
    [syzygy-stencil.kicad_pcb, syzygy-stencil.sch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]
2020-12-12 syzygy-serdes-breakout: fix missing ground pour on In1
    [14S1_ATM.step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]
2020-12-12 Add Iron Man gerbers
2020-12-13 peace-sign-sao: new design
    [image.dxf, peace-sign-Eco1_User.dxf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]
2020-12-16 blue-pill-bmp: new design, basic blue pill based BMP debug probe
    [blue-pill-bmp-B_Cu.gbr, blue-pill-bmp-B_Mask.gbr, blue-pill-bmp-B_Paste.gbr, blue-pill-bmp-B_SilkS.gbr, blue-pill-bmp-Edge_Cuts.gbr, blue-pill-bmp-F_Cu.gbr, blue-pill-bmp-F_Mask.gbr, blue-pill-bmp-F_Paste.gbr]
2020-12-16 blue-pill-bmp: add 2.54mm SWD connector
    [blue-pill-bmp-B_Cu.gbr, blue-pill-bmp-B_Mask.gbr, blue-pill-bmp-B_Paste.gbr, blue-pill-bmp-B_SilkS.gbr, blue-pill-bmp-Edge_Cuts.gbr, blue-pill-bmp-F_Cu.gbr, blue-pill-bmp-F_Mask.gbr, blue-pill-bmp-F_Paste.gbr]
2020-12-16 peace-sign: commit missing updates
    [peace-sign-Eco1_User.dxf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]
2020-12-16 peace-sign-sao: change SAO connector back to 6 pin for stability
    [peace-sign-Eco1_User.dxf, peace-sign.kicad_pcb, peace-sign.sch]
2020-12-17 atmelice-swd-breakout-switch: new design
    [atmelice-swd-breakout-switch-B_Cu.gbr, atmelice-swd-breakout-switch-B_Mask.gbr, atmelice-swd-breakout-switch-B_Paste.gbr, atmelice-swd-breakout-switch-B_SilkS.gbr, atmelice-swd-breakout-switch-Edge_Cuts.gbr, atmelice-swd-breakout-switch-F_Cu.gbr, atmelice-swd-breakout-switch-F_Mask.gbr, atmelice-swd-breakout-switch-F_Paste.gbr]
2020-12-28 kicad-symbols-footprints-workshop: pcb workshop files
    [kicad-symbols-footprints-workshop.kicad_pcb, kicad-symbols-footprints-workshop.sch]
2021-01-04 Add power blower
    [power-blower.kicad_pcb, power-blower.sch]
2021-01-13 kindcalmsafe: new design
    [kindcalmsafe-B_Cu.gbr, kindcalmsafe-B_Mask.gbr, kindcalmsafe-B_Paste.gbr, kindcalmsafe-B_SilkS.gbr, kindcalmsafe-Edge_Cuts.gbr, kindcalmsafe-F_Cu.gbr, kindcalmsafe-F_Mask.gbr, kindcalmsafe-F_Paste.gbr]
2021-01-13 kindcalmsafe: commit unsaved schematic changes
    [kindcalmsafe.sch]
2021-01-15 snoopy-sao: new design
    [snoopy-filled.dxf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]
2021-01-15 snoopy-sao: fix silk
    [snoopy-sao-B_Cu.gbr, snoopy-sao-B_Mask.gbr, snoopy-sao-B_Paste.gbr, snoopy-sao-B_SilkS.gbr, snoopy-sao-Edge_Cuts.gbr, snoopy-sao-F_Cu.gbr, snoopy-sao-F_Mask.gbr, snoopy-sao-F_Paste.gbr]
2021-01-15 kindcalmsafe: fix 1204 led package
    [kindcalmsafe-B_Cu.gbr, kindcalmsafe-B_Mask.gbr, kindcalmsafe-B_Paste.gbr, kindcalmsafe-B_SilkS.gbr, kindcalmsafe-Edge_Cuts.gbr, kindcalmsafe-F_Cu.gbr, kindcalmsafe-F_Mask.gbr, kindcalmsafe-F_Paste.gbr]
2021-02-04 micromod-carrier: first commit before hub part # change
    [micromod-carrier-usb.sch, micromod-carrier.kicad_pcb, micromod-carrier.sch]
2021-02-19 esp8266-wiz550io: new design
    [esp8266-wiz550io.kicad_pcb, esp8266-wiz550io.sch]
2021-02-19 esp8266-wiz550io: add gerbers
    [esp8266-wiz550io-B_Cu.gbr, esp8266-wiz550io-B_Mask.gbr, esp8266-wiz550io-B_Paste.gbr, esp8266-wiz550io-B_SilkS.gbr, esp8266-wiz550io-Edge_Cuts.gbr, esp8266-wiz550io-F_Cu.gbr, esp8266-wiz550io-F_Mask.gbr, esp8266-wiz550io-F_Paste.gbr]
2021-02-19 esp8266-wiz550io: switch GPIO2 and GPIO4
    [esp8266-wiz550io-B_Cu.gbr, esp8266-wiz550io-B_Mask.gbr, esp8266-wiz550io-B_Paste.gbr, esp8266-wiz550io-B_SilkS.gbr, esp8266-wiz550io-Edge_Cuts.gbr, esp8266-wiz550io-F_Cu.gbr, esp8266-wiz550io-F_Mask.gbr, esp8266-wiz550io-F_Paste.gbr]
2021-02-26 atmelice-swd-breakout-switch: add AVR connector (2021Jan rev)
    [atmelice-swd-breakout-switch-B_Cu.gbr, atmelice-swd-breakout-switch-B_Mask.gbr, atmelice-swd-breakout-switch-B_Paste.gbr, atmelice-swd-breakout-switch-B_SilkS.gbr, atmelice-swd-breakout-switch-Edge_Cuts.gbr, atmelice-swd-breakout-switch-F_Cu.gbr, atmelice-swd-breakout-switch-F_Mask.gbr, atmelice-swd-breakout-switch-F_Paste.gbr]
2021-02-26 nrf52dk-trace-pmod: flip data pin orientation to match pmod
    [nrf52dk-trace-pmod-B_Cu.gbr, nrf52dk-trace-pmod-B_Mask.gbr, nrf52dk-trace-pmod-B_Paste.gbr, nrf52dk-trace-pmod-B_SilkS.gbr, nrf52dk-trace-pmod-Edge_Cuts.gbr, nrf52dk-trace-pmod-F_Cu.gbr, nrf52dk-trace-pmod-F_Mask.gbr, nrf52dk-trace-pmod-F_Paste.gbr]
2021-02-26 blue-pill-bmp: as submitted
    [blue-pill-bmp.kicad_pcb, blue-pill-bmp.sch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]
2021-02-26 peace-sign-sao: as submitted
    [peace-sign.kicad_pcb]
2021-02-26 kindcalmsafe: dxf export
    [kindcalmsafe-Eco1_User.dxf, kindcalmsafe.kicad_pcb]
2021-02-26 snoopy-sao/woodstock: first pass on woodstock
    [woodstock.kicad_pcb, woodstock.sch]
2021-02-26 micromod-carrier: progress commit
    [micromod-carrier-usb-hub.sch, micromod-carrier-usb.sch, micromod-carrier.sch]
2021-02-26 esp8266-iot: add comments
    [esp8266-iot.sch]
2021-02-26 tom-kicad: update anchor
2021-02-26 kicad-symbols-footprints-workshop: add alias
2021-02-26 power-blower: as committed
    [power-blower.kicad_pcb]
2021-02-26 reinstate tom-kicad after conflict mess
2021-02-26 glasgow-swd-trace-addon: Feb2020 edition
    [glasgow-swd-trace-addon.kicad_pcb, glasgow-swd-trace-addon.sch]
2021-03-26 galep4-plcc-28: new design
    [galep4-plcc-28.kicad_pcb, galep4-plcc-28.sch]
2021-03-27 galep4-plcc-28: Mar2021 release
    [galep4-plcc-28-B_Adhes.gbr, galep4-plcc-28-B_CrtYd.gbr, galep4-plcc-28-B_Cu.gbr, galep4-plcc-28-B_Fab.gbr, galep4-plcc-28-B_Mask.gbr, galep4-plcc-28-B_Paste.gbr, galep4-plcc-28-B_SilkS.gbr, galep4-plcc-28-F_Adhes.gbr]
2021-04-17 esp8266-wiz550io: add kibot output for Feb2021 release
    [esp8266-wiz550io-B_Adhes.gbr, esp8266-wiz550io-B_CrtYd.gbr, esp8266-wiz550io-B_Cu.gbr, esp8266-wiz550io-B_Fab.gbr, esp8266-wiz550io-B_Mask.gbr, esp8266-wiz550io-B_Paste.gbr, esp8266-wiz550io-B_SilkS.gbr, esp8266-wiz550io-F_Adhes.gbr]
2021-04-19 ft4232h-breakout: Apr2021 release
    [ft4232h-breakout-Apr2021.dxf, ft4232h-breakout-Apr2021.step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]
2021-04-25 keypad-base: new design
    [keypad-base.kicad_pcb, keypad-base.sch]
2021-04-25 keypad-base: reduced to 6 keys, add mode change side buttons
    [keypad-base.kicad_pcb, keypad-base.sch]
2021-04-25 keypad-base: Apr2021 release
    [keypad-base-Apr2021.dxf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]
2021-04-25 keypad-frame: Apr2021 release of keypad frame
    [keypad-frame-Apr2021.drl, keypad-frame-B_Adhes.gbr, keypad-frame-B_CrtYd.gbr, keypad-frame-B_Cu.gbr, keypad-frame-B_Fab.gbr, keypad-frame-B_Mask.gbr, keypad-frame-B_Paste.gbr, keypad-frame-B_SilkS.gbr]
2021-04-25 keypad-base: fix silk, add missing edge cuts layer
    [keypad-base-Apr2021.dxf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]
2021-04-25 ft4232h-breakout: regenerate Apr2021 with edge cuts
    [ft4232h-breakout-Apr2021.step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]
2021-04-26 esp8266-wiz550io: regenerate Feb2021 gerbers with missing edge cuts fixed
    [esp8266-wiz550io-B_Adhes.gbr, esp8266-wiz550io-B_CrtYd.gbr, esp8266-wiz550io-B_Cu.gbr, esp8266-wiz550io-B_Fab.gbr, esp8266-wiz550io-B_Mask.gbr, esp8266-wiz550io-B_Paste.gbr, esp8266-wiz550io-B_SilkS.gbr, esp8266-wiz550io-Edge_Cuts.gbr]
2021-04-26 keypad-base/keypad-frame: change to M2 standoffs, Apr2021a release
    [keypad-base-Apr2021a.drl, keypad-base-B_Adhes.gbr, keypad-base-B_CrtYd.gbr, keypad-base-B_Cu.gbr, keypad-base-B_Fab.gbr, keypad-base-B_Mask.gbr, keypad-base-B_Paste.gbr, keypad-base-B_SilkS.gbr]
2021-05-30 ft4232h-breakout: may release - change to SMTSO-M3 standoff
    [ft4232h-breakout-B_Adhes.gbr, ft4232h-breakout-B_CrtYd.gbr, ft4232h-breakout-B_Cu.gbr, ft4232h-breakout-B_Fab.gbr, ft4232h-breakout-B_Mask.gbr, ft4232h-breakout-B_Paste.gbr, ft4232h-breakout-B_SilkS.gbr, ft4232h-breakout-Edge_Cuts.gbr]
2021-05-30 keypad-frame: May2021 release, change to m3 holes, shrink keyswitch cutouts
    [keypad-frame-B_Adhes.gbr, keypad-frame-B_CrtYd.gbr, keypad-frame-B_Cu.gbr, keypad-frame-B_Fab.gbr, keypad-frame-B_Mask.gbr, keypad-frame-B_Paste.gbr, keypad-frame-B_SilkS.gbr, keypad-frame-Edge_Cuts.gbr]
2021-06-06 ft4232h-breakout: Jun2021 release, fix diameter of spacer
    [ft4232h-breakout-B_Adhes.gbr, ft4232h-breakout-B_CrtYd.gbr, ft4232h-breakout-B_Cu.gbr, ft4232h-breakout-B_Fab.gbr, ft4232h-breakout-B_Mask.gbr, ft4232h-breakout-B_Paste.gbr, ft4232h-breakout-B_SilkS.gbr, ft4232h-breakout-Edge_Cuts.gbr]
2021-06-06 ft4232h-breakout: Jun2021a release, add power led
    [ft4232h-breakout-B_Adhes.gbr, ft4232h-breakout-B_CrtYd.gbr, ft4232h-breakout-B_Cu.gbr, ft4232h-breakout-B_Fab.gbr, ft4232h-breakout-B_Mask.gbr, ft4232h-breakout-B_Paste.gbr, ft4232h-breakout-B_SilkS.gbr, ft4232h-breakout-Edge_Cuts.gbr]
2021-06-06 ft4232h-breakout: Jun2021b add silk to voltage selection
    [ft4232h-breakout-B_Adhes.gbr, ft4232h-breakout-B_CrtYd.gbr, ft4232h-breakout-B_Cu.gbr, ft4232h-breakout-B_Fab.gbr, ft4232h-breakout-B_Mask.gbr, ft4232h-breakout-B_Paste.gbr, ft4232h-breakout-B_SilkS.gbr, ft4232h-breakout-Edge_Cuts.gbr]
2021-06-06 keypad-base: Jun2021 - change standoff type
    [keypad-base-Apr2021a.dxf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]
2021-12-26 micromod-pmod-function: adapter for micromod function to pmod
    [micromod-pmod-function-B_Cu.gbl, micromod-pmod-function-B_Mask.gbs, micromod-pmod-function-B_Silkscreen.gbo, micromod-pmod-function-Edge_Cuts.gm1, micromod-pmod-function-F_Cu.gtl, micromod-pmod-function-F_Mask.gts, micromod-pmod-function-F_Silkscreen.gto, micromod-pmod-function-NPTH.drl]
2022-01-22 keypad-prototype: moved to git@github.com:TomKeddie/prj-keypad-six.git
    [keypad-base-Apr2021.dxf, keypad-base-Apr2021a.dxf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]
2022-01-22 usb-c-power-toggle: new design, as sent to Oshpark
    [usb-c-power-toggle-B_Cu.gbr, usb-c-power-toggle-B_Mask.gbr, usb-c-power-toggle-B_Paste.gbr, usb-c-power-toggle-B_Silkscreen.gbr, usb-c-power-toggle-Edge_Cuts.gbr, usb-c-power-toggle-F_Cu.gbr, usb-c-power-toggle-F_Mask.gbr, usb-c-power-toggle-F_Paste.gbr]
2022-02-06 rc2014-compat-backplane: new design feb2022 rev
    [rc2014-compat-backplane-B_Cu.gbr, rc2014-compat-backplane-B_Mask.gbr, rc2014-compat-backplane-B_Paste.gbr, rc2014-compat-backplane-B_Silkscreen.gbr, rc2014-compat-backplane-Edge_Cuts.gbr, rc2014-compat-backplane-F_Cu.gbr, rc2014-compat-backplane-F_Mask.gbr, rc2014-compat-backplane-F_Paste.gbr]
2022-02-06 rc2014-compat-backplane: remove extra drill files
    [rc2014-compat-backplane-NPTH.drl, rc2014-compat-backplane-PTH.drl]
2022-05-12 ft4232h-breakout: directory restructure to make way for v2.x
    [ft4232h-breakout-Apr2021.dxf, ft4232h-breakout-Apr2021.step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]
2022-05-12 ft4232h-breakout: add v2.x
    [ft4232h-breakout-B_Adhes.gbr, ft4232h-breakout-B_CrtYd.gbr, ft4232h-breakout-B_Cu.gbr, ft4232h-breakout-B_Fab.gbr, ft4232h-breakout-B_Mask.gbr, ft4232h-breakout-B_Paste.gbr, ft4232h-breakout-B_SilkS.gbr, ft4232h-breakout-Edge_Cuts.gbr]
2022-05-13 ft4232h-breakout: first pass at v3, pcb outline done
    [ft4232h-breakout.kicad_pcb, ft4232h-breakout.kicad_sch]
2022-05-14 ft4232h-breakout: v3 schematic complete and reviewed
    [ft4232h-breakout.kicad_sch]
2022-05-15 ft4232h-breakout: v3 at rc1
    [ft4232h-breakout.kicad_pcb, ft4232h-breakout.kicad_sch]
2022-05-15 ft4232h-breakout: v3.0 as submitted to jlcpcb for pcb run
    [ft4232h-breakout-B_Cu.gbl, ft4232h-breakout-B_Mask.gbs, ft4232h-breakout-B_Paste.gbp, ft4232h-breakout-B_Silkscreen.gbo, ft4232h-breakout-Edge_Cuts.gm1, ft4232h-breakout-F_Cu.gtl, ft4232h-breakout-F_Mask.gts, ft4232h-breakout-F_Paste.gtp]
2022-05-18 tag-connect: new design, May 2022 release as submitted
    [tag-connect-breakout-B_Cu.gbl, tag-connect-breakout-B_Mask.gbs, tag-connect-breakout-B_Paste.gbp, tag-connect-breakout-B_Silkscreen.gbo, tag-connect-breakout-Edge_Cuts.gm1, tag-connect-breakout-F_Cu.gtl, tag-connect-breakout-F_Mask.gts, tag-connect-breakout-F_Paste.gtp]
2022-06-03 ft4232h-breakout: updates for v3.1
    - fixed mount hole sizes
    - fixed exterior dimensions
    - updated rev on silk
    [ft4232h-breakout.csv, ft4232h-breakout.kicad_pcb]
2022-12-02 ch348_octo_serial: 8 port usb serial adapter. Placed.
    [ch348_octo_serial.csv, ch348_octo_serial.kicad_pcb, ch348_octo_serial.kicad_sch, serial-connectors.kicad_sch]
2022-12-03 ch348_octo_serial: fully routed, silk pending
    [ch348_octo_serial.kicad_pcb, ch348_octo_serial.kicad_sch]
2022-12-04 ch348_octo_serial: Dec2022 as submitted
    [ch348_octo_serial-B_Cu.gbl, ch348_octo_serial-B_Mask.gbs, ch348_octo_serial-B_Paste.gbp, ch348_octo_serial-B_Silkscreen.gbo, ch348_octo_serial-Edge_Cuts.gm1, ch348_octo_serial-F_Cu.gtl, ch348_octo_serial-F_Mask.gts, ch348_octo_serial-F_Paste.gtp]
2022-12-12 2022-xmas-ball: as submitted to jlcpcb/elecrow
    [2022-xmas-ball.kicad_pcb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]
2022-12-15 ch348_octo_serial: add pin 1 marking
    [ch348_octo_serial.kicad_pcb]
2022-12-25 covid-dude: SAO based on teachmepcb image, Dec2022 release
    [badge.GTO, covid-dude-B_Cu.gbl, covid-dude-B_Mask.gbs, covid-dude-B_Paste.gbp, covid-dude-B_Silkscreen.gbo, covid-dude-Edge_Cuts.gm1, covid-dude-F_Cu.gtl, covid-dude-F_Mask.gts]
2023-01-22 ch348_octo_serial_minim: compact ch348 board, wip
    [ch348_octo_serial_minim.kicad_pcb, ch348_octo_serial_minim.kicad_sch, serial-connectors.kicad_sch]
2023-01-23 ch348_octo_serial_minim: jan2023 rev ready for production
    [ch348_octo_serial_minim-B_Cu.gbl, ch348_octo_serial_minim-B_Mask.gbs, ch348_octo_serial_minim-B_Paste.gbp, ch348_octo_serial_minim-B_Silkscreen.gbo, ch348_octo_serial_minim-Edge_Cuts.gm1, ch348_octo_serial_minim-F_Cu.gtl, ch348_octo_serial_minim-F_Mask.gts, ch348_octo_serial_minim-F_Paste.gtp]
2023-01-23 ch348_octo_serial_minim: add cover plate pcb
    [ch348_octo_serial_minim_plate-B_Cu.gbl, ch348_octo_serial_minim_plate-B_Mask.gbs, ch348_octo_serial_minim_plate-B_Paste.gbp, ch348_octo_serial_minim_plate-B_Silkscreen.gbo, ch348_octo_serial_minim_plate-Edge_Cuts.gm1, ch348_octo_serial_minim_plate-F_Cu.gtl, ch348_octo_serial_minim_plate-F_Mask.gts, ch348_octo_serial_minim_plate-F_Paste.gtp]
2023-01-23 ch348_octo_serial_minim: move plate to subdir, add cts/rts link, Jan2023a
    [ch348_octo_serial_minim-B_Cu.gbl, ch348_octo_serial_minim-B_Mask.gbs, ch348_octo_serial_minim-B_Paste.gbp, ch348_octo_serial_minim-B_Silkscreen.gbo, ch348_octo_serial_minim-Edge_Cuts.gm1, ch348_octo_serial_minim-F_Cu.gtl, ch348_octo_serial_minim-F_Mask.gts, ch348_octo_serial_minim-F_Paste.gtp]
2023-01-25 covid-dude: add JLCJLC text
    [covid-dude-B_Cu.gbl, covid-dude-B_Mask.gbs, covid-dude-B_Paste.gbp, covid-dude-B_Silkscreen.gbo, covid-dude-Edge_Cuts.gm1, covid-dude-F_Cu.gtl, covid-dude-F_Mask.gts, covid-dude-F_Paste.gtp]
2023-03-31 skull-roses: skull and roses game with pcbs
    [roses-B_Paste.gbp, roses-B_Silkscreen.gbo, roses-Edge_Cuts.gm1, roses-F_Mask.gts, roses-F_Paste.gtp, roses-job.gbrjob, roses.drl, roses.kicad_pcb.bottom.pos.csv]
2023-03-31 roses: added step file generation
    [roses.kicad_pcb.step]
2023-04-20 esp8266-plugpack - new design
    [esp8266-plugpack-B_Cu.gbl, esp8266-plugpack-B_Mask.gbs, esp8266-plugpack-B_Paste.gbp, esp8266-plugpack-B_Silkscreen.gbo, esp8266-plugpack-Edge_Cuts.gm1, esp8266-plugpack-F_Cu.gtl, esp8266-plugpack-F_Mask.gts, esp8266-plugpack-F_Paste.gtp]
2023-04-22 esp8266-plugpack: placed and routed
    [esp8266-plugpack.kicad_pcb, esp8266-plugpack.kicad_sch]
2023-04-22 esp8266-plugpack: regenerate mfg output
    [esp8266-plugpack-B_Cu.gbl, esp8266-plugpack-B_Mask.gbs, esp8266-plugpack-B_Paste.gbp, esp8266-plugpack-B_Silkscreen.gbo, esp8266-plugpack-Edge_Cuts.gm1, esp8266-plugpack-F_Cu.gtl, esp8266-plugpack-F_Mask.gts, esp8266-plugpack-F_Paste.gtp]
2023-04-24 esp8266-plugpack: Apr2023 release
    [esp8266-plugpack-B_Cu.gbl, esp8266-plugpack-B_Mask.gbs, esp8266-plugpack-B_Paste.gbp, esp8266-plugpack-B_Silkscreen.gbo, esp8266-plugpack-Edge_Cuts.gm1, esp8266-plugpack-F_Cu.gtl, esp8266-plugpack-F_Mask.gts, esp8266-plugpack-F_Paste.gtp]
2023-05-04 atmelice-swd-breakout-switch: fix ground issue, May2023 release
    [atmelice-swd-breakout-switch-B_Cu.gbl, atmelice-swd-breakout-switch-B_Mask.gbs, atmelice-swd-breakout-switch-B_Paste.gbp, atmelice-swd-breakout-switch-B_Silkscreen.gbo, atmelice-swd-breakout-switch-Edge_Cuts.gm1, atmelice-swd-breakout-switch-F_Cu.gtl, atmelice-swd-breakout-switch-F_Mask.gts, atmelice-swd-breakout-switch-F_Paste.gtp]
2023-09-13 baggage-label: new design
    [baggage-label-B_Cu.gbl, baggage-label-B_Mask.gbs, baggage-label-B_Silkscreen.gbo, baggage-label-Edge_Cuts.gm1, baggage-label-F_Cu.gtl, baggage-label-F_Mask.gts, baggage-label-F_Silkscreen.gto, baggage-label.drl]
2023-09-19 webcam-shim: new design
    [webcam-shim.kicad_pcb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]
2023-09-23 baggage-label-small: new design
    [baggage-label-small-B_Cu.gbl, baggage-label-small-B_Mask.gbs, baggage-label-small-B_Silkscreen.gbo, baggage-label-small-Edge_Cuts.gm1, baggage-label-small-F_Cu.gtl, baggage-label-small-F_Mask.gts, baggage-label-small-F_Silkscreen.gto, baggage-label-small-job.gbrjob]
2023-11-01 baggage-label: add mid size and gerbers/Makefile for all
    [baggage-label-mid.kicad_pcb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]
2023-11-18 strange-parts: new coaster design
    [strange-parts-coaster-B_Cu.gbl, strange-parts-coaster-B_Mask.gbs, strange-parts-coaster-B_Paste.gbp, strange-parts-coaster-B_Silkscreen.gbo, strange-parts-coaster-Edge_Cuts.gm1, strange-parts-coaster-F_Cu.gtl, strange-parts-coaster-F_Mask.gts, strange-parts-coaster-F_Paste.gtp]
2023-11-18 strange parts coaster: fix back silk
    [strange-parts-coaster-B_Cu.gbl, strange-parts-coaster-B_Mask.gbs, strange-parts-coaster-B_Paste.gbp, strange-parts-coaster-B_Silkscreen.gbo, strange-parts-coaster-Edge_Cuts.gm1, strange-parts-coaster-F_Cu.gtl, strange-parts-coaster-F_Mask.gts, strange-parts-coaster-F_Paste.gtp]
2023-11-19 strange parts sao: new design
    [strange-parts-sao-B_Cu.gbl, strange-parts-sao-B_Mask.gbs, strange-parts-sao-B_Paste.gbp, strange-parts-sao-B_Silkscreen.gbo, strange-parts-sao-Edge_Cuts.gm1, strange-parts-sao-F_Cu.gtl, strange-parts-sao-F_Mask.gts, strange-parts-sao-F_Paste.gtp]
2023-11-19 baggage label: updates
    [baggage-label-B_Cu.gbl, baggage-label-B_Mask.gbs, baggage-label-B_Silkscreen.gbo, baggage-label-Edge_Cuts.gm1, baggage-label-F_Cu.gtl, baggage-label-F_Mask.gts, baggage-label-F_Silkscreen.gto, baggage-label-small-B_Cu.gbl]
2023-12-21 2023-xmas-snowflake: new design
    [2023-xmas-snowflake-B_Cu.gbl, 2023-xmas-snowflake-B_Mask.gbs, 2023-xmas-snowflake-B_Paste.gbp, 2023-xmas-snowflake-B_Silkscreen.gbo, 2023-xmas-snowflake-Edge_Cuts.gm1, 2023-xmas-snowflake-F_Cu.gtl, 2023-xmas-snowflake-F_Mask.gts, 2023-xmas-snowflake-F_Paste.gtp]
2024-01-07 mikrobus-pmod-adapt: new design as submitted
    [mikrobus-pmod-adapt-B_Cu.gbl, mikrobus-pmod-adapt-B_Mask.gbs, mikrobus-pmod-adapt-B_Paste.gbp, mikrobus-pmod-adapt-B_Silkscreen.gbo, mikrobus-pmod-adapt-Edge_Cuts.gm1, mikrobus-pmod-adapt-F_Cu.gtl, mikrobus-pmod-adapt-F_Mask.gts, mikrobus-pmod-adapt-F_Paste.gtp]
2024-03-02 mikrobus-pmod: change to 16 poin connector
    [mikrobus-pmod-adapt-B_Cu.gbl, mikrobus-pmod-adapt-B_Mask.gbs, mikrobus-pmod-adapt-B_Paste.gbp, mikrobus-pmod-adapt-B_Silkscreen.gbo, mikrobus-pmod-adapt-Edge_Cuts.gm1, mikrobus-pmod-adapt-F_Cu.gtl, mikrobus-pmod-adapt-F_Mask.gts, mikrobus-pmod-adapt-F_Paste.gtp]
2024-05-15 2024-businesscard new pcb
2024-06-07 2024-trace-adapter: new design sent to oshpark
    [2024-trace-adapter.kicad_pcb, 2024-trace-adapter.kicad_sch]
2024-09-11 2024-rfid-sao: first pass
    [2024-rfid-sao.kicad_pcb, 2024-rfid-sao.kicad_sch]
2024-09-11 2024-rfid-sao: updates for jlcpcb
    [2024-rfid-sao-B_Cu.gbl, 2024-rfid-sao-B_Mask.gbs, 2024-rfid-sao-B_Paste.gbp, 2024-rfid-sao-B_Silkscreen.gbo, 2024-rfid-sao-Edge_Cuts.gm1, 2024-rfid-sao-F_Cu.gtl, 2024-rfid-sao-F_Mask.gts, 2024-rfid-sao-F_Paste.gtp]
2024-09-16 mrfixit: rev1.3 as sent for mfg
    [mrfixit-B_Cu.gbl, mrfixit-B_Cu.gbr, mrfixit-B_Mask.gbr, mrfixit-B_Mask.gbs, mrfixit-B_Paste.gbp, mrfixit-B_Paste.gbr, mrfixit-B_SilkS.gbr, mrfixit-B_Silkscreen.gbo]
2024-09-17 2024-trace-adapter: remove lock file ;-)
2024-09-25 2024-syzygy-dsi: add pi schematic
2024-09-25 2024-syzygy-dsi: ready to fab
    [FH34SRJ-34S-0.5SH.stp, TCA9517ADGKR.step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]
2024-10-03 2024-rfid-sao:remove from silk circle from antenna
    [2024-rfid-sao-B_Cu.gbl, 2024-rfid-sao-B_Mask.gbs, 2024-rfid-sao-B_Paste.gbp, 2024-rfid-sao-B_Silkscreen.gbo, 2024-rfid-sao-Edge_Cuts.gm1, 2024-rfid-sao-F_Cu.gtl, 2024-rfid-sao-F_Mask.gts, 2024-rfid-sao-F_Paste.gtp]
2024-11-12 2024-supercon-sign-sao: new design
    ready for submission to JLC
    [2024-supercon-sign-sao-B_Cu.gbl, 2024-supercon-sign-sao-B_Mask.gbs, 2024-supercon-sign-sao-B_Paste.gbp, 2024-supercon-sign-sao-B_Silkscreen.gbo, 2024-supercon-sign-sao-Edge_Cuts.gm1, 2024-supercon-sign-sao-F_Cu.gtl, 2024-supercon-sign-sao-F_Mask.gts, 2024-supercon-sign-sao-F_Paste.gtp]
2024-11-13 2024-supercon-sign-sao: add bottom silk
    [2024-supercon-sign-sao-B_Cu.gbl, 2024-supercon-sign-sao-B_Mask.gbs, 2024-supercon-sign-sao-B_Paste.gbp, 2024-supercon-sign-sao-B_Silkscreen.gbo, 2024-supercon-sign-sao-Edge_Cuts.gm1, 2024-supercon-sign-sao-F_Cu.gtl, 2024-supercon-sign-sao-F_Mask.gts, 2024-supercon-sign-sao-F_Paste.gtp]
2024-11-16 2024-rfid-sao: ready for second run
    [2024-rfid-sao-B_Cu.gbl, 2024-rfid-sao-B_Mask.gbs, 2024-rfid-sao-B_Paste.gbp, 2024-rfid-sao-B_Silkscreen.gbo, 2024-rfid-sao-Edge_Cuts.gm1, 2024-rfid-sao-F_Cu.gtl, 2024-rfid-sao-F_Mask.gts, 2024-rfid-sao-F_Paste.gtp]
2024-11-16 2024-supercon-sign-sao: restructure ready for software
    [2024-supercon-sign-sao-B_Cu.gbl, 2024-supercon-sign-sao-B_Mask.gbs, 2024-supercon-sign-sao-B_Paste.gbp, 2024-supercon-sign-sao-B_Silkscreen.gbo, 2024-supercon-sign-sao-Edge_Cuts.gm1, 2024-supercon-sign-sao-F_Cu.gtl, 2024-supercon-sign-sao-F_Mask.gts, 2024-supercon-sign-sao-F_Paste.gtp]
2024-11-20 2024-rfid-sao: change RFID chip to 4k version
    [2024-rfid-sao.kicad_sch, 2024-rfid-sao.kicad_sch.jlc.csv]
2024-11-21 2024-rfid-sao: add location for barcode
    [2024-rfid-sao-B_Cu.gbl, 2024-rfid-sao-B_Mask.gbs, 2024-rfid-sao-B_Paste.gbp, 2024-rfid-sao-B_Silkscreen.gbo, 2024-rfid-sao-Edge_Cuts.gm1, 2024-rfid-sao-F_Cu.gtl, 2024-rfid-sao-F_Mask.gts, 2024-rfid-sao-F_Paste.gtp]
2024-12-02 2024-clock-retrofit: first pass at board outline
    [2024-clock-retrofit-B_Cu.gbl, 2024-clock-retrofit-B_Mask.gbs, 2024-clock-retrofit-B_Paste.gbp, 2024-clock-retrofit-B_Silkscreen.gbo, 2024-clock-retrofit-Edge_Cuts.gm1, 2024-clock-retrofit-F_Cu.gtl, 2024-clock-retrofit-F_Mask.gts, 2024-clock-retrofit-F_Paste.gtp]
2024-12-02 2024-rfid-sao: add markdown bom
2024-12-04 2024-clock-retrofit: all leds placed
    [2024-clock-retrofit-B_Cu.gbl, 2024-clock-retrofit-B_Mask.gbs, 2024-clock-retrofit-B_Paste.gbp, 2024-clock-retrofit-B_Silkscreen.gbo, 2024-clock-retrofit-Edge_Cuts.gm1, 2024-clock-retrofit-F_Cu.gtl, 2024-clock-retrofit-F_Mask.gts, 2024-clock-retrofit-F_Paste.gtp]
2024-12-10 2024-clock-retrofit: ready for jlcpcb
    [2024-clock-retrofit-leds.kicad_sch, 2024-clock-retrofit.kicad_sch]
2024-12-10 2024-clock-retrofit: fix rotation to match jlc
    [2024-clock-retrofit-B_Cu.gbl, 2024-clock-retrofit-B_Mask.gbs, 2024-clock-retrofit-B_Paste.gbp, 2024-clock-retrofit-B_Silkscreen.gbo, 2024-clock-retrofit-Edge_Cuts.gm1, 2024-clock-retrofit-F_Cu.gtl, 2024-clock-retrofit-F_Mask.gts, 2024-clock-retrofit-F_Paste.gtp]
2024-12-14 baggage-label: add blank
    [baggage-label-blank-B_Cu.gbl, baggage-label-blank-B_Mask.gbs, baggage-label-blank-B_Paste.gbp, baggage-label-blank-B_Silkscreen.gbo, baggage-label-blank-Edge_Cuts.gm1, baggage-label-blank-F_Cu.gtl, baggage-label-blank-F_Mask.gts, baggage-label-blank-F_Paste.gtp]
2024-12-15 2024-led-ctrl-24v: progress checkin
    [led-ctrl-24v-B_Cu.gbl, led-ctrl-24v-B_Mask.gbs, led-ctrl-24v-B_Paste.gbp, led-ctrl-24v-B_Silkscreen.gbo, led-ctrl-24v-Edge_Cuts.gm1, led-ctrl-24v-F_Cu.gtl, led-ctrl-24v-F_Mask.gts, led-ctrl-24v-F_Paste.gtp]
2024-12-31 led-ctrl-24v: progress checkin
    [led-ctrl-24v.kicad_sch]
2025-01-01 2024-led-ctrl-24v: add BUTTONS graphics
2025-01-11 2024-clock-retrofit: as submitted (black, 1mm)
    [2024-clock-retrofit-B_Cu.gbl, 2024-clock-retrofit-B_Mask.gbs, 2024-clock-retrofit-B_Paste.gbp, 2024-clock-retrofit-B_Silkscreen.gbo, 2024-clock-retrofit-Edge_Cuts.gm1, 2024-clock-retrofit-F_Cu.gtl, 2024-clock-retrofit-F_Mask.gts, 2024-clock-retrofit-F_Paste.gtp]
2025-04-05 baggage-label: reorganise
    [baggage-label-blank-B_Cu.gbl, baggage-label-blank-B_Mask.gbs, baggage-label-blank-B_Paste.gbp, baggage-label-blank-B_Silkscreen.gbo, baggage-label-blank-F_Cu.gtl, baggage-label-blank-F_Mask.gts, baggage-label-blank-F_Paste.gtp, baggage-label-blank-F_Silkscreen.gto]
2025-04-17 2025-usb-pd-plank: new design
    Prior to dropping BGA for FETs
    [usb-pd-plank-Edge_Cuts.dxf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]
2025-04-18 2025-usb-pd-plank: placed and routed
    [usb-pd-plank.kicad_pcb, usb-pd-plank.kicad_sch]
2025-04-19 2025-usb-pd-plank: read for mfg
    Changed i2c resistors to 10k
    Changed all LEDs to green
    Changed all power caps to 4.7uF/50V
    (cost reduction by $us10)
    [usb-pd-plank-Edge_Cuts.dxf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]
2025-04-20 2025-usb-pd-plank: add VBUS connector, silk fixes. As submitted.
    [usb-pd-plank-B_Cu.gbl, usb-pd-plank-B_Mask.gbs, usb-pd-plank-B_Paste.gbp, usb-pd-plank-B_Silkscreen.gbo, usb-pd-plank-Edge_Cuts.gm1, usb-pd-plank-F_Cu.gtl, usb-pd-plank-F_Mask.gts, usb-pd-plank-F_Paste.gtp]
2025-04-27 baggage-label-felix: updates
    [baggage-label-felix-B_Cu.gbl, baggage-label-felix-B_Mask.gbs, baggage-label-felix-B_Paste.gbp, baggage-label-felix-B_Silkscreen.gbo, baggage-label-felix-Edge_Cuts.gm1, baggage-label-felix-F_Cu.gtl, baggage-label-felix-F_Mask.gts, baggage-label-felix-F_Paste.gtp]
2025-05-09 2024-clock-retrofit: as submitted April 2025
    [2024-clock-retrofit-B_Cu.gbl, 2024-clock-retrofit-B_Mask.gbs, 2024-clock-retrofit-B_Paste.gbp, 2024-clock-retrofit-B_Silkscreen.gbo, 2024-clock-retrofit-Edge_Cuts.gm1, 2024-clock-retrofit-F_Cu.gtl, 2024-clock-retrofit-F_Mask.gts, 2024-clock-retrofit-F_Paste.gtp]
2025-05-09 2024-led-ctrl-24v: abandoned - too expensive
    [led-ctrl-24v-B_Cu.gbl, led-ctrl-24v-B_Mask.gbs, led-ctrl-24v-B_Paste.gbp, led-ctrl-24v-B_Silkscreen.gbo, led-ctrl-24v-Edge_Cuts.gm1, led-ctrl-24v-F_Cu.gtl, led-ctrl-24v-F_Mask.gts, led-ctrl-24v-F_Paste.gtp]
2025-05-09 2025-usb-pd-plank: fix submission issues
    [usb-pd-plank-B_Cu.gbl, usb-pd-plank-B_Mask.gbs, usb-pd-plank-B_Paste.gbp, usb-pd-plank-B_Silkscreen.gbo, usb-pd-plank-Edge_Cuts.gm1, usb-pd-plank-F_Cu.gtl, usb-pd-plank-F_Mask.gts, usb-pd-plank-F_Paste.gtp]
2025-06-22 2025-flex-spiral: as submitted
    - no rev on silk
    - forgot to remove JLC batch number from order
    [2025-flex-spiral-Edge_Cuts.dxf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]
2025-06-27 2025-flex-spiral: move first design to one and add design two
    [2025-flex-spiral-Edge_Cuts.dxf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]
2025-07-25 2025-mini-keychain: new design
    2025-06-22-09-39: as submitted
    2025-07-24-13-16: removed silk from front
    [2025-mini-keychain-Edge_Cuts.dxf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]
2025-07-25 2025-usb-pd-plank: 2025-05-29-20-44
    [usb-pd-plank-B_Cu.gbl, usb-pd-plank-B_Mask.gbs, usb-pd-plank-B_Paste.gbp, usb-pd-plank-B_Silkscreen.gbo, usb-pd-plank-Edge_Cuts.gm1, usb-pd-plank-F_Cu.gtl, usb-pd-plank-F_Mask.gts, usb-pd-plank-F_Paste.gtp]
2025-08-31 2025-pmod-sma: new design as submitted
    [2025-pmod-sma-B_Cu.gbl, 2025-pmod-sma-B_Mask.gbs, 2025-pmod-sma-B_Paste.gbp, 2025-pmod-sma-B_Silkscreen.gbo, 2025-pmod-sma-Edge_Cuts.gm1, 2025-pmod-sma-F_Cu.gtl, 2025-pmod-sma-F_Mask.gts, 2025-pmod-sma-F_Paste.gtp]
2025-08-31 2025-mipi-rpi-conv-dsi: new design as submitted
    [2025-mipi-rpi-conv-dsi-B_Cu.gbl, 2025-mipi-rpi-conv-dsi-B_Mask.gbs, 2025-mipi-rpi-conv-dsi-B_Paste.gbp, 2025-mipi-rpi-conv-dsi-B_Silkscreen.gbo, 2025-mipi-rpi-conv-dsi-Edge_Cuts.gm1, 2025-mipi-rpi-conv-dsi-F_Cu.gtl, 2025-mipi-rpi-conv-dsi-F_Mask.gts, 2025-mipi-rpi-conv-dsi-F_Paste.gtp]
2026-09-26 Add misc files from x570
    [2021-xmas-tree-B_Cu.gbr, 2021-xmas-tree-B_Mask.gbr, 2021-xmas-tree-B_Silkscreen.gbr, 2021-xmas-tree-Edge_Cuts.gbr, 2021-xmas-tree-F_Cu.gbr, 2021-xmas-tree-F_Mask.gbr, 2021-xmas-tree-F_Silkscreen.gbr, 2021-xmas-tree-job.gbrjob]
