TomKeddie/prj-pcb-experiments/(notices)

Notices in the files:
syzygy-serdes-breakout/3d/QTH-020-01-F-D-DP-A.stp:
FILE_NAME( 'p:/temp/worker_421/temp/exporttempdir_4644_185_xGaJY/format_0/QTH-020-01-F-D-DP-A.stp', '2020-11-27T02:50:16', ( 'License CC BY-ND 4.0' ), ( 'CADENAS' ), ' ', 'PARTsolutions', ' ' );
micromod-pmod-function/tmp.1/MicroMod_Environmental.kicad_sch:
https://creativecommons.org/licenses/by-sa/4.0
Released under the Creative Commons
parts and their libraries:
Copyright 2016 Accelerated Designs. All rights reserved.
Released under the Creative Commons Attribution Share-Alike 4.0 License
